reynal/themis/docs/images/pf.jpg

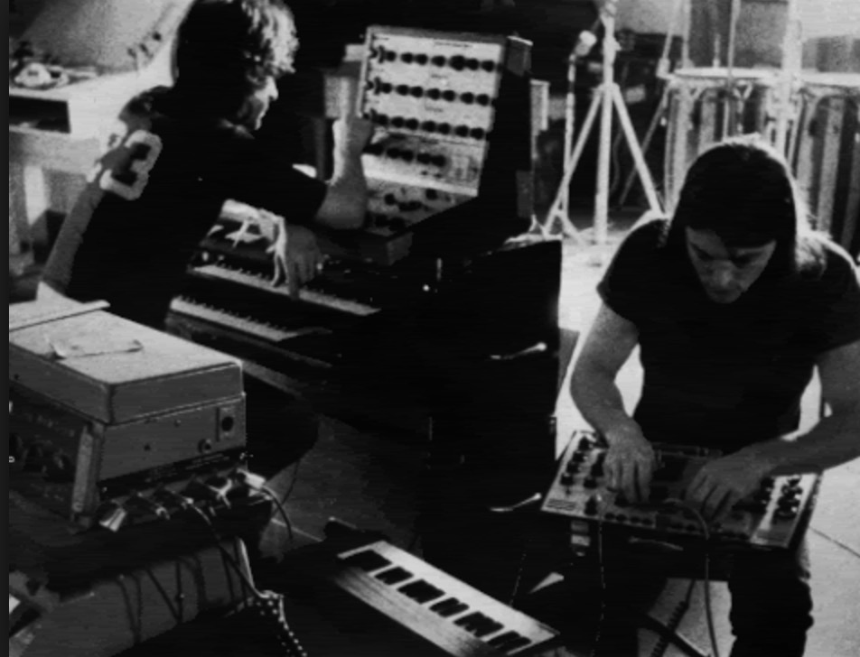
docs/images/pf.jpg
