reynal/themis/README

Themis is a hybrid analog-digital music synthetizer that leverages both analog and digital hardware to generate the richest synthetizer sound ever.
