reynal/themis/front-pane/RPi/README

This folder contains the Java code that control the frontpane interface, e.g., rotary encoders, bargraphs, etc. from a Raspberry Pi board.
