reynal/themis/docs/_posts/2018-11-13-themis.md

---
bg: "tina.jpg"
layout: post
title:  "What is Themis"
crawlertitle: "What is Themis"
summary: "What is Themis"
date:   2018-11-13 14:00:00 +0100
categories: posts
tags: ['front-end']
author: Syd
---

Analog electronics has gained renewed interest in the last decade in the stimulating field of music synthetisers due to the onset of renowned brands like Arturia or Dave Smith Instruments. The initial impetus was to enrich the sound created by the instrument and make it more "human" by inserting analog chips at specific location in the signal path. These chips are non-linear by essence, and sensitive to temperature and humidity in a way that is too complex to model in a microprocessor.

So: analog or digital? But hold on: why should we relinquish to any of them? Themis brings together the best of both realms.
The signal path is analog all the way up from the source oscillators to the voltage controlled amplifier, while control, calibration and LFO's are digitally controlled by an STM32F7 microcontroller. Add a Raspberry Pi based human-interface written in JavaFX --- one of the most versatile and powerful toolkits to date --- and you have one of the most promising synthetizer project.

Themis is fully open source. Eagle schematics and board routing, java code, C code for STM32: everything is open.
