reynal/themis/resources/eagle/Boitiers CI ensea.odt

Boitiers OK : lead pitch > 0.5mm !

Nom | | Espacement entre pins / lead pitch | Adaptateur vers DIP
SOIC | Small Outline IC | 1.27mm | SOIC-8 vers DIP-8 (http://fr.farnell.com/aries/lcqt-soic8-8/adaptateur-ci-8-soic-dip-2-54mm/dp/2476033) SOIC-16 vers DIP-16 (http://fr.farnell.com/aries/lcqt-soic16/adaptateur-ci-16-soic-dip-2-54mm/dp/2476039) SOIC-14 vers DIP-14 (http://fr.farnell.com/aries/lcqt-soic14/adaptateur-ci-14-soic-dip-2-54mm/dp/2476036) SOIC-28 vers DIP-28 (http://fr.farnell.com/aries/lcqt-soic28/adaptateur-ci-28-soic-dip-2-54mm/dp/2476045)
WSOIC | Wide SOIC | 1.27mm | WSOIC-16 vers DIP-16 (http://fr.farnell.com/aries/lcqt-soic16w/adaptateur-ci-16-soic-dip-2-54mm/dp/2476040)
(T)SSOP | Thin-SSOP | 0.65mm | TSSOP-14 vers DIP-14 (http://fr.farnell.com/aries/lcqt-tssop14/adaptateur-ci-14-tssop-dip-2-54mm/dp/2476035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) TSSOP-16 vers DIP-16 (http://fr.farnell.com/aries/lcqt-tssop16/adaptateur-ci-16-tssop-dip-2-54mm/dp/2476038) TSSOP-28 vers DIP-28 (http://fr.farnell.com/aries/lcqt-tssop28/adaptateur-ci-28-tssop-dip-2-54mm/dp/2476044)
DIP | dual in line package
PLCC | plastic leaded chip carrier (carré) | 1.27mm
(L)QFP | lead low profile quad flag package (carré) | cas par cas ! 0.5mm ok (limite !) 0.3 mm non | QFP-32 0.5mm vers 2.54mm carré (http://fr.farnell.com/roth-elektronik/re935-02e/adaptateur-ci-fibre-verre-qfn/dp/2474705) idem mais vers format DIP (http://fr.farnell.com/roth-elektronik/re935-02r/adaptateur-ci-fibre-verre-qfn/dp/2474706)

Farnell : rubrique adaptateurs (http://fr.farnell.com/c/outils-fournitures-de-production/produit-de-prototypage-pcb/adaptateurs-ci)

Boitiers pas OK du tout :

Matrices de billes :

- BGA/DSBGA/NFBGA : Ball Grid Array (matrice de bille) -> non soudable (colle uniquement)

- LCSP / LFCSP / WCSP / WLCSP : billes aussi, donc non soudable (colle uniquement)

Boitiers carrés plats sans pins :

- QFN/TQFN/VQFN : quad flat no-leads package () -> non soudable (doivent être collés !)
