reynal/themis/resources/raspberry pi/aide RPi3.odt

- Aide Rapsberry Pi 3
- login : pi / raspberry
- pour passer en root : "sudo su"
- L'outil de configuration matérielle s'appelle raspi-config.
- L'option 5 de raspi-config permet d'activer les périphériques I2C, SPI, etc
- elle permet aussi de désactiver l'utilisation par défaut du port série comme terminal linux distant, cf. https://fr.wikipedia.org/wiki/Getty_(Unix)
- il y a aussi bcp de périphériques paramétrables dans le fichier /boot/config.txt ; souvent, commenter ou décommenter une ligne dans ce fichier permet d'activer ou de désactiver un périphérique (et de résoudre pas mal de pbs d'un coup en cas de conflit), comme l'écran HDMI, le son, etc ; en effet, les pins de la carte sont à usage multiple, par exemple la pin 12 sert soit de GPIO, soit de sortie PWM, soit pour la sortie audio... Si on désactive le son, on résoud pas mal de pb pour utiliser la sortie PWM du coup !
- pour mettre le noyau et les paquets à jour depuis les repositories officielles : sudo apt-get update / sudo apt-get upgrade
- pour installer des sources depuis github : "git clone git://github.com/nom-du-projet"

Régler le proxy à l'ENSEA (obsolète)

(update janvier 2018 : il n'y a plus de proxy à l'ensea désormais)

- ouvrir un terminal
- editer le fichier .bashrc en tapant "nano .bashrc"
- ajouter à la fin du fichier les deux lignes suivantes :
  - export http_proxy="http://www-cache.ensea.fr:3128"
  - export https_proxy="https://www-cache.ensea.fr:3128"
- fermer le terminal
- relancer un terminal (pour que les exports soient pris en compte)
- ouvrir chrome via le terminal avec "chromium_browser" et ça devrait marche.
- On cherche une solution plus simple... pour que le proxy soit réglé au niveau système et non plus depuis le .bashrc

Bibliothèques C dispo pour piloter les ports GPIO, les bus SPI et I2C etc

Il y a actuellement trois bibliothèques C disponibles pour la RPi3, avec des philosophies un peu différentes (il y a également Pi4J en Java, cf plus bas) :

- WiringPi : http://wiringpi.com/ (la plus simple, dans l'esprit Arduino, mais la moins complète)
- pigpio : http://abyz.me.uk/rpi/pigpio/ (offre également la possibilité de faire tourner un serveur sur la RPi3, auquel un client distant --- sous mac, windows, linux etc --- peut se connecter via le réseau et piloter les ports GPIO à distance)
- bcm2835 : http://www.airspayce.com/mikem/bcm2835/

Janvier 2018 : Mounir a assez facilement hacké la bibliothèque "pigpio" (dont les sources sont disponibles) pour l'adapter aux besoins de son projet.

Tester les GPIO de la carte avec la bibliothèque wiringPi

Tout d'abord, pour tester les ports GPIO en ligne de commande :

gpio readall

puis

gpio write 21 1

pour écrire un 1 logique sur la pin 21 (GPIO.21 sans la nomenclature wPi, mais "5" dans la nomenclature BCM... ATTENTION DONC ELLES SONT DIFFERENTES)

Normalement la lib "wiringpi" est installée par défaut sur la RPi3. Elle permet de piloter les 40 et quelques ports d'entrée sortie (dits "GPIO"). A titre de test, compiler le programme suivant :

#include <wiringPi.h>

int main (void)

{

wiringPiSetup () ; // initialisation de la carte

pinMode (0, OUTPUT) ; // met la pin "GPIO.0" (ou "wPi 0") en mode OUTPUT

// (attention elle n'est pas en position 0 sur la carte

// mais en position 11, cf la sortie de la commande

// "gpio readall")

for (;;)

{

digitalWrite (0, HIGH) ; delay (500) ;

digitalWrite (0, LOW) ; delay (500) ;

}

return 0 ;

}

Pour compiler et exécuter :

gcc -Wall -o blink blink.c -lwiringPi

sudo ./blink

Placer un voltmètre entre la masse (pin 6) et la GPIO.0 (pin 11), et vérifier que ça passe de 0 à 3.3V and back.

Installer la bibliothèque Pi4J

Library permettant de piloter les ports GPIO, le bus SPI et I2C etc en langage java. C'est un wrapper java/C qui utilise en fait la bibliothèque wiringPi (cf plus haut) :

- ouvrir un terminal (vérifier que l'accès à internet fonctionne)
- taper la commande : "curl -s get.pi4j.com | sudo bash"
- si tout se passe bien, les fichiers *.jar and co sont installés dans /opt/pi4j
- tester en compilant les exemples situés dans /opt/pi4j/examples
- documentation : www.pi4j.com
- également (pour connaître les numéros de pins) : wiringpi.com (C library dont pi4j est en fait un "wrapper") ou bien la commande "gpio readall" depuis un terminal
- attention, il y a un bug dans la lib pi4j 1.1 (la dernière version stable, car il existe une 1.2 mais en version beta) avec les Rpi3 dû au fait que pi4j-1.1 intègre une lib C "wiringpi" obsolète. Il faut forcer java à aller chercher la derniere version de la lib wiringpi (normalement elle est installée par défaut sur le système) en ajoutant l'option
  - "-Dpi4j.linking=dynamic" à la commande "java", par exemple
  - "java -Dpi4j.linking=dynamic monProgTestGPIO"
  - aussi, il faut normalement explicitement préciser ou se trouve pi4j, java ne la trouve pas tout seul, ce qui donnne en tout :
  - "java -Dpi4j.linking=dynamic -classpath .:/opt/pi4j/lib/pi4j-core.jar monProgTestGPIO"
- utiliser le port série UART (Tx/Rx) : il faut dire au noyau de ne plus utiliser le port série uart pour la console (ttySx) :
  - raspi-config
  - 8. advance Function menu
  - A8. Serial
  - "No" to disable shell terminal on the serial port
  - puis dans /boot/config.txt, ajouter les deux lignes suivantes :
    - enable_uart=1
    - dtoverlay=pi3-disable-bt

La bibliothèque pigpio

C'est une bibliothèque très performante en C et surtout plus facile à hacker (on l'a vu avec Mounir en 2018) que wiringPi. Et l'accès au bus SPI n'est pas buggué...

- http://abyz.me.uk/rpi/pigpio/index.html
- wrappers java : https://github.com/nkolban/jpigpio

Installer JavaFX

Library java permettant de créer des interfaces graphiques plus "modernes" que Swing (notamment par la possibilité de styliser l'interface avec CSS). Pb : javafx n'est plus installé avec java sur les Raspberry. Voir le topo pour installer les fichiers nécessaires "à côté de Java standard" : https://wimdeblauwe.wordpress.com/2017/08/26/using-javafx-on-raspberry-pi-3-with-gluon/

En gros :

- downloader le fichier openjfx-8u60-sdk-overlay-linux-armv6hf.zip
- cd /usr/lib/jvm/jdk8-install-dir
- unzip openjfx-....zip

Utiliser les Timers pour déclencher des interruptions sur RPi

- https://www.engineersgarage.com/embedded/raspberry-pi/how-to-use-timer-in-raspberry-pi
- https://stackoverflow.com/questions/1784136/simple-signals-c-programming-and-alarm-function
- https://aljensencprogramming.wordpress.com/2014/05/09/introduction-to-signals-using-alarm-in-linux-c/
- La solution parfaite : Realtime Linux Kernel http://www.frank-durr.de/?p=203
- update : la bibliothèque pigpio permet de scheduler des tâches avec le timer de la carte et une très bonne précision (http://abyz.me.uk/rpi/pigpio/examples.html)

Liens utiles

- C library WiringPi : http://wiringpi.com/
- Java library Pi4J : http://pi4j.com/
- How to run JavaFX on RPi3 : http://www.raspberrypi.org/forums/viewtopic.php?t=146098
- Un site qui offre tout un tas de projets et de doc autour de la RPi (dont la doc sur la commande utilitaire "gpio") : http://projects.drogon.net/raspberry-pi/
- un excellent tuto pour programmer les bus SPI et I2C : https://learn.sparkfun.com/tutorials/raspberry-pi-spi-and-i2c-tutorial
