reynal/themis/resources/front pane.pdf

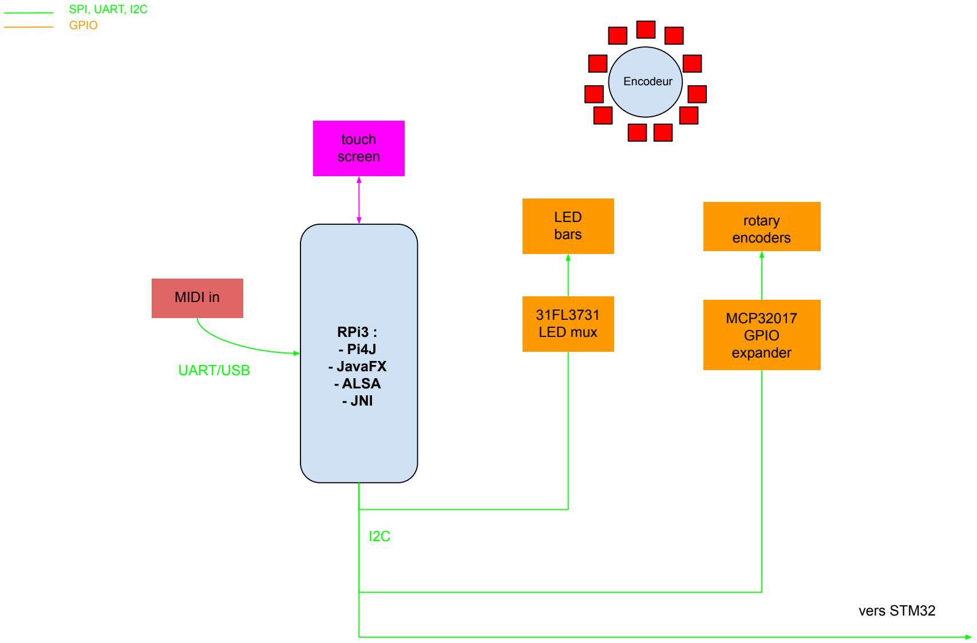
[picture p47: figure]
MIDI in; SPI, UART, I2C GPIO; RPi3 : - Pi4J - JavaFX - ALSA - JNI; rotary encoders; touch screen; LED bars; UART/USB; Encodeur; vers STM32; 31FL3731 LED mux; MCP32017 GPIO expander
