reynal/themis/resources/global structure.pdf

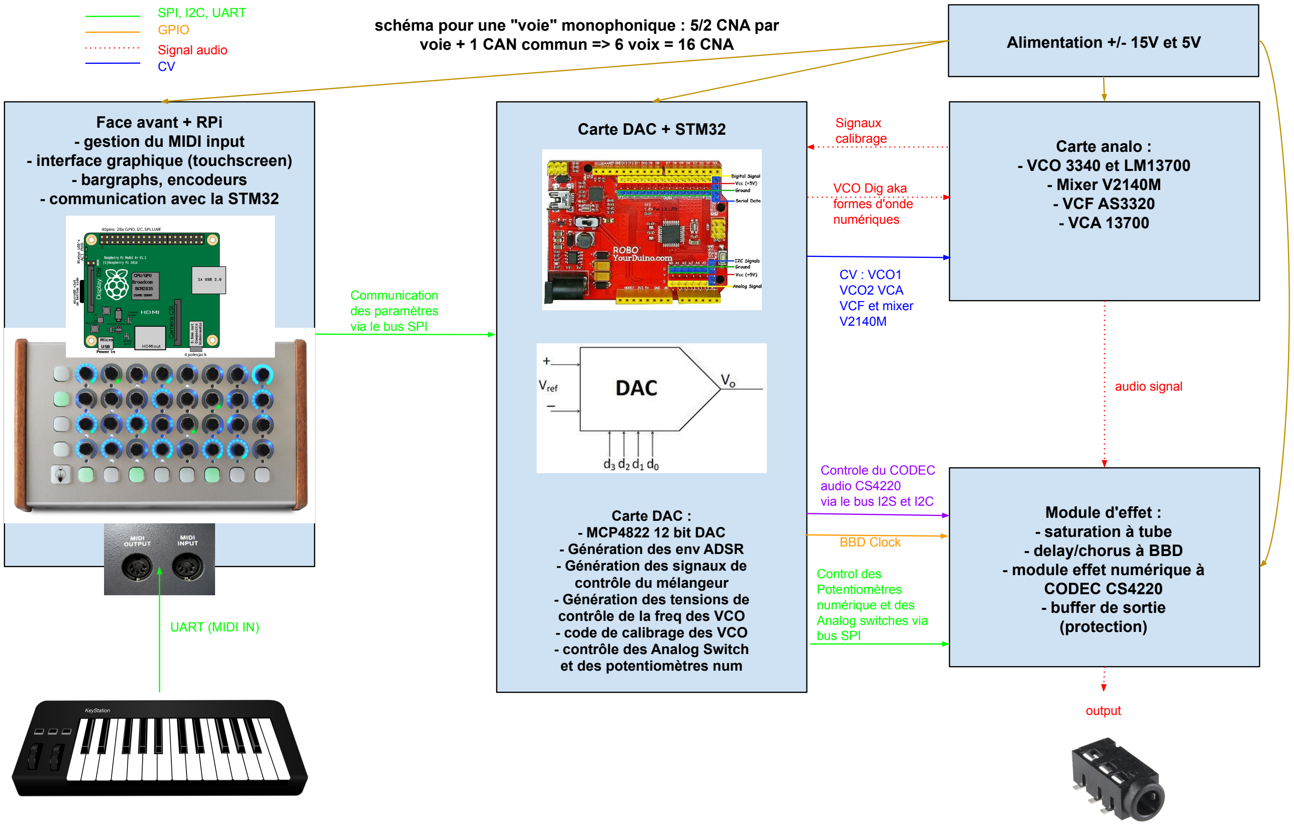
[picture p48: figure]
voie + 1 CAN commun => 6 voix = 16 CNA; SPI, I2C, UART GPIO; Signal audio CV; Carte DAC + STM32; Carte analo : - VCO 3340 et LM13700 - Mixer V2140M - VCF AS3320 - VCA 13700; Module d'effet : - saturation à tube - delay/chorus à BBD - module effet numérique à CODEC CS4220 - buffer de sortie (protection); Communication des paramètres via le bus SPI; UART (MIDI IN); CV : VCO1 VCO2 VCA VCF et mixer V2140M; VCO Dig aka formes d'onde numériques; audio signal; Controle du CODEC audio CS4220 via le bus I2S et I2C; BBD Clock; Control des Potentiomètres numérique et des Analog switches via bus SPI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

schéma pour une "voie" monophonique : 5/2 CNA par
