reynal/themis/misc/jlcpcb invoice front pane.pdf

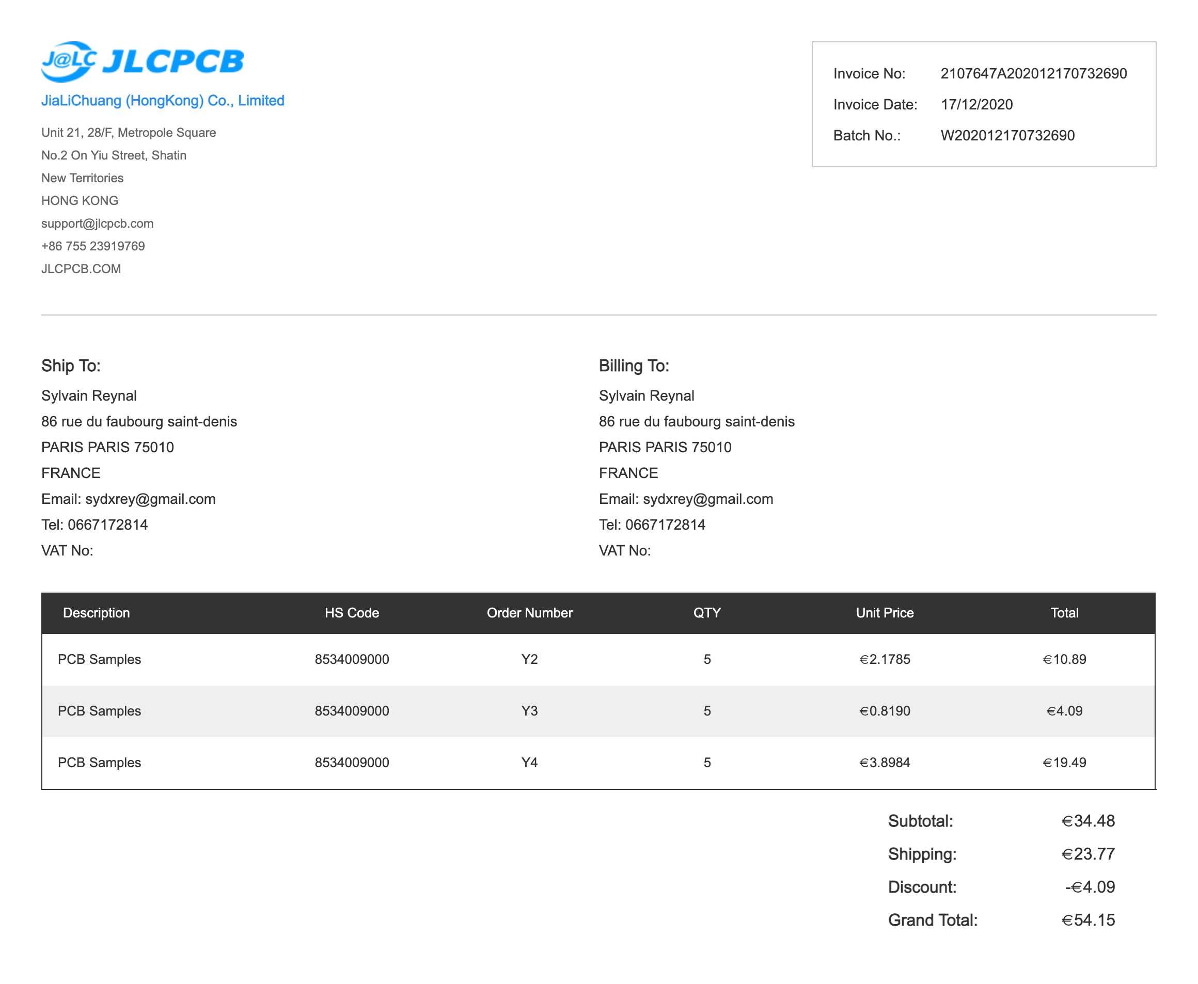
[picture p49: figure]
