reynal/themis/resources/design-guides/VCF design - H-Malvar-SVF-OTA-1980.pdf

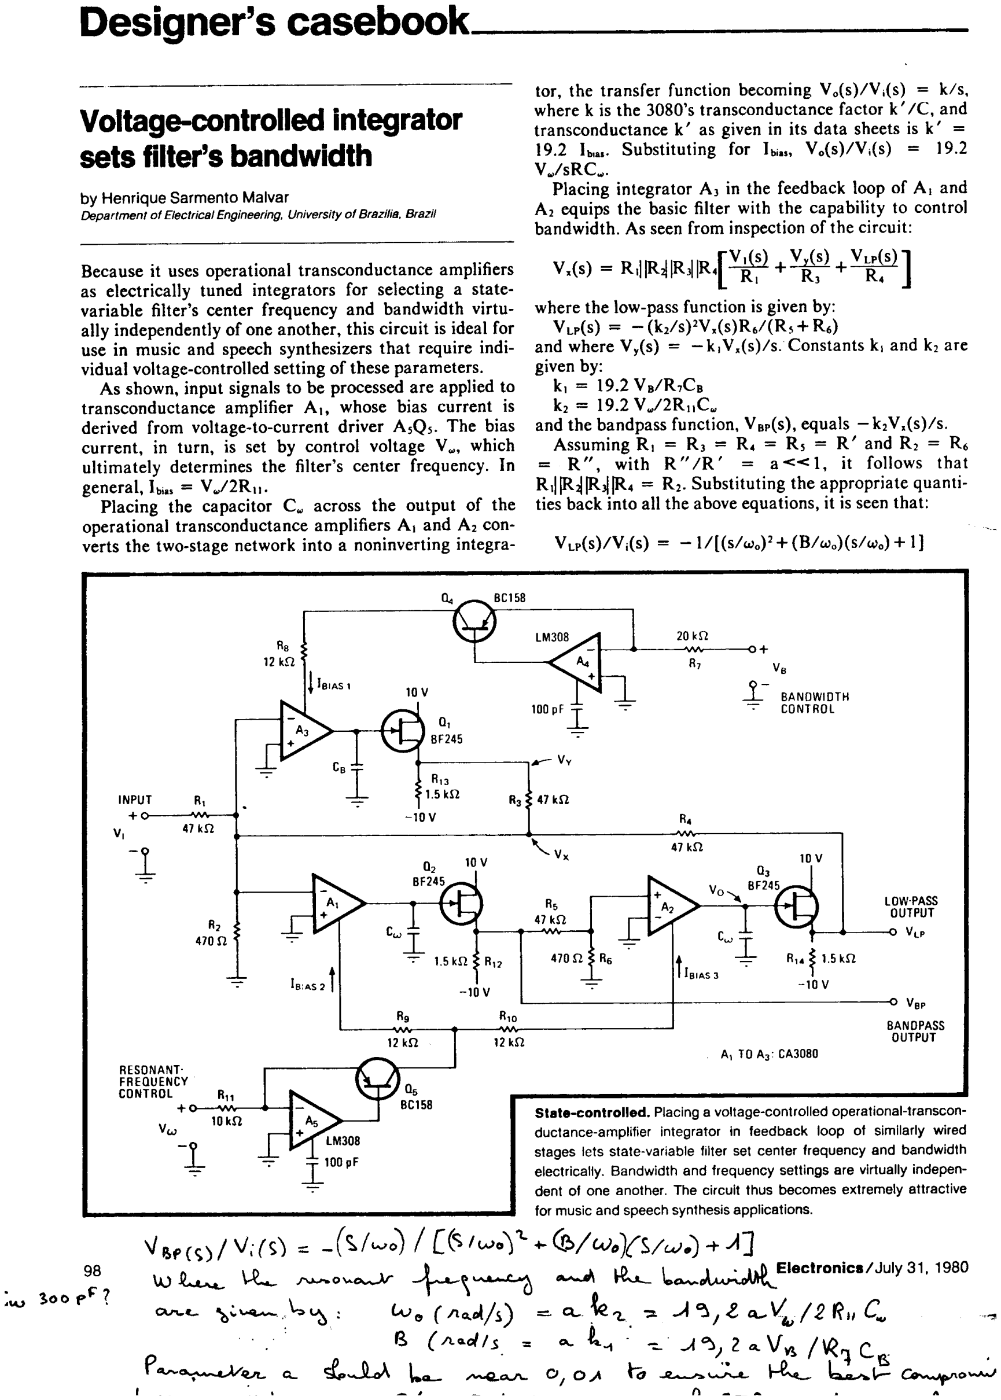
[picture p50: page 1]
