reynal/themis/resources/design-guides/VCF design - T-Orr-VCF-1976.pdf

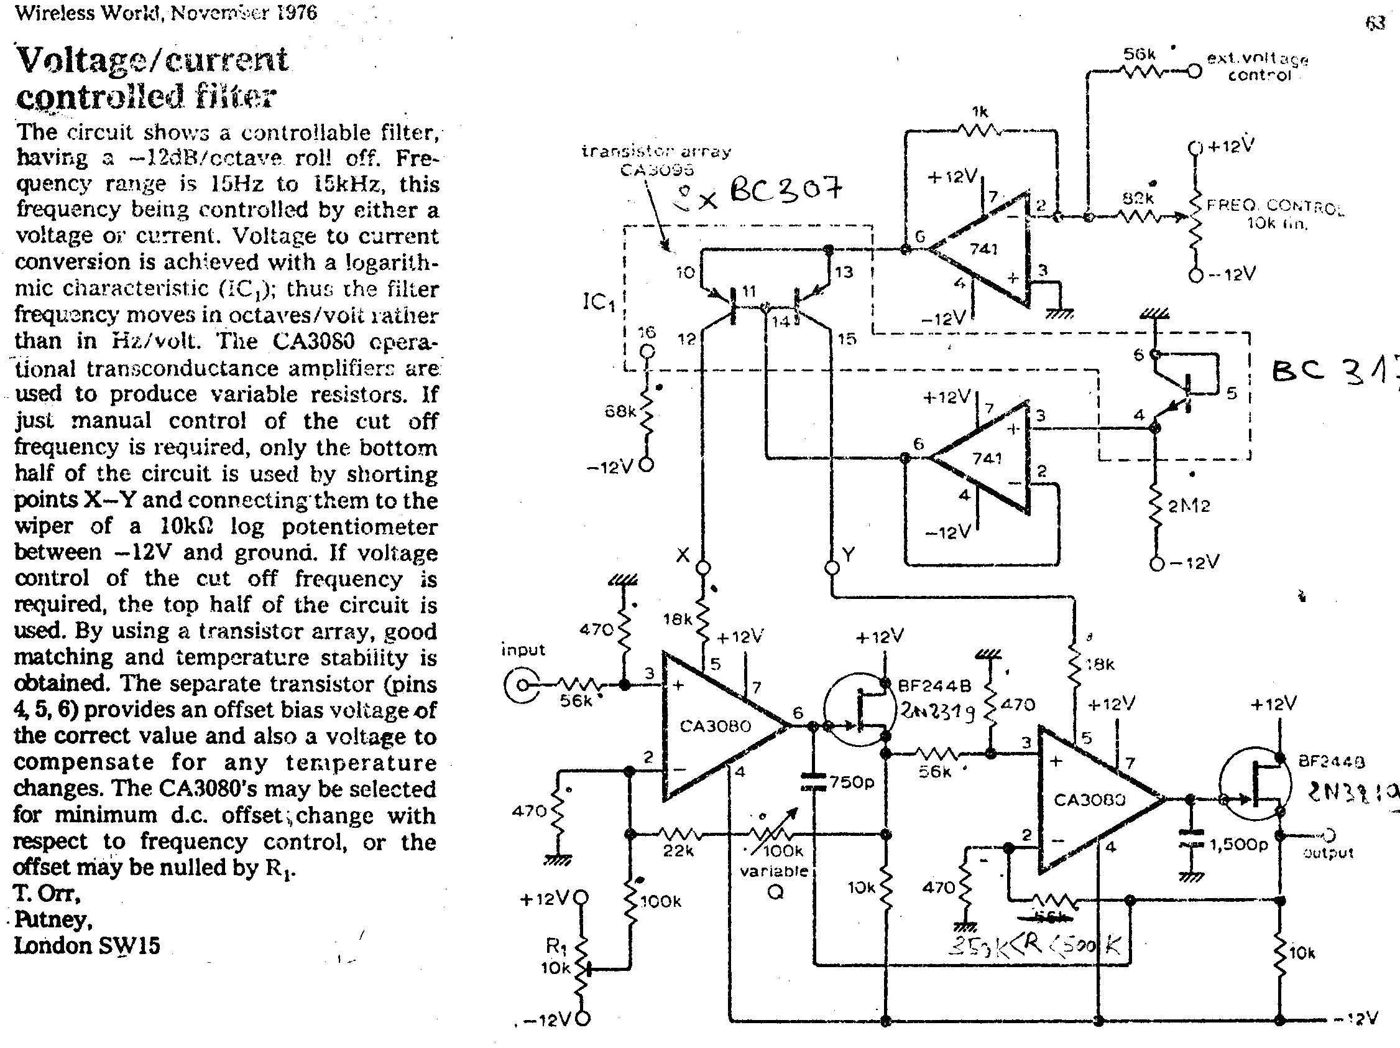
[picture p51: figure]
