reynal/themis/resources/design-guides/VCO design - H-Malvar-linVCO-1980.pdf

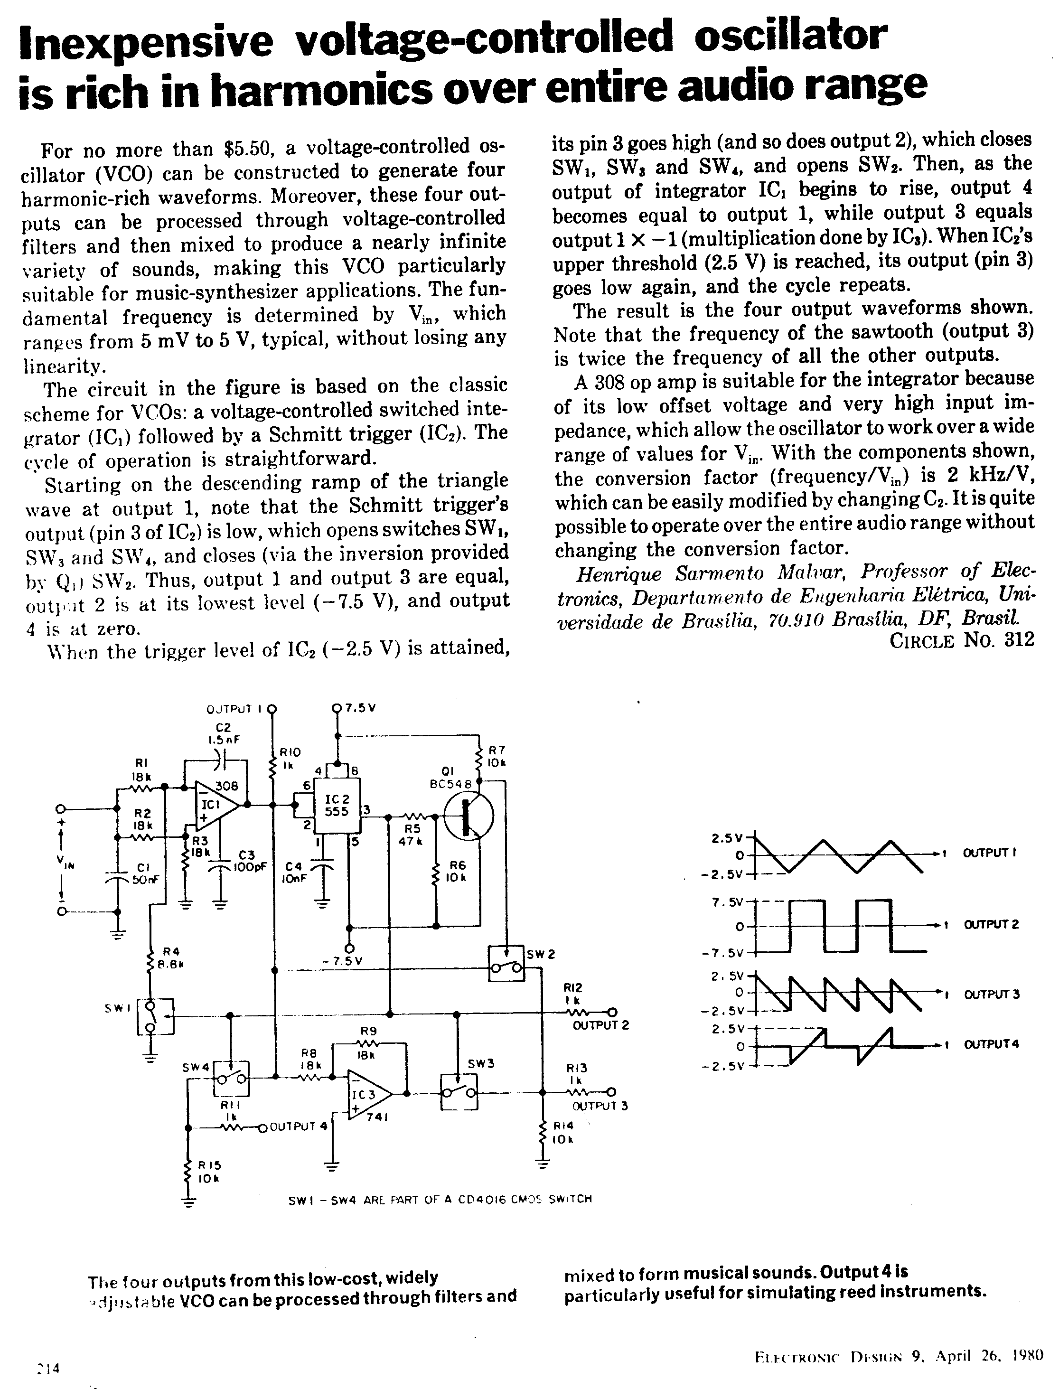
[picture p52: page 1]
