reynal/themis/analog-modules/moog-filter/ltspice-simulations/resonance sweep at 2kHz.png

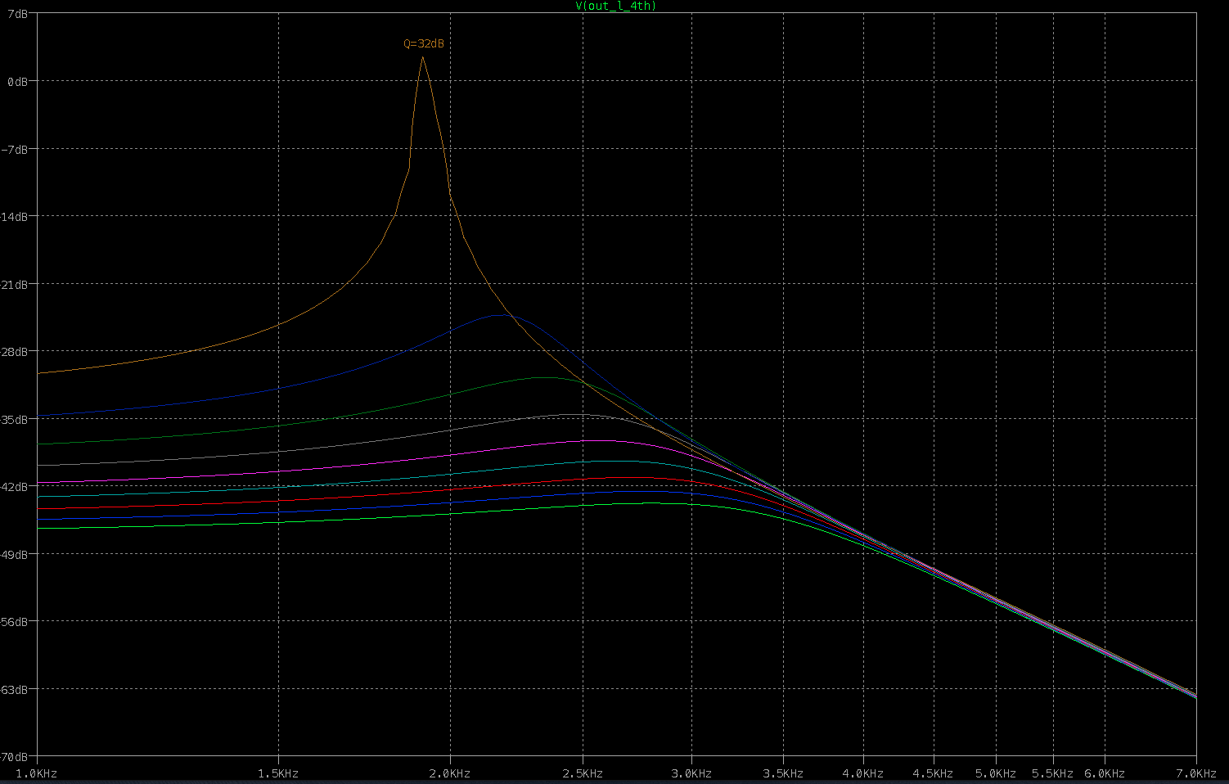
analog-modules/moog-filter/ltspice-simulations/resonance sweep at 2kHz.png
