reynal/themis/analog-modules/moog-filter/ltspice-simulations/resonance sweep at 9kHz.png

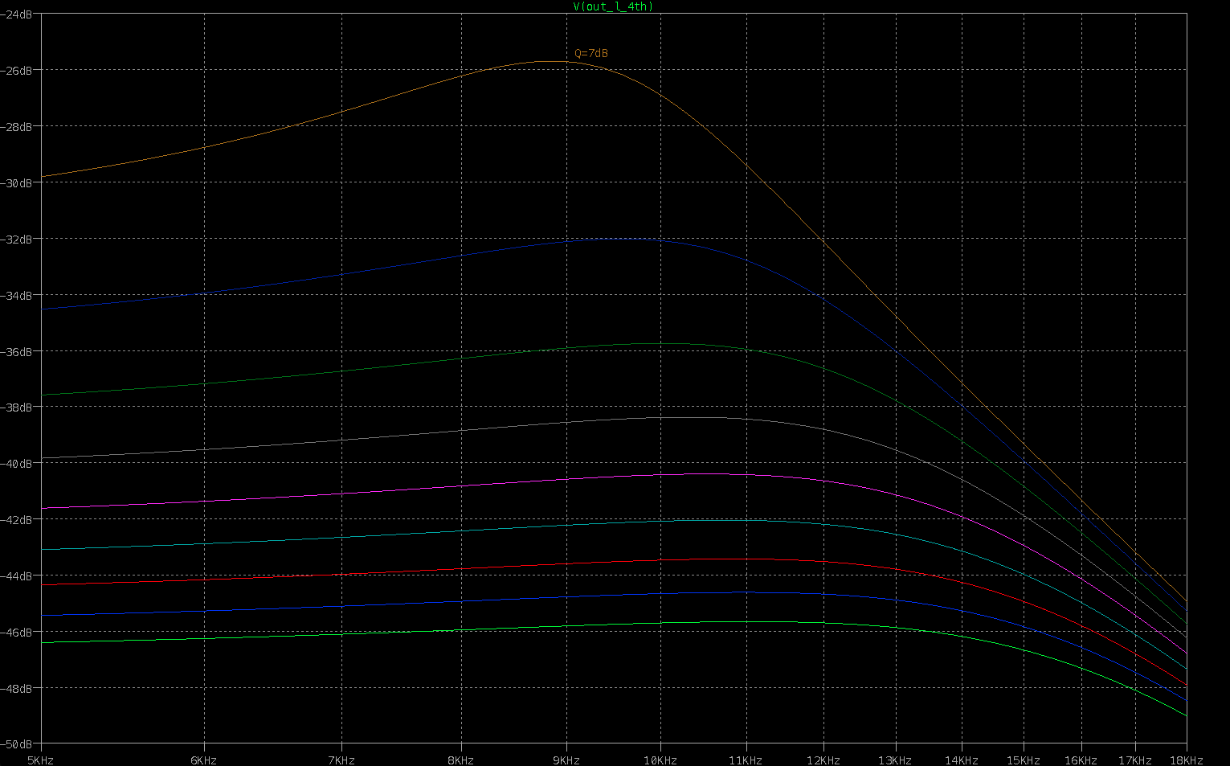
analog-modules/moog-filter/ltspice-simulations/resonance sweep at 9kHz.png
