reynal/themis/analog-modules/moog-filter/ltspice-simulations/resonance sweep at 300Hz.png

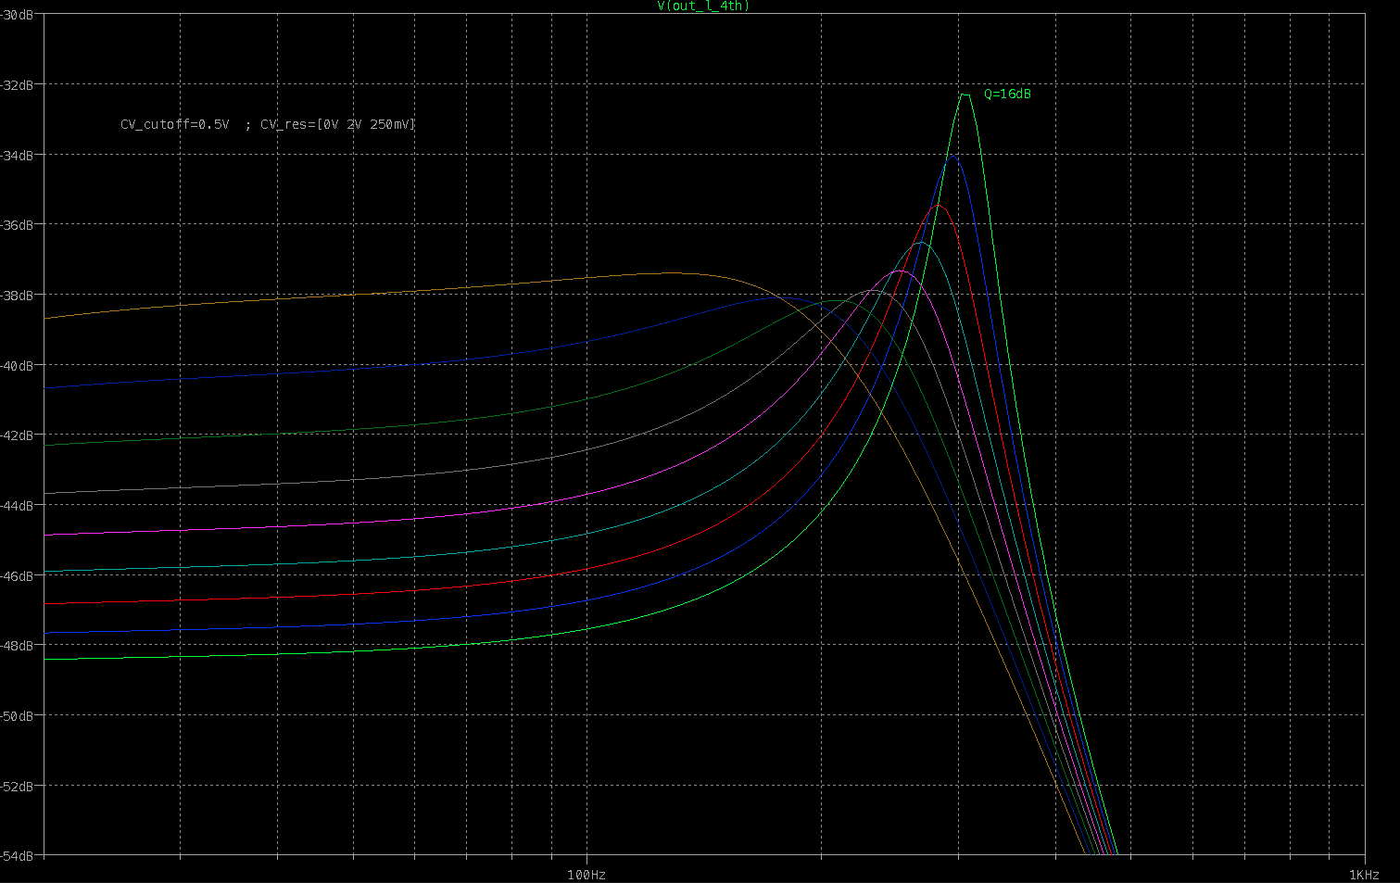
analog-modules/moog-filter/ltspice-simulations/resonance sweep at 300Hz.png
