reynal/themis/docs/assets/images/Equation 1 VCF.png

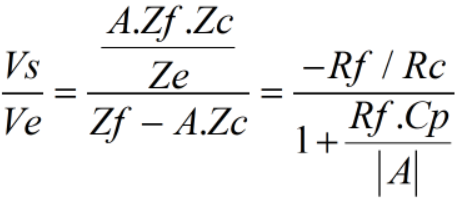
docs/assets/images/Equation 1 VCF.png
