reynal/themis/docs/assets/images/Illustration 1 VCF.png

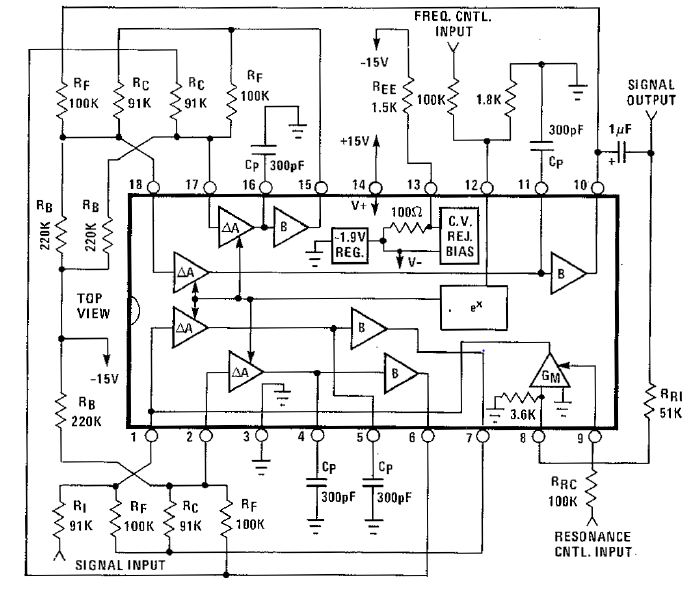
docs/assets/images/Illustration 1 VCF.png
