reynal/themis/docs/assets/images/Illustration 2 VCF.png

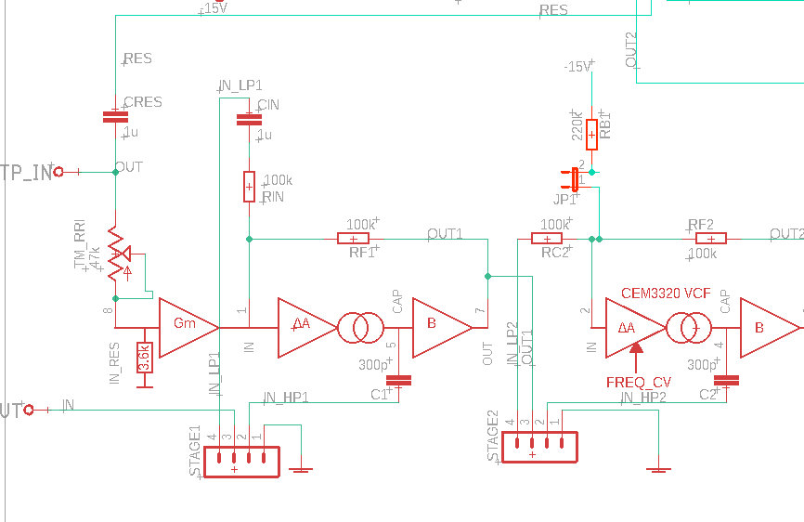
docs/assets/images/Illustration 2 VCF.png
