reynal/themis/docs/assets/images/jupiter.jpeg

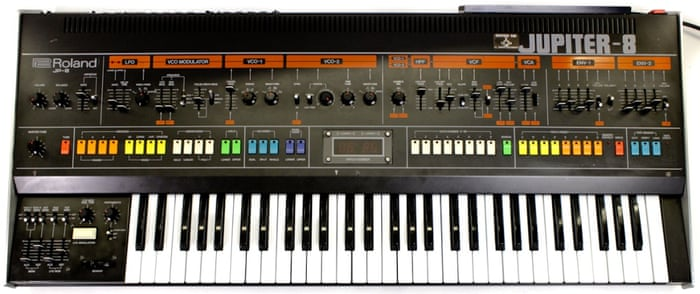
docs/assets/images/jupiter.jpeg
