reynal/themis/docs/assets/images/moogandweiss.jpg

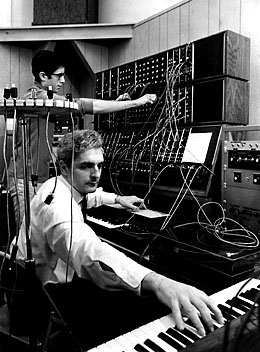
docs/assets/images/moogandweiss.jpg
