reynal/themis/docs/assets/images/owl.jpg

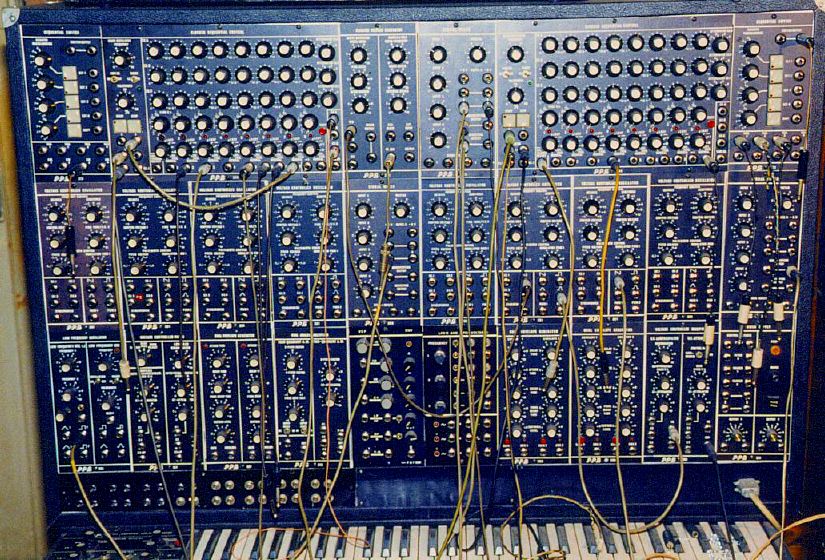
docs/assets/images/owl.jpg
