reynal/themis/docs/assets/images/pinkFloydEMS.jpg

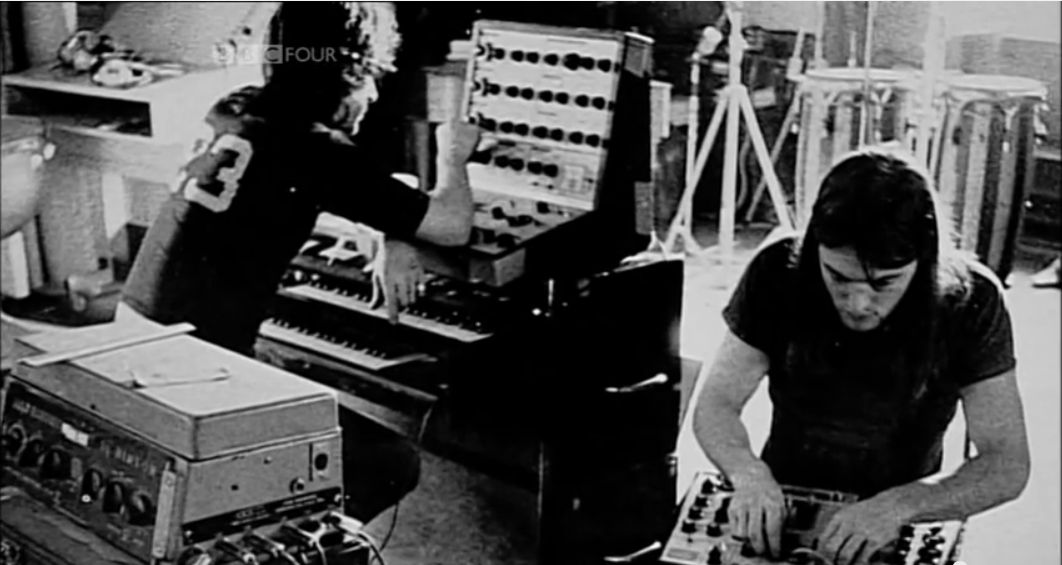
docs/assets/images/pinkFloydEMS.jpg
