reynal/themis/docs/assets/images/tina.jpg

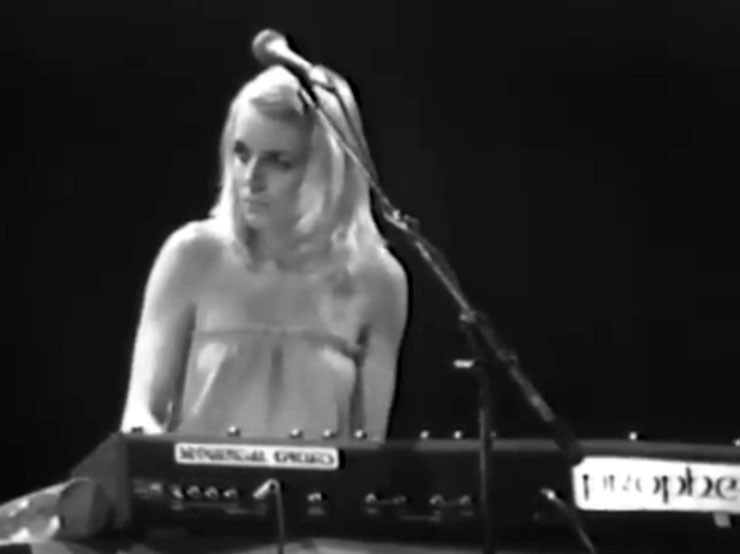
docs/assets/images/tina.jpg
