reynal/themis/front-pane/RPi/src/resources/img/3340.png

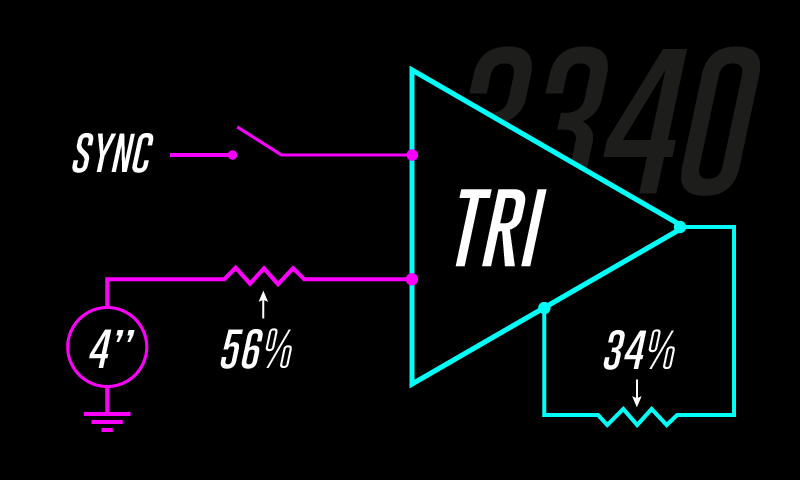
front-pane/RPi/src/resources/img/3340.png
