reynal/themis/front-pane/RPi/src/resources/img/13700.png

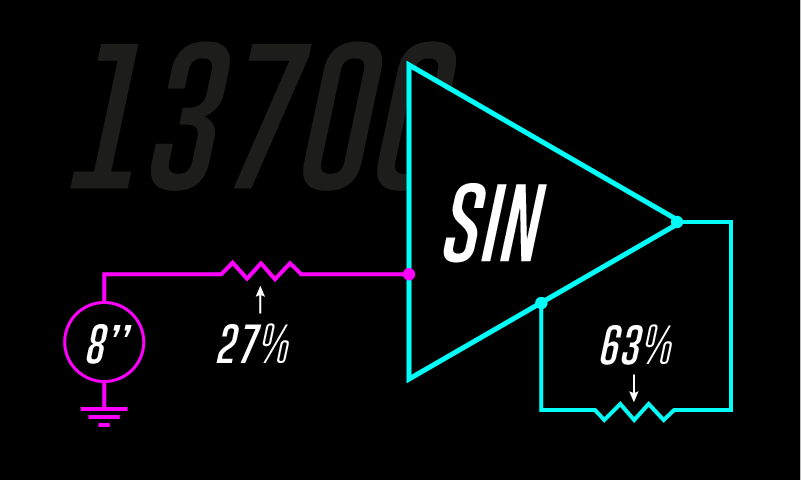
front-pane/RPi/src/resources/img/13700.png
