reynal/themis/front-pane/RPi/src/resources/img/Encodeurs 2.png

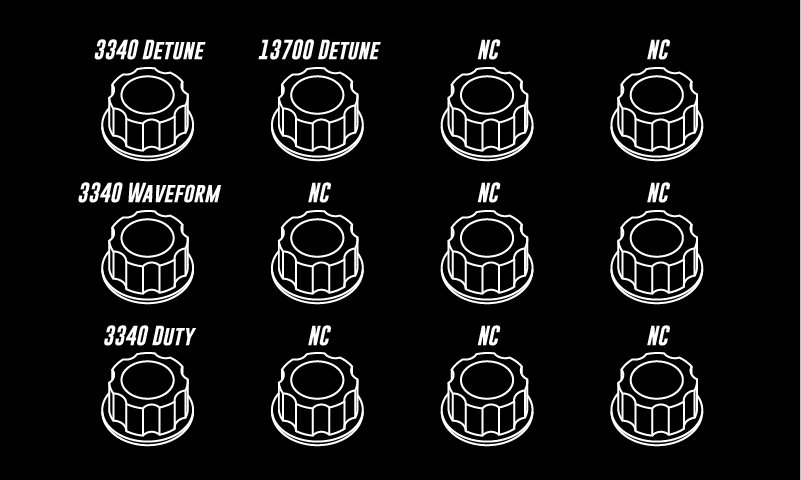
front-pane/RPi/src/resources/img/Encodeurs 2.png
