reynal/themis/front-pane/RPi/src/resources/img/Enveloppe Mode.png

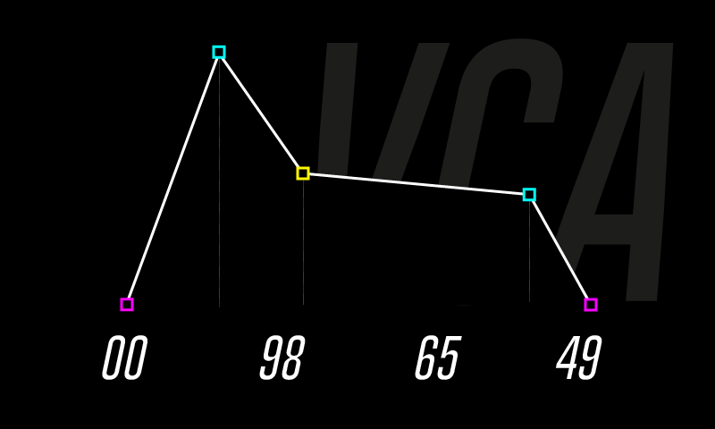
front-pane/RPi/src/resources/img/Enveloppe Mode.png
