reynal/themis/front-pane/RPi/src/resources/img/Filter Mode 1.png

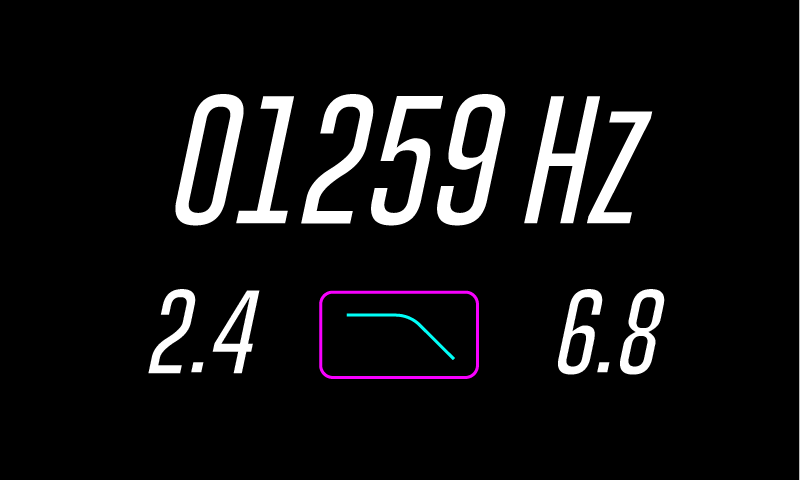
front-pane/RPi/src/resources/img/Filter Mode 1.png
