reynal/themis/front-pane/RPi/src/resources/img/Filter Mode 2.png

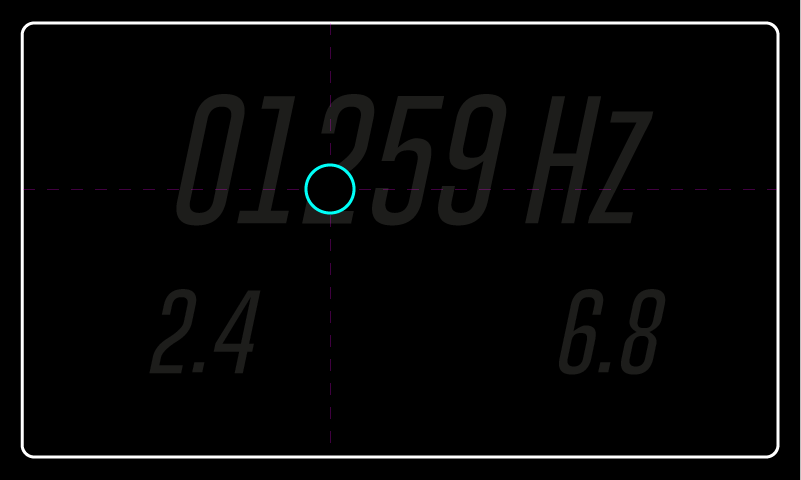
front-pane/RPi/src/resources/img/Filter Mode 2.png
