reynal/themis/front-pane/RPi/src/resources/img/Matrix Mode.png

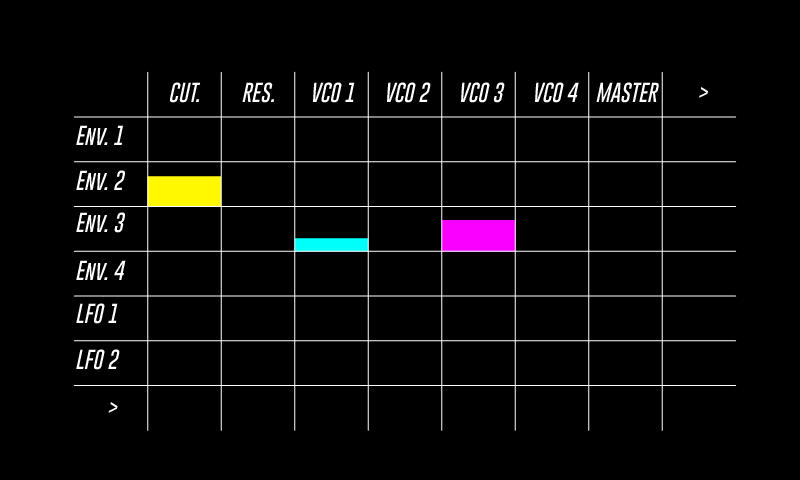
front-pane/RPi/src/resources/img/Matrix Mode.png
