reynal/themis/front-pane/RPi/src/resources/img/Mixer Mode.png

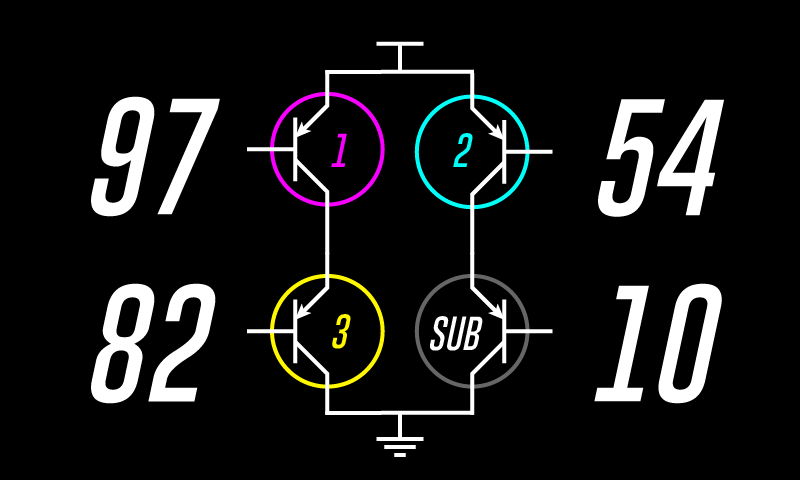
front-pane/RPi/src/resources/img/Mixer Mode.png
