reynal/themis/resources/datasheets/Nutube - 7408xgC.png

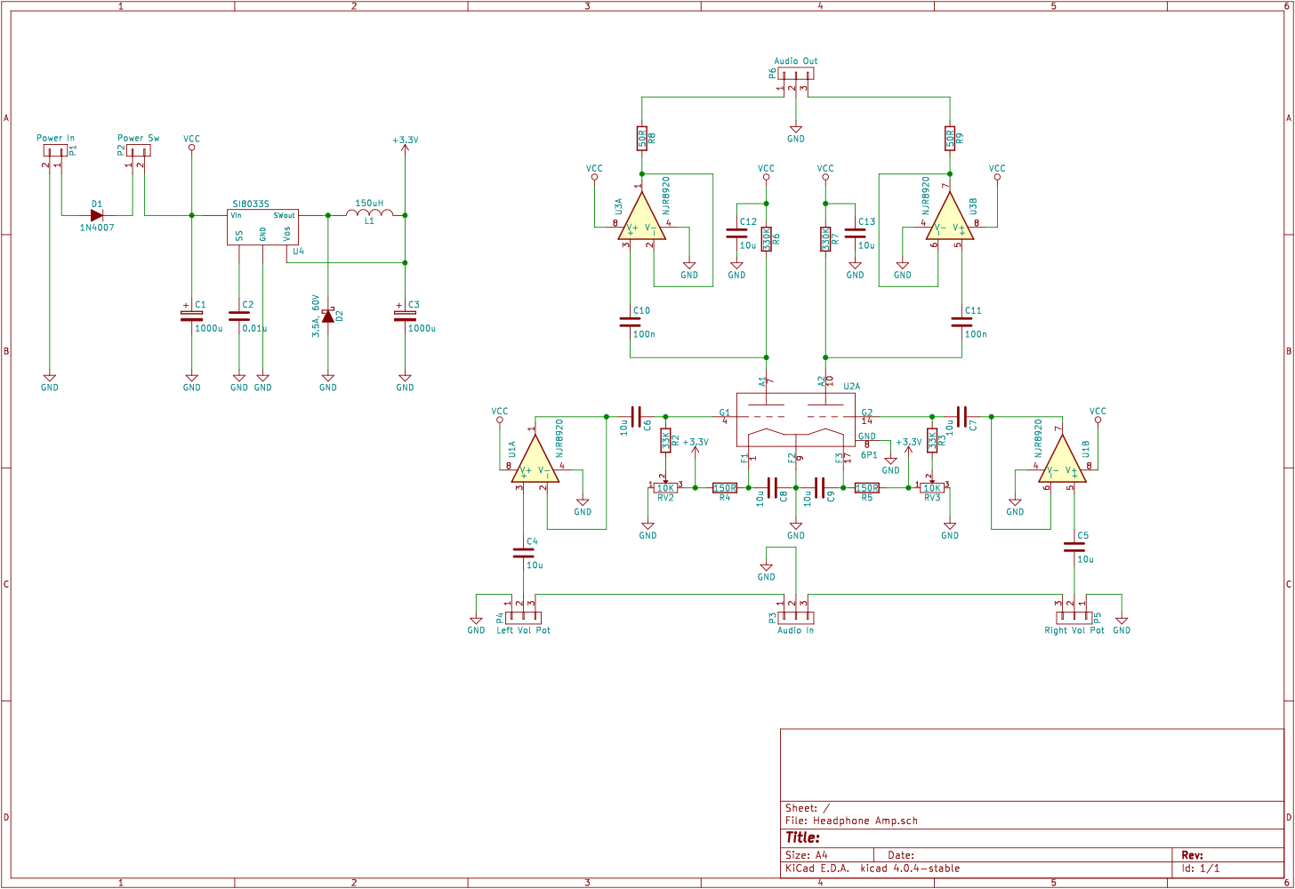
resources/datasheets/Nutube - 7408xgC.png
