reynal/themis/resources/mechanical/3D view.png

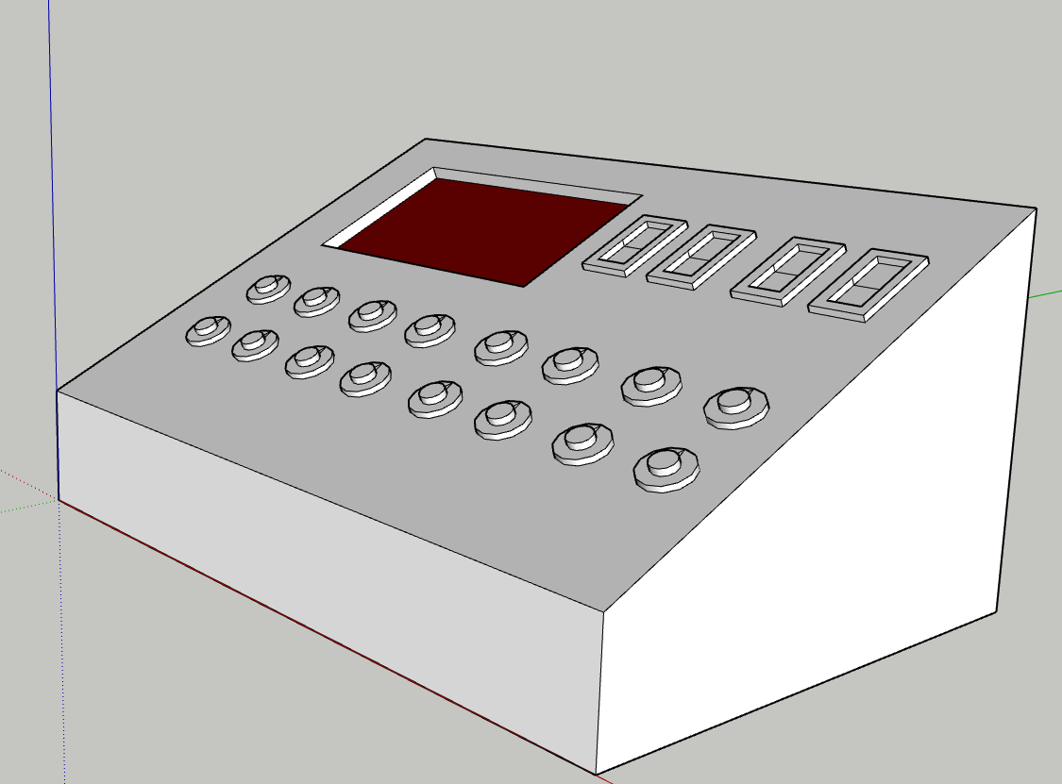
resources/mechanical/3D view.png
