reynal/themis/resources/pictures/2020-10-23 18.54.22.jpg

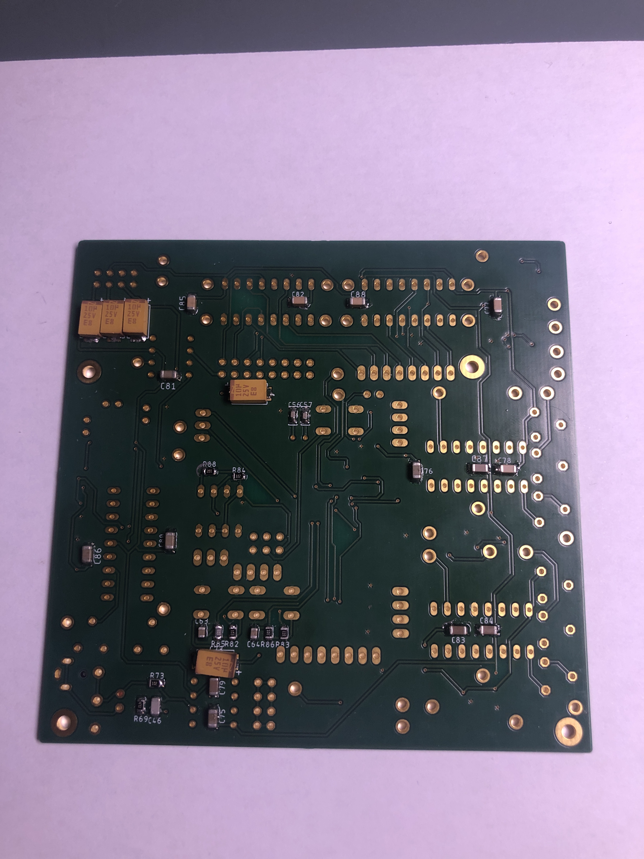
resources/pictures/2020-10-23 18.54.22.jpg
