reynal/themis/resources/pictures/2020-10-23 22.10.40.jpg

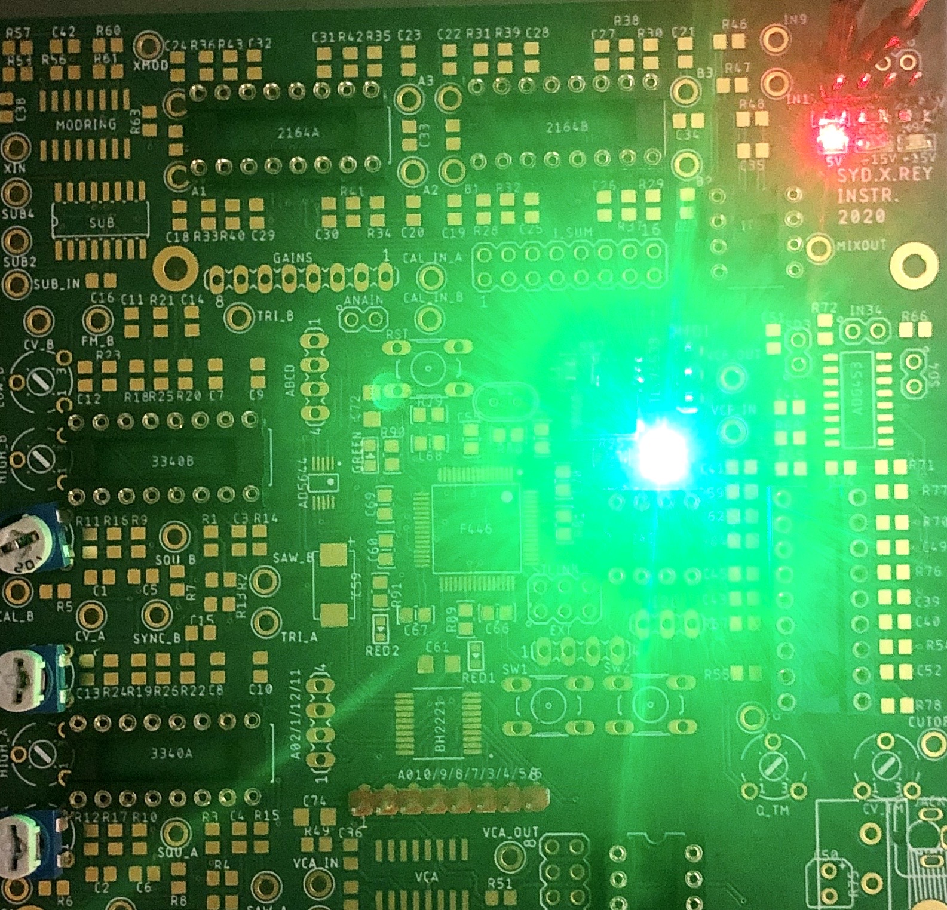
resources/pictures/2020-10-23 22.10.40.jpg
