reynal/themis/resources/pictures/2020-12-23 16.22.07.jpg

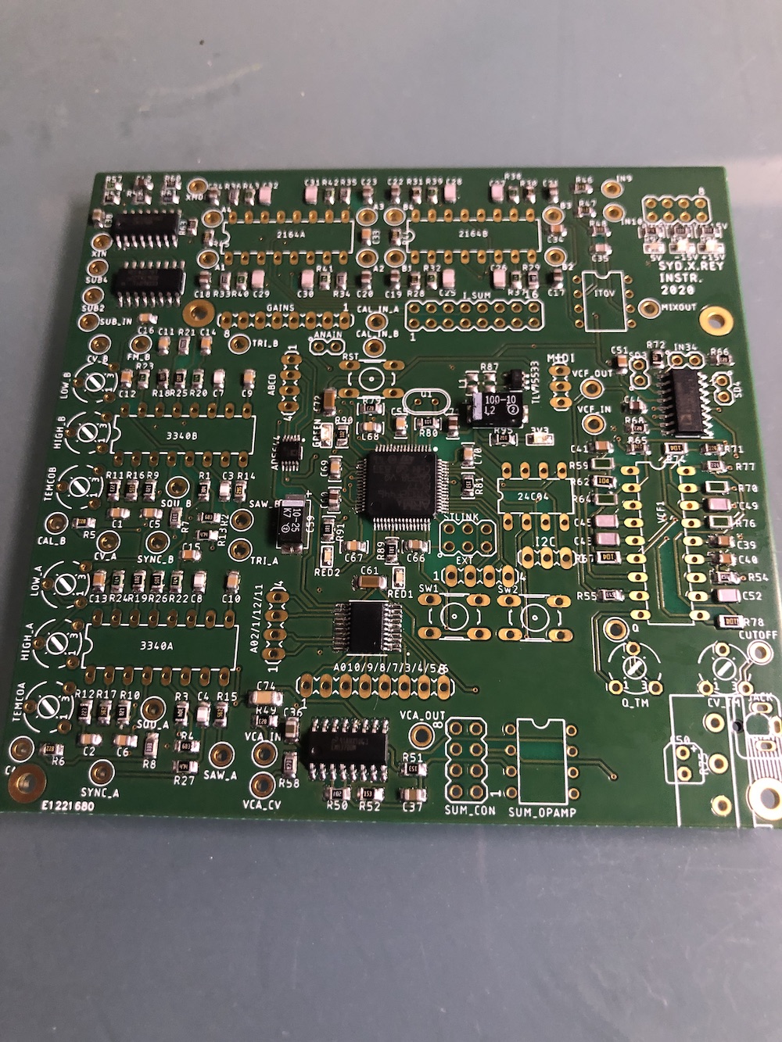
resources/pictures/2020-12-23 16.22.07.jpg
