reynal/themis/resources/pictures/2021-01-04 22.08.45.jpg

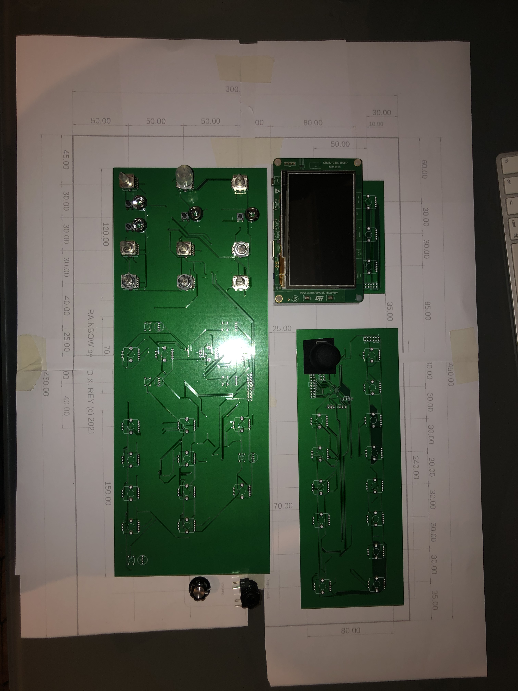
resources/pictures/2021-01-04 22.08.45.jpg
