reynal/themis/resources/pictures/2021-01-04 22.09.08.jpg

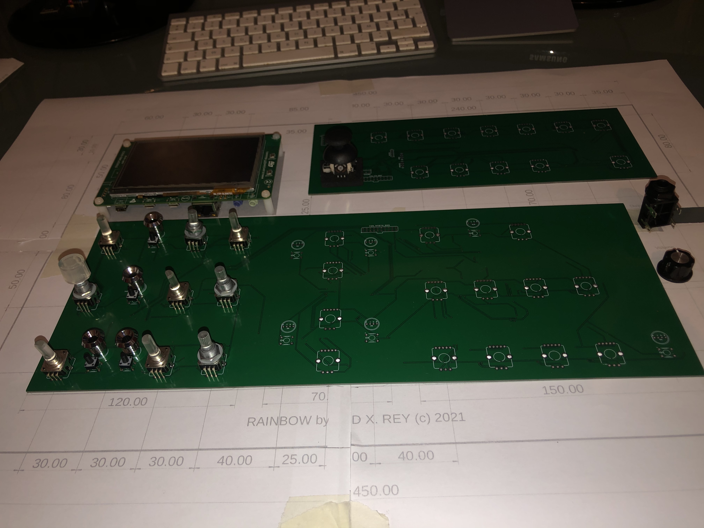
resources/pictures/2021-01-04 22.09.08.jpg
