reynal/themis/resources/pictures/2021-04-10 15.27.30.jpg

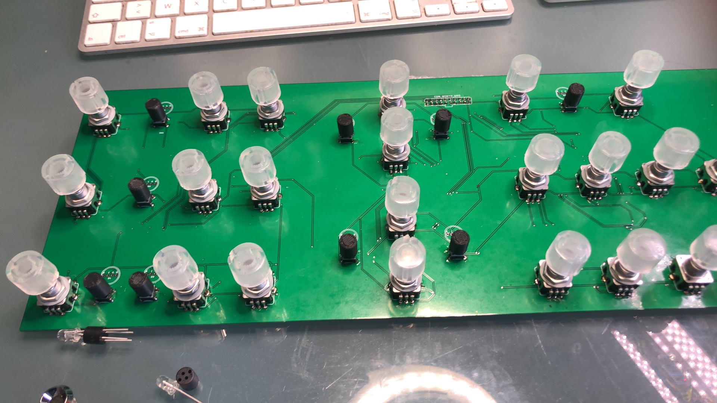
resources/pictures/2021-04-10 15.27.30.jpg
