reynal/themis/resources/pictures/2021-04-10 18.55.15.jpg

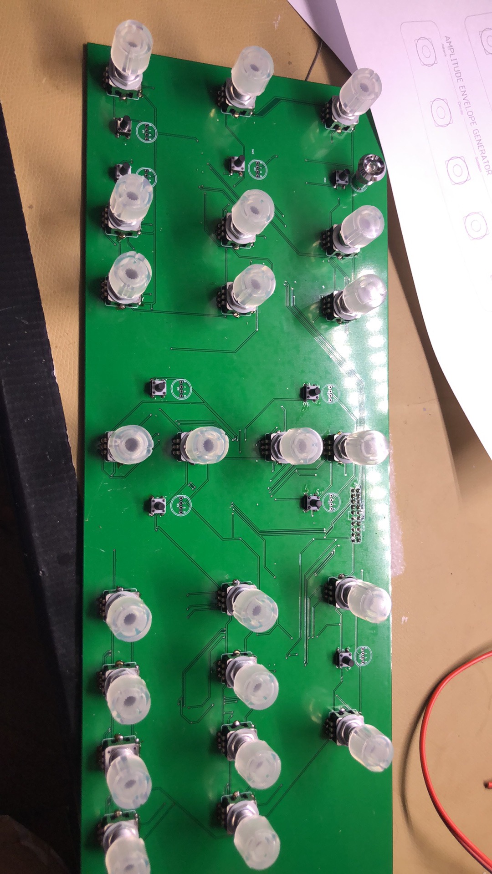
resources/pictures/2021-04-10 18.55.15.jpg
