reynal/themis/resources/pictures/2021-04-10 21.06.49.jpg

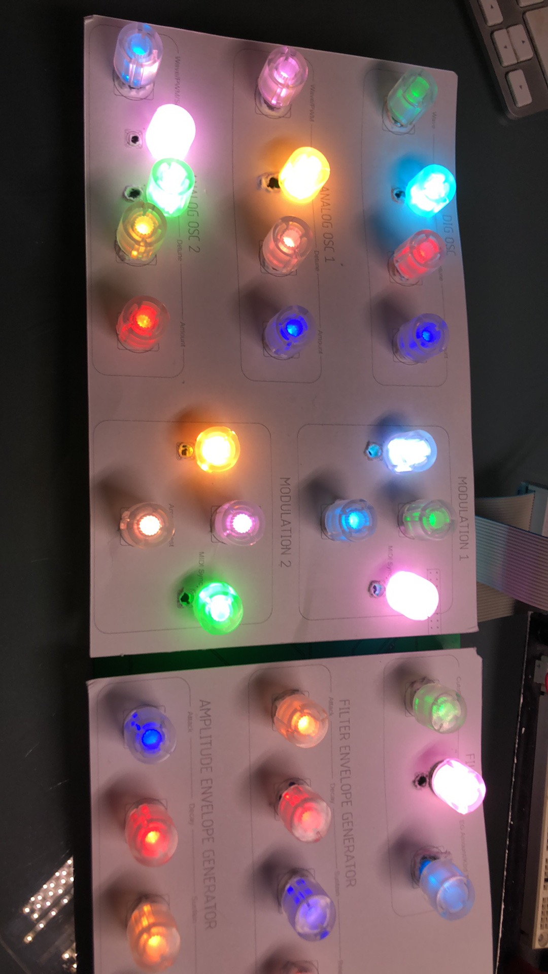
resources/pictures/2021-04-10 21.06.49.jpg
