reynal/themis/resources/pictures/IMG_4257.jpeg

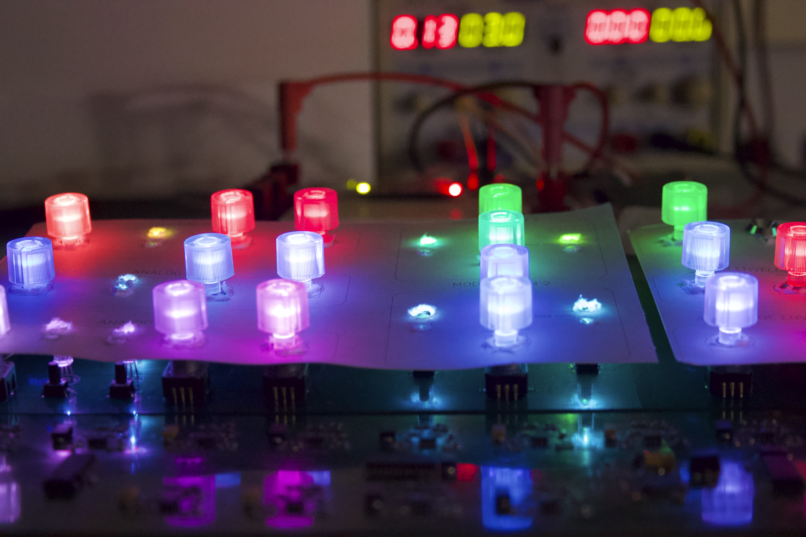
resources/pictures/IMG_4257.jpeg
