reynal/themis/resources/pictures/work in progress.jpg

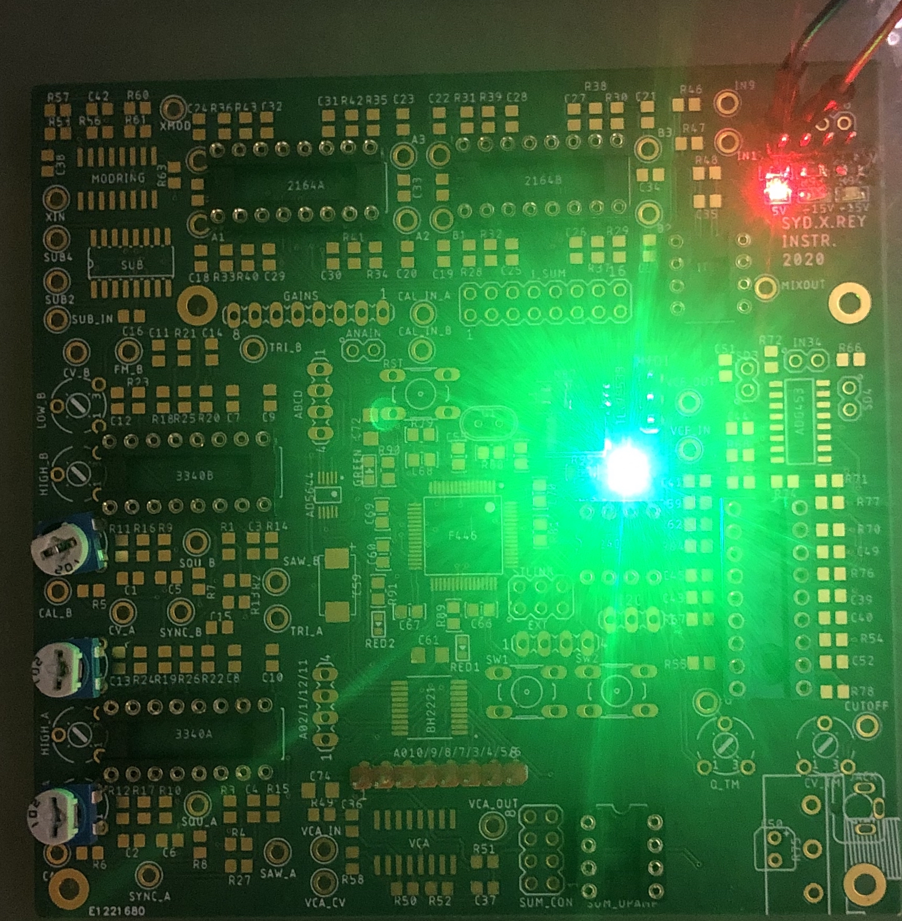
resources/pictures/work in progress.jpg
