reynal/themis/resources/JLPCB-parts.ods

 | LCSC Part | MFR.Part | First Category | Second Category | Package | Solder Joint | Manufacturer | Library Type
Composants passifs :
Résistances :
 | C25879 | 2.2KΩ (2201) ±1% | Resistors | Chip Resistor - Surface Mount | 0402 | 2 | Uniroyal Elec | base
Condensateurs:
Electrolytiques
 | C7171 | 10uF (106) ±10% 16V | Capacitors | Tantalum Capacitors | CASE-A_3216 | 2 | AVX | base
Ceramiques
 | C16772 | 220nF (224) ±10% 16V X7R | Capacitors | Multilayer Ceramic Capacitors MLCC - SMD/SMT | 0402 | 2 | Samsung Electro-Mechanics | base
 | C1525 | 100nF (104) ±10% 16V X7R | Capacitors | Multilayer Ceramic Capacitors MLCC - SMD/SMT | 0402 | 2 | Samsung Electro-Mechanics | base
C.I. :
