reynal/themis/misc/budget v3 grande serie.ods

Sheet: synthe
COUT TOTAL
 | Unit price | Qty | Total | Vendor
Graphic interface
STM32F746 disco | 56.00 € | 1 | 56,00 €
Joystick | 3.00 € | 1 | 3,00 € | https://www.sparkfun.com/products/9032
 |  | TOTAL | 59,00 €
Back connectors
MIDI DIN Connectors | 2.00 € | 3 | 6,00 €
embase jack femelle | 0.65 € | 2 | 1,30 € | https://fr.farnell.com/rean/rj3vm/trs-1-4-femelle-vertical-pcb/dp/2383459
Power switch | 1.70 € | 1 | 1,70 € | https://fr.farnell.com/c-k-components/d502j12s215pqa/commutateur-spst-10a-125v-noir/dp/2931723
USB connector | 1.00 € | 1 | 1,00 € | https://fr.farnell.com/lumberg/2411-05/usb-connector-2-0-type-b-rcpt/dp/3549615?st=usb%20connector
 |  | TOTAL | 10,00 €
Power supply
Conv USB +/-15V | 6.00 € | 1 | 6,00 €
Boitier + sérigraphie
Boitier alu | 10.00 € | 1 | 10,00 €
Photo sur plexi | 30.00 € | 1 | 30,00 €
 |  | TOTAL | 40,00 €
Synth voices | 92.84 € | 8 | 742,68 €
Frontpane | 238.05 € |  | 238,05 €
Graphic interface | 59,00 € |  | 59,00 €
Boitier + sérigraphie | 40,00 € |  | 40,00 €
Back connectors | 10,00 € |  | 10,00 €
Power supply | 6,00 € |  | 6,00 €
 |  | TOTAL SYNTH | 1 095,74 €

Sheet: main
Main analog board v7
Value | Unit price | Qty | Total | Vendor
C0805 | 0.05 € | 80 | 3.68 €
CPOL2917 | 0.36 € | 8 | 2.88 €
entretoises | 0.50 € | 4 | 2.00 € | https://fr.farnell.com/ettinger/05-13-061/entretoise-m3x-6-vzk/dp/1466745
IC 24C04AP DIL8 | 0.17 € | 1 | 0.17 € | https://fr.farnell.com/microchip/at24c04c-sshm-b/eeprom-serie-4-kbits-1mhz-soic/dp/2345580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
IC 4027D SO16 | 0.42 € | 1 | 0.42 € | https://fr.farnell.com/nexperia/hef4027bt/circuit-logique-serie-4000-locmos/dp/1085282?st=4027
IC AD5644RBRMZ-5 | 10.09 € | 1 | 10.09 € | https://www.mouser.fr/ProductDetail/Analog-Devices/AD5644RBRMZ-5/?qs=NmRFExCfTkEggoWNsH0iHw%3D%3D
IC ADG453BRZ SOIC | 5.43 € | 1 | 5.43 € | https://www.mouser.fr/ProductDetail/Analog-Devices/ADG453BRZ-REEL/?qs=BpaRKvA4VqEyL0jUfw0AJg%3D%3D
IC BH2221FV SSOP | 3.01 € | 1 | 3.01 € | https://www.mouser.fr/ProductDetail/ROHM-Semiconductor/BH2221FV-E2/?qs=4kLU8WoGk0tQTQMB6offlg%3D%3D
IC Coolaudio 3320 DIL18 | 6.80 € | 1 | 6.80 €
IC Coolaudio 3340 DIL16 | 6.80 € | 2 | 13.60 €
IC Coolaudio SSM2164 DIL16 | 4.00 € | 2 | 8.00 € | https://www.coolaudio.com/features-page.php?product=V2164D
IC LM13700M SO16 | 1.16 € | 2 | 2.32 € | https://fr.farnell.com/texas-instruments/lm13700m-nopb/ic-op-amp-dual-smd/dp/3118203?st=LM13700M/NOPB
IC NE5534AN DIL08 | 0.94 € | 2 | 1.88 € | https://www.mouser.fr/ProductDetail/Texas-Instruments/NE5534AP/?qs=pt%2FIv5r0EPfqeuBbXEfl4Q%3D%3D
IC STM32F446RCT7 | 6.13 € | 1 | 6.13 € | https://www.mouser.fr/ProductDetail/STMicroelectronics/STM32F446RCT7/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
IC TLV75533PDBVR SOT | 0.45 € | 1 | 0.45 € | https://www.mouser.fr/ProductDetail/Texas-Instruments/TLV75533PDBVR/
Inductance L0805 1uH | 0.20 € | 1 | 0.20 €
LED 0805 RED / GREEN | 0.07 € | 7 | 0.49 €
Break away header (pour MA02 etc) | 1.50 € | 2 | 3.00 €
Connecteur IDC (autosécable) | 1.12 € | 2 | 2.24 € | https://fr.farnell.com/amphenol-icc-fci/89361-710lf/fiche-femelle-idc-10voies-minitek/dp/1623797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
pot 3RP/1610N | 0.66 € | 1 | 0.66 € | https://fr.farnell.com/tt-electronics-bi-technologies/p160knp-0qc20b500k/potentiometre-pour-panneau-500k/dp/1760797
Q-HC-46X 16MHz | 0.33 € | 1 | 0.33 € | https://www.mouser.fr/ProductDetail/ECS/ECS-160-20-46X?qs=7Z%2FjUg96RbX1FiBmeNAKfw==
R0805 | 0.05 € | 94 | 4.70 €
SWITCH B3F-10XX omron | 0.24 € | 3 | 0.71 € | https://www.mouser.fr/ProductDetail/Omron-Electronics/B3F-1000/?qs=lK7M36XCk6JQHckSc1xIsg%3D%3D
trimmer | 1.08 € | 8 | 8.64 € | https://fr.farnell.com/nidec-copal-electronics/ct-6er103/potentiometre-cermet-10k-1-tour/dp/2859740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
PCB (JLCPCB) | 5.00 € | 1 | 5.00 €
 |  | TOTAL | 92.84 €

Sheet: Front
Front pane v2.2
Value | Unit price | Qty | Total | Vendor
1uH |  | 1 | 0.00 €
B3F-1000 |  | 10 | 0.00 €
C0805 | 0.05 € | 178 | 8.19 €
C1206 | 0.05 € | 14 | 0.64 €
CPOL2917 | 0.30 € | 46 | 13.80 €
ENCODER_LED_3 | 4.00 € | 39 | 156.00 €
LED 0805 RED / GREEN | 0.17 € | 3 | 0.51 €
LED CZXR-80RGB03-A | 0.44 € | 10 | 4.40 € | https://www.mouser.fr/ProductDetail/645-5218559F
MCP23017 | 1.10 € | 8 | 8.80 € | https://fr.farnell.com/microchip/mcp23017-e-ss/ic-io-expander-16bit-smd/dp/1467674?CMP=GRHB-OCTOPART
NEOPIXEL-TLC59731DR | 0.50 € | 49 | 24.50 € | https://www.mouser.fr/ProductDetail/Texas-Instruments/TLC59731DR/?qs=s44pgLhgXQgiW%2FpyLmUsDA%3D%3D
Break away header (pour MA02 etc) | 1.50 € | 2 | 3.00 €
R0805 | 0.00 € | 22 | 0.07 €
R1206 | 0.00 € | 312 | 0.94 €
SKRKAEE020 | 0.63 € | 1 | 0.63 € | https://www.mouser.fr/ProductDetail/Alps-Alpine/SKRKAEE020/
IC STM32F446RCT7 | 6.13 € | 1 | 6.13 €
IC TLV75533PDBVR SOT | 0.45 € | 1 | 0.45 €
PCB (JLCPCB) | 10.00 € | 1 | 10.00 €
 |  | TOTAL | 238.05 €
