reynal/themis/resources/bug-fix-for-LEDs-soldered-wrong-direction-on-frontpane.ods

Normal | Cathode | Anode | Avec inversion des diodes
C1-1 | 2 | 1 | C2-1 | “to switch led C2-1 on, we must actually switch led C1-1” (and vice versa, see below)
C1-2 | 3 | 1 | C3-1
C1-3 | 4 | 1 | C4-1
C1-4 | 5 | 1 | C5-1
C1-5 | 6 | 1 | C6-1
C1-6 | 7 | 1 | C7-1
C1-7 | 8 | 1 | C8-1
C1-8 | 9 | 1 | C9-1
C2-1 | 1 | 2 | C1-1 | “to switch led C1-1, we must actually switch led C2-1” (and vice versa, see below)
C2-2 | 3 | 2 | C3-2
C2-3 | 4 | 2 | C4-2
C2-4 | 5 | 2 | C5-2
C2-5 | 6 | 2 | C6-2
C2-6 | 7 | 2 | C7-2
C2-7 | 8 | 2 | C8-2
C2-8 | 9 | 2 | C9-2
C3-1 | 1 | 3 | C1-2
C3-2 | 2 | 3 | C2-2
C3-3 | 4 | 3 | C4-3
C3-4 | 5 | 3 | C5-3
C3-5 | 6 | 3 | C6-3
C3-6 | 7 | 3 | C7-3
C3-7 | 8 | 3 | C8-3
C3-8 | 9 | 3 | C9-3
C4-1 | 1 | 4 | C1-3
C4-2 | 2 | 4 | C2-3
C4-3 | 3 | 4 | C3-3
C4-4 | 5 | 4 | C5-4
C4-5 | 6 | 4 | C6-4
C4-6 | 7 | 4 | C7-4
C4-7 | 8 | 4 | C8-4
C4-8 | 9 | 4 | C9-4
C5-1 | 1 | 5 | C1-4
C5-2 | 2 | 5 | C2-4
C5-3 | 3 | 5 | C3-4
C5-4 | 4 | 5 | C4-4
C5-5 | 6 | 5 | C6-5
C5-6 | 7 | 5 | C7-5
C5-7 | 8 | 5 | C8-5
C5-8 | 9 | 5 | C9-5
C6-1 | 1 | 6 | C1-5
C6-2 | 2 | 6 | C2-5
C6-3 | 3 | 6 | C3-5
C6-4 | 4 | 6 | C4-5
C6-5 | 5 | 6 | C5-5
C6-6 | 7 | 6 | C7-6
C6-7 | 8 | 6 | C8-6
C6-8 | 9 | 6 | C9-6
C7-1 | 1 | 7 | C1-6
C7-2 | 2 | 7 | C2-6
C7-3 | 3 | 7 | C3-6
C7-4 | 4 | 7 | C4-6
C7-5 | 5 | 7 | C5-6
C7-6 | 6 | 7 | C6-6
C7-7 | 8 | 7 | C8-7
C7-8 | 9 | 7 | C9-7
C8-1 | 1 | 8 | C1-7
C8-2 | 2 | 8 | C2-7
C8-3 | 3 | 8 | C3-7
C8-4 | 4 | 8 | C4-7
C8-5 | 5 | 8 | C5-7
C8-6 | 6 | 8 | C6-7
C8-7 | 7 | 8 | C7-7
C8-8 | 9 | 8 | C9-8
C9-1 | 1 | 9 | C1-8
C9-2 | 2 | 9 | C2-8
C9-3 | 3 | 9 | C3-8
C9-4 | 4 | 9 | C4-8
C9-5 | 5 | 9 | C5-8
C9-6 | 6 | 9 | C6-8
C9-7 | 7 | 9 | C7-8
C9-8 | 8 | 9 | C8-8
