reynal/themis/front-pane/eagle-schematics/v3/mechanical/laser-cutting-v2.dxf

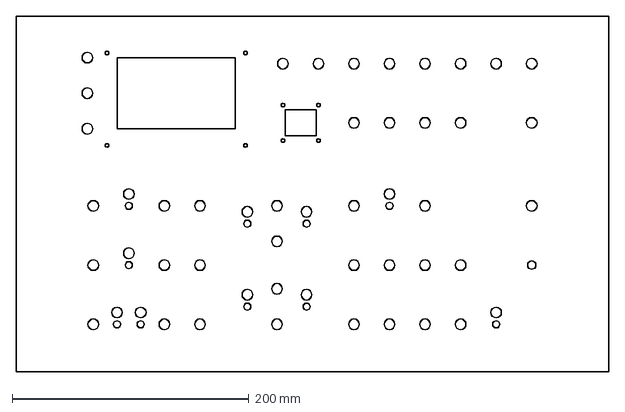
[picture p84: CAD file, 2022-09-02]
front-pane/eagle-schematics/v3/mechanical/laser-cutting-v2.dxf
500.0 x 300.0 mm
