reynal/themis/(list of files, cad)

Other CAD files:
front-pane/eagle-schematics/v3/mechanical/drills-and-engrave.dwg
front-pane/eagle-schematics/v3/mechanical/laser-engraving.dxf
front-pane/eagle-schematics/v3/mechanical/laser-cutting-v2.dwg
front-pane/eagle-schematics/v3/mechanical/laser-engraving.dwg
