reynal/themis/front-pane/RPi/RPi3 pin usage.odt

Affectation des broches des RPi3

| 3.3V | 5V
MCP23017 (expander GPIO) | I2C1 SDA | 5V
MCP23017 (expander GPIO) | I2C1 SCL | GND
| GPIO4 | UART TX
| GND | UART RX
| GPIO 17 | GPIO 18 | MIDI IN (sortie optocoupleur)
| GPIO 27 | GND
| GPIO 22 | GPIO 23 | MCP23017 (expander GPIO) : INT A
| 3.3V | GPIO 24 | MCP23017 (expander GPIO) : INT B
MOSI Rpi/STM | SPI0 MOSI | GND
| SPI0 MISO | GPIO 25
CLock RPi/STM | SPI0 CLK | SPI0 CS0 | Chip Select 0 Rpi/STM
| GND | SPI0 SP1
| Res | Res
| GPIO 5 | GND
| GPIO 6 | GPIO 12
| GPIO 13 | GND
| GPIO 19 | GPIO 16
| GPIO 26 | GPIO 20
| GND | GPIO 21

Remarques :

- pour interfacer les CNA MCP 4822 il faut un chip-select CS par circuit intégré et un signal LDAC commun => si on a 8 circuits (soit 16 sorties analo), il faut un décodeur 3 vers 8 (74HC238) => au total on aura besoin de 3+1+1=5 GPIO (en effet il faut aussi le signal enable du décodeur) => il en reste 11
- il y a 16 GPIO disponibles une fois qu'on a enlevé le bus SPI et l'UART
- il y a un second bus SPI, qui peut être activé si besoin via /boot/config.txt, et correspond à GPIO 16, 19, 20 et 21.
- encodeurs à quadrature : il faut deux entrées par bouton => utiliser un expander de bus GPIO "MCP23017" compatible I2C, chaque expander offre 16 GPIO supplémentaires (et de plus le circuit offre un mécanisme d'interruption via les sorties INT A et INT B)
- sur le même bus I2C on peut connecter un driver de matrice de LED pour les bargraphs
