reynal/themis/resources/design-guides/OTA tuto.pdf

BTS Electronique | 2000-2001

Io

C

E

B V⁺

V-

IABC

D:\pm6\2001-2002\TS_ELEC\cours\OP_AMP\OTA Version du 3 MAI 2002

# Table des matières

BTS Electronique Lycée P.E.MARTIN BOURGES | Daniel BERQUET | 2001-2002

I ABC

# AMPLIFICATEURS à TRANSCONDUCTANCE

## (Operational Transconductance Amplifiers: OTA)

I PRINCIPE
1.1) principe
Un OTA (amplificateur à transconductance) fournit un courant de sortie I o proportionnel à la tension différentielle

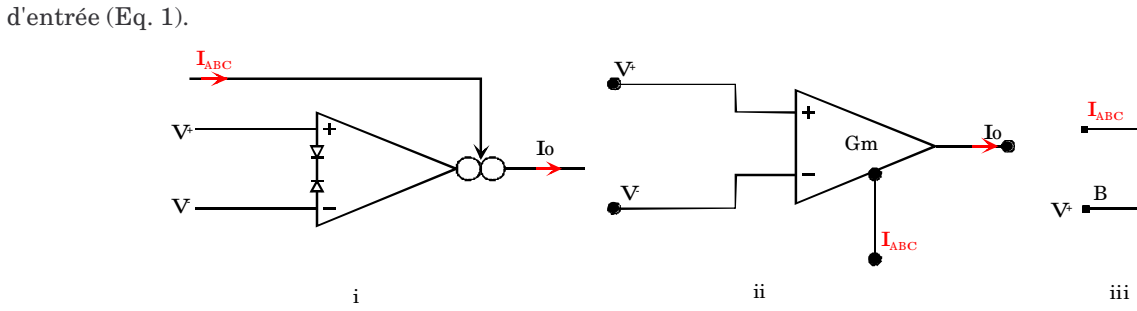
[picture p119: figure]
d'entrée (Eq. 1).; IABC; iii

Io gm.() V V | () Eq. 1 ⁺ | − = | −

La (trans)conductance gm s'exprime en mA/V (ou en mSiemens) .Gm est proportionnelle au courant de polarisation de l'amplificateur IABC qui doit être fourni à l'amplificateur suivant la formule:
( | ) Eq. 2 2. T
ABC m | V
I g = | voir Eq. 24

IABC: Amplifier Bias Current.
On est donc également en présence d'un amplificateur de courant. (d'où le symbole n°iii ressemblant à un transistor bipolaire)
La présence dans l'équation 1 de deux grandeurs d'entrée, V⁺-V⁻
et IABC dans l'expression du courant de sortie laisse d'emblée envisager la possibilité de réaliser une multiplication à l'aide d'un OTA.
Un OTA est essentiellement constitué d'une paire différentielle et de miroirs de courant.
L'impédance d'entrée Z i est très grande (comme celle d'un AOP).
La valeur de IABC peut être très faible <1µA et le courant total ICC absorbé par un tel composant est d'environ 3.IABC. , ce qui permet de réaliser des applications embarquées consommant très peu d'énergie.

2 différences distinguent l'OTA de l'AOP:

1 Puisque l'OTA est une source de courant, son impédance de sortie est élevée (contrairement à celle d'un AOP où Rs=qqs centaines d'Ω). On cherche souvent en effet pour les amplificateurs à obtenir une résistance de sortie faible, aussi les OTA modernes incorporent-ils un buffer de courant (connectable ou pas).
2 Il est possible de concevoir des circuits sans contre-réaction . En d'autres termes, au lieu d'utiliser la CR, dont on sait qu'elle réduit la sensibilité de montages aux paramètres (de l'AOP), avec un OTA il faut simplement considérer la conductance gm comme un élément de réglage de performances comme le font des composants tels des résistances ou des condensateurs.
1.2 Comportement en fréquence
La plupart des relations entre boucle ouverte , boucle fermée et la réponse en fréquence d'un OTA sont semblables à celles d'un AOP. Pour un circuit employant une contre-réaction et pour lequel la charge est capacitive, une relation importante donne la bande passante BWCL du montage en fonction de l'amplification en boucle fermée Acl et le courant de polarisation

IABC .
( ) | ( | ) Eq. 3 2. . . 2 . | CL

T

ABC

cl
C A

V

I
BW π =

Figure 1.1: Symboles et modèle électrique équivalent d'un OTA

V⁺

V-

Gm.Vdiff

Io

Io

C

E
V-

Cette relation intéressante montre que certains réseaux actifs comme les filtres actifs peuvent avoir leurs fréquences critiques réglées par le courant externe IABC qui peut varier facilement suivant une tension. On peut par exemple créer un filtre passe-bande dont la fréquence centrale est réglable par IABC

II Montages de base: Amplificateurs de tension à OTA.
2.1 Amplificateur à un OTA

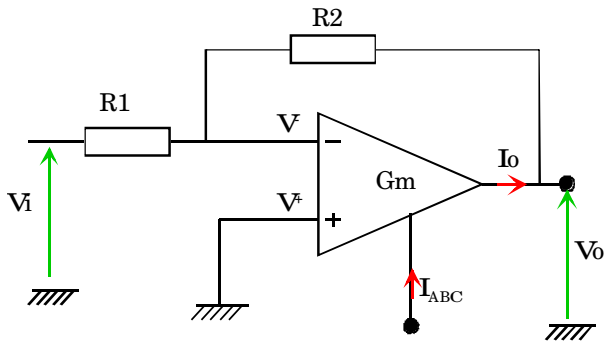
[picture p120: figure]
IABC

Fig. 2.1 Amplificateur de tension inverseur

Le montage représenté Fig. 2.1 réalise une amplification de tension donnée par:
() Eq. 4 1 | .
1 | .

1

2
g R

g R
Vi

Vo m m
+

− =

et l'impédance de sortie par: | () Eq. 5 1 g .R o R R
m | 1
1 | 2
+

+ Z =

exercice: Etablir l'équation 4 (solution voir annexe C)
Les équations 4 et 5 se simplifient si gm.R1>>1 , ce qui donne:
( | )
( | ) Eq. 7 .

Eq. 6 R

-R

1

1 2

1

2

g R

R R Z

V

V

m o

i

o
+ ≅

≅

Ce résultat, celui d'un système à réaction négative, qui n'est pas pour surprendre, montre que l'amplification n'est dépendante que des éléments du réseau de contre-réaction.
2.2 Amplificateur à deux OTA.
Ce deuxième exemple illustre bien ce que l'on peut attendre d'un OTA.

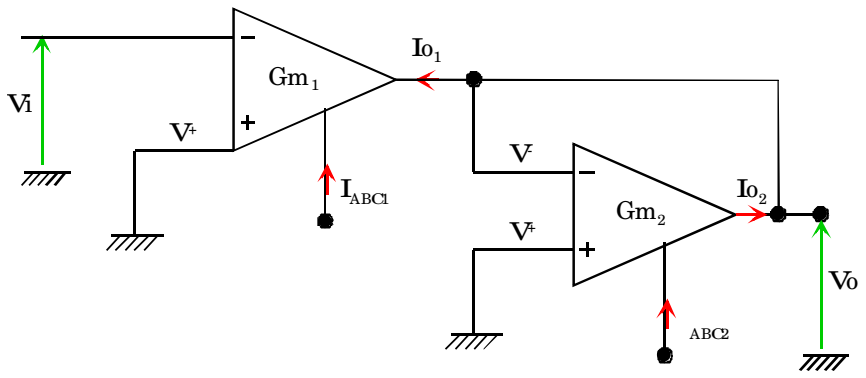
[picture p121: figure]
ABC2; IABC1

Fig. 2.2 Amplificateur de tension inverseur à 2 OTAs

L'amplification en tension et l'impédance de sortie sont données par les équations 8 et 9: () Eq. 8
g

g
- m2

m1 =

i

o
V

V

( ) Eq. 9
g

1

m2

Zo= | voir annexe D

L'amplification et l'impédance de sortie sont complètement réglables par les courants IABC1 et IABC2 sans autres composants passifs externes que ceux requis pour faire varier ces courants.
Remarque : gm1 pouvant être plus petite que gm2 (ou plus grande) l'amplification peut varier continûment de 0<Amin<1<Amax.
2.3 Résistance variable en fonction d'une tension ou d'un courant (VCR , ICR).

Gm2

fig. 2.3 Résistance variable en fonction d'une tension ou d'un courant (VCR ou ICR)

IABC

Vo

Vc

R

IO

V⁺

V⁻

c

T o c ABC

ABC

T

T

ABC o

o m

o o

o | m | m o

o

V

V R Z R

V I

I

V

V

I Z

V g

I Z

I g V g V

V V

2. .

2.

2.

1

(Eq.10) 1 d'où

≈ ⇒ ≅

= | = = =
= | =

=

| −

−

La résistance de sortie d'un OTA évolue comme une fonction en 1/x. 2.4 Filtre actif du 1er ordre passe bas à 1 OTA

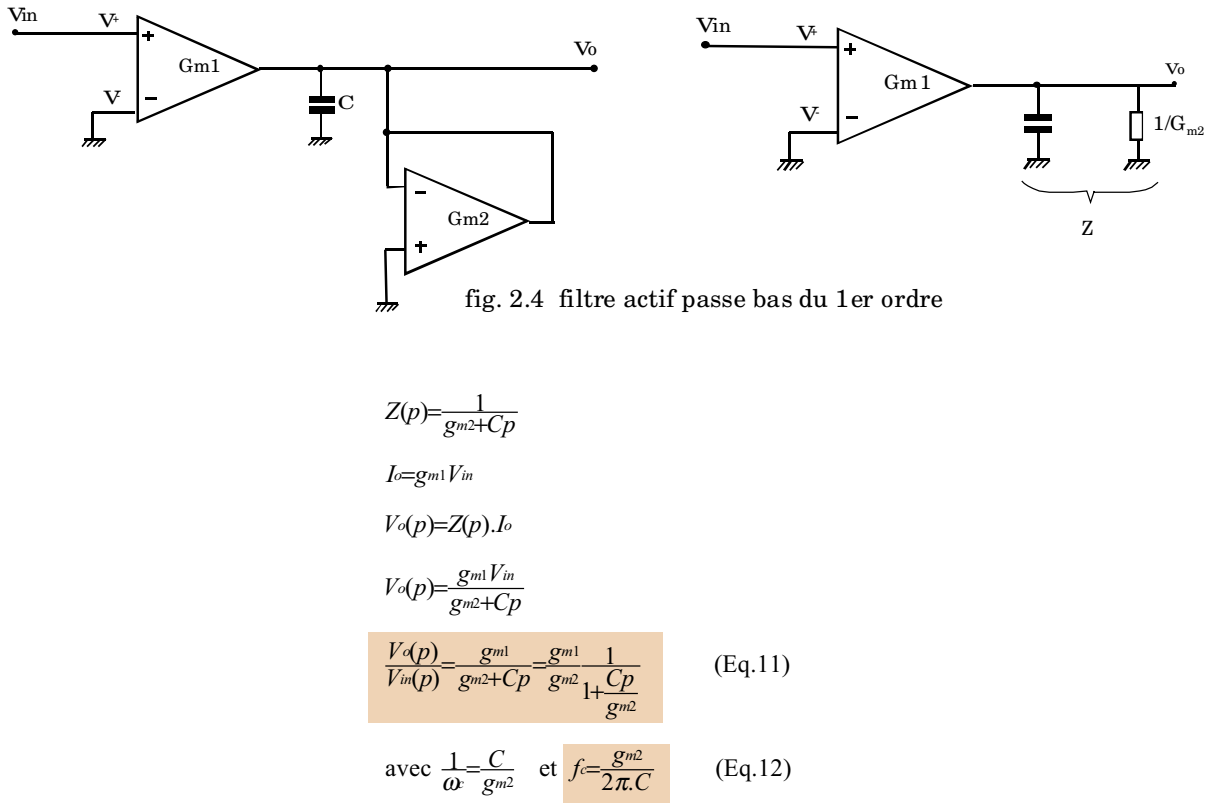
[picture p122: figure]
Vin; (Eq.12) 2 . et 1 avec

fig. 2.4 filtre actif passe bas du 1er ordre

La fréquence de coupure à 3dB fc

est donc ajustable par gm2 et ce, sans modifier les autres paramètres du filtre. 2.5 Filtre actif universel du second ordre (passe-bas , coupe bande , passe-haut, passe bande).

La figure 2.5 montre un tel filtre réalisé à l'aide de 2 OTA et configuré par 3 tensions VA, VB et VC. Ces filtres sont appelés "filtres à fréquence ajustable à Q constant" ; en effet, il préserve la valeur du coefficient de qualité Q sur toute la plage de variation de la fréquence critique fo

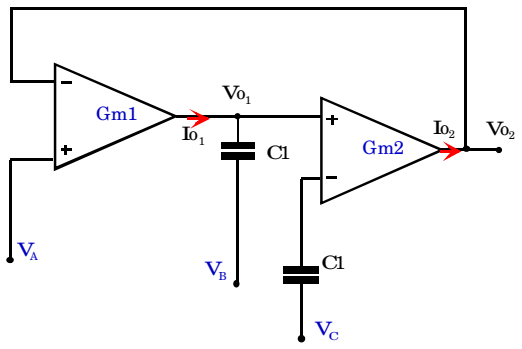
[picture p123: figure]

fig. 2.5 Filtre actif du second ordre

( | )
( | )
( | )

(Eq. 13)

1 | 2 | 1 | 2 | 1 | 2
1 | 2 | 1 | 2 | 1 | 2
1

et en regroupantles termesen 1

1
2

2

1 | 2
1 | 2 | 1
1
en remplaçant | 1 et | 2 par leur valeur on obtient:

2

2 1

1
1
1 2 2 | 2 2 | 2

1

1 1 | 1. | 1 | 2
1 | 1 1 | 1 1

2

2

2

m | m | m
m | m | A | m | B | C
O
| | | O
B | O | C
m | m | A | O | m O
o | o

C o O

B | O o o | m | m
B o C | o | C | B
o | m | m | A | O

### pC C pC g g g

### g g V pC g V pC C V V

V

### V V V C p

g

### C C p

### g g V V V

I I

### V C p

I V

### V V C p

### I I g V V g

### V C p

### I V I X V V

### I g V V g V V

+ | +
+ | +

−

+ + =

- −

=

+ − + − =

= +

= | = | + −
= | = = +
= | = | −
+ | −
+ | −

Dans les expressions précédentes p est la pulsation complexe ,p=jω et Io1, Io2 les courants de sortie des deux OTA. Ob obtient un filtre particulier en fixant:
Vin=VA; VB et VC sont reliés à la masse.
Gm1=Gm2=Gm
et en divisant l'expression de Vo1, au numérateur et au dénominateur par C1C2 pour obtenir une forme quadratique standard:

(Eq.14)

1 2

2
2

2

2

1 | 1 2

C C

g
C

pg p

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
Cette expression est de la forme standard:

(Eq. 15) 2 2

2

( )

1( )

o o

o

A p

O p
Q p p

V

V
ω ω

ω
+
- +

=

On obtient alors l'expression d'une fonction de transfert de filtre passe-bas dont la fréquence de coupure est donnée par:

(Eq.16 et 17) 1

2 et un coefficient de qualitéQ constant:
2 . 1 2 | C Q | C
C C
gm fo= | = π

pour obtenir d'autres filtres il convient d'adopter les réglages suivants:
√ | Vin=VB; VA et VC mis à la masse -->filtre passe-bande.
√ | Vin=VC; VA et VB mis à la masse -->filtre passe-haut.
√ | Vin=VA=VC; VB mis à la masse -->filtre coupe-bande.

III STRUCTURE INTERNE SIMPLIFIEE

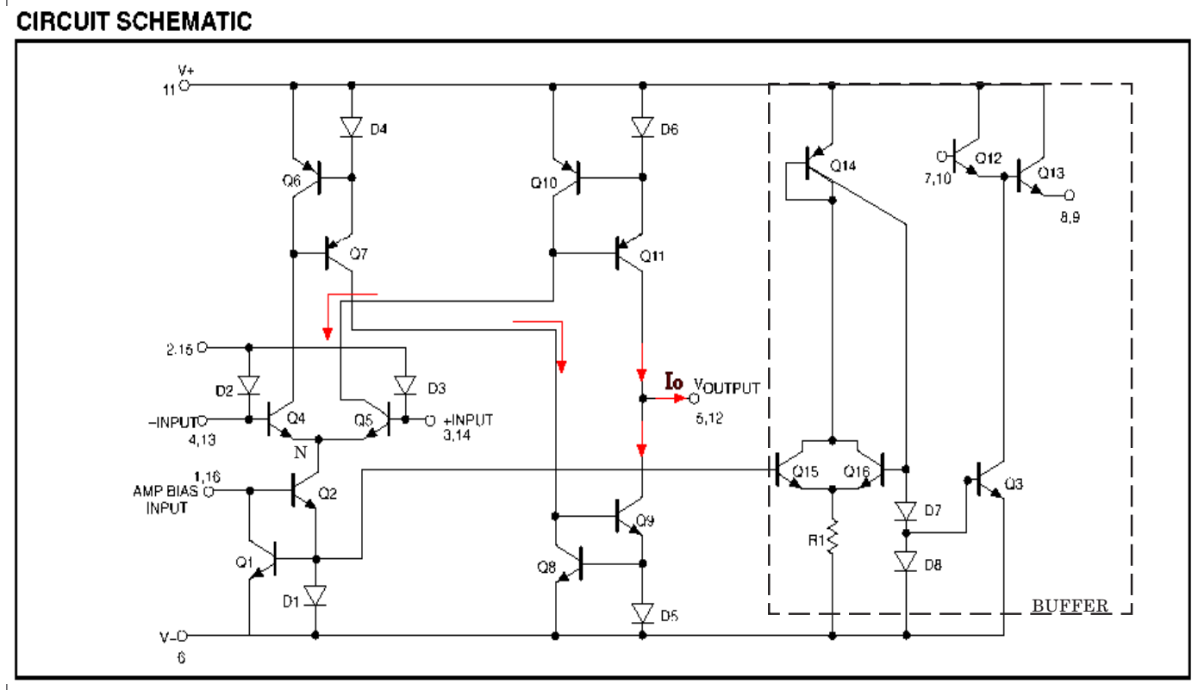
[picture p124: figure]
NE5517 philips figure 8page 10; BUFFER

L'amplificateur de transconductance est réalisé par une paire différentielle Q4,Q5 alimentée par le miroir de courant construit autour de Q1,Q2 et D1 . La somme des courants d'émetteurs de Q4 et Q5 est égale à IABC.
IABC =IEQ 4+IEQ 5 | ( | ) Eq. 18

La charge de collecteur de Q4 est constituée par un miroir de courant (Q6,Q7,D4); de même le collecteur de Q5 est chargé par un autre miroir (Q10,Q11,D6).on a alors:
ICQ 7=ICQ 4 | et ICQ 10= ICQ 5 | ( | ) Eq. 19

La charge de collecteur de Q7 est encore un miroir de courant (Q8,Q9,D5) dont le courant de sortie (Q9) "pompe" une partie

du courant de l'autre miroir de sortie (Q11), ce qui donne:
( | )
soit | ( | ) Eq. 21

## et enfin

et | Eq. 20
5 | 4
11 | 8
9 | 8 | 4 | 11 | 10 | 5
CQ | CQ
CQ | CQ
CQ | CQ | CQ | CQ | CQ | CQ
Io I | I
Io I | I
I | I | I | I | I | I

−

−
=

=

= = | = | =

L'équation 21 montre que le courant de sortie ( broche 5) est proportionnel à la différence des courants de collecteur de la paire différentielle d'entrée. L'ensemble est alimenté entre deux "rails" d'alimentation V⁺ ( broche 11) et V⁻ ( broche 6). Les entrées + et - de la paire différentielle sont connectées sur les bases de Q4 et Q5. Ces bases sont également reliées à deux diodes de linéarisation (voir annexe B), dont le point commun des anodes est relié à la broche externe 2.

La seconde partie du circuit (Q15,Q16,Q14,D7,D8,Q3, et Q12,Q13) constituent le buffer de courant et n'est pas étudié ici. On sait que la tension différentielle Vin =V+-V- de Q4,Q5 est proportionnelle au logarithme du
rapport des courants de collecteurs (voir annexe A) et est donné par:

ln | ( | ) Eq. 22 4
5
I

I
q

Vin KT

Q

Q

- =

où V 26mV à température ambiante(300K) q

KT= T≈

Si la tension Vin reste faible ( <<3.VT ) La fonction ln peut être approximée (voir annexe C) et donne:

ln | ( | ) Eq. 23

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
KT Vin | − =
- =

ce qui donne si les courants IQ4 et IQ5 ont des valeurs proches et que l'on peut écrire:

2 ⁵ | 4 | ABC Q | Q | I I ≈I =
( | ) Eq. 24 2. .
. 5 | 4 | Vin | Io K T
I | q I | I | ABC
Q − Q = | =
où | K T
I | q g
ABC m
2 . .
. = | est la transconductance de l'OTA.

IV CARACTERISTIQUES PRINCIPALES DES OTAs
Les caractéristiques d'un OTA sont assez semblables à celles d'un OpAmp. On trouve:
1°) Transconductance___ gm ___ Forward transconductance. | ordre de grandeur1mA /V ≤gm≤500 mA /V

définition:
in
o m | V
I g | ∆

∆ =

2°) Tension de décalage ___ Vos | ___ Input Offset Voltage | 100 µV ≤Vos≤30 mV
3°) Courant de décalage des entrées ___ Ios __ Input offset current | 1nA≤IOS≤100nA
4°) Courant de polarisation de l'amplificateur __ IABC __Input Amplifier Bias Current | 100nA≤IABC ≤500µA
5°) Courant de sortie maximum __ IOMAX _ Peak Output Current | IOS≤400mA
6°) Vitesse de montée de la sortie _ SR __ Slew Rate | 20V /µs≤SR≤8000 V /µs
7°) Impédance d'entrée __ Zin ( Rin, Cin) __ Input Impedance | Rin≥qqs M Ω, Cin≤5pF
8°) Impédance de sortie __ Zo (Ro, Co) __ Output impedance | Ro≥10kΩ (sans buffer), Co≤10pF

9°) Rapport de réjection du mode commun __ CMRR __ Common Mode rejection Ratio 70 dB≤CMRR ≤120 dB

10°) Produit gain bande passante __ BW __ | BW ≥qqs MHz

V EXEMPLES DE QUELQUES OTAS COMMERCIALISES
_ LM 13600 National Semiconductor
_ NE5517 | Philips
_ OPA660 | Burr-Brown.

VI APPLICATIONS
6.1 Amplificateur non inverseur

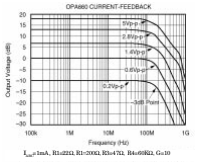
[picture p125: figure]
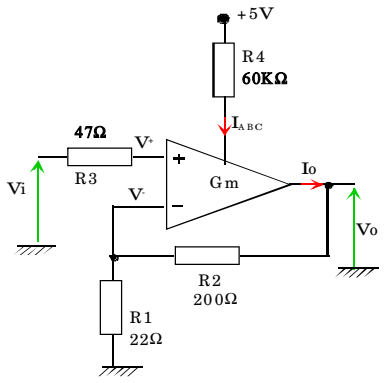
[picture p126: figure]

IABC=1mA, R1=22Ω, R1=200Ω, R3=47Ω, R4=60KΩ, G=10

( | )
( | ) | ( | )( | )
( | )( | )
( | ) ( | )
( | )
( | )
et si | 1 alors | 1

1 d' où

1

or | et
. | d' où

1

2 1

1

1 | 2
1 | 1 | 2
1 | 2 | 1
1 | 2
1 1 | 2
1 | 2

1

1 | 2 | 1 | 2

R

R
V

V R g

R g

g | R | R
V

V

V | R g | g V | R | R
V | V | R | R | V R g
g R | R
V R V | R | R | V
R | R
V R V | V | V
V | R | R | I | V | R | R | V | V | g
I | V | V | g

in

o m

m

m

in

o

o | m | m | in
o | in | o | m
m o o | in

o in

o | o | o | m
o | m
>> | = +

+

+ =

+ | = | +
= | + | −
+ = | + | −
+ = | =
= | + | = | + | −
= | −

+ | −
+ | −
+ | −

La figure précédente montre l'excellent comportement d'un OTA en fréquence (bien meilleur qu'un OpAmp à prix égal). La bande passante avoisine les 200MHz, ce qui en fait de bons candidats pour l'amplification des signaux vidéos.
6.2 Résistance variable en fonction d'une tension (VCR).

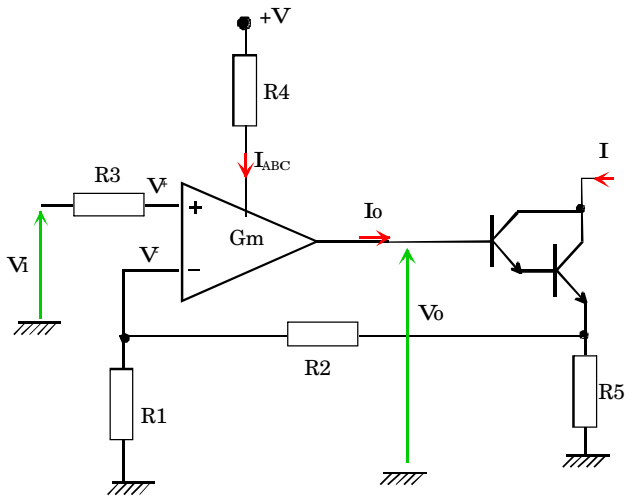
[picture p127: figure]
IABC

fig 6.2 Résistance variable en fonction d'une tension ou d'un courant VCR ou IC

Exercice : montrer que Zo est de la forme |

≈ | − | 2
1
Z o | 3 1 | R
R g r R | m be
avec Rbe=résistanced'entréedu darlington

6.3 Modulateur d'amplitude

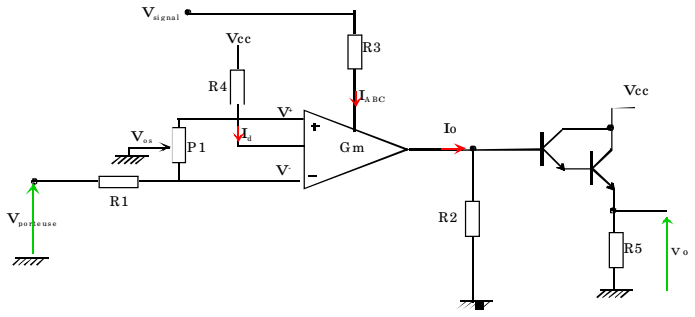
[picture p128: figure]
Vpo rteus e; Vcc; Vsi g na l

Fig 6.3 M odu late ur d'amplitude

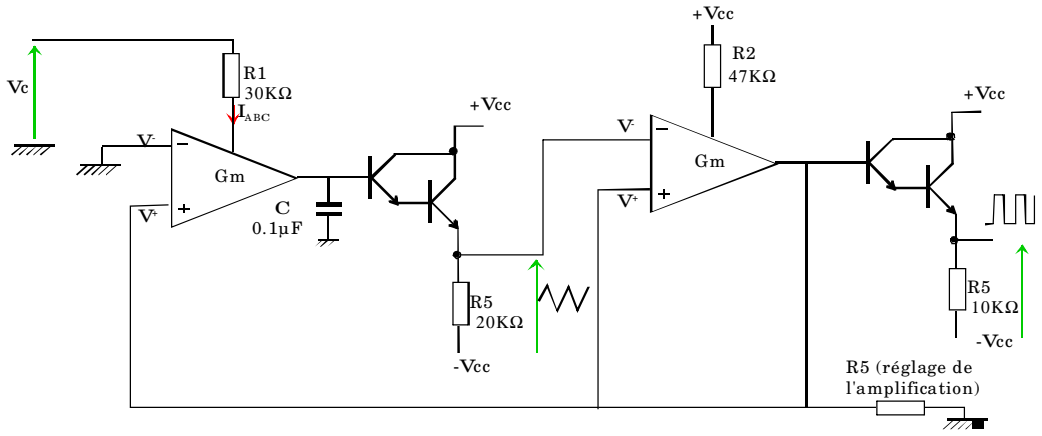
[picture p129: figure]
+Vcc; -Vcc; R5 (réglage de l'amplification)

Fig 6.4 Gén érateur de signaux tri angulaires (VCO)

exercice: Montrer que la fréquence des signaux produits est une fonction linéaire de Vc et montrer l'influence de R5 sur le montage.
6.5 Générateur de signaux en dents de scie (Sawtooth pulse VCO)

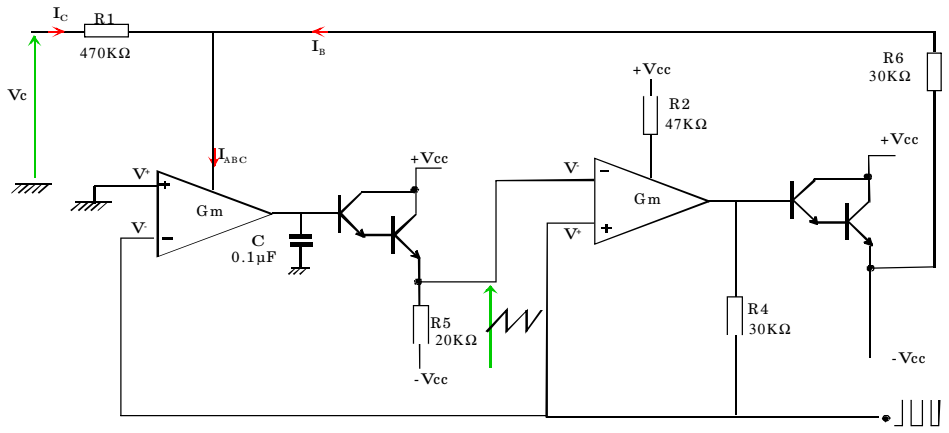
[picture p130: figure]
IABC; -Vcc

F ig 6.5 Gén éra teu r de den ts de sci e (VC O)

6.6 Pilote de courant haute vitesse (mise en parallèle de 2 OTA)

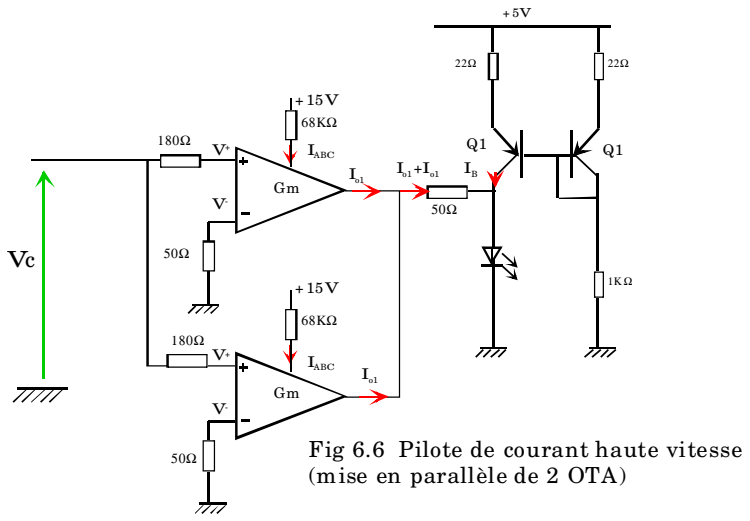
[picture p131: figure]
Fig 6.6 Pilote de courant haute vitesse (m ise en parallèle de 2 OTA); IABC

6.7 Driver de courant pour charge inductive (2 OTA en pont)

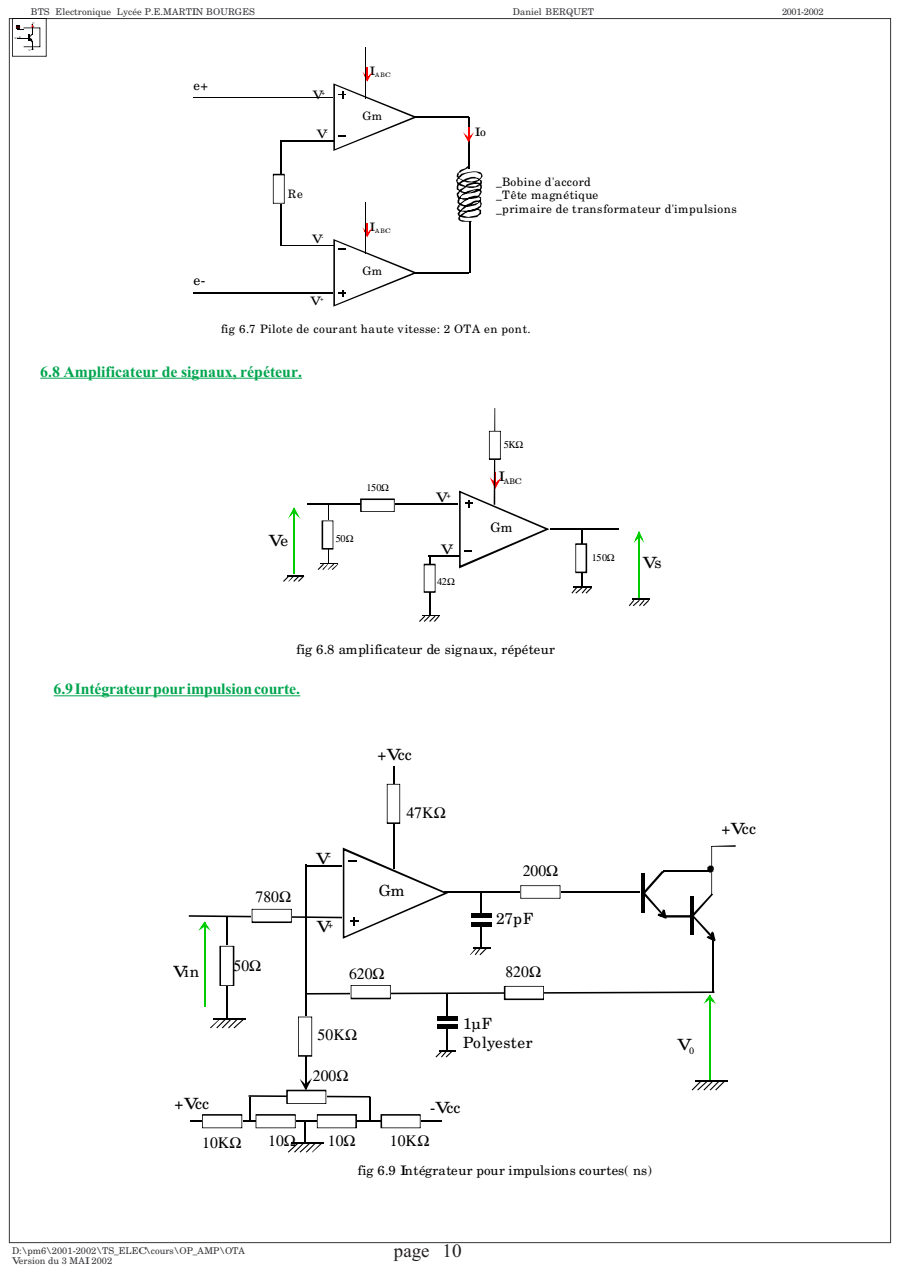
[picture p132: page 10]
IABC; +Vcc; 1µF Polyester; -Vcc; Vin

_Bobine d'accord
_Tête magnétique
_primaire de transformateur d'impulsions

fig 6.7 Pilote de courant haute vitesse: 2 OTA en pont.

6.8 Amplificateur de signaux, répéteur.

fig 6.8 amplificateur de signaux, répéteur

6.9 Intégrateur pour impulsion courte.

fig 6.9 Intégrateur pour impulsions courtes( ns)

VIII TRAVAUX PRATIQUES
On souhaite dans ce TP évaluer les performances d'un OTA simple (le NE5517 sans buffer) dans lequel les transistors PNP et NPN sont rigoureusement identiques. Les simulations se feront à 27°C
A) SIMULATION:En boucle ouverte, à l'aide de la figure 8.1 et 8.2, avec SPICE:
1) Vérifier le fonctionnement global de votre ampli à 1KHz sinus, Vin = 2mV.
2) Relever l'ordre de grandeur des courants, tension et puissance moyennes dissipées par les composants.
3) La valeur moyenne de la tension de sortie Vo n'est pas égale à 0. Alors que, tous les transistors (PNP et NPN) ayant des caractéristiques identiques, on pouvait s'attendre ,le montage étant "parfaitement" équilibré, à ce que la tension d'offset soit nulle ,il n'en est rien! Expliquer d'où vient le déséquilibre. Compléter le schéma pour résoudre ce problème.
4) Pour R1=68KΩ, déterminer la valeur du courant IABC et relever la valeur de gm.
5) Toujours à 1 KHz, déterminer expérimentalement les limites du courant IABC et tracer l'évolution correspondante de gm.
6) La tension d'offset évolue en fonction de la valeur de IABC . Proposer un réglage de cette tension d'offset pour pouvoir la réduire.
7) Pour R1=68KΩ, tracer la courbe de réponse en fréquence de cet amplificateur. On surveillera en permanence l'évolution du taux de distorsion du signal de sortie.
8) Quelle est la valeur maximale admissible pour Vin?
B) SIMULATION:Amplificateur de tension .En boucle fermée, selon le schéma de la figure 8.3:
1) Relever l'amplification Ao de votre montage à 1KHz; on considérera que cette valeur correspond à l'amplification en basse fréquence.
2) Tracer l'évolution de l'erreur de gain entre la valeur réelle du gain mesurée et la valeur approximée (voir eq xxxx p.8), en fonction du rapport R2/R3.
3) Tracer la courbe de réponse en fréquence en amplitude et en phase de l'amplificateur figure 8.3. Relever toutes les caractéristiques de ce filtre.
4) Comment évolue cette courbe de réponse en fréquence en fonction de IABC. L'amplificateur est-il toujours stable?
C) SIMULATION:Remplacer tous les transistors PNP par des Q2N2907:
1) Reprendre l'ensemble des mesures en indiquant les divergences ou les convergences de fonctionnement.

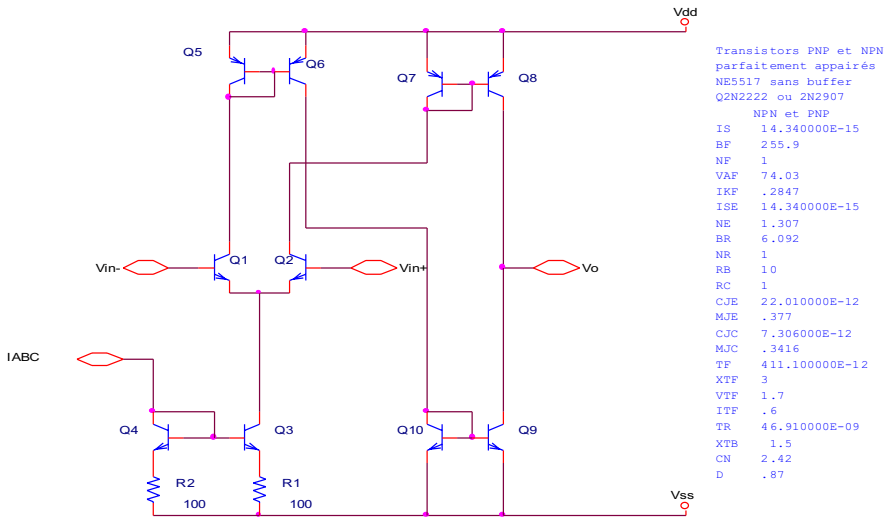
[picture p133: figure]
Vin-; Transistors PNP et NPN; parfaitement appairés; NE5517 sans buffer; NPN et PNP; VAF; IKF; ISE; CJE; MJE; CJC; MJC; XTF; VTF; ITF; XTB; IABC; Vdd; Vss; Vin+

figure 8.1

0

V2
15Vdc

Vss

V3

FREQ = 1K

VAMPL = 2m

VOF F = 0

V1
15Vdc

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
N E5517

Vin+

Vin-

IABC

Vo

V

R1

68k

figure 8.2

V

0

V2
15Vdc

R2

4k

V1
15Vdc

V3

FREQ = 1KH z

VAMPL = 100mV

VOFF = 0

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
NE5517

Vin+

Vin-

IABC

Vo

V

Vdd

fig 8.3

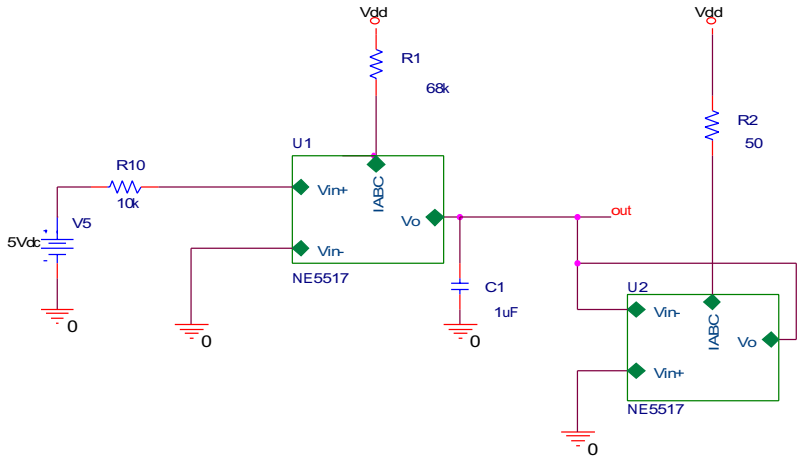
[picture p134: figure]
out; Vdd; Vin+; Vin-; IABC; 5Vdc

fig 8.4
D) MANIPULATION: Câbler un OTA NE 5517 en amplificateur tel celui de lafigure 8.2). (Utiliser la maquette fournie). Vous remarquerez le soin avec lequel les alimentations de l'OTA ont été découpléees au plus près des broches du circuit et les plans de masse réalisant des blindages pour les pistes "sensibles" (lire "longues et de hautes impédan ces").
1) Relever les caractéristiques de votre OTA pour pouvoir les comparer à la simulation se votre structure.
E) MANIPULATION : Câbler un OTA NE 5517 en amplificateur de tension non inverseur (tel celui de la figure 8.3)
1) Relever les caractéristiques du montage et comparer.
F) MANIPULATION: Réaliser le filtre passe-bas du 1er ordre avec la maquette tel celui de la figure 8.4
1) Relever les caractéristiques du montage et comparer.
G) MANIPULATION: Réaliser un filtre réjecteur de 50Hz à l'aide de la maquette.
1) Vérifier ses performances. Q, fréquence propre, bande passante etc...
H) MANIPULATION: on souhaite réaliser un analyseur de spectre basse fréquence pour surveiller les harmoniques du secteur jusqu'à 10.fo;
1) Proposer une solution.
2) La mettre en oeuvre

IX ANNEXES
ANNEXE A

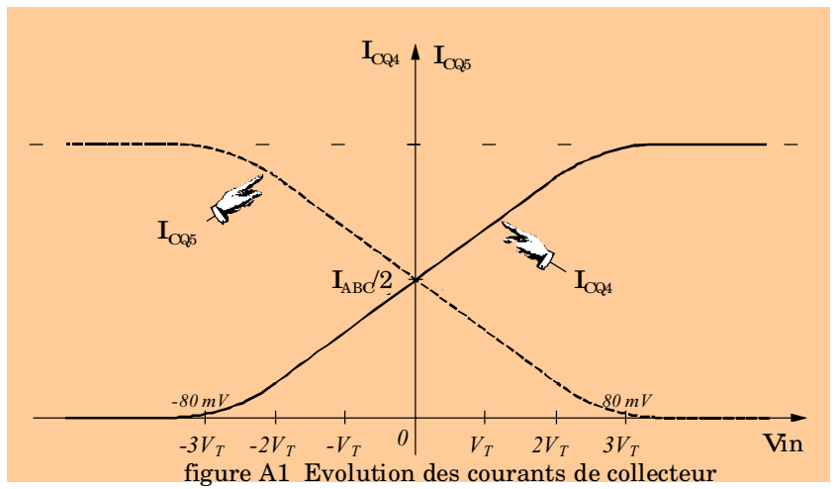
[picture p135: figure]
ICQ4; ICQ5; IABC/2; Vin

figure A1 Evolution des courants de collecteur

On sait que le courant de collecteur d'un transistor bipolaire est donné par: ( | ) T

BEQ

T

BEQ

T

BEQ

V

V
CQ S

V

V
V | S

V
CQ | S
I | I e
I | I e | I e 5
4 | 4

1 .

5

4
=

= − ≈

L'évolution de ces courants de collecteurs est montré ci-dessus figure A1 on obtient en faisant le rapport des courants:

e | V | e
V | V V V
e I
I | T in

T

BEQ | BEQ | V

V
T
N | N
V

V V

CQ

CQ | −

−

− | = − − + +
≈ | = ⁴ | 5

5

4

et en prenant le logarithme des deux membres
- = 4
5 ln

CQ

CQ

T

in
I

I
V
V | d'où l'expression 14

ANNEXE B
Comme le montre la figure A1 de l'annexe A pour des tension plus grande que quelques dizaines de mV (environ Vin ≥3.VT ), l'évolution des courants de collecteurs n'est plus linéaire, l'équation 16 n'est plus valable et la

transconductance gm évolue de façon non linéaire. La figure A2b modélise le comportement des diodes de linéarisation dont le rôle est d'étendre la dynamique de la tension d'entrée Vin de l'OTA (notamment lorsqu'il n'y a pas le contre-réaction).

Id

IcQ4 | IcQ5

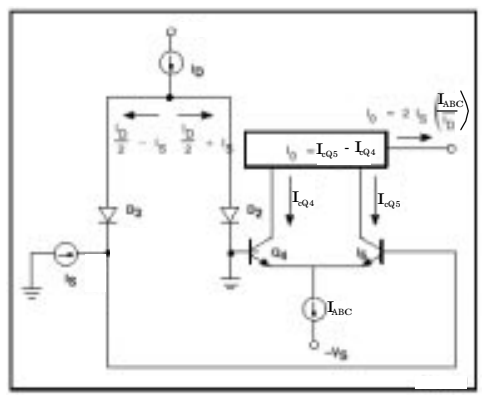
[picture p136: figure]
IABC; I cQ5 IcQ4; IcQ5 - IcQ4
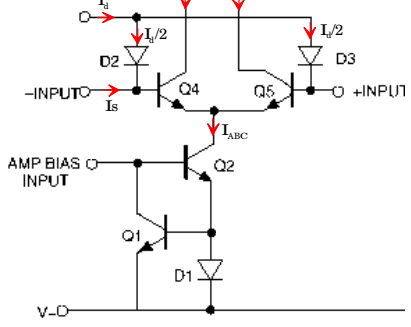
[picture p137: figure]
IABC

fig A 2a: schéma structurel partiel des entrées | fig A2b: modélisation d es entrées

Puisque

IABC =IEQ4+IEQ5 et que Io =I CQ 5− I CQ 4 on obtient facilement:

ICQ4=IABC −I0 et

ICQ5=IABC+I0

Pour des diodes et des transistors d'entrées de même géométrie et soumis à la même température (donc β identiques entre autres) la relation suivante est vraie:
( | )
( | ) 2
1

2

1
ln
2
2 ln |
−

+ =

−
+ = | I | Io
| I | Io
q

KT
Is I

Is I

q

KT Vin | ABC

ABC

d

d
ce qui donne
( | )
( | )
( | )( | ) ( | )( | )

soit:

4 | 2
2 | 2 | 2 | 2
2 | 2 | 2 | 2
2 | 2

2

1

2

1

2

2

IsI | I Io
I I | IsI | I I | IsI | IsIo I Io IsIo I Io
I I | IsI | IsIo I Io I I | IsI | IsIo I Io
I | Is I | Io I | Is I | Io
I | Io
I | Io
Is I

Is I

ABC | d
d ABC | ABC | d ABC | ABC | d | d
d ABC | ABC | d | d ABC | ABC | d
d | ABC | d | ABC
| ABC

ABC

d

d

=

+ | − | + | =− | + | + | +
+ | − | − = | − | − | +
+ | − = − | +
| −

+ = −

+

2 si 2 | d s

d

ABC s | I I I
I Io=I | <

la seule limitation est que le courant du signal d'entrée n'excède pas le courant Id

ANNEXE C:

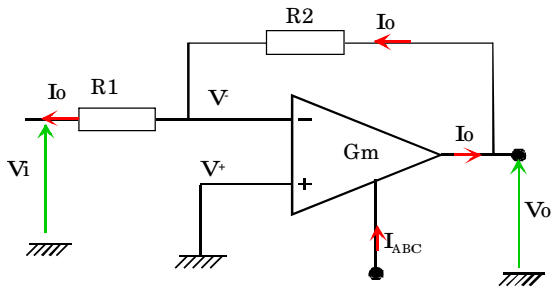
[picture p138: figure]
IABC

il est facile d'exprimer le comportement du montage en écrivant les 2 mailles :
( )
( | ) | 1 m
| 1 m

1 m

1 | m
1 | g
1 | g

g

1 | or | 0 et | g

R

V V V | R | V

### V R V V

V R I V V | V | I | V V

in in

in

in | o | o

+ = ⇒ − + − =

− | −= −
− −+ = + | + −− + = | =

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
