reynal/themis/front-pane/eagle-schematics/v3/print.png

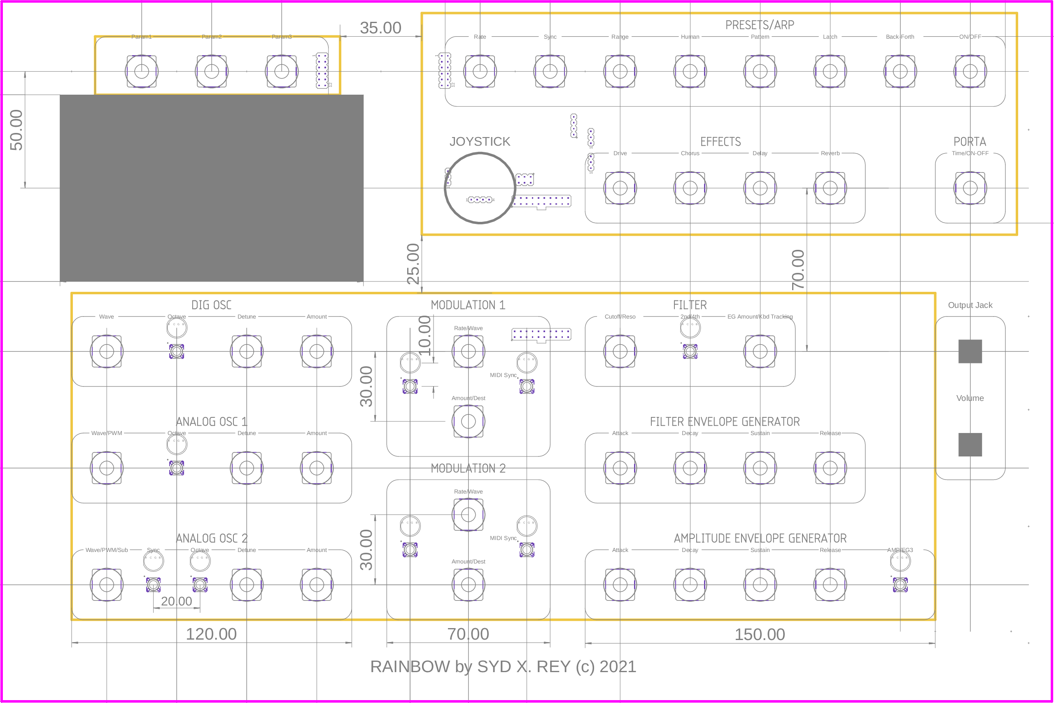
front-pane/eagle-schematics/v3/print.png
