reynal/themis/resources/design-guides/Triangle to saw converter.jpg

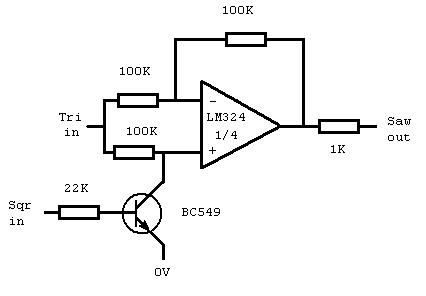
resources/design-guides/Triangle to saw converter.jpg
