reynal/themis/front-pane/eagle-schematics/v3/debug-labels.docx

Attention : ceci est le RECTO ! (i.e. vu depuis la face BOTTOM du PCB)

Bas de la carte NORTH :

I2C2 SCL | INT A31 | INT B32 | INT B2 | I2C3 SCL | INT B12 | INT A11 | SPI1 MOSI | 3V3 | 3V3
SPI3 MOSI | INT B31 | INT A32 | INT A2 | I2C3 SDA | INT A12 | INT B11 | I2C2 SDA | RST | GND

PETITE CARTE NORTH WEST :

2B | 3A | 3B | 1SW | 2SW | 3SW
2A | PXIN | GND | 1B | 1A | 3V3

Haut de la carte SOUTH : (doit correspondre aux labels du bas de la carte NORTH)

I2C2 SCL | EXTI 14 | EXTI 6 | EXTI 8 | I2C3 SCL | EXTI 10 | EXTI 12 | SPI1 MOSI | 3V3 | 3V3
SPI3 MOSI | EXTI 1 | EXTI 15 | EXTI 7 | I2C3 SDA | EXTI 9 | EXTI 11 | I2C2 SDA | RST | GND
