reynal/themis/analog-modules/VCF AS3320/VCF-LP-BP-HP_v4 - TOP.pdf

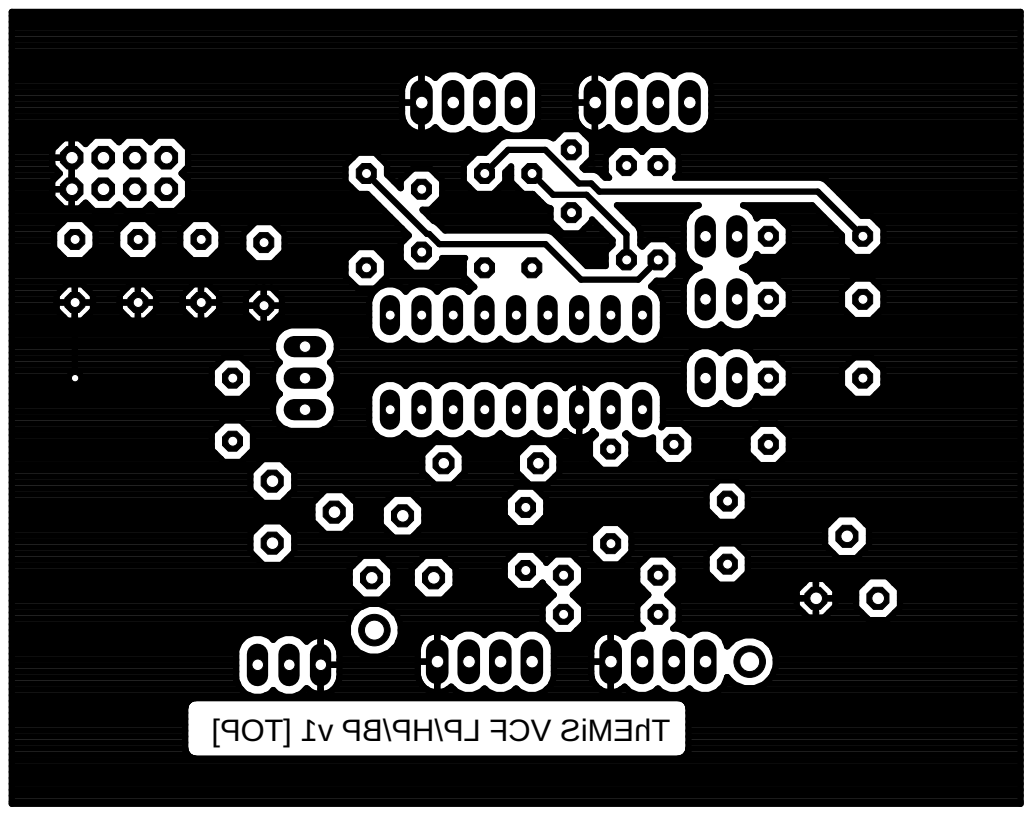
[picture p141: page 1]

] POT[ 1v PB/ PH/ PL FCV Si MEhT
