reynal/themis/analog-modules/Output stage/output stage and VCA v2 - BOTTOM.pdf

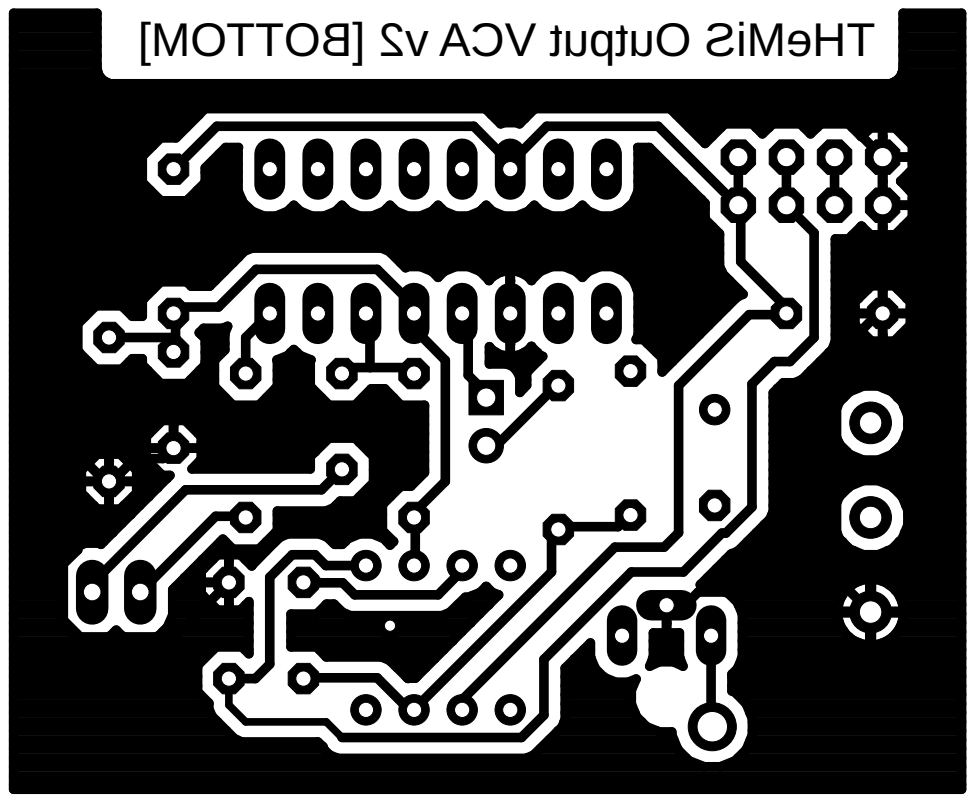
[picture p142: page 1]

] MOTT OB[ 2v ACVt upt u O Si Me HT
