reynal/themis/analog-modules/Output stage/output stage and VCA v2 - TOP.pdf

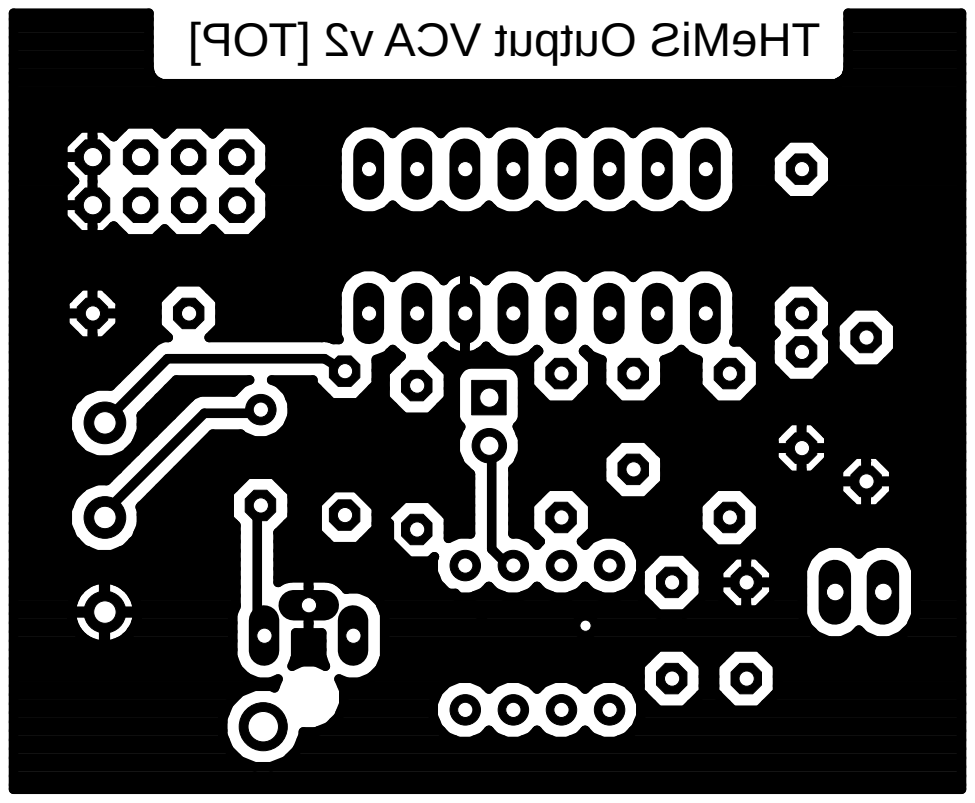
[picture p143: page 1]

] POT[ 2v ACVt upt u O Si Me HT
