reynal/themis/front-pane/raspberry-shield/Xbee-pcb-bottom.pdf

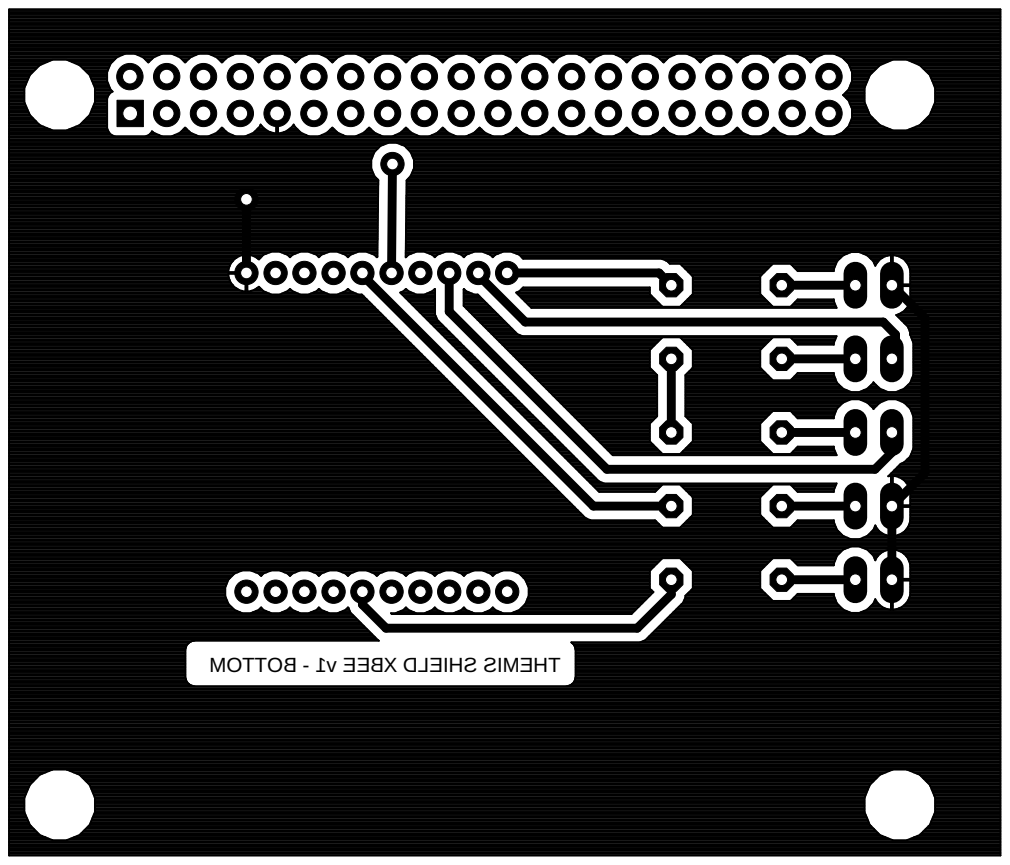
[picture p144: page 1]

MOTT OB- 1v EEBX DLEI HS SI MEHT
