reynal/themis/front-pane/raspberry-shield/Xbee-pcb-TOP.pdf

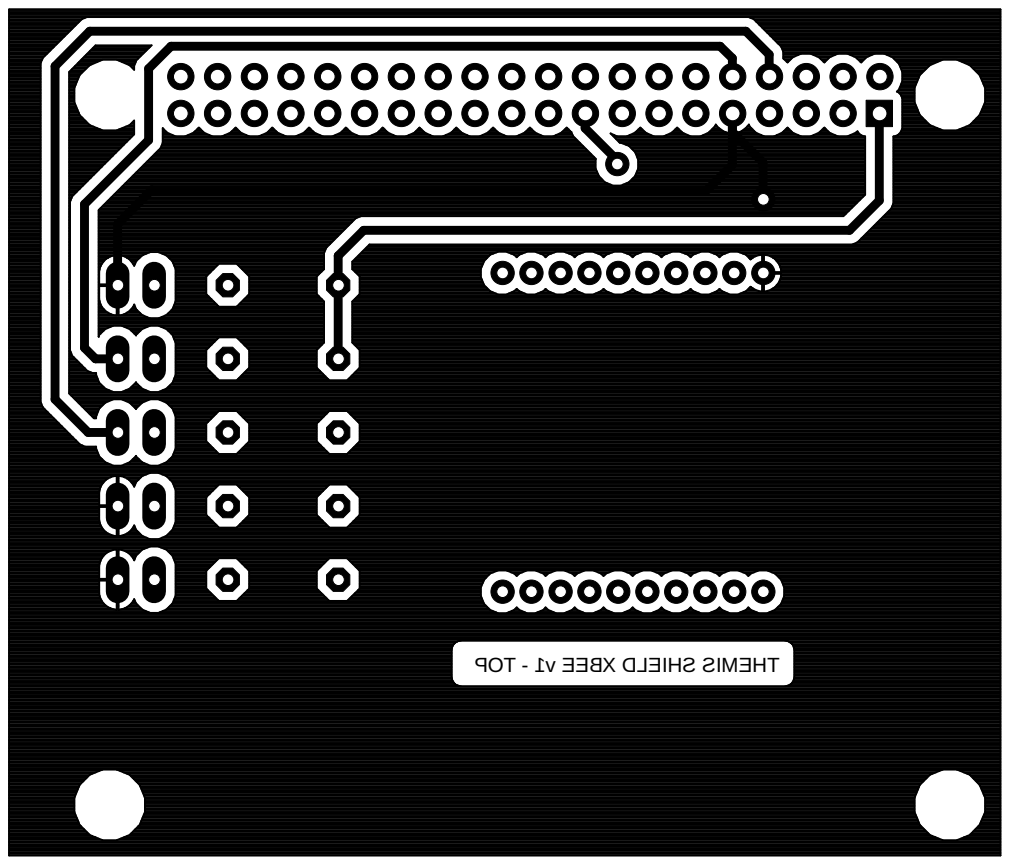
[picture p145: page 1]

POT- 1v EEBX DLEI HS SI MEHT
