reynal/themis/analog-modules/VCO AS3340/VCO3340 v2.pdf

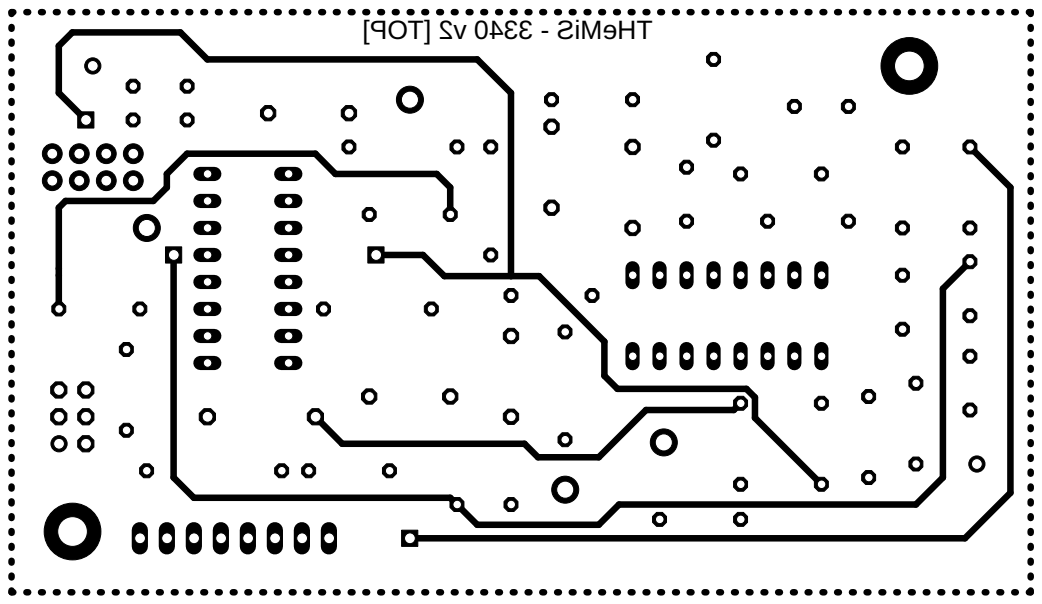
[picture p146: page 1]

] POT[ 2v 0433- Si Me HT
