reynal/themis/analog-modules/Mixer 2164D/V2164MIXER v2 TOP.pdf

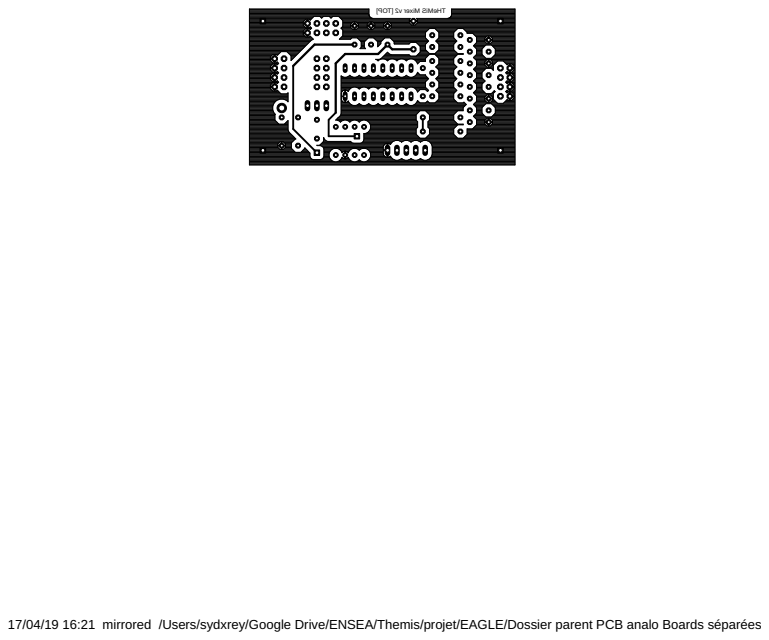
[picture p148: page 1]

17/04/19 16:21 mirrored /Users/sydxrey/Google Drive/ENSEA/Themis/projet/EAGLE/Dossier parent PCB analo Boards séparées/pcb V2164D - Thomas/V2164MIXER v2.brd
