reynal/themis/analog-modules/Output stage/output stage v1 BOTTOM.pdf

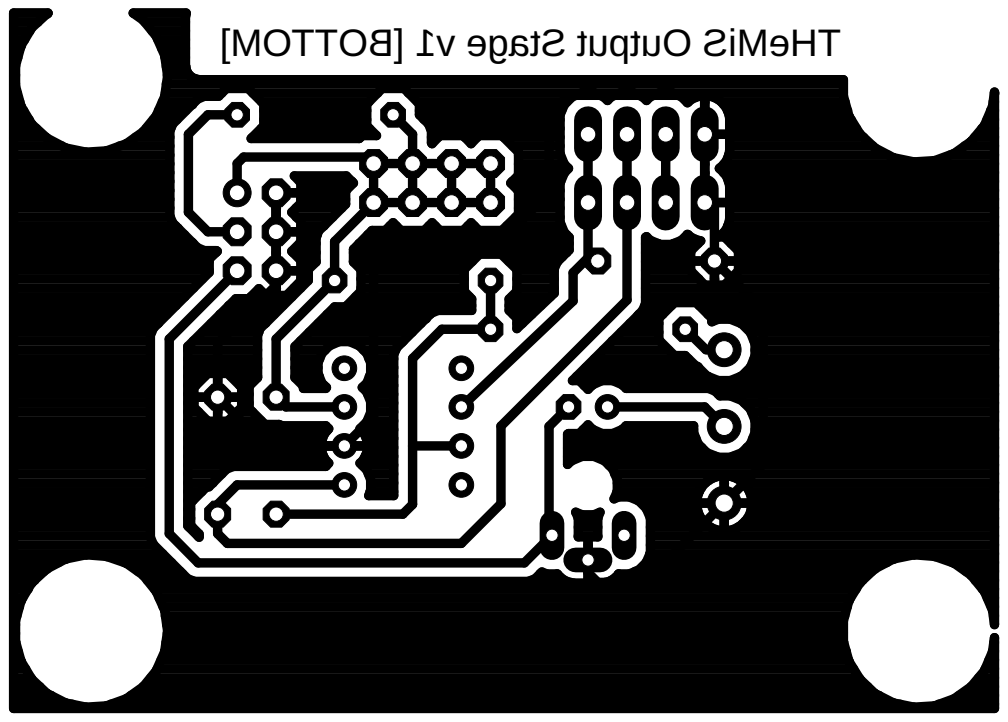
[picture p149: page 1]

] MOTT OB[ 1v egat St upt u O Si Me HT
