reynal/themis/analog-modules/Output stage/output stage v1 TOP.pdf

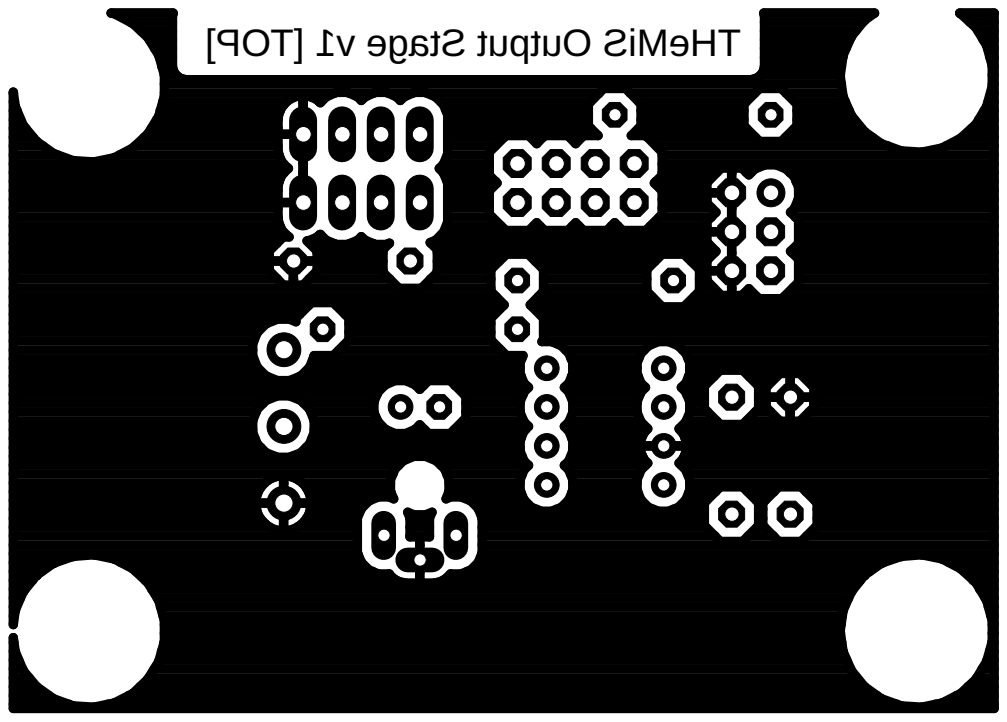
[picture p150: page 1]

] POT[ 1v egat St upt u O Si Me HT
