reynal/themis/analog-modules/Ring Modulator/ring modulator BOTTOM.pdf

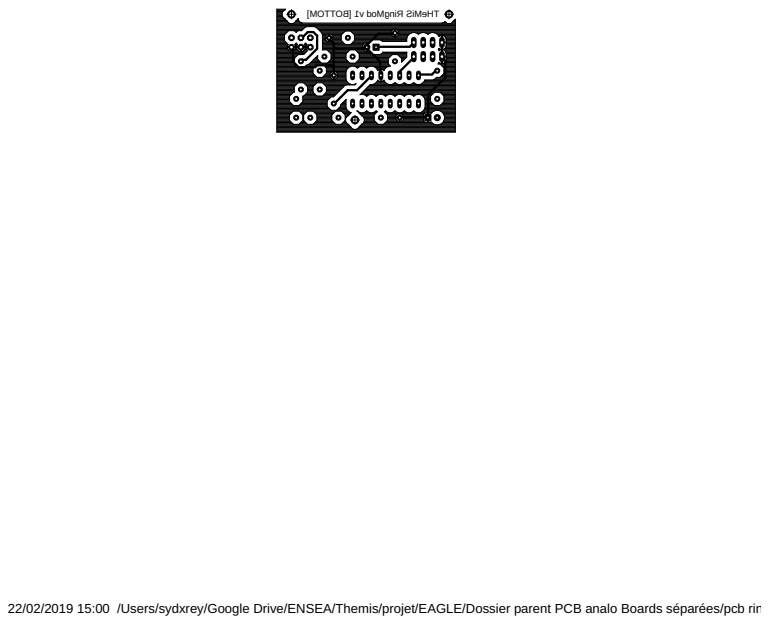
[picture p151: page 1]

22/02/2019 15:00 /Users/sydxrey/Google Drive/ENSEA/Themis/projet/EAGLE/Dossier parent PCB analo Boards séparées/pcb ringmodulator - Mathieu/ring modulator.brd
