reynal/themis/analog-modules/VCF AS3320/vcf-v1-BOTTOM.pdf

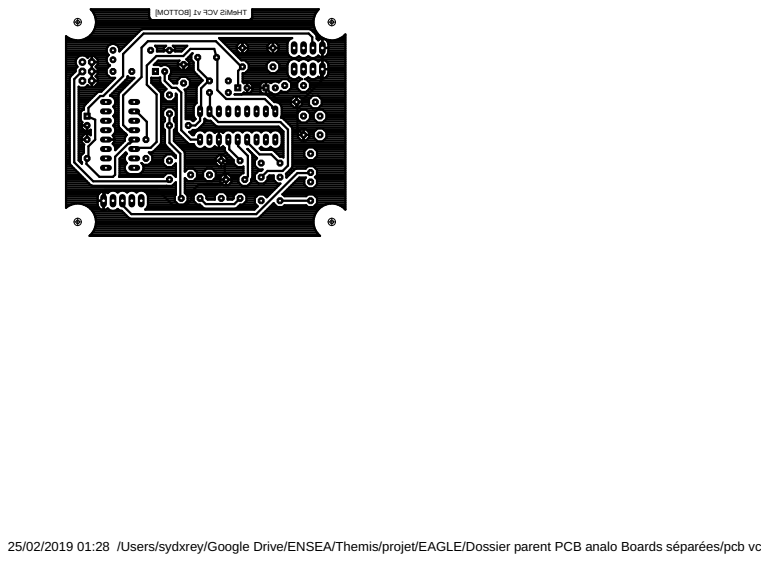
[picture p152: page 1]

25/02/2019 01:28 /Users/sydxrey/Google Drive/ENSEA/Themis/projet/EAGLE/Dossier parent PCB analo Boards séparées/pcb vcf et etage sortie/pcb - vcf et etage sortie.brd
