reynal/themis/analog-modules/VCO AS3340/VCO3340 v2 BOTTOM.pdf

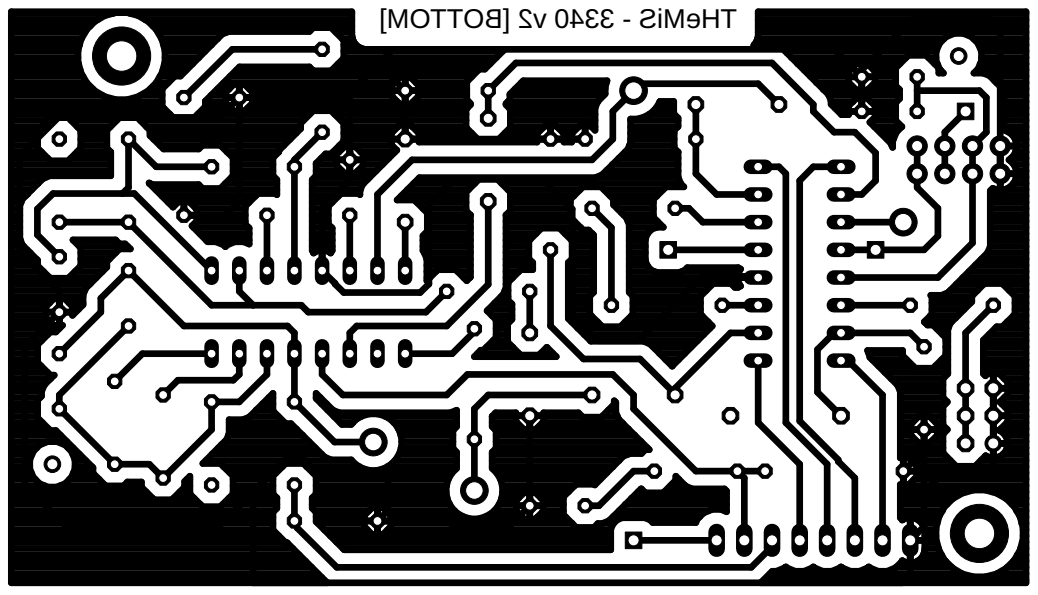
[picture p153: page 1]

] MOTT OB[ 2v 0433- Si Me HT
