reynal/themis/analog-modules/VCO AS3340/VCO3340 v2 TOP.pdf

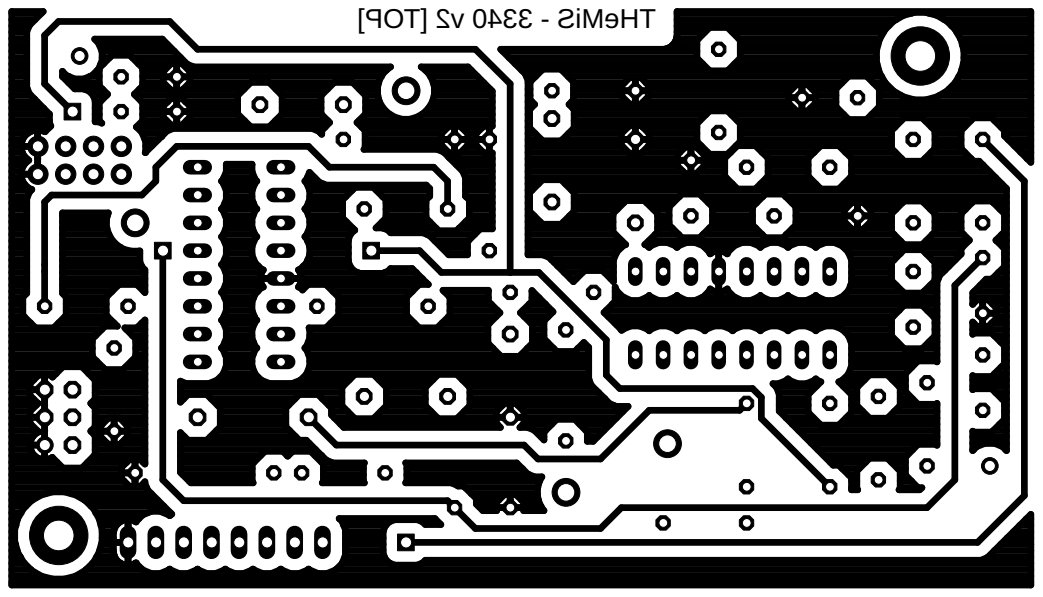
[picture p154: page 1]

] POT[ 2v 0433- Si Me HT
