reynal/themis/analog-modules/VCO LM13700/LM13700_v1 - BOTTOM.pdf

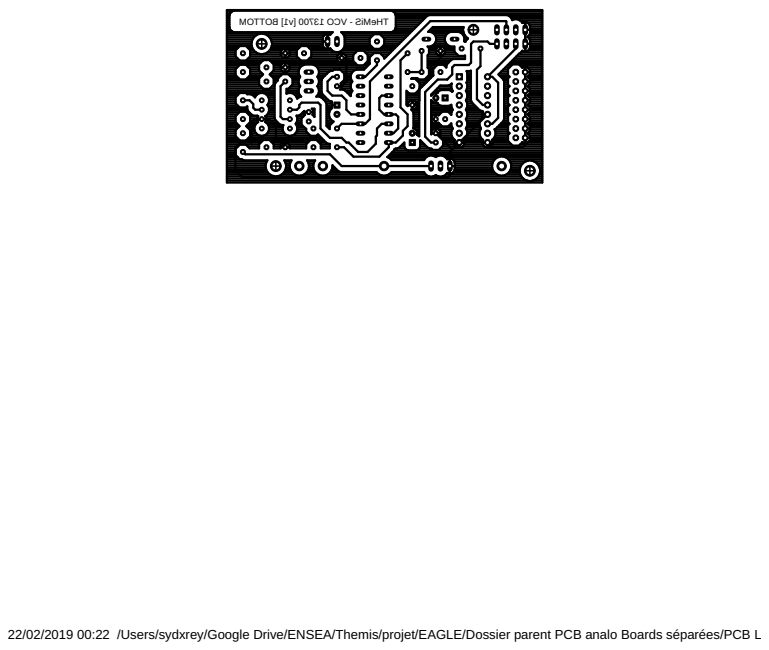
[picture p155: page 1]

22/02/2019 00:22 /Users/sydxrey/Google Drive/ENSEA/Themis/projet/EAGLE/Dossier parent PCB analo Boards séparées/PCB LM13700 - Nathan /PCB_LM13700.brd
