reynal/themis/analog-modules/VCO LM13700/LM13700_v2 BOTTOM.pdf

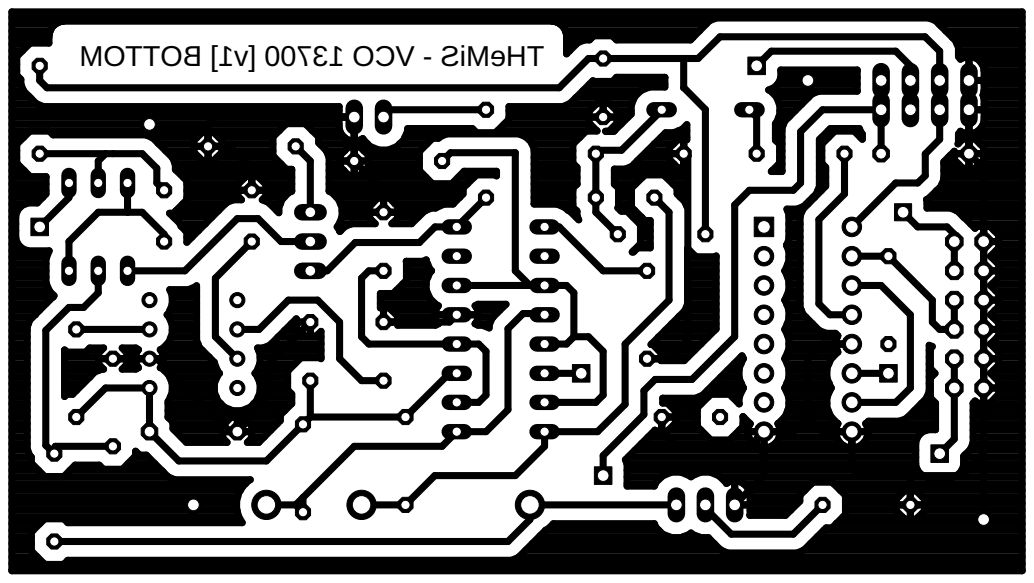
[picture p156: page 1]

MOTT OB] 1v[ 00731 OCV- Si Me HT
