reynal/themis/analog-modules/VCO LM13700/LM13700_v2 TOP.pdf

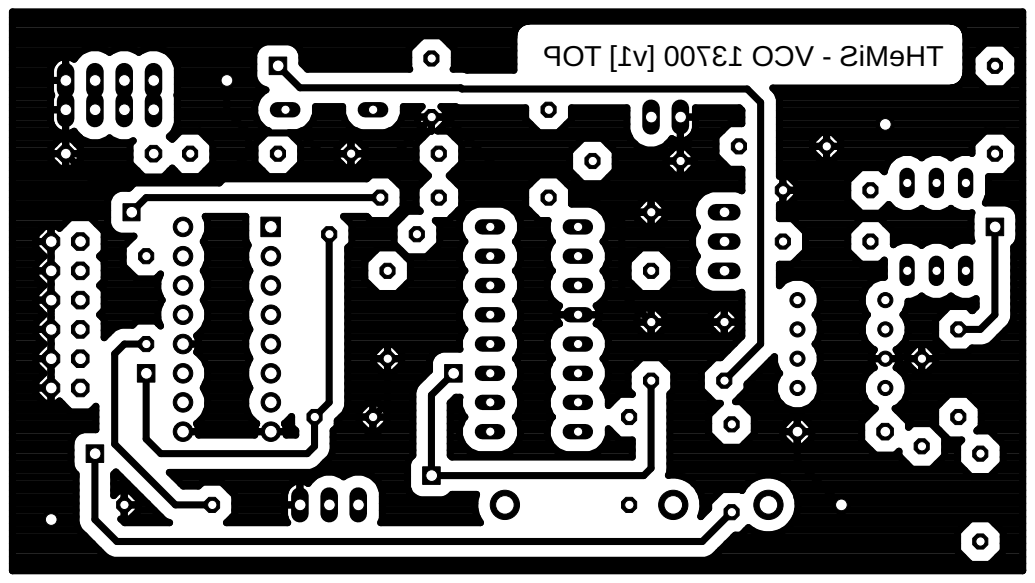
[picture p157: page 1]

POT] 1v[ 00731 OCV- Si Me HT
