reynal/themis/resources/mechanical/front pane.pdf

# PADS

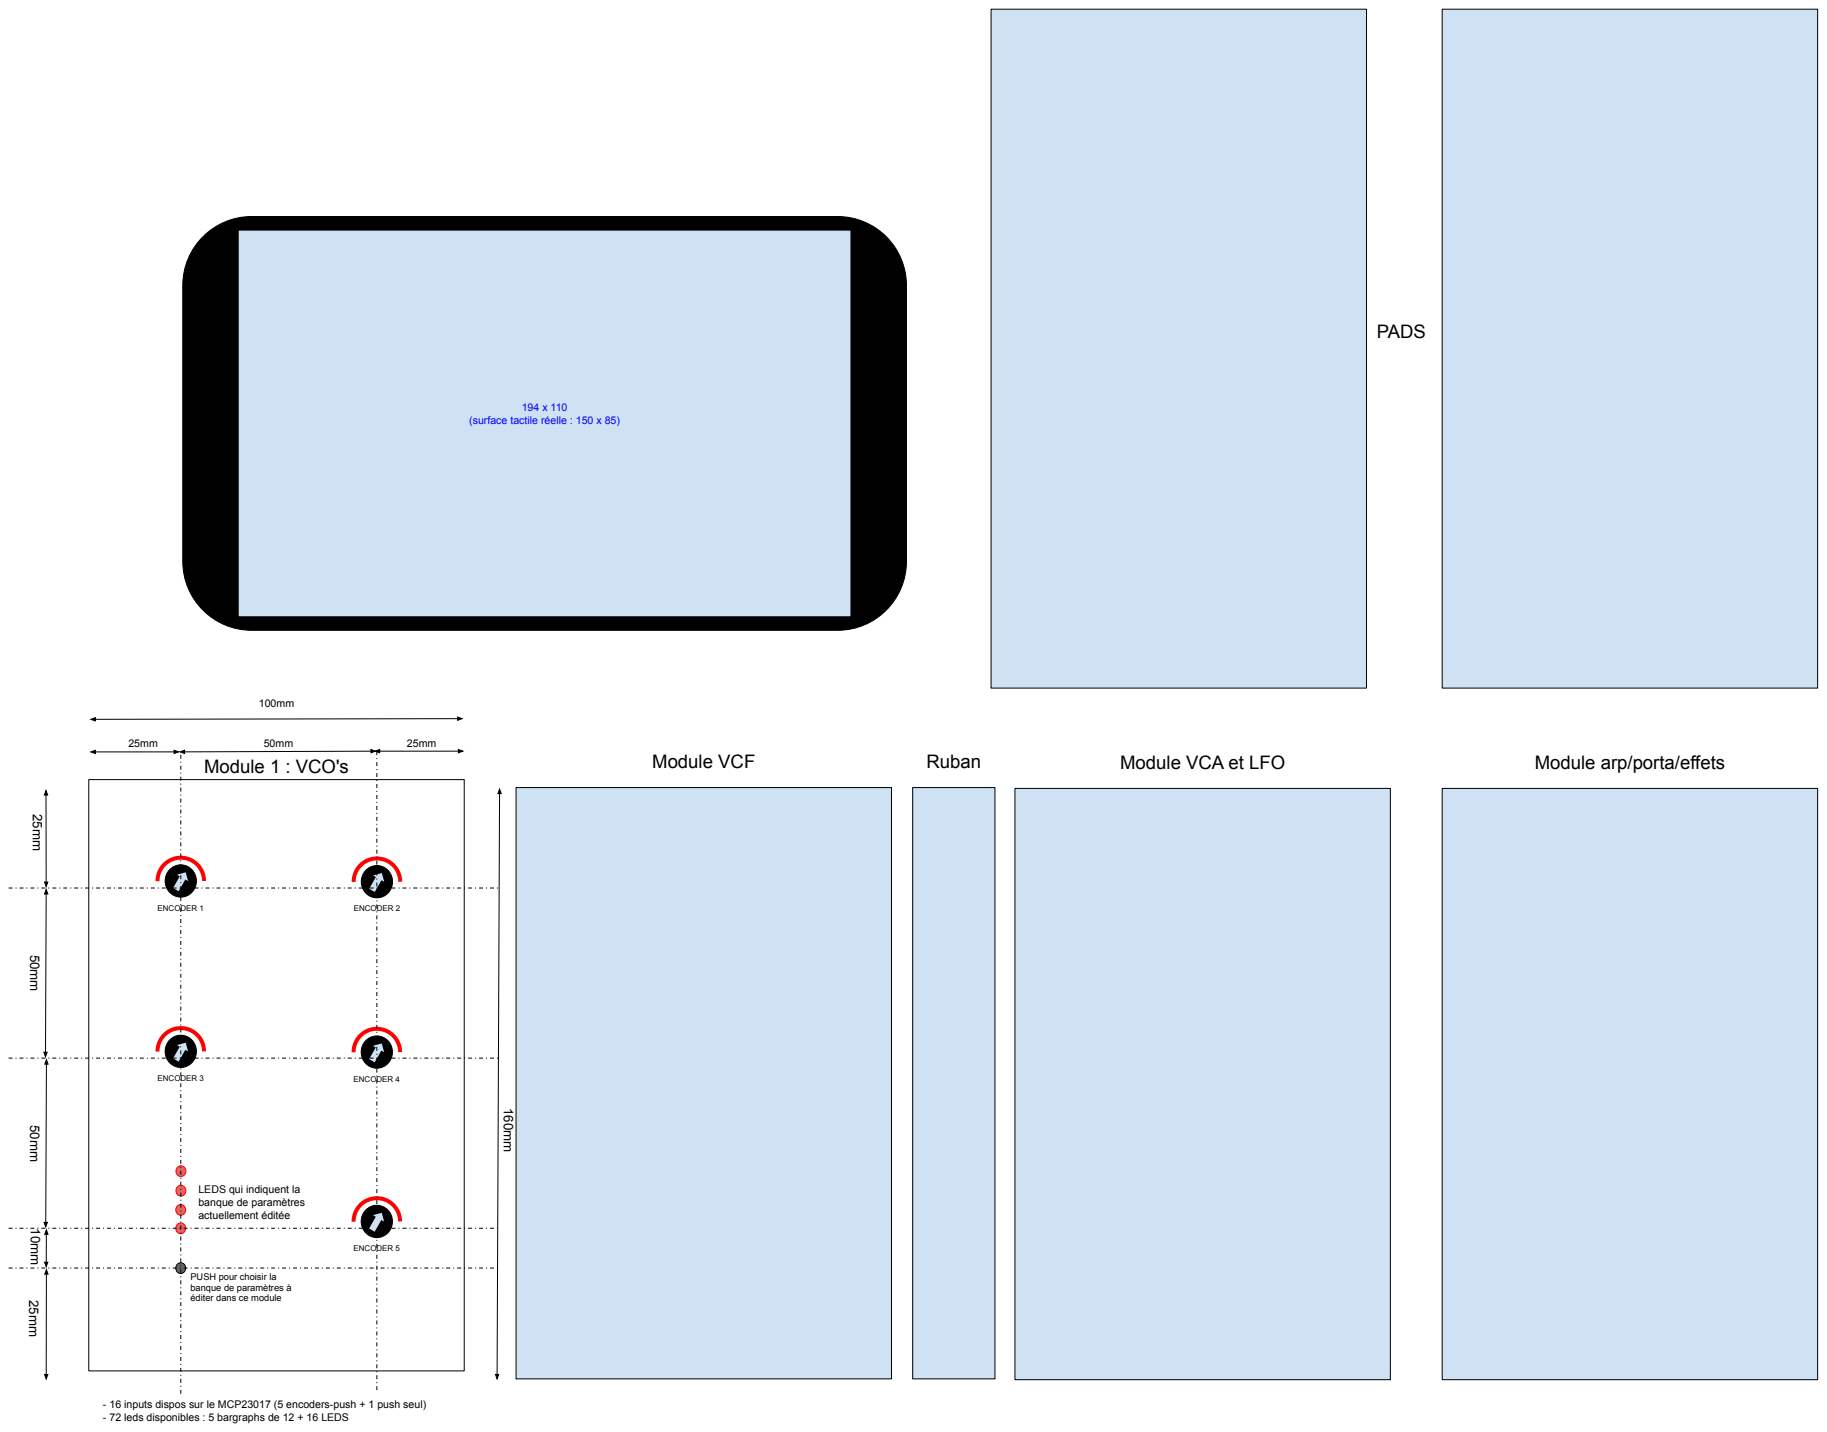
[picture p158: page 1]
Module 1 : VCO's; Module VCF; Module VCA et LFO; Module arp/porta/effets; ENCODER 1; ENCODER 2; ENCODER 3; ENCODER 4; ENCODER 5; Ruban

(surface tactile réelle : 150 x 85)

LEDS qui indiquent la
banque de paramètres
actuellement éditée

PUSH pour choisir la
banque de paramètres à
éditer dans ce module

- 16 inputs dispos sur le MCP23017 (5 encoders-push + 1 push seul)
- 72 leds disponibles : 5 bargraphs de 12 + 16 LEDS
