reynal/themis/resources/plan-front-pane.pdf

# Touchscreen

43 cm

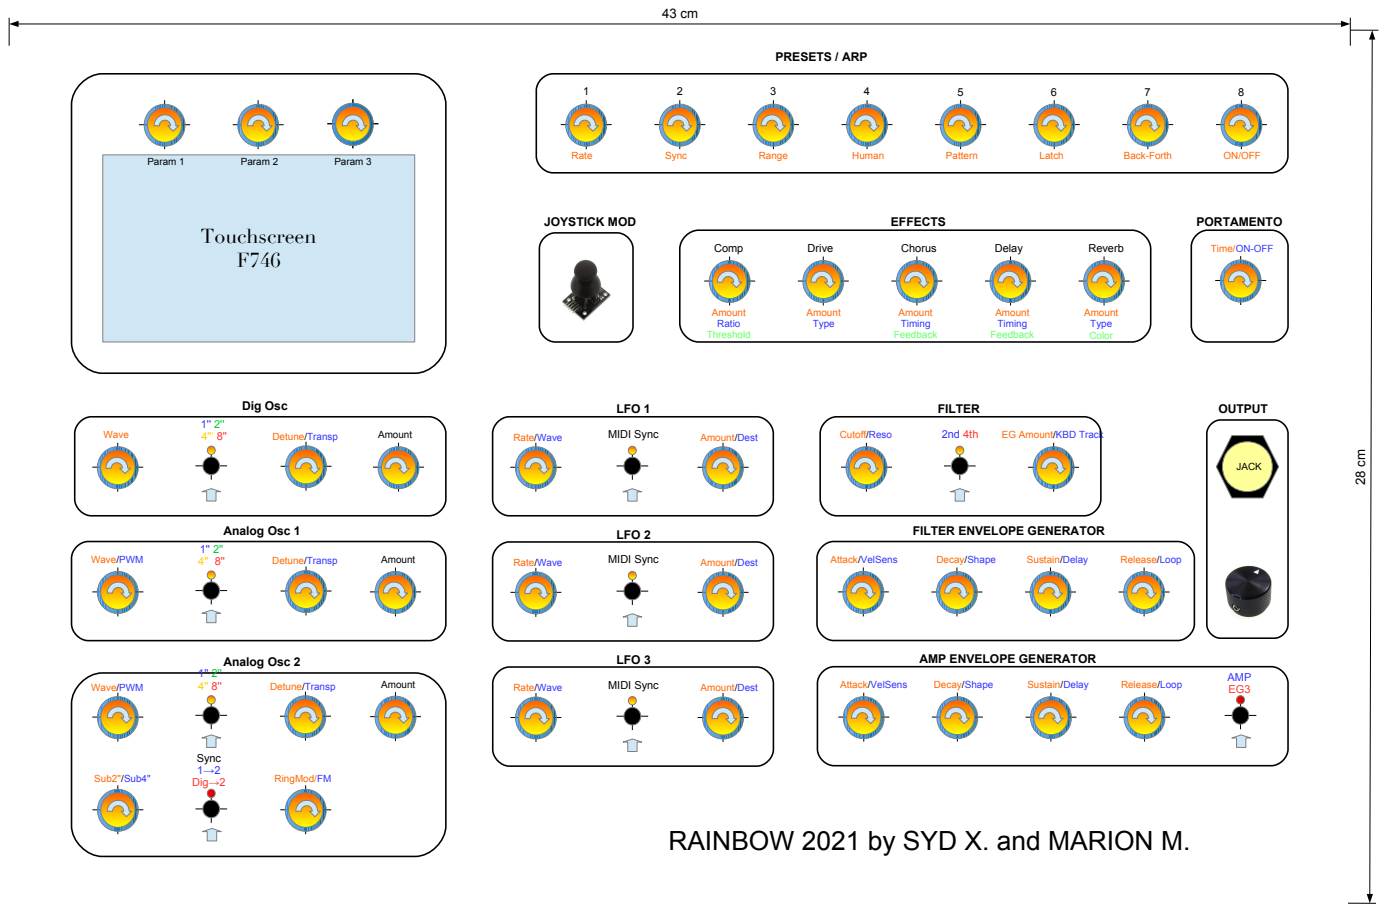
[picture p159: page 1]
Wave; Detune/Transp; Dig Osc; Wave/PWM; Analog Osc 1; Analog Osc 2; Sub2''/Sub4''; Sync 1→2; Dig→2; RingMod/FM; Amount; FILTER; Cutoff/Reso; EG Amount/KBD Track; Attack/VelSens; Decay/Shape; Sustain/Delay; Release/Loop; JACK; PRESETS / ARP; Rate; Sync; Range; Human; Pattern; Latch; PORTAMENTO; Back-Forth; Param 1; Param 2; Param 3; ON/OFF; Rate/Wave; MIDI Sync; LFO 1; AMP EG3; Amount/Dest; LFO 2; LFO 3; Comp; Drive; Chorus; Delay; Reverb; EFFECTS; Amount Ratio Threshold; Amount Type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

Time/ON-OFF

FILTER ENVELOPE GENERATOR

AMP ENVELOPE GENERATOR

RAINBOW 2021 by SYD X. and MARION M.
