reynal/themis/front-pane/eagle-schematics/v3/print.pdf

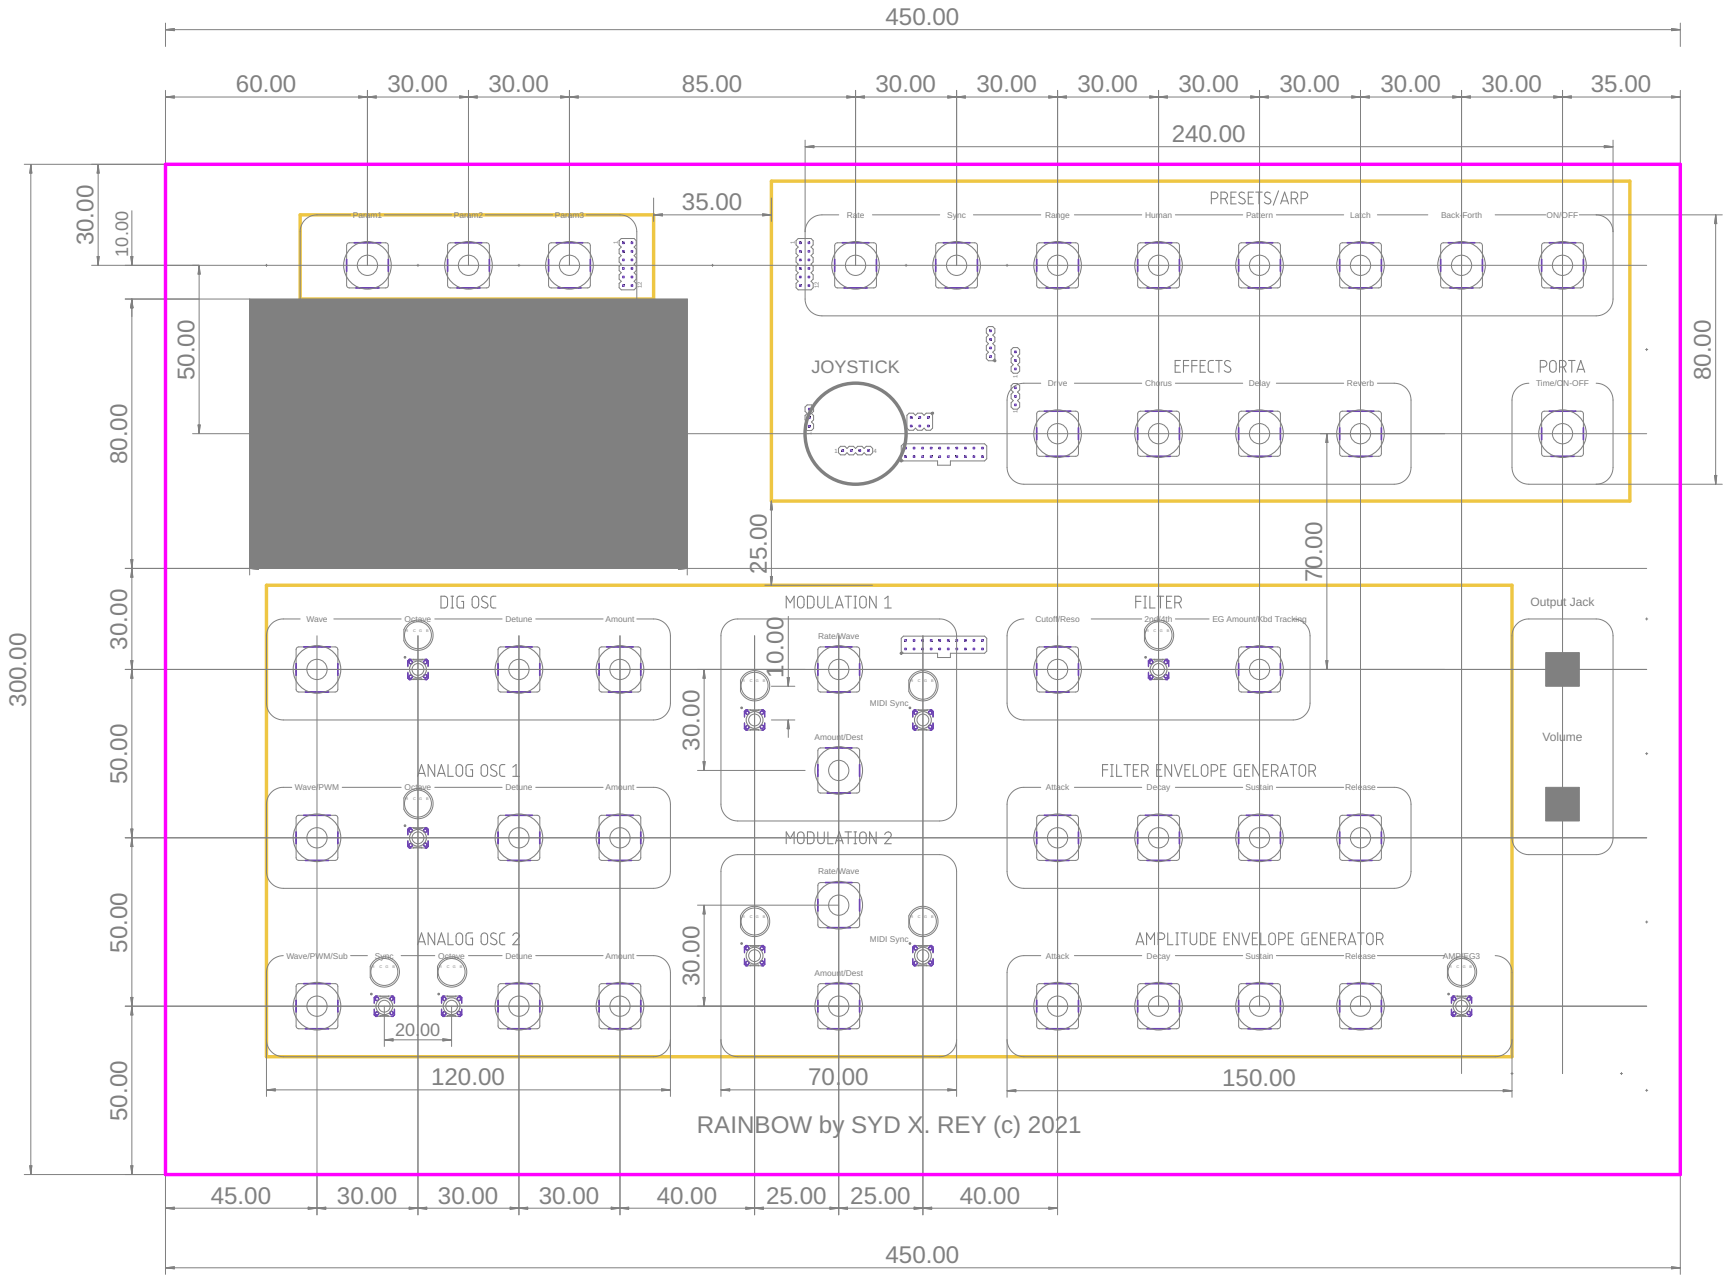
[picture p161: page 1]

RAINBOW by SYD X. REY (c) 2021
