reynal/themis/front-pane/eagle-schematics/v3/STM32F446 front pane - south - v3 - drill.pdf

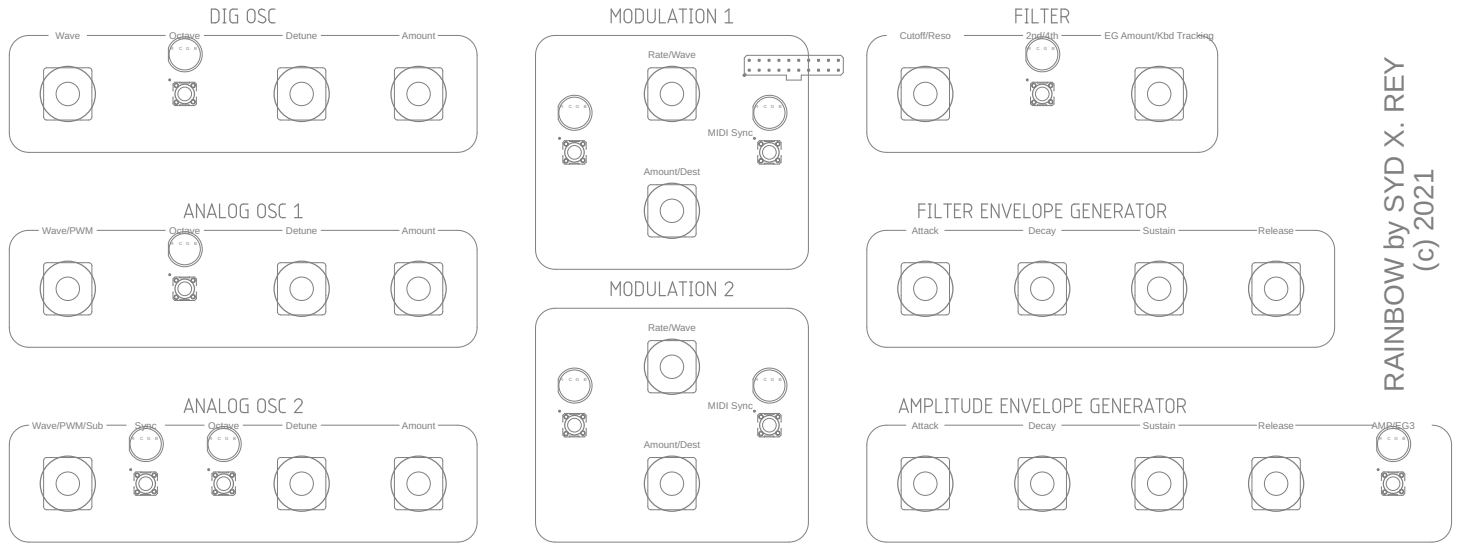
[picture p162: page 1]
