reynal/themis/analog-modules/moog-filter/eagle-schematics/MoogFilter DIL - BOTTOM.pdf

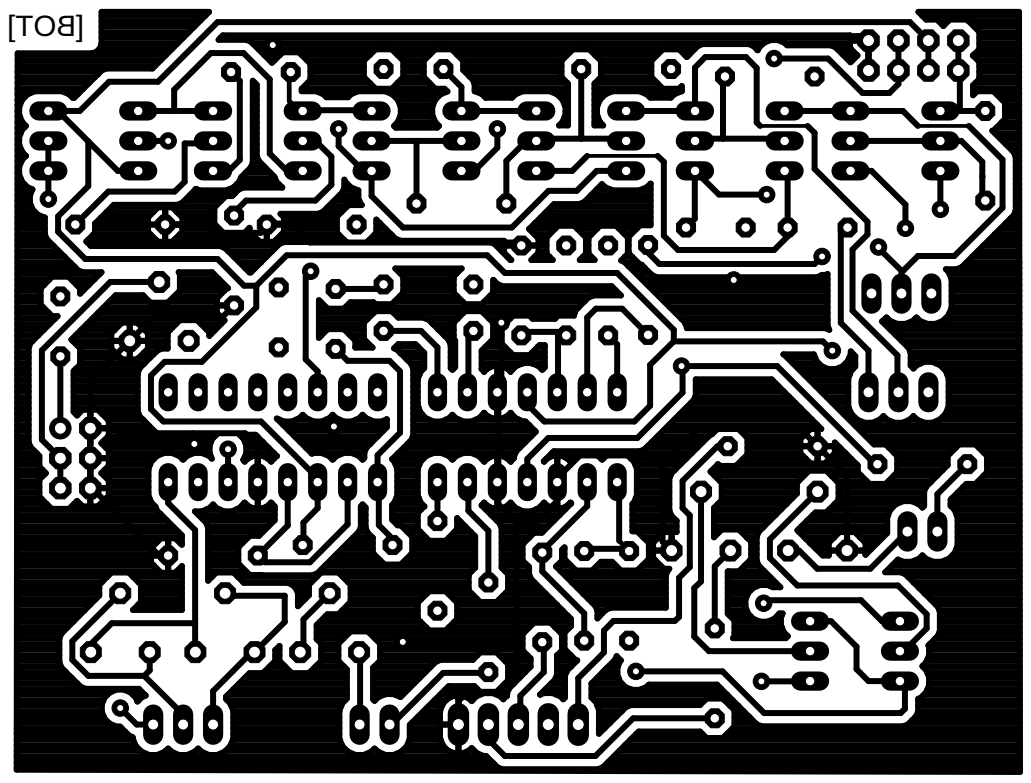
[picture p163: page 1]
