reynal/themis/analog-modules/moog-filter/eagle-schematics/MoogFilter DIL - TOP.pdf

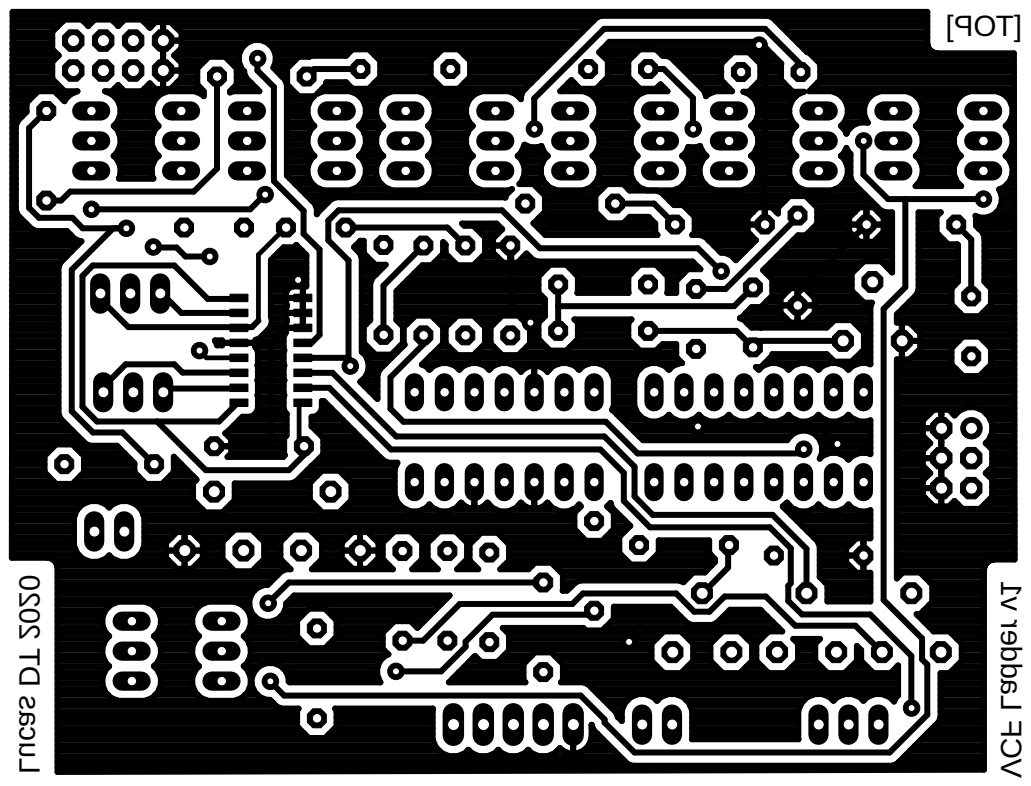
[picture p164: page 1]

Lucas DT 2020 ] POT[ VCF Ladder v1
