reynal/themis/front-pane/eagle-schematics/v3/mechanical/laser-cutting.pdf

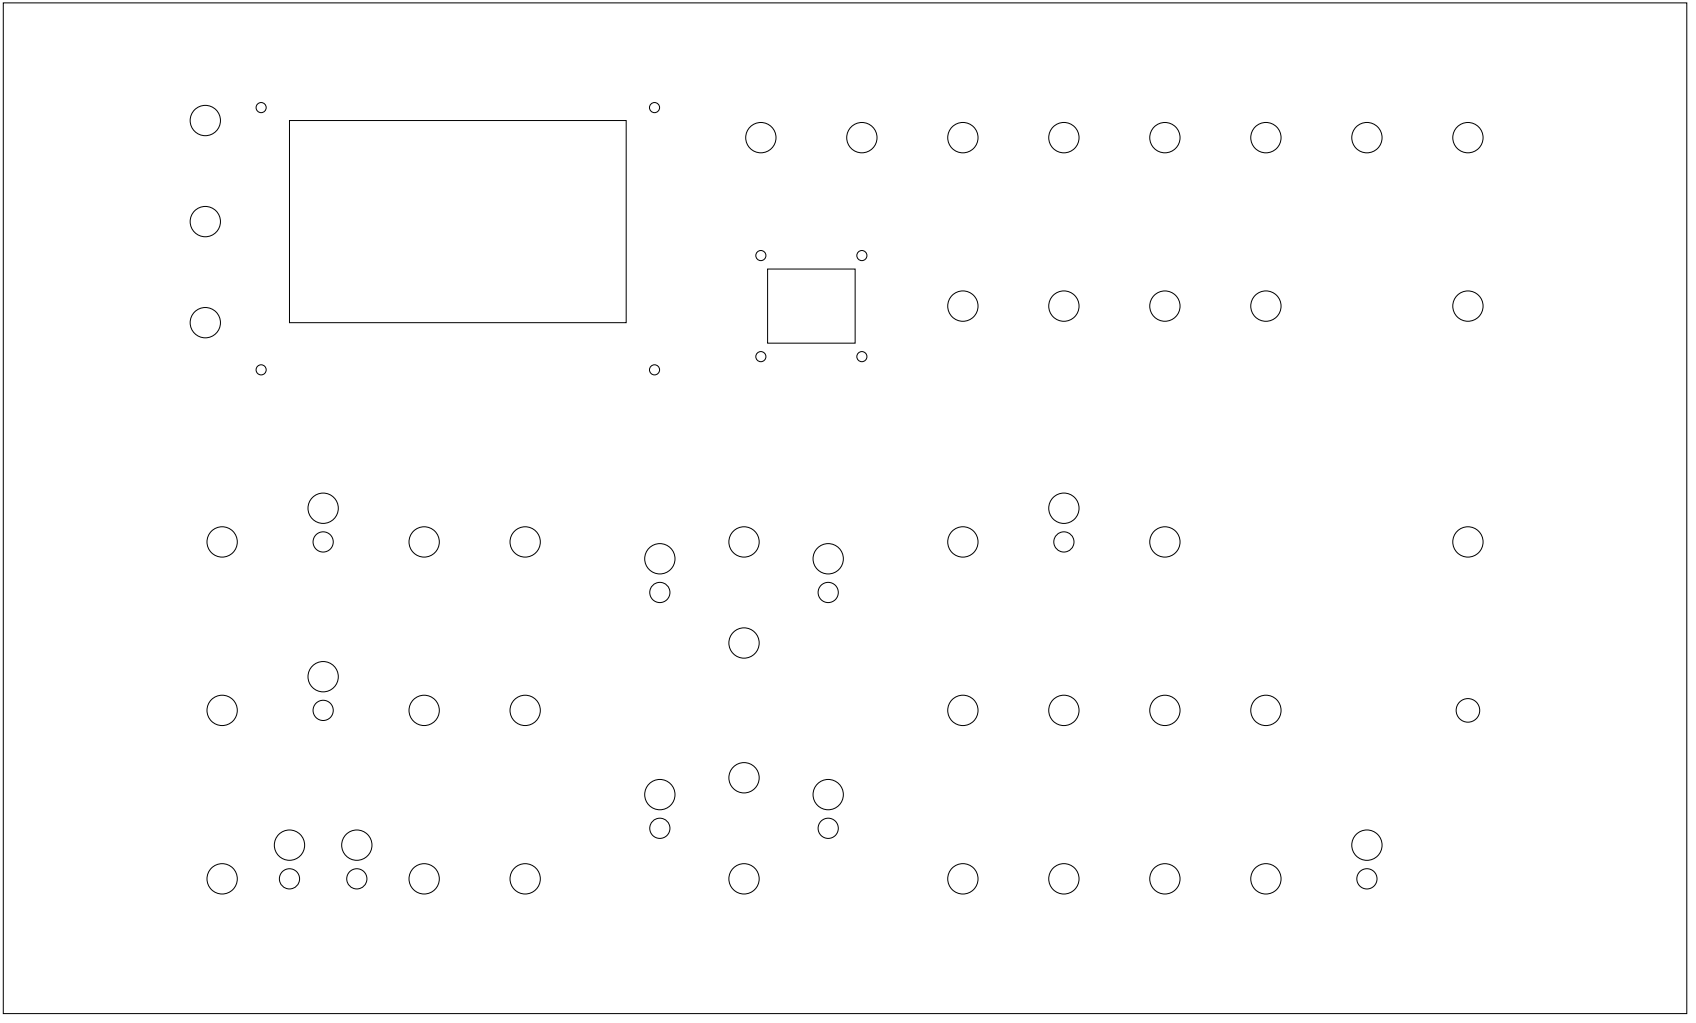
[picture p165: page 1]
