reynal/themis/analog-modules/VCF AS3320/VCF-LP-BP-HP_v4 - BOTTOM.pdf

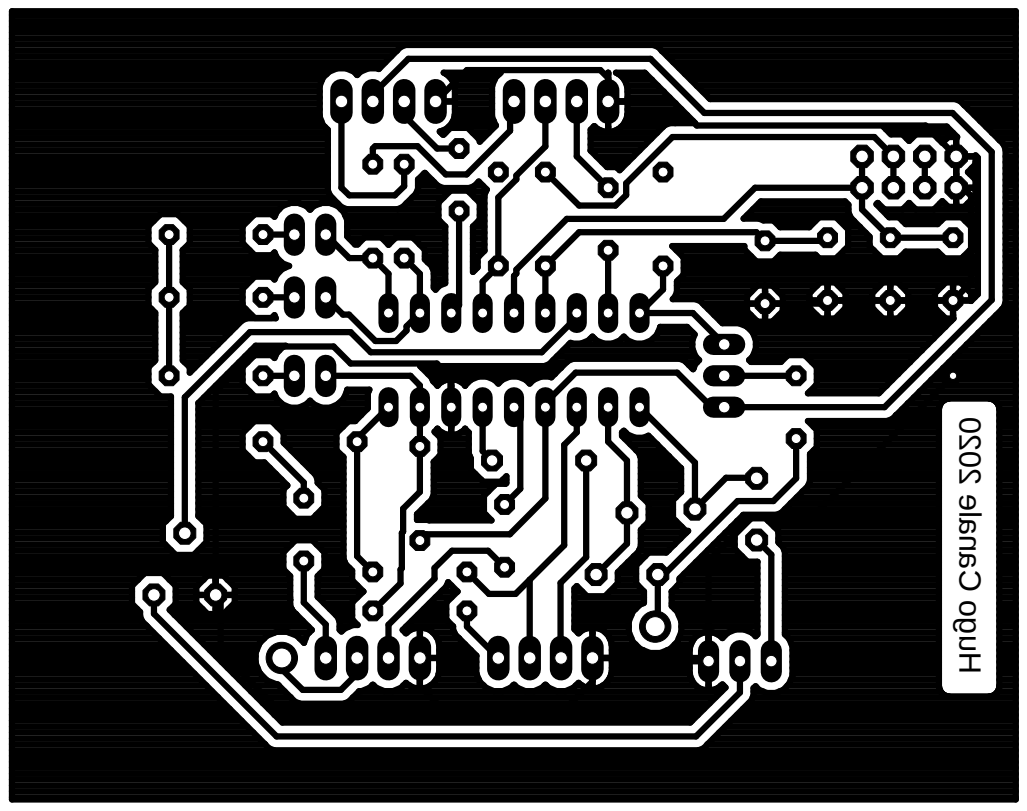
[picture p166: page 1]
