reynal/themis/main-board/v1.1/eagle-schematics/DAC STM32 Board v4 - AD5391 - BOTTOM.pdf

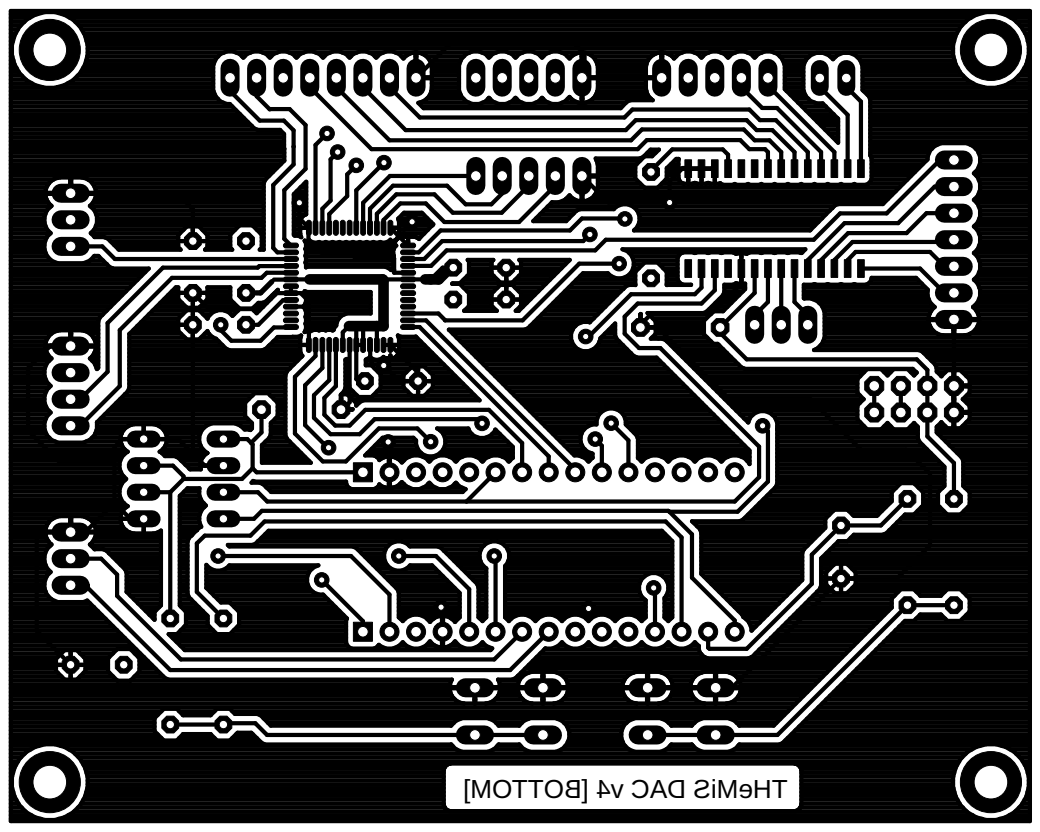
[picture p167: page 1]

] MOTT OB[ 4v CAD Si Me HT
