reynal/themis/main-board/v1.1/eagle-schematics/DAC STM32 Board v4 - AD5391 - TOP.pdf

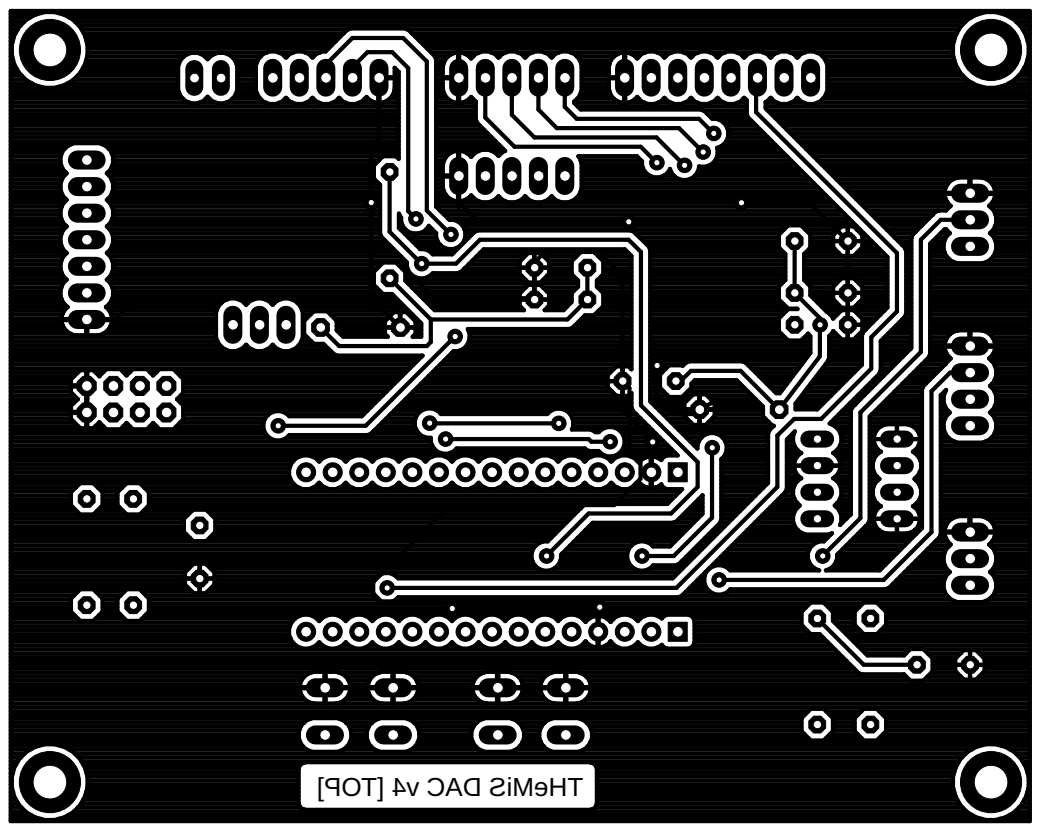
[picture p168: page 1]

] POT[ 4v CAD Si Me HT
