reynal/themis/front-pane/eagle-schematics/v2/gabarit-meca.pdf

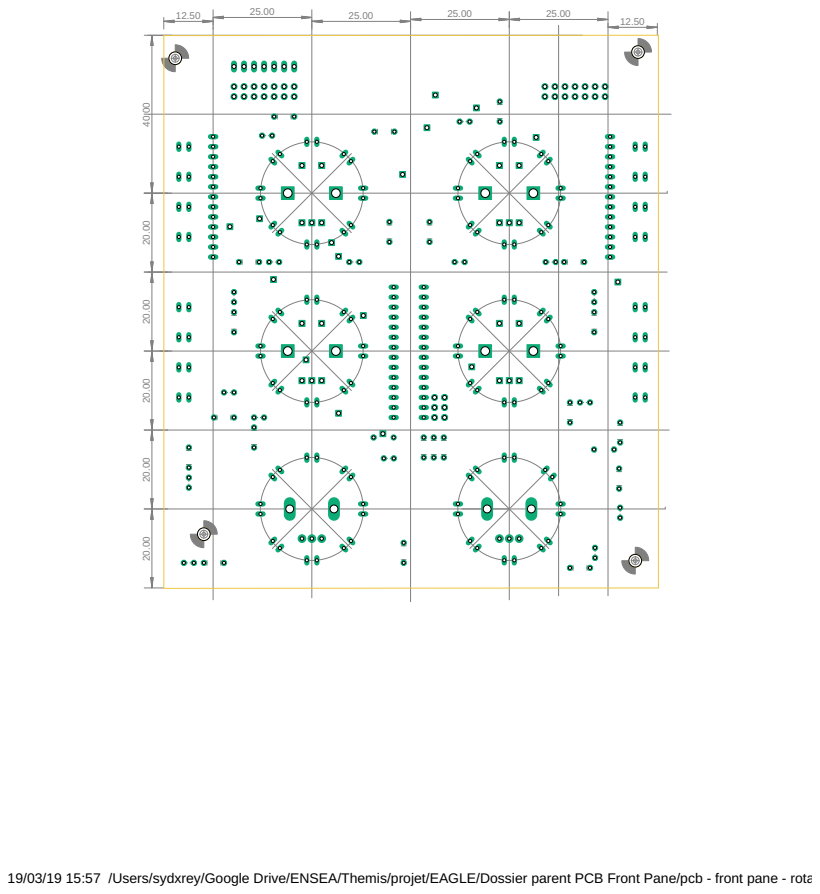
[picture p169: page 1]

19/03/19 15:57 /Users/sydxrey/Google Drive/ENSEA/Themis/projet/EAGLE/Dossier parent PCB Front Pane/pcb - front pane - rotary encoder - v2 Traversant/pcb - front pane - rotary encoder - v2 fini avec ground plane.brd
