reynal/themis/main-board/v1/eagle-schematics/DAC STM32 Board v3 BOTTOM.pdf

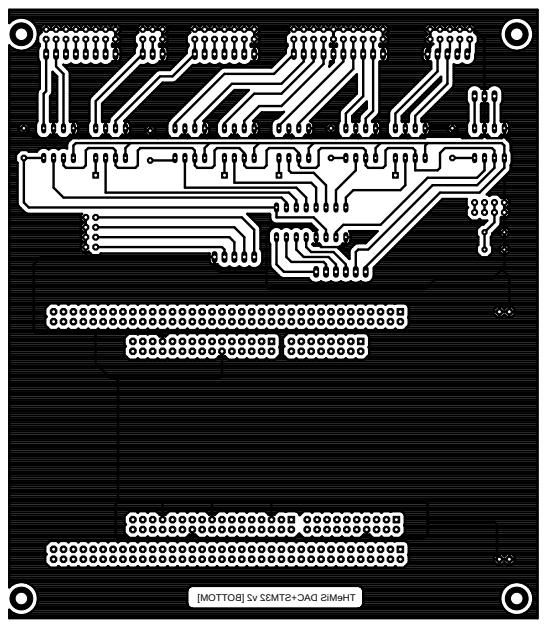
[picture p170: page 1]

] MOTT OB[ 2v 23 MTS+CAD Si Me HT
