reynal/themis/main-board/v1/eagle-schematics/DAC STM32 Board v3 TOP.pdf

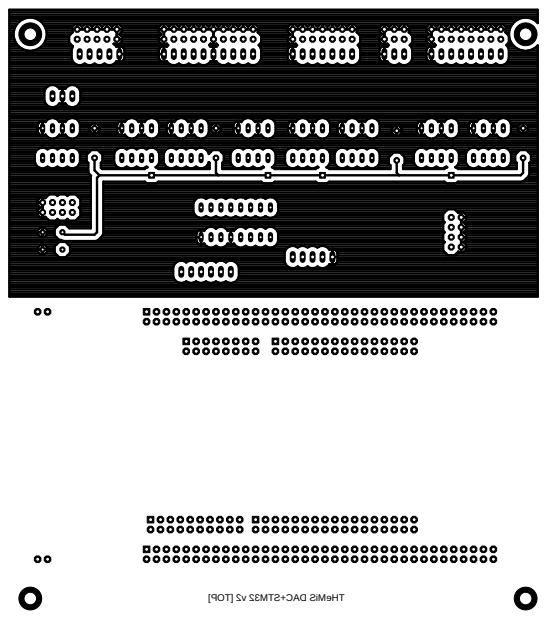
[picture p171: page 1]

] POT[ 2v 23 MTS+CAD Si Me HT
