reynal/themis/main-board/v2.0/eagle-schematics/STM32F446 Full Board SMD v7 top.pdf

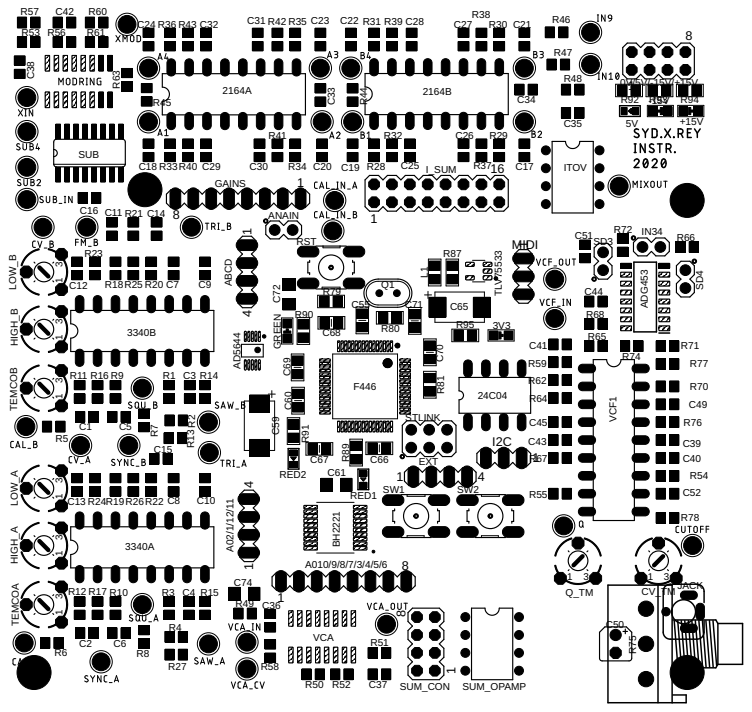
[picture p172: page 1]
