reynal/themis/main-board/v2.0/eagle-schematics/STM32F446 Full Board SMD v7 bottom.pdf

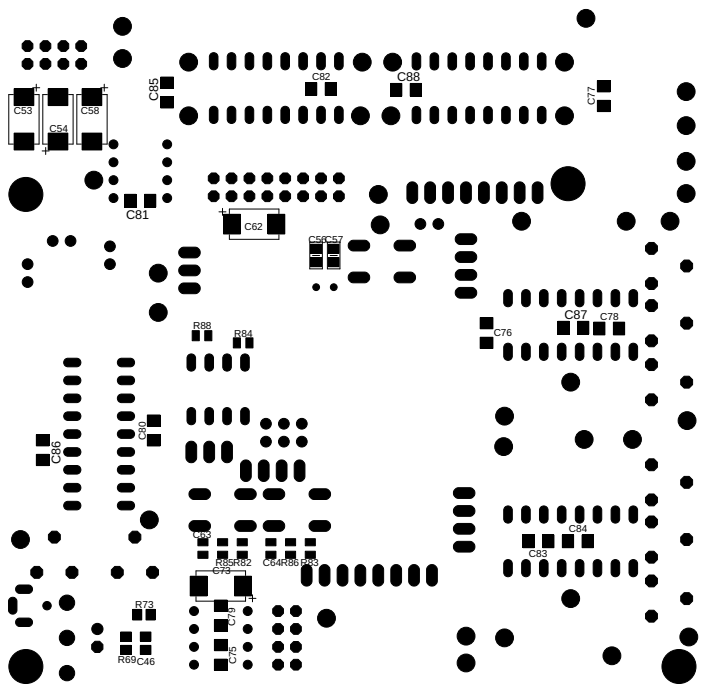
[picture p173: page 1]
