reynal/themis/analog-modules/moog-filter/ltspice-simulations/Moog-ladder-VCF-v2.asc

C_FB: cap; 10µ
CF1: cap; {CF12}
CF2: cap; {CF12}
CF3: cap; {CF34}
CF4: cap; {CF34}
CIN: cap; 10µ
Q1: npn
Q2: npn
Q3: npn
Q4: npn
Q5: npn
Q6: npn
Q7: npn
Q8: npn
Q9: npn
Q11: npn
Qexp1: pnp
Qexp2: pnp
Qmirror1: npn
Qmirror2: npn
R1LM137: res; 10k
R2LM137: res; 1k
R_CV1: res; 2.7k
R_CV2: res; 22k
R_CV3: res; 220k
R_CV4: res; 1.5k
R_CVRES1: res; 10k
R_CVRES2: res; 56k
R_DIFF1: res; 10k
R_DIFF2: res; 10k
R_DIFF3: res; 10k
R_DIFF4: res; 10k
R_IN_BIAS1: res; 1k
R_IN_BIAS2: res; 1k
R_RES: res; 4k
Rbias4: res; 150k
Rcom1: res; 220
RPOL1: res; 1k
RPOL2: res; 1k
RPOL3: res; 1k
RPOL4: res; 1k
RPOL5: res; 1k
U1: LT1358
U2: LM13700
U3: LT1358
U4: LT1358
V_cutoff_bias: voltage; 15
V_cutoff_cv: voltage; 0.8
V_res: voltage; {CV}
Vin: voltage; SINE(0 1 100); AC 1
Vvcc: voltage; 5
Vvss: voltage; -5
Named nets: 0, VCC, VSS, VPOL1, VPOL2, VPOL3, VPOL4, VFB, q1b, aopm, pairecommun, BUF, Vabc, OTA_IN, OUT_R_4, OUT_L_4, OUT_R_2, OUT_L_2
.op
.tran 20u 50m
*.AC  DEC  100 20 20k
*.IC V(OUT)=2.5

*.step temp 20 45 5
*.step param rm list 1k 10k 100k
*.step param CV -60m 60m 30m
.step param CV 0 2 0.2
*.step param CF34 list 1p 470n
*.step param RES 22k 23k 200
* step colors : GREEN BLUE RED CYAN PINK GRAY DARKGREEN DARKBLUE MAROON DARKPINK DARKRED DARKYELLOW (cycle of 12 colours)
* step param syntax : replace the numerical value by "{CV}" in the parameter of interest (e.g., V_cutoff_cv)
.param CF12=470n
.param CF34=470n
* set CF34 to 1p to simulate a 2nd order filter

.lib lm13700.sub
Variable closed loop gain amplifier
This is the exponential converter 
from CV  (aka V_cutoff_cv)
to the mirror current at Qmirror2
The point is that the cutoff 
frequency depends exponentially 
on CV as is expected in any
music instrument.
Input CV typically ranges 
from -60mV to 60mV.
Resonance Control Voltage ranges from 0 to 2V at DAC output
hence we need an OpAmp to convert to the [-11V ; 0V] range.
Maximum resonance is obtained for 2V, minimum for 0V.
Adjust R_RES for optimum max resonance.
Optimal value :
4th order : 15k
2nd order : 4k
