reynal/themis/analog-modules/moog-filter/ltspice-simulations/moog-filter-v1.asc

C1: cap; 100n
C2: cap; 100n
Ibias: current; 100µA
Q1: npn
Q2: npn
Q3: npn
Q4: npn
Q5: npn
Q6: npn
Q7: npn
Q8: npn
R1: res; 10k
R2: res; 10k
R3: res; 10k
R4: res; 10k
Valim: voltage; 15
Vin: voltage; 0; AC 1
Named nets: VCC, 0, VoutP, Voutm
.op
.ac dec 1k 10 20k
.step Ibias list 2u 4u 8u 16u 32u
