reynal/themis/resources/ltspice-simulations/SSM2164.asc

CF: cap; 100p
Cin: cap; 1µ
Cstab: cap; 680p
RF: res; 33k
Rgain: res; 33k
Rstab: res; 470
U1: LT1012
Vdd: voltage; 15
Vin: voltage; SINE(0 1 100); AC 1
Vss: voltage; 15
Named nets: 0, OUT, VDD, VSS
.op
*.tran 20u 50m
.AC  DEC  100 20 20k
*.IC V(OUT)=2.5

*.step temp 20 45 5
*.step param rm list 1k 10k 100k
*.step param CF34 list 1p 470n
* step colors : GREEN BLUE RED CYAN PINK GRAY DARKGREEN DARKBLUE MAROON DARKPINK DARKRED DARKYELLOW (cycle of 12 colours)
* step param syntax : replace the numerical value by "{CV}" in the parameter of interest (e.g., V_cutoff_cv)
*.param CF12=470n

*.lib lm13700.sub
