reynal/themis/resources/ltspice-simulations/ring-mod.asc

Cin1: cap; 5µ
Cin: cap; 5µ
Cmod: cap; 1µ
Rb1: res; 10k
Rb2: res; 10k
Rbias1: res; 22k
Rbias: res; 47k
Rbuf: res; 10k
Rdiff: res; 1k
Rin: res; 100k
Rmod: res; 5K
U1: LM13700
Vin: voltage; SINE(0 1V 500); AC 1
Vmod: voltage; SINE(0 1 80)
Vvcc: voltage; 15
Vvss: voltage; -15
Named nets: 0, VCC, VSS, IN, Vabc, BIAS, OTA, BUFOUT
.lib lm13700.sub
.tran 200u 100m
*.ac dec 1000 10 50k
