reynal/themis/resources/ltspice-simulations/vco-13700-exp-converter.asc

Cosc: cap; 150n
Cstab: cap; 1n
Q4: pnp
Q6: pnp
R1: res; 100
R2: res; 3.3k
R3: res; 8.2k
R4: res; 100
Rabc1: res; 47k
Rbias: res; 47k
Rbuf1: res; 10k
Rbuf: res; 10k
Rcom: res; 220
Rosc: res; 4.7k
U1: LM13700
U2: LM13700
U9: LT1358
Vbias: voltage; 5
Vcvfreq: voltage; PULSE(0 5 300m 1m 1m 400m 1)
Vvcc: voltage; 15
Vvss: voltage; -15
Named nets: 0, VCC, VSS, OUT, BUF, Vabc, q1b, aopm
.lib lm13700.sub
.op
.tran 200u 310m
*.AC  DEC  20 20 20k
.IC V(OUT)=2.5
*.step temp 20 25 5
VCO : fOSC = Iabc / (4 Rosc Cosc Iabc1) = Iabc * Rbias1 / (4 Rosc Cosc)  
Tosc = 4 Rosc Cosc Iabc/Iabc1
A courant égaux, Tosc = 2ms
