reynal/themis/resources/ltspice-simulations/vcf.asc

Cout: cap; 1µ
Rabc: res; 30k
Rbuf: res; 10k
U1: LM13700
Vin2: voltage; -2
Vin: voltage; SINE(0 10m 10k); AC 1
Vvcc: voltage; 6
Vvss: voltage; -6
Named nets: 0, VCC, VSS, IN, OUT, BUF, Vabc, Vcontrol
.lib lm13700.sub
*.tran 20u 200m
.AC  DEC  20 20 20k
