reynal/themis/resources/ltspice-simulations/current_mirror.asc

Q1: npn
Q2: npn
Q3: npn
R1: res; 1k
Vcc: voltage; 10
Named nets: BASE, VCC
.OP
