reynal/themis/resources/ltspice-simulations/exp-converter-vco-pnp.asc

Q1: pnp; 2N2907
Q2: pnp; 2N2907
R1: res; 6.8k
R2: res; 100
R3: res; 18k
R4: res; 100
Rcom: res; 110
Rpol: res; 47k
U1: LT1056
Vdd: voltage; 15
Ve1: voltage; 5
Ve: voltage; 0
Vss: voltage; -15
Named nets: 0, Vdd, Vss, Vm, Vs, Vcom
*.tran 20u 200m
.op
.dc Ve 0V 4V 10mV
*.step temp 20 25 5
Vers Iabc (LM13700)
