reynal/themis/resources/ltspice-simulations/flipflop.asc

C1: cap; 50n
C2: cap; 50n
C3: cap; 50n
Q1: npn; 2N2222
Q2: npn; 2N2222
Q3: npn; 2N2222
R1: res; 500
R2: res; 500
R3: res; 22k
R4: res; 22k
R5: res; 100
R6: res; 100
R7: res; 1k
V1: voltage; PULSE(0 10 1m .1m .1m 1m 2m)
Vvcc: voltage; 15
Named nets: 0, VCC, VB2, VB1, VC1, VC2, Vcom, input
.tran .1m 20m
*.AC  DEC  20 20 20k
.IC V(VB1)=0.9
*.op
.model MYSW SW(Ron=1 Roff=1Meg Vt=.5 Vh=-.4)
*.lib lm13700.sub
