reynal/themis/resources/ltspice-simulations/kick-drum.asc

C1: cap; 15n
C2: cap; 15n
R1: res; 560k
R2: res; 12k
U1: LT1056
Vdd: voltage; 15
Ve: voltage; PULSE(3 0 0 .1m .1m 500m 2 10); AC 1
Vss: voltage; -15
Named nets: 0, Vdd, Vss, Vm, Vs
.tran 100u 60m
.op
*.dc Ve -30mV 30mV 0.1mV
*.step temp 20 25 5
