reynal/themis/resources/ltspice-simulations/ring_mod.asc

C1: cap; 100n
C2: cap; 1µ
Rbuf: res; 10k
Rout1: res; 10k
Rout2: res; 2.2k
Rout3: res; 1k
Rout4: res; 100k
Rout: res; 1k
U1: LM13700
Vin2: voltage; SINE(0 3 56); AC 1
Vin: voltage; SINE(0 3 100); AC 1
Vvcc: voltage; 15
Vvss: voltage; -15
Named nets: 0, VCC, VSS, OUT, BUF, Vabc
.lib lm13700.sub
.tran 20u 200m
