reynal/themis/resources/ltspice-simulations/vca.asc

Rbuf: res; 200k
Rout1: res; 30k
Rout2: res; 1k
Rout: res; 1k
U1: LM13700
Vin2: voltage; SINE(0 8 20); AC 1
Vin: voltage; SINE(0 100m 500); AC 1
Vvcc: voltage; 10
Vvss: voltage; -10
Named nets: 0, VCC, VSS, IN, OUT, BUF, Vabc
.lib lm13700.sub
.tran 20u 200m
