reynal/themis/resources/ltspice-simulations/vco.asc

Cout: cap; 100n
RA: res; 5.1k
Rabc1: res; 51k
Rabc: res; 24k
Rbuf1: res; 10k
Rbuf: res; 10k
U1: LM13700
U2: LM13700
Vbias: voltage; -5
Vvcc: voltage; 15
Vvss: voltage; -15
Named nets: 0, VCC, VSS, OUT, BUF, Vabc, Vcontrol
.lib lm13700.sub
.tran 20u 20m
*.AC  DEC  20 20 20k
.IC V(OUT)=2.5
VCO : fOSC = Iabc1 / (4 R C Iabc)
Tosc = 4 R C Iabc/Iabc1
A courant égaux, Tosc = 2ms
