reynal/themis/main-board/v3.0/eagle-schematics/STM32_DAC.brd

## EAGLE design main-board/v3.0/eagle-schematics/STM32_DAC.brd (2022-09-02)

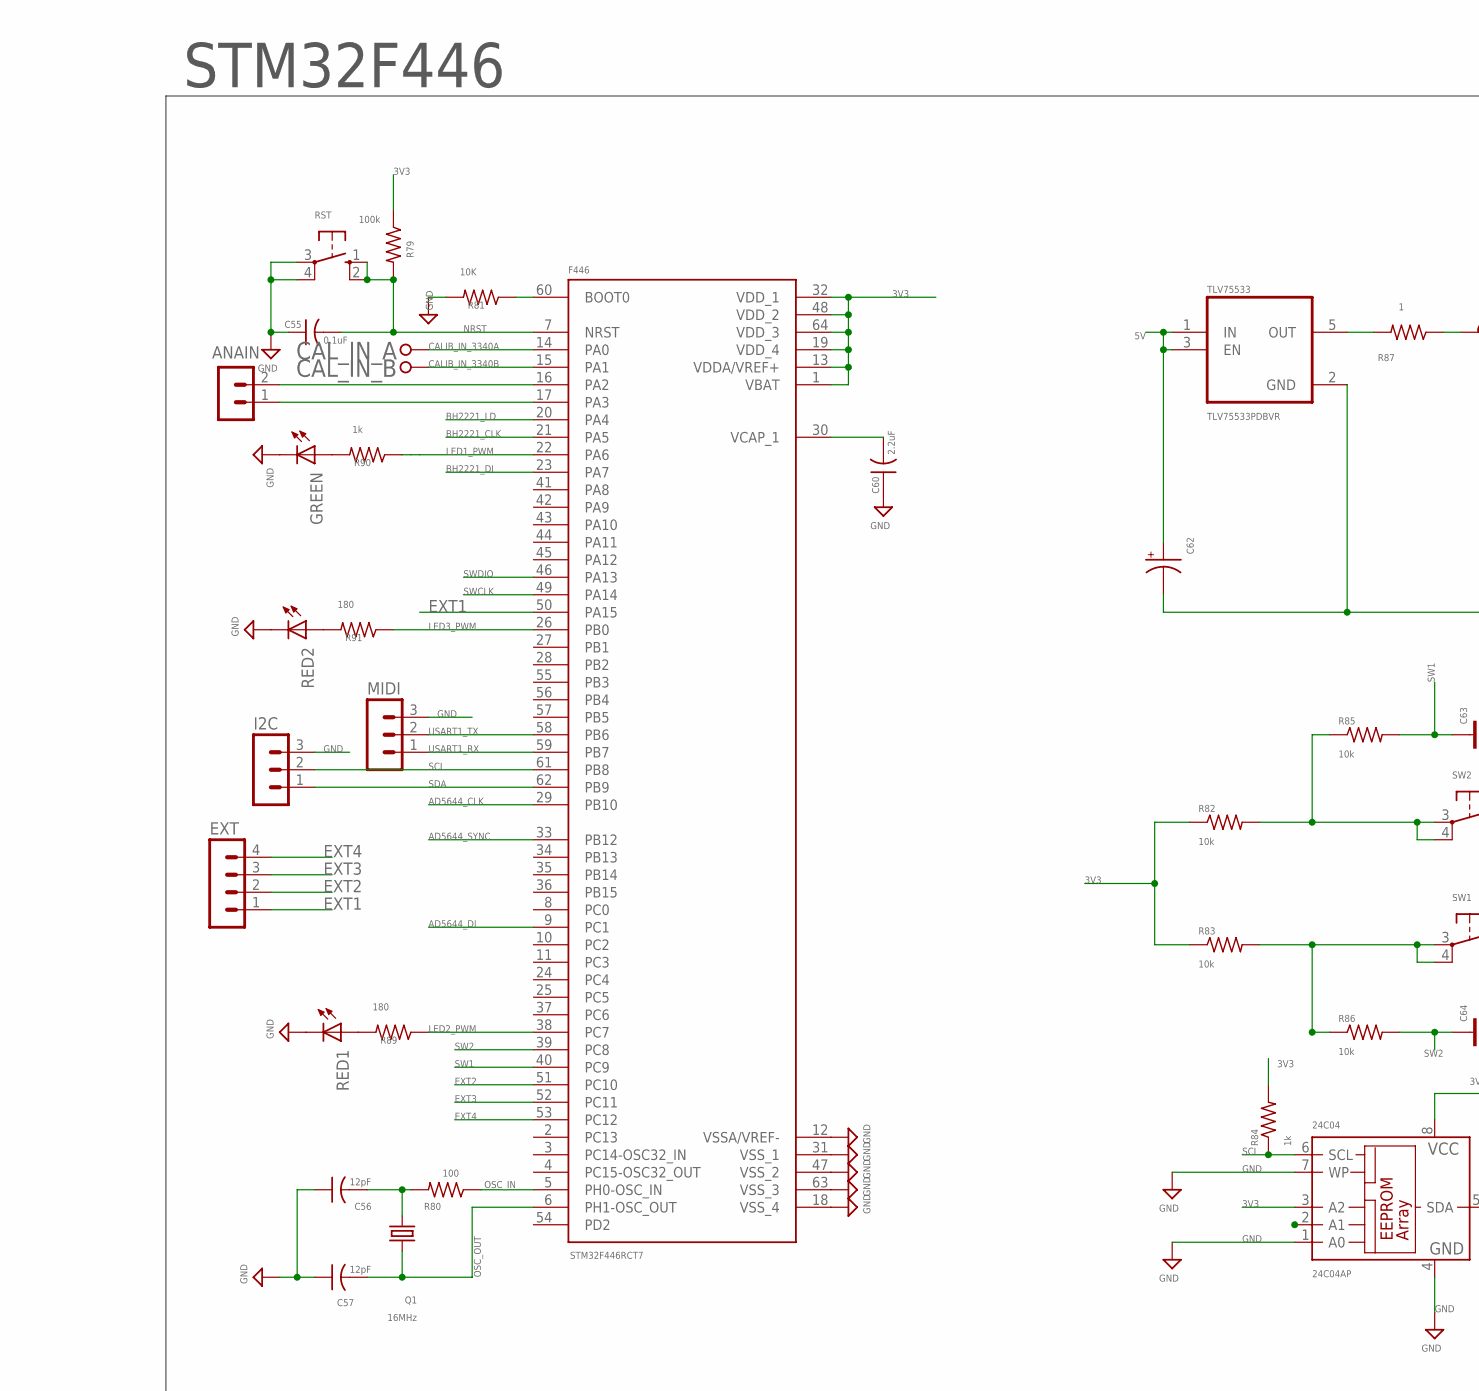
[picture p174: schematic STM32_DAC.sch, sheet 1, part in row 1, column 1]

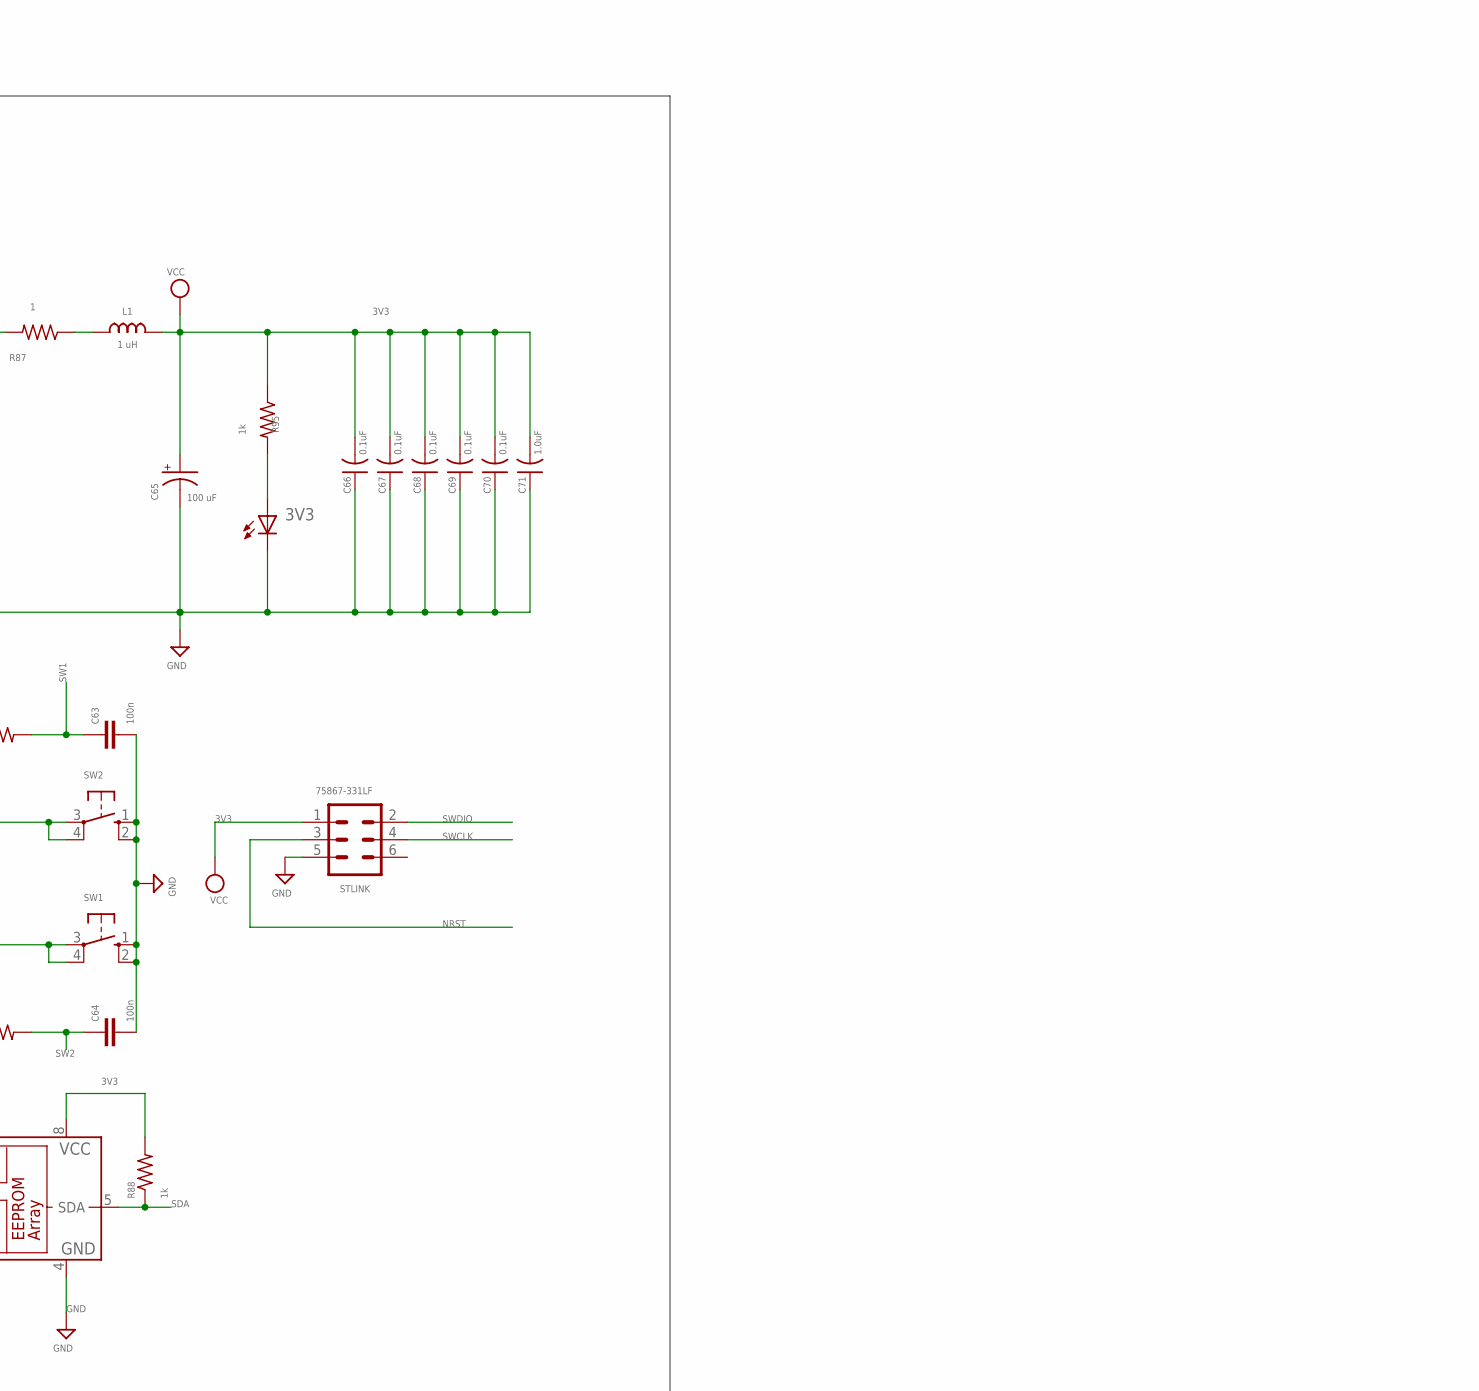
[picture p175: schematic STM32_DAC.sch, sheet 1, part in row 1, column 2]

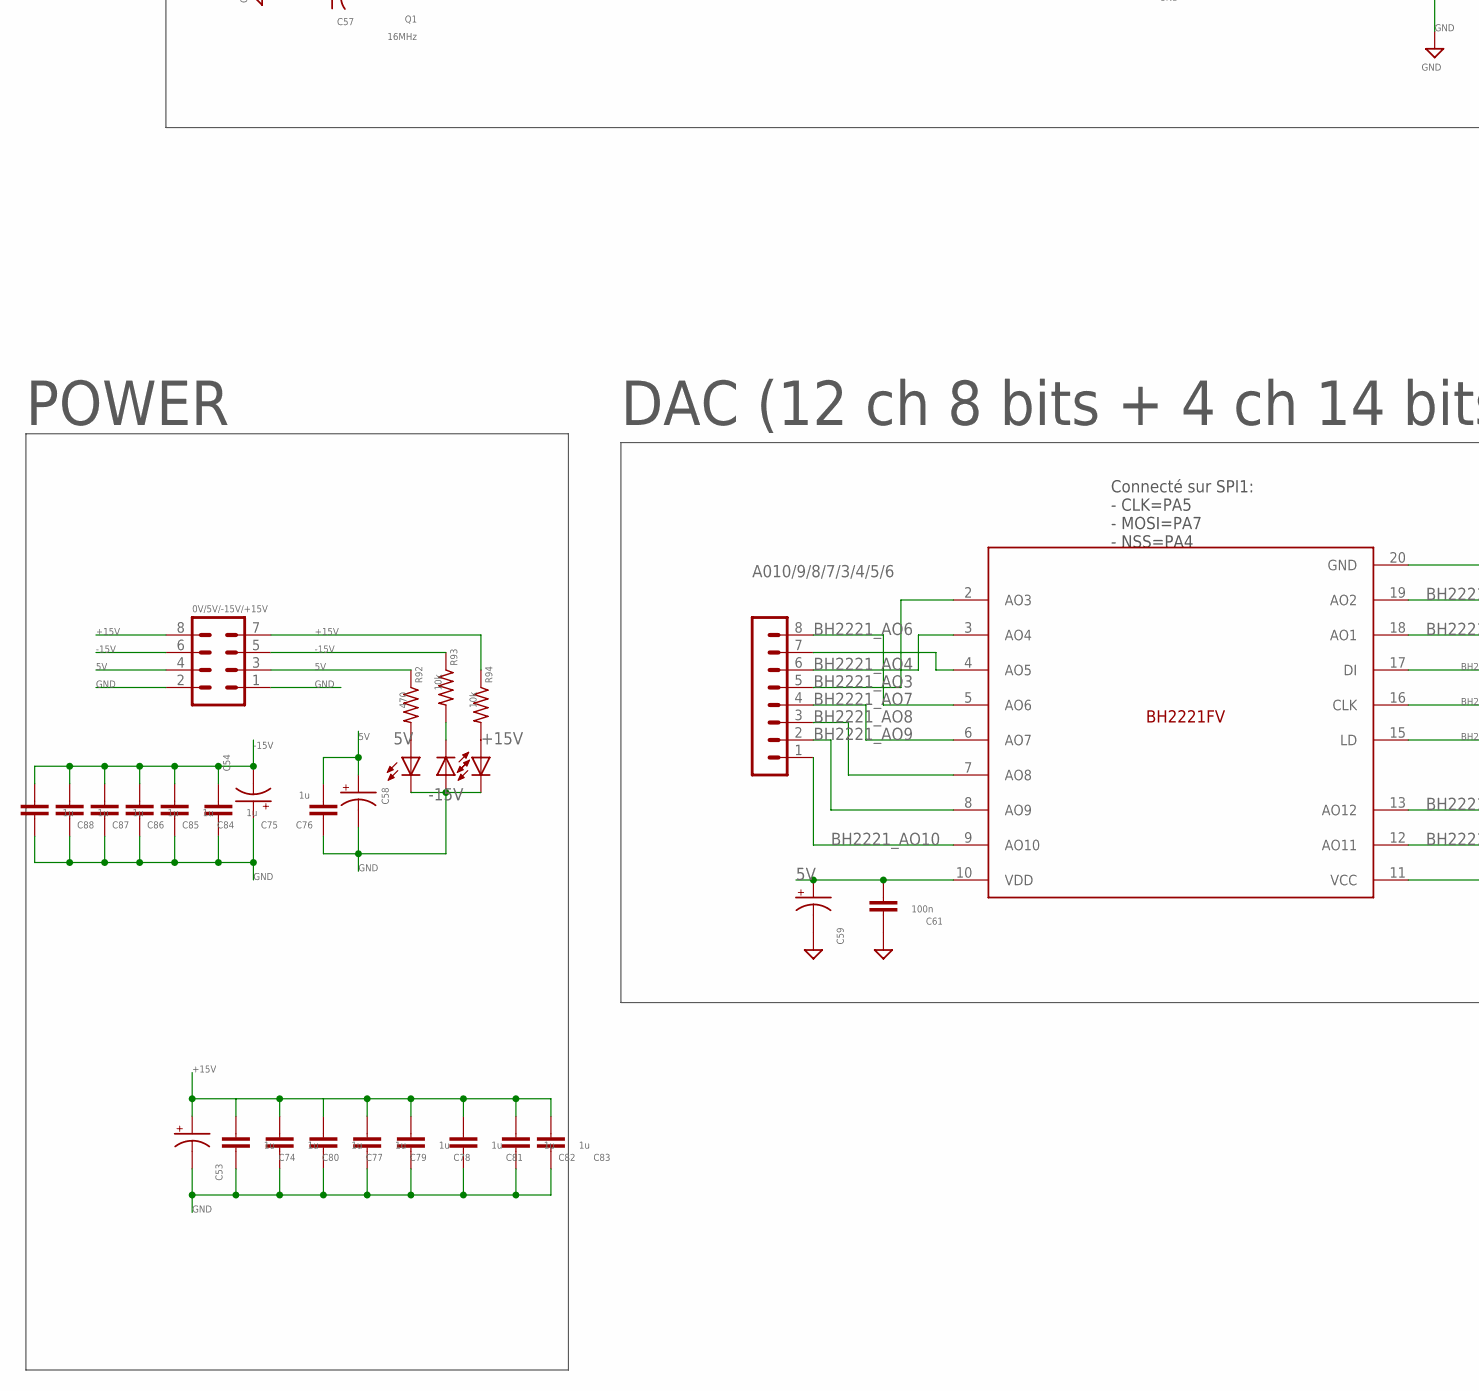
[picture p176: schematic STM32_DAC.sch, sheet 1, part in row 2, column 1]

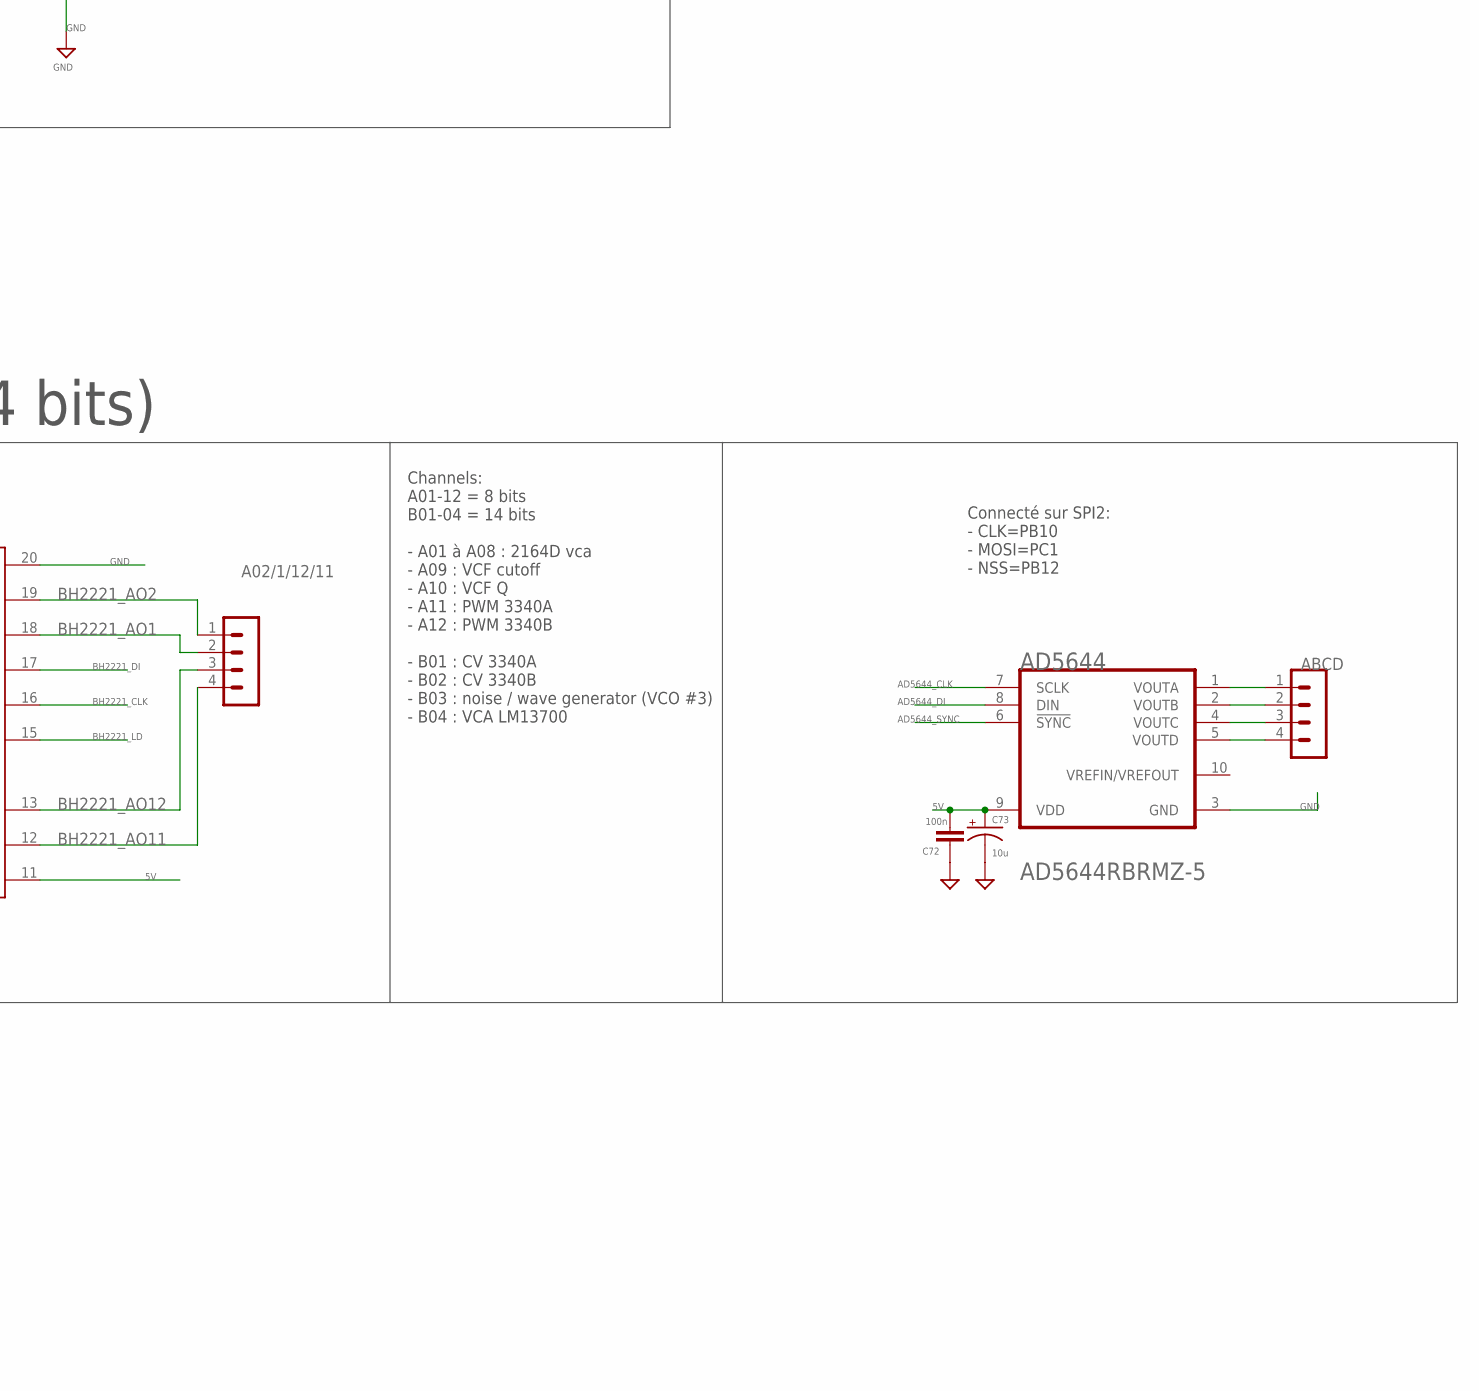
[picture p177: schematic STM32_DAC.sch, sheet 1, part in row 2, column 2]

Parts:
0V/5V/-15V/+15V: MA04-2
3V3: LED-0805; 0805-LED
5V: LED-0603; 0603-LED
24C04: 24C04AP; DIL8
+15V: LED-0805; 0805-LED
-15V: LED-0805; 0805-LED
A02/1/12/11: MA04-1
A010/9/8/7/3/4/5/6: MA08-1
ABCD: MA04-1
AD5644: ANALOG_DEVICES_AD5644RBRMZ-5ANALOG_DEVICES_AD5644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; ANALOG_DEVICES_AD5644RBRMZ-5_0
ANAIN: MA02-1
BH2221: BH2221FV; SOP65P780X200-20N
C53, C54, C58, C59, C62, C73: 10u; CPOL2917
C55, C66, C67, C68, C69, C70: 0.1uF; C0805
C56, C57: 12pF; C0805
C60: 2.2uF; C0805
C61, C72: 100n; C1206
C63, C64: 100n; C0805
C65: 100 uF; CPOL2917
C71: 1.0uF; C0805
C74, C75, C76, C77, C78, C79, C80, C81, C82, C83, C84, C85, C86, C87, C88: 1u; C1206
CAL_IN_A: TESTPOINT; TESTPOINT_63
CAL_IN_B: TESTPOINT; TESTPOINT_63
EXT: MA04-1
F446: STM32F446RCT7; QFP50P1200X1200X160-64N
GREEN: LED-0805; 0805-LED
I2C: MA03-1
L1: 1 uH; L0805
MIDI: MA03-1
Q1: 16MHz; Q-HC-46X
R79: 100k; R0805
R80: 100; R0805
R81: 10K; R0805
R82, R83, R85, R86, R93, R94: 10k; R0805
R84, R88, R90, R95: 1k; R0805
R87: 1; R0805
R89, R91: 180; R0805
R92: 470; R0805
RED1, RED2: LED-0603; 0603-LED
RST: 10-XX; B3F-10XX
STLINK: 75867-331LF; MA03-2
SW1, SW2: 10-XX; B3F-10XX
TLV75533: TLV75533PDBVR; SOT95P280X145-5N

Connections:
3V3: 24C04.2 (A1), 24C04.3 (A2), 24C04.8 (VCC), C65.+, C66.2, C67.2, C68.2, C69.2, C70.2, C71.2, F446.1 (VBAT), F446.13 (VDDA/VREF+), F446.19 (VDD_4), F446.32 (VDD_1), F446.48 (VDD_2), F446.64 (VDD_3), L1.2, R79.1, R82.1, R83.1, R84.2, R88.2, R95.1, STLINK.1
5V: 0V/5V/-15V/+15V.3, 0V/5V/-15V/+15V.4, AD5644.9 (VDD), BH2221.10 (VDD), BH2221.11 (VCC), C58.+, C59.+, C61.2, C62.+, C72.2, C73.+, C76.2, R92.1, TLV75533.1 (IN), TLV75533.3 (EN)
+15V: 0V/5V/-15V/+15V.7, 0V/5V/-15V/+15V.8, C53.+, C74.2, C77.2, C78.2, C79.2, C80.2, C81.2, C82.2, C83.2, R94.1
-15V: 0V/5V/-15V/+15V.5, 0V/5V/-15V/+15V.6, C54.-, C75.2, C84.2, C85.2, C86.2, C87.2, C88.2, R93.1
AD5644_CLK: AD5644.7 (SCLK), F446.29 (PB10)
AD5644_DI: AD5644.8 (DIN), F446.9 (PC1)
AD5644_SYNC: AD5644.6 (!SYNC!), F446.33 (PB12)
BH2221_AO1: A02/1/12/11.2, BH2221.18 (AO1)
BH2221_AO2: A02/1/12/11.1, BH2221.19 (AO2)
BH2221_AO3: A010/9/8/7/3/4/5/6.5, BH2221.2 (AO3)
BH2221_AO4: A010/9/8/7/3/4/5/6.6, BH2221.3 (AO4)
BH2221_AO6: A010/9/8/7/3/4/5/6.8, BH2221.5 (AO6)
BH2221_AO7: A010/9/8/7/3/4/5/6.4, BH2221.6 (AO7)
BH2221_AO8: A010/9/8/7/3/4/5/6.3, BH2221.7 (AO8)
BH2221_AO9: A010/9/8/7/3/4/5/6.2, BH2221.8 (AO9)
BH2221_AO10: A010/9/8/7/3/4/5/6.1, BH2221.9 (AO10)
BH2221_AO11: A02/1/12/11.4, BH2221.12 (AO11)
BH2221_AO12: A02/1/12/11.3, BH2221.13 (AO12)
BH2221_CLK: BH2221.16 (CLK), F446.21 (PA5)
BH2221_DI: BH2221.17 (DI), F446.23 (PA7)
BH2221_LD: BH2221.15 (LD), F446.20 (PA4)
BOOT1: F446.60 (BOOT0), R81.1
CALIB_IN_3340A: CAL_IN_A.P$1, F446.14 (PA0)
CALIB_IN_3340B: CAL_IN_B.P$1, F446.15 (PA1)
EXT1: EXT.1, F446.50 (PA15)
EXT2: EXT.2, F446.51 (PC10)
EXT3: EXT.3, F446.52 (PC11)
EXT4: EXT.4, F446.53 (PC12)
GND: 0V/5V/-15V/+15V.1, 0V/5V/-15V/+15V.2, 3V3.C, 5V.C, 24C04.1 (A0), 24C04.4 (GND), 24C04.7 (WP), +15V.C, -15V.A, AD5644.3 (GND), BH2221.20 (GND), C53.-, C54.+, C55.1, C56.1, C57.1, C58.-, C59.-, C60.1, C61.1, C62.-, C63.2, C64.2, C65.-, C66.1, C67.1, C68.1, C69.1, C70.1, C71.1, C72.1, C73.-, C74.1, C75.1, C76.1, C77.1, C78.1, C79.1, C80.1, C81.1, C82.1, C83.1, C84.1, C85.1, C86.1, C87.1, C88.1, F446.12 (VSSA/VREF-), F446.18 (VSS_4), F446.31 (VSS_1), F446.47 (VSS_2), F446.63 (VSS_3), GREEN.C, I2C.3, MIDI.3, R81.2, RED1.C, RED2.C, RST.3, RST.4 (P1), STLINK.5, SW1.1 (S), SW1.2 (S1), SW2.1 (S), SW2.2 (S1), TLV75533.2 (GND)
LED1_PWM: F446.22 (PA6), R90.1
LED2_PWM: F446.38 (PC7), R89.1
LED3_PWM: F446.26 (PB0), R91.1
unnamed: R82.2, R85.1, SW2.3, SW2.4 (P1)
unnamed: R83.2, R86.1, SW1.3, SW1.4 (P1)
unnamed: A010/9/8/7/3/4/5/6.7, BH2221.4 (AO5)
unnamed: ABCD.1, AD5644.1 (VOUTA)
unnamed: ABCD.2, AD5644.2 (VOUTB)
unnamed: ABCD.3, AD5644.4 (VOUTC)
unnamed: ABCD.4, AD5644.5 (VOUTD)
unnamed: R89.2, RED1.A
unnamed: R91.2, RED2.A
unnamed: 5V.A, R92.2
unnamed: -15V.C, R93.2
unnamed: +15V.A, R94.2
unnamed: GREEN.A, R90.2
unnamed: 3V3.A, R95.2
unnamed: ANAIN.2, F446.16 (PA2)
unnamed: ANAIN.1, F446.17 (PA3)
unnamed: C56.2, Q1.1, R80.2
unnamed: R87.2, TLV75533.5 (OUT)
unnamed: L1.1, R87.1
NRST: C55.2, F446.7 (NRST), R79.2, RST.1 (S), RST.2 (S1), STLINK.3
OSC_IN: F446.5 (PH0-OSC_IN), R80.1
OSC_OUT: C57.2, F446.6 (PH1-OSC_OUT), Q1.2
SCL: 24C04.6 (SCL), F446.61 (PB8), I2C.2, R84.1
SDA: 24C04.5 (SDA), F446.62 (PB9), I2C.1, R88.1
SW1: C63.1, F446.40 (PC9), R85.2
SW2: C64.1, F446.39 (PC8), R86.2
SWCLK: F446.49 (PA14), STLINK.4
SWDIO: F446.46 (PA13), STLINK.2
USART1_RX: F446.59 (PB7), MIDI.1
USART1_TX: F446.58 (PB6), MIDI.2
VCAP1: C60.2, F446.30 (VCAP_1)

Notes on the sheet:
STM32F446
POWER
DAC (12 ch 8 bits + 4 ch 14 bits)
Connecté sur SPI1: - CLK=PA5 - MOSI=PA7 - NSS=PA4
Connecté sur SPI2: - CLK=PB10 - MOSI=PC1 - NSS=PB12
Channels: A01-12 = 8 bits B01-04 = 14 bits - A01 à A08 : 2164D vca - A09 : VCF cutoff - A10 : VCF Q - A11 : PWM 3340A - A12 : PWM 3340B - B01 : CV 3340A - B02 : CV 3340B - B03 : noise / wave generator (VCO #3) - B04 : VCA LM13700

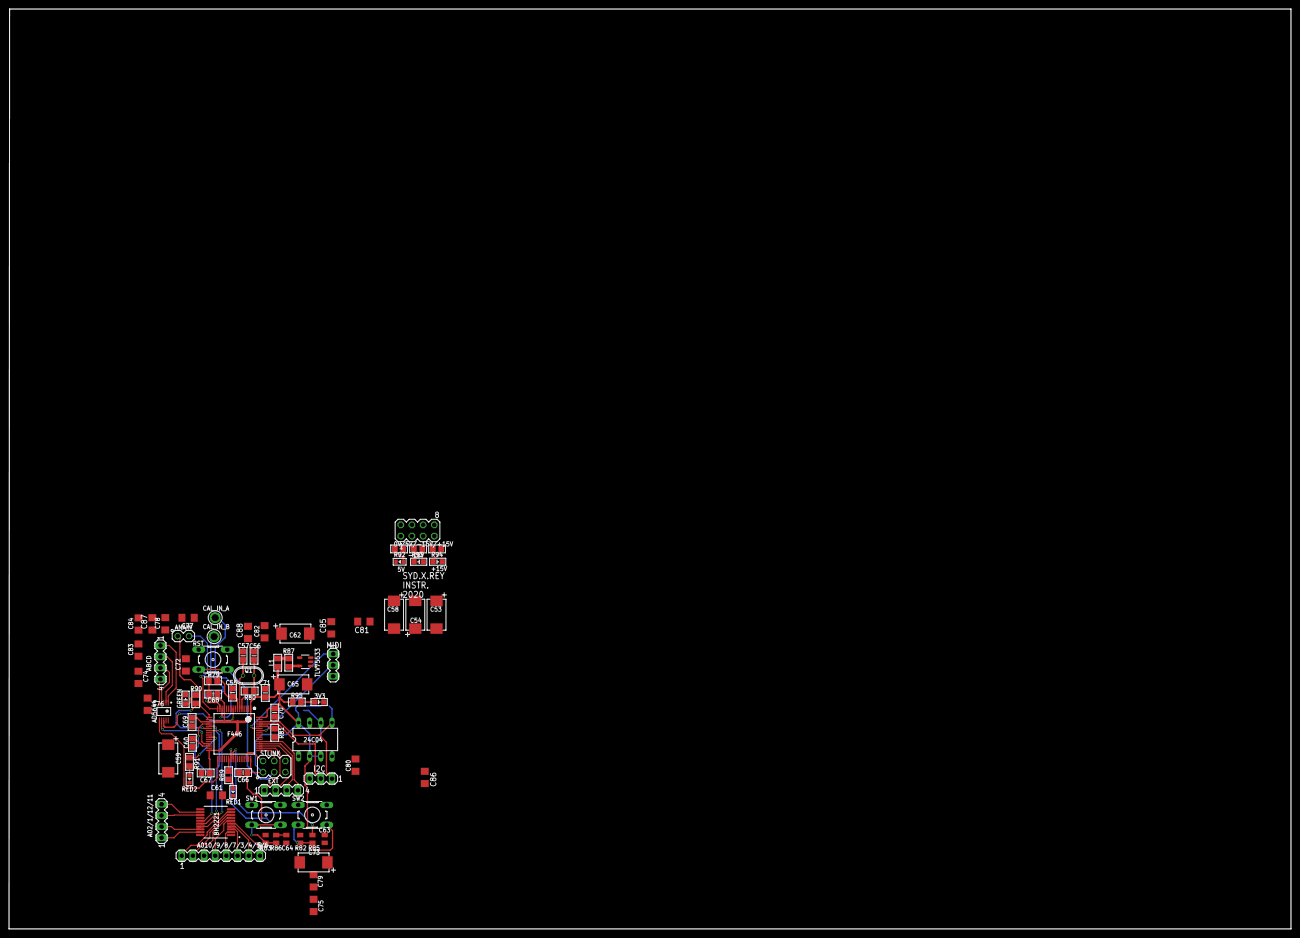
[picture p178: board STM32_DAC.brd from above]

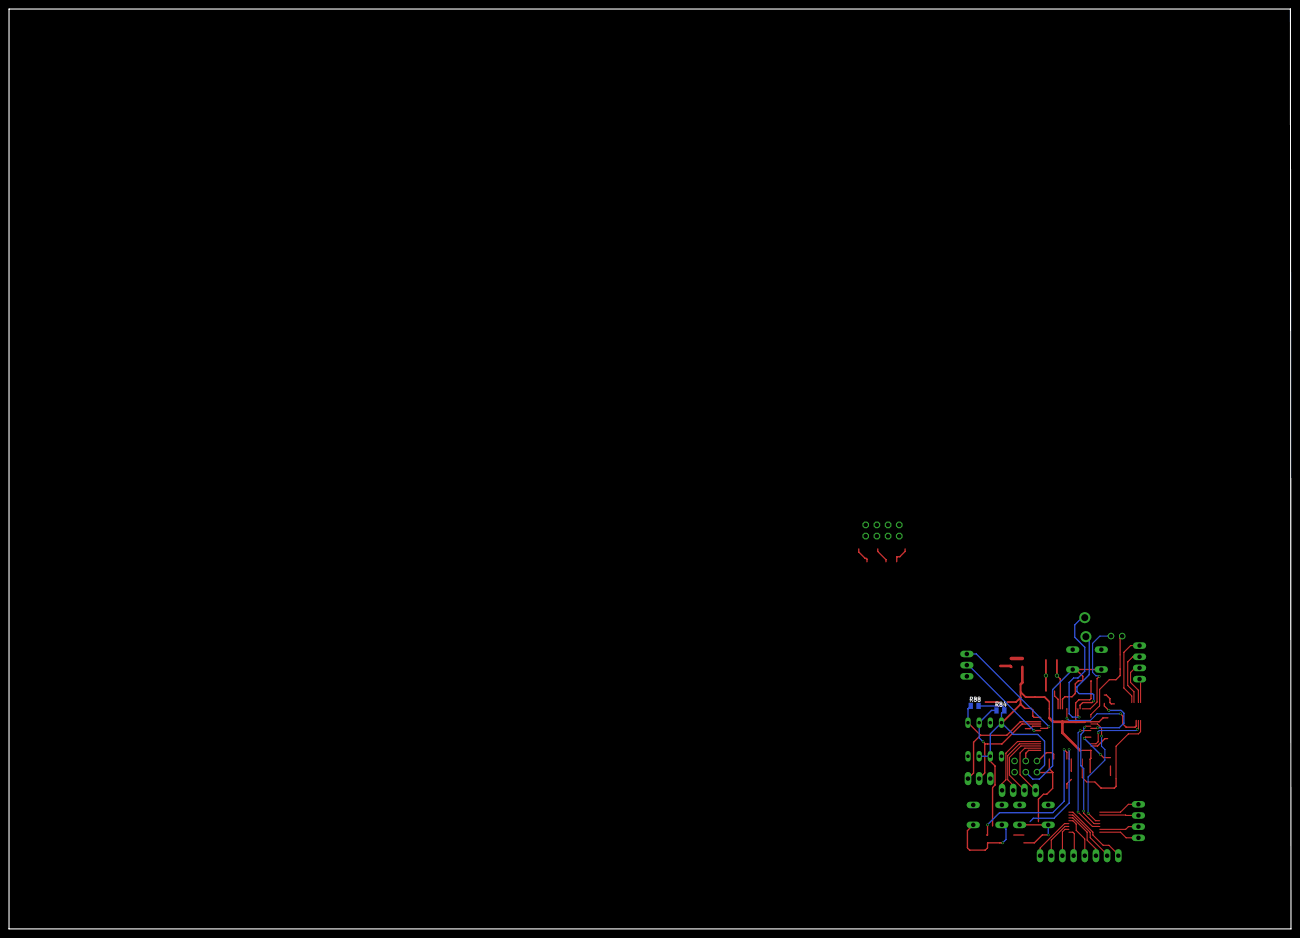
[picture p179: board STM32_DAC.brd from below]

Board: 2 copper layers, 291.3 x 209.1 mm, 81 parts (2 on the bottom side), 63 nets.
