reynal/themis/main-board/v3.0/eagle-schematics/STM32F446 Polyphonic Board SMD v1.0.brd

## EAGLE design main-board/v3.0/eagle-schematics/STM32F446 Polyphonic Board SMD v1.0.brd (2022-09-02)

Schematic: STM32F446 Polyphonic Board SMD v1.0.sch, sheet 1

Parts:
0V/5V/-15V/+15V: MA04-2
3V3: LED-0805; 0805-LED
5V: LED-0603; 0603-LED
24C04: 24C04AP; DIL8
2164A, 2164B: SSM2164; DIL16
3340A, 3340B: CEM3340; DIL16
+15V: LED-0805; 0805-LED
-15V: LED-0805; 0805-LED
A1, A2, A3, A4: T; TESTPOINT_63
A02/1/12/11: MA04-1
A010/9/8/7/3/4/5/6: MA08-1
ABCD: MA04-1
AD5644: ANALOG_DEVICES_AD5644RBRMZ-5ANALOG_DEVICES_AD5644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; ANALOG_DEVICES_AD5644RBRMZ-5_0
ADG453: ADG453BRZ; SOIC127P600X175-16N
ANAIN: MA02-1
B1, B2, B3, B4: T; TESTPOINT_63
BH2221: BH2221FV; SOP65P780X200-20N
C1, C2, C5, C6, C9, C10, C11, C16, C33, C34, C39, C40, C51, C63, C64: 100n; C0805
C3, C4, C7, C8: 1n; C0805
C12, C13, C14, C15: 10n; C0805
C17, C18, C19, C20, C21, C22, C23, C24, C41: 470n; C0805
C25, C26, C27, C28, C29, C30, C31, C32: 560p; C0805
C35, C46: 100p; C0805
C36, C37, C38: 4.7u; C0805
C42, C44: 1u; C0805
C43, C45, C49, C52: 300p; C0805
C50: 22u; B45181A
C53, C54, C58, C59, C62, C73: 10u; CPOL2917
C55, C66, C67, C68, C69, C70: 0.1uF; C0805
C56, C57: 12pF; C0805
C60: 2.2uF; C0805
C61, C72: 100n; C1206
C65: 100 uF; CPOL2917
C71: 1.0uF; C0805
C74, C75, C76, C77, C78, C79, C80, C81, C82, C83, C84, C85, C86, C87, C88: 1u; C1206
CAL_A: SYNC_IN; TESTPOINT_63
CAL_B: CALIB B; TESTPOINT_63
CAL_IN_A: TESTPOINT; TESTPOINT_63
CAL_IN_B: TESTPOINT; TESTPOINT_63
CUTOFF: TESTPOINT; TESTPOINT_63
CV_A: CV; TESTPOINT_63
CV_B: CV; TESTPOINT_63
CV_TM: 100k; 6MM
EXT: MA04-1
F446: STM32F446RCT7; QFP50P1200X1200X160-64N
FM_B: FMLIN; TESTPOINT_63
GAINS: GAIN_CTRL; MA08-1
GREEN: LED-0805; 0805-LED
HIGH_A: 100k; 6MM
HIGH_B: 100k; 6MM
HOLE1, HOLE2, HOLE3, HOLE4: HOLES_MOUNT-PAD-ROUND-0.096-NS; HOLES_096-PAD-NS
I2C: MA03-1
IN9, IN10: TESTPOINT; TESTPOINT_63
IN34: IN34; MA02-1
ITOV: NE5534AN; DIL08
I_SUM: ITOV; MA08-2
JACK: 1502_01
L1: 1 uH; L0805
LOW_A: 100k; 6MM
LOW_B: 100k; 6MM
MIDI: MA03-1
MIXOUT: TESTPOINT; TESTPOINT_63
MODRING: LM13700M; SO16
Q: TESTPOINT; TESTPOINT_63
Q1: 16MHz; Q-HC-46X
Q_TM: 100k; 6MM
R1, R3: 330k; R0805
R2, R4: 68k; R0805
R5, R6, R51, R52, R63, R82, R83, R85, R86, R93, R94: 10k; R0805
R7, R8: 33k; R0805
R9, R10: 820; R0805
R11, R12: 24k; R0805
R13, R27: 470k; R0805
R14, R15, R16, R17: 5.6k; R0805
R18, R19: 1.8k; R0805
R20, R22, R23, R24, R32, R37, R38, R39, R40, R41, R42, R43, R73, R92: 470; R0805
R21: 1M; R0805
R25, R26: 1.5M; R0805
R28, R29, R30, R31, R33, R34, R35, R36, R46, R47, R58: 27k; R0805
R44, R45: 8.2k; R0805
R48: 33K; R0805
R49, R53, R62, R66, R67, R68, R72, R74, R78, R79: 100k; R0805
R50, R56, R84, R88, R90, R95: 1k; R0805
R54: 1.5k; R0805
R55: 51k; R0805
R57: 4.7k; R0805
R59, R64, R70, R76: 91k; R0805
R60, R69: 47k; R0805
R61: 22k; R0805
R65, R71, R77: 220k; R0805
R75: 100kB; 3RP/1610N
R80: 100; R0805
R81: 10K; R0805
R87: 1; R0805
R89, R91: 180; R0805
RED1, RED2: LED-0603; 0603-LED
RST: 10-XX; B3F-10XX
SAW_A: S; TESTPOINT_63
SAW_B: S; TESTPOINT_63
SD3: SD3; MA02-1
SD4: SD4; MA02-1
SQU_A: P; TESTPOINT_63
SQU_B: P; TESTPOINT_63
STLINK: 75867-331LF; MA03-2
SUB: 4027D; SO16
SUB2, SUB4: T; TESTPOINT_63
SUB_IN: T; TESTPOINT_63
SUM_CON: MA04-2
SUM_OPAMP: NE5534AN; DIL08
SW1, SW2: 10-XX; B3F-10XX
SYNC_A: SYNC_IN; TESTPOINT_63
SYNC_B: SYNC_IN; TESTPOINT_63
TEMCOA: 10k; 6MM
TEMCOB: 10k; 6MM
TLV75533: TLV75533PDBVR; SOT95P280X145-5N
TRI_A: T; TESTPOINT_63
TRI_B: T; TESTPOINT_63
VCA: LM13700M; SO16
VCA_CV: TESTPOINT; TESTPOINT_63
VCA_IN: TESTPOINT; TESTPOINT_63
VCA_OUT: TESTPOINT; TESTPOINT_63
VCF1: AS3320; DIL18
VCF_IN: TESTPOINT; TESTPOINT_63
VCF_OUT: TESTPOINT; TESTPOINT_63
XIN: TESTPOINT; TESTPOINT_63
XMOD: TESTPOINT; TESTPOINT_63

Connections:
3V3: 24C04.2 (A1), 24C04.3 (A2), 24C04.8 (VCC), C65.+, C66.2, C67.2, C68.2, C69.2, C70.2, C71.2, F446.1 (VBAT), F446.13 (VDDA/VREF+), F446.19 (VDD_4), F446.32 (VDD_1), F446.48 (VDD_2), F446.64 (VDD_3), L1.2, R79.1, R82.1, R83.1, R84.2, R88.2, R95.1, STLINK.1
5V: 0V/5V/-15V/+15V.3, 0V/5V/-15V/+15V.4, AD5644.9 (VDD), ADG453.12 (VL), BH2221.10 (VDD), BH2221.11 (VCC), C16.1, C51.1, C58.+, C59.+, C61.2, C62.+, C72.2, C73.+, C76.2, R92.1, SUB.5 (K), SUB.11 (K), SUB.16 (VDD), TLV75533.1 (IN), TLV75533.3 (EN)
2164_IN1_MIXA: 2164A.2 (I_IN1), R33.1, R40.1
2164_IN2_MIXA: 2164A.7 (I_IN2), R34.1, R41.1
2164_IN2_MIXB: 2164B.7 (I_IN2), R29.1, R37.1
2164_IN3_MIXA: 2164A.10 (I_IN3), R35.1, R42.1
2164_IN3_MIXB: 2164B.10 (I_IN3), R30.1, R38.1
2164_IN4_MIXA: 2164A.15 (I_IN4), R36.1, R43.1
2164_IN4_MIXB: 2164B.15 (I_IN4), R31.1, R39.1
2164_IN4_MIXB1: 2164B.2 (I_IN1), R28.1, R32.1
2164_MODE_MIXB: 2164B.1 (MODE), R44.2
2164_OUT2_MIXA: 2164A.5 (I_OUT2), I_SUM.4
2164_OUT2_MIXB: 2164B.5 (I_OUT2), I_SUM.14
2164_OUT3_MIXA: 2164A.12 (I_OUT3), I_SUM.8
2164_OUT3_MIXB: 2164B.12 (I_OUT3), I_SUM.16
2164_OUT4_MIXA: 2164A.13 (I_OUT4), I_SUM.6
2164_OUT4_MIXB: 2164B.13 (I_OUT4), I_SUM.12
+15V: 0V/5V/-15V/+15V.7, 0V/5V/-15V/+15V.8, 2164A.16 (V+), 2164B.16 (V+), 3340A.16 (VCC), 3340B.16 (VCC), ADG453.13 (VDD), C5.2, C6.2, C33.2, C39.2, C53.+, C74.2, C77.2, C78.2, C79.2, C80.2, C81.2, C82.2, C83.2, ITOV.7 (V+), LOW_A.E, LOW_B.E, MODRING.11 (V+), R1.2, R3.2, R25.2, R26.2, R44.1, R45.1, R51.1, R60.2, R94.1, SUM_OPAMP.7 (V+), VCA.11 (V+), VCF1.14 (V+)
-15V: 0V/5V/-15V/+15V.5, 0V/5V/-15V/+15V.6, 2164A.9 (V-), 2164B.9 (V-), ADG453.4 (VSS), C34.1, C54.-, C75.2, C84.2, C85.2, C86.2, C87.2, C88.2, ITOV.4 (V-), MODRING.6 (V-), R9.1, R10.1, R54.1, R63.1, R65.1, R71.1, R77.1, R93.1, SUM_OPAMP.4 (V-)
AD5644_CLK: AD5644.7 (SCLK), F446.29 (PB10)
AD5644_DI: AD5644.8 (DIN), F446.9 (PC1)
AD5644_SYNC: AD5644.6 (!SYNC!), F446.33 (PB12)
BH2221_AO1: A02/1/12/11.2, BH2221.18 (AO1)
BH2221_AO2: A02/1/12/11.1, BH2221.19 (AO2)
BH2221_AO3: A010/9/8/7/3/4/5/6.5, BH2221.2 (AO3)
BH2221_AO4: A010/9/8/7/3/4/5/6.6, BH2221.3 (AO4)
BH2221_AO6: A010/9/8/7/3/4/5/6.8, BH2221.5 (AO6)
BH2221_AO7: A010/9/8/7/3/4/5/6.4, BH2221.6 (AO7)
BH2221_AO8: A010/9/8/7/3/4/5/6.3, BH2221.7 (AO8)
BH2221_AO9: A010/9/8/7/3/4/5/6.2, BH2221.8 (AO9)
BH2221_AO10: A010/9/8/7/3/4/5/6.1, BH2221.9 (AO10)
BH2221_AO11: A02/1/12/11.4, BH2221.12 (AO11)
BH2221_AO12: A02/1/12/11.3, BH2221.13 (AO12)
BH2221_CLK: BH2221.16 (CLK), F446.21 (PA5)
BH2221_DI: BH2221.17 (DI), F446.23 (PA7)
BH2221_LD: BH2221.15 (LD), F446.20 (PA4)
BIAS_VCA: C37.1, R50.2, R51.2, R52.1, SUM_OPAMP.3 (+IN), VCA.4 (IN_N)
BOOT1: F446.60 (BOOT0), R81.1
CALIB_3340A: CAL_A.P$1, R6.1, R8.1
CALIB_3340B: CAL_B.P$1, R5.1, R7.1
CALIB_IN_3340A: CAL_IN_A.P$1, F446.14 (PA0)
CALIB_IN_3340B: CAL_IN_B.P$1, F446.15 (PA1)
CAP1_VCF: C43.2, VCF1.5 (CAP)
CAP2_VCF: C45.2, VCF1.4 (CAP)
CAP3_VCF: C49.2, VCF1.16 (CAP)
CAP4_VCF: C52.2, VCF1.11 (CAP)
CV_CUTOFF: CUTOFF.P$1, CV_TM.E
CV_FREQ_3340A: CV_A.P$1, HIGH_A.E
CV_FREQ_3340B: CV_B.P$1, HIGH_B.E
CV_PWM_3340A: 3340A.5 (PWM_CTRL), R3.1, R4.1
CV_PWM_3340B: 3340B.5 (PWM_CTRL), R1.1, R2.1
CV_RES: Q.P$1, Q_TM.E, Q_TM.S
CV_VCA: R58.1, VCA_CV.P$1
EXT1: EXT.1, F446.50 (PA15)
EXT2: EXT.2, F446.51 (PC10)
EXT3: EXT.3, F446.52 (PC11)
EXT4: EXT.4, F446.53 (PC12)
FEEDBACK_VCF: ADG453.2 (D1), ADG453.15 (D2), C44.1
FMLIN_3340B: C11.2, FM_B.P$1
FREQ_CTRL_3340A: 3340A.15 (FREQ_CTRL), HIGH_A.A, HIGH_A.S, LOW_A.A, LOW_A.S, R24.1
FREQ_CTRL_3340B: 3340B.15 (FREQ_CTRL), HIGH_B.A, HIGH_B.S, LOW_B.A, LOW_B.S, R23.1
FREQ_CV_VCF: CV_TM.S, VCF1.12 (FREQ_CV)
GAIN1_A: 2164A.3 (GAIN_VCA1), GAINS.8
GAIN1_B: 2164B.3 (GAIN_VCA1), GAINS.4
GAIN2_A: 2164A.6 (GAIN_VCA2), GAINS.5
GAIN2_B: 2164B.6 (GAIN_VCA2), GAINS.1
GAIN3_A: 2164A.11 (GAIN_VCA3), GAINS.6
GAIN3_B: 2164B.11 (GAIN_VCA3), GAINS.2
GAIN4_A: 2164A.14 (GAIN_VCA4), GAINS.7
GAIN4_B: 2164B.14 (GAIN_VCA4), GAINS.3
GND: 0V/5V/-15V/+15V.1, 0V/5V/-15V/+15V.2, 3V3.C, 5V.C, 24C04.1 (A0), 24C04.4 (GND), 24C04.7 (WP), 2164A.8 (GND), 2164B.8 (GND), 3340A.12 (GND), 3340B.12 (GND), +15V.C, -15V.A, AD5644.3 (GND), ADG453.5 (GND), BH2221.20 (GND), C1.1, C2.1, C5.1, C6.1, C7.1, C8.1, C9.1, C10.1, C12.1, C13.1, C14.2, C15.2, C16.2, C25.1, C26.1, C27.1, C28.1, C29.1, C30.1, C31.1, C32.1, C33.1, C34.2, C37.2, C39.1, C40.2, C43.1, C45.1, C49.1, C51.2, C52.1, C53.-, C54.+, C55.1, C56.1, C57.1, C58.-, C59.-, C60.1, C61.1, C62.-, C63.2, C64.2, C65.-, C66.1, C67.1, C68.1, C69.1, C70.1, C71.1, C72.1, C73.-, C74.1, C75.1, C76.1, C77.1, C78.1, C79.1, C80.1, C81.1, C82.1, C83.1, C84.1, C85.1, C86.1, C87.1, C88.1, CV_TM.A, F446.12 (VSSA/VREF-), F446.18 (VSS_4), F446.31 (VSS_1), F446.47 (VSS_2), F446.63 (VSS_3), GREEN.C, I2C.3, ITOV.3 (+IN), JACK.1, MIDI.3, MODRING.13 (IN_N), R2.2, R4.2, R5.2, R6.2, R13.1, R18.2, R19.2, R27.1, R52.2, R56.2, R61.1, R66.1, R68.1, R72.2, R75.1 (A), R81.2, RED1.C, RED2.C, RST.3, RST.4 (P1), STLINK.5, SUB.4 (R), SUB.7 (S), SUB.8 (VSS), SUB.9 (S), SUB.12 (R), SW1.1 (S), SW1.2 (S1), SW2.1 (S), SW2.2 (S1), TLV75533.2 (GND), VCA.6 (V-), VCF1.3 (GND)
HEADIN_OPAMP_OUT: C46.2, R69.2, SUM_CON.1, SUM_CON.2, SUM_CON.3, SUM_CON.4, SUM_CON.5, SUM_CON.6, SUM_CON.7, SUM_CON.8, SUM_OPAMP.2 (-IN)
IN1_MIXERA: A1.P$1, C18.1
IN1_VCF: R59.2, R62.2, VCF1.1 (IN)
IN2_MIXERA: A2.P$1, C20.1
IN2_MIXERB: B2.P$1, C17.1
IN2_VCF: R64.1, R65.2, R67.1, VCF1.2 (IN)
IN3_MIXERA: A3.P$1, C23.1
IN3_MIXERB: B3.P$1, C21.1
IN3_VCF: R70.1, R71.2, R74.1, VCF1.17 (IN)
IN4_MIXERB: B4.P$1, C22.1
IN4_MIXERB1: B1.P$1, C19.1
IN4_VCF: R76.1, R77.2, R78.1, VCF1.18 (IN)
IN_VCF: C41.2, VCF_IN.P$1
IN_VCFORDER: ADG453.1 (IN1), ADG453.16 (IN2), R68.2
IOUT_VCA: VCA.5 (OUT), VCA_OUT.P$1
ITOV_IN: C35.1, ITOV.2 (-IN), I_SUM.1, I_SUM.3, I_SUM.5, I_SUM.7, I_SUM.9, I_SUM.11, I_SUM.13, I_SUM.15, R46.1, R47.1, R48.1
LED1_PWM: F446.22 (PA6), R90.1
LED2_PWM: F446.38 (PC7), R89.1
LED3_PWM: F446.26 (PB0), R91.1
LINEAR_CTRL_3340A: 3340A.13 (LINEAR_CTRL), R22.1, R26.1
LINEAR_CTRL_3340B: 3340B.13 (LINEAR_CTRL), R20.1, R21.1, R25.1
unnamed: 2164B.4 (I_OUT1), I_SUM.10
unnamed: 3340B.6 (HARD_SYNC), C3.2
unnamed: SUB.10 (J), SUB.14 (!Q)
unnamed: 2164A.4 (I_OUT1), I_SUM.2
unnamed: R82.2, R85.1, SW2.3, SW2.4 (P1)
unnamed: A4.P$1, C24.1
unnamed: R83.2, R86.1, SW1.3, SW1.4 (P1)
unnamed: C3.1, R13.2, SYNC_B.P$1
unnamed: ADG453.6 (S4), SD4.2
unnamed: C25.2, R32.2
unnamed: C19.2, R28.2
unnamed: MODRING.14 (IN_P), R53.2, R56.1
unnamed: C36.2, R49.2
unnamed: IN9.P$1, R46.2
unnamed: IN10.P$1, R47.2
unnamed: ADG453.7 (D4), SD4.1
unnamed: R58.2, VCA.1 (I_BIAS)
unnamed: ADG453.11 (S3), SD3.1
unnamed: C26.2, R37.2
unnamed: C27.2, R38.2
unnamed: A010/9/8/7/3/4/5/6.7, BH2221.4 (AO5)
unnamed: C28.2, R39.2
unnamed: ABCD.1, AD5644.1 (VOUTA)
unnamed: ABCD.2, AD5644.2 (VOUTB)
unnamed: ADG453.10 (D3), SD3.2
unnamed: ADG453.9 (IN3), IN34.1, R72.1
unnamed: 2164A.1 (MODE), R45.2
unnamed: ABCD.3, AD5644.4 (VOUTC)
unnamed: ABCD.4, AD5644.5 (VOUTD)
unnamed: SUB.2 (!Q), SUB.6 (J)
unnamed: C38.1, R53.1
unnamed: MODRING.9 (E), R63.2
unnamed: C42.1, MODRING.16 (I_BIAS), R60.1
unnamed: C42.2, R57.1
unnamed: C36.1, R50.1, VCA.3 (IN_P)
unnamed: R89.2, RED1.A
unnamed: R57.2, XMOD.P$1
unnamed: C38.2, XIN.P$1
unnamed: MODRING.10 (B), MODRING.12 (OUT), R61.2
unnamed: R91.2, RED2.A
unnamed: 5V.A, R92.2
unnamed: -15V.C, R93.2
unnamed: +15V.A, R94.2
unnamed: GREEN.A, R90.2
unnamed: 3V3.A, R95.2
unnamed: ANAIN.2, F446.16 (PA2)
unnamed: ANAIN.1, F446.17 (PA3)
unnamed: C21.2, R30.2
unnamed: C17.2, R29.2
unnamed: C22.2, R31.2
unnamed: C30.2, R41.2
unnamed: C29.2, R40.2
unnamed: C31.2, R42.2
unnamed: C32.2, R43.2
unnamed: C18.2, R33.2
unnamed: C23.2, R35.2
unnamed: C20.2, R34.2
unnamed: C24.2, R36.2
unnamed: C56.2, Q1.1, R80.2
unnamed: R87.2, TLV75533.5 (OUT)
unnamed: L1.1, R87.1
unnamed: C41.1, R59.1
unnamed: C12.2, R23.2
unnamed: C14.1, R20.2
unnamed: 3340B.1 (MUL_GAIN1), TEMCOB.A
unnamed: R11.1, TEMCOB.E, TEMCOB.S
unnamed: C11.1, R21.2
unnamed: 3340B.8 (SAW_OUT), R14.2
unnamed: C13.2, R24.2
unnamed: C15.1, R22.2
unnamed: 3340A.1 (MUL_GAIN1), TEMCOA.A
unnamed: R12.1, TEMCOA.E, TEMCOA.S
unnamed: 3340A.8 (SAW_OUT), R15.2
unnamed: 3340A.6 (HARD_SYNC), C4.2
NRST: C55.2, F446.7 (NRST), R79.2, RST.1 (S), RST.2 (S1), STLINK.3
OSC_IN: F446.5 (PH0-OSC_IN), R80.1
OSC_OUT: C57.2, F446.6 (PH1-OSC_OUT), Q1.2
OUT1_VCF: R62.1, R64.2, VCF1.7 (OUT)
OUT2_VCF: ADG453.3 (S1), R67.2, R70.2, VCF1.6 (OUT)
OUT3_VCF: R74.2, R76.2, VCF1.15 (OUT)
OUT4_VCF: ADG453.14 (S2), R78.2, VCF1.10 (OUT)
OUT_JACK: C50.-, JACK.2 (3), JACK.3 (2)
OUT_MIXER: C35.2, ITOV.6 (OUT), MIXOUT.P$1, R48.2
OUT_OPAMP: C46.1, R69.1, R73.2, SUM_OPAMP.6 (OUT)
OUT_POT: C50.+, R73.1, R75.2 (S), R75.3 (E)
OUT_VCF: C44.2, R55.2, VCF_OUT.P$1
PULSE_3340A: 3340A.4 (PULSE_OUT), R8.2, SQU_A.P$1
PULSE_3340B: 3340B.4 (PULSE_OUT), R7.2, SQU_B.P$1
RES_CUR_IN_VCF: R55.1, VCF1.8 (IN_RES)
RES_CUR_VCF: Q_TM.A, VCF1.9 (RES_CUR)
SAW_3340A: R15.1, SAW_A.P$1
SAW_3340B: R14.1, SAW_B.P$1
SCALE_3340A: 3340A.14 (SCALE), R19.1
SCALE_3340B: 3340B.14 (SCALE), R18.1
SCL: 24C04.6 (SCL), F446.61 (PB8), I2C.2, R84.1
SDA: 24C04.5 (SDA), F446.62 (PB9), I2C.1, R88.1
SOFT_SYNC_3340A: 3340A.9 (SOFT_SYNC), C10.2
SOFT_SYNC_3340B: 3340B.9 (SOFT_SYNC), C9.2
SUB_IN: SUB.3 (CLK), SUB_IN.P$1
SUB_OUT2: SUB.1 (Q), SUB.13 (CLK), SUB2.P$1
SUB_OUT4: SUB.15 (Q), SUB4.P$1
SW1: C63.1, F446.40 (PC9), R85.2
SW2: C64.1, F446.39 (PC8), R86.2
SWCLK: F446.49 (PA14), STLINK.4
SWDIO: F446.46 (PA13), STLINK.2
SYNC_3340A: C4.1, R27.2, SYNC_A.P$1
TEMPCO2_VCOA: 3340A.2 (MUL_GAIN2), R17.1
TEMPCO2_VCOB: 3340B.2 (MUL_GAIN2), R16.1
TIMING_CAP_3340A: 3340A.11 (TIMING_CAP), C8.2
TIMING_CAP_3340B: 3340B.11 (TIMING_CAP), C7.2
TRI_3340A: 3340A.10 (TRI_OUT), TRI_A.P$1
TRI_3340B: 3340B.10 (TRI_OUT), TRI_B.P$1
USART1_RX: F446.59 (PB7), MIDI.1
USART1_TX: F446.58 (PB6), MIDI.2
VCAP1: C60.2, F446.30 (VCAP_1)
VCA_IN: R49.1, VCA_IN.P$1
VCF_ANASW_IN4: ADG453.8 (IN4), IN34.2, R66.2
VEE_VCF: C40.1, R54.2, VCF1.13 (V-)
VEE_VCOA: 3340A.3 (VEE), C2.2, R10.2, R12.2, R17.2
VEE_VCOB: 3340B.3 (VEE), C1.2, R9.2, R11.2, R16.2

Notes on the sheet:
Mixers A and B, 4 channels each (w/o VCA channel)
current -> voltage converter
According to the AS3320 datasheet, control voltage at pin 12 ranges from 0 to 200mV.
AS3320 VCF
Low Pass 2nd Order
Low Pass 4th Order
VCA
Connect 2 and 3 to bypass VCF. Otherwise connect 1 with 2, and 3 with 4.
STM32F446
Note: for a polyphonic synth, voice summing is performed here on the inverting input of the op amp.
Output summing stage
Protection againt short circuits
POWER
DAC (12 ch 8 bits + 4 ch 14 bits)
Connecté sur SPI1: - CLK=PA5 - MOSI=PA7 - NSS=PA4
Connecté sur SPI2: - CLK=PB10 - MOSI=PC1 - NSS=PB12
Channels: A01-12 = 8 bits B01-04 = 14 bits - A01 à A08 : 2164D vca - A09 : VCF cutoff - A10 : VCF Q - A11 : PWM 3340A - A12 : PWM 3340B - B01 : CV 3340A - B02 : CV 3340B - B03 : noise / wave generator (VCO #3) - B04 : VCA LM13700
VCO3340B
VCO3340A
MOD RING
!!!! Erreurs de routage de la v7 corrigée sur la 7.1 !!!! Au moment de l'équipement de la carte il fallait : - inverser le condo polarisé C54 (+ côté 0V et non côté -15V) - inverser la LED "-15V" (pour la même raison)
Ajouter une capa de liaison !
ERREUR corrigée sur la v7.1 (oubli de connection au 5V et du GND)
