reynal/themis/main-board/v3.0/eagle-schematics/STM32F446 Polyphonic Board SMD v1.0.brd

## EAGLE design main-board/v3.0/eagle-schematics/STM32F446 Polyphonic Board SMD v1.0.brd (continued)

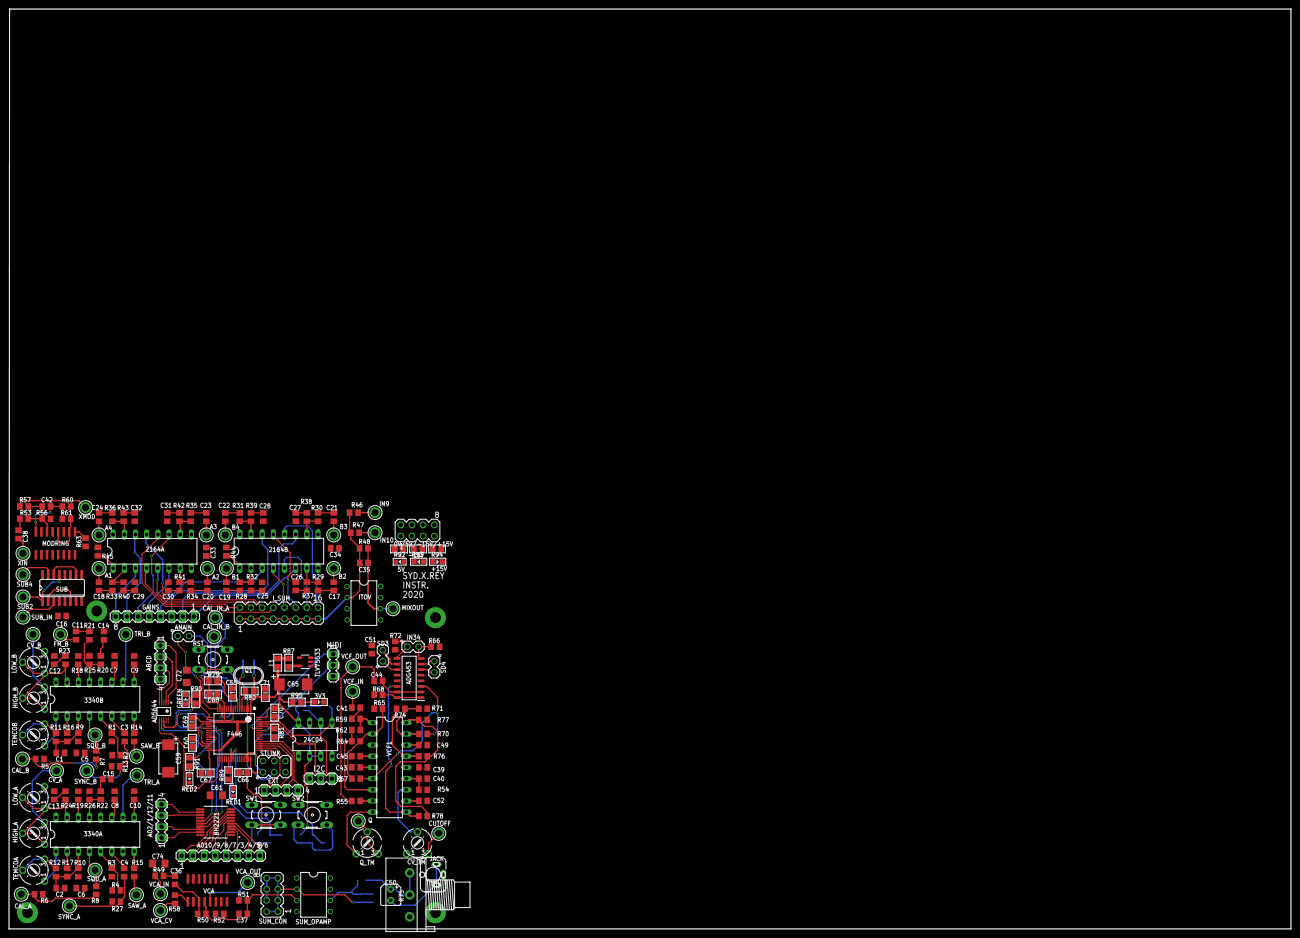
[picture p180: board STM32F446 Polyphonic Board SMD v1.0.brd from above]

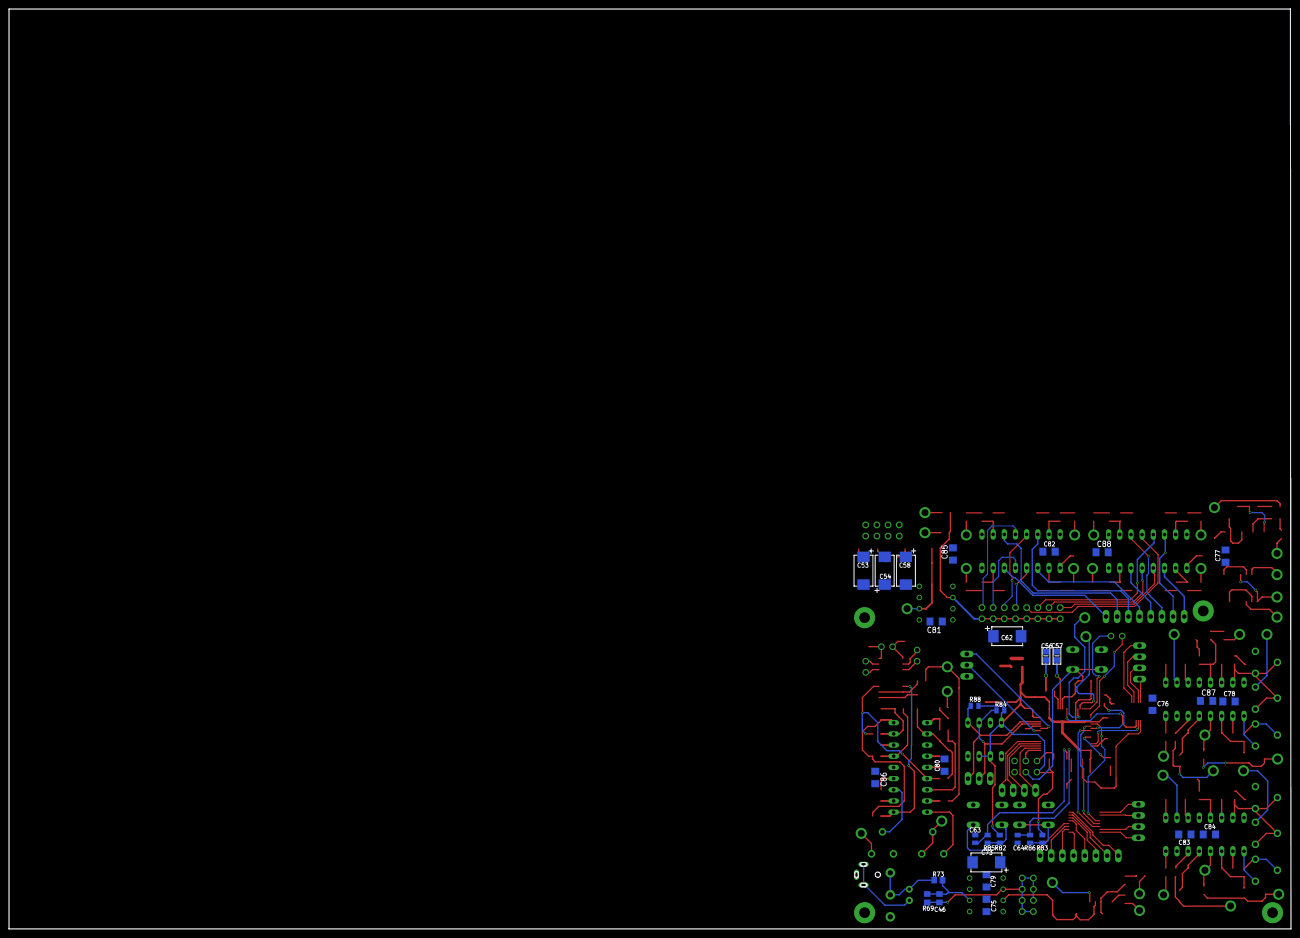
[picture p181: board STM32F446 Polyphonic Board SMD v1.0.brd from below]

Board: 2 copper layers, 291.3 x 209.1 mm, 275 parts (32 on the bottom side), 212 nets.
