reynal/themis/front-pane/eagle-schematics/v3/STM32F446 front pane - v3.1.brd

## EAGLE design front-pane/eagle-schematics/v3/STM32F446 front pane - v3.1.brd (2022-05-10)

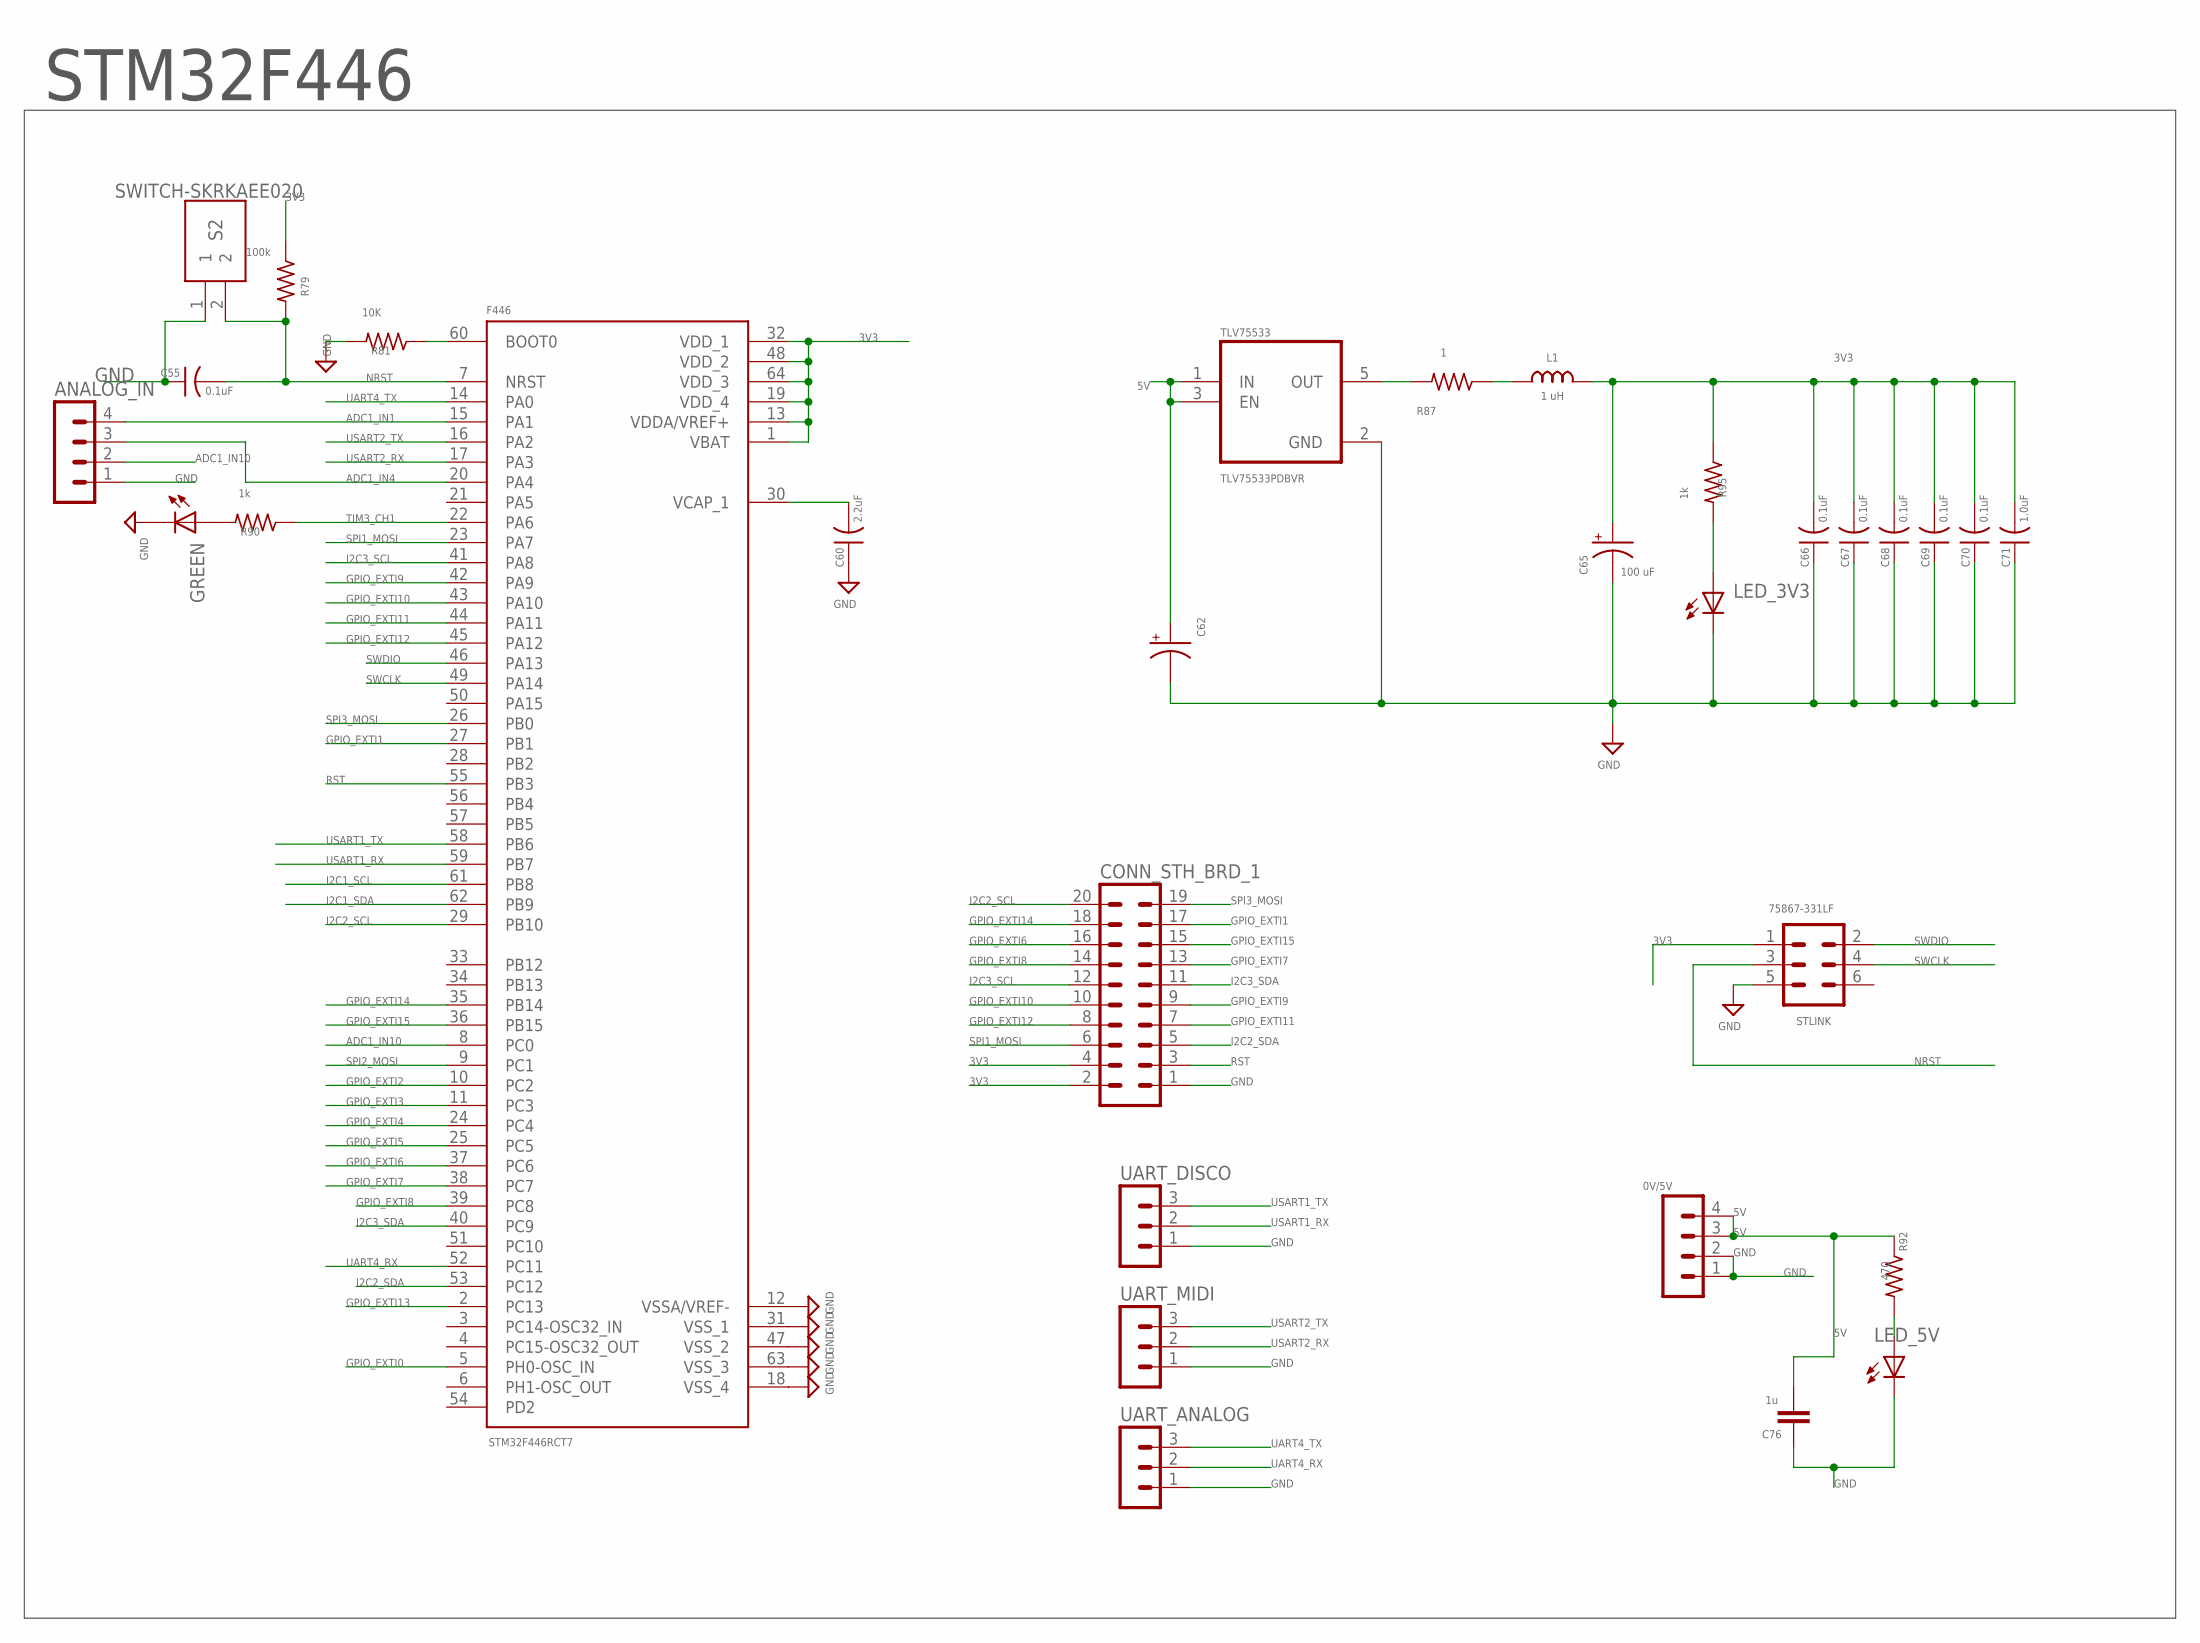
[picture p182: schematic STM32F446 front pane - v3.1.sch, sheet 1]

Parts:
0V/5V: PINHEADER-M04PL; MA04-1
ANALOG_IN: MA04-1
C55, C66, C67, C68, C69, C70: 0.1uF; C0805
C60: 2.2uF; C0805
C62: 10u; CPOL2917
C65: 100 uF; CPOL2917
C71: 1.0uF; C0805
C76: 1u; C1206
CONN_STH_BRD_1: MA10-2
F446: STM32F446RCT7; QFP50P1200X1200X160-64N
GREEN: LED-0805; 0805-LED
L1: 1 uH; L0805
LED_3V3: LED-0805; 0805-LED
LED_5V: LED-0603; 0603-LED
R79: 100k; R0805
R81: 10K; R0805
R87: 1; R0805
R90, R95: 1k; R0805
R92: 470; R0805
S2: SWITCH-SKRKAEE020; SKRKAEE020
STLINK: 75867-331LF; MA03-2
TLV75533: TLV75533PDBVR; SOT95P280X145-5N
UART_ANALOG: MA03-1
UART_DISCO: MA03-1
UART_MIDI: MA03-1

Connections:
3V3: C65.+, C66.2, C67.2, C68.2, C69.2, C70.2, C71.2, CONN_STH_BRD_1.2, CONN_STH_BRD_1.4, F446.1 (VBAT), F446.13 (VDDA/VREF+), F446.19 (VDD_4), F446.32 (VDD_1), F446.48 (VDD_2), F446.64 (VDD_3), L1.2, R79.1, R95.1, STLINK.1; also elsewhere on the board
5V: 0V/5V.3, 0V/5V.4, C62.+, C76.2, R92.1, TLV75533.1 (IN), TLV75533.3 (EN)
ADC1_IN1: ANALOG_IN.4, F446.15 (PA1)
ADC1_IN4: ANALOG_IN.3, F446.20 (PA4)
ADC1_IN10: ANALOG_IN.2, F446.8 (PC0)
BOOT1: F446.60 (BOOT0), R81.1
GND: 0V/5V.1, 0V/5V.2, ANALOG_IN.1, C55.1, C60.1, C62.-, C65.-, C66.1, C67.1, C68.1, C69.1, C70.1, C71.1, C76.1, CONN_STH_BRD_1.1, F446.12 (VSSA/VREF-), F446.18 (VSS_4), F446.31 (VSS_1), F446.47 (VSS_2), F446.63 (VSS_3), GREEN.C, LED_3V3.C, LED_5V.C, R81.2, S2.1, STLINK.5, TLV75533.2 (GND), UART_ANALOG.1, UART_DISCO.1, UART_MIDI.1; also elsewhere on the board
GPIO_EXTI0: F446.5 (PH0-OSC_IN); also elsewhere on the board
GPIO_EXTI1: CONN_STH_BRD_1.17, F446.27 (PB1)
GPIO_EXTI2: F446.10 (PC2); also elsewhere on the board
GPIO_EXTI3: F446.11 (PC3); also elsewhere on the board
GPIO_EXTI4: F446.24 (PC4); also elsewhere on the board
GPIO_EXTI5: F446.25 (PC5); also elsewhere on the board
GPIO_EXTI6: CONN_STH_BRD_1.16, F446.37 (PC6)
GPIO_EXTI7: CONN_STH_BRD_1.13, F446.38 (PC7)
GPIO_EXTI8: CONN_STH_BRD_1.14, F446.39 (PC8)
GPIO_EXTI9: CONN_STH_BRD_1.9, F446.42 (PA9)
GPIO_EXTI10: CONN_STH_BRD_1.10, F446.43 (PA10)
GPIO_EXTI11: CONN_STH_BRD_1.7, F446.44 (PA11)
GPIO_EXTI12: CONN_STH_BRD_1.8, F446.45 (PA12)
GPIO_EXTI13: F446.2 (PC13); also elsewhere on the board
GPIO_EXTI14: CONN_STH_BRD_1.18, F446.35 (PB14)
GPIO_EXTI15: CONN_STH_BRD_1.15, F446.36 (PB15)
I2C1_SCL: F446.61 (PB8); also elsewhere on the board
I2C1_SDA: F446.62 (PB9); also elsewhere on the board
I2C2_SCL: CONN_STH_BRD_1.20, F446.29 (PB10); also elsewhere on the board
I2C2_SDA: CONN_STH_BRD_1.5, F446.53 (PC12); also elsewhere on the board
I2C3_SCL: CONN_STH_BRD_1.12, F446.41 (PA8); also elsewhere on the board
I2C3_SDA: CONN_STH_BRD_1.11, F446.40 (PC9); also elsewhere on the board
unnamed: LED_5V.A, R92.2
unnamed: GREEN.A, R90.2
unnamed: LED_3V3.A, R95.2
unnamed: R87.2, TLV75533.5 (OUT)
unnamed: L1.1, R87.1
NRST: C55.2, F446.7 (NRST), R79.2, S2.2, STLINK.3
RST: CONN_STH_BRD_1.3, F446.55 (PB3); also elsewhere on the board
SPI1_MOSI: CONN_STH_BRD_1.6, F446.23 (PA7); also elsewhere on the board
SPI2_MOSI: F446.9 (PC1); also elsewhere on the board
SPI3_MOSI: CONN_STH_BRD_1.19, F446.26 (PB0); also elsewhere on the board
SWCLK: F446.49 (PA14), STLINK.4
SWDIO: F446.46 (PA13), STLINK.2
TIM3_CH1: F446.22 (PA6), R90.1
UART4_RX: F446.52 (PC11), UART_ANALOG.2
UART4_TX: F446.14 (PA0), UART_ANALOG.3
USART1_RX: F446.59 (PB7), UART_DISCO.2
USART1_TX: F446.58 (PB6), UART_DISCO.3
USART2_RX: F446.17 (PA3), UART_MIDI.2
USART2_TX: F446.16 (PA2), UART_MIDI.3
VCAP1: C60.2, F446.30 (VCAP_1)

Notes on the sheet:
STM32F446

Schematic: STM32F446 front pane - v3.1.sch, sheet 2

Parts:
C4, C5, C6, C7, C8, C9, C10, C11, C12, C16, C17, C18, C22, C23, C24, C28, C29, C30, C34, C35, C36, C40, C41, C42, C46, C47, C48: 10n; 0805-CAP
CB1, CB2, CB4, CB6: 10n; 0805-CAP
CDEC_1, CDEC_2, CDEC_3, CDEC_4, CDEC_5, CDEC_6, CDEC_7, CDEC_8, CDEC_9, CDEC_10, CDEC_11, CDEC_12, CDEC_13: 100n; 1206
CDEC_11A, CDEC_12A: 10u; CPOL2917
CDEC_11B, CDEC_12B: 100n; 0805-CAP
CONN_STH_BRD_2: MA10-2
ENC_11, ENC_13, ENC_14, ENC_21, ENC_23: ENCODER-RGB-SWITCH-NO_NUT; ENCODER_LED_3
LED1, LED2, LED6, LED22: CZXR-80RGB03-A; LED4-2.0-D8.0MM
MCP_000, MCP_001: MCP23017; SOIC-28
PIXEL_11, PIXEL_12, PIXEL_13, PIXEL_14, PIXEL_21, PIXEL_22, PIXEL_23, PIXEL_24, PIXEL_31, PIXEL_32, PIXEL_33, PIXEL_34, PIXEL_35: NEOPIXEL-TLC59731DR; SOIC127P600X175-8N
R3, R6, R7, R8, R9, R10, R11, R12, R17, R18, R19, R24, R25, R26, R31, R35, R36, R37, R38, R39, R40, R48, R49, R50, R52, R53, R54, R66, R67, R68, R82, R84, R85, R102, R103, R104, R116, R117, R118: 100; 1206
R4, R5, R186, R187: 1k; R0805
R13, R20, R27, R41, R55, R69, R88, R105, R119: 10k; 1206
R14, R15, R16, R21, R22, R23, R28, R29, R30, R42, R43, R44, R56, R57, R58, R70, R71, R72, R89, R91, R93, R106, R107, R108, R120, R121, R122: 470; 1206
RB1, RB2, RB4, RB6: 470; 1206
S24, S31, S34, S35: ENCODER-RGB-SWITCH-NO_NUT; ENCODER_LED_3
S32, S33: B3F-1000
S_12, S_22: B3F-1000

Connections:
3V3: CDEC_1.1, CDEC_2.1, CDEC_3.1, CDEC_4.1, CDEC_5.1, CDEC_6.1, CDEC_7.1, CDEC_8.1, CDEC_9.1, CDEC_10.1, CDEC_11.1, CDEC_11A.+, CDEC_11B.1, CDEC_12.1, CDEC_12A.+, CDEC_12B.1, CDEC_13.1, CONN_STH_BRD_2.2, CONN_STH_BRD_2.4, ENC_11.5 (+), ENC_13.5 (+), ENC_14.5 (+), ENC_21.5 (+), ENC_23.5 (+), LED1.2 (+), LED2.2 (+), LED6.2 (+), LED22.2 (+), MCP_000.9 (VDD), MCP_001.9 (VDD), MCP_001.15 (A0), PIXEL_11.8 (VCC), PIXEL_12.8 (VCC), PIXEL_13.8 (VCC), PIXEL_14.8 (VCC), PIXEL_21.8 (VCC), PIXEL_22.8 (VCC), PIXEL_23.8 (VCC), PIXEL_24.8 (VCC), PIXEL_31.8 (VCC), PIXEL_32.8 (VCC), PIXEL_33.8 (VCC), PIXEL_34.8 (VCC), PIXEL_35.8 (VCC), R4.2, R5.2, R186.2, R187.2, S24.5 (+), S31.5 (+), S34.5 (+), S35.5 (+); also elsewhere on the board
DATA_PIXEL11: PIXEL_11.5 (SDO), PIXEL_21.6 (SDI)
DATA_PIXEL12: PIXEL_11.6 (SDI), PIXEL_12.5 (SDO)
DATA_PIXEL13: PIXEL_12.6 (SDI), PIXEL_13.5 (SDO)
DATA_PIXEL14: PIXEL_13.6 (SDI), PIXEL_14.5 (SDO)
DATA_PIXEL21: PIXEL_21.5 (SDO), PIXEL_22.6 (SDI)
DATA_PIXEL22: PIXEL_22.5 (SDO), PIXEL_23.6 (SDI)
DATA_PIXEL23: PIXEL_23.5 (SDO), PIXEL_24.6 (SDI)
DATA_PIXEL24: PIXEL_24.5 (SDO), PIXEL_35.6 (SDI)
DATA_PIXEL32: PIXEL_31.6 (SDI), PIXEL_32.5 (SDO)
DATA_PIXEL33: PIXEL_32.6 (SDI), PIXEL_33.5 (SDO)
DATA_PIXEL34: PIXEL_33.6 (SDI), PIXEL_34.5 (SDO)
DATA_PIXEL35: PIXEL_34.6 (SDI), PIXEL_35.5 (SDO)
GND: C4.1, C5.1, C6.2, C7.1, C8.1, C9.2, C10.1, C11.1, C12.2, C16.1, C17.1, C18.2, C22.1, C23.1, C24.2, C28.1, C29.1, C30.2, C34.1, C35.1, C36.2, C40.1, C41.1, C42.2, C46.1, C47.1, C48.2, CB1.1, CB2.1, CB4.1, CB6.1, CDEC_1.2, CDEC_2.2, CDEC_3.2, CDEC_4.2, CDEC_5.2, CDEC_6.2, CDEC_7.2, CDEC_8.2, CDEC_9.2, CDEC_10.2, CDEC_11.2, CDEC_11A.-, CDEC_11B.2, CDEC_12.2, CDEC_12A.-, CDEC_12B.2, CDEC_13.2, CONN_STH_BRD_2.1, ENC_11.C, ENC_13.C, ENC_14.C, ENC_21.C, ENC_23.C, MCP_000.10 (VSS), MCP_000.15 (A0), MCP_000.16 (A1), MCP_000.17 (A2), MCP_001.10 (VSS), MCP_001.16 (A1), MCP_001.17 (A2), PIXEL_11.4 (GND), PIXEL_12.4 (GND), PIXEL_13.4 (GND), PIXEL_14.4 (GND), PIXEL_21.4 (GND), PIXEL_22.4 (GND), PIXEL_23.4 (GND), PIXEL_24.4 (GND), PIXEL_31.4 (GND), PIXEL_32.4 (GND), PIXEL_33.4 (GND), PIXEL_34.4 (GND), PIXEL_35.4 (GND), R13.2, R20.2, R27.2, R41.2, R55.2, R69.2, R88.2, R105.2, R119.2, S24.C, S31.C, S32.1, S32.2, S33.1, S33.2, S34.C, S35.C, S_12.1, S_12.2, S_22.1, S_22.2; also elsewhere on the board
GPA0_11: MCP_000.21 (GPA0), R71.1, S24.B
GPA0_12: MCP_001.21 (GPA0), R121.1, S35.B
GPA1_11: MCP_000.22 (GPA1), R70.1, S24.A
GPA1_12: MCP_001.22 (GPA1), R119.1, R122.1, S35.3 (SW)
GPA2_11: MCP_000.23 (GPA2), R69.1, R72.1, S24.3 (SW)
GPA2_12: MCP_001.23 (GPA2), R120.1, S35.A
GPA3_11: ENC_23.A, MCP_000.24 (GPA3), R56.1
GPA3_12: MCP_001.24 (GPA3), R107.1, S34.B
GPA4_11: ENC_23.B, MCP_000.25 (GPA4), R57.1
GPA4_12: MCP_001.25 (GPA4), R106.1, S34.A
GPA5_11: ENC_23.3 (SW), MCP_000.26 (GPA5), R55.1, R58.1
GPA5_12: MCP_001.26 (GPA5), R105.1, R108.1, S34.3 (SW)
GPA6_11: ENC_11.3 (SW), MCP_000.27 (GPA6), R13.1, R16.1
GPA6_12: MCP_001.27 (GPA6), RB6.1, S33.3, S33.4
GPA7_11: MCP_000.28 (GPA7), RB2.1, S_12.3, S_12.4
GPA7_12: MCP_001.28 (GPA7), RB1.1, S32.3, S32.4
GPB0_11: ENC_11.A, MCP_000.1 (GPB0), R14.1
GPB1_11: ENC_11.B, MCP_000.2 (GPB1), R15.1
GPB1_12: MCP_001.2 (GPB1), R91.1, S31.B
GPB2_11: ENC_13.A, MCP_000.3 (GPB2), R21.1
GPB2_12: MCP_001.3 (GPB2), R88.1, R93.1, S31.3 (SW)
GPB3_11: ENC_13.B, MCP_000.4 (GPB3), R22.1
GPB3_12: MCP_001.4 (GPB3), R89.1, S31.A
GPB4_11: ENC_13.3 (SW), MCP_000.5 (GPB4), R20.1, R23.1
GPB4_12: ENC_21.3 (SW), MCP_001.5 (GPB4), R41.1, R44.1
GPB5_11: ENC_14.3 (SW), MCP_000.6 (GPB5), R27.1, R30.1
GPB5_12: ENC_21.A, MCP_001.6 (GPB5), R42.1
GPB6_11: ENC_14.A, MCP_000.7 (GPB6), R28.1
GPB6_12: ENC_21.B, MCP_001.7 (GPB6), R43.1
GPB7_11: ENC_14.B, MCP_000.8 (GPB7), R29.1
GPB7_12: MCP_001.8 (GPB7), RB4.1, S_22.3, S_22.4
I2C2_SCL: CONN_STH_BRD_2.20; also elsewhere on the board
I2C2_SDA: CONN_STH_BRD_2.5; also elsewhere on the board
I2C3_SCL: CONN_STH_BRD_2.12, MCP_000.12 (SCL), MCP_001.12 (SCL), R4.1, R186.1; also elsewhere on the board
I2C3_SDA: CONN_STH_BRD_2.11, MCP_000.13 (SDA), MCP_001.13 (SDA), R5.1, R187.1; also elsewhere on the board
INTA_2: CONN_STH_BRD_2.13; also elsewhere on the board
INTA_11: CONN_STH_BRD_2.8, MCP_000.20 (INTA)
INTA_12: CONN_STH_BRD_2.9, MCP_001.20 (INTA)
INTA_31: CONN_STH_BRD_2.18; also elsewhere on the board
INTA_32: CONN_STH_BRD_2.15; also elsewhere on the board
INTB_2: CONN_STH_BRD_2.14; also elsewhere on the board
INTB_11: CONN_STH_BRD_2.7, MCP_000.19 (INTB)
INTB_12: CONN_STH_BRD_2.10, MCP_001.19 (INTB)
INTB_31: CONN_STH_BRD_2.17; also elsewhere on the board
INTB_32: CONN_STH_BRD_2.16; also elsewhere on the board
unnamed: PIXEL_32.1 (OUT0), R3.1
unnamed: PIXEL_32.2 (OUT1), R6.1
unnamed: ENC_11.1 (-R), R10.2
unnamed: ENC_11.2 (-G), R11.2
unnamed: ENC_11.4 (-B), R12.2
unnamed: PIXEL_11.1 (OUT0), R10.1
unnamed: PIXEL_11.2 (OUT1), R11.1
unnamed: PIXEL_11.3 (OUT2), R12.1
unnamed: C4.2, R14.2
unnamed: C5.2, R15.2
unnamed: C6.1, R16.2
unnamed: ENC_13.1 (-R), R17.2
unnamed: ENC_13.2 (-G), R18.2
unnamed: ENC_13.4 (-B), R19.2
unnamed: PIXEL_13.1 (OUT0), R17.1
unnamed: PIXEL_13.2 (OUT1), R18.1
unnamed: PIXEL_13.3 (OUT2), R19.1
unnamed: C7.2, R21.2
unnamed: C8.2, R22.2
unnamed: C9.1, R23.2
unnamed: ENC_14.1 (-R), R24.2
unnamed: ENC_14.2 (-G), R25.2
unnamed: ENC_14.4 (-B), R26.2
unnamed: PIXEL_14.1 (OUT0), R24.1
unnamed: PIXEL_14.2 (OUT1), R25.1
unnamed: PIXEL_14.3 (OUT2), R26.1
unnamed: C10.2, R28.2
unnamed: C11.2, R29.2
unnamed: C12.1, R30.2
unnamed: PIXEL_32.3 (OUT2), R7.1
unnamed: CB1.2, RB1.2
unnamed: LED1.1 (R), R7.2
unnamed: LED1.4 (B), R6.2
unnamed: LED1.3 (G), R3.2
unnamed: PIXEL_12.1 (OUT0), R8.1
unnamed: PIXEL_12.2 (OUT1), R9.1
unnamed: PIXEL_12.3 (OUT2), R31.1
unnamed: CB2.2, RB2.2
unnamed: ENC_21.1 (-R), R38.2
unnamed: ENC_21.2 (-G), R39.2
unnamed: ENC_21.4 (-B), R40.2
unnamed: PIXEL_21.1 (OUT0), R38.1
unnamed: PIXEL_21.2 (OUT1), R39.1
unnamed: PIXEL_21.3 (OUT2), R40.1
unnamed: C16.2, R42.2
unnamed: C17.2, R43.2
unnamed: C18.1, R44.2
unnamed: LED2.1 (R), R31.2
unnamed: LED2.4 (B), R9.2
unnamed: LED2.3 (G), R8.2
unnamed: ENC_23.1 (-R), R52.2
unnamed: ENC_23.2 (-G), R53.2
unnamed: ENC_23.4 (-B), R54.2
unnamed: PIXEL_23.1 (OUT0), R52.1
unnamed: PIXEL_23.2 (OUT1), R53.1
unnamed: PIXEL_23.3 (OUT2), R54.1
unnamed: C22.2, R56.2
unnamed: C23.2, R57.2
unnamed: C24.1, R58.2
unnamed: PIXEL_22.1 (OUT0), R35.1
unnamed: PIXEL_22.2 (OUT1), R36.1
unnamed: PIXEL_22.3 (OUT2), R37.1
unnamed: CB4.2, RB4.2
unnamed: LED22.1 (R), R37.2
unnamed: LED22.4 (B), R36.2
unnamed: LED22.3 (G), R35.2
unnamed: R66.2, S24.1 (-R)
unnamed: R67.2, S24.2 (-G)
unnamed: R68.2, S24.4 (-B)
unnamed: PIXEL_24.1 (OUT0), R66.1
unnamed: PIXEL_24.2 (OUT1), R67.1
unnamed: PIXEL_24.3 (OUT2), R68.1
unnamed: C28.2, R70.2
unnamed: C29.2, R71.2
unnamed: C30.1, R72.2
unnamed: R82.2, S31.1 (-R)
unnamed: R84.2, S31.2 (-G)
unnamed: R85.2, S31.4 (-B)
unnamed: PIXEL_31.1 (OUT0), R82.1
unnamed: PIXEL_31.2 (OUT1), R84.1
unnamed: PIXEL_31.3 (OUT2), R85.1
unnamed: C34.2, R89.2
unnamed: C35.2, R91.2
unnamed: C36.1, R93.2
unnamed: PIXEL_33.1 (OUT0), R48.1
unnamed: PIXEL_33.2 (OUT1), R49.1
unnamed: PIXEL_33.3 (OUT2), R50.1
unnamed: CB6.2, RB6.2
unnamed: LED6.1 (R), R50.2
unnamed: LED6.4 (B), R49.2
unnamed: LED6.3 (G), R48.2
unnamed: R102.2, S34.1 (-R)
unnamed: R103.2, S34.2 (-G)
unnamed: R104.2, S34.4 (-B)
unnamed: PIXEL_34.1 (OUT0), R102.1
unnamed: PIXEL_34.2 (OUT1), R103.1
unnamed: PIXEL_34.3 (OUT2), R104.1
unnamed: C40.2, R106.2
unnamed: C41.2, R107.2
unnamed: C42.1, R108.2
unnamed: R116.2, S35.1 (-R)
unnamed: R117.2, S35.2 (-G)
unnamed: R118.2, S35.4 (-B)
unnamed: PIXEL_35.1 (OUT0), R116.1
unnamed: PIXEL_35.2 (OUT1), R117.1
unnamed: PIXEL_35.3 (OUT2), R118.1
unnamed: C46.2, R120.2
unnamed: C47.2, R121.2
unnamed: C48.1, R122.2
PIXEL42: PIXEL_14.6 (SDI); also elsewhere on the board
RST: CONN_STH_BRD_2.3, MCP_000.18 (!RESET), MCP_001.18 (!RESET); also elsewhere on the board
SPI1_MOSI: CONN_STH_BRD_2.6; also elsewhere on the board
SPI3_MOSI: CONN_STH_BRD_2.19; also elsewhere on the board

Notes on the sheet:
RGB ENCODER 11
RGB ENCODER 13
RGB ENCODER 14
RGB ENCODER 21
RGB ENCODER 23
RGB ENCODER 24
RGB ENCODER 31
RGB ENCODER 34
RGB ENCODER 35
OSCILLATORS
SWITCH RGB 12
SWITCH RGB 22
SWITCH RGB 33
SWITCH RGB 32
MCP 11 & 12
