reynal/themis/front-pane/eagle-schematics/v3/STM32F446 front pane - v3.1.brd

## EAGLE design front-pane/eagle-schematics/v3/STM32F446 front pane - v3.1.brd (continued)

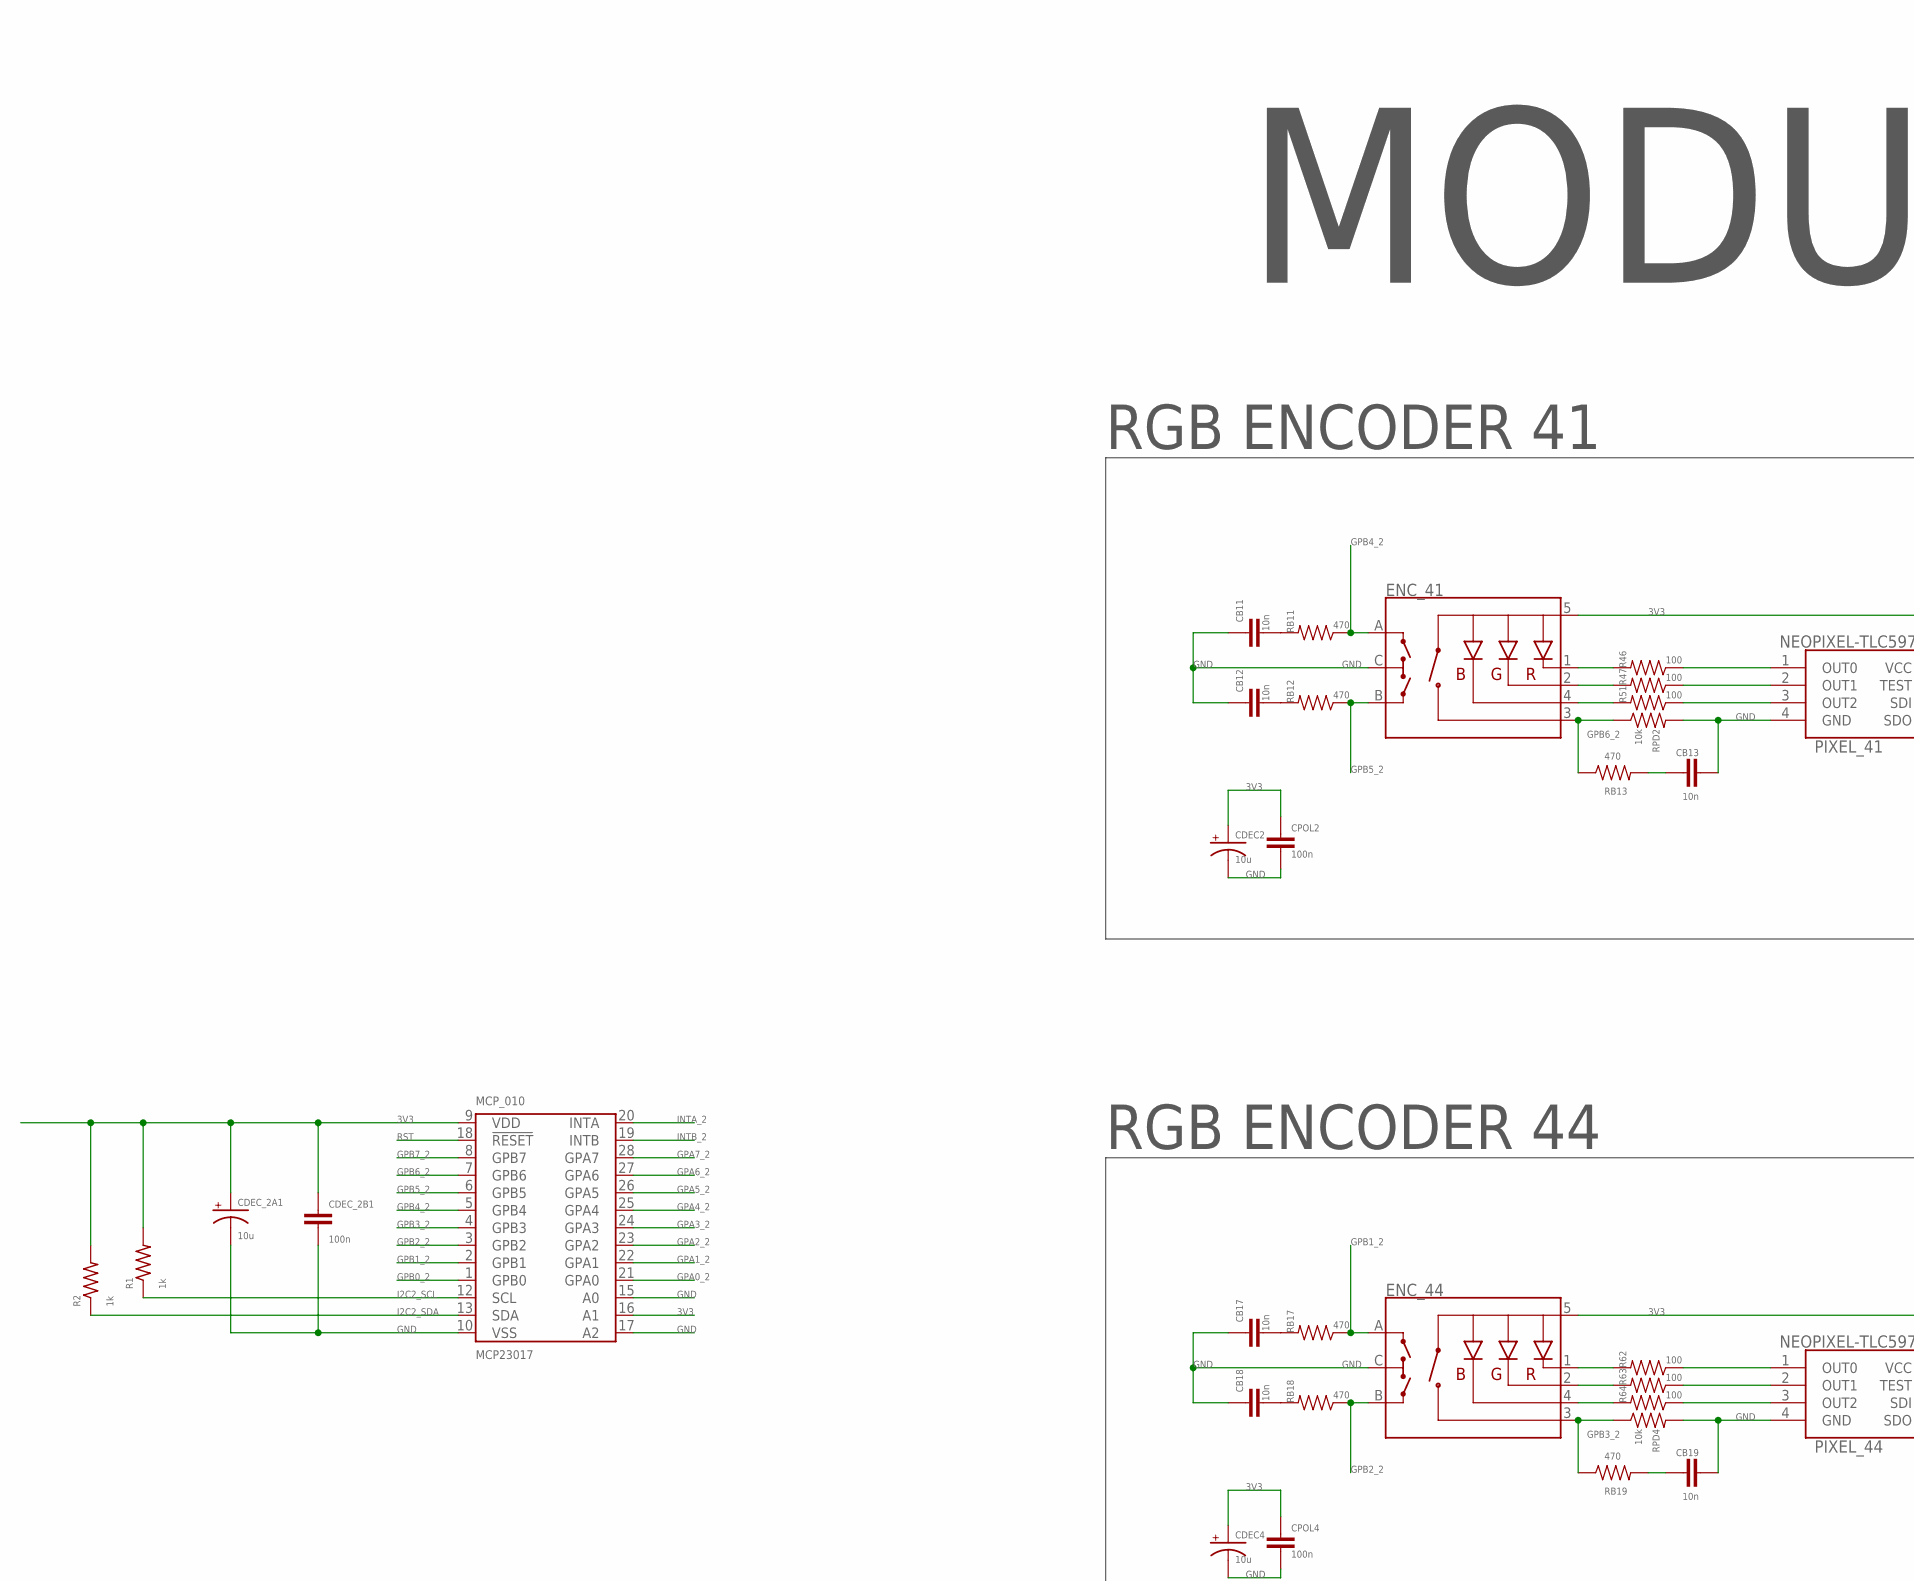
[picture p183: schematic STM32F446 front pane - v3.1.sch, sheet 3, part in row 1, column 1]

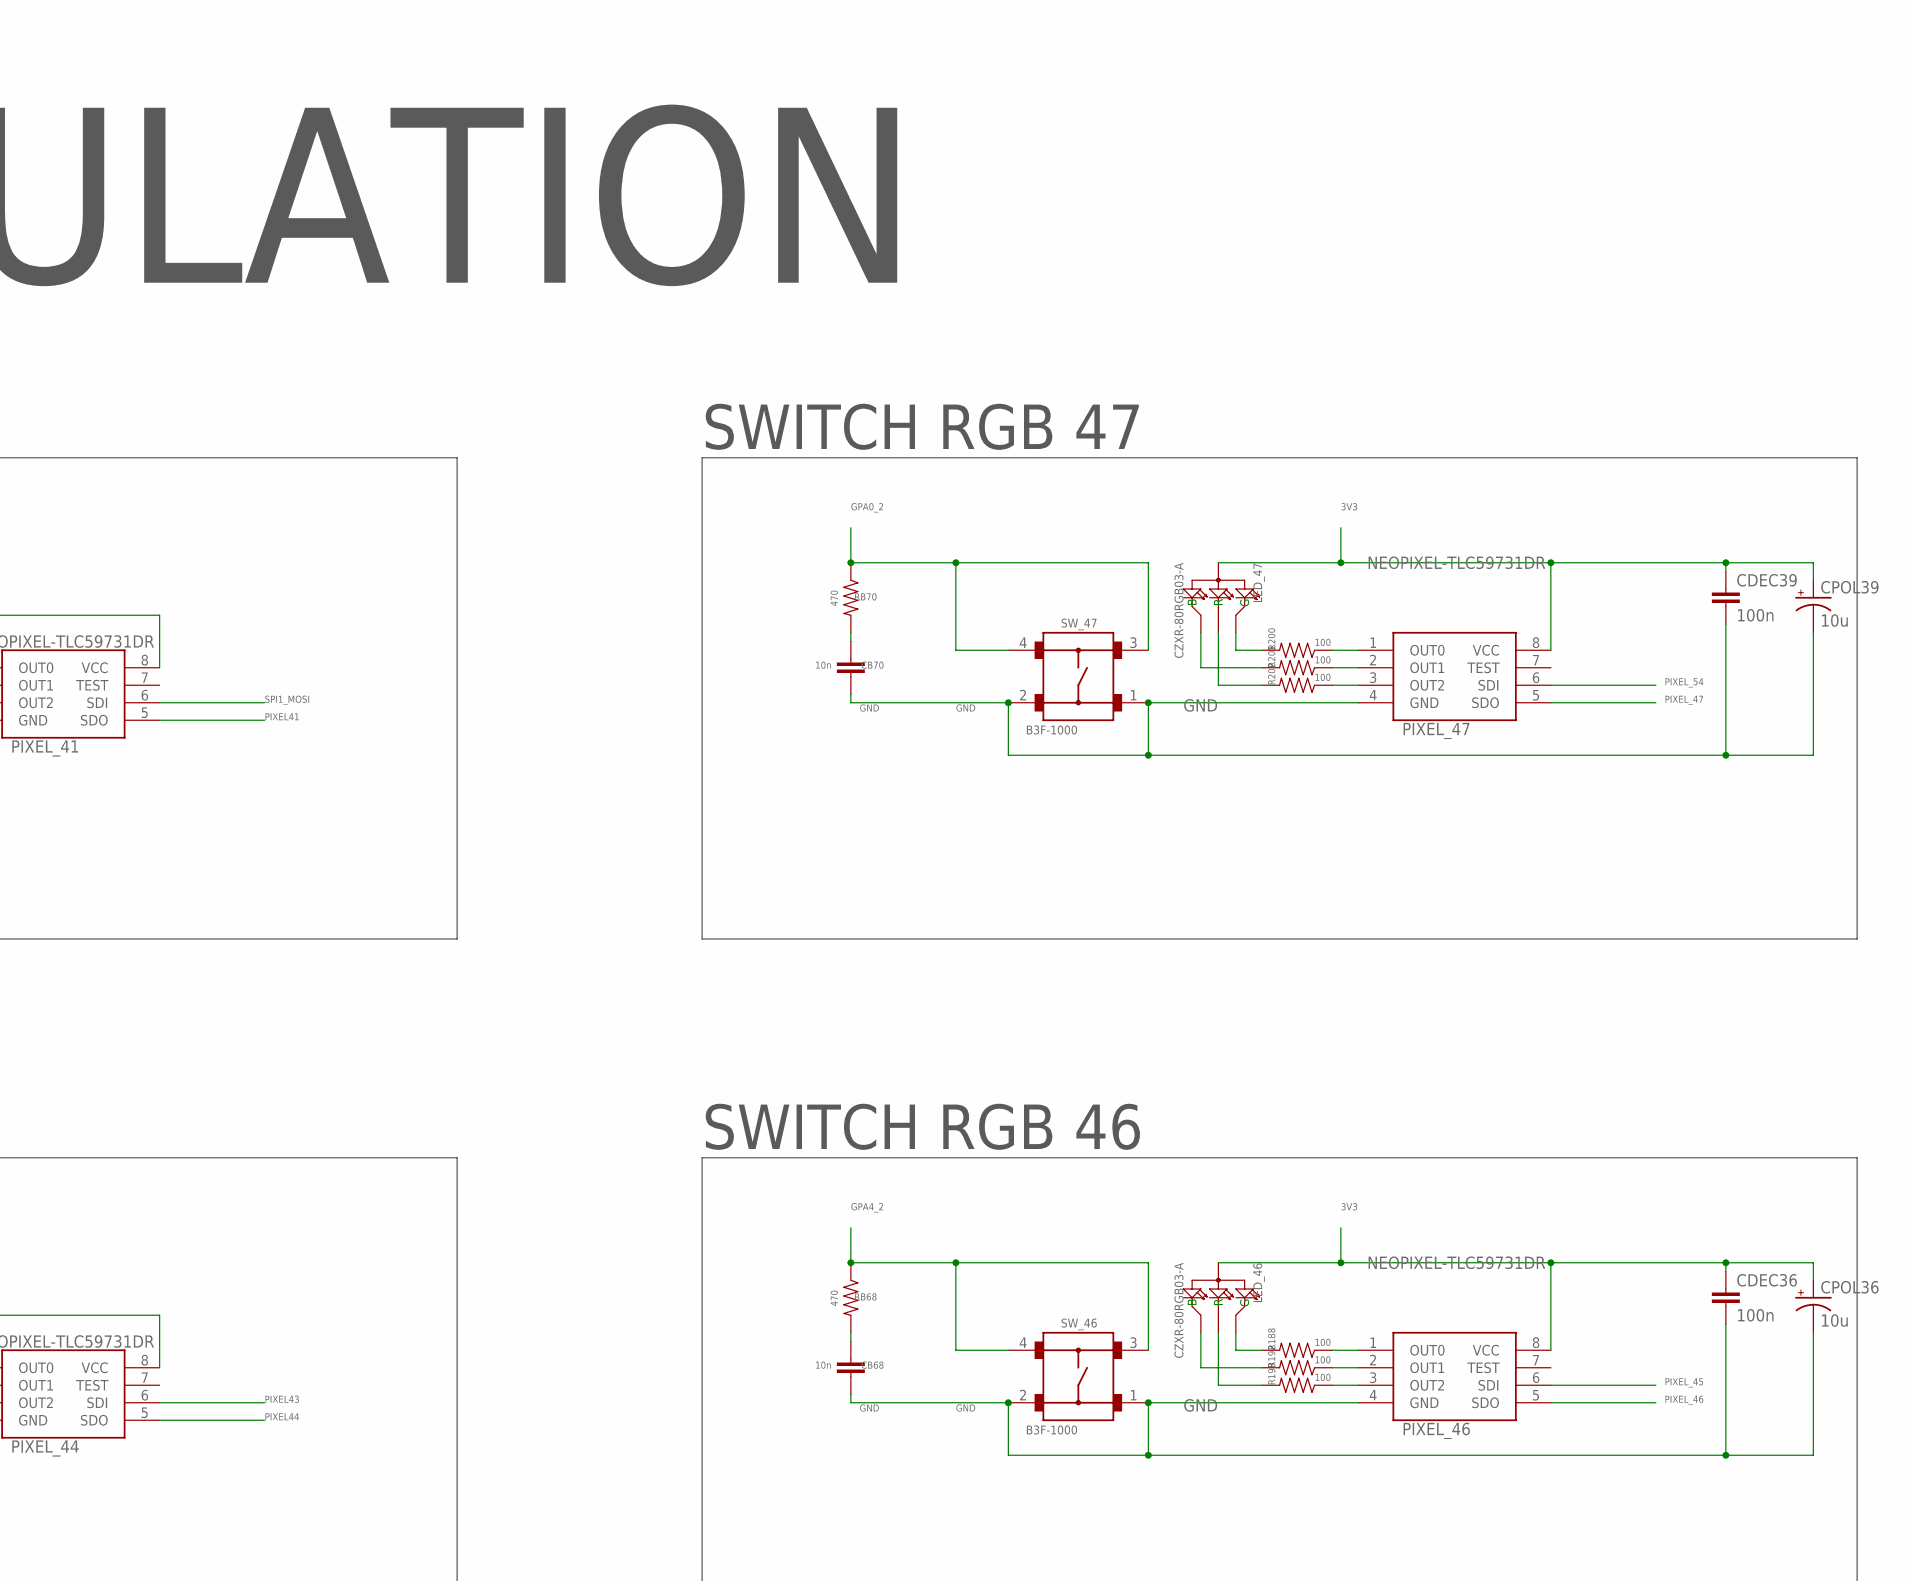
[picture p184: schematic STM32F446 front pane - v3.1.sch, sheet 3, part in row 1, column 2]

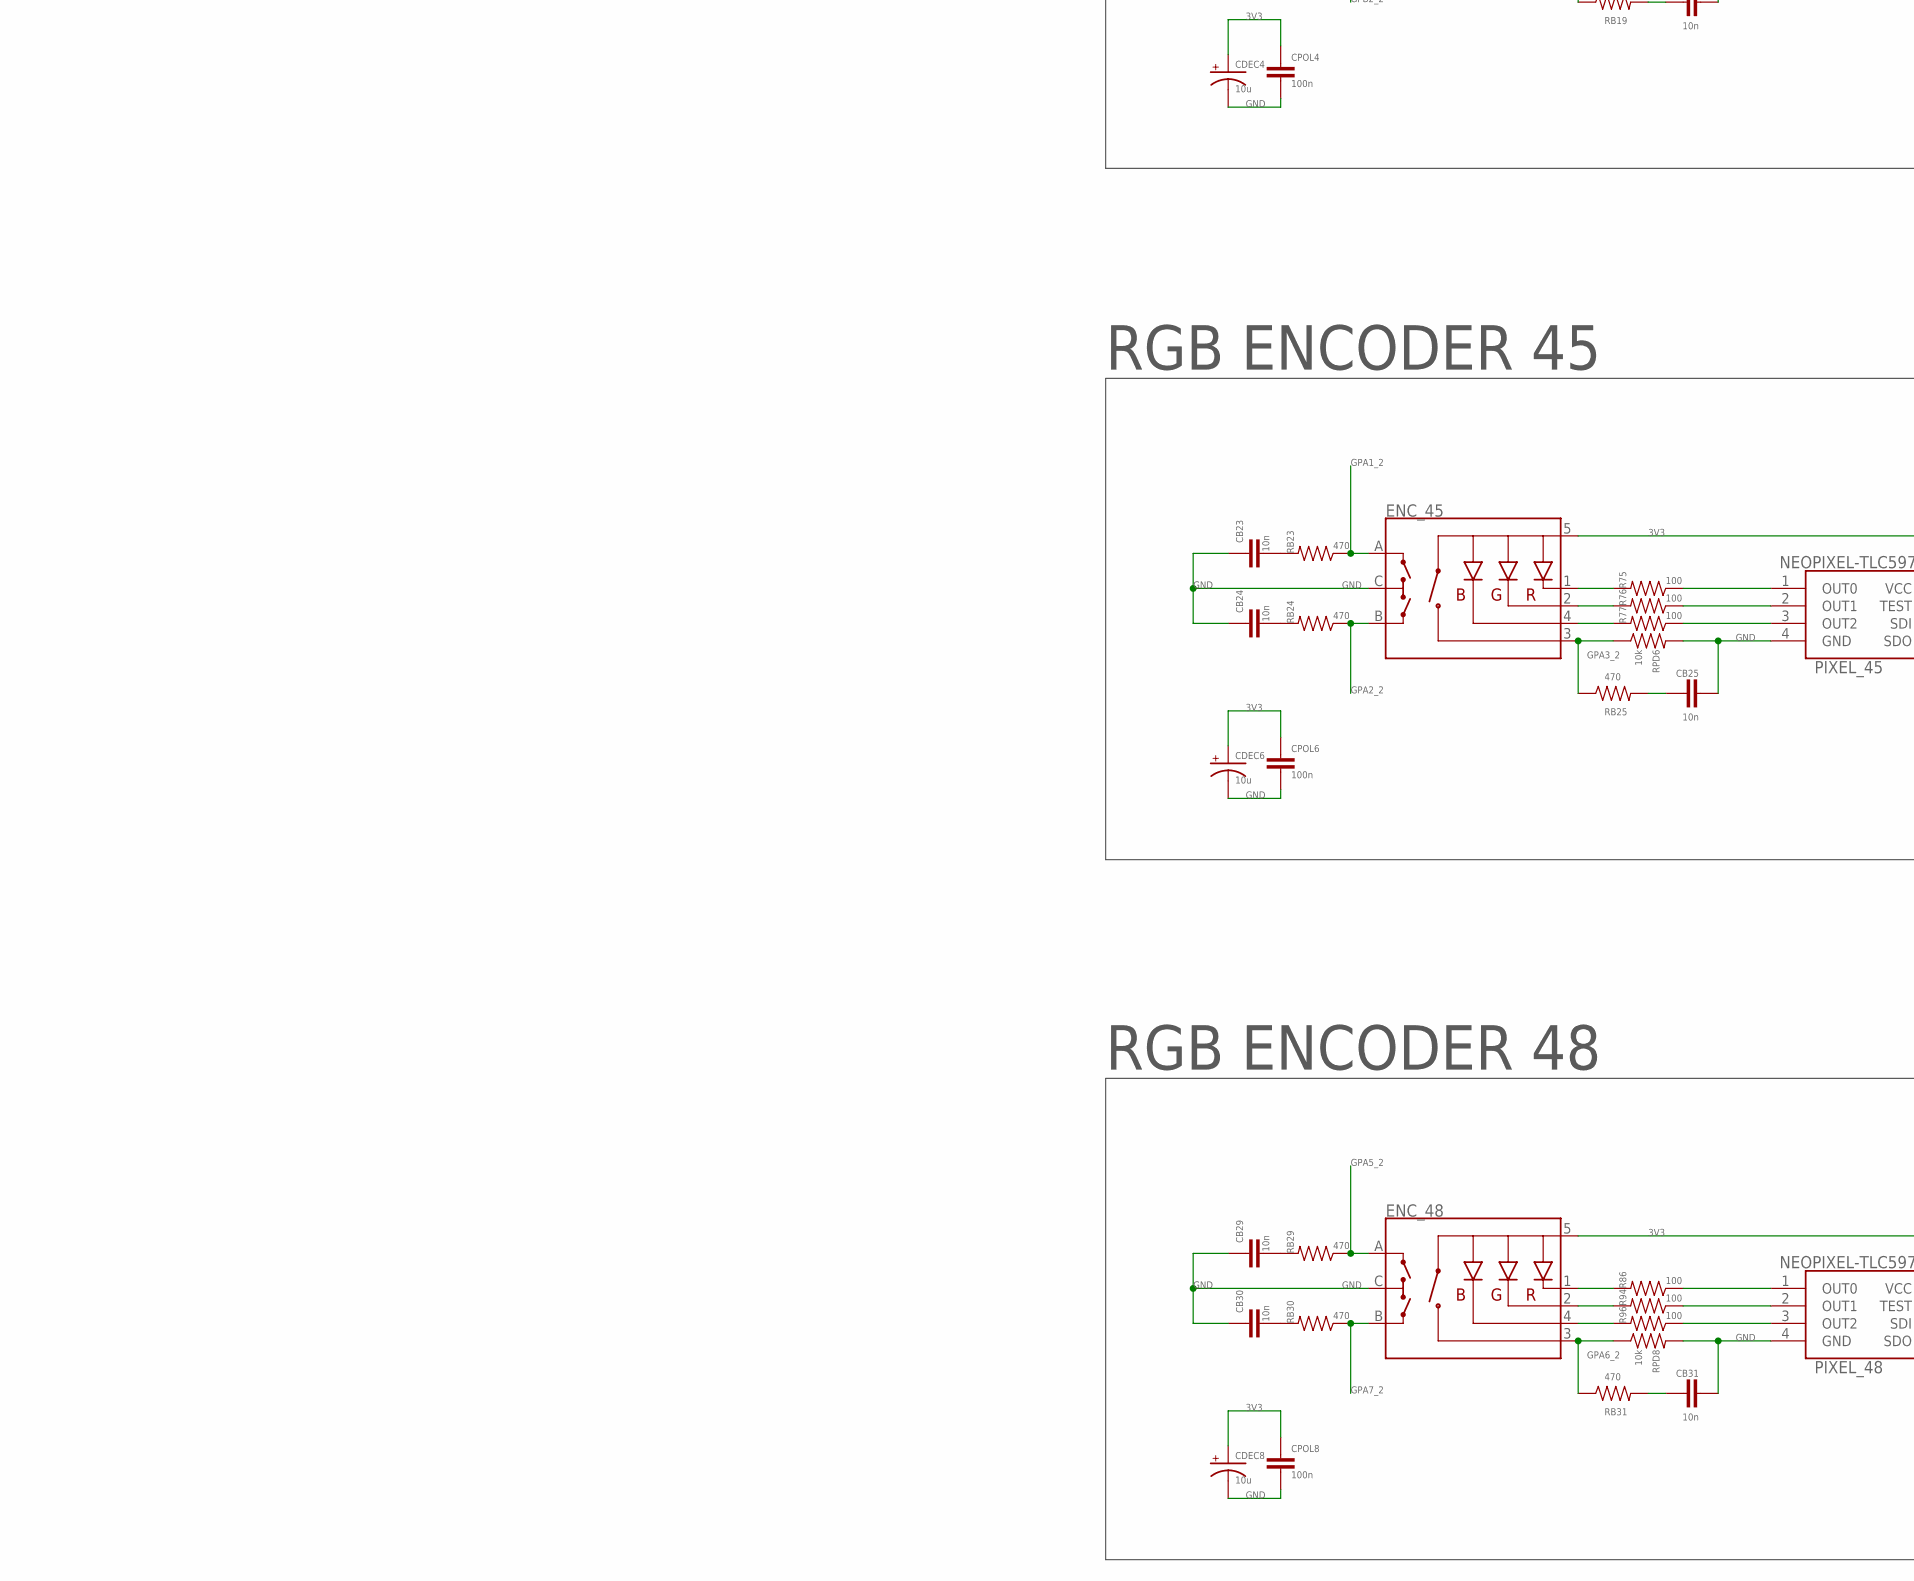
[picture p185: schematic STM32F446 front pane - v3.1.sch, sheet 3, part in row 2, column 1]

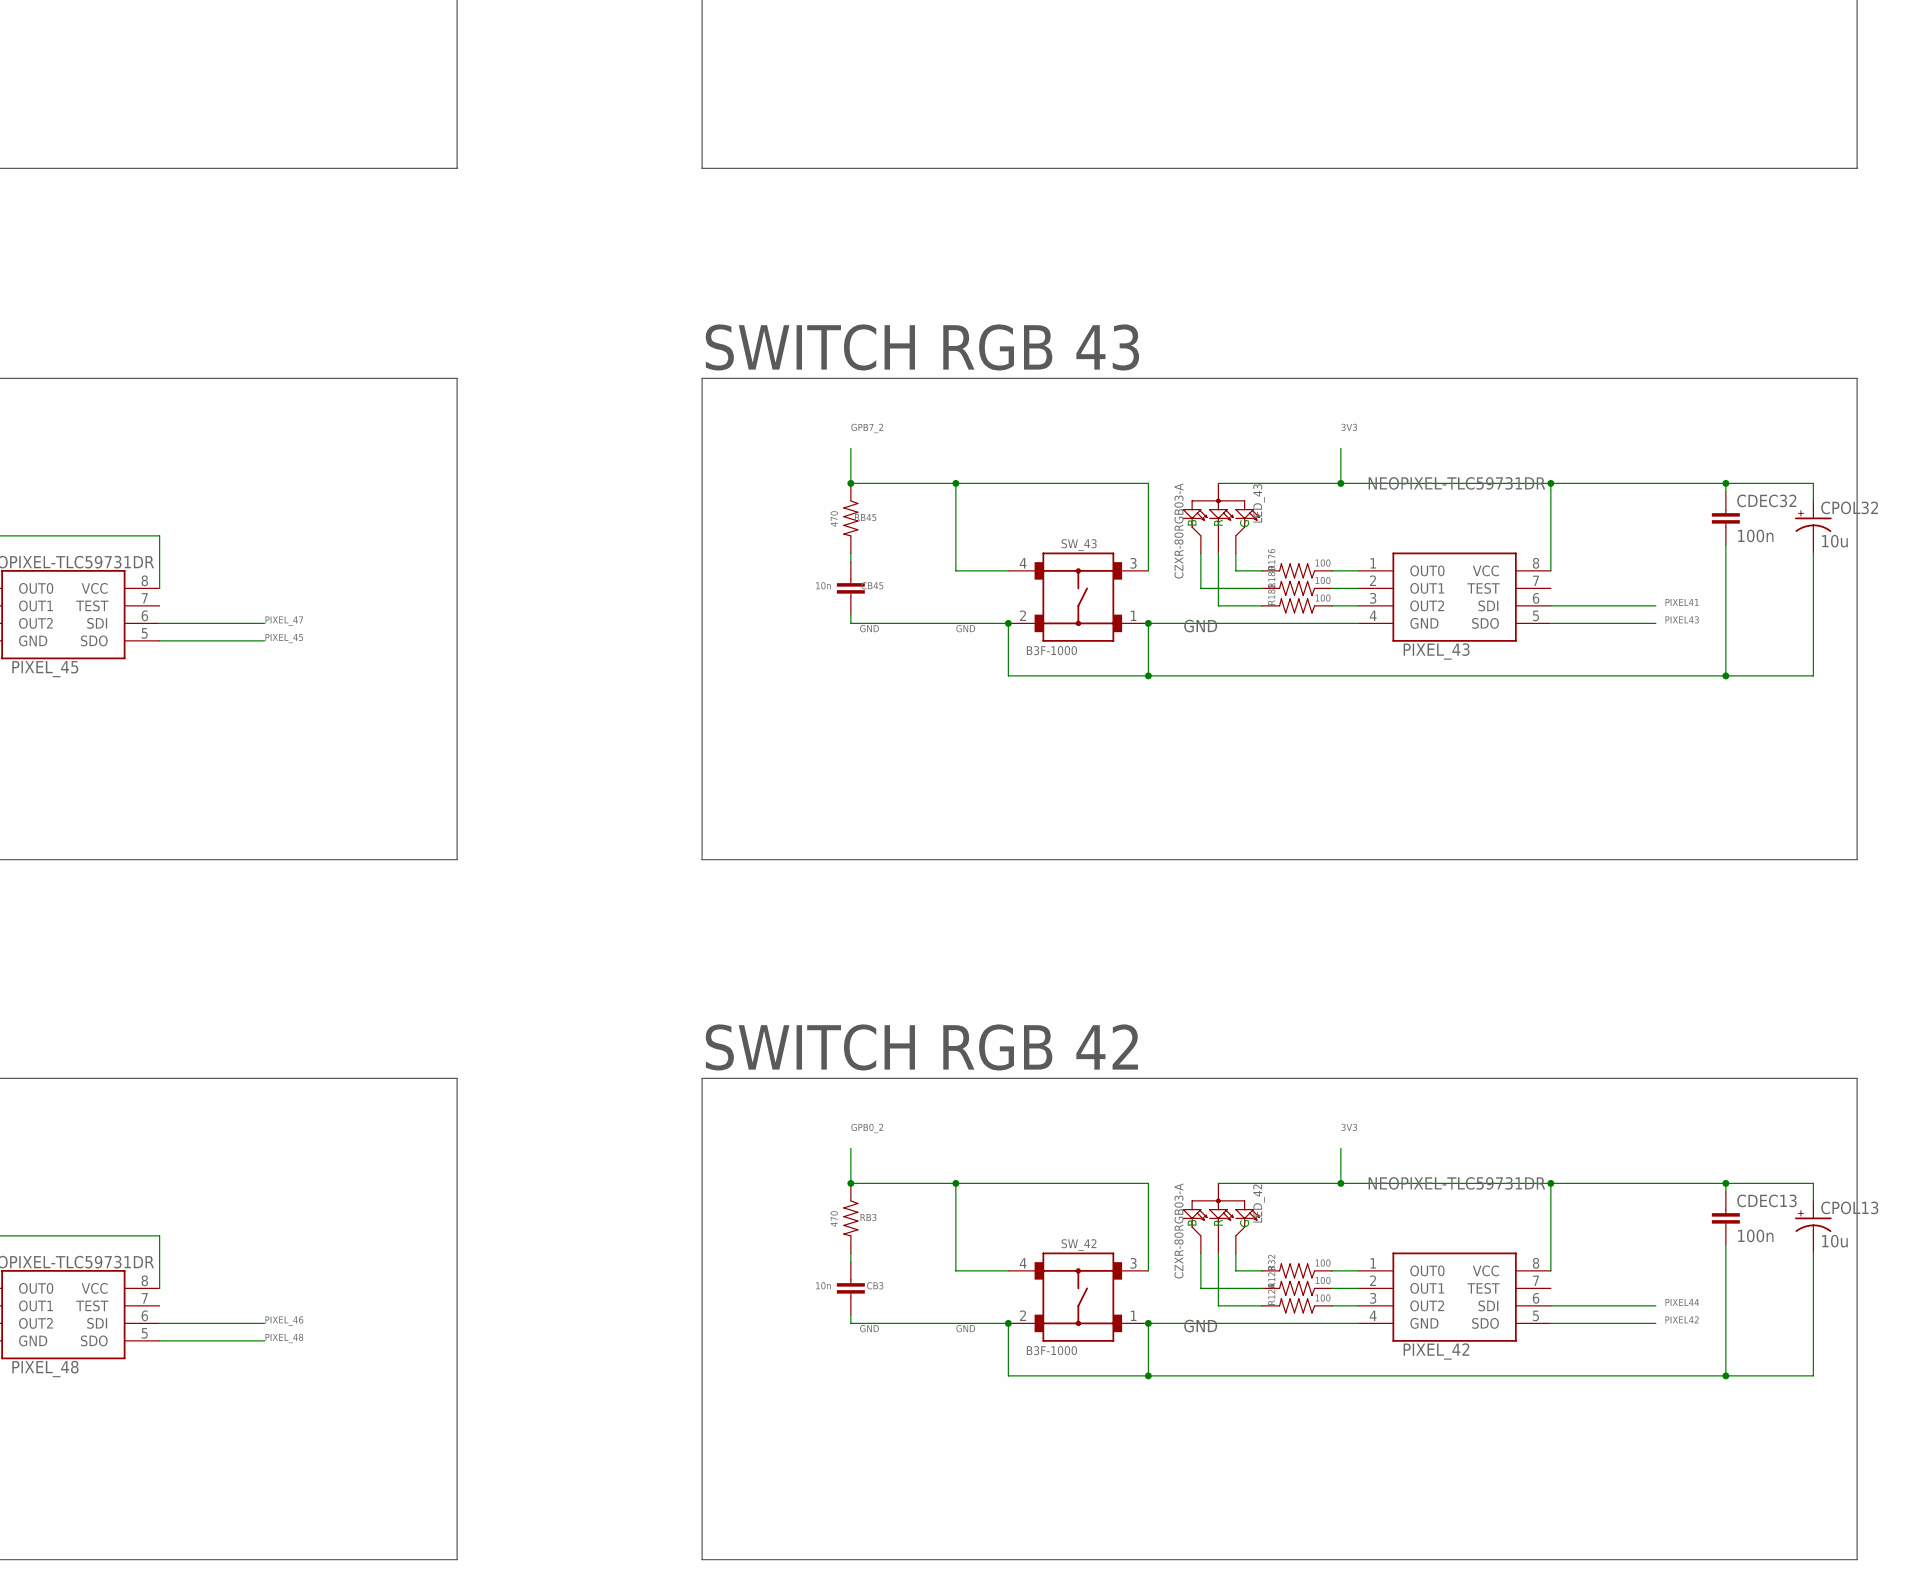
[picture p186: schematic STM32F446 front pane - v3.1.sch, sheet 3, part in row 2, column 2]

Parts:
CB3, CB11, CB12, CB13, CB17, CB18, CB19, CB23, CB24, CB25, CB29, CB30, CB31, CB45, CB68, CB70: 10n; 0805-CAP
CDEC2, CDEC4, CDEC6, CDEC8: 10u; CPOL2917
CDEC13, CDEC32, CDEC36, CDEC39: 100n; 0805-CAP
CDEC_2A1: 10u; CPOL2917
CDEC_2B1: 100n; 0805-CAP
CPOL2, CPOL4, CPOL6, CPOL8: 100n; 0805-CAP
CPOL13, CPOL32, CPOL36, CPOL39: 10u; CPOL2917
ENC_41, ENC_44, ENC_45, ENC_48: ENCODER-RGB-SWITCH-NO_NUT; ENCODER_LED_3
LED_42, LED_43, LED_46, LED_47: CZXR-80RGB03-A; LED4-2.0-D8.0MM
MCP_010: MCP23017; SOIC-28
PIXEL_41, PIXEL_42, PIXEL_43, PIXEL_44, PIXEL_45, PIXEL_46, PIXEL_47, PIXEL_48: NEOPIXEL-TLC59731DR; SOIC127P600X175-8N
R1, R2: 1k; R0805
R32, R46, R47, R51, R62, R63, R64, R75, R76, R77, R86, R94, R96, R123, R124, R176, R180, R181, R188, R192, R193, R200, R201, R202: 100; 1206
RB3, RB11, RB12, RB13, RB17, RB18, RB19, RB23, RB24, RB25, RB29, RB30, RB31, RB45, RB68, RB70: 470; 1206
RPD2, RPD4, RPD6, RPD8: 10k; 1206
SW_42, SW_43, SW_46, SW_47: B3F-1000

Connections:
3V3: CDEC2.+, CDEC4.+, CDEC6.+, CDEC8.+, CDEC13.1, CDEC32.1, CDEC36.1, CDEC39.1, CDEC_2A1.+, CDEC_2B1.1, CPOL2.1, CPOL4.1, CPOL6.1, CPOL8.1, CPOL13.+, CPOL32.+, CPOL36.+, CPOL39.+, ENC_41.5 (+), ENC_44.5 (+), ENC_45.5 (+), ENC_48.5 (+), LED_42.2 (+), LED_43.2 (+), LED_46.2 (+), LED_47.2 (+), MCP_010.9 (VDD), MCP_010.16 (A1), PIXEL_41.8 (VCC), PIXEL_42.8 (VCC), PIXEL_43.8 (VCC), PIXEL_44.8 (VCC), PIXEL_45.8 (VCC), PIXEL_46.8 (VCC), PIXEL_47.8 (VCC), PIXEL_48.8 (VCC), R1.2, R2.2; also elsewhere on the board
GND: CB3.1, CB11.1, CB12.1, CB13.2, CB17.1, CB18.1, CB19.2, CB23.1, CB24.1, CB25.2, CB29.1, CB30.1, CB31.2, CB45.1, CB68.1, CB70.1, CDEC2.-, CDEC4.-, CDEC6.-, CDEC8.-, CDEC13.2, CDEC32.2, CDEC36.2, CDEC39.2, CDEC_2A1.-, CDEC_2B1.2, CPOL2.2, CPOL4.2, CPOL6.2, CPOL8.2, CPOL13.-, CPOL32.-, CPOL36.-, CPOL39.-, ENC_41.C, ENC_44.C, ENC_45.C, ENC_48.C, MCP_010.10 (VSS), MCP_010.15 (A0), MCP_010.17 (A2), PIXEL_41.4 (GND), PIXEL_42.4 (GND), PIXEL_43.4 (GND), PIXEL_44.4 (GND), PIXEL_45.4 (GND), PIXEL_46.4 (GND), PIXEL_47.4 (GND), PIXEL_48.4 (GND), RPD2.2, RPD4.2, RPD6.2, RPD8.2, SW_42.1, SW_42.2, SW_43.1, SW_43.2, SW_46.1, SW_46.2, SW_47.1, SW_47.2; also elsewhere on the board
GPA0_2: MCP_010.21 (GPA0), RB70.1, SW_47.3, SW_47.4
GPA1_2: ENC_45.A, MCP_010.22 (GPA1), RB23.1
GPA2_2: ENC_45.B, MCP_010.23 (GPA2), RB24.1
GPA3_2: ENC_45.3 (SW), MCP_010.24 (GPA3), RB25.1, RPD6.1
GPA4_2: MCP_010.25 (GPA4), RB68.1, SW_46.3, SW_46.4
GPA5_2: ENC_48.A, MCP_010.26 (GPA5), RB29.1
GPA6_2: ENC_48.3 (SW), MCP_010.27 (GPA6), RB31.1, RPD8.1
GPA7_2: ENC_48.B, MCP_010.28 (GPA7), RB30.1
GPB0_2: MCP_010.1 (GPB0), RB3.1, SW_42.3, SW_42.4
GPB1_2: ENC_44.A, MCP_010.2 (GPB1), RB17.1
GPB2_2: ENC_44.B, MCP_010.3 (GPB2), RB18.1
GPB3_2: ENC_44.3 (SW), MCP_010.4 (GPB3), RB19.1, RPD4.1
GPB4_2: ENC_41.A, MCP_010.5 (GPB4), RB11.1
GPB5_2: ENC_41.B, MCP_010.6 (GPB5), RB12.1
GPB6_2: ENC_41.3 (SW), MCP_010.7 (GPB6), RB13.1, RPD2.1
GPB7_2: MCP_010.8 (GPB7), RB45.1, SW_43.3, SW_43.4
I2C2_SCL: MCP_010.12 (SCL), R1.1; also elsewhere on the board
I2C2_SDA: MCP_010.13 (SDA), R2.1; also elsewhere on the board
INTA_2: MCP_010.20 (INTA); also elsewhere on the board
INTB_2: MCP_010.19 (INTB); also elsewhere on the board
unnamed: PIXEL_42.1 (OUT0), R32.1
unnamed: PIXEL_42.2 (OUT1), R123.1
unnamed: ENC_41.1 (-R), R46.2
unnamed: ENC_41.2 (-G), R47.2
unnamed: ENC_41.4 (-B), R51.2
unnamed: PIXEL_41.1 (OUT0), R46.1
unnamed: PIXEL_41.2 (OUT1), R47.1
unnamed: PIXEL_41.3 (OUT2), R51.1
unnamed: CB11.2, RB11.2
unnamed: CB12.2, RB12.2
unnamed: CB13.1, RB13.2
unnamed: ENC_44.1 (-R), R62.2
unnamed: ENC_44.2 (-G), R63.2
unnamed: ENC_44.4 (-B), R64.2
unnamed: PIXEL_44.1 (OUT0), R62.1
unnamed: PIXEL_44.2 (OUT1), R63.1
unnamed: PIXEL_44.3 (OUT2), R64.1
unnamed: CB17.2, RB17.2
unnamed: CB18.2, RB18.2
unnamed: CB19.1, RB19.2
unnamed: ENC_45.1 (-R), R75.2
unnamed: ENC_45.2 (-G), R76.2
unnamed: ENC_45.4 (-B), R77.2
unnamed: PIXEL_45.1 (OUT0), R75.1
unnamed: PIXEL_45.2 (OUT1), R76.1
unnamed: PIXEL_45.3 (OUT2), R77.1
unnamed: CB23.2, RB23.2
unnamed: CB24.2, RB24.2
unnamed: CB25.1, RB25.2
unnamed: ENC_48.1 (-R), R86.2
unnamed: ENC_48.2 (-G), R94.2
unnamed: ENC_48.4 (-B), R96.2
unnamed: PIXEL_48.1 (OUT0), R86.1
unnamed: PIXEL_48.2 (OUT1), R94.1
unnamed: PIXEL_48.3 (OUT2), R96.1
unnamed: CB29.2, RB29.2
unnamed: CB30.2, RB30.2
unnamed: CB31.1, RB31.2
unnamed: PIXEL_42.3 (OUT2), R124.1
unnamed: CB3.2, RB3.2
unnamed: LED_42.1 (R), R124.2
unnamed: LED_42.4 (B), R123.2
unnamed: LED_42.3 (G), R32.2
unnamed: PIXEL_43.1 (OUT0), R176.1
unnamed: PIXEL_43.2 (OUT1), R180.1
unnamed: PIXEL_43.3 (OUT2), R181.1
unnamed: CB45.2, RB45.2
unnamed: LED_43.1 (R), R181.2
unnamed: LED_43.4 (B), R180.2
unnamed: LED_43.3 (G), R176.2
unnamed: PIXEL_46.1 (OUT0), R188.1
unnamed: PIXEL_46.2 (OUT1), R192.1
unnamed: PIXEL_46.3 (OUT2), R193.1
unnamed: CB68.2, RB68.2
unnamed: LED_46.1 (R), R193.2
unnamed: LED_46.4 (B), R192.2
unnamed: LED_46.3 (G), R188.2
unnamed: PIXEL_47.1 (OUT0), R200.1
unnamed: PIXEL_47.2 (OUT1), R201.1
unnamed: PIXEL_47.3 (OUT2), R202.1
unnamed: CB70.2, RB70.2
unnamed: LED_47.1 (R), R202.2
unnamed: LED_47.4 (B), R201.2
unnamed: LED_47.3 (G), R200.2
PIXEL41: PIXEL_41.5 (SDO), PIXEL_43.6 (SDI)
PIXEL42: PIXEL_42.5 (SDO); also elsewhere on the board
PIXEL43: PIXEL_43.5 (SDO), PIXEL_44.6 (SDI)
PIXEL44: PIXEL_42.6 (SDI), PIXEL_44.5 (SDO)
PIXEL_45: PIXEL_45.5 (SDO), PIXEL_46.6 (SDI)
PIXEL_46: PIXEL_46.5 (SDO), PIXEL_48.6 (SDI)
PIXEL_47: PIXEL_45.6 (SDI), PIXEL_47.5 (SDO)
PIXEL_48: PIXEL_48.5 (SDO); also elsewhere on the board
PIXEL_54: PIXEL_47.6 (SDI); also elsewhere on the board
RST: MCP_010.18 (!RESET); also elsewhere on the board
SPI1_MOSI: PIXEL_41.6 (SDI); also elsewhere on the board

Notes on the sheet:
MODULATION
RGB ENCODER 41
RGB ENCODER 44
RGB ENCODER 45
RGB ENCODER 48
SWITCH RGB 42
SWITCH RGB 43
SWITCH RGB 46
SWITCH RGB 47
