reynal/themis/front-pane/eagle-schematics/v3/STM32F446 front pane - v3.1.brd

## EAGLE design front-pane/eagle-schematics/v3/STM32F446 front pane - v3.1.brd (continued)

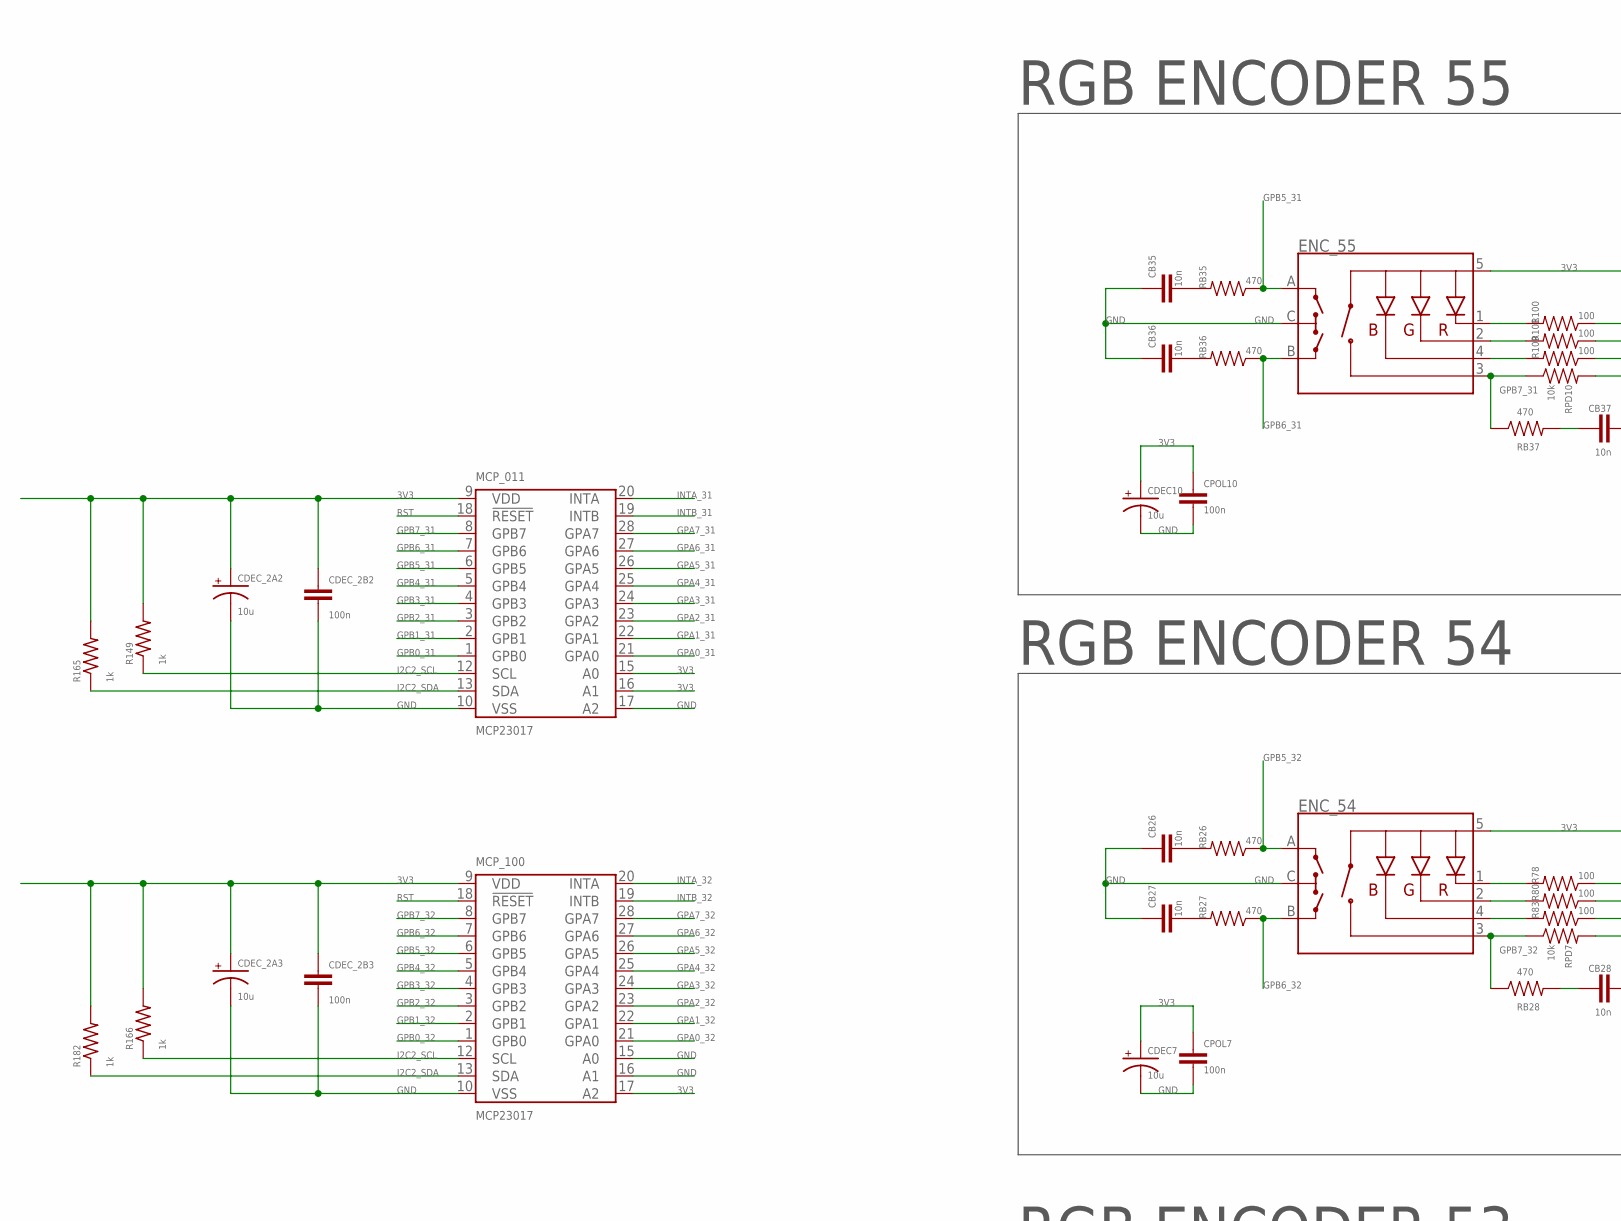
[picture p187: schematic STM32F446 front pane - v3.1.sch, sheet 4, part in row 1, column 1]

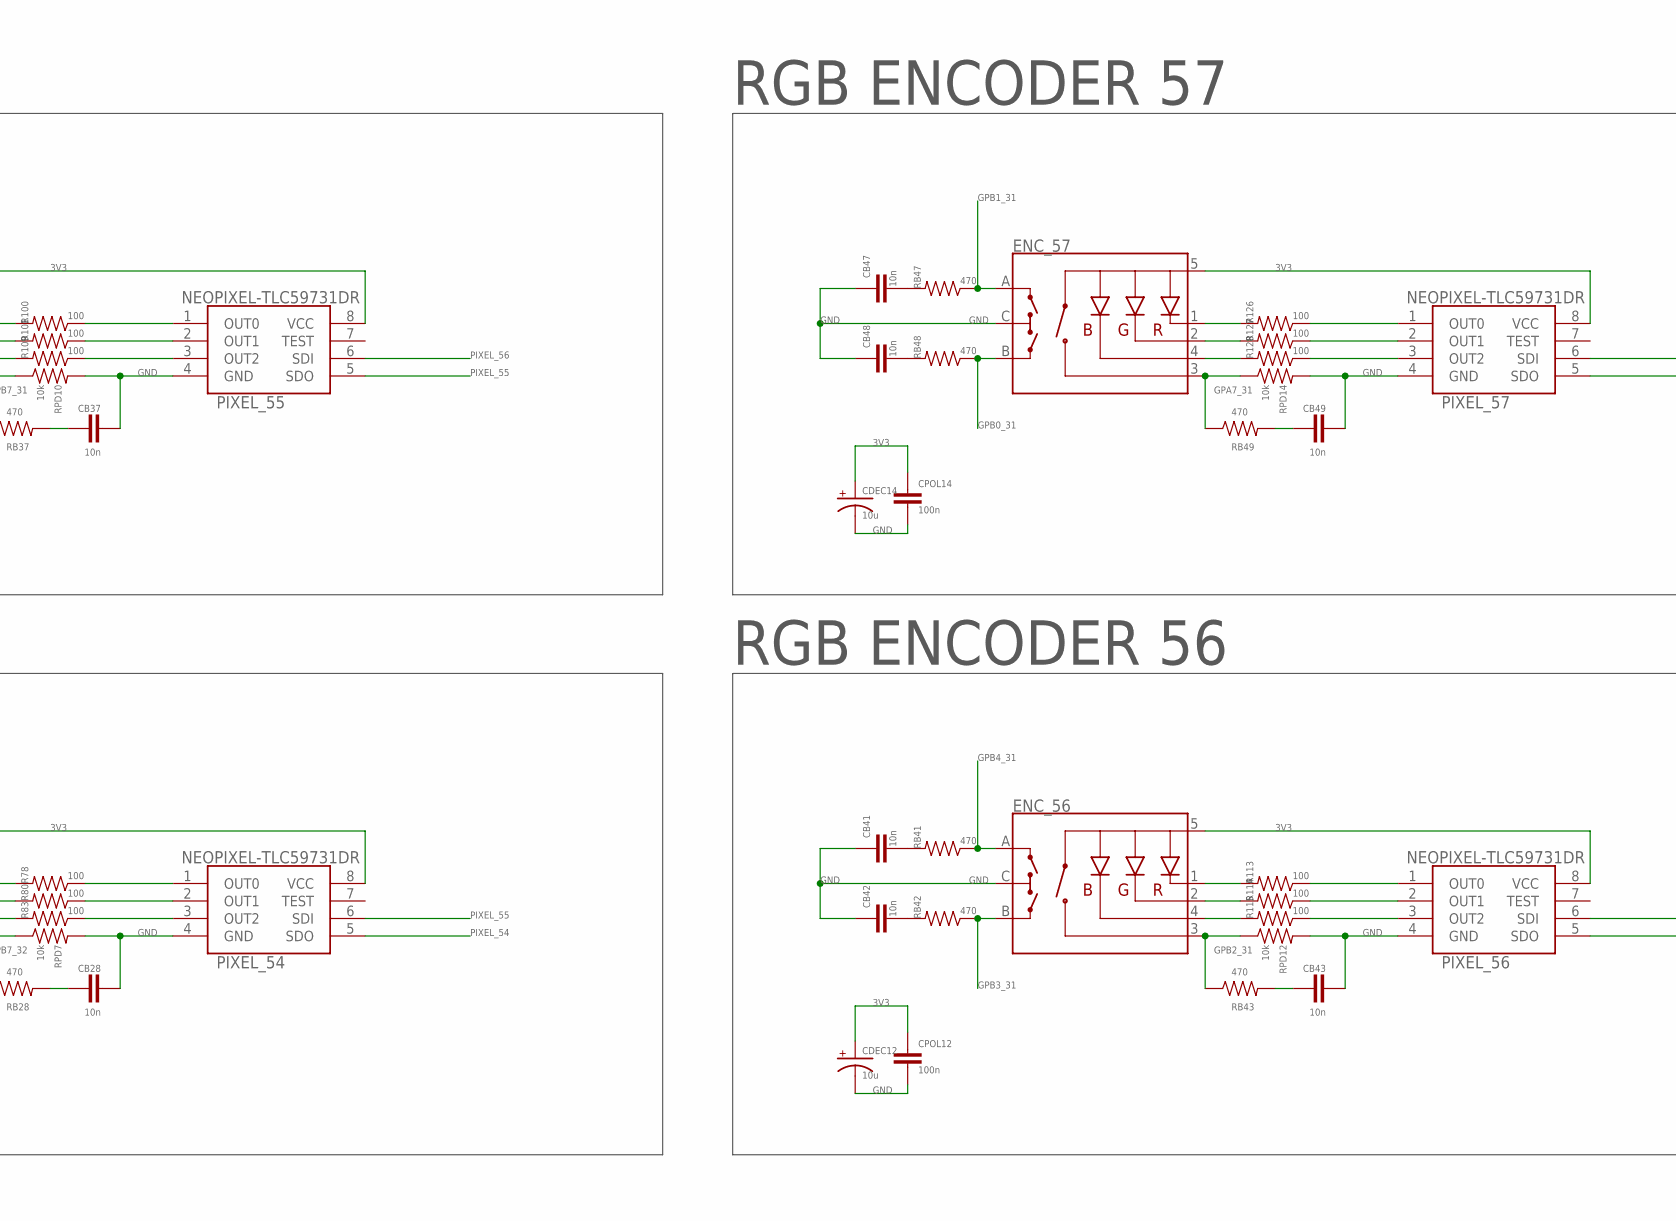
[picture p188: schematic STM32F446 front pane - v3.1.sch, sheet 4, part in row 1, column 2]

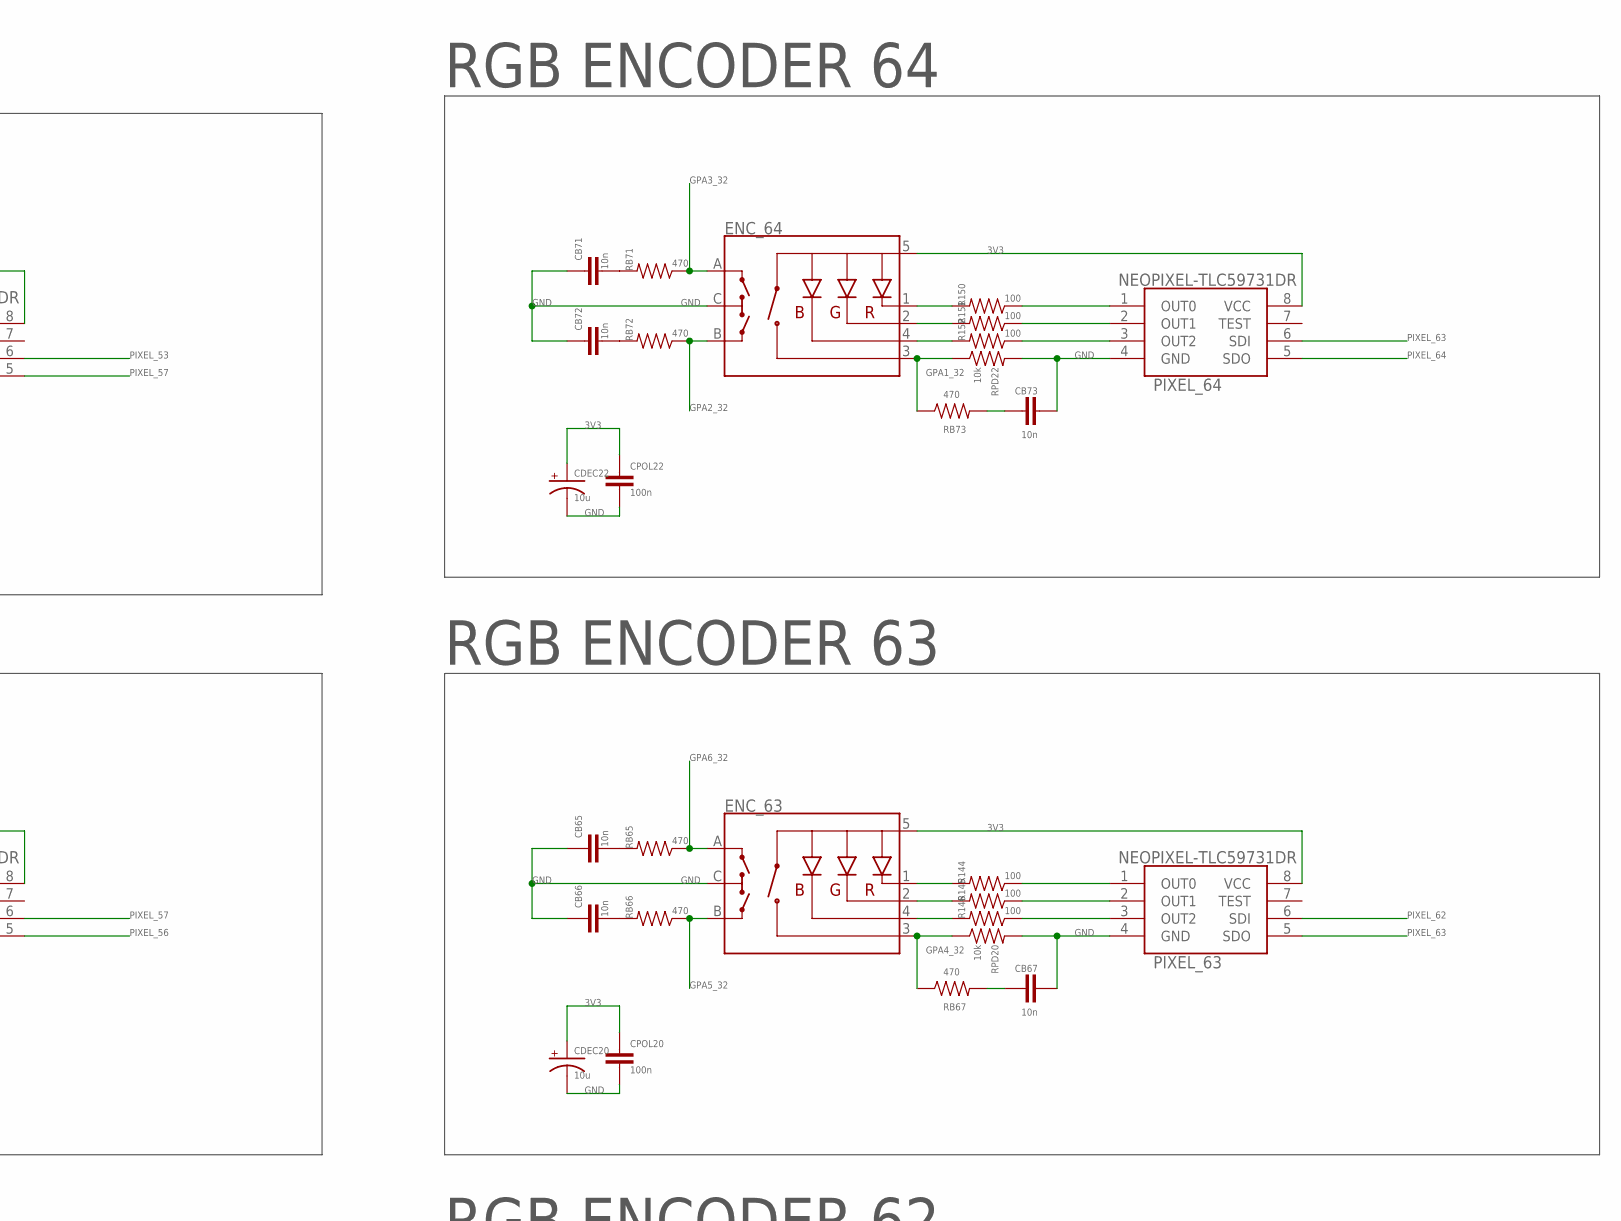
[picture p189: schematic STM32F446 front pane - v3.1.sch, sheet 4, part in row 1, column 3]

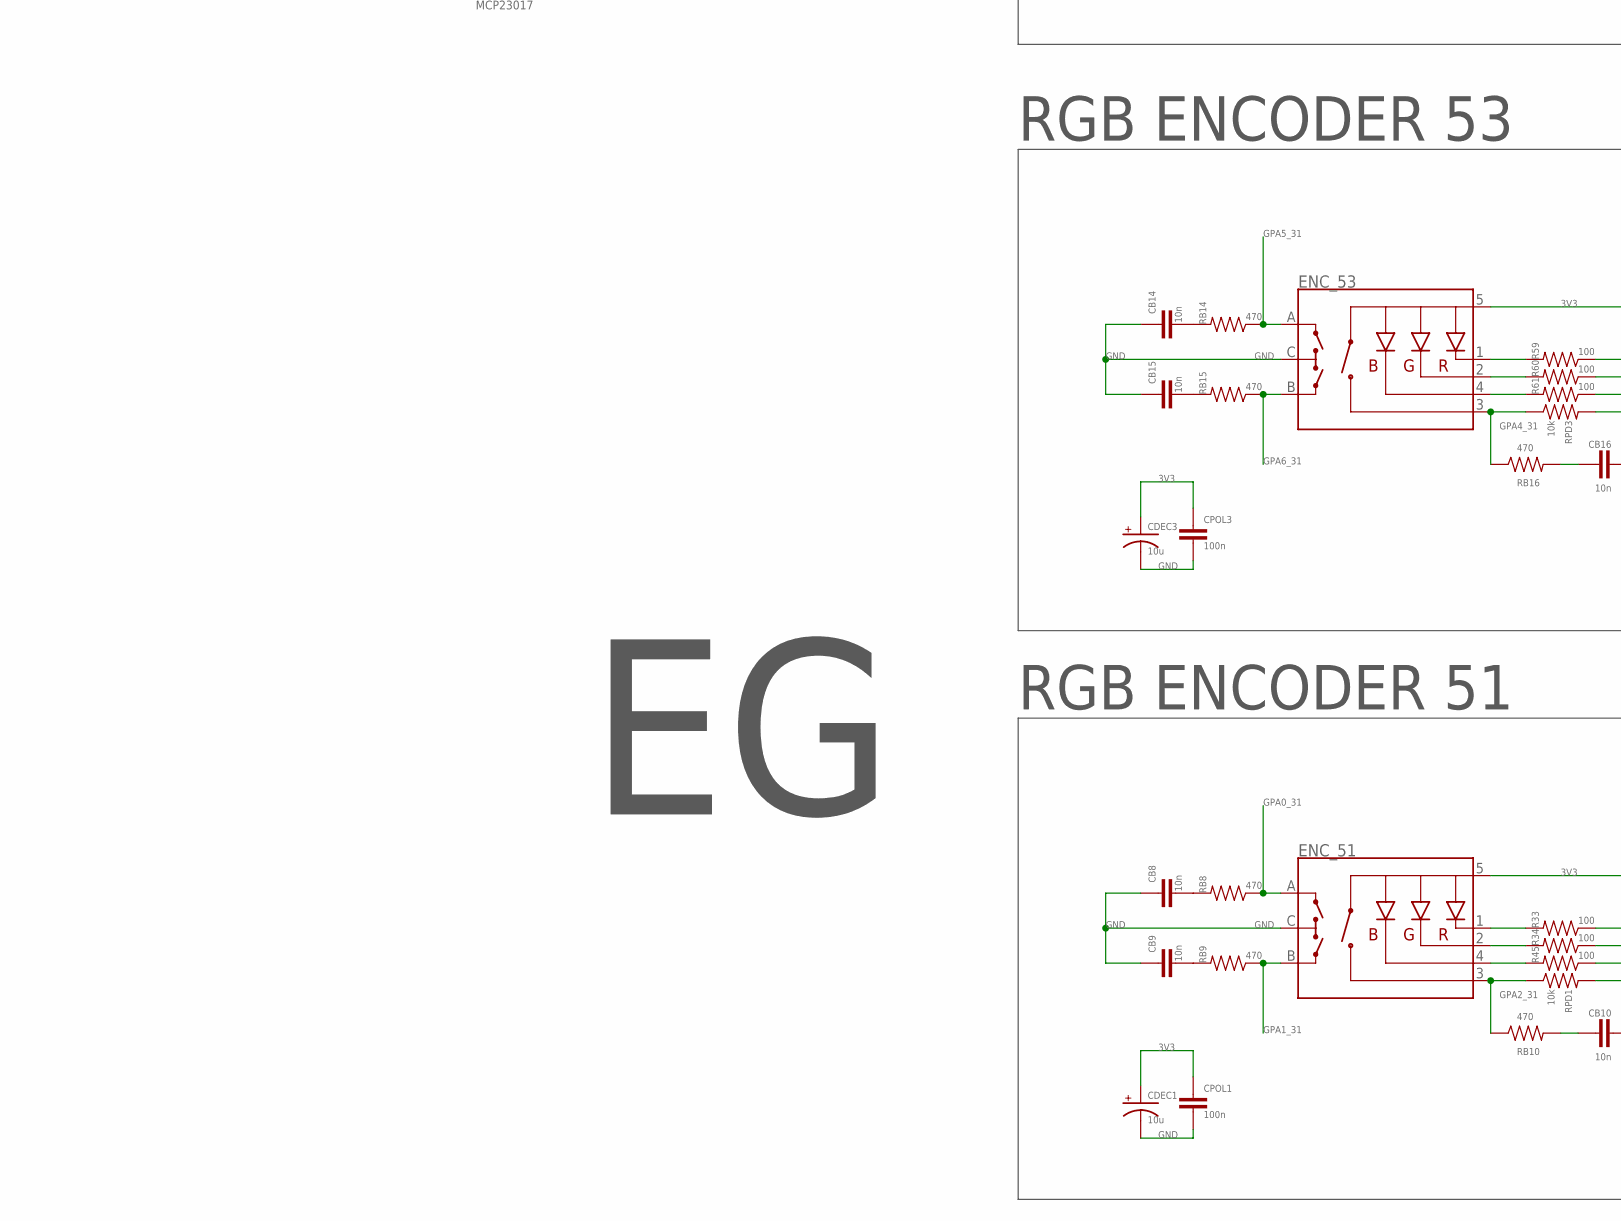
[picture p190: schematic STM32F446 front pane - v3.1.sch, sheet 4, part in row 2, column 1]

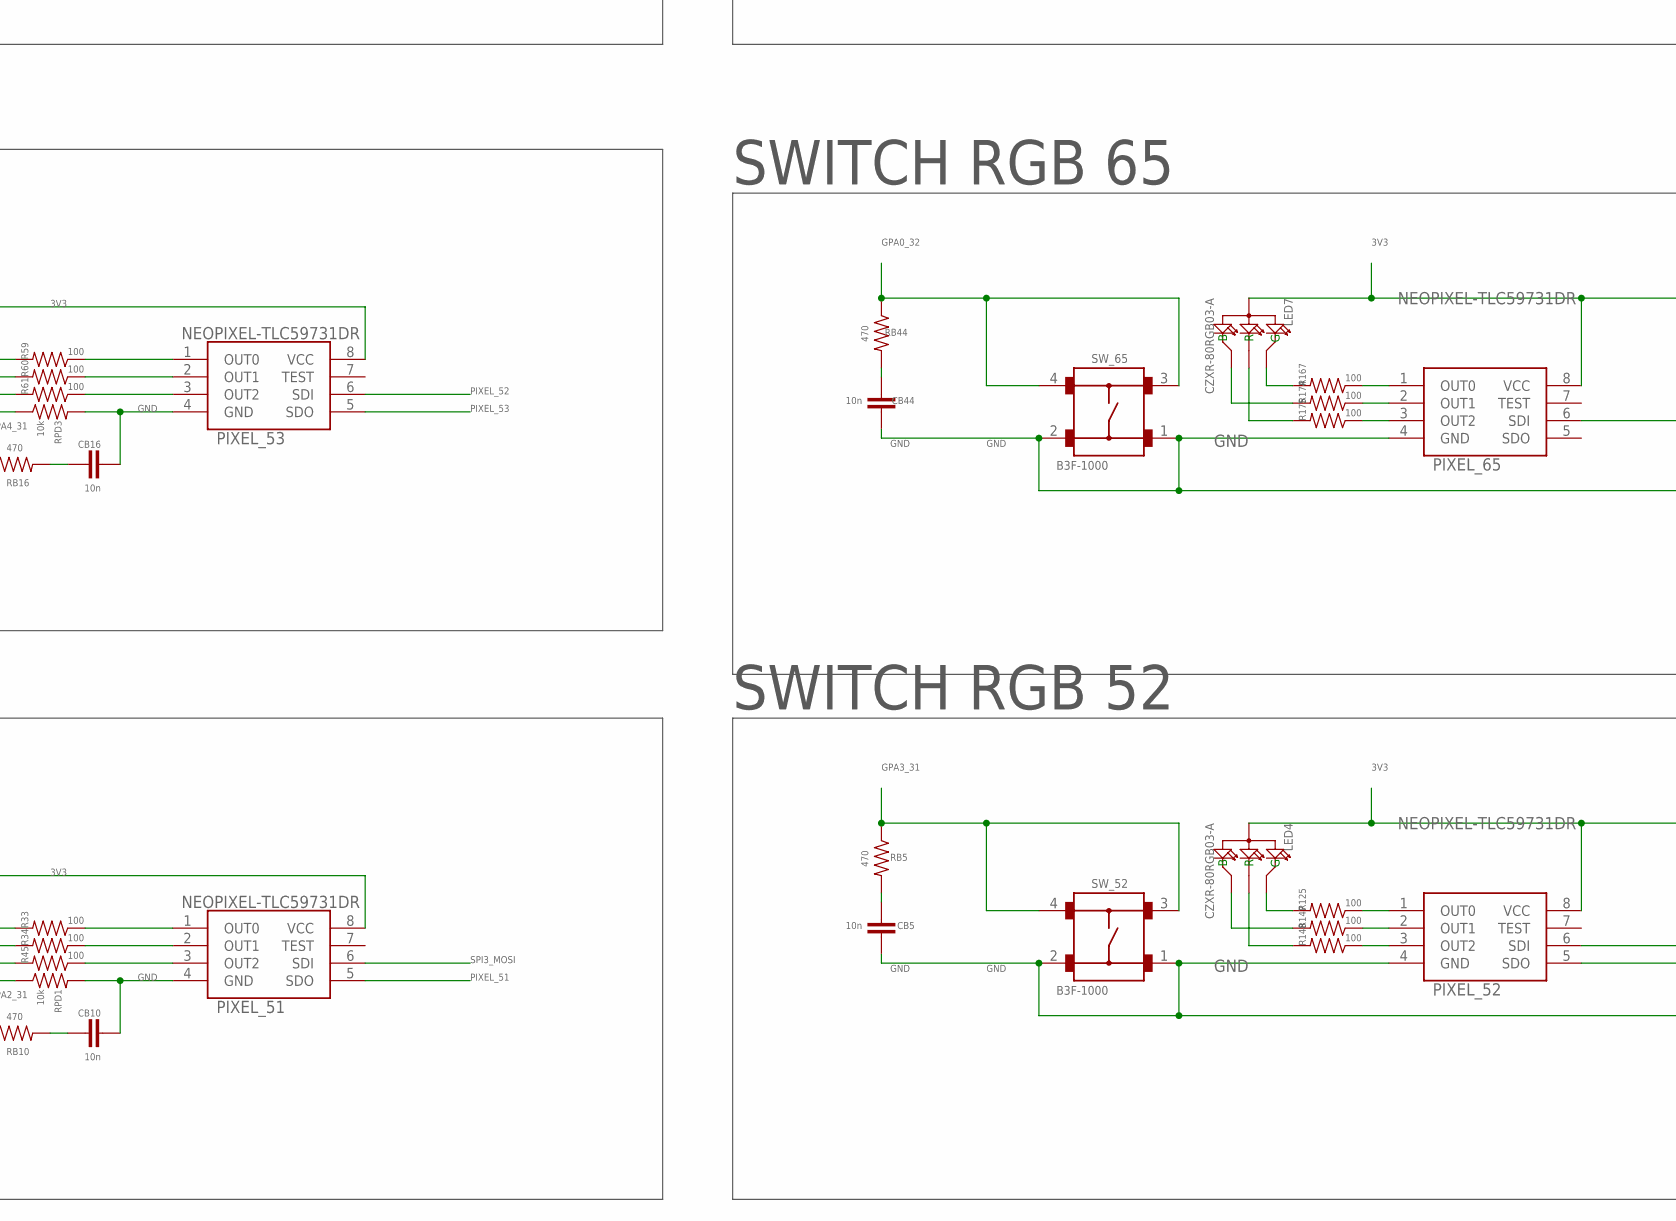
[picture p191: schematic STM32F446 front pane - v3.1.sch, sheet 4, part in row 2, column 2]

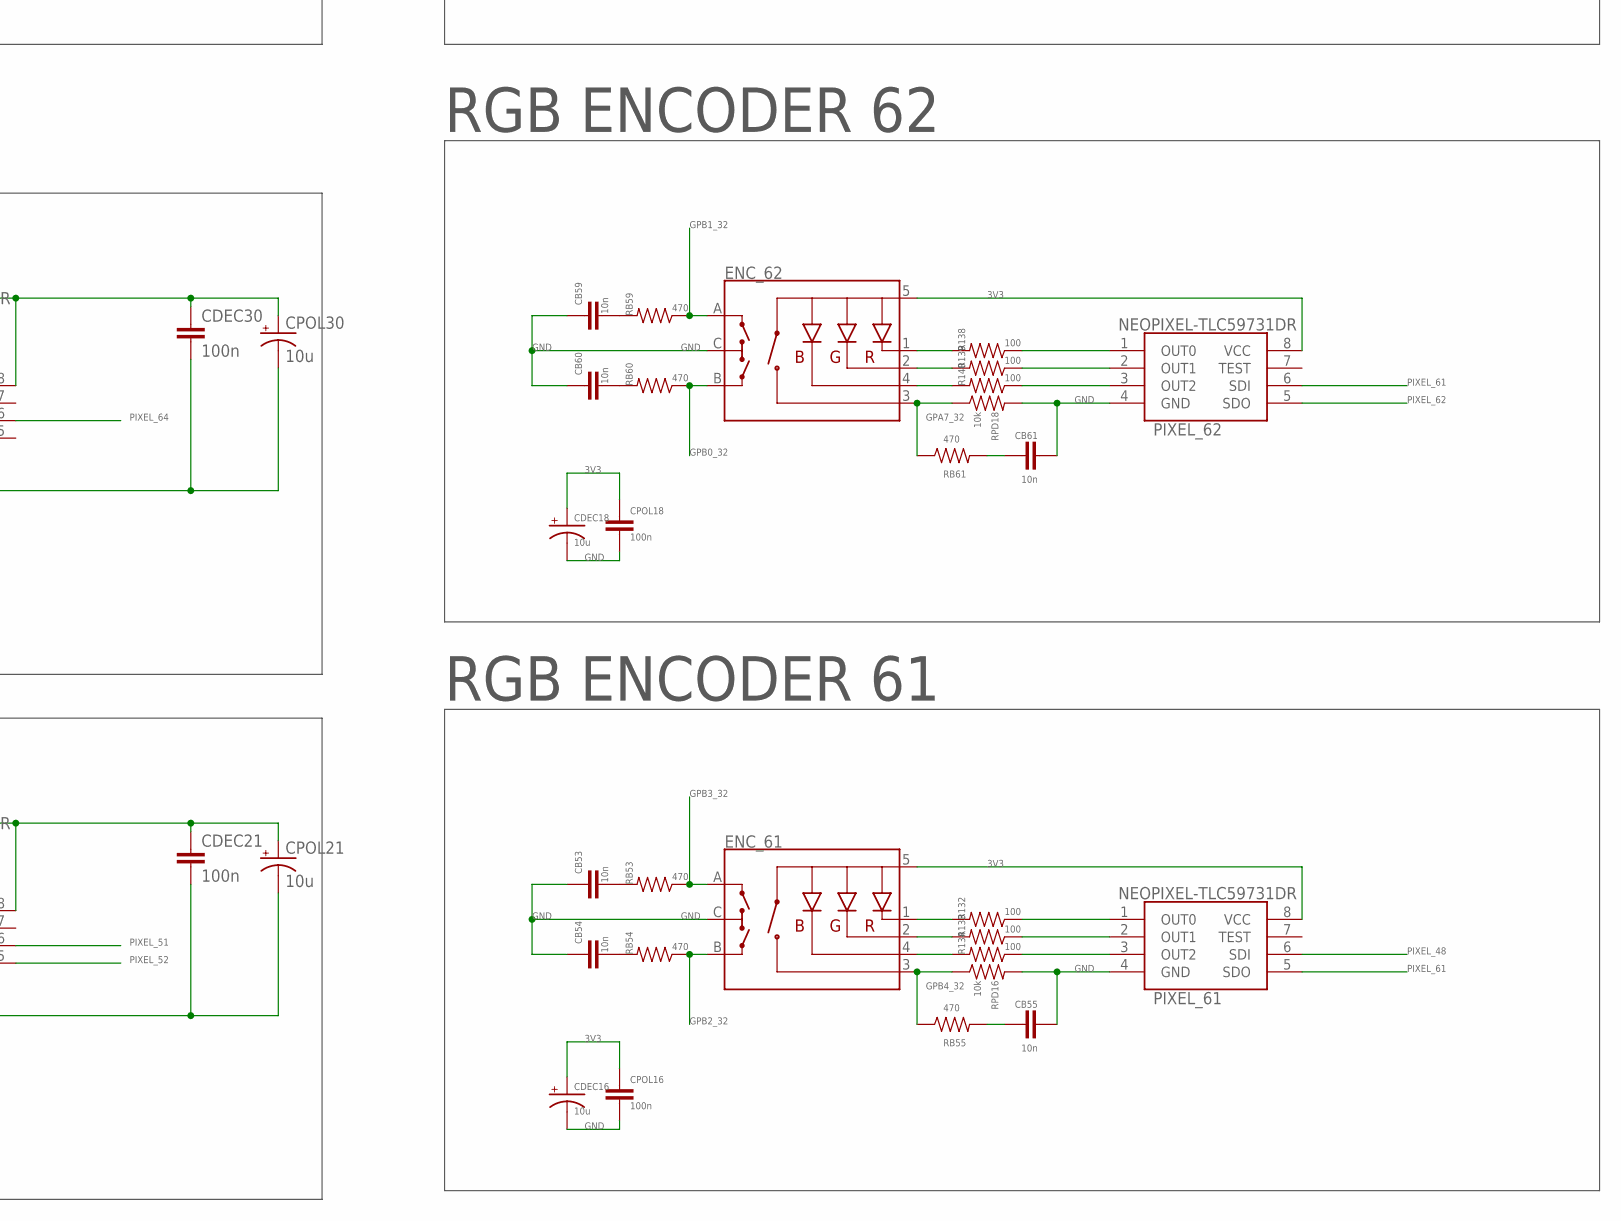
[picture p192: schematic STM32F446 front pane - v3.1.sch, sheet 4, part in row 2, column 3]

Parts:
CB5, CB8, CB9, CB10, CB14, CB15, CB16, CB26, CB27, CB28, CB35, CB36, CB37, CB41, CB42, CB43, CB44, CB47, CB48, CB49, CB53, CB54, CB55, CB59, CB60, CB61, CB65, CB66, CB67, CB71, CB72, CB73: 10n; 0805-CAP
CDEC1, CDEC3, CDEC7, CDEC10, CDEC12, CDEC14, CDEC16, CDEC18, CDEC20, CDEC22: 10u; CPOL2917
CDEC21, CDEC30: 100n; 0805-CAP
CDEC_2A2, CDEC_2A3: 10u; CPOL2917
CDEC_2B2, CDEC_2B3: 100n; 0805-CAP
CPOL1, CPOL3, CPOL7, CPOL10, CPOL12, CPOL14, CPOL16, CPOL18, CPOL20, CPOL22: 100n; 0805-CAP
CPOL21, CPOL30: 10u; CPOL2917
ENC_51, ENC_53, ENC_54, ENC_55, ENC_56, ENC_57, ENC_61, ENC_62, ENC_63, ENC_64: ENCODER-RGB-SWITCH-NO_NUT; ENCODER_LED_3
LED4, LED7: CZXR-80RGB03-A; LED4-2.0-D8.0MM
MCP_011, MCP_100: MCP23017; SOIC-28
PIXEL_51, PIXEL_52, PIXEL_53, PIXEL_54, PIXEL_55, PIXEL_56, PIXEL_57, PIXEL_61, PIXEL_62, PIXEL_63, PIXEL_64, PIXEL_65: NEOPIXEL-TLC59731DR; SOIC127P600X175-8N
R33, R34, R45, R59, R60, R61, R78, R80, R83, R100, R101, R109, R113, R114, R115, R125, R126, R127, R128, R132, R133, R134, R138, R139, R140, R144, R145, R146, R147, R148, R150, R151, R152, R167, R174, R175: 100; 1206
R149, R165, R166, R182: 1k; R0805
RB5, RB8, RB9, RB10, RB14, RB15, RB16, RB26, RB27, RB28, RB35, RB36, RB37, RB41, RB42, RB43, RB44, RB47, RB48, RB49, RB53, RB54, RB55, RB59, RB60, RB61, RB65, RB66, RB67, RB71, RB72, RB73: 470; 1206
RPD1, RPD3, RPD7, RPD10, RPD12, RPD14, RPD16, RPD18, RPD20, RPD22: 10k; 1206
SW_52, SW_65: B3F-1000

Connections:
3V3: CDEC1.+, CDEC3.+, CDEC7.+, CDEC10.+, CDEC12.+, CDEC14.+, CDEC16.+, CDEC18.+, CDEC20.+, CDEC21.1, CDEC22.+, CDEC30.1, CDEC_2A2.+, CDEC_2A3.+, CDEC_2B2.1, CDEC_2B3.1, CPOL1.1, CPOL3.1, CPOL7.1, CPOL10.1, CPOL12.1, CPOL14.1, CPOL16.1, CPOL18.1, CPOL20.1, CPOL21.+, CPOL22.1, CPOL30.+, ENC_51.5 (+), ENC_53.5 (+), ENC_54.5 (+), ENC_55.5 (+), ENC_56.5 (+), ENC_57.5 (+), ENC_61.5 (+), ENC_62.5 (+), ENC_63.5 (+), ENC_64.5 (+), LED4.2 (+), LED7.2 (+), MCP_011.9 (VDD), MCP_011.15 (A0), MCP_011.16 (A1), MCP_100.9 (VDD), MCP_100.17 (A2), PIXEL_51.8 (VCC), PIXEL_52.8 (VCC), PIXEL_53.8 (VCC), PIXEL_54.8 (VCC), PIXEL_55.8 (VCC), PIXEL_56.8 (VCC), PIXEL_57.8 (VCC), PIXEL_61.8 (VCC), PIXEL_62.8 (VCC), PIXEL_63.8 (VCC), PIXEL_64.8 (VCC), PIXEL_65.8 (VCC), R149.2, R165.2, R166.2, R182.2; also elsewhere on the board
GND: CB5.1, CB8.1, CB9.1, CB10.2, CB14.1, CB15.1, CB16.2, CB26.1, CB27.1, CB28.2, CB35.1, CB36.1, CB37.2, CB41.1, CB42.1, CB43.2, CB44.1, CB47.1, CB48.1, CB49.2, CB53.1, CB54.1, CB55.2, CB59.1, CB60.1, CB61.2, CB65.1, CB66.1, CB67.2, CB71.1, CB72.1, CB73.2, CDEC1.-, CDEC3.-, CDEC7.-, CDEC10.-, CDEC12.-, CDEC14.-, CDEC16.-, CDEC18.-, CDEC20.-, CDEC21.2, CDEC22.-, CDEC30.2, CDEC_2A2.-, CDEC_2A3.-, CDEC_2B2.2, CDEC_2B3.2, CPOL1.2, CPOL3.2, CPOL7.2, CPOL10.2, CPOL12.2, CPOL14.2, CPOL16.2, CPOL18.2, CPOL20.2, CPOL21.-, CPOL22.2, CPOL30.-, ENC_51.C, ENC_53.C, ENC_54.C, ENC_55.C, ENC_56.C, ENC_57.C, ENC_61.C, ENC_62.C, ENC_63.C, ENC_64.C, MCP_011.10 (VSS), MCP_011.17 (A2), MCP_100.10 (VSS), MCP_100.15 (A0), MCP_100.16 (A1), PIXEL_51.4 (GND), PIXEL_52.4 (GND), PIXEL_53.4 (GND), PIXEL_54.4 (GND), PIXEL_55.4 (GND), PIXEL_56.4 (GND), PIXEL_57.4 (GND), PIXEL_61.4 (GND), PIXEL_62.4 (GND), PIXEL_63.4 (GND), PIXEL_64.4 (GND), PIXEL_65.4 (GND), RPD1.2, RPD3.2, RPD7.2, RPD10.2, RPD12.2, RPD14.2, RPD16.2, RPD18.2, RPD20.2, RPD22.2, SW_52.1, SW_52.2, SW_65.1, SW_65.2; also elsewhere on the board
GPA0_31: ENC_51.A, MCP_011.21 (GPA0), RB8.1
GPA0_32: MCP_100.21 (GPA0), RB44.1, SW_65.3, SW_65.4
GPA1_31: ENC_51.B, MCP_011.22 (GPA1), RB9.1
GPA1_32: ENC_64.3 (SW), MCP_100.22 (GPA1), RB73.1, RPD22.1
GPA2_31: ENC_51.3 (SW), MCP_011.23 (GPA2), RB10.1, RPD1.1
GPA2_32: ENC_64.B, MCP_100.23 (GPA2), RB72.1
GPA3_31: MCP_011.24 (GPA3), RB5.1, SW_52.3, SW_52.4
GPA3_32: ENC_64.A, MCP_100.24 (GPA3), RB71.1
GPA4_31: ENC_53.3 (SW), MCP_011.25 (GPA4), RB16.1, RPD3.1
GPA4_32: ENC_63.3 (SW), MCP_100.25 (GPA4), RB67.1, RPD20.1
GPA5_31: ENC_53.A, MCP_011.26 (GPA5), RB14.1
GPA5_32: ENC_63.B, MCP_100.26 (GPA5), RB66.1
GPA6_31: ENC_53.B, MCP_011.27 (GPA6), RB15.1
GPA6_32: ENC_63.A, MCP_100.27 (GPA6), RB65.1
GPA7_31: ENC_57.3 (SW), MCP_011.28 (GPA7), RB49.1, RPD14.1
GPA7_32: ENC_62.3 (SW), MCP_100.28 (GPA7), RB61.1, RPD18.1
GPB0_31: ENC_57.B, MCP_011.1 (GPB0), RB48.1
GPB0_32: ENC_62.B, MCP_100.1 (GPB0), RB60.1
GPB1_31: ENC_57.A, MCP_011.2 (GPB1), RB47.1
GPB1_32: ENC_62.A, MCP_100.2 (GPB1), RB59.1
GPB2_31: ENC_56.3 (SW), MCP_011.3 (GPB2), RB43.1, RPD12.1
GPB2_32: ENC_61.B, MCP_100.3 (GPB2), RB54.1
GPB3_31: ENC_56.B, MCP_011.4 (GPB3), RB42.1
GPB3_32: ENC_61.A, MCP_100.4 (GPB3), RB53.1
GPB4_31: ENC_56.A, MCP_011.5 (GPB4), RB41.1
GPB4_32: ENC_61.3 (SW), MCP_100.5 (GPB4), RB55.1, RPD16.1
GPB5_31: ENC_55.A, MCP_011.6 (GPB5), RB35.1
GPB5_32: ENC_54.A, MCP_100.6 (GPB5), RB26.1
GPB6_31: ENC_55.B, MCP_011.7 (GPB6), RB36.1
GPB6_32: ENC_54.B, MCP_100.7 (GPB6), RB27.1
GPB7_31: ENC_55.3 (SW), MCP_011.8 (GPB7), RB37.1, RPD10.1
GPB7_32: ENC_54.3 (SW), MCP_100.8 (GPB7), RB28.1, RPD7.1
I2C2_SCL: MCP_011.12 (SCL), MCP_100.12 (SCL), R149.1, R166.1; also elsewhere on the board
I2C2_SDA: MCP_011.13 (SDA), MCP_100.13 (SDA), R165.1, R182.1; also elsewhere on the board
INTA_31: MCP_011.20 (INTA); also elsewhere on the board
INTA_32: MCP_100.20 (INTA); also elsewhere on the board
INTB_31: MCP_011.19 (INTB); also elsewhere on the board
INTB_32: MCP_100.19 (INTB); also elsewhere on the board
unnamed: ENC_51.1 (-R), R33.2
unnamed: ENC_51.2 (-G), R34.2
unnamed: ENC_51.4 (-B), R45.2
unnamed: PIXEL_51.1 (OUT0), R33.1
unnamed: PIXEL_51.2 (OUT1), R34.1
unnamed: PIXEL_51.3 (OUT2), R45.1
unnamed: CB8.2, RB8.2
unnamed: CB9.2, RB9.2
unnamed: CB10.1, RB10.2
unnamed: ENC_53.1 (-R), R59.2
unnamed: ENC_53.2 (-G), R60.2
unnamed: ENC_53.4 (-B), R61.2
unnamed: PIXEL_53.1 (OUT0), R59.1
unnamed: PIXEL_53.2 (OUT1), R60.1
unnamed: PIXEL_53.3 (OUT2), R61.1
unnamed: CB14.2, RB14.2
unnamed: CB15.2, RB15.2
unnamed: CB16.1, RB16.2
unnamed: ENC_54.1 (-R), R78.2
unnamed: ENC_54.2 (-G), R80.2
unnamed: ENC_54.4 (-B), R83.2
unnamed: PIXEL_54.1 (OUT0), R78.1
unnamed: PIXEL_54.2 (OUT1), R80.1
unnamed: PIXEL_54.3 (OUT2), R83.1
unnamed: CB26.2, RB26.2
unnamed: CB27.2, RB27.2
unnamed: CB28.1, RB28.2
unnamed: ENC_55.1 (-R), R100.2
unnamed: ENC_55.2 (-G), R101.2
unnamed: ENC_55.4 (-B), R109.2
unnamed: PIXEL_55.1 (OUT0), R100.1
unnamed: PIXEL_55.2 (OUT1), R101.1
unnamed: PIXEL_55.3 (OUT2), R109.1
unnamed: CB35.2, RB35.2
unnamed: CB36.2, RB36.2
unnamed: CB37.1, RB37.2
unnamed: ENC_56.1 (-R), R113.2
unnamed: ENC_56.2 (-G), R114.2
unnamed: ENC_56.4 (-B), R115.2
unnamed: PIXEL_56.1 (OUT0), R113.1
unnamed: PIXEL_56.2 (OUT1), R114.1
unnamed: PIXEL_56.3 (OUT2), R115.1
unnamed: CB41.2, RB41.2
unnamed: CB42.2, RB42.2
unnamed: CB43.1, RB43.2
unnamed: PIXEL_52.1 (OUT0), R125.1
unnamed: PIXEL_52.2 (OUT1), R147.1
unnamed: PIXEL_52.3 (OUT2), R148.1
unnamed: CB5.2, RB5.2
unnamed: ENC_57.1 (-R), R126.2
unnamed: ENC_57.2 (-G), R127.2
unnamed: ENC_57.4 (-B), R128.2
unnamed: PIXEL_57.1 (OUT0), R126.1
unnamed: PIXEL_57.2 (OUT1), R127.1
unnamed: PIXEL_57.3 (OUT2), R128.1
unnamed: CB47.2, RB47.2
unnamed: CB48.2, RB48.2
unnamed: CB49.1, RB49.2
unnamed: ENC_61.1 (-R), R132.2
unnamed: ENC_61.2 (-G), R133.2
unnamed: ENC_61.4 (-B), R134.2
unnamed: PIXEL_61.1 (OUT0), R132.1
unnamed: PIXEL_61.2 (OUT1), R133.1
unnamed: PIXEL_61.3 (OUT2), R134.1
unnamed: CB53.2, RB53.2
unnamed: CB54.2, RB54.2
unnamed: CB55.1, RB55.2
unnamed: ENC_62.1 (-R), R138.2
unnamed: ENC_62.2 (-G), R139.2
unnamed: ENC_62.4 (-B), R140.2
unnamed: PIXEL_62.1 (OUT0), R138.1
unnamed: PIXEL_62.2 (OUT1), R139.1
unnamed: PIXEL_62.3 (OUT2), R140.1
unnamed: CB59.2, RB59.2
unnamed: CB60.2, RB60.2
unnamed: CB61.1, RB61.2
unnamed: ENC_63.1 (-R), R144.2
unnamed: ENC_63.2 (-G), R145.2
unnamed: ENC_63.4 (-B), R146.2
unnamed: PIXEL_63.1 (OUT0), R144.1
unnamed: PIXEL_63.2 (OUT1), R145.1
unnamed: PIXEL_63.3 (OUT2), R146.1
unnamed: CB65.2, RB65.2
unnamed: CB66.2, RB66.2
unnamed: CB67.1, RB67.2
unnamed: LED4.1 (R), R148.2
unnamed: LED4.4 (B), R147.2
unnamed: LED4.3 (G), R125.2
unnamed: ENC_64.1 (-R), R150.2
unnamed: ENC_64.2 (-G), R151.2
unnamed: ENC_64.4 (-B), R152.2
unnamed: PIXEL_64.1 (OUT0), R150.1
unnamed: PIXEL_64.2 (OUT1), R151.1
unnamed: PIXEL_64.3 (OUT2), R152.1
unnamed: CB71.2, RB71.2
unnamed: CB72.2, RB72.2
unnamed: CB73.1, RB73.2
unnamed: PIXEL_65.1 (OUT0), R167.1
unnamed: PIXEL_65.2 (OUT1), R174.1
unnamed: PIXEL_65.3 (OUT2), R175.1
unnamed: CB44.2, RB44.2
unnamed: LED7.1 (R), R175.2
unnamed: LED7.4 (B), R174.2
unnamed: LED7.3 (G), R167.2
PIXEL_48: PIXEL_61.6 (SDI); also elsewhere on the board
PIXEL_51: PIXEL_51.5 (SDO), PIXEL_52.6 (SDI)
PIXEL_52: PIXEL_52.5 (SDO), PIXEL_53.6 (SDI)
PIXEL_53: PIXEL_53.5 (SDO), PIXEL_57.6 (SDI)
PIXEL_54: PIXEL_54.5 (SDO); also elsewhere on the board
PIXEL_55: PIXEL_54.6 (SDI), PIXEL_55.5 (SDO)
PIXEL_56: PIXEL_55.6 (SDI), PIXEL_56.5 (SDO)
PIXEL_57: PIXEL_56.6 (SDI), PIXEL_57.5 (SDO)
PIXEL_61: PIXEL_61.5 (SDO), PIXEL_62.6 (SDI)
PIXEL_62: PIXEL_62.5 (SDO), PIXEL_63.6 (SDI)
PIXEL_63: PIXEL_63.5 (SDO), PIXEL_64.6 (SDI)
PIXEL_64: PIXEL_64.5 (SDO), PIXEL_65.6 (SDI)
RST: MCP_011.18 (!RESET), MCP_100.18 (!RESET); also elsewhere on the board
SPI3_MOSI: PIXEL_51.6 (SDI); also elsewhere on the board

Notes on the sheet:
RGB ENCODER 51
RGB ENCODER 53
RGB ENCODER 54
RGB ENCODER 55
RGB ENCODER 56
RGB ENCODER 57
RGB ENCODER 61
RGB ENCODER 62
RGB ENCODER 63
RGB ENCODER 64
SWITCH RGB 52
SWITCH RGB 65
