reynal/themis/front-pane/eagle-schematics/v3/STM32F446 front pane - v3.1.brd

## EAGLE design front-pane/eagle-schematics/v3/STM32F446 front pane - v3.1.brd (continued)

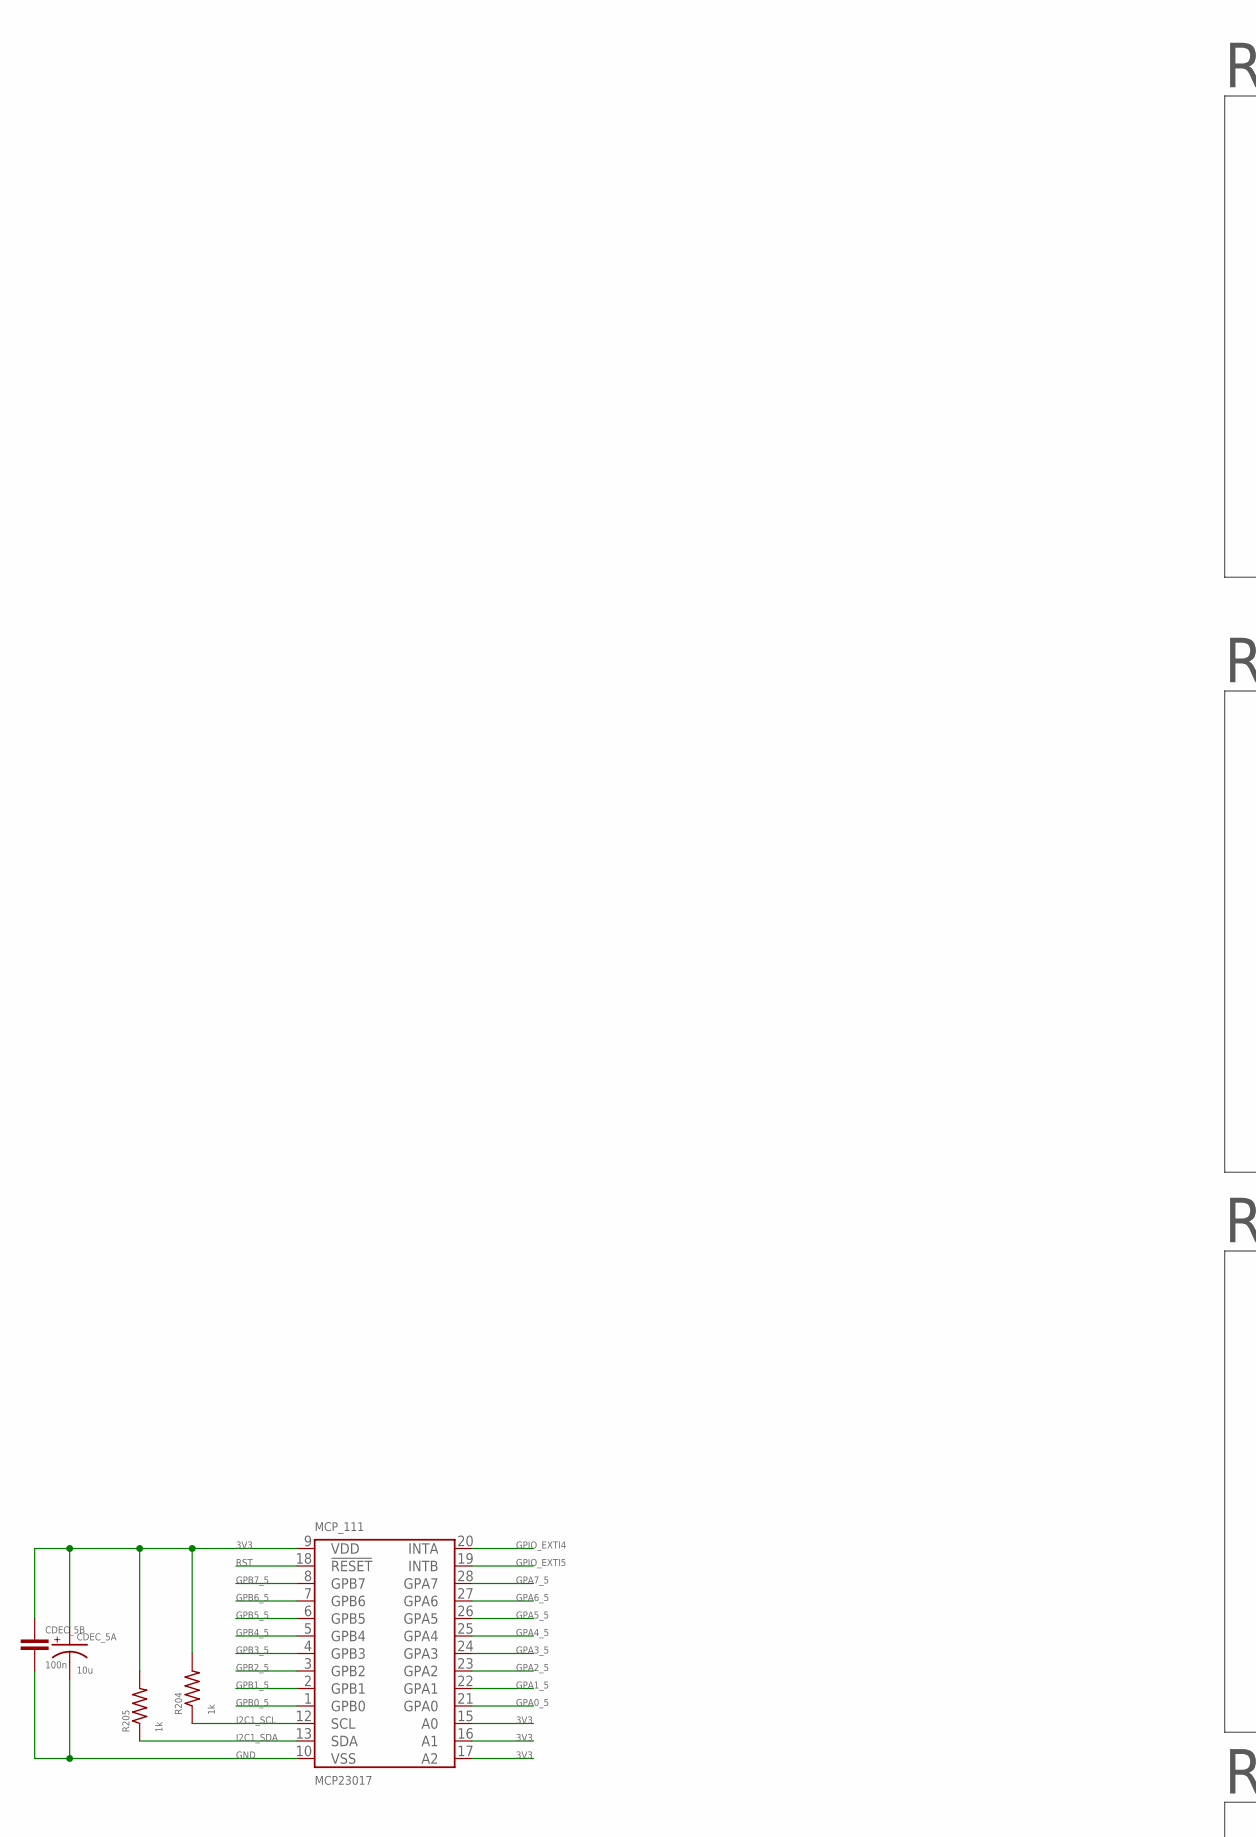
[picture p193: schematic STM32F446 front pane - v3.1.sch, sheet 5, part in row 1, column 1]

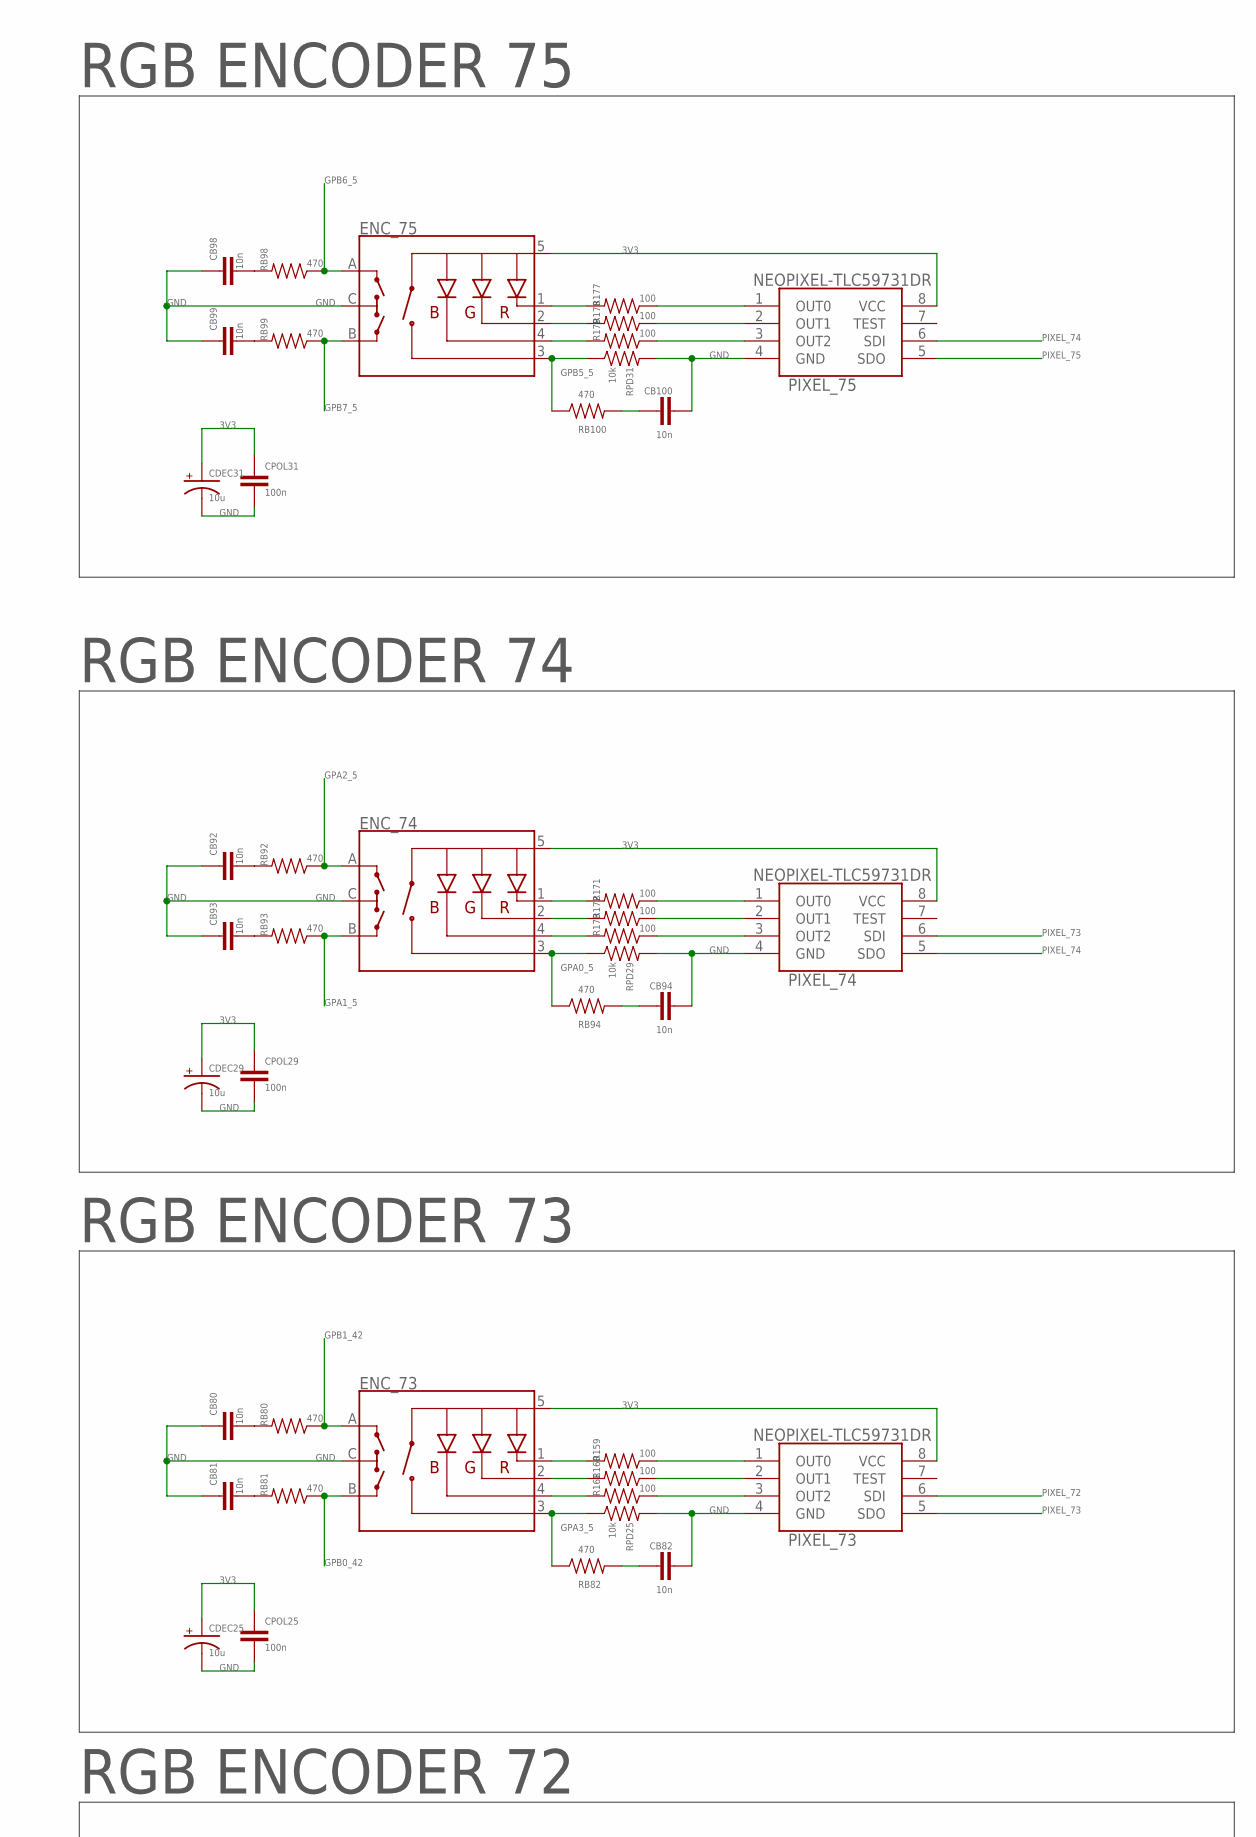
[picture p194: schematic STM32F446 front pane - v3.1.sch, sheet 5, part in row 1, column 2]

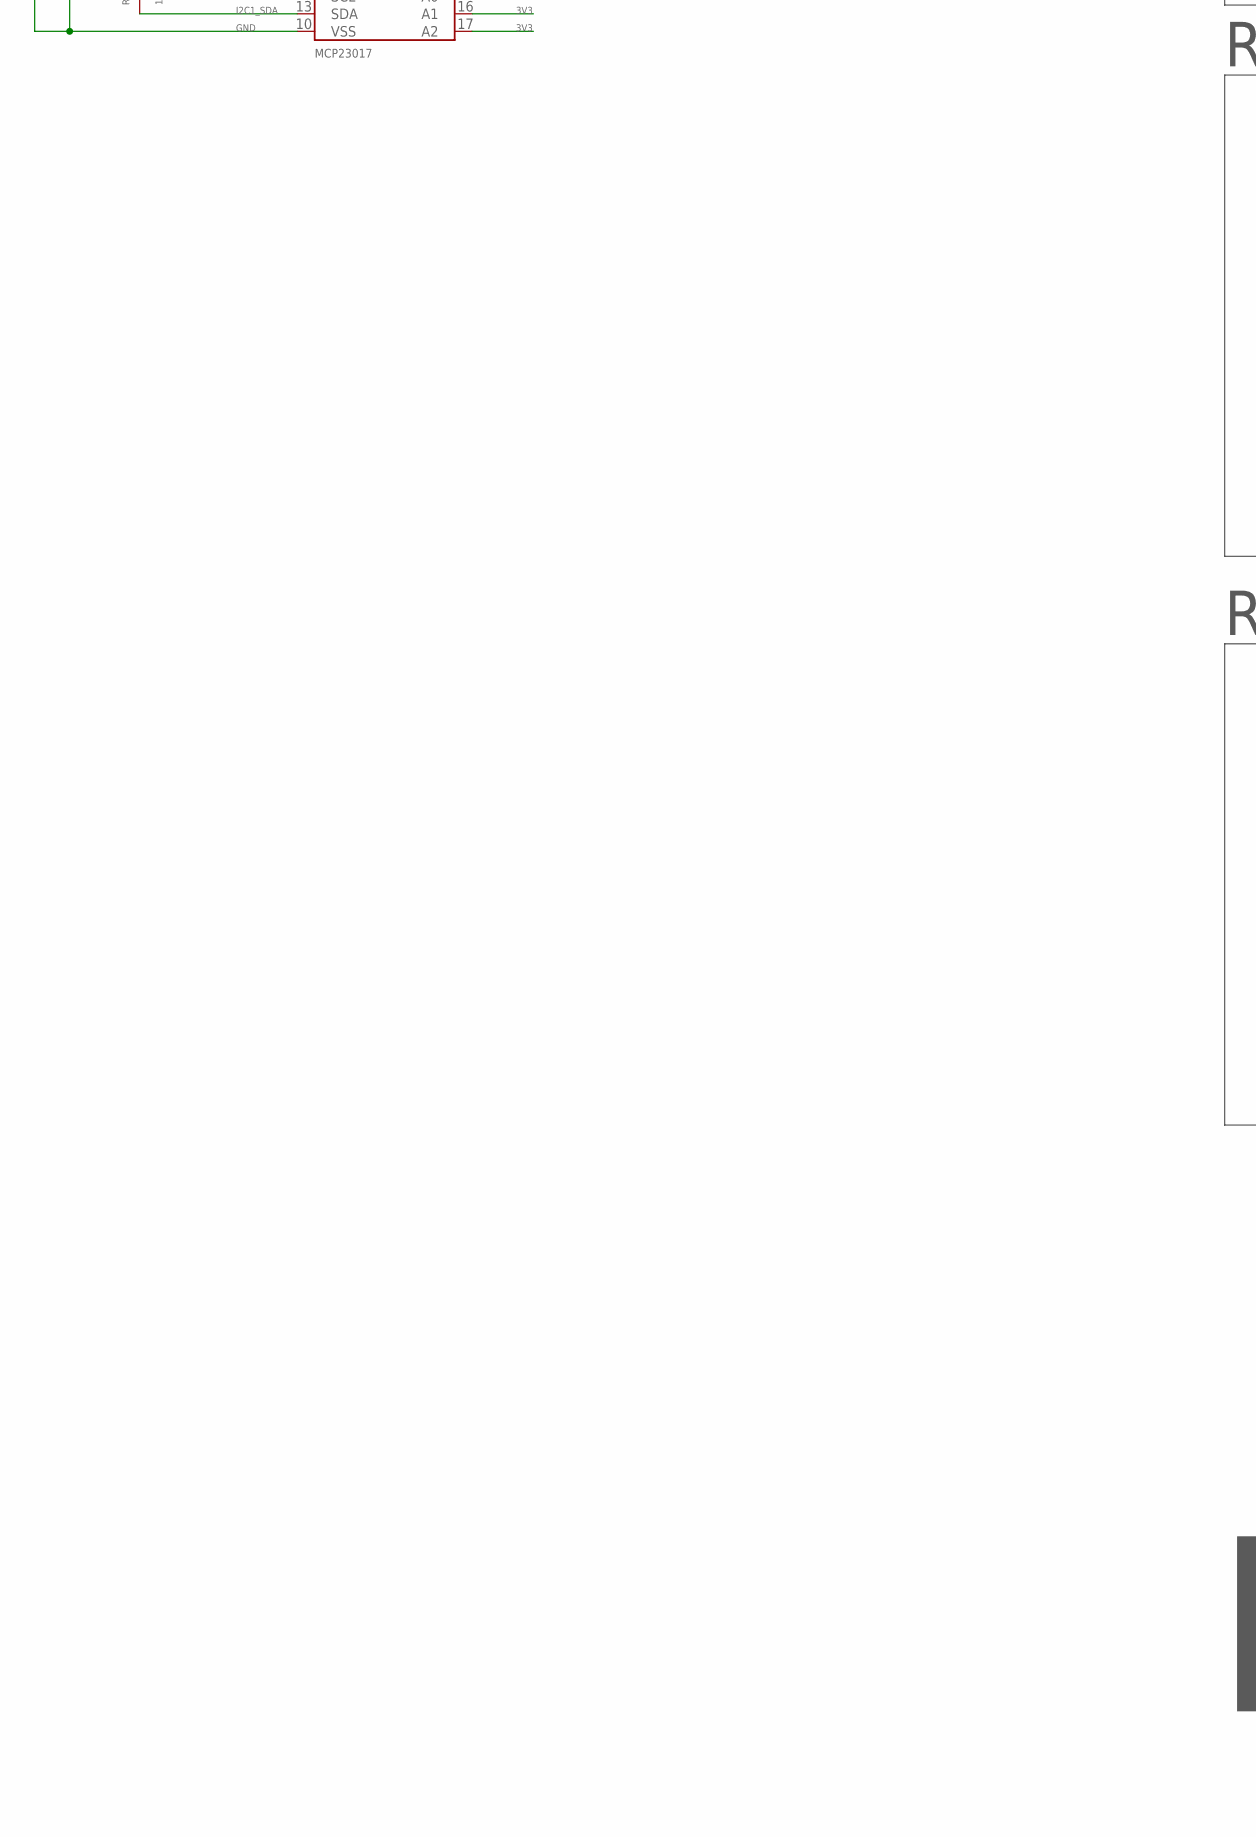
[picture p195: schematic STM32F446 front pane - v3.1.sch, sheet 5, part in row 2, column 1]

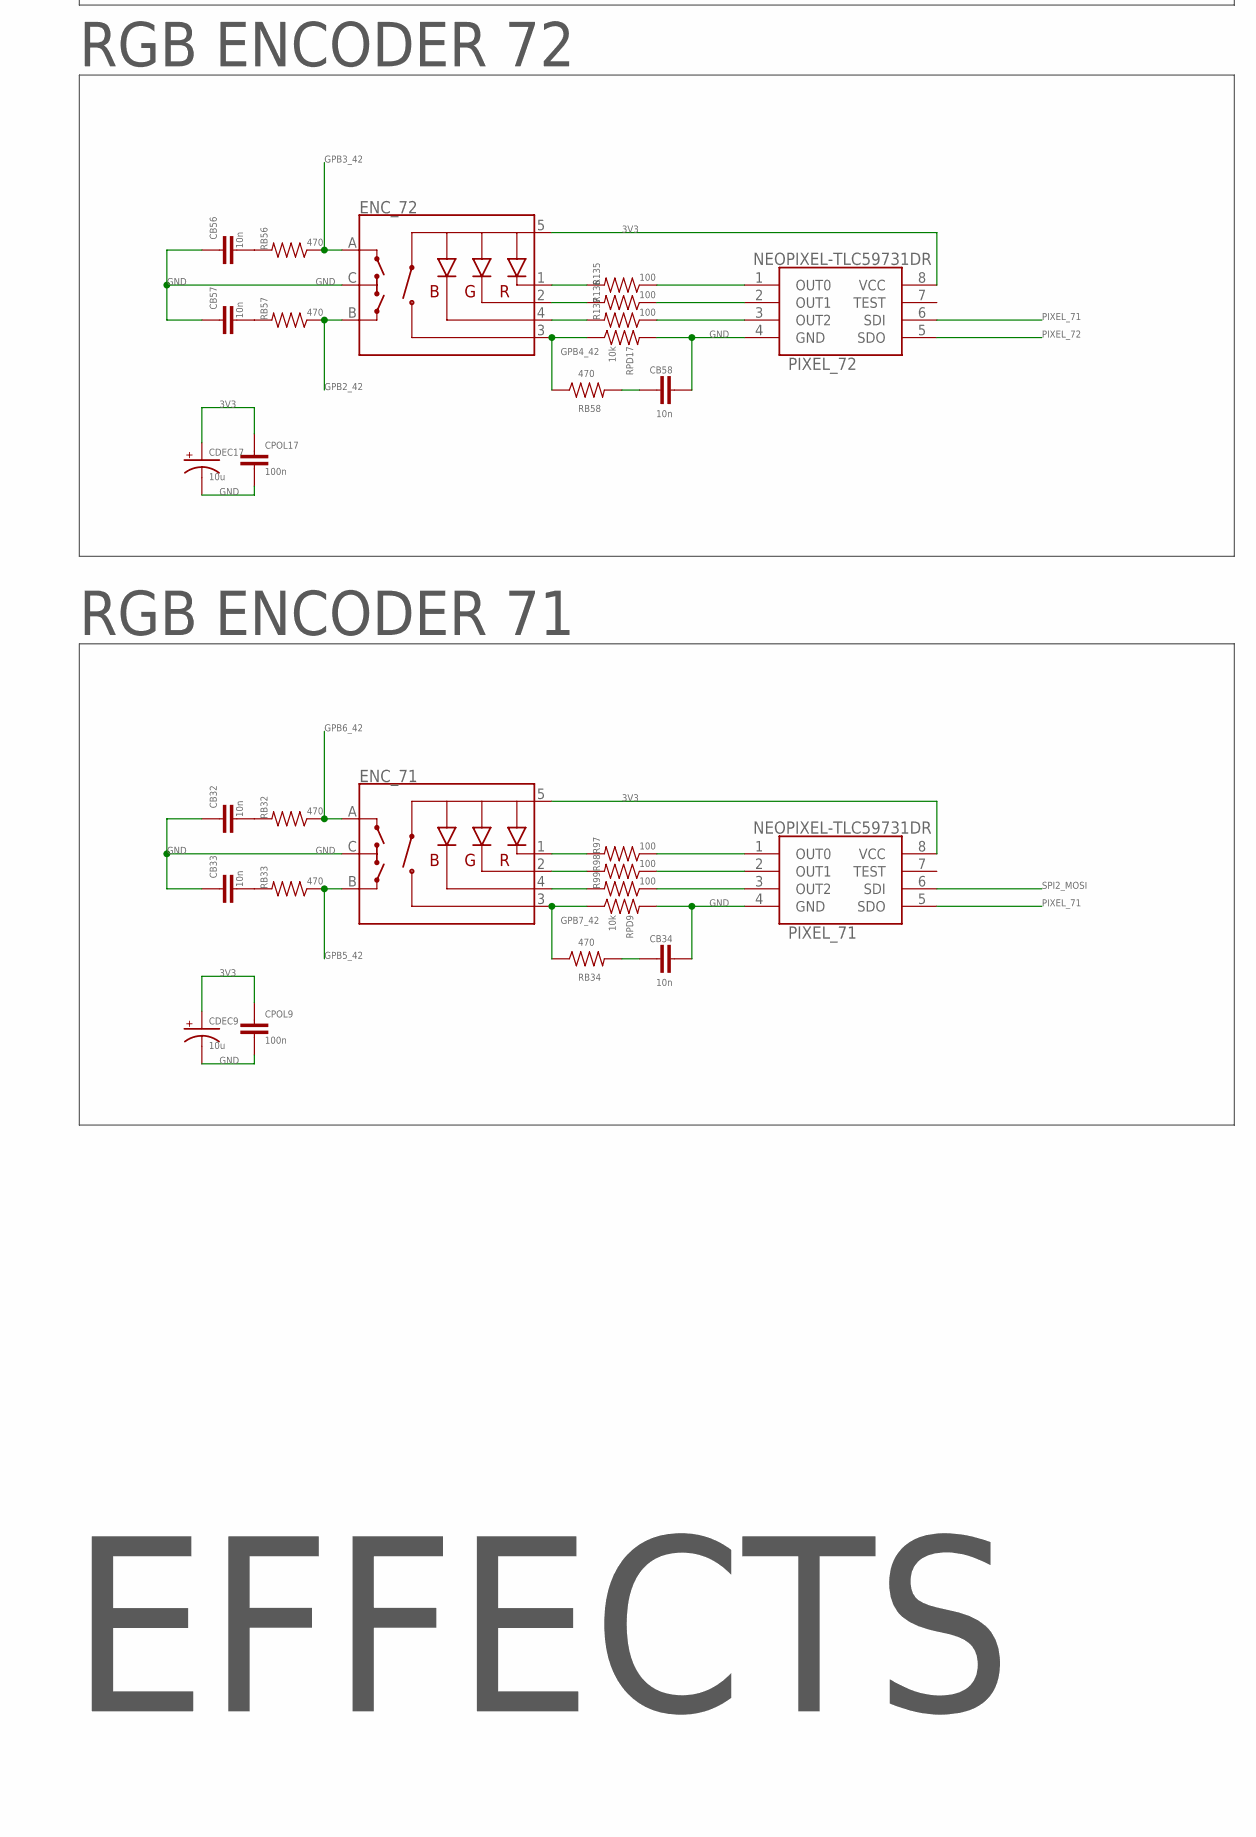
[picture p196: schematic STM32F446 front pane - v3.1.sch, sheet 5, part in row 2, column 2]

Parts:
CB32, CB33, CB34, CB56, CB57, CB58, CB80, CB81, CB82, CB92, CB93, CB94, CB98, CB99, CB100: 10n; 0805-CAP
CDEC9, CDEC17, CDEC25, CDEC29, CDEC31: 10u; CPOL2917
CDEC_5A: 10u; CPOL2917
CDEC_5B: 100n; 0805-CAP
CPOL9, CPOL17, CPOL25, CPOL29, CPOL31: 100n; 0805-CAP
ENC_71, ENC_72, ENC_73, ENC_74, ENC_75: ENCODER-RGB-SWITCH-NO_NUT; ENCODER_LED_3
MCP_111: MCP23017; SOIC-28
PIXEL_71, PIXEL_72, PIXEL_73, PIXEL_74, PIXEL_75: NEOPIXEL-TLC59731DR; SOIC127P600X175-8N
R97, R98, R99, R135, R136, R137, R159, R160, R161, R171, R172, R173, R177, R178, R179: 100; 1206
R204, R205: 1k; R0805
RB32, RB33, RB34, RB56, RB57, RB58, RB80, RB81, RB82, RB92, RB93, RB94, RB98, RB99, RB100: 470; 1206
RPD9, RPD17, RPD25, RPD29, RPD31: 10k; 1206

Connections:
3V3: CDEC9.+, CDEC17.+, CDEC25.+, CDEC29.+, CDEC31.+, CDEC_5A.+, CDEC_5B.1, CPOL9.1, CPOL17.1, CPOL25.1, CPOL29.1, CPOL31.1, ENC_71.5 (+), ENC_72.5 (+), ENC_73.5 (+), ENC_74.5 (+), ENC_75.5 (+), MCP_111.9 (VDD), MCP_111.15 (A0), MCP_111.16 (A1), MCP_111.17 (A2), PIXEL_71.8 (VCC), PIXEL_72.8 (VCC), PIXEL_73.8 (VCC), PIXEL_74.8 (VCC), PIXEL_75.8 (VCC), R204.2, R205.2; also elsewhere on the board
GND: CB32.1, CB33.1, CB34.2, CB56.1, CB57.1, CB58.2, CB80.1, CB81.1, CB82.2, CB92.1, CB93.1, CB94.2, CB98.1, CB99.1, CB100.2, CDEC9.-, CDEC17.-, CDEC25.-, CDEC29.-, CDEC31.-, CDEC_5A.-, CDEC_5B.2, CPOL9.2, CPOL17.2, CPOL25.2, CPOL29.2, CPOL31.2, ENC_71.C, ENC_72.C, ENC_73.C, ENC_74.C, ENC_75.C, MCP_111.10 (VSS), PIXEL_71.4 (GND), PIXEL_72.4 (GND), PIXEL_73.4 (GND), PIXEL_74.4 (GND), PIXEL_75.4 (GND), RPD9.2, RPD17.2, RPD25.2, RPD29.2, RPD31.2; also elsewhere on the board
GPA0_5: ENC_74.3 (SW), MCP_111.21 (GPA0), RB94.1, RPD29.1
GPA1_5: ENC_74.B, MCP_111.22 (GPA1), RB93.1
GPA2_5: ENC_74.A, MCP_111.23 (GPA2), RB92.1
GPA3_5: ENC_73.3 (SW), MCP_111.24 (GPA3), RB82.1, RPD25.1
GPA4_5: MCP_111.25 (GPA4); also elsewhere on the board
GPA5_5: MCP_111.26 (GPA5); also elsewhere on the board
GPA6_5: MCP_111.27 (GPA6); also elsewhere on the board
GPA7_5: MCP_111.28 (GPA7); also elsewhere on the board
GPB0_5: MCP_111.1 (GPB0); also elsewhere on the board
GPB0_42: ENC_73.B, RB81.1; also elsewhere on the board
GPB1_5: MCP_111.2 (GPB1); also elsewhere on the board
GPB1_42: ENC_73.A, RB80.1; also elsewhere on the board
GPB2_5: MCP_111.3 (GPB2); also elsewhere on the board
GPB2_42: ENC_72.B, RB57.1; also elsewhere on the board
GPB3_5: MCP_111.4 (GPB3); also elsewhere on the board
GPB3_42: ENC_72.A, RB56.1; also elsewhere on the board
GPB4_5: MCP_111.5 (GPB4); also elsewhere on the board
GPB4_42: ENC_72.3 (SW), RB58.1, RPD17.1; also elsewhere on the board
GPB5_5: ENC_75.3 (SW), MCP_111.6 (GPB5), RB100.1, RPD31.1
GPB5_42: ENC_71.B, RB33.1; also elsewhere on the board
GPB6_5: ENC_75.A, MCP_111.7 (GPB6), RB98.1
GPB6_42: ENC_71.A, RB32.1; also elsewhere on the board
GPB7_5: ENC_75.B, MCP_111.8 (GPB7), RB99.1
GPB7_42: ENC_71.3 (SW), RB34.1, RPD9.1; also elsewhere on the board
GPIO_EXTI4: MCP_111.20 (INTA); also elsewhere on the board
GPIO_EXTI5: MCP_111.19 (INTB); also elsewhere on the board
I2C1_SCL: MCP_111.12 (SCL), R204.1; also elsewhere on the board
I2C1_SDA: MCP_111.13 (SDA), R205.1; also elsewhere on the board
unnamed: ENC_71.1 (-R), R97.2
unnamed: ENC_71.2 (-G), R98.2
unnamed: ENC_71.4 (-B), R99.2
unnamed: PIXEL_71.1 (OUT0), R97.1
unnamed: PIXEL_71.2 (OUT1), R98.1
unnamed: PIXEL_71.3 (OUT2), R99.1
unnamed: CB32.2, RB32.2
unnamed: CB33.2, RB33.2
unnamed: CB34.1, RB34.2
unnamed: ENC_72.1 (-R), R135.2
unnamed: ENC_72.2 (-G), R136.2
unnamed: ENC_72.4 (-B), R137.2
unnamed: PIXEL_72.1 (OUT0), R135.1
unnamed: PIXEL_72.2 (OUT1), R136.1
unnamed: PIXEL_72.3 (OUT2), R137.1
unnamed: CB56.2, RB56.2
unnamed: CB57.2, RB57.2
unnamed: CB58.1, RB58.2
unnamed: ENC_73.1 (-R), R159.2
unnamed: ENC_73.2 (-G), R160.2
unnamed: ENC_73.4 (-B), R161.2
unnamed: PIXEL_73.1 (OUT0), R159.1
unnamed: PIXEL_73.2 (OUT1), R160.1
unnamed: PIXEL_73.3 (OUT2), R161.1
unnamed: CB80.2, RB80.2
unnamed: CB81.2, RB81.2
unnamed: CB82.1, RB82.2
unnamed: ENC_74.1 (-R), R171.2
unnamed: ENC_74.2 (-G), R172.2
unnamed: ENC_74.4 (-B), R173.2
unnamed: PIXEL_74.1 (OUT0), R171.1
unnamed: PIXEL_74.2 (OUT1), R172.1
unnamed: PIXEL_74.3 (OUT2), R173.1
unnamed: CB92.2, RB92.2
unnamed: CB93.2, RB93.2
unnamed: CB94.1, RB94.2
unnamed: ENC_75.1 (-R), R177.2
unnamed: ENC_75.2 (-G), R178.2
unnamed: ENC_75.4 (-B), R179.2
unnamed: PIXEL_75.1 (OUT0), R177.1
unnamed: PIXEL_75.2 (OUT1), R178.1
unnamed: PIXEL_75.3 (OUT2), R179.1
unnamed: CB98.2, RB98.2
unnamed: CB99.2, RB99.2
unnamed: CB100.1, RB100.2
PIXEL_71: PIXEL_71.5 (SDO), PIXEL_72.6 (SDI)
PIXEL_72: PIXEL_72.5 (SDO), PIXEL_73.6 (SDI)
PIXEL_73: PIXEL_73.5 (SDO), PIXEL_74.6 (SDI)
PIXEL_74: PIXEL_74.5 (SDO), PIXEL_75.6 (SDI)
PIXEL_75: PIXEL_75.5 (SDO); also elsewhere on the board
RST: MCP_111.18 (!RESET); also elsewhere on the board
SPI2_MOSI: PIXEL_71.6 (SDI); also elsewhere on the board

Notes on the sheet:
EFFECTS
RGB ENCODER 71
RGB ENCODER 72
RGB ENCODER 73
RGB ENCODER 74
RGB ENCODER 75
