reynal/themis/front-pane/eagle-schematics/v3/STM32F446 front pane - v3.1.brd

## EAGLE design front-pane/eagle-schematics/v3/STM32F446 front pane - v3.1.brd (continued)

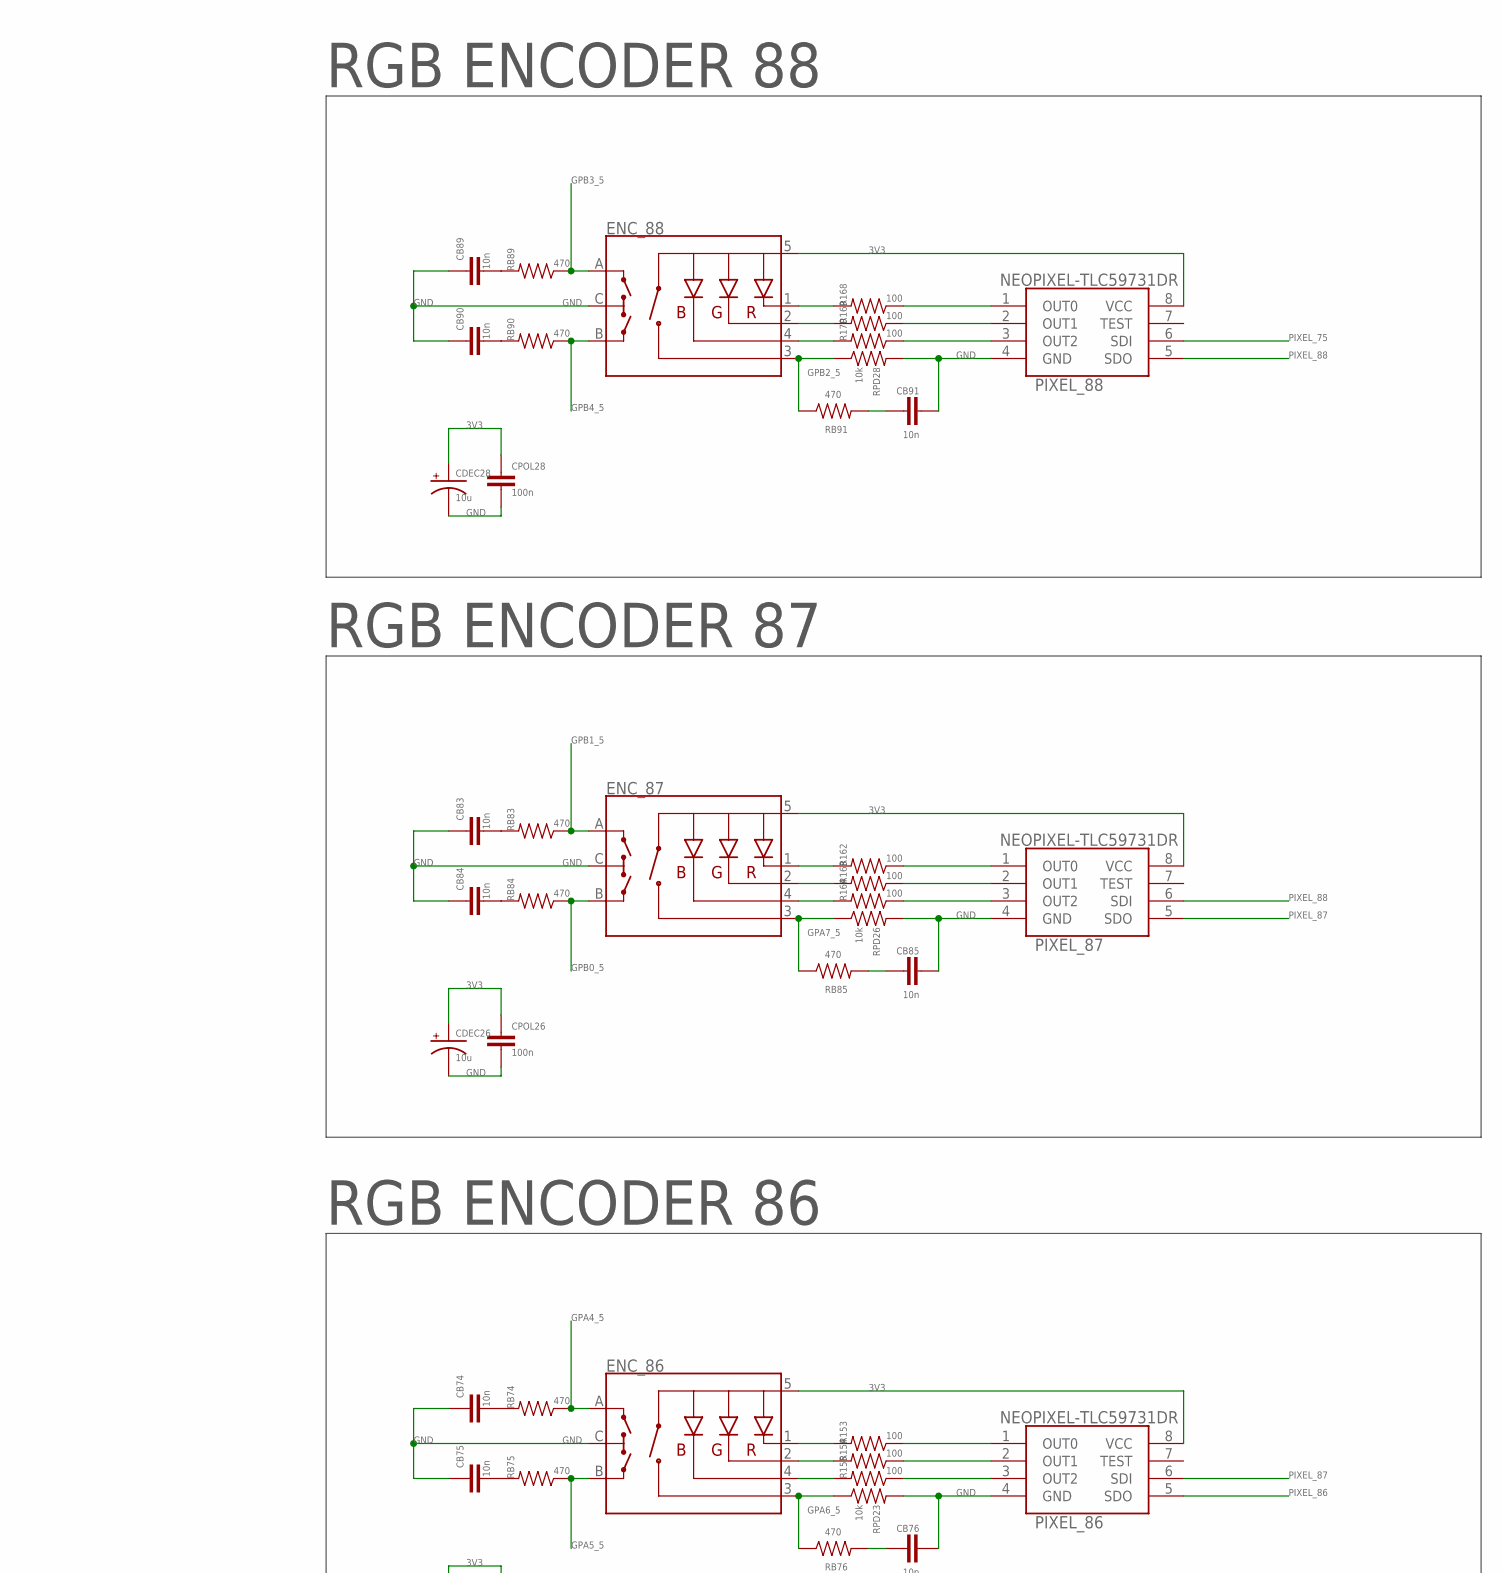
[picture p197: schematic STM32F446 front pane - v3.1.sch, sheet 6, part in row 1, column 2]

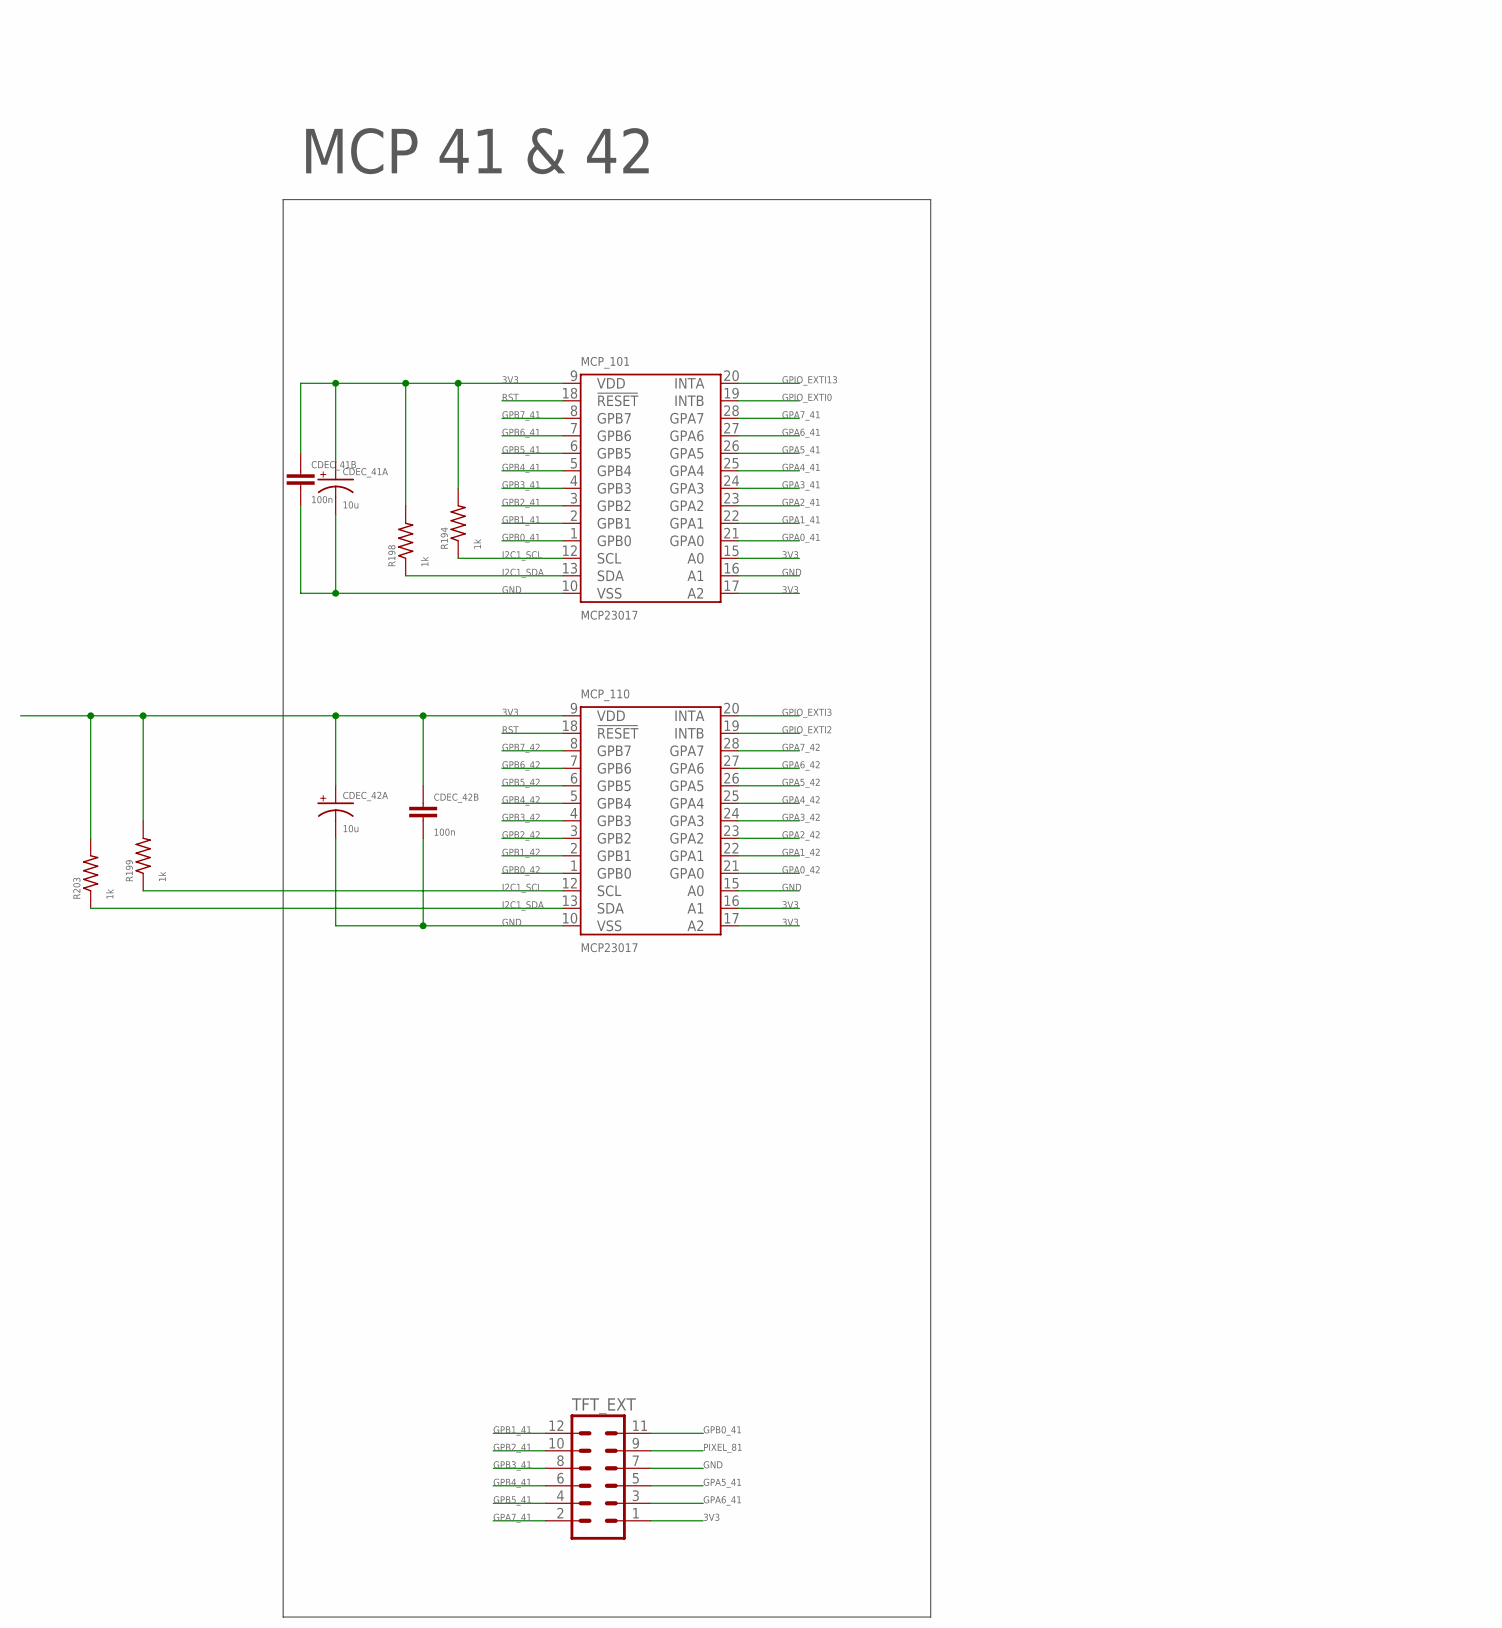
[picture p198: schematic STM32F446 front pane - v3.1.sch, sheet 6, part in row 2, column 1]

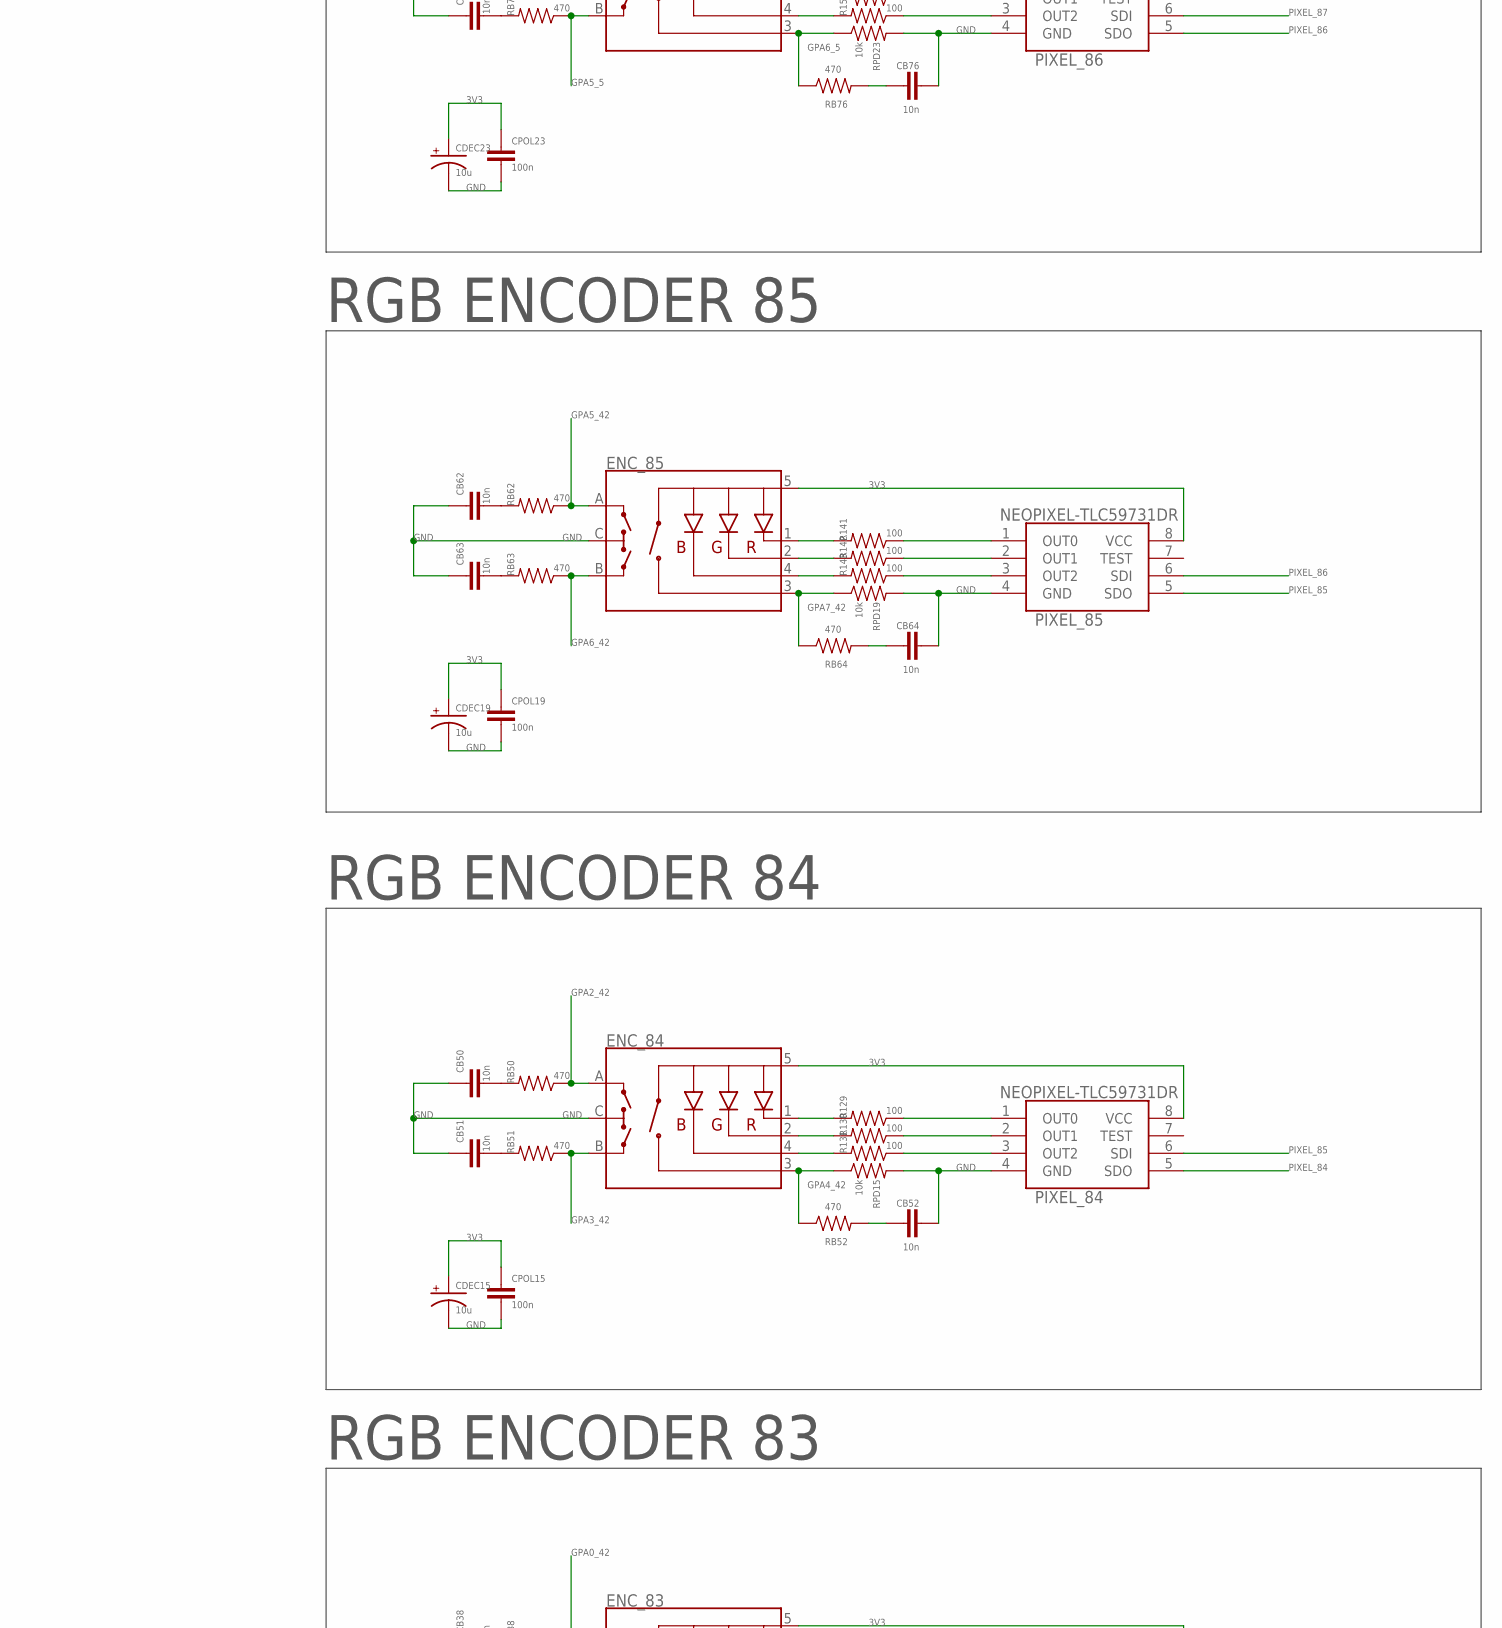
[picture p199: schematic STM32F446 front pane - v3.1.sch, sheet 6, part in row 2, column 2]

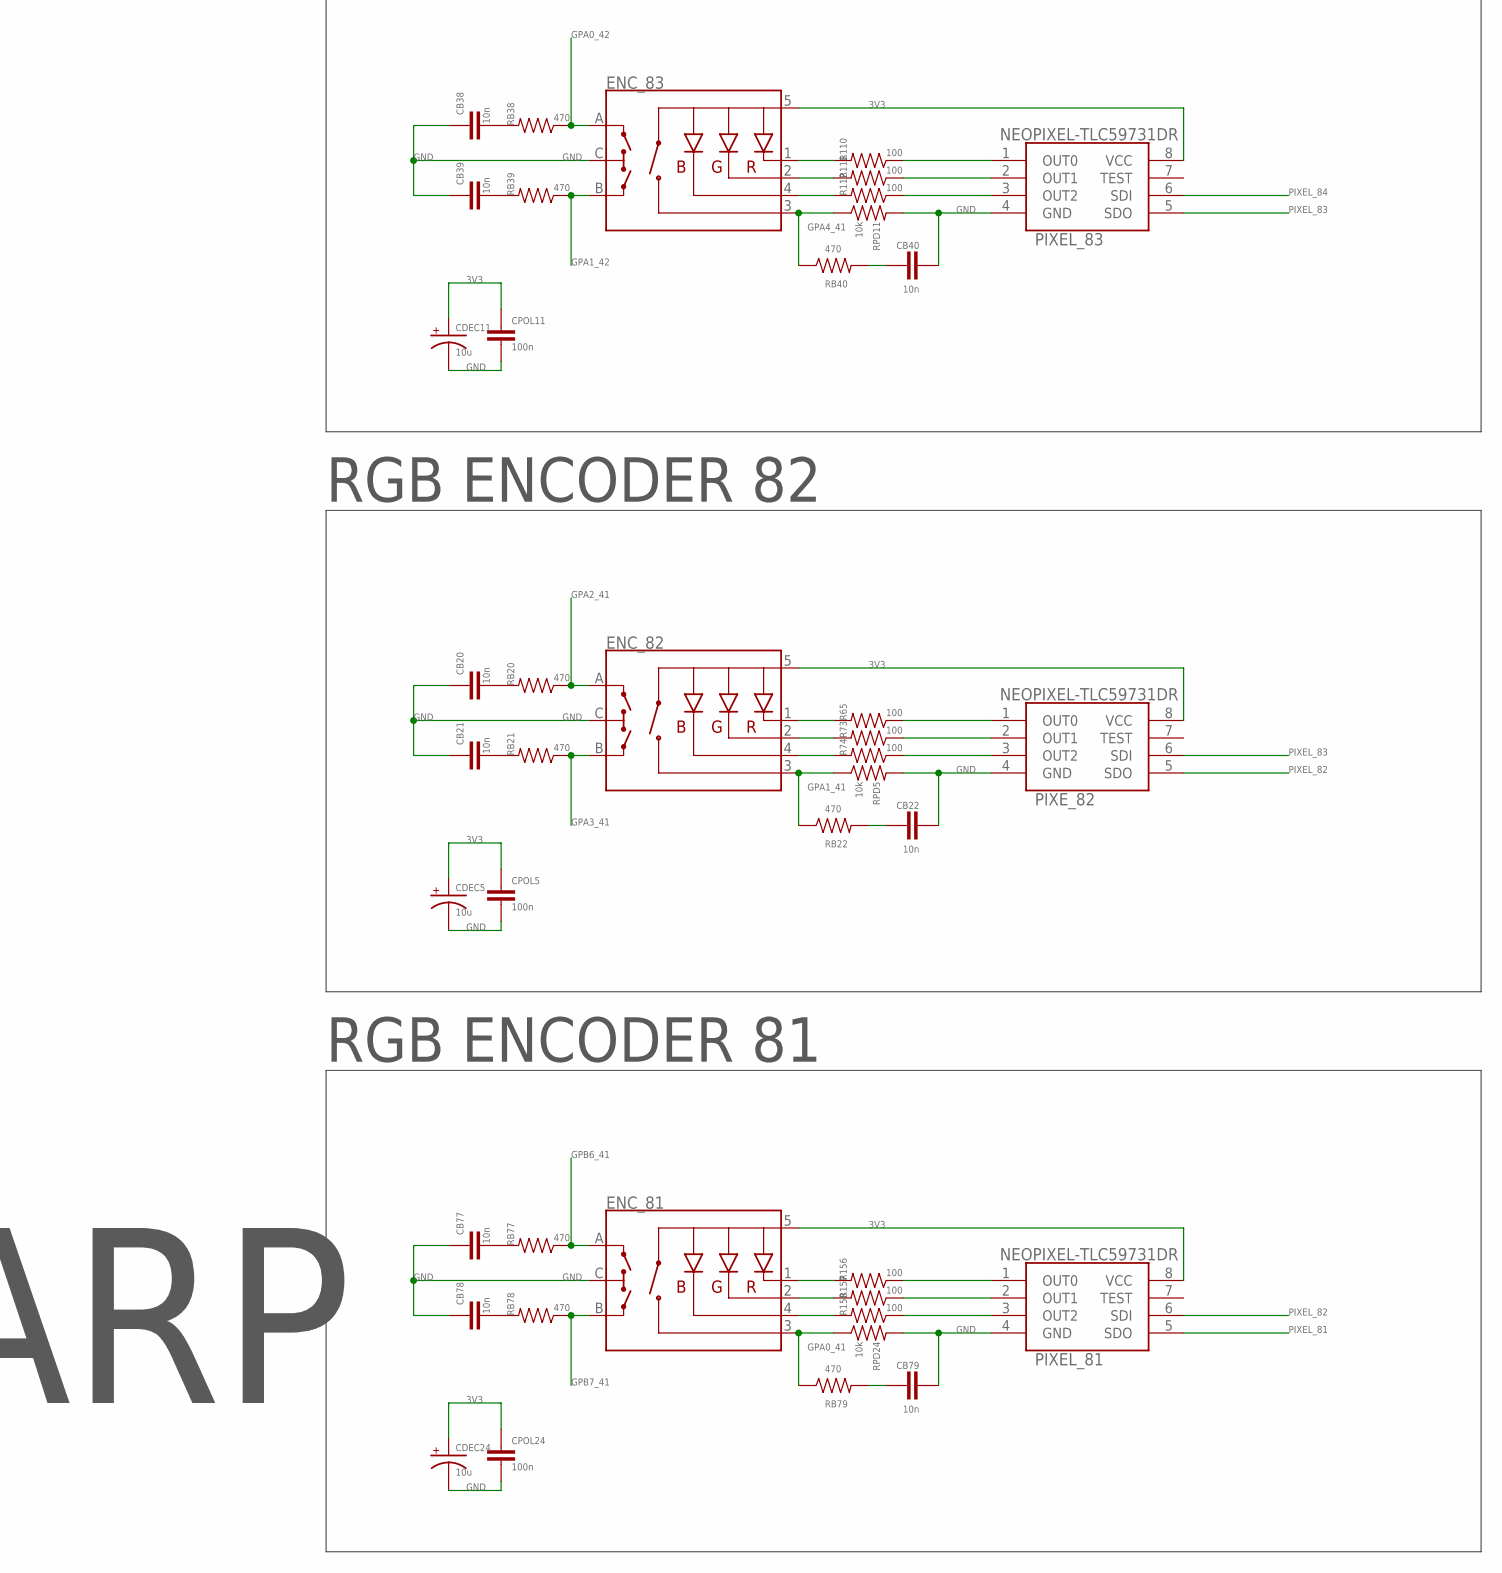
[picture p200: schematic STM32F446 front pane - v3.1.sch, sheet 6, part in row 3, column 2]

Parts:
CB20, CB21, CB22, CB38, CB39, CB40, CB50, CB51, CB52, CB62, CB63, CB64, CB74, CB75, CB76, CB77, CB78, CB79, CB83, CB84, CB85, CB89, CB90, CB91: 10n; 0805-CAP
CDEC5, CDEC11, CDEC15, CDEC19, CDEC23, CDEC24, CDEC26, CDEC28: 10u; CPOL2917
CDEC_41A, CDEC_42A: 10u; CPOL2917
CDEC_41B, CDEC_42B: 100n; 0805-CAP
CPOL5, CPOL11, CPOL15, CPOL19, CPOL23, CPOL24, CPOL26, CPOL28: 100n; 0805-CAP
ENC_81, ENC_82, ENC_83, ENC_84, ENC_85, ENC_86, ENC_87, ENC_88: ENCODER-RGB-SWITCH-NO_NUT; ENCODER_LED_3
MCP_101, MCP_110: MCP23017; SOIC-28
PIXEL_81, PIXEL_83, PIXEL_84, PIXEL_85, PIXEL_86, PIXEL_87, PIXEL_88: NEOPIXEL-TLC59731DR; SOIC127P600X175-8N
PIXE_82: NEOPIXEL-TLC59731DR; SOIC127P600X175-8N
R65, R73, R74, R110, R111, R112, R129, R130, R131, R141, R142, R143, R153, R154, R155, R156, R157, R158, R162, R163, R164, R168, R169, R170: 100; 1206
R194, R198, R199, R203: 1k; R0805
RB20, RB21, RB22, RB38, RB39, RB40, RB50, RB51, RB52, RB62, RB63, RB64, RB74, RB75, RB76, RB77, RB78, RB79, RB83, RB84, RB85, RB89, RB90, RB91: 470; 1206
RPD5, RPD11, RPD15, RPD19, RPD23, RPD24, RPD26, RPD28: 10k; 1206
TFT_EXT: MA06-2

Connections:
3V3: CDEC5.+, CDEC11.+, CDEC15.+, CDEC19.+, CDEC23.+, CDEC24.+, CDEC26.+, CDEC28.+, CDEC_41A.+, CDEC_41B.1, CDEC_42A.+, CDEC_42B.1, CPOL5.1, CPOL11.1, CPOL15.1, CPOL19.1, CPOL23.1, CPOL24.1, CPOL26.1, CPOL28.1, ENC_81.5 (+), ENC_82.5 (+), ENC_83.5 (+), ENC_84.5 (+), ENC_85.5 (+), ENC_86.5 (+), ENC_87.5 (+), ENC_88.5 (+), MCP_101.9 (VDD), MCP_101.15 (A0), MCP_101.17 (A2), MCP_110.9 (VDD), MCP_110.16 (A1), MCP_110.17 (A2), PIXEL_81.8 (VCC), PIXEL_83.8 (VCC), PIXEL_84.8 (VCC), PIXEL_85.8 (VCC), PIXEL_86.8 (VCC), PIXEL_87.8 (VCC), PIXEL_88.8 (VCC), PIXE_82.8 (VCC), R194.2, R198.2, R199.2, R203.2, TFT_EXT.1; also elsewhere on the board
GND: CB20.1, CB21.1, CB22.2, CB38.1, CB39.1, CB40.2, CB50.1, CB51.1, CB52.2, CB62.1, CB63.1, CB64.2, CB74.1, CB75.1, CB76.2, CB77.1, CB78.1, CB79.2, CB83.1, CB84.1, CB85.2, CB89.1, CB90.1, CB91.2, CDEC5.-, CDEC11.-, CDEC15.-, CDEC19.-, CDEC23.-, CDEC24.-, CDEC26.-, CDEC28.-, CDEC_41A.-, CDEC_41B.2, CDEC_42A.-, CDEC_42B.2, CPOL5.2, CPOL11.2, CPOL15.2, CPOL19.2, CPOL23.2, CPOL24.2, CPOL26.2, CPOL28.2, ENC_81.C, ENC_82.C, ENC_83.C, ENC_84.C, ENC_85.C, ENC_86.C, ENC_87.C, ENC_88.C, MCP_101.10 (VSS), MCP_101.16 (A1), MCP_110.10 (VSS), MCP_110.15 (A0), PIXEL_81.4 (GND), PIXEL_83.4 (GND), PIXEL_84.4 (GND), PIXEL_85.4 (GND), PIXEL_86.4 (GND), PIXEL_87.4 (GND), PIXEL_88.4 (GND), PIXE_82.4 (GND), RPD5.2, RPD11.2, RPD15.2, RPD19.2, RPD23.2, RPD24.2, RPD26.2, RPD28.2, TFT_EXT.7; also elsewhere on the board
GPA0_41: ENC_81.3 (SW), MCP_101.21 (GPA0), RB79.1, RPD24.1
GPA0_42: ENC_83.A, MCP_110.21 (GPA0), RB38.1
GPA1_41: ENC_82.3 (SW), MCP_101.22 (GPA1), RB22.1, RPD5.1
GPA1_42: ENC_83.B, MCP_110.22 (GPA1), RB39.1
GPA2_41: ENC_82.A, MCP_101.23 (GPA2), RB20.1
GPA2_42: ENC_84.A, MCP_110.23 (GPA2), RB50.1
GPA3_41: ENC_82.B, MCP_101.24 (GPA3), RB21.1
GPA3_42: ENC_84.B, MCP_110.24 (GPA3), RB51.1
GPA4_5: ENC_86.A, RB74.1; also elsewhere on the board
GPA4_41: ENC_83.3 (SW), MCP_101.25 (GPA4), RB40.1, RPD11.1
GPA4_42: ENC_84.3 (SW), MCP_110.25 (GPA4), RB52.1, RPD15.1
GPA5_5: ENC_86.B, RB75.1; also elsewhere on the board
GPA5_41: MCP_101.26 (GPA5), TFT_EXT.5
GPA5_42: ENC_85.A, MCP_110.26 (GPA5), RB62.1
GPA6_5: ENC_86.3 (SW), RB76.1, RPD23.1; also elsewhere on the board
GPA6_41: MCP_101.27 (GPA6), TFT_EXT.3
GPA6_42: ENC_85.B, MCP_110.27 (GPA6), RB63.1
GPA7_5: ENC_87.3 (SW), RB85.1, RPD26.1; also elsewhere on the board
GPA7_41: MCP_101.28 (GPA7), TFT_EXT.2
GPA7_42: ENC_85.3 (SW), MCP_110.28 (GPA7), RB64.1, RPD19.1
GPB0_5: ENC_87.B, RB84.1; also elsewhere on the board
GPB0_41: MCP_101.1 (GPB0), TFT_EXT.11
GPB0_42: MCP_110.1 (GPB0); also elsewhere on the board
GPB1_5: ENC_87.A, RB83.1; also elsewhere on the board
GPB1_41: MCP_101.2 (GPB1), TFT_EXT.12
GPB1_42: MCP_110.2 (GPB1); also elsewhere on the board
GPB2_5: ENC_88.3 (SW), RB91.1, RPD28.1; also elsewhere on the board
GPB2_41: MCP_101.3 (GPB2), TFT_EXT.10
GPB2_42: MCP_110.3 (GPB2); also elsewhere on the board
GPB3_5: ENC_88.A, RB89.1; also elsewhere on the board
GPB3_41: MCP_101.4 (GPB3), TFT_EXT.8
GPB3_42: MCP_110.4 (GPB3); also elsewhere on the board
GPB4_5: ENC_88.B, RB90.1; also elsewhere on the board
GPB4_41: MCP_101.5 (GPB4), TFT_EXT.6
GPB4_42: MCP_110.5 (GPB4); also elsewhere on the board
GPB5_41: MCP_101.6 (GPB5), TFT_EXT.4
GPB5_42: MCP_110.6 (GPB5); also elsewhere on the board
GPB6_41: ENC_81.A, MCP_101.7 (GPB6), RB77.1
GPB6_42: MCP_110.7 (GPB6); also elsewhere on the board
GPB7_41: ENC_81.B, MCP_101.8 (GPB7), RB78.1
GPB7_42: MCP_110.8 (GPB7); also elsewhere on the board
GPIO_EXTI0: MCP_101.19 (INTB); also elsewhere on the board
GPIO_EXTI2: MCP_110.19 (INTB); also elsewhere on the board
GPIO_EXTI3: MCP_110.20 (INTA); also elsewhere on the board
GPIO_EXTI13: MCP_101.20 (INTA); also elsewhere on the board
I2C1_SCL: MCP_101.12 (SCL), MCP_110.12 (SCL), R194.1, R199.1; also elsewhere on the board
I2C1_SDA: MCP_101.13 (SDA), MCP_110.13 (SDA), R198.1, R203.1; also elsewhere on the board
unnamed: ENC_82.1 (-R), R65.2
unnamed: ENC_82.2 (-G), R73.2
unnamed: ENC_82.4 (-B), R74.2
unnamed: PIXE_82.1 (OUT0), R65.1
unnamed: PIXE_82.2 (OUT1), R73.1
unnamed: PIXE_82.3 (OUT2), R74.1
unnamed: CB20.2, RB20.2
unnamed: CB21.2, RB21.2
unnamed: CB22.1, RB22.2
unnamed: ENC_83.1 (-R), R110.2
unnamed: ENC_83.2 (-G), R111.2
unnamed: ENC_83.4 (-B), R112.2
unnamed: PIXEL_83.1 (OUT0), R110.1
unnamed: PIXEL_83.2 (OUT1), R111.1
unnamed: PIXEL_83.3 (OUT2), R112.1
unnamed: CB38.2, RB38.2
unnamed: CB39.2, RB39.2
unnamed: CB40.1, RB40.2
unnamed: ENC_84.1 (-R), R129.2
unnamed: ENC_84.2 (-G), R130.2
unnamed: ENC_84.4 (-B), R131.2
unnamed: PIXEL_84.1 (OUT0), R129.1
unnamed: PIXEL_84.2 (OUT1), R130.1
unnamed: PIXEL_84.3 (OUT2), R131.1
unnamed: CB50.2, RB50.2
unnamed: CB51.2, RB51.2
unnamed: CB52.1, RB52.2
unnamed: ENC_85.1 (-R), R141.2
unnamed: ENC_85.2 (-G), R142.2
unnamed: ENC_85.4 (-B), R143.2
unnamed: PIXEL_85.1 (OUT0), R141.1
unnamed: PIXEL_85.2 (OUT1), R142.1
unnamed: PIXEL_85.3 (OUT2), R143.1
unnamed: CB62.2, RB62.2
unnamed: CB63.2, RB63.2
unnamed: CB64.1, RB64.2
unnamed: ENC_86.1 (-R), R153.2
unnamed: ENC_86.2 (-G), R154.2
unnamed: ENC_86.4 (-B), R155.2
unnamed: PIXEL_86.1 (OUT0), R153.1
unnamed: PIXEL_86.2 (OUT1), R154.1
unnamed: PIXEL_86.3 (OUT2), R155.1
unnamed: CB74.2, RB74.2
unnamed: CB75.2, RB75.2
unnamed: CB76.1, RB76.2
unnamed: ENC_81.1 (-R), R156.2
unnamed: ENC_81.2 (-G), R157.2
unnamed: ENC_81.4 (-B), R158.2
unnamed: PIXEL_81.1 (OUT0), R156.1
unnamed: PIXEL_81.2 (OUT1), R157.1
unnamed: PIXEL_81.3 (OUT2), R158.1
unnamed: CB77.2, RB77.2
unnamed: CB78.2, RB78.2
unnamed: CB79.1, RB79.2
unnamed: ENC_87.1 (-R), R162.2
unnamed: ENC_87.2 (-G), R163.2
unnamed: ENC_87.4 (-B), R164.2
unnamed: PIXEL_87.1 (OUT0), R162.1
unnamed: PIXEL_87.2 (OUT1), R163.1
unnamed: PIXEL_87.3 (OUT2), R164.1
unnamed: CB83.2, RB83.2
unnamed: CB84.2, RB84.2
unnamed: CB85.1, RB85.2
unnamed: ENC_88.1 (-R), R168.2
unnamed: ENC_88.2 (-G), R169.2
unnamed: ENC_88.4 (-B), R170.2
unnamed: PIXEL_88.1 (OUT0), R168.1
unnamed: PIXEL_88.2 (OUT1), R169.1
unnamed: PIXEL_88.3 (OUT2), R170.1
unnamed: CB89.2, RB89.2
unnamed: CB90.2, RB90.2
unnamed: CB91.1, RB91.2
PIXEL_75: PIXEL_88.6 (SDI); also elsewhere on the board
PIXEL_81: PIXEL_81.5 (SDO), TFT_EXT.9
PIXEL_82: PIXEL_81.6 (SDI), PIXE_82.5 (SDO)
PIXEL_83: PIXEL_83.5 (SDO), PIXE_82.6 (SDI)
PIXEL_84: PIXEL_83.6 (SDI), PIXEL_84.5 (SDO)
PIXEL_85: PIXEL_84.6 (SDI), PIXEL_85.5 (SDO)
PIXEL_86: PIXEL_85.6 (SDI), PIXEL_86.5 (SDO)
PIXEL_87: PIXEL_86.6 (SDI), PIXEL_87.5 (SDO)
PIXEL_88: PIXEL_87.6 (SDI), PIXEL_88.5 (SDO)
RST: MCP_101.18 (!RESET), MCP_110.18 (!RESET); also elsewhere on the board

Notes on the sheet:
ARP
RGB ENCODER 81
RGB ENCODER 82
RGB ENCODER 83
RGB ENCODER 84
RGB ENCODER 85
RGB ENCODER 86
RGB ENCODER 87
RGB ENCODER 88
MCP 41 & 42

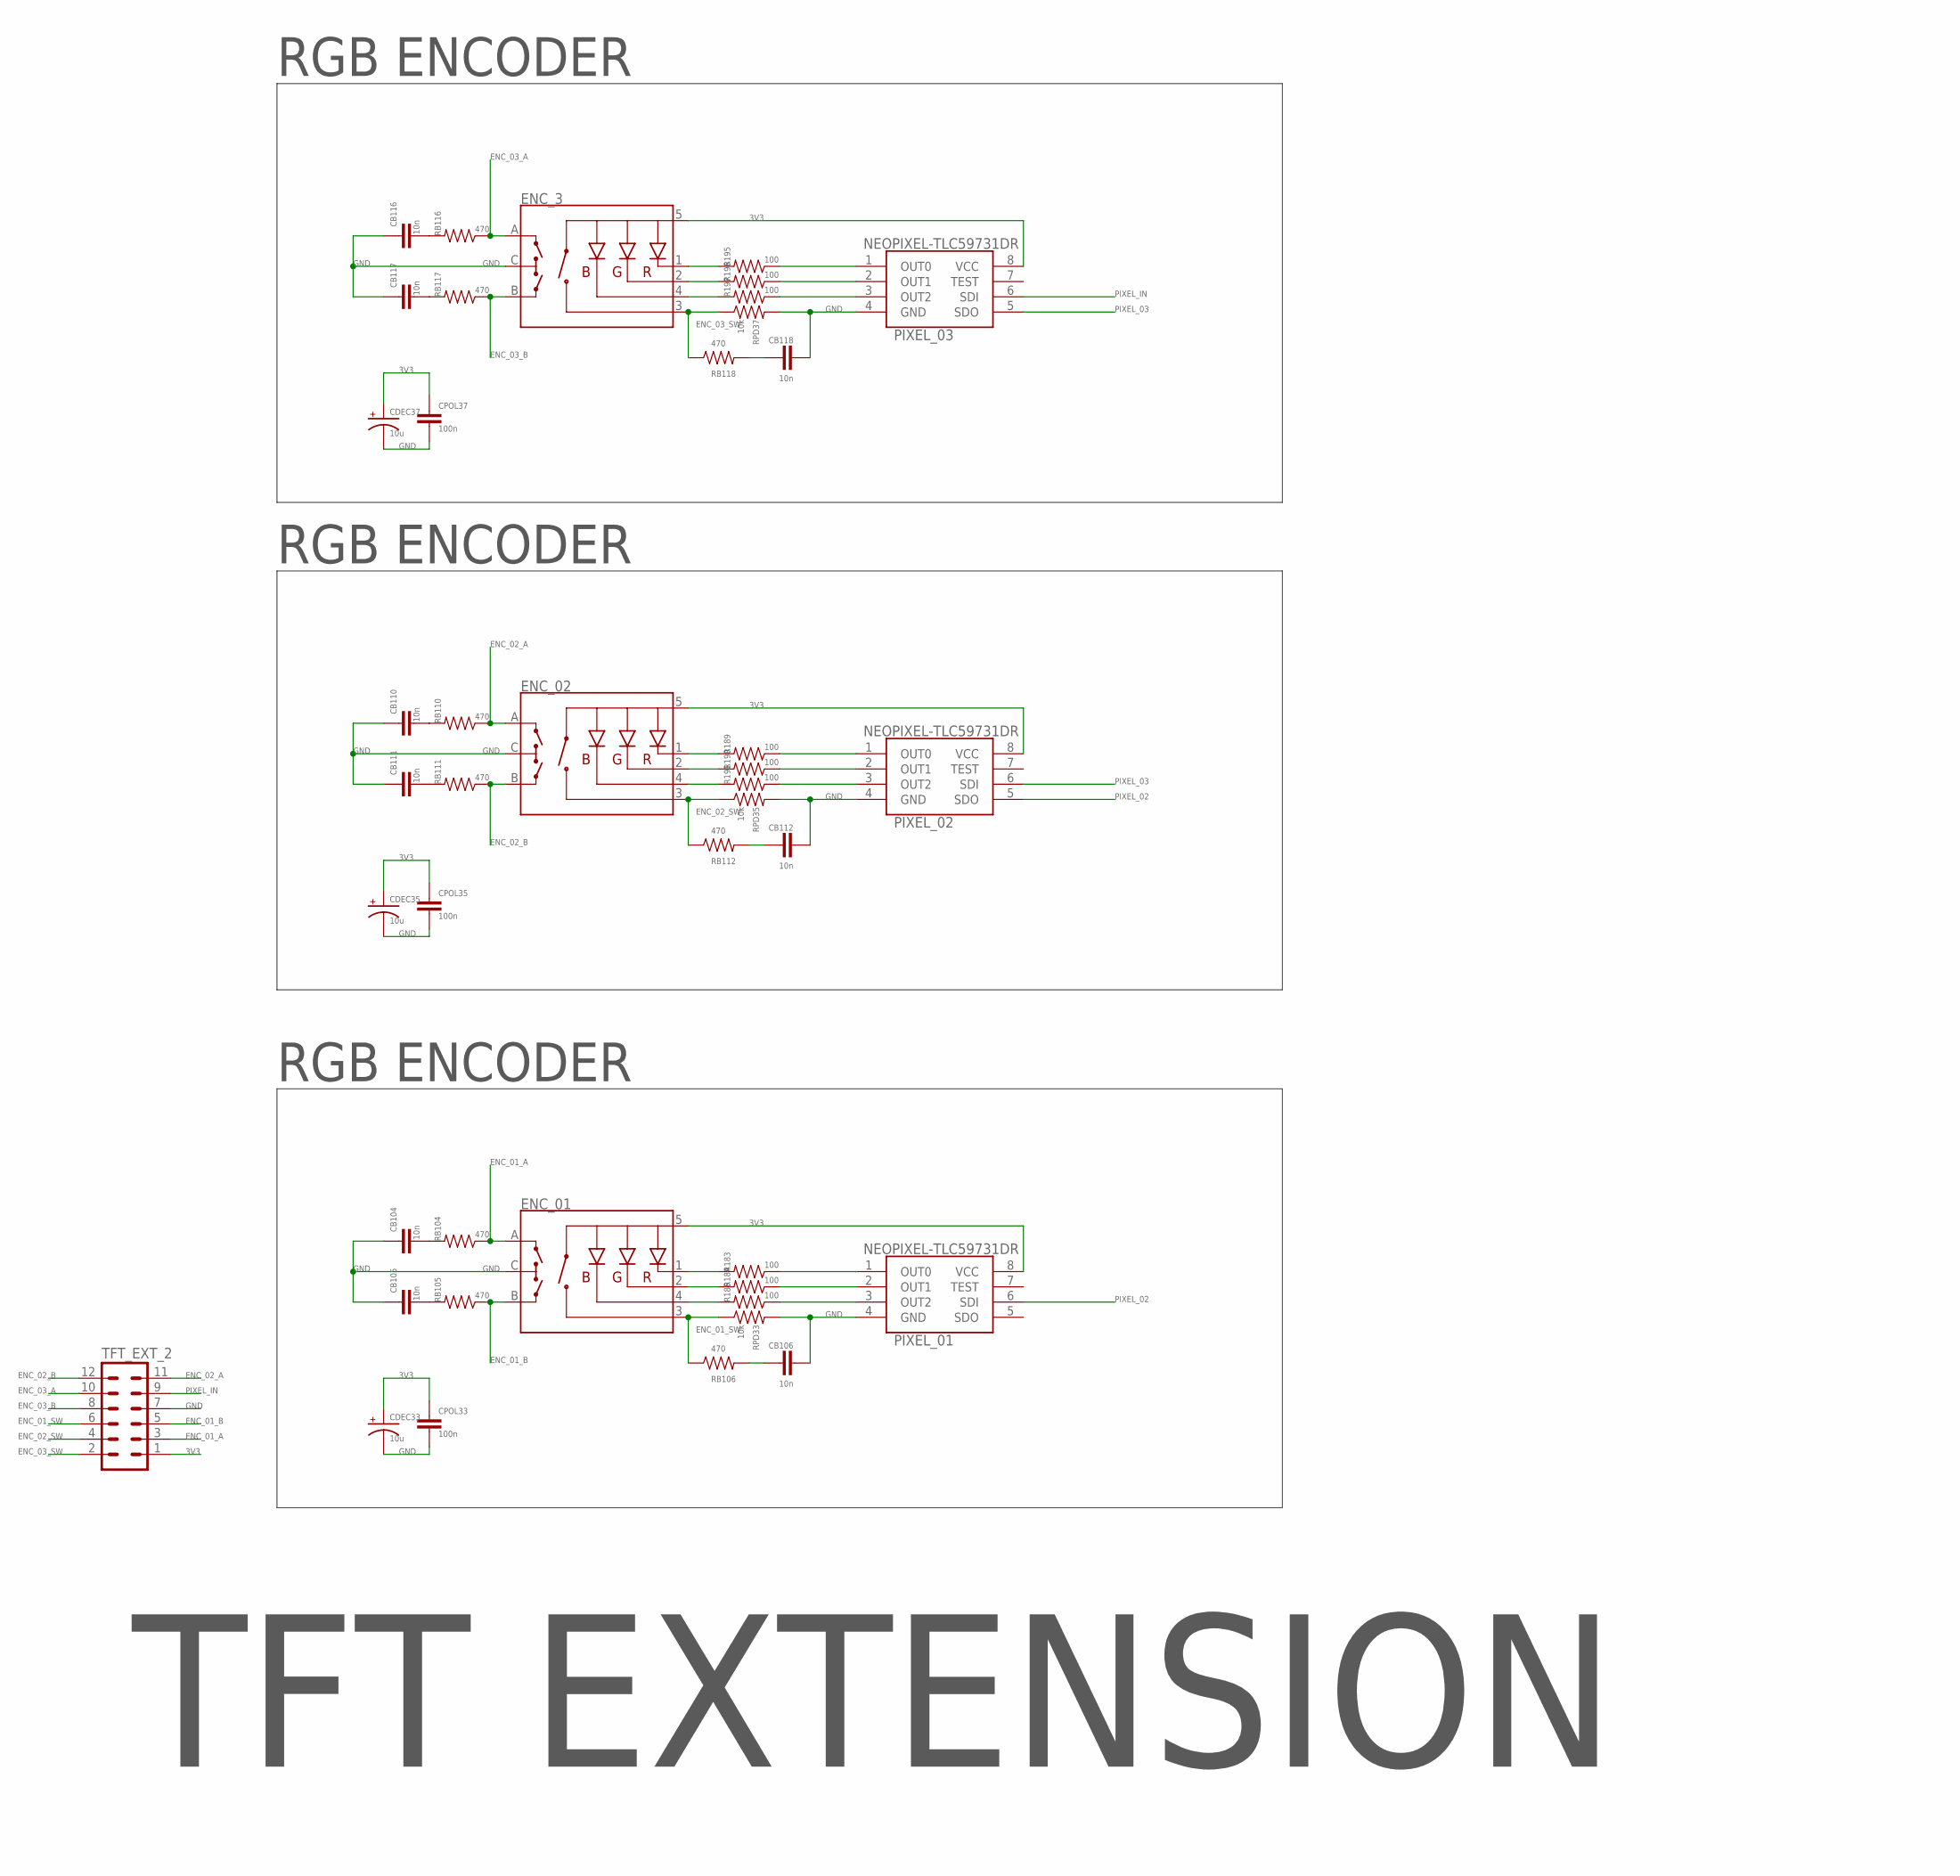
[picture p201: schematic STM32F446 front pane - v3.1.sch, sheet 7]

Parts:
CB104, CB105, CB106, CB110, CB111, CB112, CB116, CB117, CB118: 10n; 0805-CAP
CDEC33, CDEC35, CDEC37: 10u; CPOL2917
CPOL33, CPOL35, CPOL37: 100n; 0805-CAP
ENC_01, ENC_02, ENC_3: ENCODER-RGB-SWITCH-NO_NUT; ENCODER_LED_3
PIXEL_01, PIXEL_02, PIXEL_03: NEOPIXEL-TLC59731DR; SOIC127P600X175-8N
R183, R184, R185, R189, R190, R191, R195, R196, R197: 100; 1206
RB104, RB105, RB106, RB110, RB111, RB112, RB116, RB117, RB118: 470; 1206
RPD33, RPD35, RPD37: 10k; 1206
TFT_EXT_2: MA06-2

Connections:
3V3: CDEC33.+, CDEC35.+, CDEC37.+, CPOL33.1, CPOL35.1, CPOL37.1, ENC_01.5 (+), ENC_02.5 (+), ENC_3.5 (+), PIXEL_01.8 (VCC), PIXEL_02.8 (VCC), PIXEL_03.8 (VCC), TFT_EXT_2.1; also elsewhere on the board
ENC_01_A: ENC_01.A, RB104.1, TFT_EXT_2.3
ENC_01_B: ENC_01.B, RB105.1, TFT_EXT_2.5
ENC_01_SW: ENC_01.3 (SW), RB106.1, RPD33.1, TFT_EXT_2.6
ENC_02_A: ENC_02.A, RB110.1, TFT_EXT_2.11
ENC_02_B: ENC_02.B, RB111.1, TFT_EXT_2.12
ENC_02_SW: ENC_02.3 (SW), RB112.1, RPD35.1, TFT_EXT_2.4
ENC_03_A: ENC_3.A, RB116.1, TFT_EXT_2.10
ENC_03_B: ENC_3.B, RB117.1, TFT_EXT_2.8
ENC_03_SW: ENC_3.3 (SW), RB118.1, RPD37.1, TFT_EXT_2.2
GND: CB104.1, CB105.1, CB106.2, CB110.1, CB111.1, CB112.2, CB116.1, CB117.1, CB118.2, CDEC33.-, CDEC35.-, CDEC37.-, CPOL33.2, CPOL35.2, CPOL37.2, ENC_01.C, ENC_02.C, ENC_3.C, PIXEL_01.4 (GND), PIXEL_02.4 (GND), PIXEL_03.4 (GND), RPD33.2, RPD35.2, RPD37.2, TFT_EXT_2.7; also elsewhere on the board
unnamed: ENC_01.1 (-R), R183.2
unnamed: ENC_01.2 (-G), R184.2
unnamed: ENC_01.4 (-B), R185.2
unnamed: PIXEL_01.1 (OUT0), R183.1
unnamed: PIXEL_01.2 (OUT1), R184.1
unnamed: PIXEL_01.3 (OUT2), R185.1
unnamed: CB104.2, RB104.2
unnamed: CB105.2, RB105.2
unnamed: CB106.1, RB106.2
unnamed: ENC_02.1 (-R), R189.2
unnamed: ENC_02.2 (-G), R190.2
unnamed: ENC_02.4 (-B), R191.2
unnamed: PIXEL_02.1 (OUT0), R189.1
unnamed: PIXEL_02.2 (OUT1), R190.1
unnamed: PIXEL_02.3 (OUT2), R191.1
unnamed: CB110.2, RB110.2
unnamed: CB111.2, RB111.2
unnamed: CB112.1, RB112.2
unnamed: ENC_3.1 (-R), R195.2
unnamed: ENC_3.2 (-G), R196.2
unnamed: ENC_3.4 (-B), R197.2
unnamed: PIXEL_03.1 (OUT0), R195.1
unnamed: PIXEL_03.2 (OUT1), R196.1
unnamed: PIXEL_03.3 (OUT2), R197.1
unnamed: CB116.2, RB116.2
unnamed: CB117.2, RB117.2
unnamed: CB118.1, RB118.2
PIXEL_02: PIXEL_01.6 (SDI), PIXEL_02.5 (SDO)
PIXEL_03: PIXEL_02.6 (SDI), PIXEL_03.5 (SDO)
PIXEL_IN: PIXEL_03.6 (SDI), TFT_EXT_2.9

Notes on the sheet:
TFT EXTENSION
RGB ENCODER

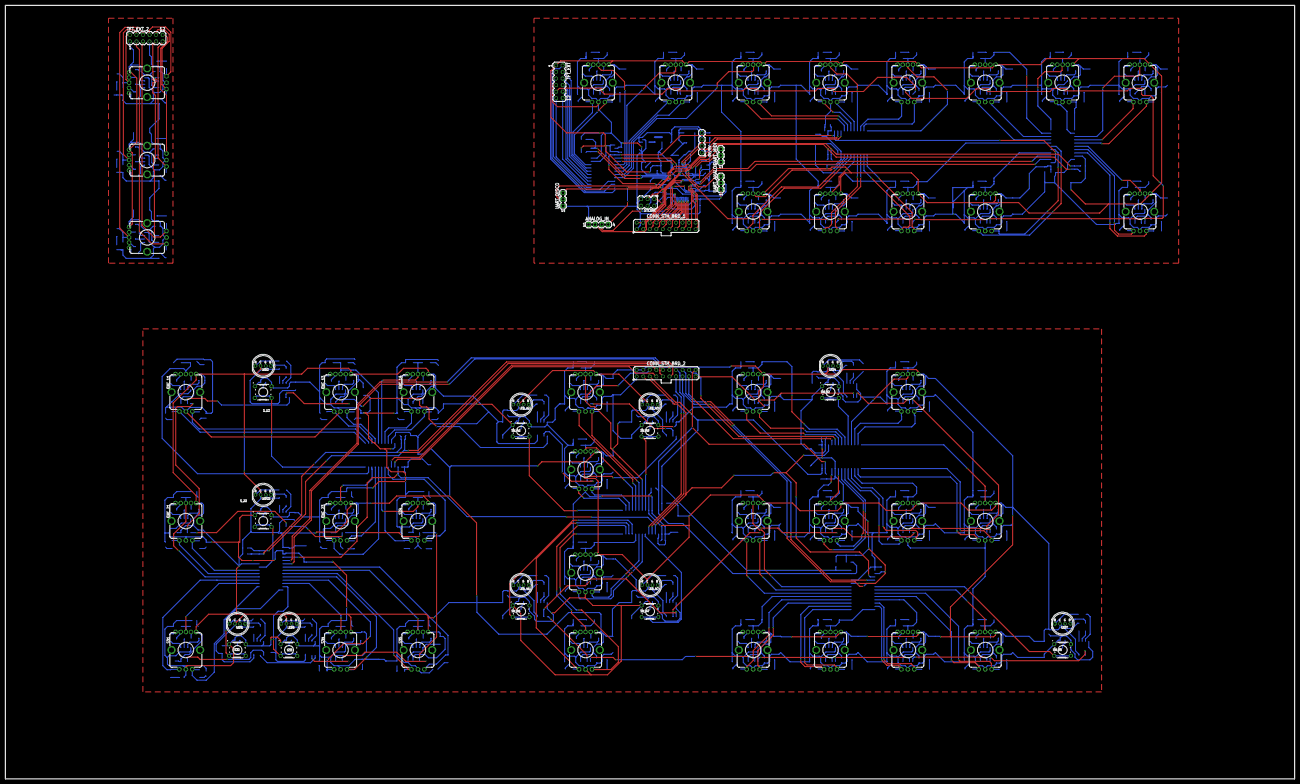
[picture p202: board STM32F446 front pane - v3.1.brd from above]

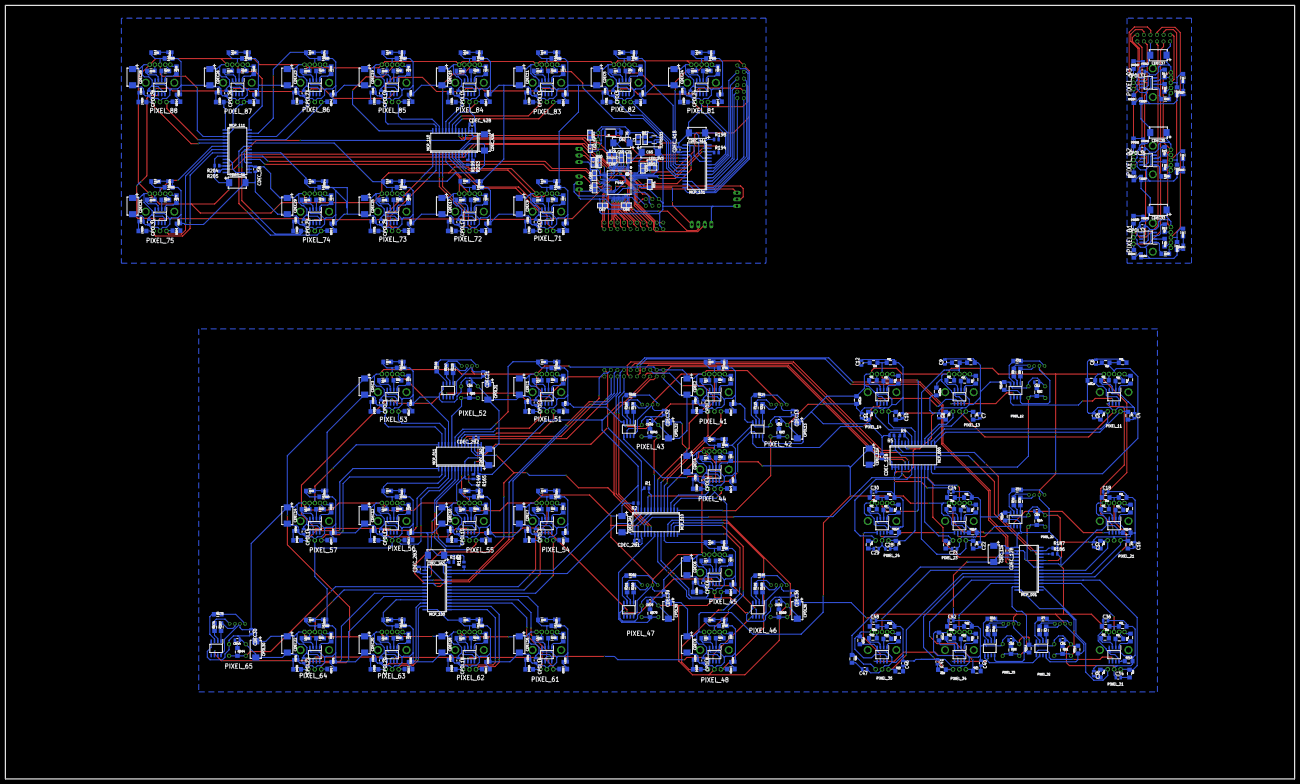
[picture p203: board STM32F446 front pane - v3.1.brd from below]

Board: 2 copper layers, 500.0 x 300.0 mm, 707 parts (638 on the bottom side), 663 nets.
