reynal/themis/front-pane/eagle-schematics/v3/STM32F446 front pane - south - v3.brd

## EAGLE design front-pane/eagle-schematics/v3/STM32F446 front pane - south - v3.brd (2022-02-19)

Schematic: STM32F446 front pane - south - v3.sch, sheet 1

Parts:
C1, C4: 100n; 0805-CAP
C2, C3: 10u; CPOL2917
C5, C6, C7, C8, C9, C10, C11, C12, C13, C14, C20, C21, C22, C23, C24, C25, C26, C27, C28, C29, C34, C35, C36, C37, C38, C39, C40, C41, C42, C43, C44: 10n; 0805-CAP
C15, C16, C17, C18, C19, C30, C31, C32, C33, C45, C46, C47, C48: 100n; 1206
CON_NORTH_BRD: MA10-2
D1, D2, D3, D4: CZXR-80RGB03-A; LED4-2.0-D8.0MM
IC1, IC2, IC3, IC4, IC5, IC6, IC7, IC8, IC9, IC10, IC11, IC12, IC13: NEOPIXEL-TLC59731DR; SOIC127P600X175-8N
MCP_000, MCP_001: MCP23017; SOIC-28
R1, R2, R3, R4: 1k; R0805
R5, R6, R7, R8, R9, R10, R11, R12, R13, R14, R30, R31, R32, R33, R34, R35, R36, R37, R38, R39, R55, R56, R57, R58, R59, R60, R61, R62, R63, R64, R65: 470; 1206
R15, R16, R17, R19, R20, R21, R23, R24, R25, R27, R28, R29, R40, R41, R42, R44, R45, R46, R48, R49, R50, R52, R53, R54, R66, R67, R68, R70, R71, R72, R74, R75, R76, R78, R79, R80, R81, R82, R83: 100; 1206
R18, R22, R26, R43, R47, R51, R69, R73, R77: 10k; 1206
S1, S2, S3, S4, S5, S6, S7, S8, S9: ENCODER-RGB-SWITCH-NO_NUT; ENCODER_LED_3
SW1, SW2, SW3, SW4: B3F-1000

Connections:
3V3: C1.1, C2.+, C3.+, C4.1, C15.1, C16.1, C17.1, C18.1, C19.1, C30.1, C31.1, C32.1, C33.1, C45.1, C46.1, C47.1, C48.1, CON_NORTH_BRD.2, CON_NORTH_BRD.4, D1.2 (+), D2.2 (+), D3.2 (+), D4.2 (+), IC1.8 (VCC), IC2.8 (VCC), IC3.8 (VCC), IC4.8 (VCC), IC5.8 (VCC), IC6.8 (VCC), IC7.8 (VCC), IC8.8 (VCC), IC9.8 (VCC), IC10.8 (VCC), IC11.8 (VCC), IC12.8 (VCC), IC13.8 (VCC), MCP_000.9 (VDD), MCP_001.9 (VDD), MCP_001.15 (A0), R1.2, R2.2, R3.2, R4.2, S1.5 (+), S2.5 (+), S3.5 (+), S4.5 (+), S5.5 (+), S6.5 (+), S7.5 (+), S8.5 (+), S9.5 (+); also elsewhere on the board
DATA_PIXEL11: IC4.5 (SDO), IC8.6 (SDI)
DATA_PIXEL12: IC1.5 (SDO), IC4.6 (SDI)
DATA_PIXEL13: IC1.6 (SDI), IC3.5 (SDO)
DATA_PIXEL14: IC2.5 (SDO), IC3.6 (SDI)
DATA_PIXEL21: IC7.6 (SDI), IC8.5 (SDO)
DATA_PIXEL22: IC6.6 (SDI), IC7.5 (SDO)
DATA_PIXEL23: IC5.6 (SDI), IC6.5 (SDO)
DATA_PIXEL24: IC5.5 (SDO), IC9.6 (SDI)
DATA_PIXEL32: IC12.5 (SDO), IC13.6 (SDI)
DATA_PIXEL33: IC11.5 (SDO), IC12.6 (SDI)
DATA_PIXEL34: IC10.5 (SDO), IC11.6 (SDI)
DATA_PIXEL35: IC9.5 (SDO), IC10.6 (SDI)
GND: C1.2, C2.-, C3.-, C4.2, C5.1, C6.1, C7.1, C8.1, C9.1, C10.1, C11.1, C12.2, C13.2, C14.2, C15.2, C16.2, C17.2, C18.2, C19.2, C20.1, C21.1, C22.1, C23.1, C24.1, C25.1, C26.1, C27.2, C28.2, C29.2, C30.2, C31.2, C32.2, C33.2, C34.1, C35.1, C36.1, C37.1, C38.1, C39.1, C40.1, C41.1, C42.2, C43.2, C44.2, C45.2, C46.2, C47.2, C48.2, CON_NORTH_BRD.1, IC1.4 (GND), IC2.4 (GND), IC3.4 (GND), IC4.4 (GND), IC5.4 (GND), IC6.4 (GND), IC7.4 (GND), IC8.4 (GND), IC9.4 (GND), IC10.4 (GND), IC11.4 (GND), IC12.4 (GND), IC13.4 (GND), MCP_000.10 (VSS), MCP_000.15 (A0), MCP_000.16 (A1), MCP_000.17 (A2), MCP_001.10 (VSS), MCP_001.16 (A1), MCP_001.17 (A2), R18.2, R22.2, R26.2, R43.2, R47.2, R51.2, R69.2, R73.2, R77.2, S1.C, S2.C, S3.C, S4.C, S5.C, S6.C, S7.C, S8.C, S9.C, SW1.1, SW1.2, SW2.1, SW2.2, SW3.1, SW3.2, SW4.1, SW4.2; also elsewhere on the board
GPA0_11: MCP_000.21 (GPA0), R32.1, S4.B
GPA0_12: MCP_001.21 (GPA0), R58.1, S7.B
GPA1_11: MCP_000.22 (GPA1), R31.1, S4.A
GPA1_12: MCP_001.22 (GPA1), R63.1, R69.1, S7.3 (SW)
GPA2_11: MCP_000.23 (GPA2), R37.1, R43.1, S4.3 (SW)
GPA2_12: MCP_001.23 (GPA2), R57.1, S7.A
GPA3_11: MCP_000.24 (GPA3), R33.1, S5.A
GPA3_12: MCP_001.24 (GPA3), R60.1, S8.B
GPA4_11: MCP_000.25 (GPA4), R34.1, S5.B
GPA4_12: MCP_001.25 (GPA4), R59.1, S8.A
GPA5_11: MCP_000.26 (GPA5), R38.1, R47.1, S5.3 (SW)
GPA5_12: MCP_001.26 (GPA5), R64.1, R73.1, S8.3 (SW)
GPA6_11: MCP_000.27 (GPA6), R14.1, R26.1, S3.3 (SW)
GPA6_12: MCP_001.27 (GPA6), R55.1, SW3.3, SW3.4
GPA7_11: MCP_000.28 (GPA7), R5.1, SW1.3, SW1.4
GPA7_12: MCP_001.28 (GPA7), R56.1, SW4.3, SW4.4
GPB0_11: MCP_000.1 (GPB0), R10.1, S3.A
GPB1_11: MCP_000.2 (GPB1), R11.1, S3.B
GPB1_12: MCP_001.2 (GPB1), R62.1, S9.B
GPB2_11: MCP_000.3 (GPB2), R8.1, S2.A
GPB2_12: MCP_001.3 (GPB2), R65.1, R77.1, S9.3 (SW)
GPB3_11: MCP_000.4 (GPB3), R9.1, S2.B
GPB3_12: MCP_001.4 (GPB3), R61.1, S9.A
GPB4_11: MCP_000.5 (GPB4), R13.1, R22.1, S2.3 (SW)
GPB4_12: MCP_001.5 (GPB4), R39.1, R51.1, S6.3 (SW)
GPB5_11: MCP_000.6 (GPB5), R12.1, R18.1, S1.3 (SW)
GPB5_12: MCP_001.6 (GPB5), R35.1, S6.A
GPB6_11: MCP_000.7 (GPB6), R6.1, S1.A
GPB6_12: MCP_001.7 (GPB6), R36.1, S6.B
GPB7_11: MCP_000.8 (GPB7), R7.1, S1.B
GPB7_12: MCP_001.8 (GPB7), R30.1, SW2.3, SW2.4
I2C2_SCL: CON_NORTH_BRD.20; also elsewhere on the board
I2C2_SDA: CON_NORTH_BRD.5; also elsewhere on the board
I2C3_SCL: CON_NORTH_BRD.12, MCP_000.12 (SCL), MCP_001.12 (SCL), R2.1, R4.1
I2C3_SDA: CON_NORTH_BRD.11, MCP_000.13 (SDA), MCP_001.13 (SDA), R1.1, R3.1
INTA_2: CON_NORTH_BRD.13; also elsewhere on the board
INTA_11: CON_NORTH_BRD.8, MCP_000.20 (INTA)
INTA_12: CON_NORTH_BRD.9, MCP_001.20 (INTA)
INTA_31: CON_NORTH_BRD.18; also elsewhere on the board
INTA_32: CON_NORTH_BRD.15; also elsewhere on the board
INTB_2: CON_NORTH_BRD.14; also elsewhere on the board
INTB_11: CON_NORTH_BRD.7, MCP_000.19 (INTB)
INTB_12: CON_NORTH_BRD.10, MCP_001.19 (INTB)
INTB_31: CON_NORTH_BRD.17; also elsewhere on the board
INTB_32: CON_NORTH_BRD.16; also elsewhere on the board
unnamed: IC12.1 (OUT0), R81.1
unnamed: IC12.2 (OUT1), R82.1
unnamed: R23.2, S3.1 (-R)
unnamed: R24.2, S3.2 (-G)
unnamed: R25.2, S3.4 (-B)
unnamed: IC4.1 (OUT0), R23.1
unnamed: IC4.2 (OUT1), R24.1
unnamed: IC4.3 (OUT2), R25.1
unnamed: C10.2, R10.2
unnamed: C11.2, R11.2
unnamed: C14.1, R14.2
unnamed: R19.2, S2.1 (-R)
unnamed: R20.2, S2.2 (-G)
unnamed: R21.2, S2.4 (-B)
unnamed: IC3.1 (OUT0), R19.1
unnamed: IC3.2 (OUT1), R20.1
unnamed: IC3.3 (OUT2), R21.1
unnamed: C8.2, R8.2
unnamed: C9.2, R9.2
unnamed: C13.1, R13.2
unnamed: R15.2, S1.1 (-R)
unnamed: R16.2, S1.2 (-G)
unnamed: R17.2, S1.4 (-B)
unnamed: IC2.1 (OUT0), R15.1
unnamed: IC2.2 (OUT1), R16.1
unnamed: IC2.3 (OUT2), R17.1
unnamed: C6.2, R6.2
unnamed: C7.2, R7.2
unnamed: C12.1, R12.2
unnamed: IC12.3 (OUT2), R83.1
unnamed: C35.2, R56.2
unnamed: D4.1 (R), R83.2
unnamed: D4.4 (B), R82.2
unnamed: D4.3 (G), R81.2
unnamed: IC1.1 (OUT0), R27.1
unnamed: IC1.2 (OUT1), R28.1
unnamed: IC1.3 (OUT2), R29.1
unnamed: C5.2, R5.2
unnamed: R48.2, S6.1 (-R)
unnamed: R49.2, S6.2 (-G)
unnamed: R50.2, S6.4 (-B)
unnamed: IC8.1 (OUT0), R48.1
unnamed: IC8.2 (OUT1), R49.1
unnamed: IC8.3 (OUT2), R50.1
unnamed: C25.2, R35.2
unnamed: C26.2, R36.2
unnamed: C29.1, R39.2
unnamed: D1.1 (R), R29.2
unnamed: D1.4 (B), R28.2
unnamed: D1.3 (G), R27.2
unnamed: R44.2, S5.1 (-R)
unnamed: R45.2, S5.2 (-G)
unnamed: R46.2, S5.4 (-B)
unnamed: IC6.1 (OUT0), R44.1
unnamed: IC6.2 (OUT1), R45.1
unnamed: IC6.3 (OUT2), R46.1
unnamed: C23.2, R33.2
unnamed: C24.2, R34.2
unnamed: C28.1, R38.2
unnamed: IC7.1 (OUT0), R52.1
unnamed: IC7.2 (OUT1), R53.1
unnamed: IC7.3 (OUT2), R54.1
unnamed: C20.2, R30.2
unnamed: D2.1 (R), R54.2
unnamed: D2.4 (B), R53.2
unnamed: D2.3 (G), R52.2
unnamed: R40.2, S4.1 (-R)
unnamed: R41.2, S4.2 (-G)
unnamed: R42.2, S4.4 (-B)
unnamed: IC5.1 (OUT0), R40.1
unnamed: IC5.2 (OUT1), R41.1
unnamed: IC5.3 (OUT2), R42.1
unnamed: C21.2, R31.2
unnamed: C22.2, R32.2
unnamed: C27.1, R37.2
unnamed: R74.2, S9.1 (-R)
unnamed: R75.2, S9.2 (-G)
unnamed: R76.2, S9.4 (-B)
unnamed: IC13.1 (OUT0), R74.1
unnamed: IC13.2 (OUT1), R75.1
unnamed: IC13.3 (OUT2), R76.1
unnamed: C40.2, R61.2
unnamed: C41.2, R62.2
unnamed: C44.1, R65.2
unnamed: IC11.1 (OUT0), R78.1
unnamed: IC11.2 (OUT1), R79.1
unnamed: IC11.3 (OUT2), R80.1
unnamed: C34.2, R55.2
unnamed: D3.1 (R), R80.2
unnamed: D3.4 (B), R79.2
unnamed: D3.3 (G), R78.2
unnamed: R70.2, S8.1 (-R)
unnamed: R71.2, S8.2 (-G)
unnamed: R72.2, S8.4 (-B)
unnamed: IC10.1 (OUT0), R70.1
unnamed: IC10.2 (OUT1), R71.1
unnamed: IC10.3 (OUT2), R72.1
unnamed: C38.2, R59.2
unnamed: C39.2, R60.2
unnamed: C43.1, R64.2
unnamed: R66.2, S7.1 (-R)
unnamed: R67.2, S7.2 (-G)
unnamed: R68.2, S7.4 (-B)
unnamed: IC9.1 (OUT0), R66.1
unnamed: IC9.2 (OUT1), R67.1
unnamed: IC9.3 (OUT2), R68.1
unnamed: C36.2, R57.2
unnamed: C37.2, R58.2
unnamed: C42.1, R63.2
PIXEL42: IC2.6 (SDI); also elsewhere on the board
RST: CON_NORTH_BRD.3, MCP_000.18 (!RESET), MCP_001.18 (!RESET); also elsewhere on the board
SPI1_MOSI: CON_NORTH_BRD.6; also elsewhere on the board
SPI3_MOSI: CON_NORTH_BRD.19; also elsewhere on the board

Notes on the sheet:
RGB ENCODER 11
RGB ENCODER 13
RGB ENCODER 14
RGB ENCODER 21
RGB ENCODER 23
RGB ENCODER 24
RGB ENCODER 31
RGB ENCODER 34
RGB ENCODER 35
OSCILLATORS
SWITCH RGB 12
SWITCH RGB 22
SWITCH RGB 33
SWITCH RGB 32
MCP 11 & 12

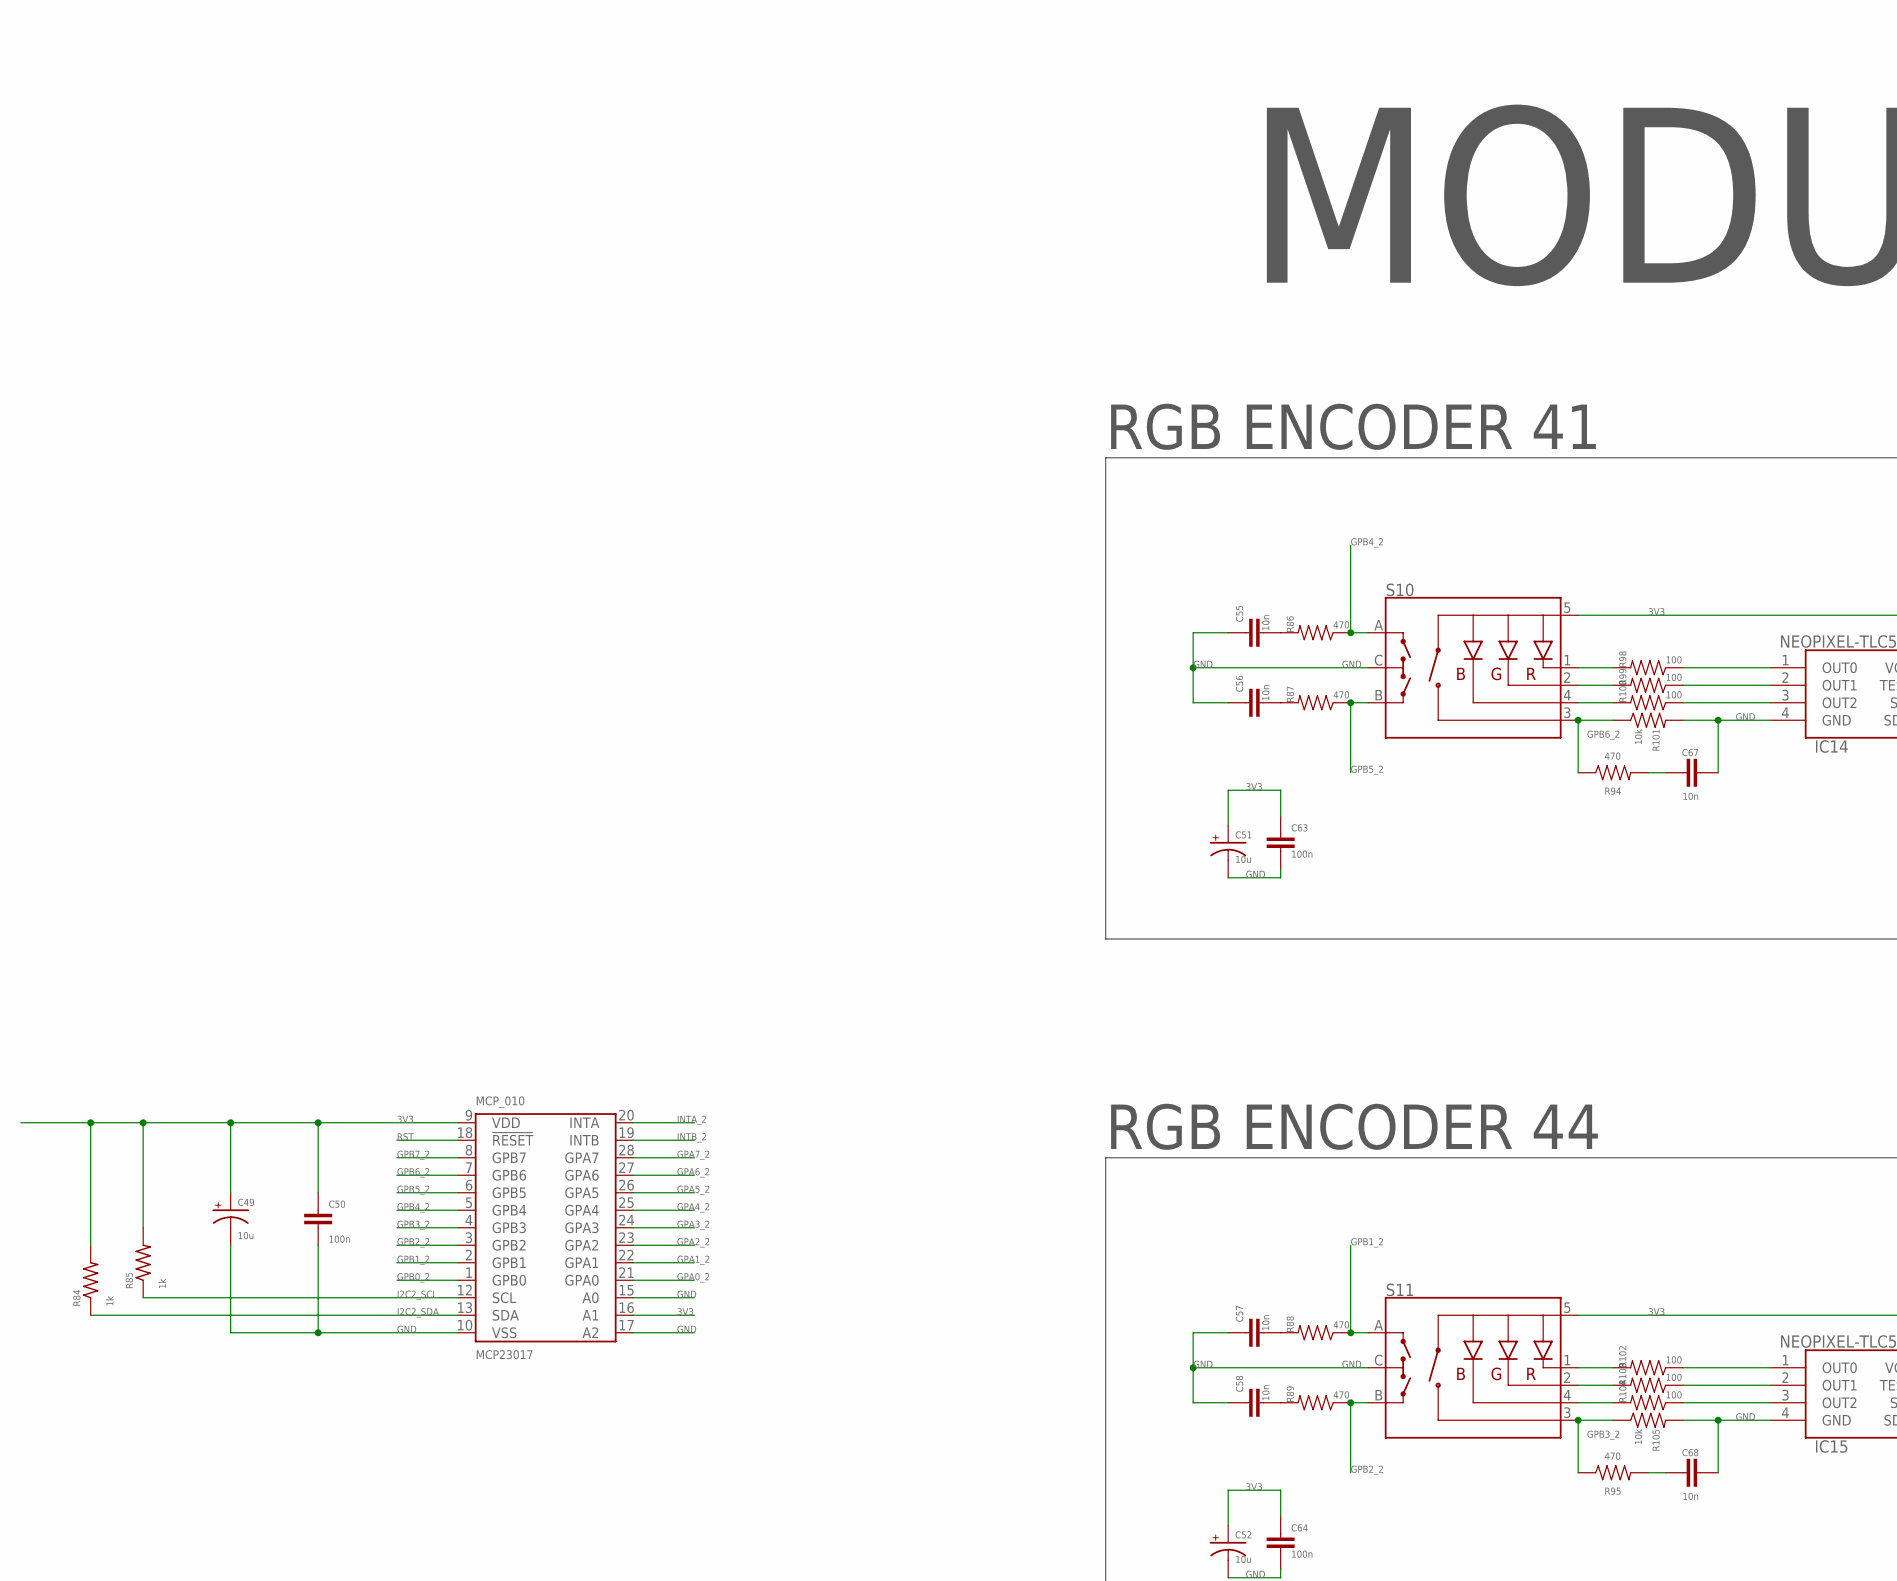
[picture p204: schematic STM32F446 front pane - south - v3.sch, sheet 2, part in row 1, column 1]

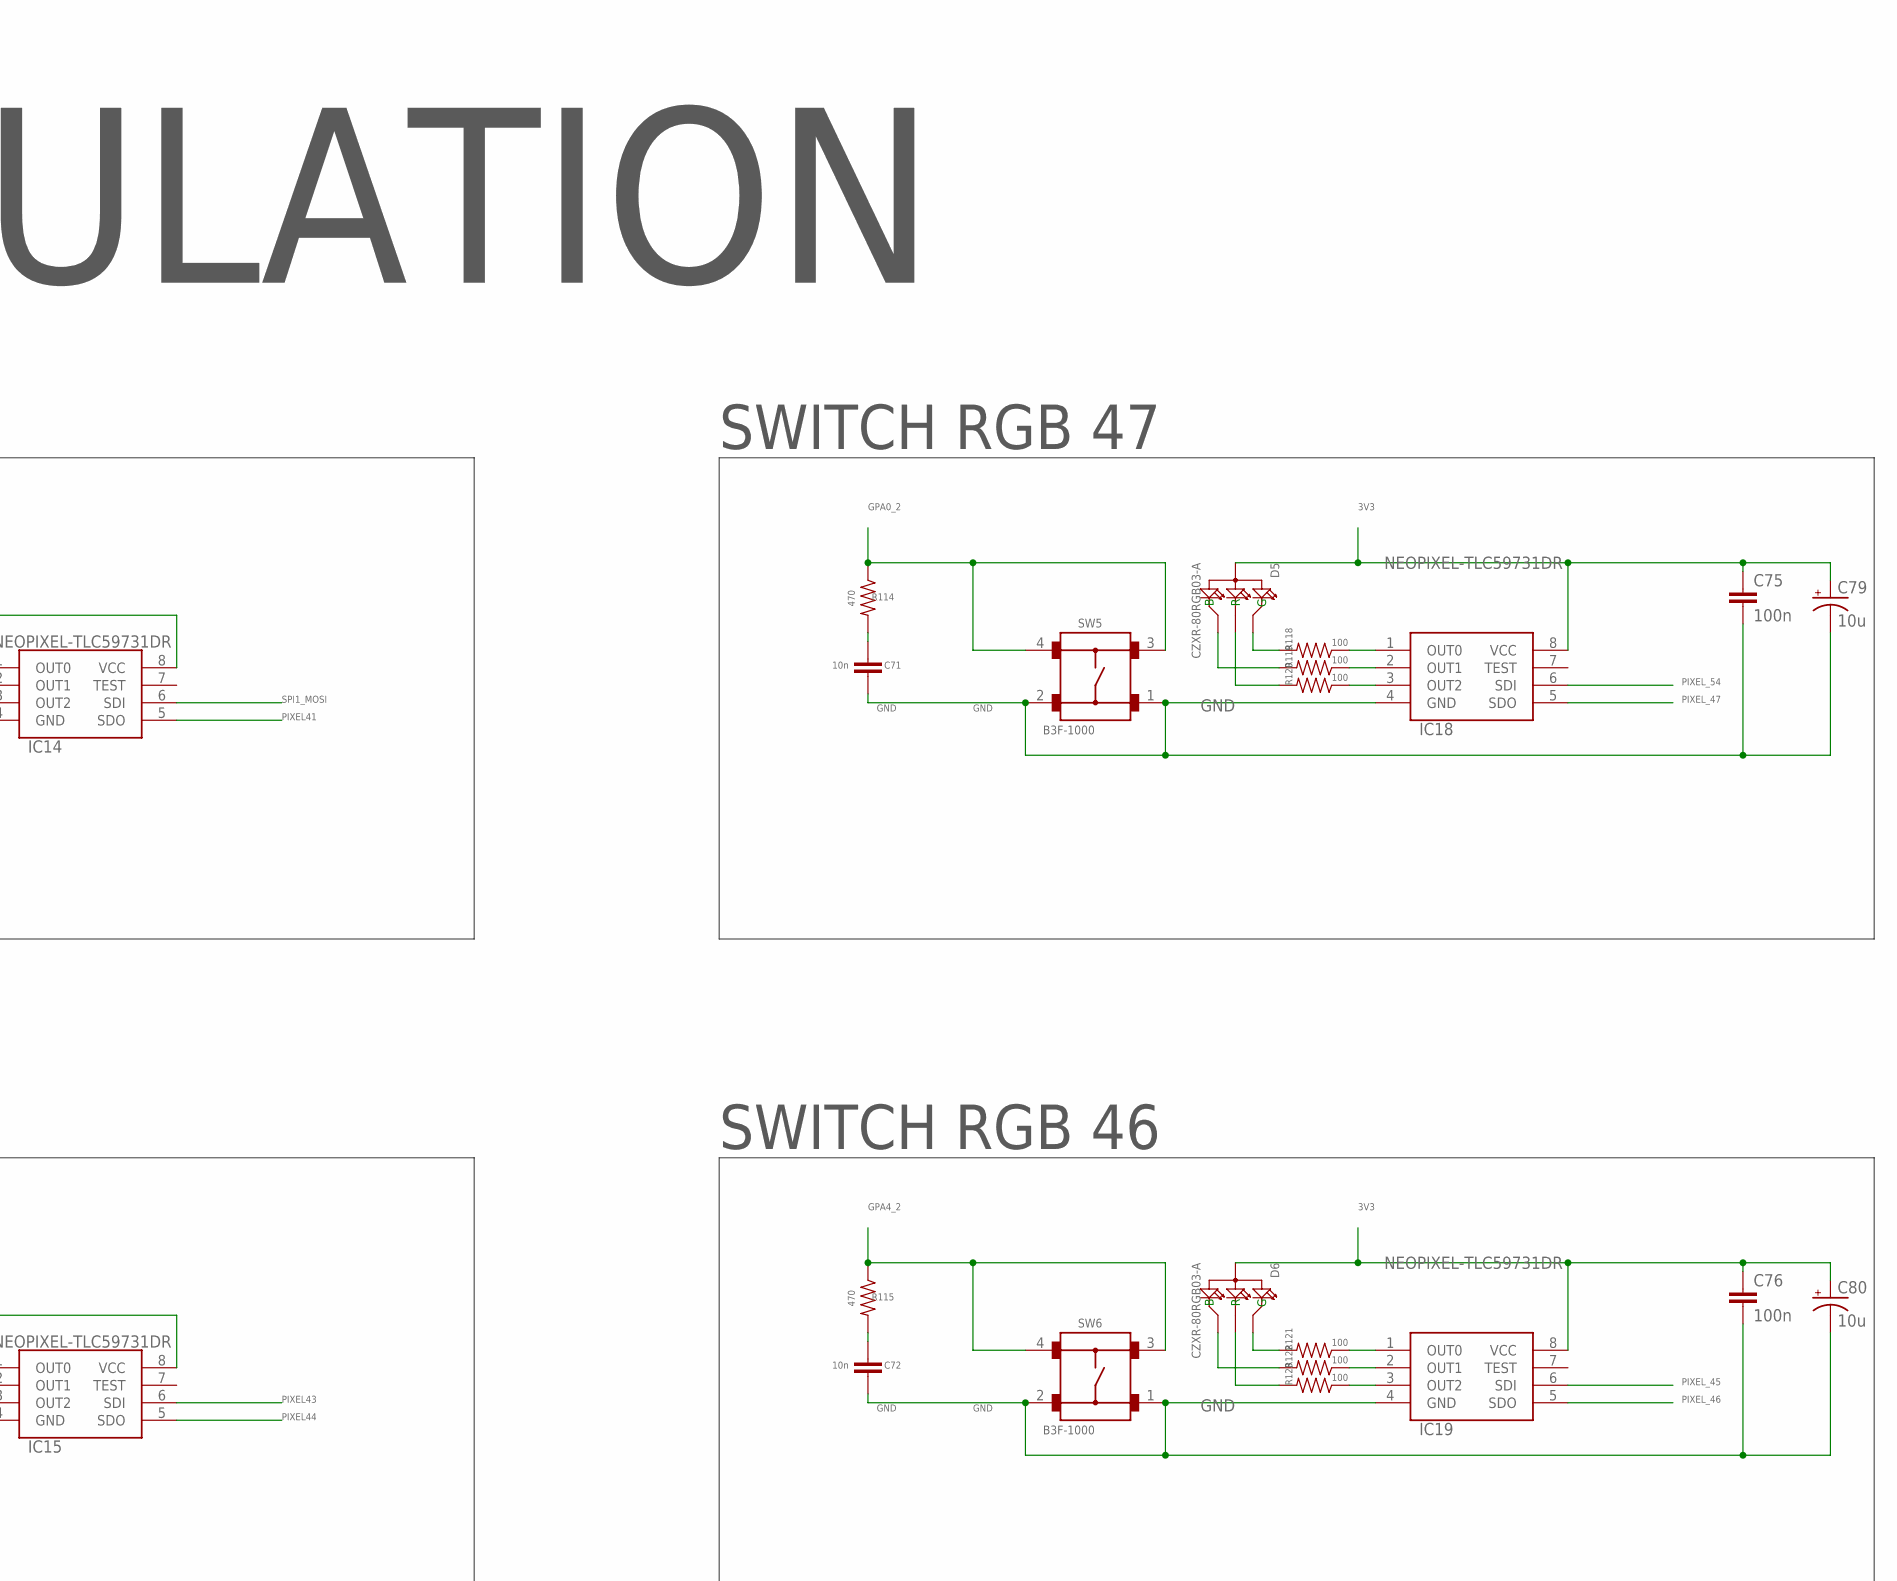
[picture p205: schematic STM32F446 front pane - south - v3.sch, sheet 2, part in row 1, column 2]

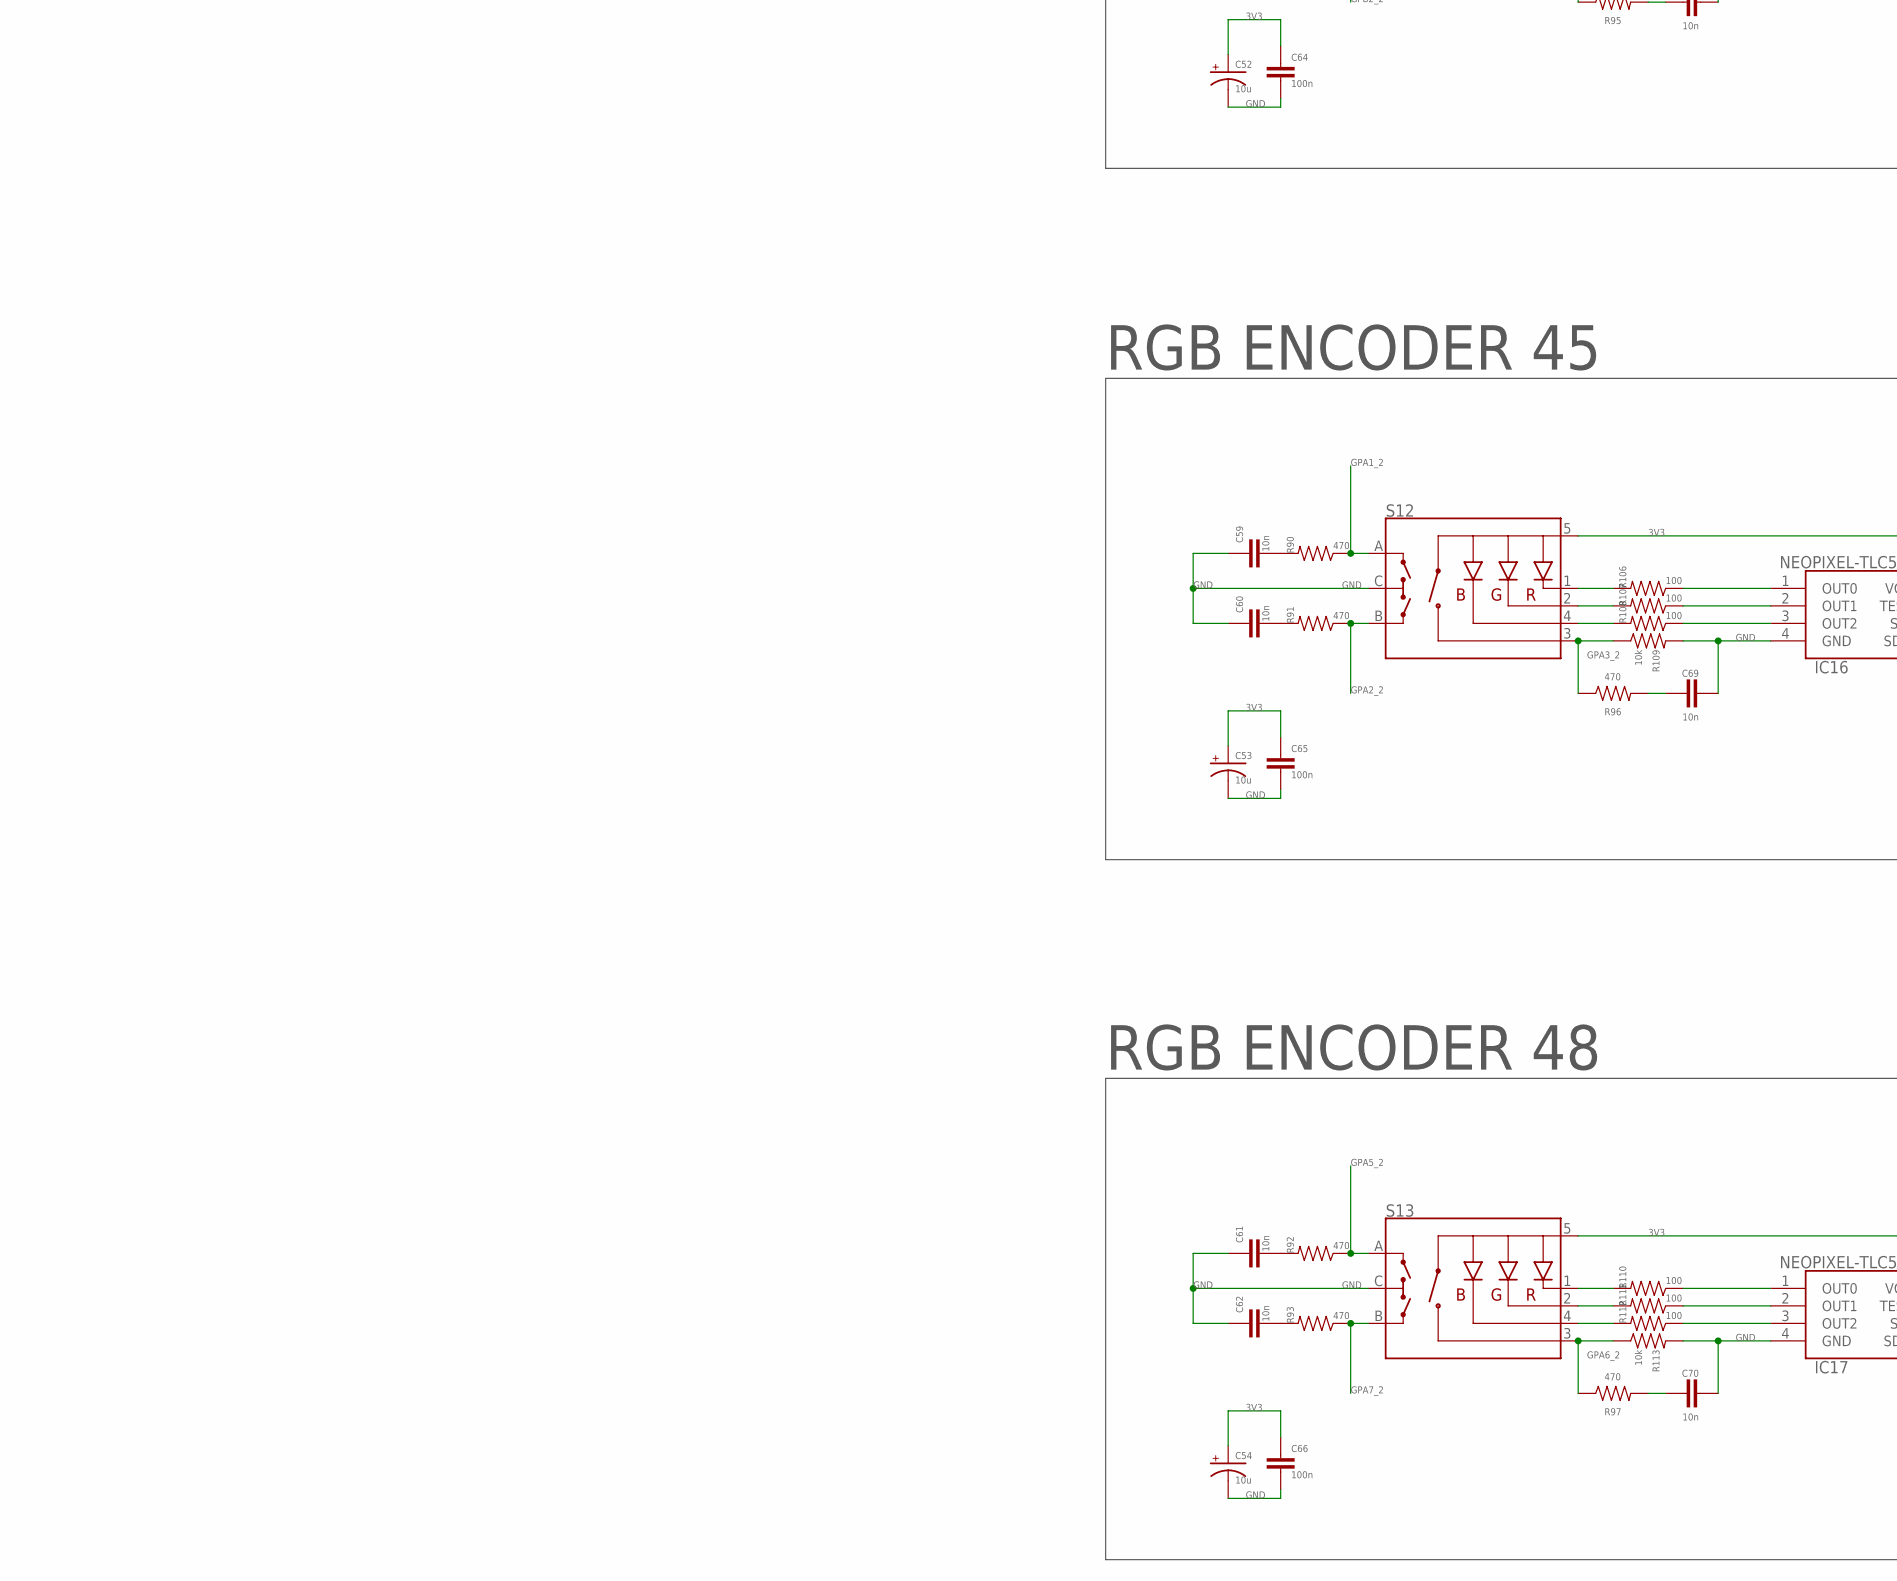
[picture p206: schematic STM32F446 front pane - south - v3.sch, sheet 2, part in row 2, column 1]

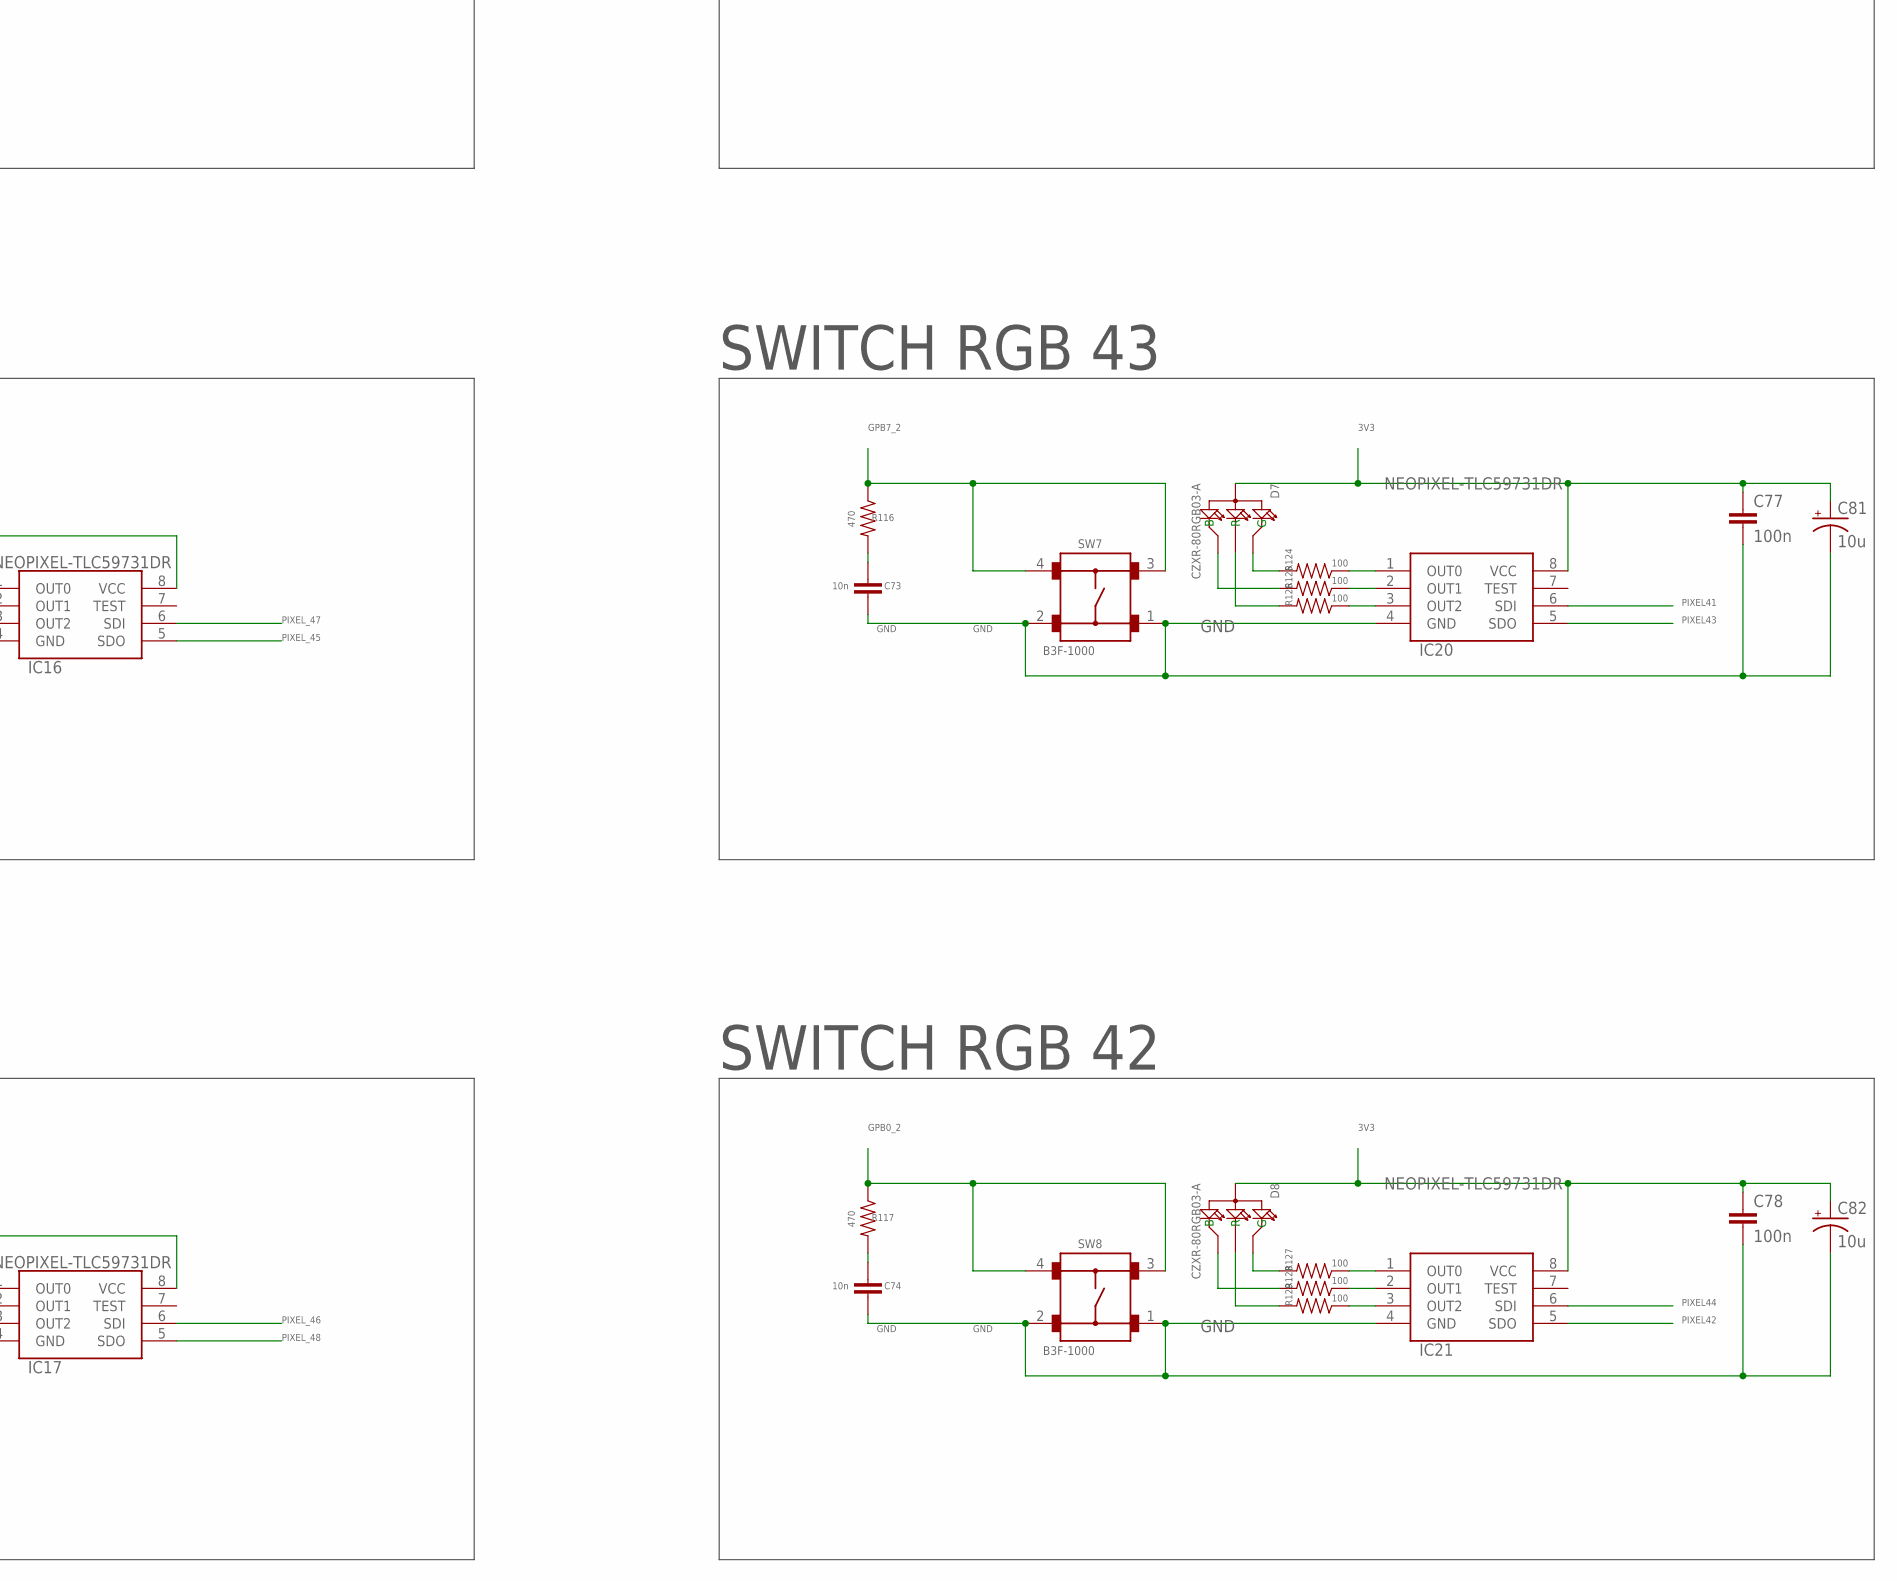
[picture p207: schematic STM32F446 front pane - south - v3.sch, sheet 2, part in row 2, column 2]

Parts:
C49, C51, C52, C53, C54, C79, C80, C81, C82: 10u; CPOL2917
C50, C63, C64, C65, C66, C75, C76, C77, C78: 100n; 0805-CAP
C55, C56, C57, C58, C59, C60, C61, C62, C67, C68, C69, C70, C71, C72, C73, C74: 10n; 0805-CAP
D5, D6, D7, D8: CZXR-80RGB03-A; LED4-2.0-D8.0MM
IC14, IC15, IC16, IC17, IC18, IC19, IC20, IC21: NEOPIXEL-TLC59731DR; SOIC127P600X175-8N
MCP_010: MCP23017; SOIC-28
R84, R85: 1k; R0805
R86, R87, R88, R89, R90, R91, R92, R93, R94, R95, R96, R97, R114, R115, R116, R117: 470; 1206
R98, R99, R100, R102, R103, R104, R106, R107, R108, R110, R111, R112, R118, R119, R120, R121, R122, R123, R124, R125, R126, R127, R128, R129: 100; 1206
R101, R105, R109, R113: 10k; 1206
S10, S11, S12, S13: ENCODER-RGB-SWITCH-NO_NUT; ENCODER_LED_3
SW5, SW6, SW7, SW8: B3F-1000

Connections:
3V3: C49.+, C50.1, C51.+, C52.+, C53.+, C54.+, C63.1, C64.1, C65.1, C66.1, C75.1, C76.1, C77.1, C78.1, C79.+, C80.+, C81.+, C82.+, D5.2 (+), D6.2 (+), D7.2 (+), D8.2 (+), IC14.8 (VCC), IC15.8 (VCC), IC16.8 (VCC), IC17.8 (VCC), IC18.8 (VCC), IC19.8 (VCC), IC20.8 (VCC), IC21.8 (VCC), MCP_010.9 (VDD), MCP_010.16 (A1), R84.2, R85.2, S10.5 (+), S11.5 (+), S12.5 (+), S13.5 (+); also elsewhere on the board
GND: C49.-, C50.2, C51.-, C52.-, C53.-, C54.-, C55.1, C56.1, C57.1, C58.1, C59.1, C60.1, C61.1, C62.1, C63.2, C64.2, C65.2, C66.2, C67.2, C68.2, C69.2, C70.2, C71.1, C72.1, C73.1, C74.1, C75.2, C76.2, C77.2, C78.2, C79.-, C80.-, C81.-, C82.-, IC14.4 (GND), IC15.4 (GND), IC16.4 (GND), IC17.4 (GND), IC18.4 (GND), IC19.4 (GND), IC20.4 (GND), IC21.4 (GND), MCP_010.10 (VSS), MCP_010.15 (A0), MCP_010.17 (A2), R101.2, R105.2, R109.2, R113.2, S10.C, S11.C, S12.C, S13.C, SW5.1, SW5.2, SW6.1, SW6.2, SW7.1, SW7.2, SW8.1, SW8.2; also elsewhere on the board
GPA0_2: MCP_010.21 (GPA0), R114.1, SW5.3, SW5.4
GPA1_2: MCP_010.22 (GPA1), R90.1, S12.A
GPA2_2: MCP_010.23 (GPA2), R91.1, S12.B
GPA3_2: MCP_010.24 (GPA3), R96.1, R109.1, S12.3 (SW)
GPA4_2: MCP_010.25 (GPA4), R115.1, SW6.3, SW6.4
GPA5_2: MCP_010.26 (GPA5), R92.1, S13.A
GPA6_2: MCP_010.27 (GPA6), R97.1, R113.1, S13.3 (SW)
GPA7_2: MCP_010.28 (GPA7), R93.1, S13.B
GPB0_2: MCP_010.1 (GPB0), R117.1, SW8.3, SW8.4
GPB1_2: MCP_010.2 (GPB1), R88.1, S11.A
GPB2_2: MCP_010.3 (GPB2), R89.1, S11.B
GPB3_2: MCP_010.4 (GPB3), R95.1, R105.1, S11.3 (SW)
GPB4_2: MCP_010.5 (GPB4), R86.1, S10.A
GPB5_2: MCP_010.6 (GPB5), R87.1, S10.B
GPB6_2: MCP_010.7 (GPB6), R94.1, R101.1, S10.3 (SW)
GPB7_2: MCP_010.8 (GPB7), R116.1, SW7.3, SW7.4
I2C2_SCL: MCP_010.12 (SCL), R85.1; also elsewhere on the board
I2C2_SDA: MCP_010.13 (SDA), R84.1; also elsewhere on the board
INTA_2: MCP_010.20 (INTA); also elsewhere on the board
INTB_2: MCP_010.19 (INTB); also elsewhere on the board
unnamed: IC21.1 (OUT0), R127.1
unnamed: IC21.2 (OUT1), R128.1
unnamed: R98.2, S10.1 (-R)
unnamed: R99.2, S10.2 (-G)
unnamed: R100.2, S10.4 (-B)
unnamed: IC14.1 (OUT0), R98.1
unnamed: IC14.2 (OUT1), R99.1
unnamed: IC14.3 (OUT2), R100.1
unnamed: C55.2, R86.2
unnamed: C56.2, R87.2
unnamed: C67.1, R94.2
unnamed: R102.2, S11.1 (-R)
unnamed: R103.2, S11.2 (-G)
unnamed: R104.2, S11.4 (-B)
unnamed: IC15.1 (OUT0), R102.1
unnamed: IC15.2 (OUT1), R103.1
unnamed: IC15.3 (OUT2), R104.1
unnamed: C57.2, R88.2
unnamed: C58.2, R89.2
unnamed: C68.1, R95.2
unnamed: R106.2, S12.1 (-R)
unnamed: R107.2, S12.2 (-G)
unnamed: R108.2, S12.4 (-B)
unnamed: IC16.1 (OUT0), R106.1
unnamed: IC16.2 (OUT1), R107.1
unnamed: IC16.3 (OUT2), R108.1
unnamed: C59.2, R90.2
unnamed: C60.2, R91.2
unnamed: C69.1, R96.2
unnamed: R110.2, S13.1 (-R)
unnamed: R111.2, S13.2 (-G)
unnamed: R112.2, S13.4 (-B)
unnamed: IC17.1 (OUT0), R110.1
unnamed: IC17.2 (OUT1), R111.1
unnamed: IC17.3 (OUT2), R112.1
unnamed: C61.2, R92.2
unnamed: C62.2, R93.2
unnamed: C70.1, R97.2
unnamed: IC21.3 (OUT2), R129.1
unnamed: C74.2, R117.2
unnamed: D8.1 (R), R129.2
unnamed: D8.4 (B), R128.2
unnamed: D8.3 (G), R127.2
unnamed: IC20.1 (OUT0), R124.1
unnamed: IC20.2 (OUT1), R125.1
unnamed: IC20.3 (OUT2), R126.1
unnamed: C73.2, R116.2
unnamed: D7.1 (R), R126.2
unnamed: D7.4 (B), R125.2
unnamed: D7.3 (G), R124.2
unnamed: IC19.1 (OUT0), R121.1
unnamed: IC19.2 (OUT1), R122.1
unnamed: IC19.3 (OUT2), R123.1
unnamed: C72.2, R115.2
unnamed: D6.1 (R), R123.2
unnamed: D6.4 (B), R122.2
unnamed: D6.3 (G), R121.2
unnamed: IC18.1 (OUT0), R118.1
unnamed: IC18.2 (OUT1), R119.1
unnamed: IC18.3 (OUT2), R120.1
unnamed: C71.2, R114.2
unnamed: D5.1 (R), R120.2
unnamed: D5.4 (B), R119.2
unnamed: D5.3 (G), R118.2
PIXEL41: IC14.5 (SDO), IC20.6 (SDI)
PIXEL42: IC21.5 (SDO); also elsewhere on the board
PIXEL43: IC15.6 (SDI), IC20.5 (SDO)
PIXEL44: IC15.5 (SDO), IC21.6 (SDI)
PIXEL_45: IC16.5 (SDO), IC19.6 (SDI)
PIXEL_46: IC17.6 (SDI), IC19.5 (SDO)
PIXEL_47: IC16.6 (SDI), IC18.5 (SDO)
PIXEL_48: IC17.5 (SDO); also elsewhere on the board
PIXEL_54: IC18.6 (SDI); also elsewhere on the board
RST: MCP_010.18 (!RESET); also elsewhere on the board
SPI1_MOSI: IC14.6 (SDI); also elsewhere on the board

Notes on the sheet:
MODULATION
RGB ENCODER 41
RGB ENCODER 44
RGB ENCODER 45
RGB ENCODER 48
SWITCH RGB 42
SWITCH RGB 43
SWITCH RGB 46
SWITCH RGB 47
