reynal/themis/front-pane/eagle-schematics/v3/STM32F446 front pane - south - v3.brd

## EAGLE design front-pane/eagle-schematics/v3/STM32F446 front pane - south - v3.brd (continued)

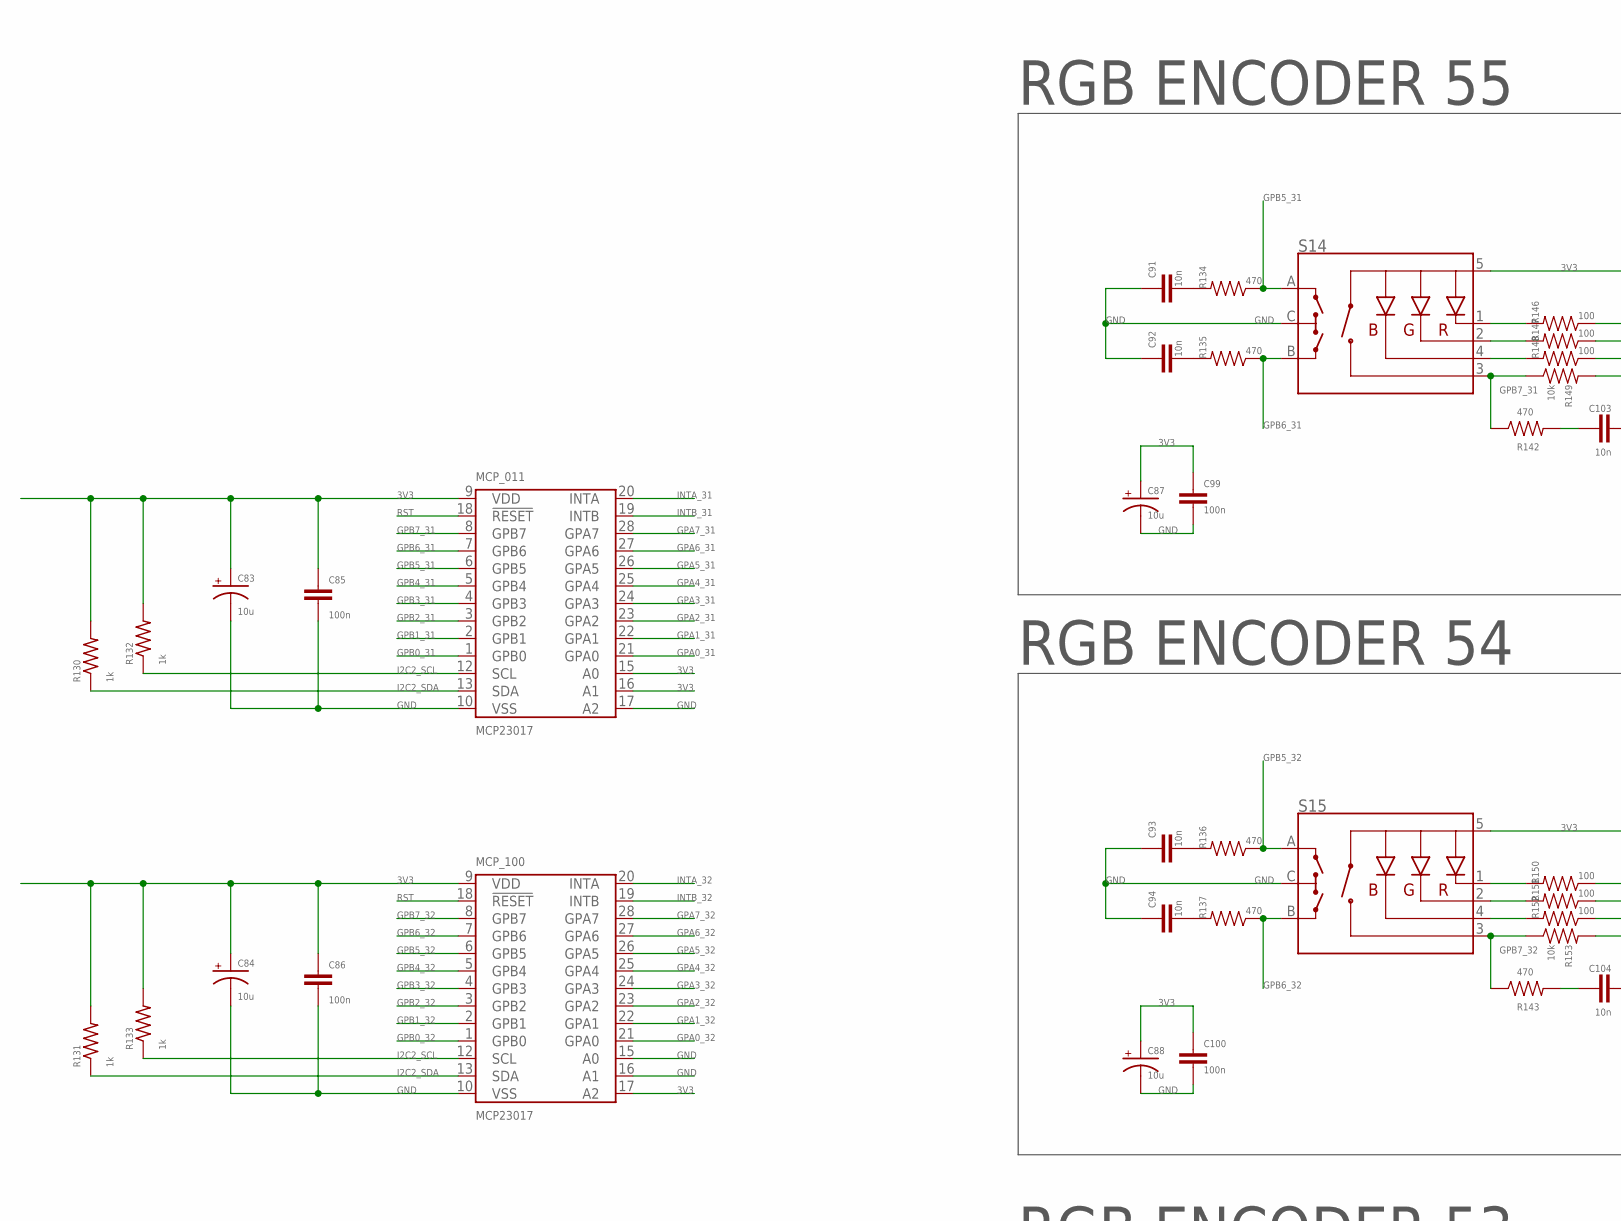
[picture p208: schematic STM32F446 front pane - south - v3.sch, sheet 3, part in row 1, column 1]

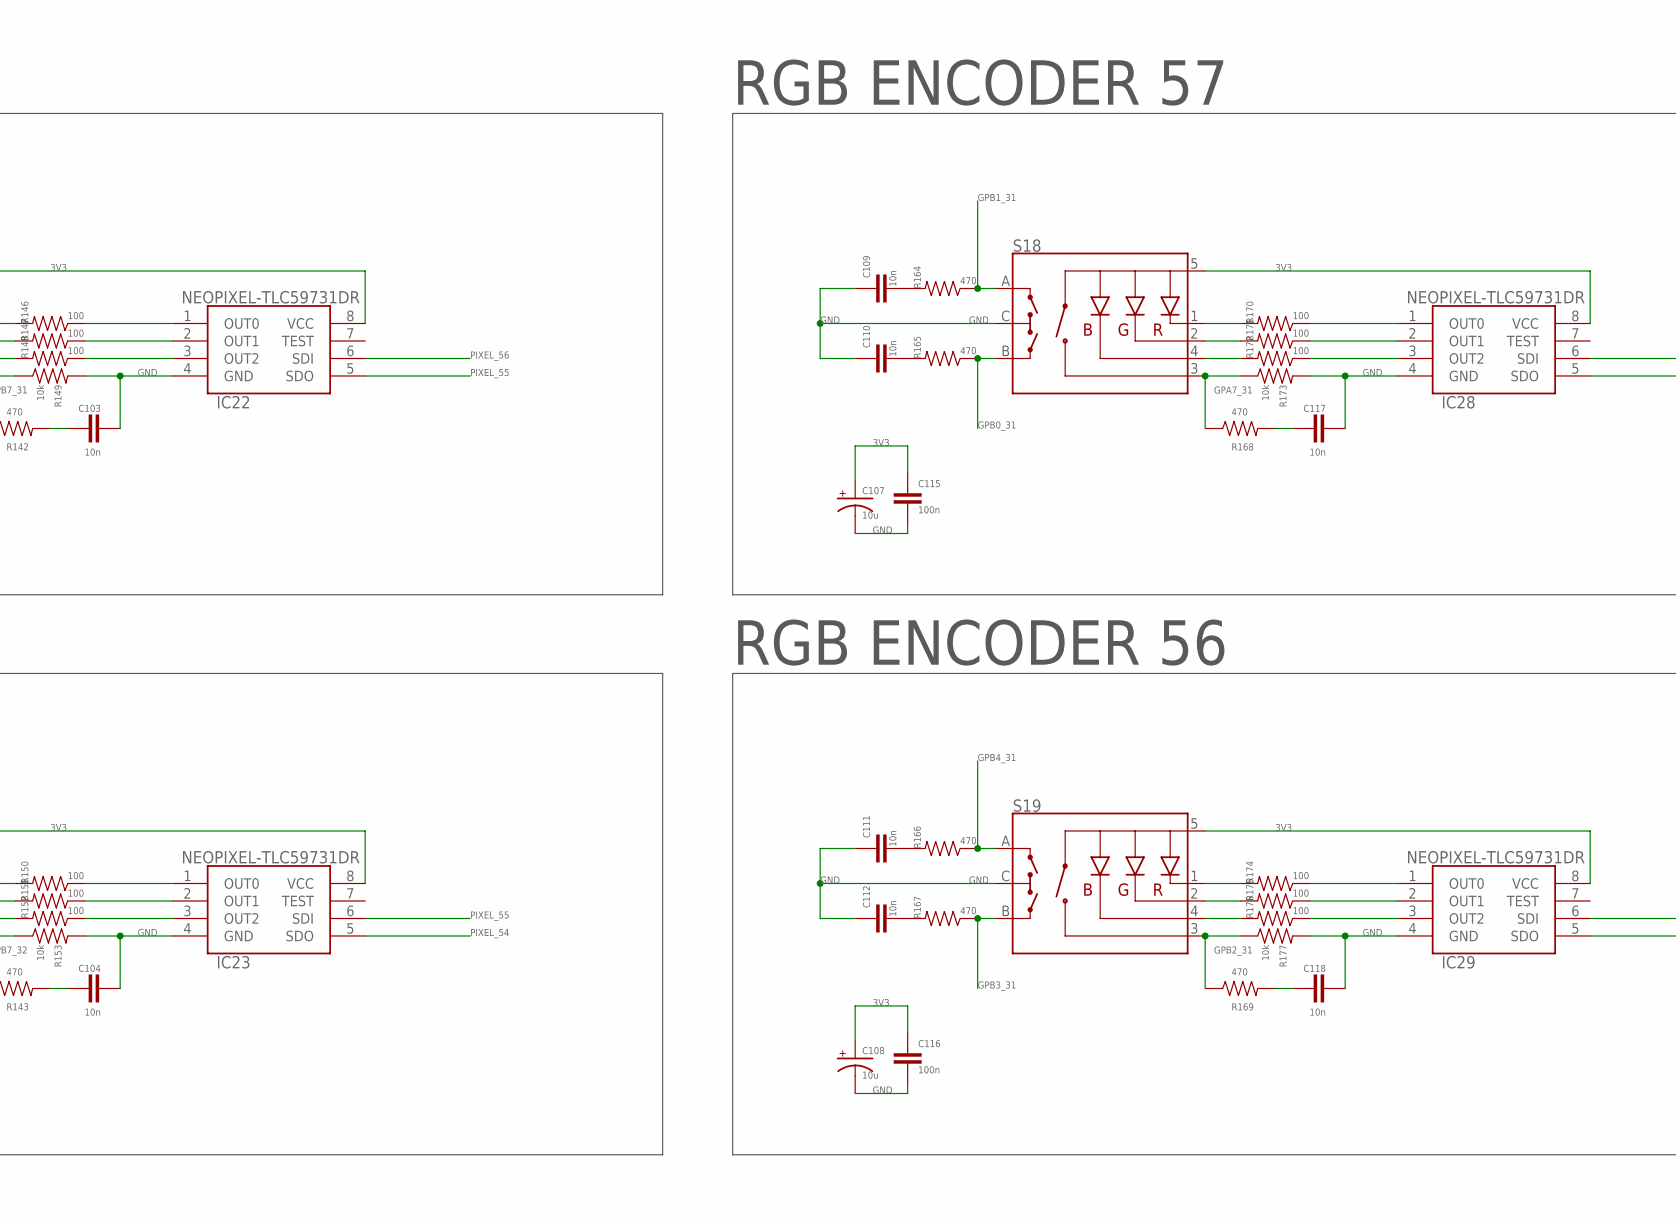
[picture p209: schematic STM32F446 front pane - south - v3.sch, sheet 3, part in row 1, column 2]

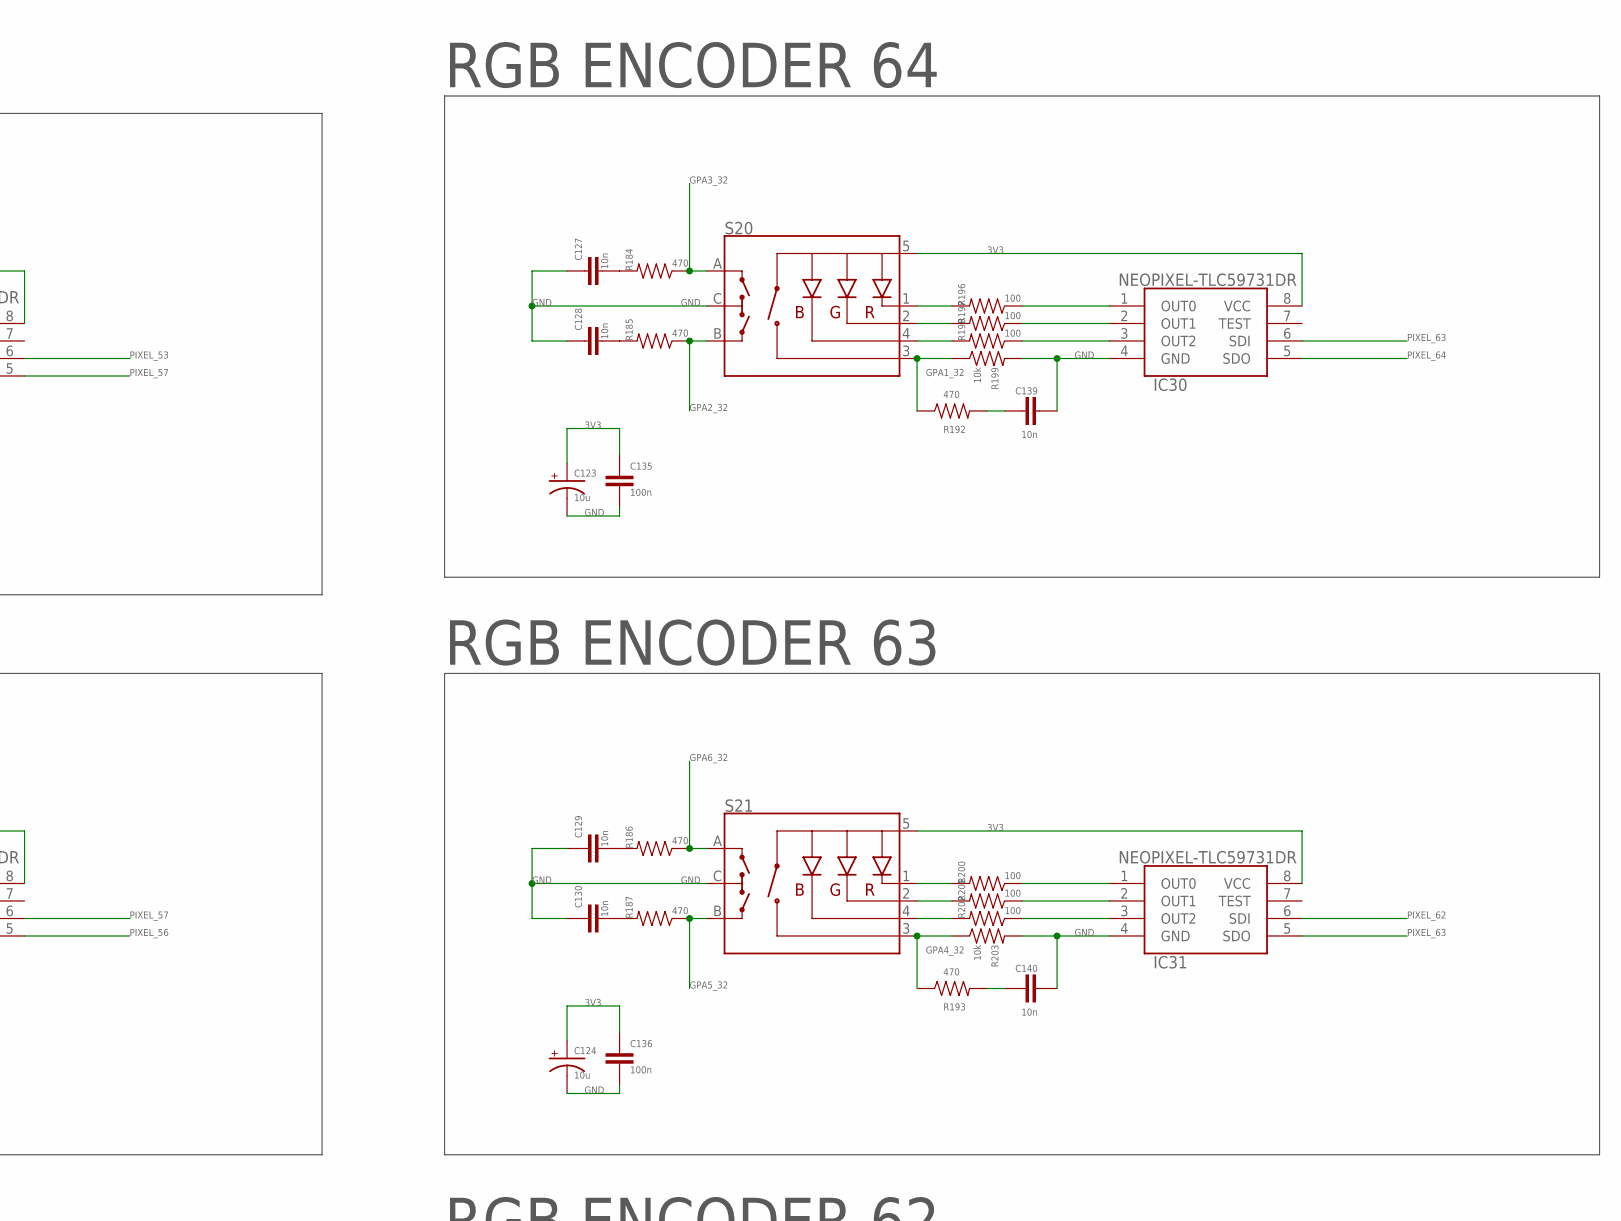
[picture p210: schematic STM32F446 front pane - south - v3.sch, sheet 3, part in row 1, column 3]

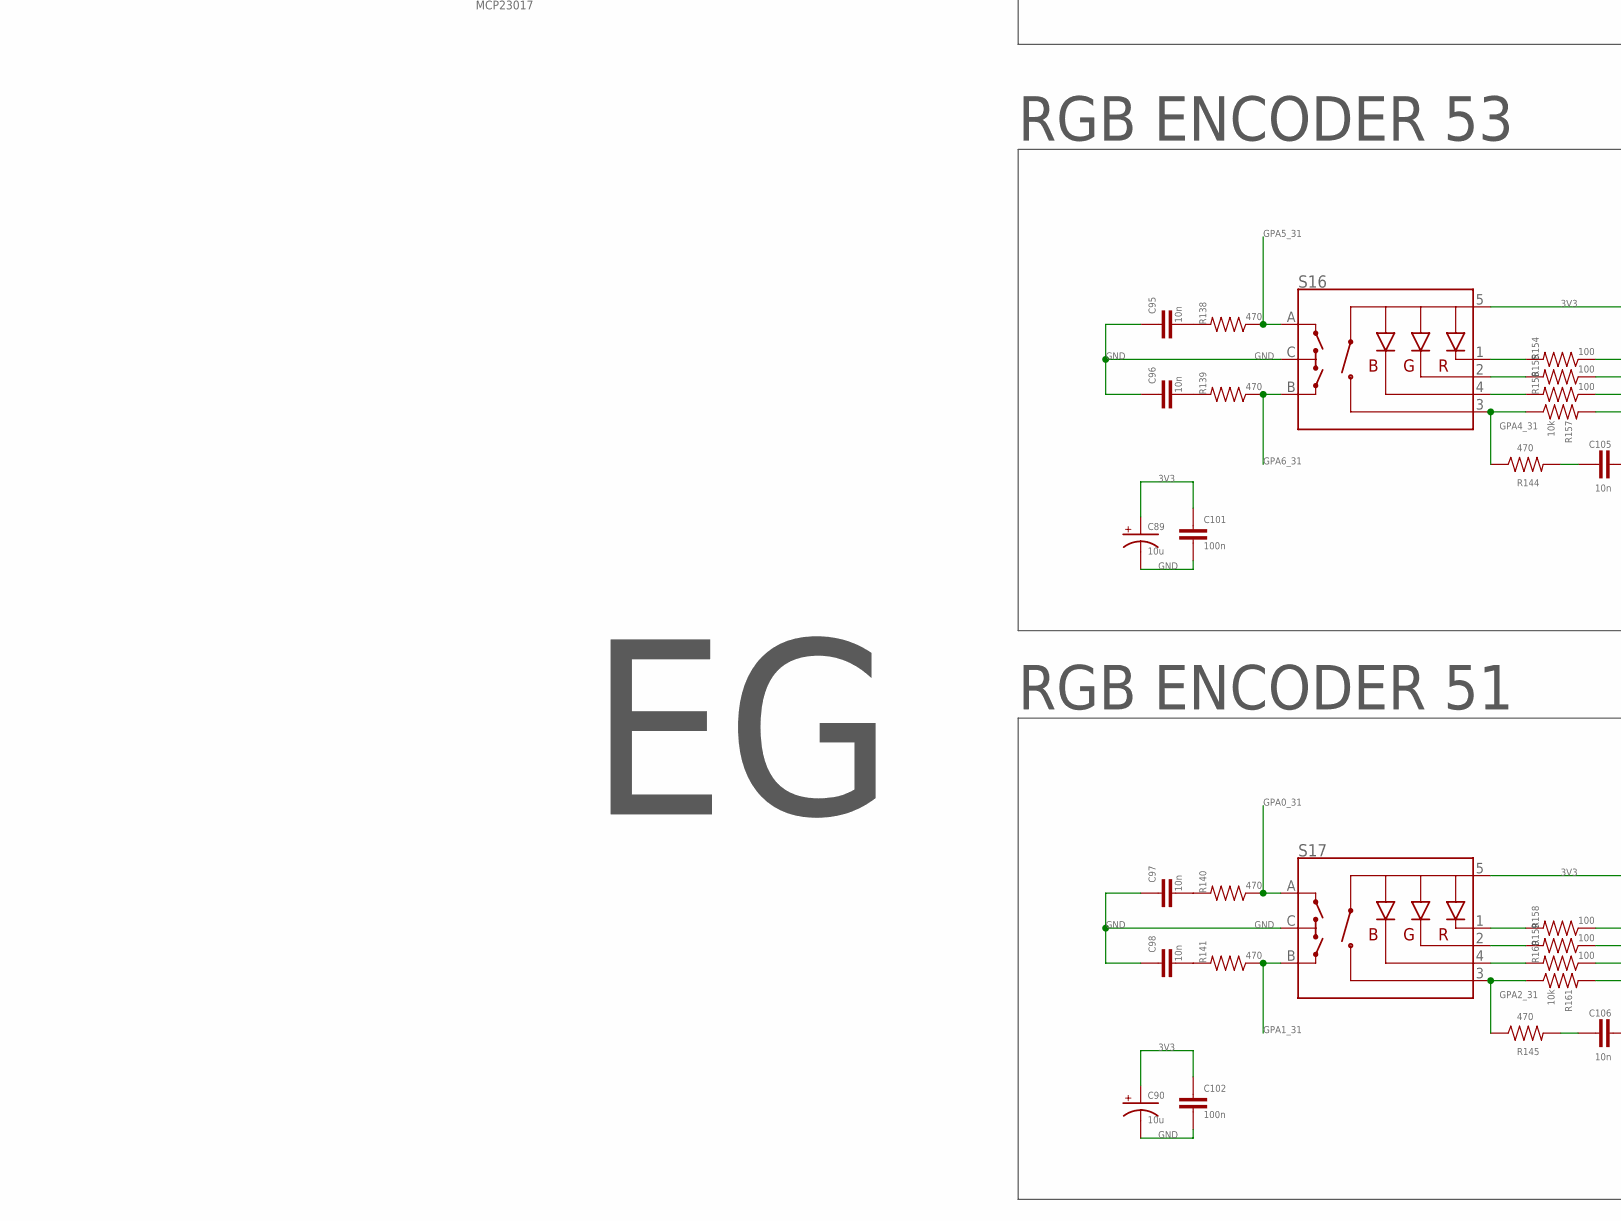
[picture p211: schematic STM32F446 front pane - south - v3.sch, sheet 3, part in row 2, column 1]

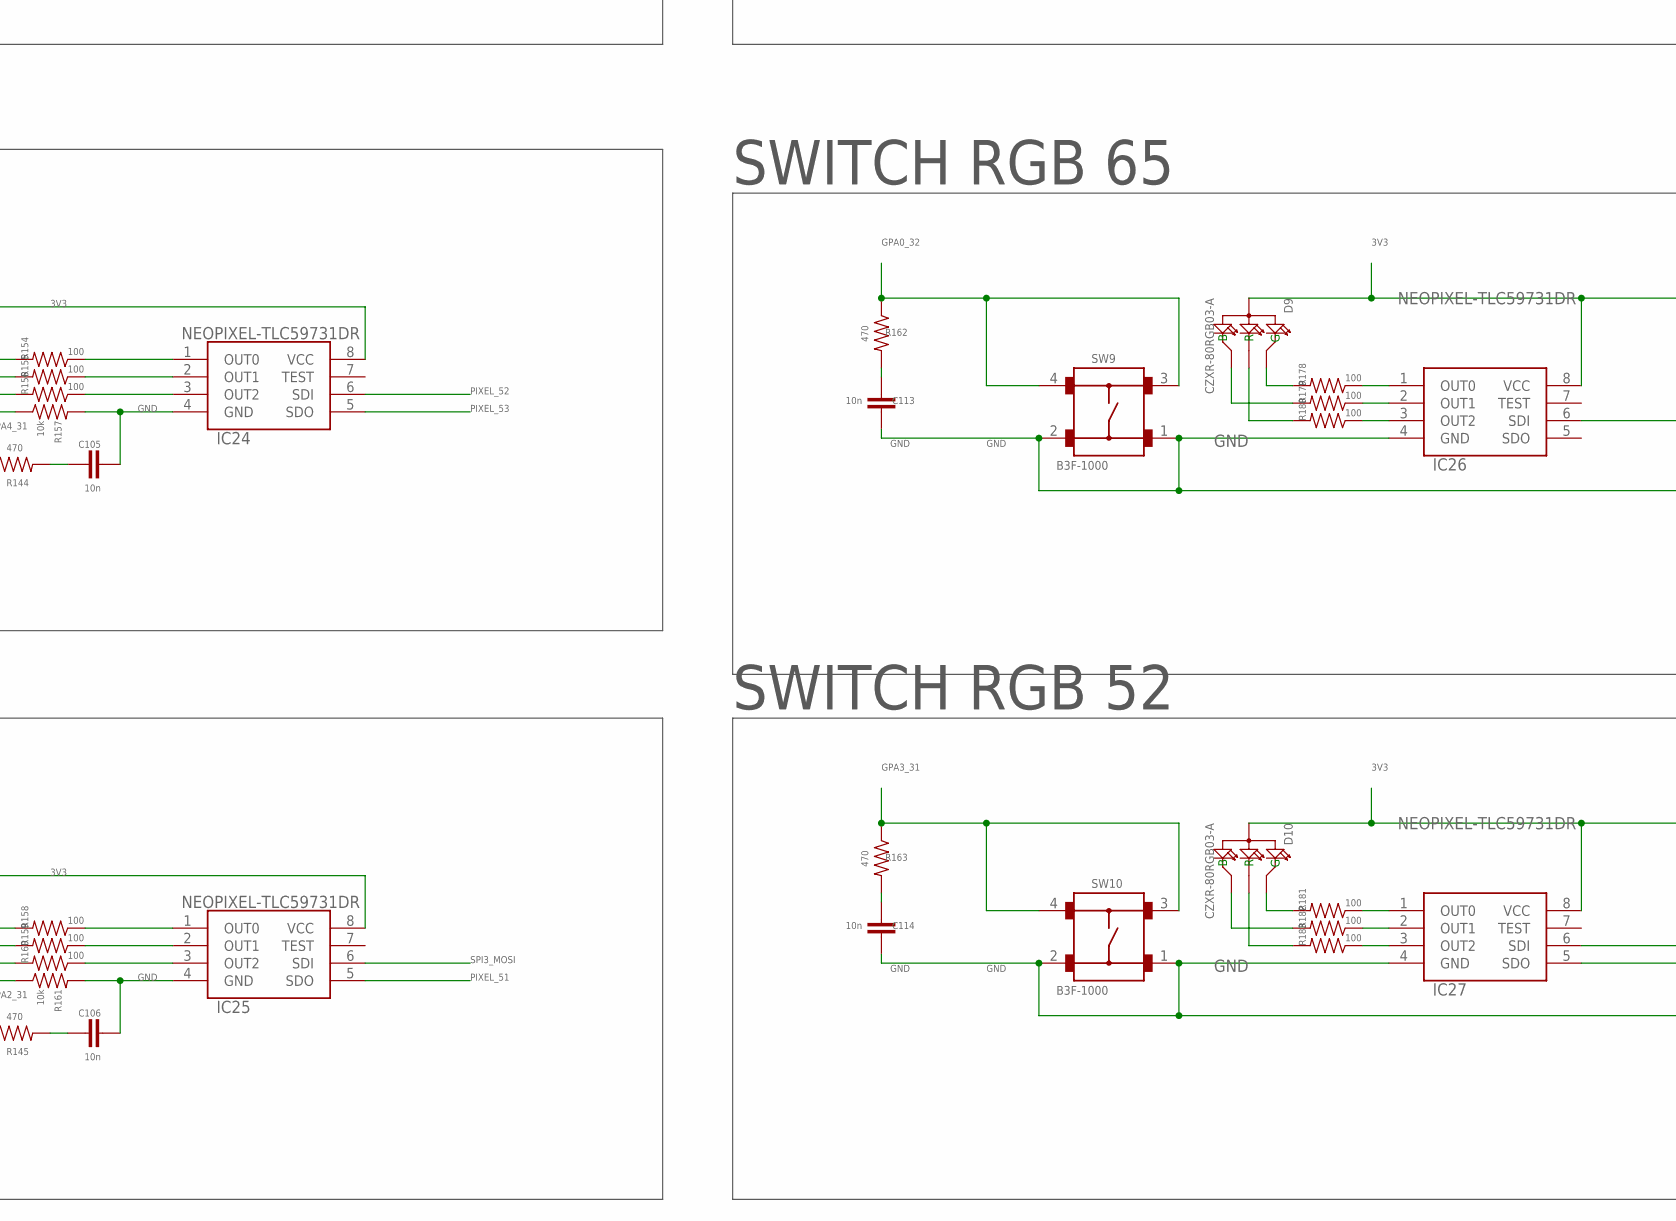
[picture p212: schematic STM32F446 front pane - south - v3.sch, sheet 3, part in row 2, column 2]

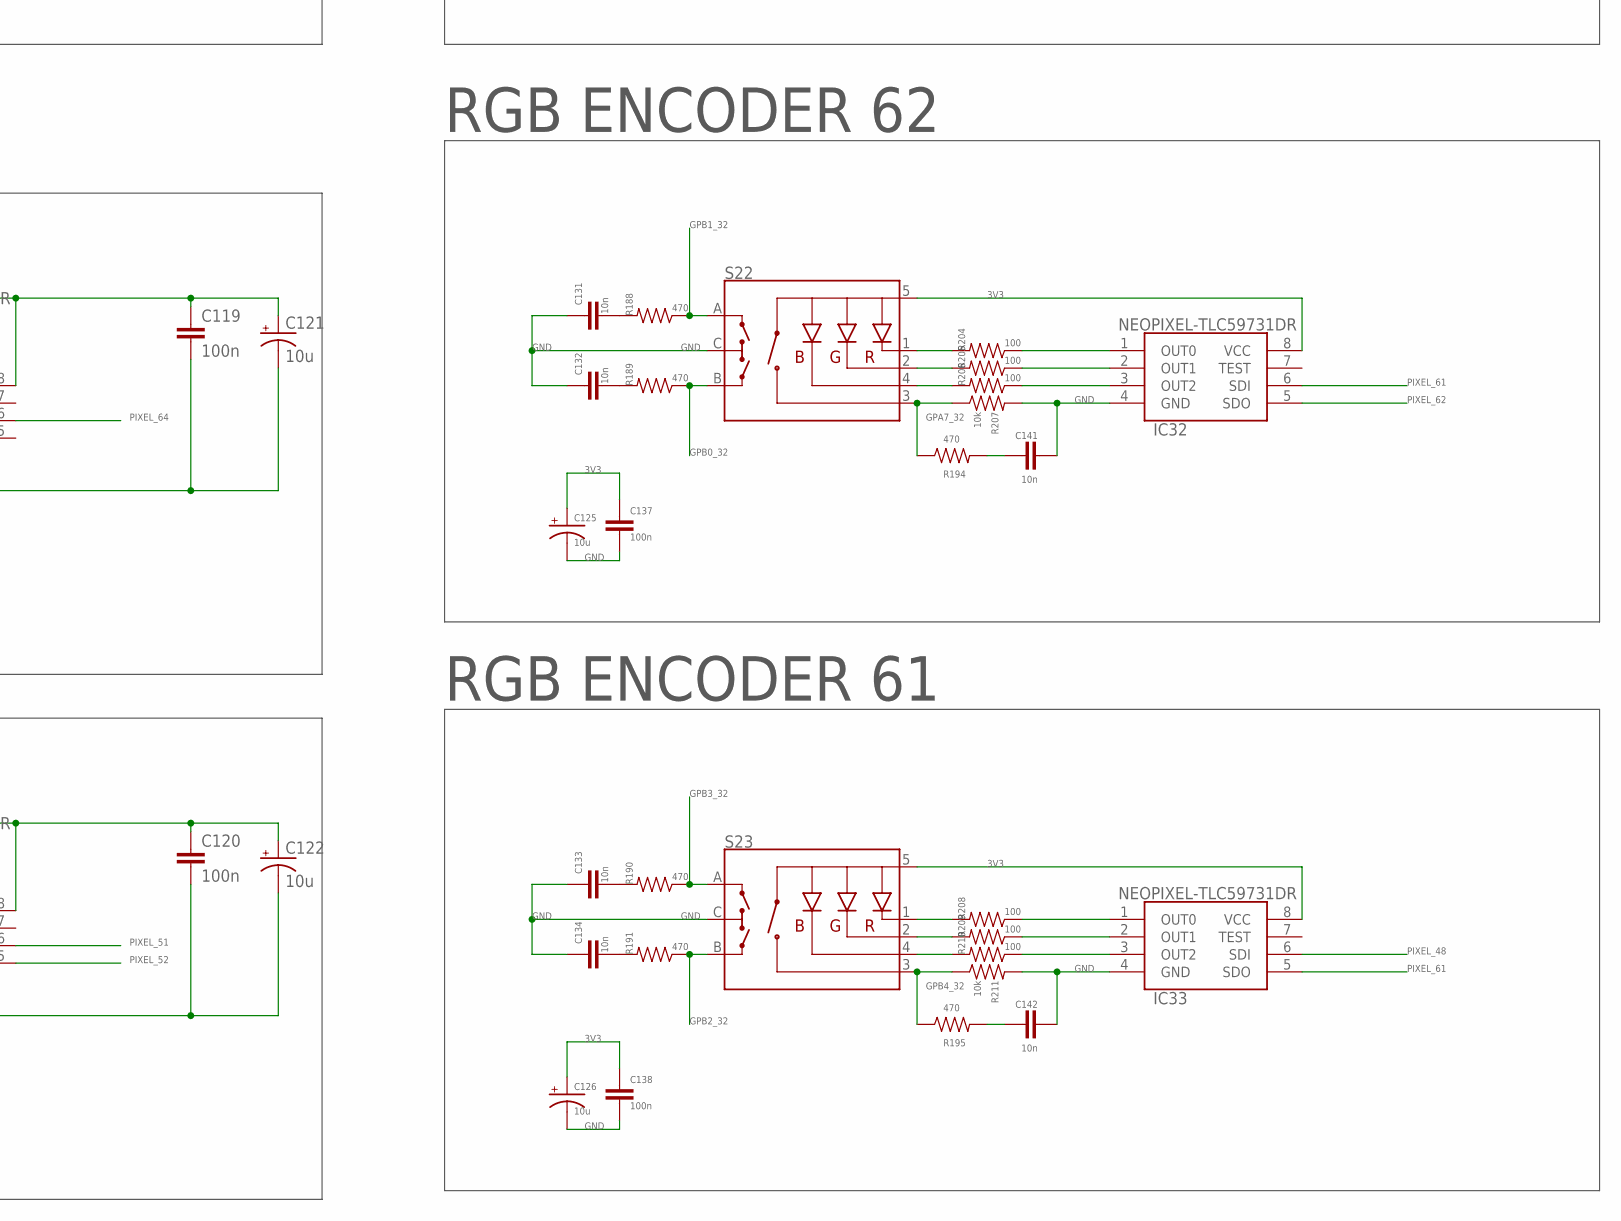
[picture p213: schematic STM32F446 front pane - south - v3.sch, sheet 3, part in row 2, column 3]

Parts:
C83, C84, C87, C88, C89, C90, C107, C108, C121, C122, C123, C124, C125, C126: 10u; CPOL2917
C85, C86, C99, C100, C101, C102, C115, C116, C119, C120, C135, C136, C137, C138: 100n; 0805-CAP
C91, C92, C93, C94, C95, C96, C97, C98, C103, C104, C105, C106, C109, C110, C111, C112, C113, C114, C117, C118, C127, C128, C129, C130, C131, C132, C133, C134, C139, C140, C141, C142: 10n; 0805-CAP
D9, D10: CZXR-80RGB03-A; LED4-2.0-D8.0MM
IC22, IC23, IC24, IC25, IC26, IC27, IC28, IC29, IC30, IC31, IC32, IC33: NEOPIXEL-TLC59731DR; SOIC127P600X175-8N
MCP_011, MCP_100: MCP23017; SOIC-28
R130, R131, R132, R133: 1k; R0805
R134, R135, R136, R137, R138, R139, R140, R141, R142, R143, R144, R145, R162, R163, R164, R165, R166, R167, R168, R169, R184, R185, R186, R187, R188, R189, R190, R191, R192, R193, R194, R195: 470; 1206
R146, R147, R148, R150, R151, R152, R154, R155, R156, R158, R159, R160, R170, R171, R172, R174, R175, R176, R178, R179, R180, R181, R182, R183, R196, R197, R198, R200, R201, R202, R204, R205, R206, R208, R209, R210: 100; 1206
R149, R153, R157, R161, R173, R177, R199, R203, R207, R211: 10k; 1206
S14, S15, S16, S17, S18, S19, S20, S21, S22, S23: ENCODER-RGB-SWITCH-NO_NUT; ENCODER_LED_3
SW9, SW10: B3F-1000

Connections:
3V3: C83.+, C84.+, C85.1, C86.1, C87.+, C88.+, C89.+, C90.+, C99.1, C100.1, C101.1, C102.1, C107.+, C108.+, C115.1, C116.1, C119.1, C120.1, C121.+, C122.+, C123.+, C124.+, C125.+, C126.+, C135.1, C136.1, C137.1, C138.1, D9.2 (+), D10.2 (+), IC22.8 (VCC), IC23.8 (VCC), IC24.8 (VCC), IC25.8 (VCC), IC26.8 (VCC), IC27.8 (VCC), IC28.8 (VCC), IC29.8 (VCC), IC30.8 (VCC), IC31.8 (VCC), IC32.8 (VCC), IC33.8 (VCC), MCP_011.9 (VDD), MCP_011.15 (A0), MCP_011.16 (A1), MCP_100.9 (VDD), MCP_100.17 (A2), R130.2, R131.2, R132.2, R133.2, S14.5 (+), S15.5 (+), S16.5 (+), S17.5 (+), S18.5 (+), S19.5 (+), S20.5 (+), S21.5 (+), S22.5 (+), S23.5 (+); also elsewhere on the board
GND: C83.-, C84.-, C85.2, C86.2, C87.-, C88.-, C89.-, C90.-, C91.1, C92.1, C93.1, C94.1, C95.1, C96.1, C97.1, C98.1, C99.2, C100.2, C101.2, C102.2, C103.2, C104.2, C105.2, C106.2, C107.-, C108.-, C109.1, C110.1, C111.1, C112.1, C113.1, C114.1, C115.2, C116.2, C117.2, C118.2, C119.2, C120.2, C121.-, C122.-, C123.-, C124.-, C125.-, C126.-, C127.1, C128.1, C129.1, C130.1, C131.1, C132.1, C133.1, C134.1, C135.2, C136.2, C137.2, C138.2, C139.2, C140.2, C141.2, C142.2, IC22.4 (GND), IC23.4 (GND), IC24.4 (GND), IC25.4 (GND), IC26.4 (GND), IC27.4 (GND), IC28.4 (GND), IC29.4 (GND), IC30.4 (GND), IC31.4 (GND), IC32.4 (GND), IC33.4 (GND), MCP_011.10 (VSS), MCP_011.17 (A2), MCP_100.10 (VSS), MCP_100.15 (A0), MCP_100.16 (A1), R149.2, R153.2, R157.2, R161.2, R173.2, R177.2, R199.2, R203.2, R207.2, R211.2, S14.C, S15.C, S16.C, S17.C, S18.C, S19.C, S20.C, S21.C, S22.C, S23.C, SW9.1, SW9.2, SW10.1, SW10.2; also elsewhere on the board
GPA0_31: MCP_011.21 (GPA0), R140.1, S17.A
GPA0_32: MCP_100.21 (GPA0), R162.1, SW9.3, SW9.4
GPA1_31: MCP_011.22 (GPA1), R141.1, S17.B
GPA1_32: MCP_100.22 (GPA1), R192.1, R199.1, S20.3 (SW)
GPA2_31: MCP_011.23 (GPA2), R145.1, R161.1, S17.3 (SW)
GPA2_32: MCP_100.23 (GPA2), R185.1, S20.B
GPA3_31: MCP_011.24 (GPA3), R163.1, SW10.3, SW10.4
GPA3_32: MCP_100.24 (GPA3), R184.1, S20.A
GPA4_31: MCP_011.25 (GPA4), R144.1, R157.1, S16.3 (SW)
GPA4_32: MCP_100.25 (GPA4), R193.1, R203.1, S21.3 (SW)
GPA5_31: MCP_011.26 (GPA5), R138.1, S16.A
GPA5_32: MCP_100.26 (GPA5), R187.1, S21.B
GPA6_31: MCP_011.27 (GPA6), R139.1, S16.B
GPA6_32: MCP_100.27 (GPA6), R186.1, S21.A
GPA7_31: MCP_011.28 (GPA7), R168.1, R173.1, S18.3 (SW)
GPA7_32: MCP_100.28 (GPA7), R194.1, R207.1, S22.3 (SW)
GPB0_31: MCP_011.1 (GPB0), R165.1, S18.B
GPB0_32: MCP_100.1 (GPB0), R189.1, S22.B
GPB1_31: MCP_011.2 (GPB1), R164.1, S18.A
GPB1_32: MCP_100.2 (GPB1), R188.1, S22.A
GPB2_31: MCP_011.3 (GPB2), R169.1, R177.1, S19.3 (SW)
GPB2_32: MCP_100.3 (GPB2), R191.1, S23.B
GPB3_31: MCP_011.4 (GPB3), R167.1, S19.B
GPB3_32: MCP_100.4 (GPB3), R190.1, S23.A
GPB4_31: MCP_011.5 (GPB4), R166.1, S19.A
GPB4_32: MCP_100.5 (GPB4), R195.1, R211.1, S23.3 (SW)
GPB5_31: MCP_011.6 (GPB5), R134.1, S14.A
GPB5_32: MCP_100.6 (GPB5), R136.1, S15.A
GPB6_31: MCP_011.7 (GPB6), R135.1, S14.B
GPB6_32: MCP_100.7 (GPB6), R137.1, S15.B
GPB7_31: MCP_011.8 (GPB7), R142.1, R149.1, S14.3 (SW)
GPB7_32: MCP_100.8 (GPB7), R143.1, R153.1, S15.3 (SW)
I2C2_SCL: MCP_011.12 (SCL), MCP_100.12 (SCL), R132.1, R133.1; also elsewhere on the board
I2C2_SDA: MCP_011.13 (SDA), MCP_100.13 (SDA), R130.1, R131.1; also elsewhere on the board
INTA_31: MCP_011.20 (INTA); also elsewhere on the board
INTA_32: MCP_100.20 (INTA); also elsewhere on the board
INTB_31: MCP_011.19 (INTB); also elsewhere on the board
INTB_32: MCP_100.19 (INTB); also elsewhere on the board
unnamed: R158.2, S17.1 (-R)
unnamed: R159.2, S17.2 (-G)
unnamed: R160.2, S17.4 (-B)
unnamed: IC25.1 (OUT0), R158.1
unnamed: IC25.2 (OUT1), R159.1
unnamed: IC25.3 (OUT2), R160.1
unnamed: C97.2, R140.2
unnamed: C98.2, R141.2
unnamed: C106.1, R145.2
unnamed: R154.2, S16.1 (-R)
unnamed: R155.2, S16.2 (-G)
unnamed: R156.2, S16.4 (-B)
unnamed: IC24.1 (OUT0), R154.1
unnamed: IC24.2 (OUT1), R155.1
unnamed: IC24.3 (OUT2), R156.1
unnamed: C95.2, R138.2
unnamed: C96.2, R139.2
unnamed: C105.1, R144.2
unnamed: R150.2, S15.1 (-R)
unnamed: R151.2, S15.2 (-G)
unnamed: R152.2, S15.4 (-B)
unnamed: IC23.1 (OUT0), R150.1
unnamed: IC23.2 (OUT1), R151.1
unnamed: IC23.3 (OUT2), R152.1
unnamed: C93.2, R136.2
unnamed: C94.2, R137.2
unnamed: C104.1, R143.2
unnamed: R146.2, S14.1 (-R)
unnamed: R147.2, S14.2 (-G)
unnamed: R148.2, S14.4 (-B)
unnamed: IC22.1 (OUT0), R146.1
unnamed: IC22.2 (OUT1), R147.1
unnamed: IC22.3 (OUT2), R148.1
unnamed: C91.2, R134.2
unnamed: C92.2, R135.2
unnamed: C103.1, R142.2
unnamed: R174.2, S19.1 (-R)
unnamed: R175.2, S19.2 (-G)
unnamed: R176.2, S19.4 (-B)
unnamed: IC29.1 (OUT0), R174.1
unnamed: IC29.2 (OUT1), R175.1
unnamed: IC29.3 (OUT2), R176.1
unnamed: C111.2, R166.2
unnamed: C112.2, R167.2
unnamed: C118.1, R169.2
unnamed: IC27.1 (OUT0), R181.1
unnamed: IC27.2 (OUT1), R182.1
unnamed: IC27.3 (OUT2), R183.1
unnamed: C114.2, R163.2
unnamed: R170.2, S18.1 (-R)
unnamed: R171.2, S18.2 (-G)
unnamed: R172.2, S18.4 (-B)
unnamed: IC28.1 (OUT0), R170.1
unnamed: IC28.2 (OUT1), R171.1
unnamed: IC28.3 (OUT2), R172.1
unnamed: C109.2, R164.2
unnamed: C110.2, R165.2
unnamed: C117.1, R168.2
unnamed: R208.2, S23.1 (-R)
unnamed: R209.2, S23.2 (-G)
unnamed: R210.2, S23.4 (-B)
unnamed: IC33.1 (OUT0), R208.1
unnamed: IC33.2 (OUT1), R209.1
unnamed: IC33.3 (OUT2), R210.1
unnamed: C133.2, R190.2
unnamed: C134.2, R191.2
unnamed: C142.1, R195.2
unnamed: R204.2, S22.1 (-R)
unnamed: R205.2, S22.2 (-G)
unnamed: R206.2, S22.4 (-B)
unnamed: IC32.1 (OUT0), R204.1
unnamed: IC32.2 (OUT1), R205.1
unnamed: IC32.3 (OUT2), R206.1
unnamed: C131.2, R188.2
unnamed: C132.2, R189.2
unnamed: C141.1, R194.2
unnamed: R200.2, S21.1 (-R)
unnamed: R201.2, S21.2 (-G)
unnamed: R202.2, S21.4 (-B)
unnamed: IC31.1 (OUT0), R200.1
unnamed: IC31.2 (OUT1), R201.1
unnamed: IC31.3 (OUT2), R202.1
unnamed: C129.2, R186.2
unnamed: C130.2, R187.2
unnamed: C140.1, R193.2
unnamed: D10.1 (R), R183.2
unnamed: D10.4 (B), R182.2
unnamed: D10.3 (G), R181.2
unnamed: R196.2, S20.1 (-R)
unnamed: R197.2, S20.2 (-G)
unnamed: R198.2, S20.4 (-B)
unnamed: IC30.1 (OUT0), R196.1
unnamed: IC30.2 (OUT1), R197.1
unnamed: IC30.3 (OUT2), R198.1
unnamed: C127.2, R184.2
unnamed: C128.2, R185.2
unnamed: C139.1, R192.2
unnamed: IC26.1 (OUT0), R178.1
unnamed: IC26.2 (OUT1), R179.1
unnamed: IC26.3 (OUT2), R180.1
unnamed: C113.2, R162.2
unnamed: D9.1 (R), R180.2
unnamed: D9.4 (B), R179.2
unnamed: D9.3 (G), R178.2
PIXEL_48: IC33.6 (SDI); also elsewhere on the board
PIXEL_51: IC25.5 (SDO), IC27.6 (SDI)
PIXEL_52: IC24.6 (SDI), IC27.5 (SDO)
PIXEL_53: IC24.5 (SDO), IC28.6 (SDI)
PIXEL_54: IC23.5 (SDO); also elsewhere on the board
PIXEL_55: IC22.5 (SDO), IC23.6 (SDI)
PIXEL_56: IC22.6 (SDI), IC29.5 (SDO)
PIXEL_57: IC28.5 (SDO), IC29.6 (SDI)
PIXEL_61: IC32.6 (SDI), IC33.5 (SDO)
PIXEL_62: IC31.6 (SDI), IC32.5 (SDO)
PIXEL_63: IC30.6 (SDI), IC31.5 (SDO)
PIXEL_64: IC26.6 (SDI), IC30.5 (SDO)
RST: MCP_011.18 (!RESET), MCP_100.18 (!RESET); also elsewhere on the board
SPI3_MOSI: IC25.6 (SDI); also elsewhere on the board

Notes on the sheet:
RGB ENCODER 51
RGB ENCODER 53
RGB ENCODER 54
RGB ENCODER 55
RGB ENCODER 56
RGB ENCODER 57
RGB ENCODER 61
RGB ENCODER 62
RGB ENCODER 63
RGB ENCODER 64
SWITCH RGB 52
SWITCH RGB 65

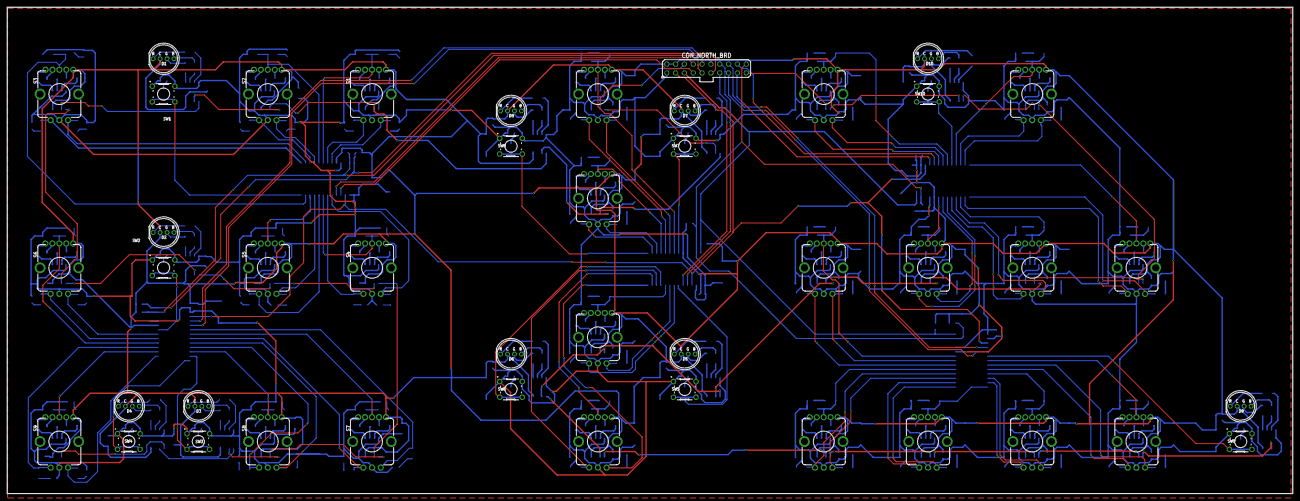
[picture p214: board STM32F446 front pane - south - v3.brd from above]

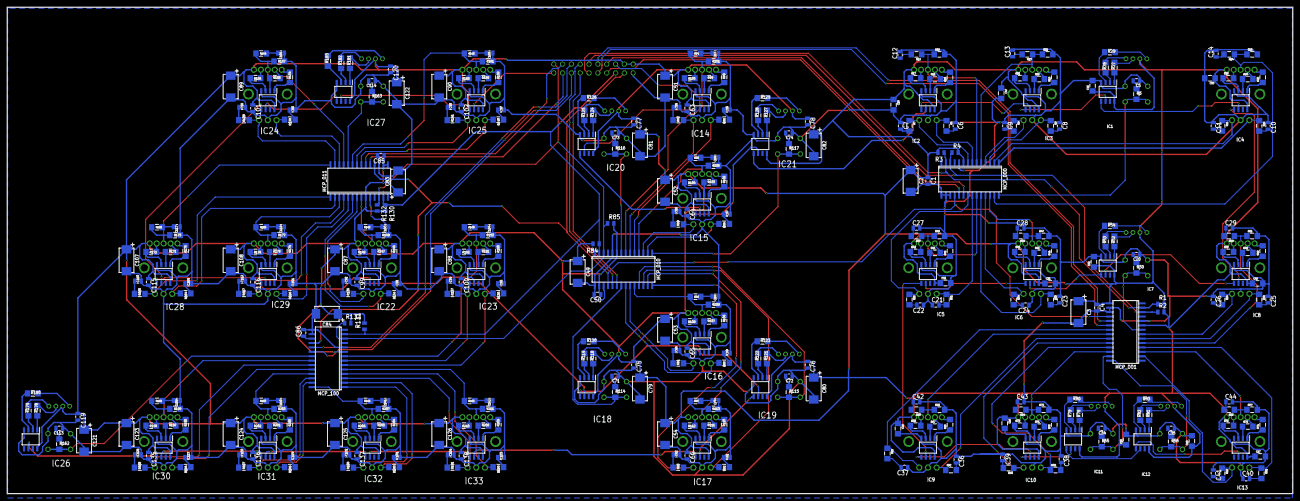
[picture p215: board STM32F446 front pane - south - v3.brd from below]

Board: 2 copper layers, 370.0 x 140.0 mm, 435 parts (391 on the bottom side), 406 nets.
