reynal/themis/front-pane/eagle-schematics/v3/STM32F446 front pane - northwest - v3.brd

## EAGLE design front-pane/eagle-schematics/v3/STM32F446 front pane - northwest - v3.brd (2020-12-17)

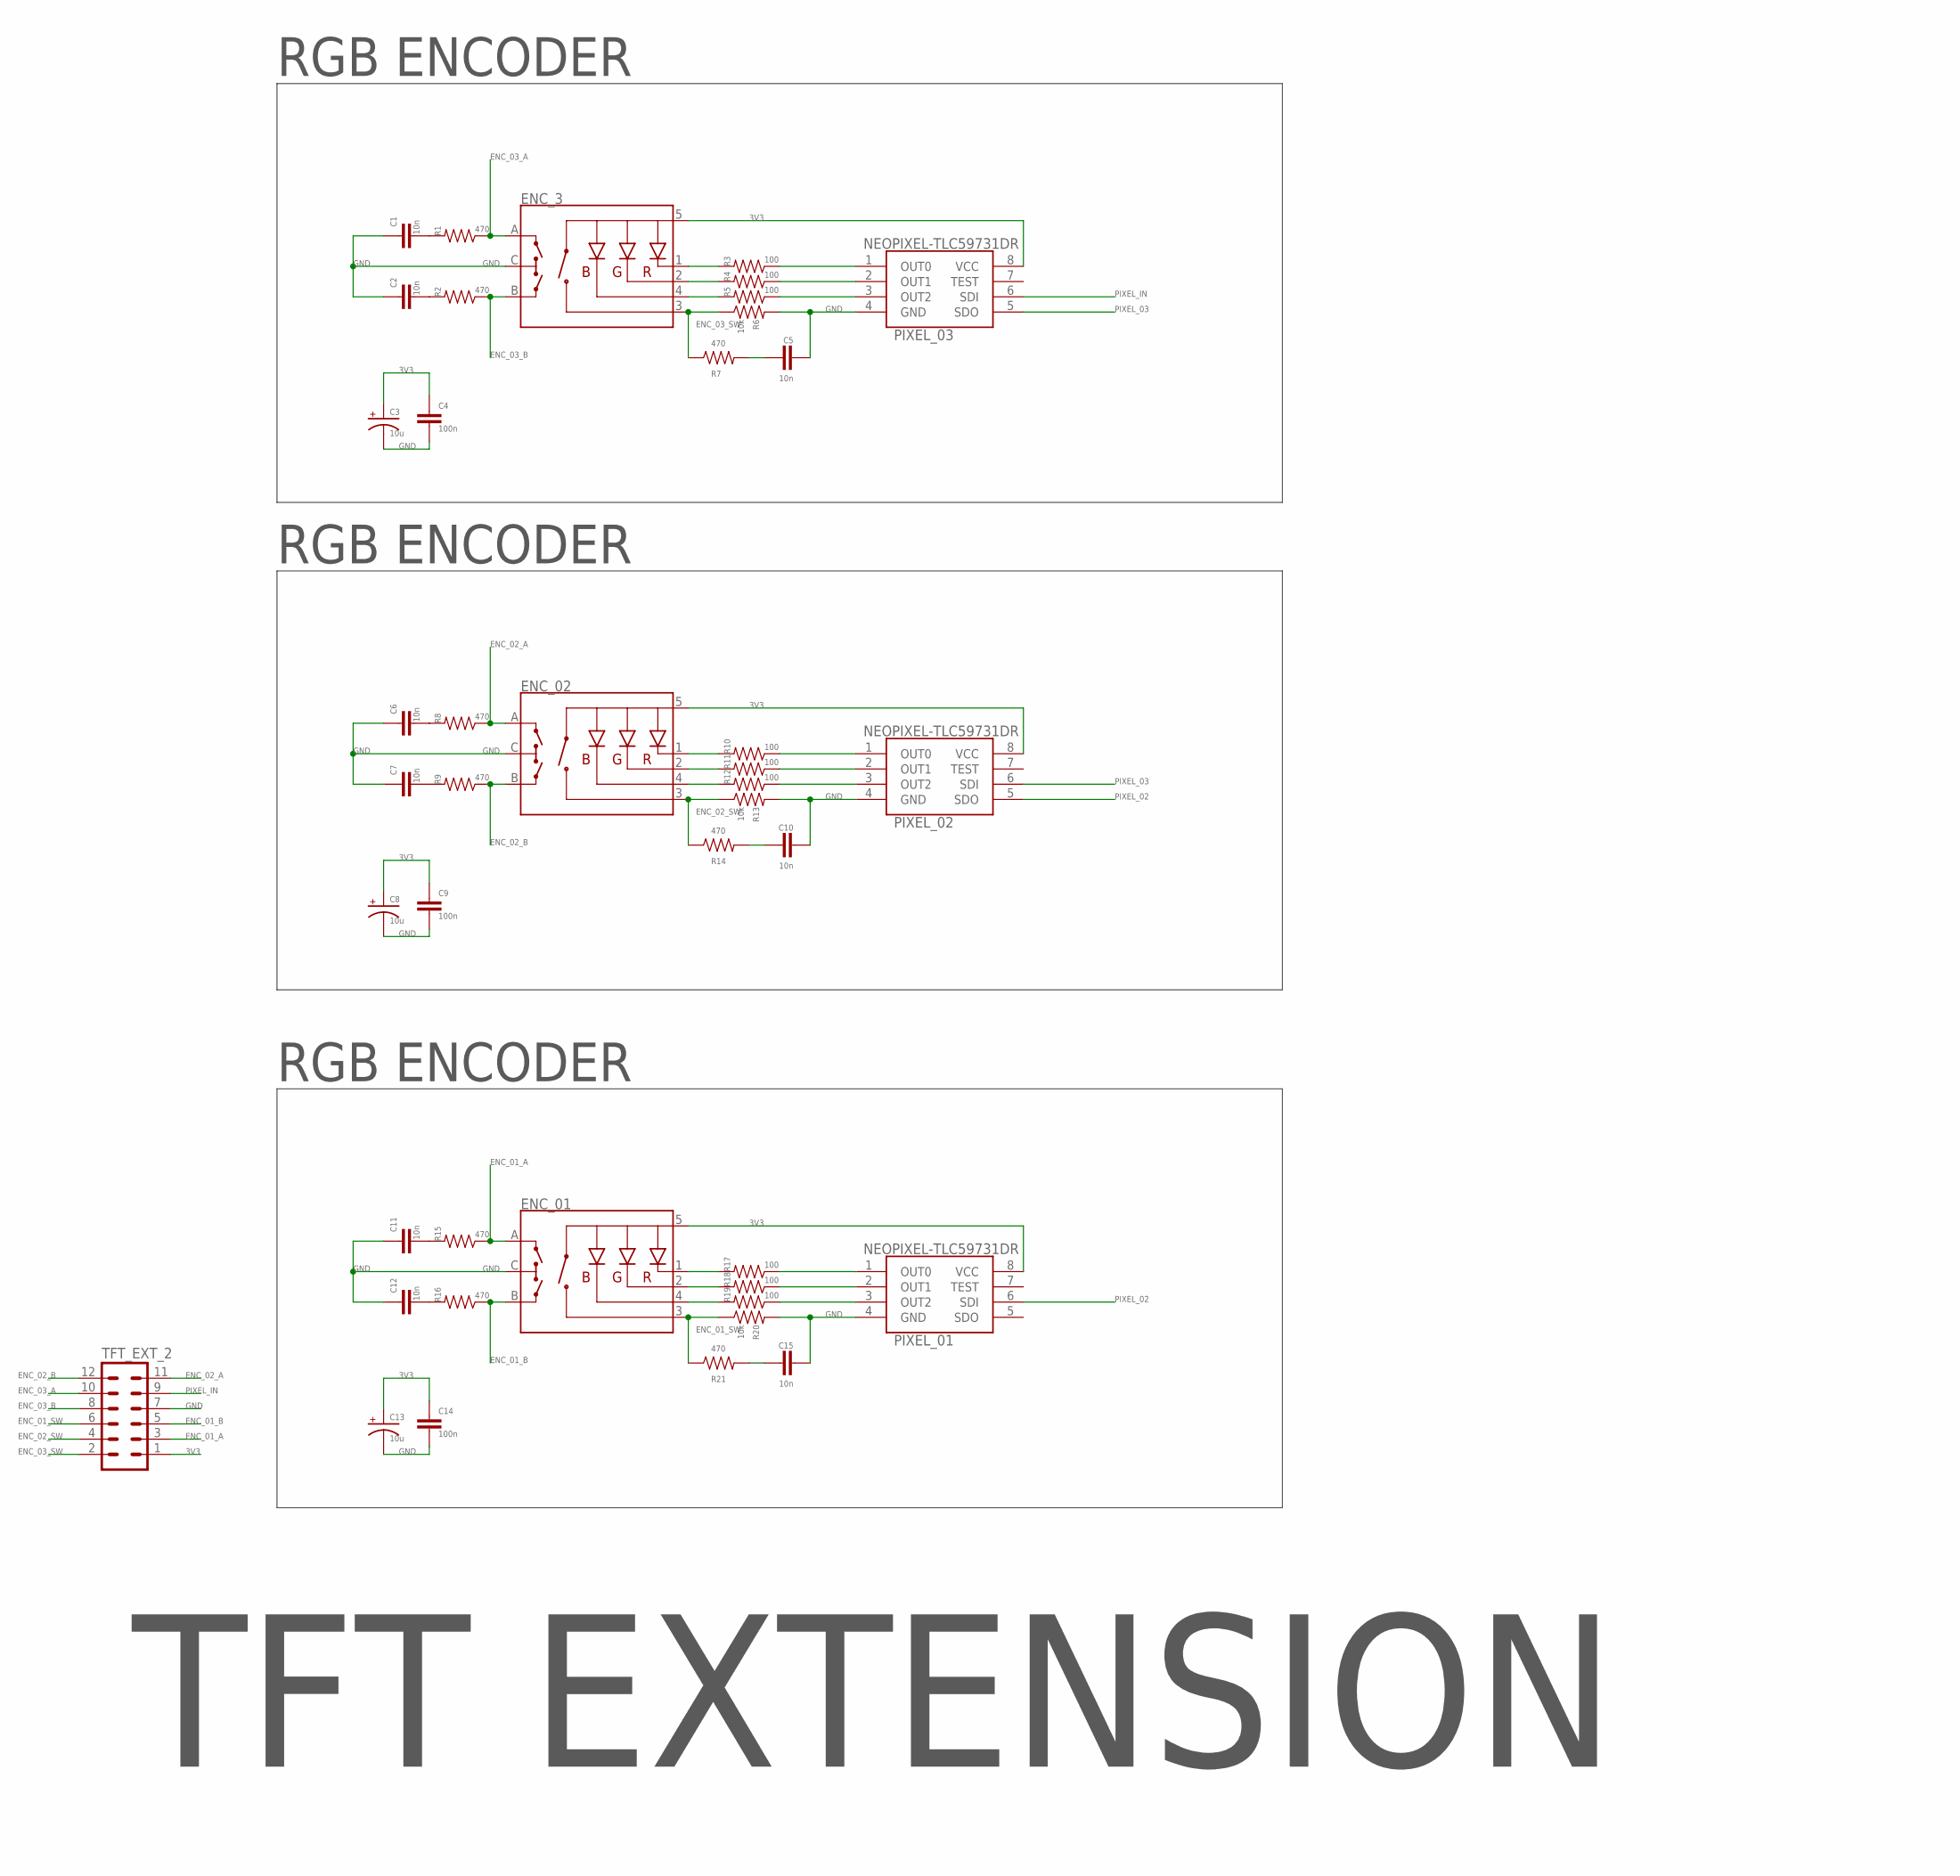
[picture p216: schematic STM32F446 front pane - northwest - v3.sch, sheet 7]

Parts:
C1, C2, C5, C6, C7, C10, C11, C12, C15: 10n; 0805-CAP
C3, C8, C13: 10u; CPOL2917
C4, C9, C14: 100n; 0805-CAP
ENC_01, ENC_02, ENC_3: ENCODER-RGB-SWITCH-NO_NUT; ENCODER_LED_3
PIXEL_01, PIXEL_02, PIXEL_03: NEOPIXEL-TLC59731DR; SOIC127P600X175-8N
R1, R2, R7, R8, R9, R14, R15, R16, R21: 470; 1206
R3, R4, R5, R10, R11, R12, R17, R18, R19: 100; 1206
R6, R13, R20: 10k; 1206
TFT_EXT_2: MA06-2

Connections:
3V3: C3.+, C4.1, C8.+, C9.1, C13.+, C14.1, ENC_01.5 (+), ENC_02.5 (+), ENC_3.5 (+), PIXEL_01.8 (VCC), PIXEL_02.8 (VCC), PIXEL_03.8 (VCC), TFT_EXT_2.1
ENC_01_A: ENC_01.A, R15.1, TFT_EXT_2.3
ENC_01_B: ENC_01.B, R16.1, TFT_EXT_2.5
ENC_01_SW: ENC_01.3 (SW), R20.1, R21.1, TFT_EXT_2.6
ENC_02_A: ENC_02.A, R8.1, TFT_EXT_2.11
ENC_02_B: ENC_02.B, R9.1, TFT_EXT_2.12
ENC_02_SW: ENC_02.3 (SW), R13.1, R14.1, TFT_EXT_2.4
ENC_03_A: ENC_3.A, R1.1, TFT_EXT_2.10
ENC_03_B: ENC_3.B, R2.1, TFT_EXT_2.8
ENC_03_SW: ENC_3.3 (SW), R6.1, R7.1, TFT_EXT_2.2
GND: C1.1, C2.1, C3.-, C4.2, C5.2, C6.1, C7.1, C8.-, C9.2, C10.2, C11.1, C12.1, C13.-, C14.2, C15.2, ENC_01.C, ENC_02.C, ENC_3.C, PIXEL_01.4 (GND), PIXEL_02.4 (GND), PIXEL_03.4 (GND), R6.2, R13.2, R20.2, TFT_EXT_2.7
unnamed: ENC_01.1 (-R), R17.2
unnamed: ENC_01.2 (-G), R18.2
unnamed: ENC_01.4 (-B), R19.2
unnamed: PIXEL_01.1 (OUT0), R17.1
unnamed: PIXEL_01.2 (OUT1), R18.1
unnamed: PIXEL_01.3 (OUT2), R19.1
unnamed: C11.2, R15.2
unnamed: C12.2, R16.2
unnamed: C15.1, R21.2
unnamed: ENC_02.1 (-R), R10.2
unnamed: ENC_02.2 (-G), R11.2
unnamed: ENC_02.4 (-B), R12.2
unnamed: PIXEL_02.1 (OUT0), R10.1
unnamed: PIXEL_02.2 (OUT1), R11.1
unnamed: PIXEL_02.3 (OUT2), R12.1
unnamed: C6.2, R8.2
unnamed: C7.2, R9.2
unnamed: C10.1, R14.2
unnamed: ENC_3.1 (-R), R3.2
unnamed: ENC_3.2 (-G), R4.2
unnamed: ENC_3.4 (-B), R5.2
unnamed: PIXEL_03.1 (OUT0), R3.1
unnamed: PIXEL_03.2 (OUT1), R4.1
unnamed: PIXEL_03.3 (OUT2), R5.1
unnamed: C1.2, R1.2
unnamed: C2.2, R2.2
unnamed: C5.1, R7.2
PIXEL_02: PIXEL_01.6 (SDI), PIXEL_02.5 (SDO)
PIXEL_03: PIXEL_02.6 (SDI), PIXEL_03.5 (SDO)
PIXEL_IN: PIXEL_03.6 (SDI), TFT_EXT_2.9

Notes on the sheet:
TFT EXTENSION
RGB ENCODER

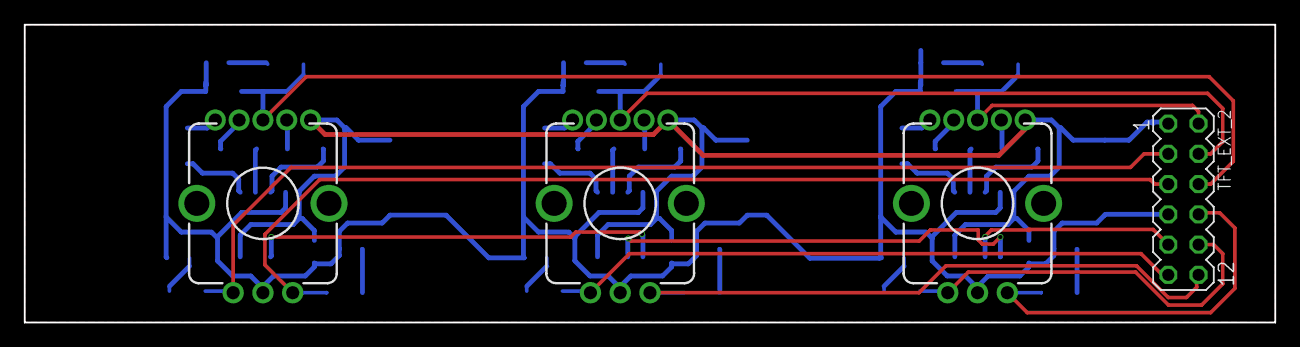
[picture p217: board STM32F446 front pane - northwest - v3.brd from above]

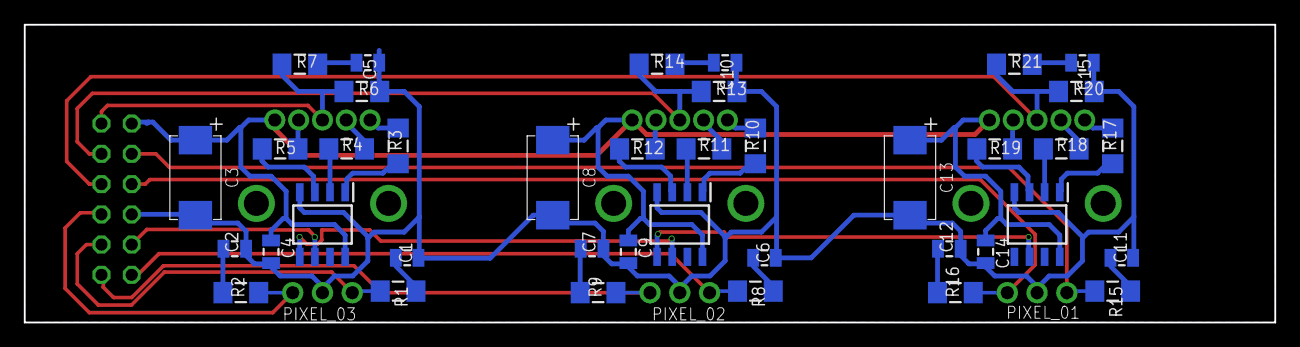
[picture p218: board STM32F446 front pane - northwest - v3.brd from below]

Board: 2 copper layers, 105.0 x 25.0 mm, 43 parts (39 on the bottom side), 41 nets.
