reynal/themis/front-pane/eagle-schematics/v3/STM32F446 front pane - northeast - v3.brd

## EAGLE design front-pane/eagle-schematics/v3/STM32F446 front pane - northeast - v3.brd (2020-12-17)

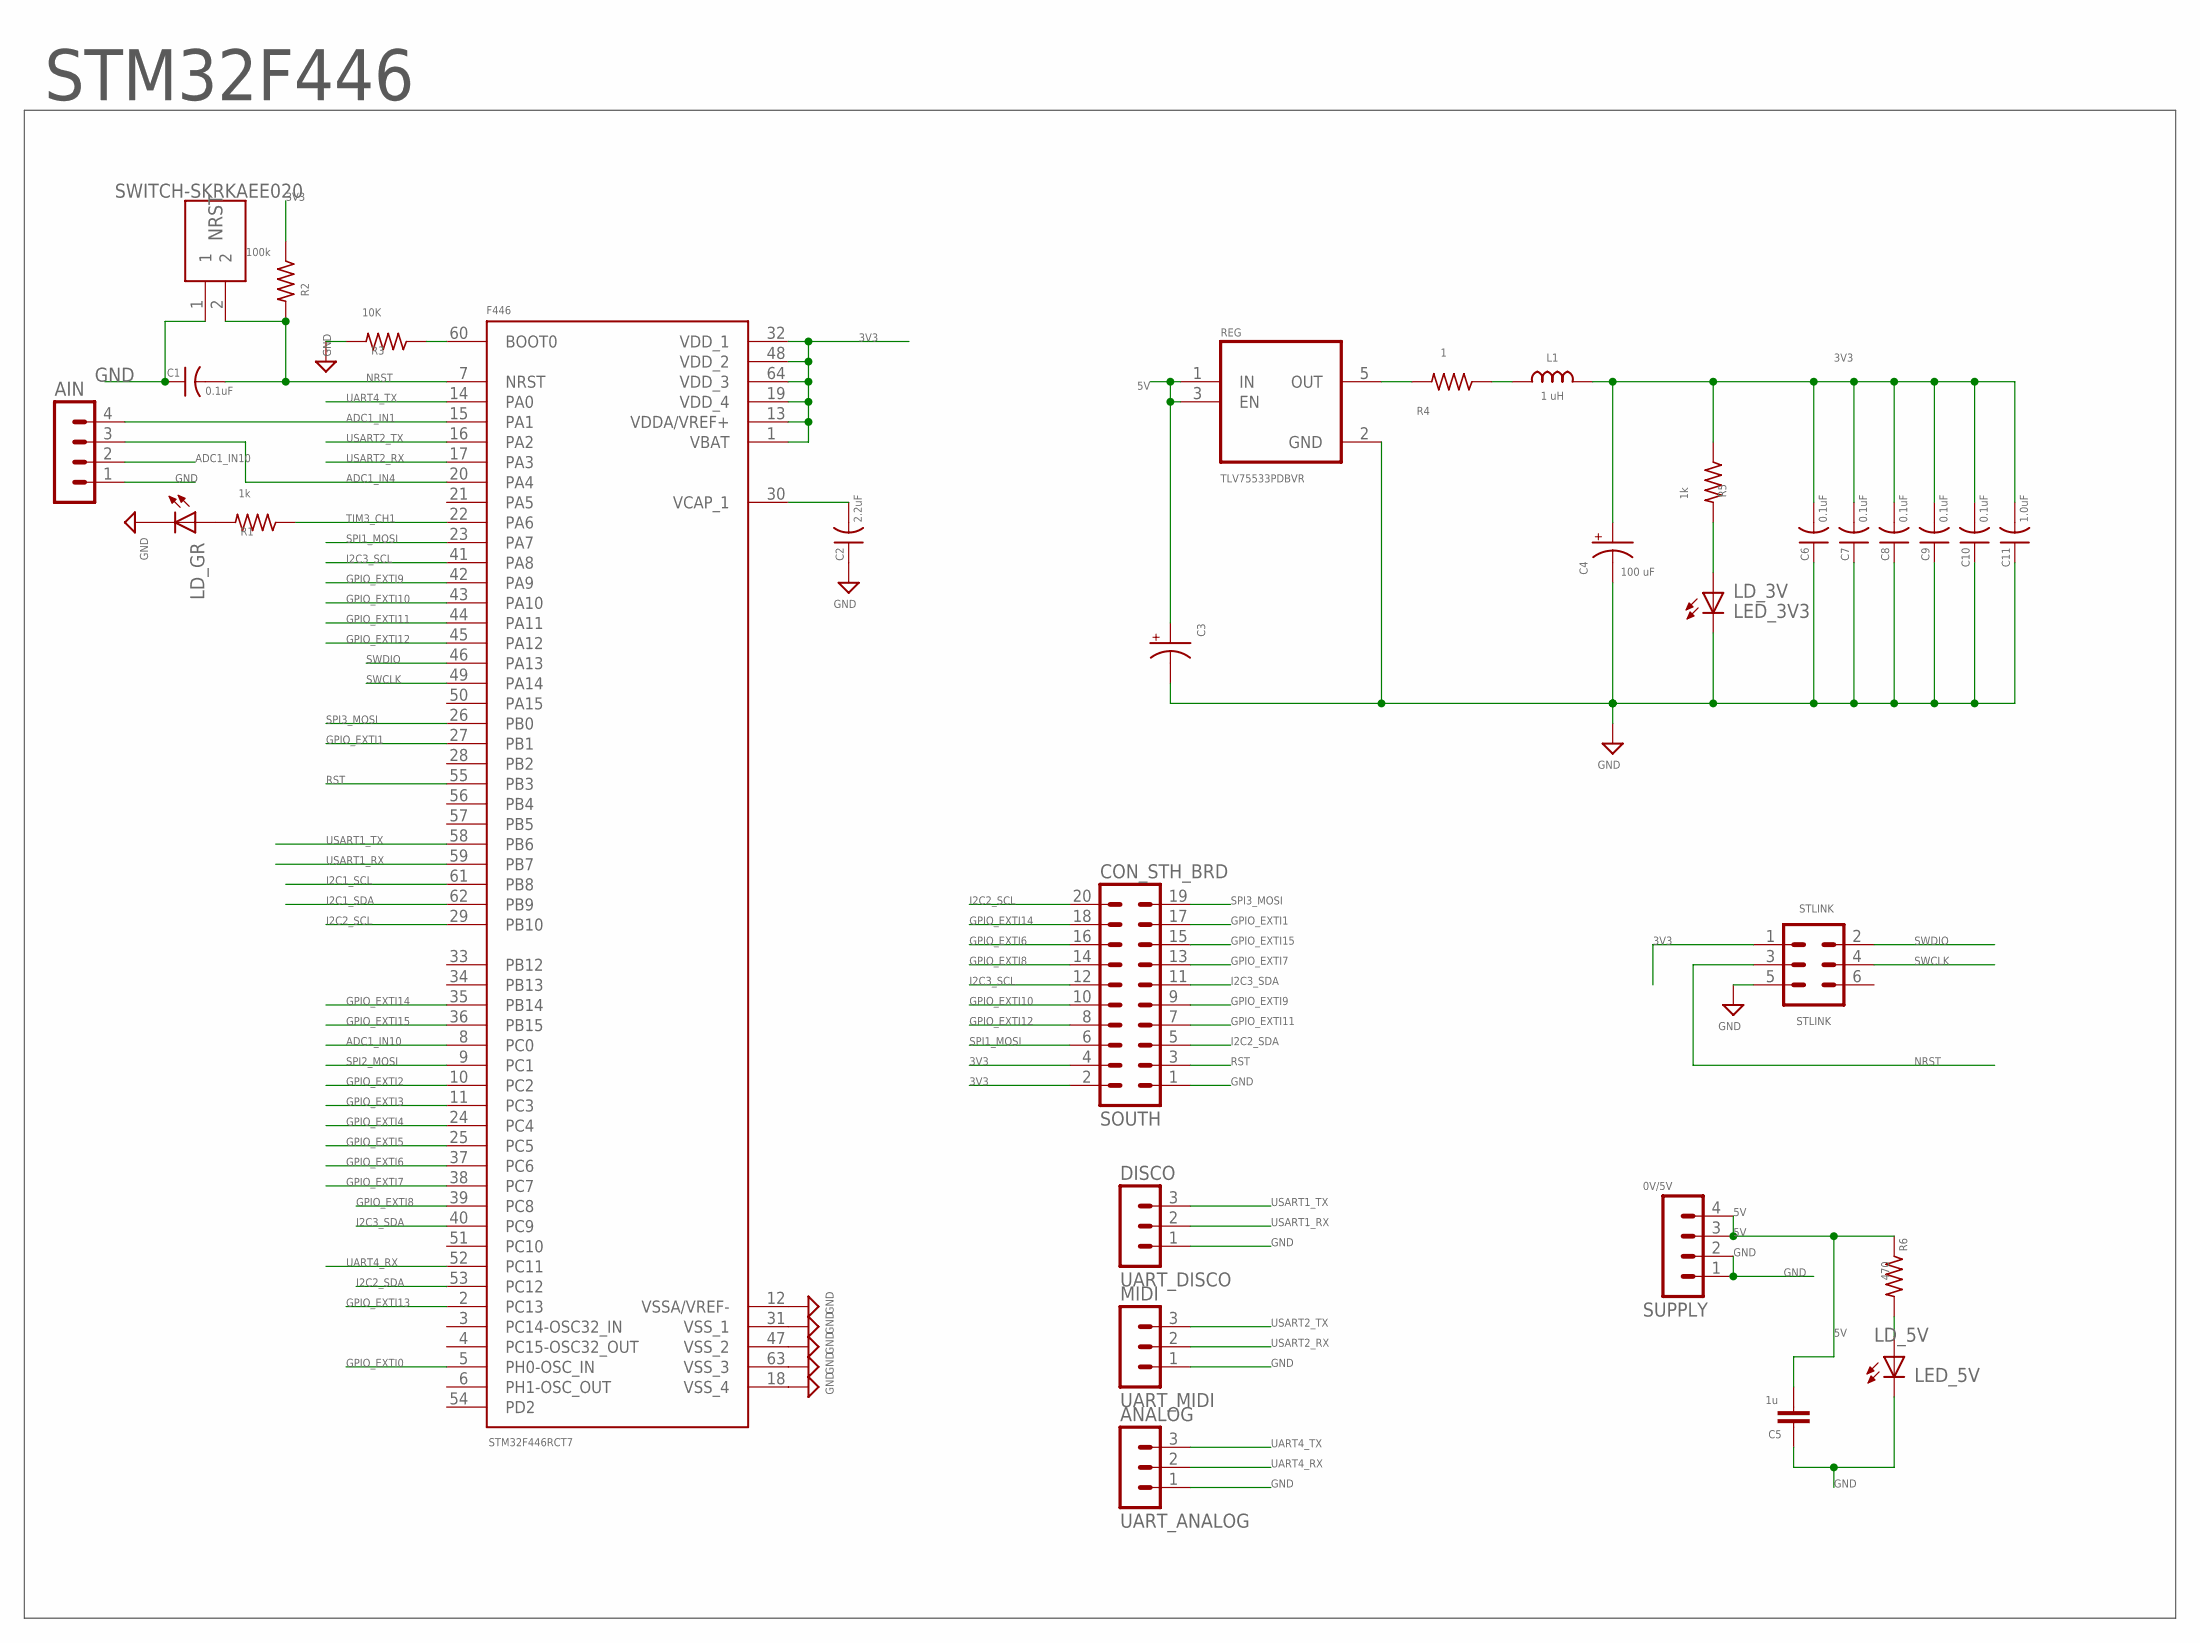
[picture p219: schematic STM32F446 front pane - northeast - v3.sch, sheet 1]

Parts:
0V/5V: SUPPLY; MA04-1
AIN: MA04-1
ANALOG: UART_ANALOG; MA03-1
C1, C6, C7, C8, C9, C10: 0.1uF; C0805
C2: 2.2uF; C0805
C3: 10u; CPOL2917
C4: 100 uF; CPOL2917
C5: 1u; C1206
C11: 1.0uF; C0805
CON_STH_BRD: SOUTH; MA10-2
DISCO: UART_DISCO; MA03-1
F446: STM32F446RCT7; QFP50P1200X1200X160-64N
L1: 1 uH; L0805
LD_3V: LED_3V3; 0805-LED
LD_5V: LED_5V; 0603-LED
LD_GR: LED-0805; 0805-LED
MIDI: UART_MIDI; MA03-1
NRST: SWITCH-SKRKAEE020; SKRKAEE020
R1, R5: 1k; R0805
R2: 100k; R0805
R3: 10K; R0805
R4: 1; R0805
R6: 470; R0805
REG: TLV75533PDBVR; SOT95P280X145-5N
STLINK: STLINK; MA03-2

Connections:
3V3: C4.+, C6.2, C7.2, C8.2, C9.2, C10.2, C11.2, CON_STH_BRD.2, CON_STH_BRD.4, F446.1 (VBAT), F446.13 (VDDA/VREF+), F446.19 (VDD_4), F446.32 (VDD_1), F446.48 (VDD_2), F446.64 (VDD_3), L1.2, R2.1, R5.1, STLINK.1; also elsewhere on the board
5V: 0V/5V.3, 0V/5V.4, C3.+, C5.2, R6.1, REG.1 (IN), REG.3 (EN)
ADC1_IN1: AIN.4, F446.15 (PA1)
ADC1_IN4: AIN.3, F446.20 (PA4)
ADC1_IN10: AIN.2, F446.8 (PC0)
BOOT1: F446.60 (BOOT0), R3.1
GND: 0V/5V.1, 0V/5V.2, AIN.1, ANALOG.1, C1.1, C2.1, C3.-, C4.-, C5.1, C6.1, C7.1, C8.1, C9.1, C10.1, C11.1, CON_STH_BRD.1, DISCO.1, F446.12 (VSSA/VREF-), F446.18 (VSS_4), F446.31 (VSS_1), F446.47 (VSS_2), F446.63 (VSS_3), LD_3V.C, LD_5V.C, LD_GR.C, MIDI.1, NRST.1, R3.2, REG.2 (GND), STLINK.5; also elsewhere on the board
GPIO_EXTI0: F446.5 (PH0-OSC_IN); also elsewhere on the board
GPIO_EXTI1: CON_STH_BRD.17, F446.27 (PB1)
GPIO_EXTI2: F446.10 (PC2); also elsewhere on the board
GPIO_EXTI3: F446.11 (PC3); also elsewhere on the board
GPIO_EXTI4: F446.24 (PC4); also elsewhere on the board
GPIO_EXTI5: F446.25 (PC5); also elsewhere on the board
GPIO_EXTI6: CON_STH_BRD.16, F446.37 (PC6)
GPIO_EXTI7: CON_STH_BRD.13, F446.38 (PC7)
GPIO_EXTI8: CON_STH_BRD.14, F446.39 (PC8)
GPIO_EXTI9: CON_STH_BRD.9, F446.42 (PA9)
GPIO_EXTI10: CON_STH_BRD.10, F446.43 (PA10)
GPIO_EXTI11: CON_STH_BRD.7, F446.44 (PA11)
GPIO_EXTI12: CON_STH_BRD.8, F446.45 (PA12)
GPIO_EXTI13: F446.2 (PC13); also elsewhere on the board
GPIO_EXTI14: CON_STH_BRD.18, F446.35 (PB14)
GPIO_EXTI15: CON_STH_BRD.15, F446.36 (PB15)
I2C1_SCL: F446.61 (PB8); also elsewhere on the board
I2C1_SDA: F446.62 (PB9); also elsewhere on the board
I2C2_SCL: CON_STH_BRD.20, F446.29 (PB10)
I2C2_SDA: CON_STH_BRD.5, F446.53 (PC12)
I2C3_SCL: CON_STH_BRD.12, F446.41 (PA8)
I2C3_SDA: CON_STH_BRD.11, F446.40 (PC9)
unnamed: LD_5V.A, R6.2
unnamed: LD_GR.A, R1.2
unnamed: LD_3V.A, R5.2
unnamed: R4.2, REG.5 (OUT)
unnamed: L1.1, R4.1
NRST: C1.2, F446.7 (NRST), NRST.2, R2.2, STLINK.3
RST: CON_STH_BRD.3, F446.55 (PB3); also elsewhere on the board
SPI1_MOSI: CON_STH_BRD.6, F446.23 (PA7)
SPI2_MOSI: F446.9 (PC1); also elsewhere on the board
SPI3_MOSI: CON_STH_BRD.19, F446.26 (PB0)
SWCLK: F446.49 (PA14), STLINK.4
SWDIO: F446.46 (PA13), STLINK.2
TIM3_CH1: F446.22 (PA6), R1.1
UART4_RX: ANALOG.2, F446.52 (PC11)
UART4_TX: ANALOG.3, F446.14 (PA0)
USART1_RX: DISCO.2, F446.59 (PB7)
USART1_TX: DISCO.3, F446.58 (PB6)
USART2_RX: F446.17 (PA3), MIDI.2
USART2_TX: F446.16 (PA2), MIDI.3
VCAP1: C2.2, F446.30 (VCAP_1)

Notes on the sheet:
STM32F446
