reynal/themis/front-pane/eagle-schematics/v3/STM32F446 front pane - northeast - v3.brd

## EAGLE design front-pane/eagle-schematics/v3/STM32F446 front pane - northeast - v3.brd (continued)

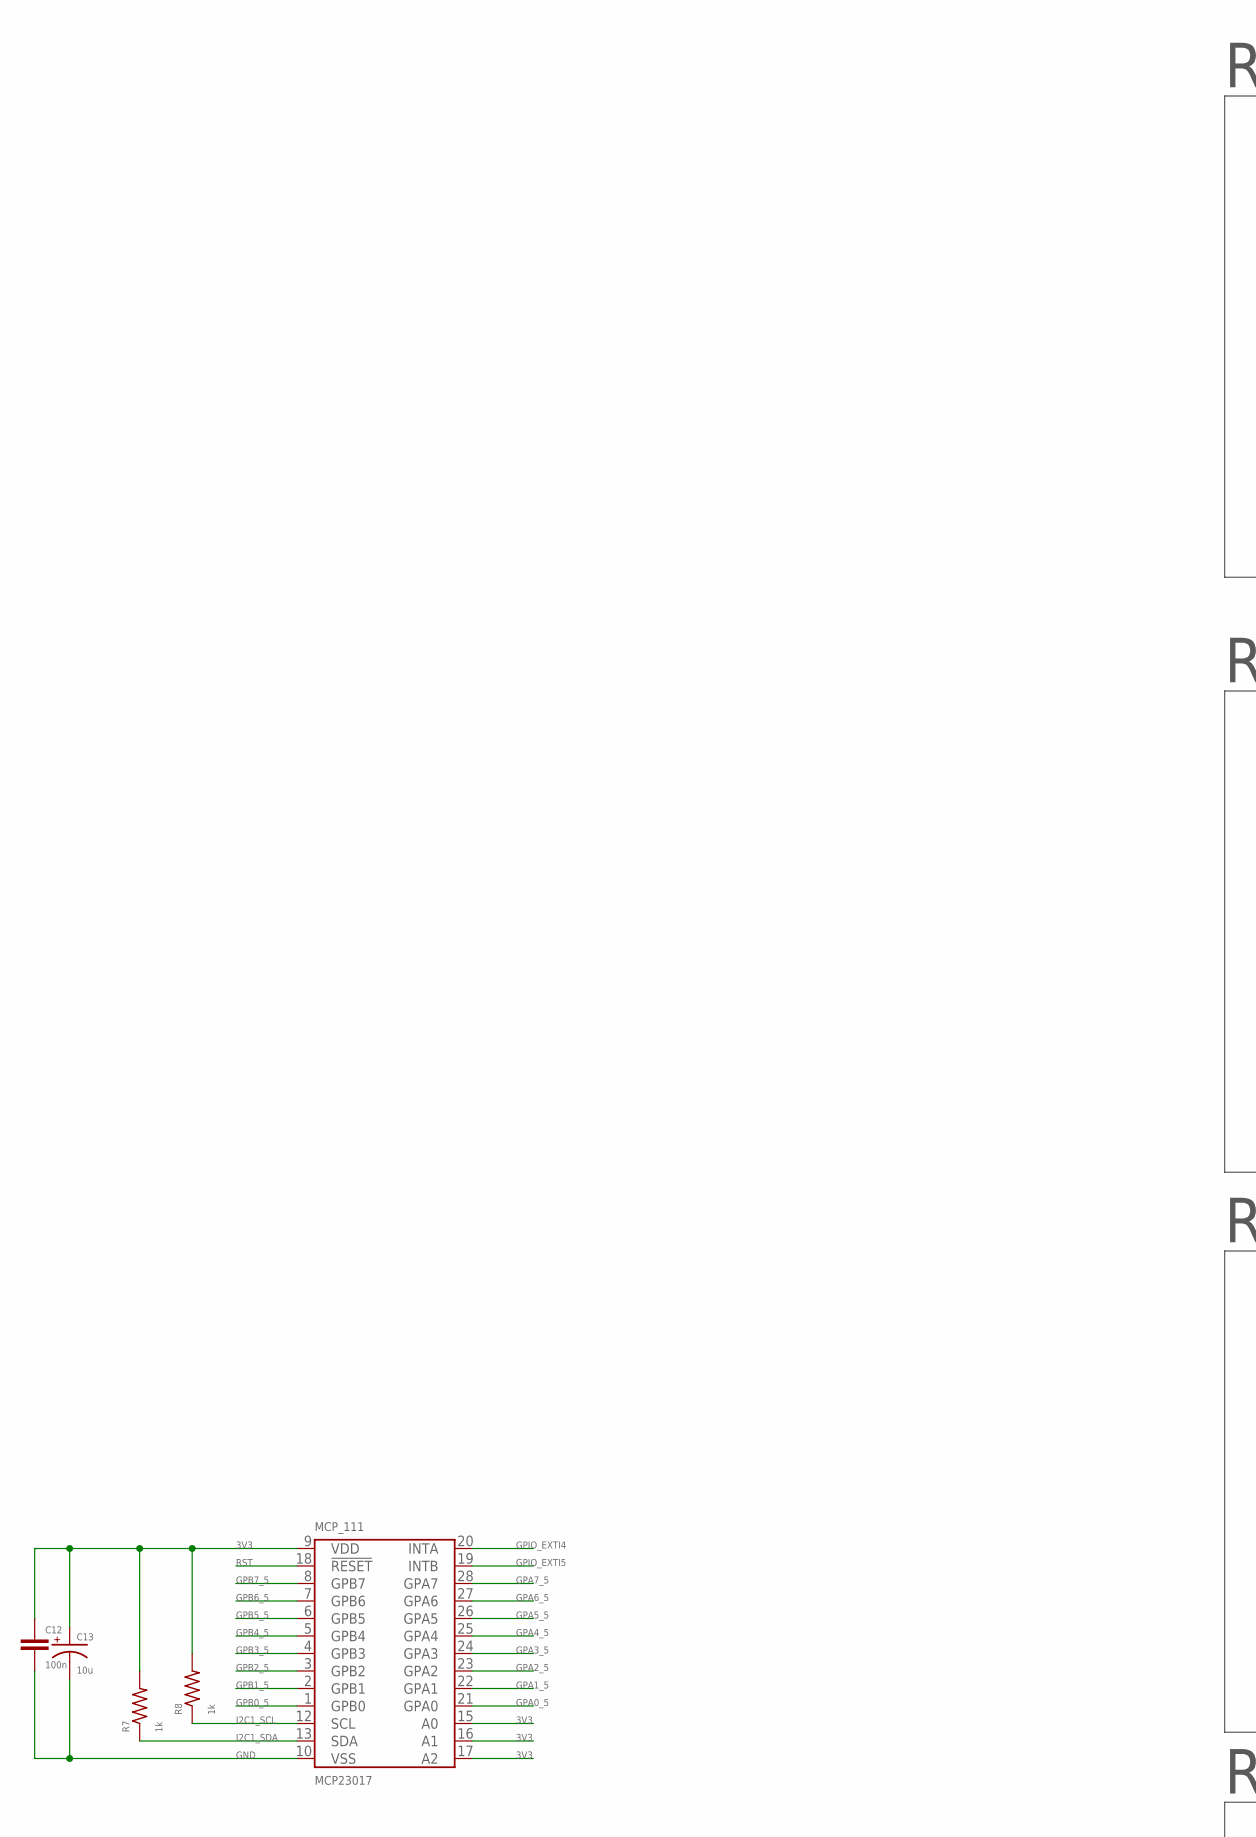
[picture p220: schematic STM32F446 front pane - northeast - v3.sch, sheet 2, part in row 1, column 1]

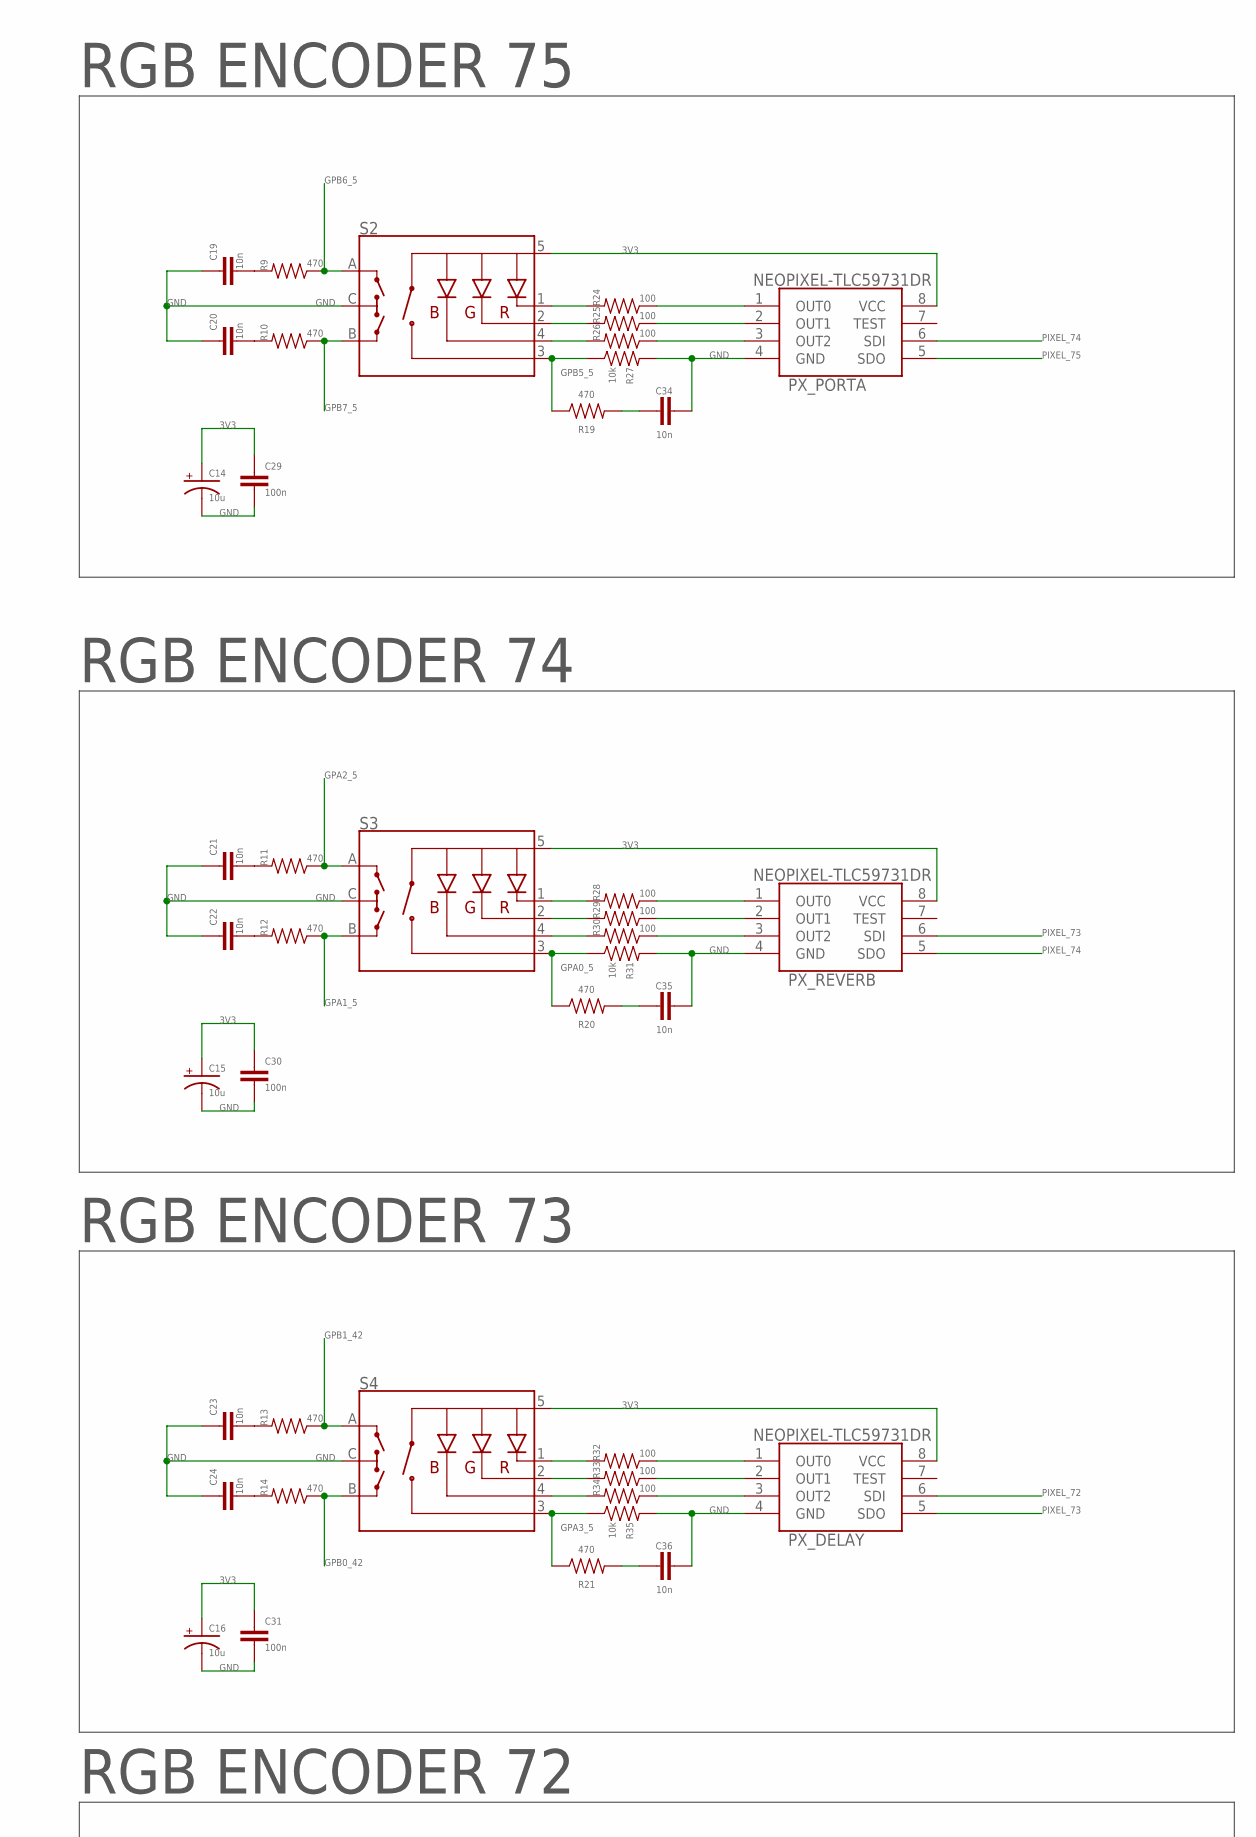
[picture p221: schematic STM32F446 front pane - northeast - v3.sch, sheet 2, part in row 1, column 2]


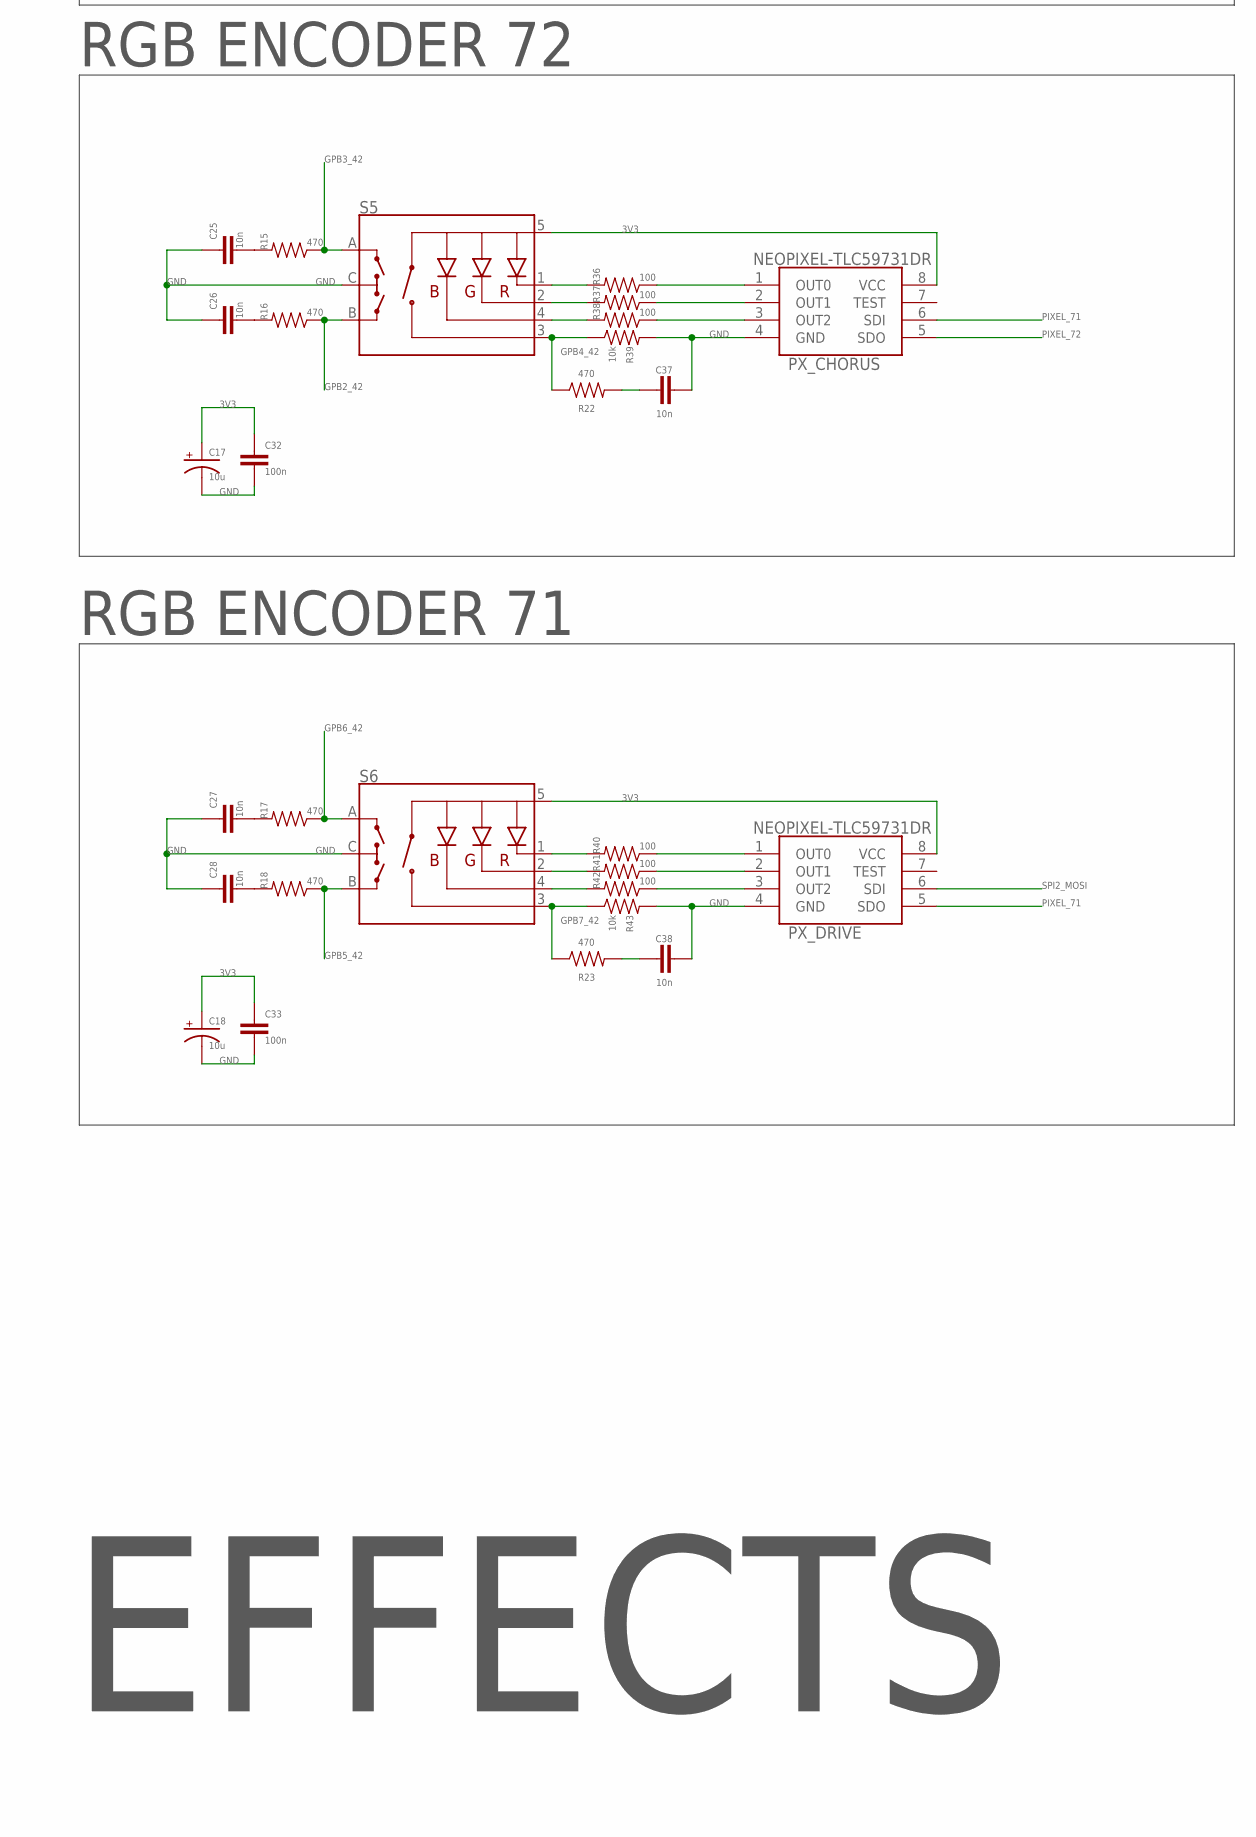
[picture p222: schematic STM32F446 front pane - northeast - v3.sch, sheet 2, part in row 2, column 2]

Parts:
C12, C29, C30, C31, C32, C33: 100n; 0805-CAP
C13, C14, C15, C16, C17, C18: 10u; CPOL2917
C19, C20, C21, C22, C23, C24, C25, C26, C27, C28, C34, C35, C36, C37, C38: 10n; 0805-CAP
MCP_111: MCP23017; SOIC-28
PX_CHORUS: NEOPIXEL-TLC59731DR; SOIC127P600X175-8N
PX_DELAY: NEOPIXEL-TLC59731DR; SOIC127P600X175-8N
PX_DRIVE: NEOPIXEL-TLC59731DR; SOIC127P600X175-8N
PX_PORTA: NEOPIXEL-TLC59731DR; SOIC127P600X175-8N
PX_REVERB: NEOPIXEL-TLC59731DR; SOIC127P600X175-8N
R7, R8: 1k; R0805
R9, R10, R11, R12, R13, R14, R15, R16, R17, R18, R19, R20, R21, R22, R23: 470; 1206
R24, R25, R26, R28, R29, R30, R32, R33, R34, R36, R37, R38, R40, R41, R42: 100; 1206
R27, R31, R35, R39, R43: 10k; 1206
S2, S3, S4, S5, S6: ENCODER-RGB-SWITCH-NO_NUT; ENCODER_LED_3

Connections:
3V3: C12.1, C13.+, C14.+, C15.+, C16.+, C17.+, C18.+, C29.1, C30.1, C31.1, C32.1, C33.1, MCP_111.9 (VDD), MCP_111.15 (A0), MCP_111.16 (A1), MCP_111.17 (A2), PX_CHORUS.8 (VCC), PX_DELAY.8 (VCC), PX_DRIVE.8 (VCC), PX_PORTA.8 (VCC), PX_REVERB.8 (VCC), R7.2, R8.2, S2.5 (+), S3.5 (+), S4.5 (+), S5.5 (+), S6.5 (+); also elsewhere on the board
GND: C12.2, C13.-, C14.-, C15.-, C16.-, C17.-, C18.-, C19.1, C20.1, C21.1, C22.1, C23.1, C24.1, C25.1, C26.1, C27.1, C28.1, C29.2, C30.2, C31.2, C32.2, C33.2, C34.2, C35.2, C36.2, C37.2, C38.2, MCP_111.10 (VSS), PX_CHORUS.4 (GND), PX_DELAY.4 (GND), PX_DRIVE.4 (GND), PX_PORTA.4 (GND), PX_REVERB.4 (GND), R27.2, R31.2, R35.2, R39.2, R43.2, S2.C, S3.C, S4.C, S5.C, S6.C; also elsewhere on the board
GPA0_5: MCP_111.21 (GPA0), R20.1, R31.1, S3.3 (SW)
GPA1_5: MCP_111.22 (GPA1), R12.1, S3.B
GPA2_5: MCP_111.23 (GPA2), R11.1, S3.A
GPA3_5: MCP_111.24 (GPA3), R21.1, R35.1, S4.3 (SW)
GPA4_5: MCP_111.25 (GPA4); also elsewhere on the board
GPA5_5: MCP_111.26 (GPA5); also elsewhere on the board
GPA6_5: MCP_111.27 (GPA6); also elsewhere on the board
GPA7_5: MCP_111.28 (GPA7); also elsewhere on the board
GPB0_5: MCP_111.1 (GPB0); also elsewhere on the board
GPB0_42: R14.1, S4.B; also elsewhere on the board
GPB1_5: MCP_111.2 (GPB1); also elsewhere on the board
GPB1_42: R13.1, S4.A; also elsewhere on the board
GPB2_5: MCP_111.3 (GPB2); also elsewhere on the board
GPB2_42: R16.1, S5.B; also elsewhere on the board
GPB3_5: MCP_111.4 (GPB3); also elsewhere on the board
GPB3_42: R15.1, S5.A; also elsewhere on the board
GPB4_5: MCP_111.5 (GPB4); also elsewhere on the board
GPB4_42: R22.1, R39.1, S5.3 (SW); also elsewhere on the board
GPB5_5: MCP_111.6 (GPB5), R19.1, R27.1, S2.3 (SW)
GPB5_42: R18.1, S6.B; also elsewhere on the board
GPB6_5: MCP_111.7 (GPB6), R9.1, S2.A
GPB6_42: R17.1, S6.A; also elsewhere on the board
GPB7_5: MCP_111.8 (GPB7), R10.1, S2.B
GPB7_42: R23.1, R43.1, S6.3 (SW); also elsewhere on the board
GPIO_EXTI4: MCP_111.20 (INTA); also elsewhere on the board
GPIO_EXTI5: MCP_111.19 (INTB); also elsewhere on the board
I2C1_SCL: MCP_111.12 (SCL), R8.1; also elsewhere on the board
I2C1_SDA: MCP_111.13 (SDA), R7.1; also elsewhere on the board
unnamed: R40.2, S6.1 (-R)
unnamed: R41.2, S6.2 (-G)
unnamed: R42.2, S6.4 (-B)
unnamed: PX_DRIVE.1 (OUT0), R40.1
unnamed: PX_DRIVE.2 (OUT1), R41.1
unnamed: PX_DRIVE.3 (OUT2), R42.1
unnamed: C27.2, R17.2
unnamed: C28.2, R18.2
unnamed: C38.1, R23.2
unnamed: R36.2, S5.1 (-R)
unnamed: R37.2, S5.2 (-G)
unnamed: R38.2, S5.4 (-B)
unnamed: PX_CHORUS.1 (OUT0), R36.1
unnamed: PX_CHORUS.2 (OUT1), R37.1
unnamed: PX_CHORUS.3 (OUT2), R38.1
unnamed: C25.2, R15.2
unnamed: C26.2, R16.2
unnamed: C37.1, R22.2
unnamed: R32.2, S4.1 (-R)
unnamed: R33.2, S4.2 (-G)
unnamed: R34.2, S4.4 (-B)
unnamed: PX_DELAY.1 (OUT0), R32.1
unnamed: PX_DELAY.2 (OUT1), R33.1
unnamed: PX_DELAY.3 (OUT2), R34.1
unnamed: C23.2, R13.2
unnamed: C24.2, R14.2
unnamed: C36.1, R21.2
unnamed: R28.2, S3.1 (-R)
unnamed: R29.2, S3.2 (-G)
unnamed: R30.2, S3.4 (-B)
unnamed: PX_REVERB.1 (OUT0), R28.1
unnamed: PX_REVERB.2 (OUT1), R29.1
unnamed: PX_REVERB.3 (OUT2), R30.1
unnamed: C21.2, R11.2
unnamed: C22.2, R12.2
unnamed: C35.1, R20.2
unnamed: R24.2, S2.1 (-R)
unnamed: R25.2, S2.2 (-G)
unnamed: R26.2, S2.4 (-B)
unnamed: PX_PORTA.1 (OUT0), R24.1
unnamed: PX_PORTA.2 (OUT1), R25.1
unnamed: PX_PORTA.3 (OUT2), R26.1
unnamed: C19.2, R9.2
unnamed: C20.2, R10.2
unnamed: C34.1, R19.2
PIXEL_71: PX_CHORUS.6 (SDI), PX_DRIVE.5 (SDO)
PIXEL_72: PX_CHORUS.5 (SDO), PX_DELAY.6 (SDI)
PIXEL_73: PX_DELAY.5 (SDO), PX_REVERB.6 (SDI)
PIXEL_74: PX_PORTA.6 (SDI), PX_REVERB.5 (SDO)
PIXEL_75: PX_PORTA.5 (SDO); also elsewhere on the board
RST: MCP_111.18 (!RESET); also elsewhere on the board
SPI2_MOSI: PX_DRIVE.6 (SDI); also elsewhere on the board

Notes on the sheet:
EFFECTS
RGB ENCODER 71
RGB ENCODER 72
RGB ENCODER 73
RGB ENCODER 74
RGB ENCODER 75
