reynal/themis/front-pane/eagle-schematics/v3/STM32F446 front pane - northeast - v3.brd

## EAGLE design front-pane/eagle-schematics/v3/STM32F446 front pane - northeast - v3.brd (continued)

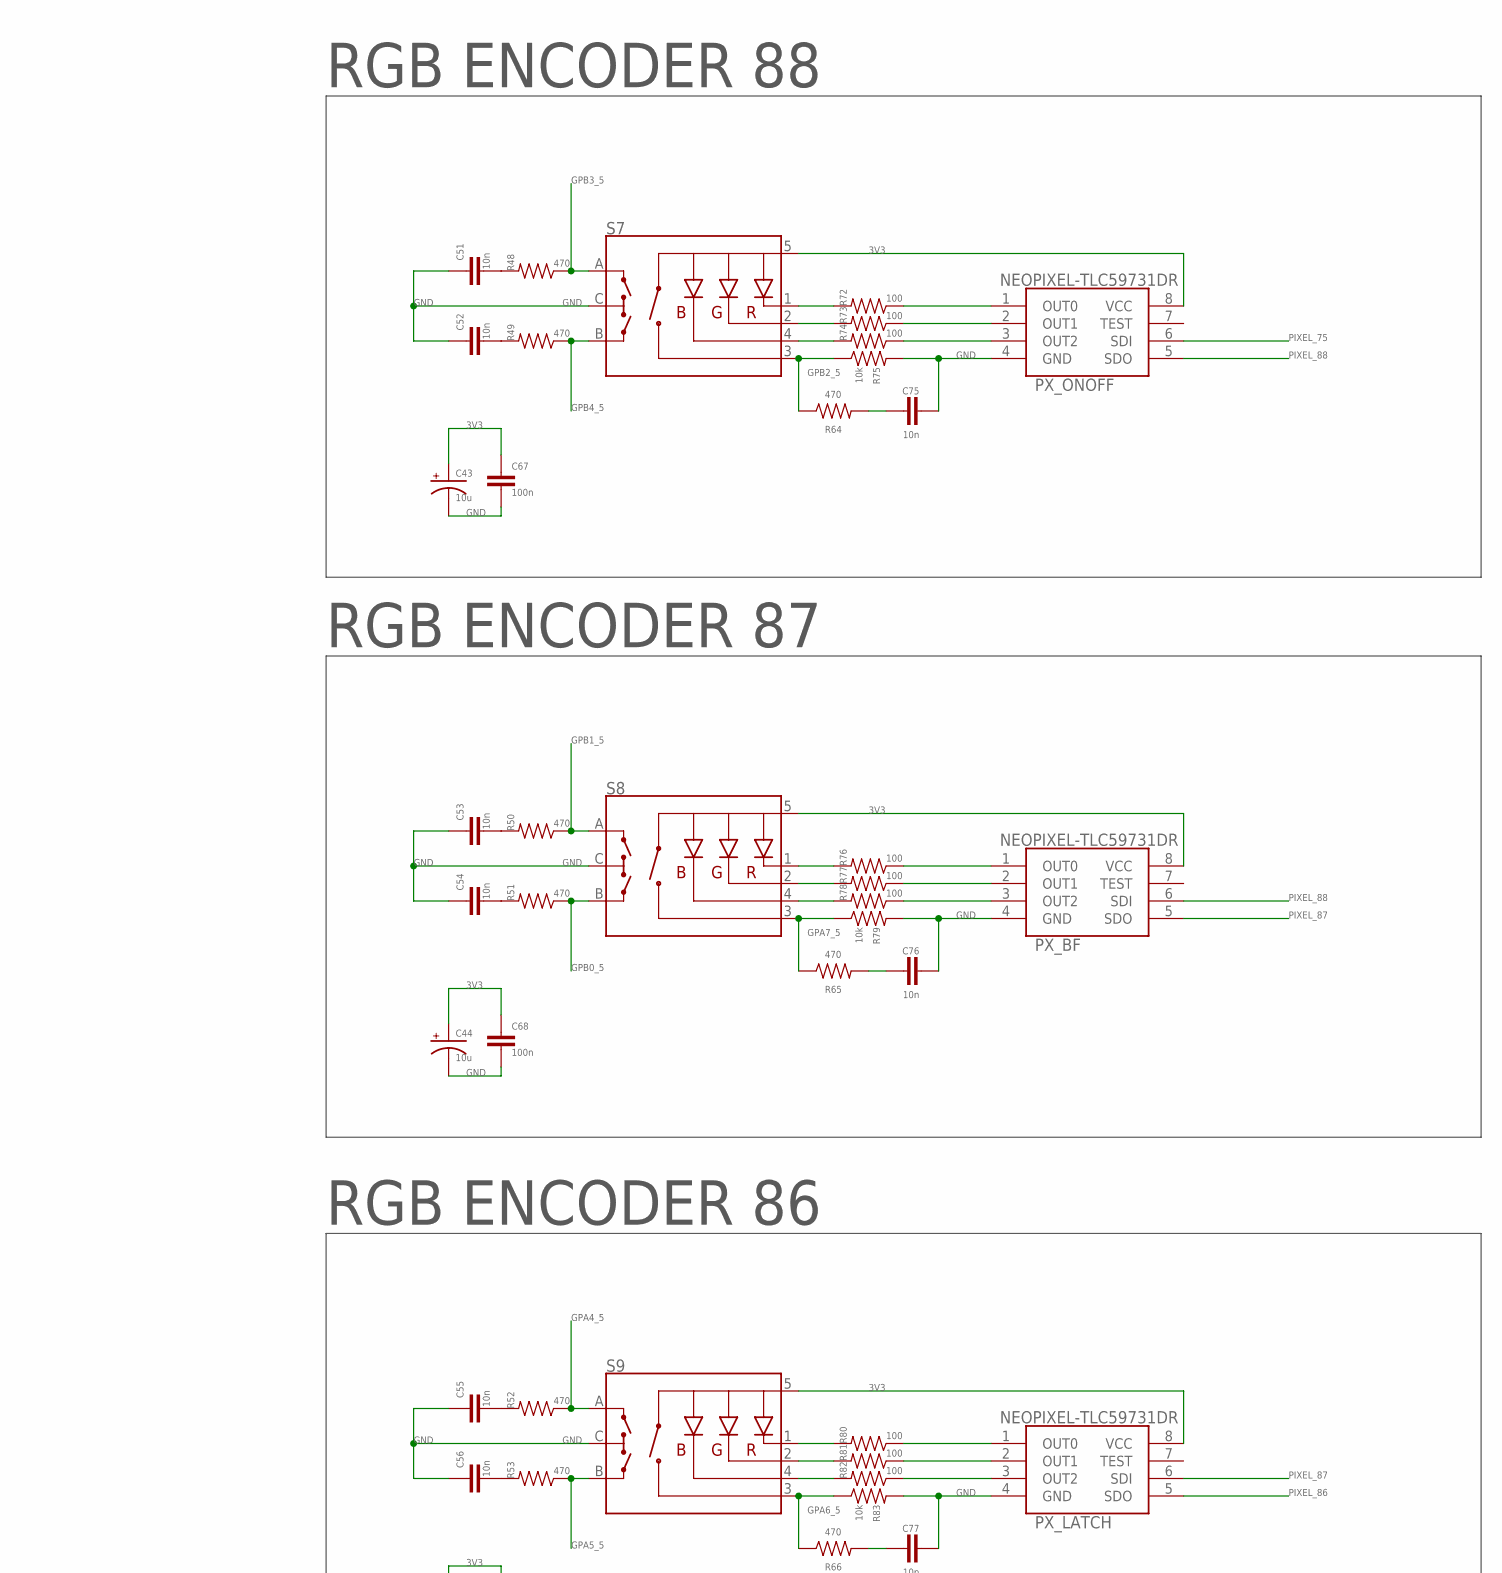
[picture p223: schematic STM32F446 front pane - northeast - v3.sch, sheet 3, part in row 1, column 2]

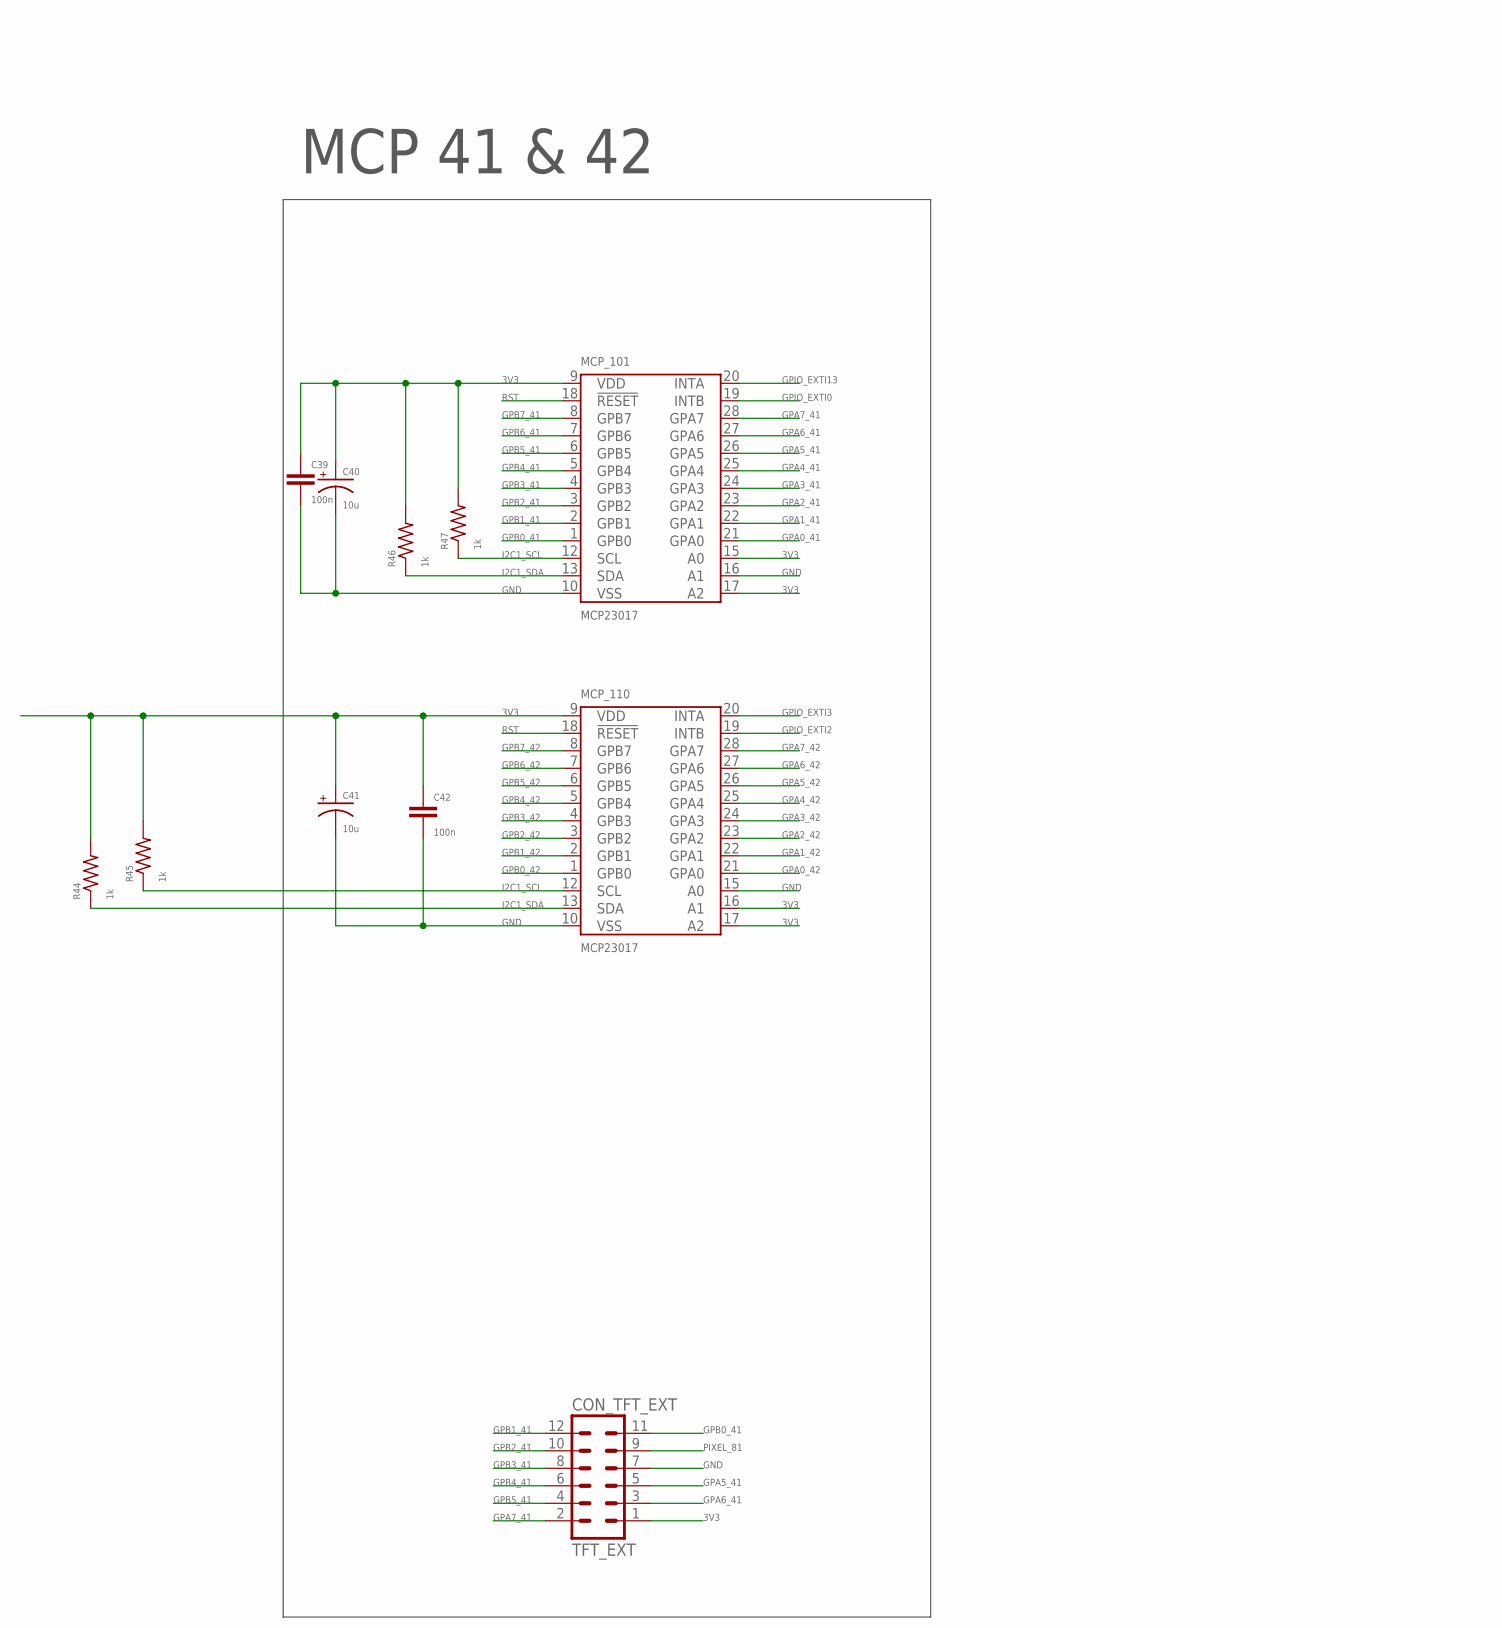
[picture p224: schematic STM32F446 front pane - northeast - v3.sch, sheet 3, part in row 2, column 1]

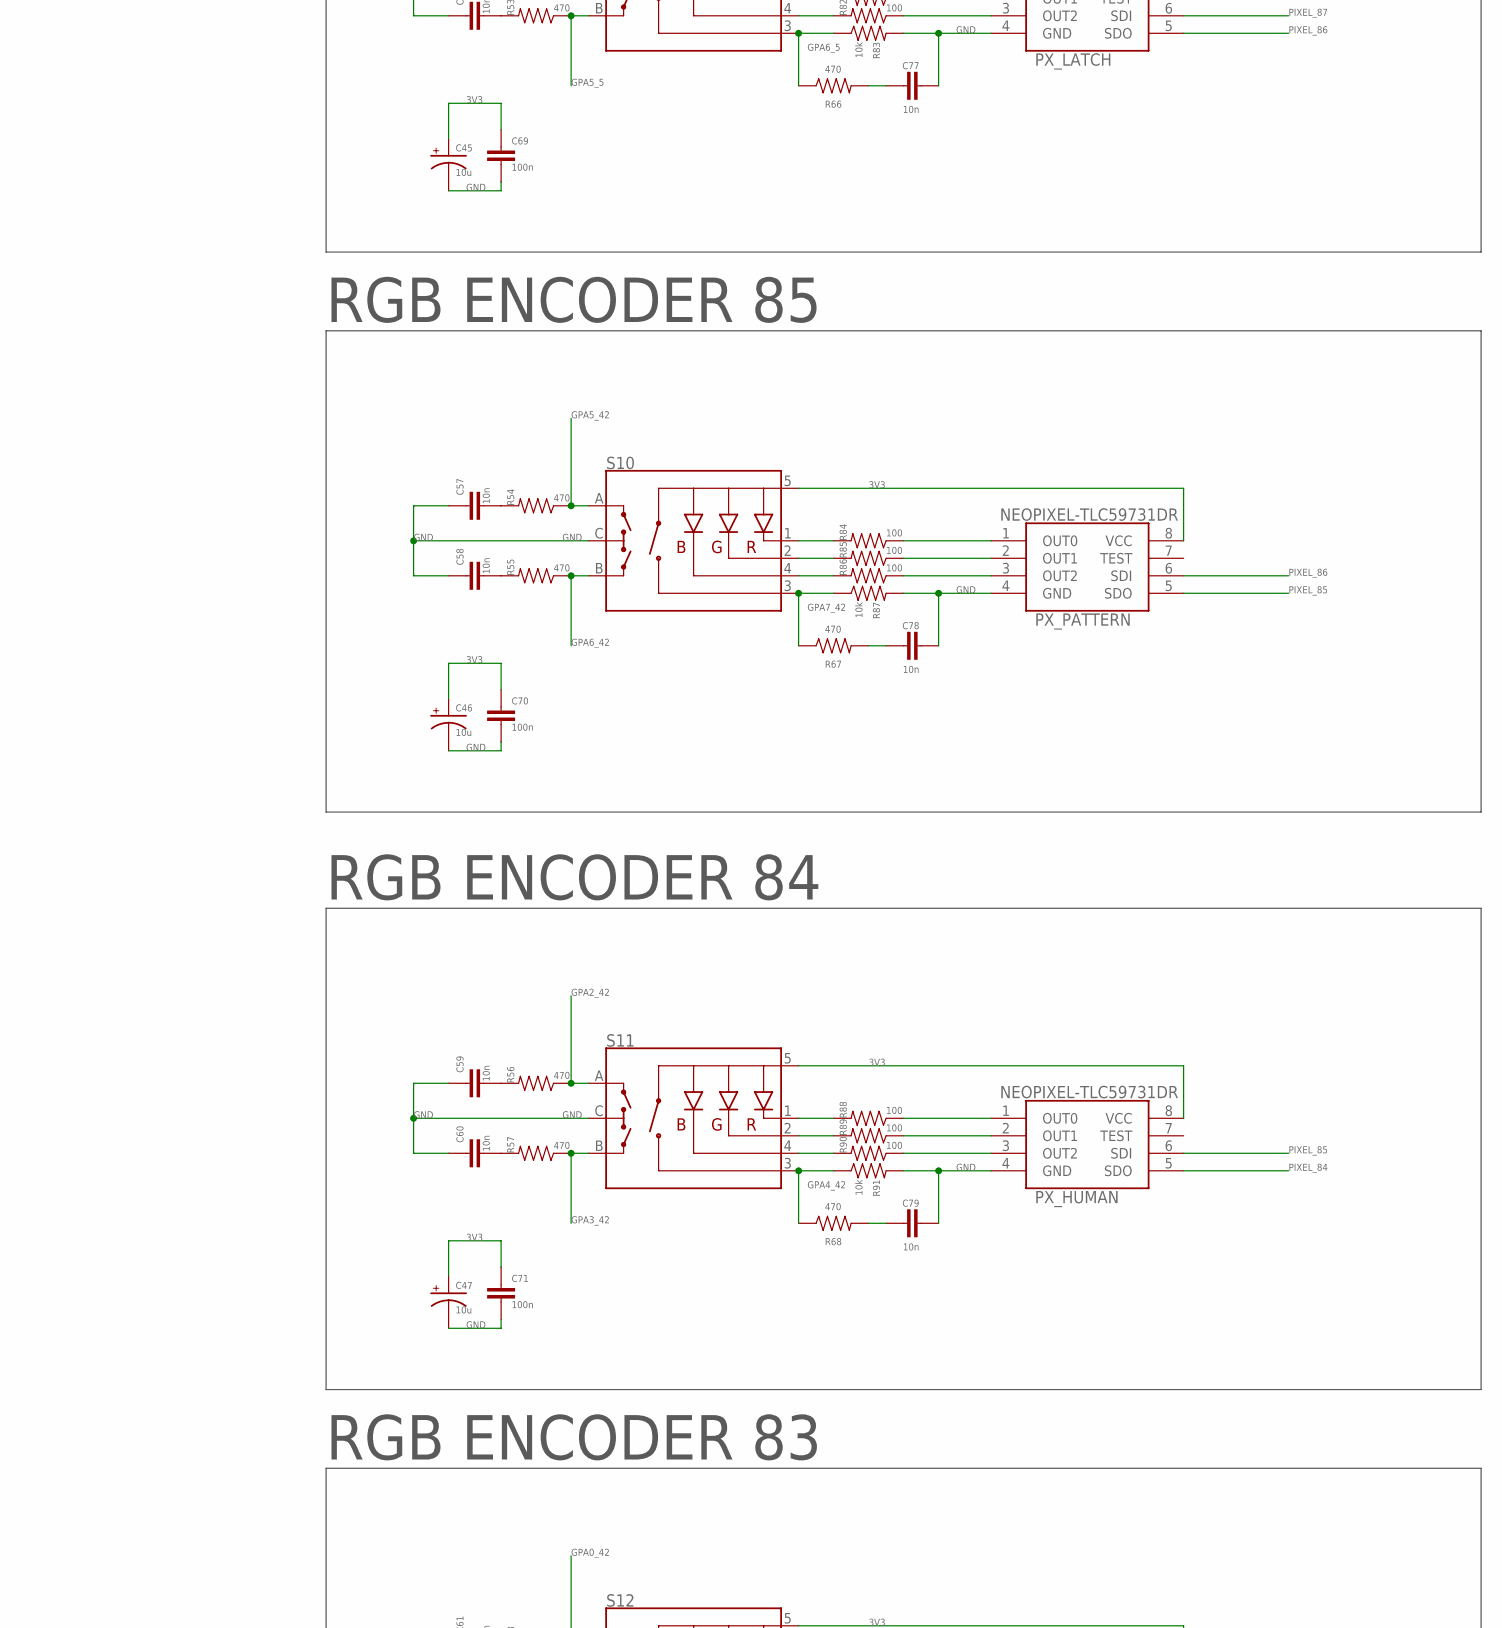
[picture p225: schematic STM32F446 front pane - northeast - v3.sch, sheet 3, part in row 2, column 2]

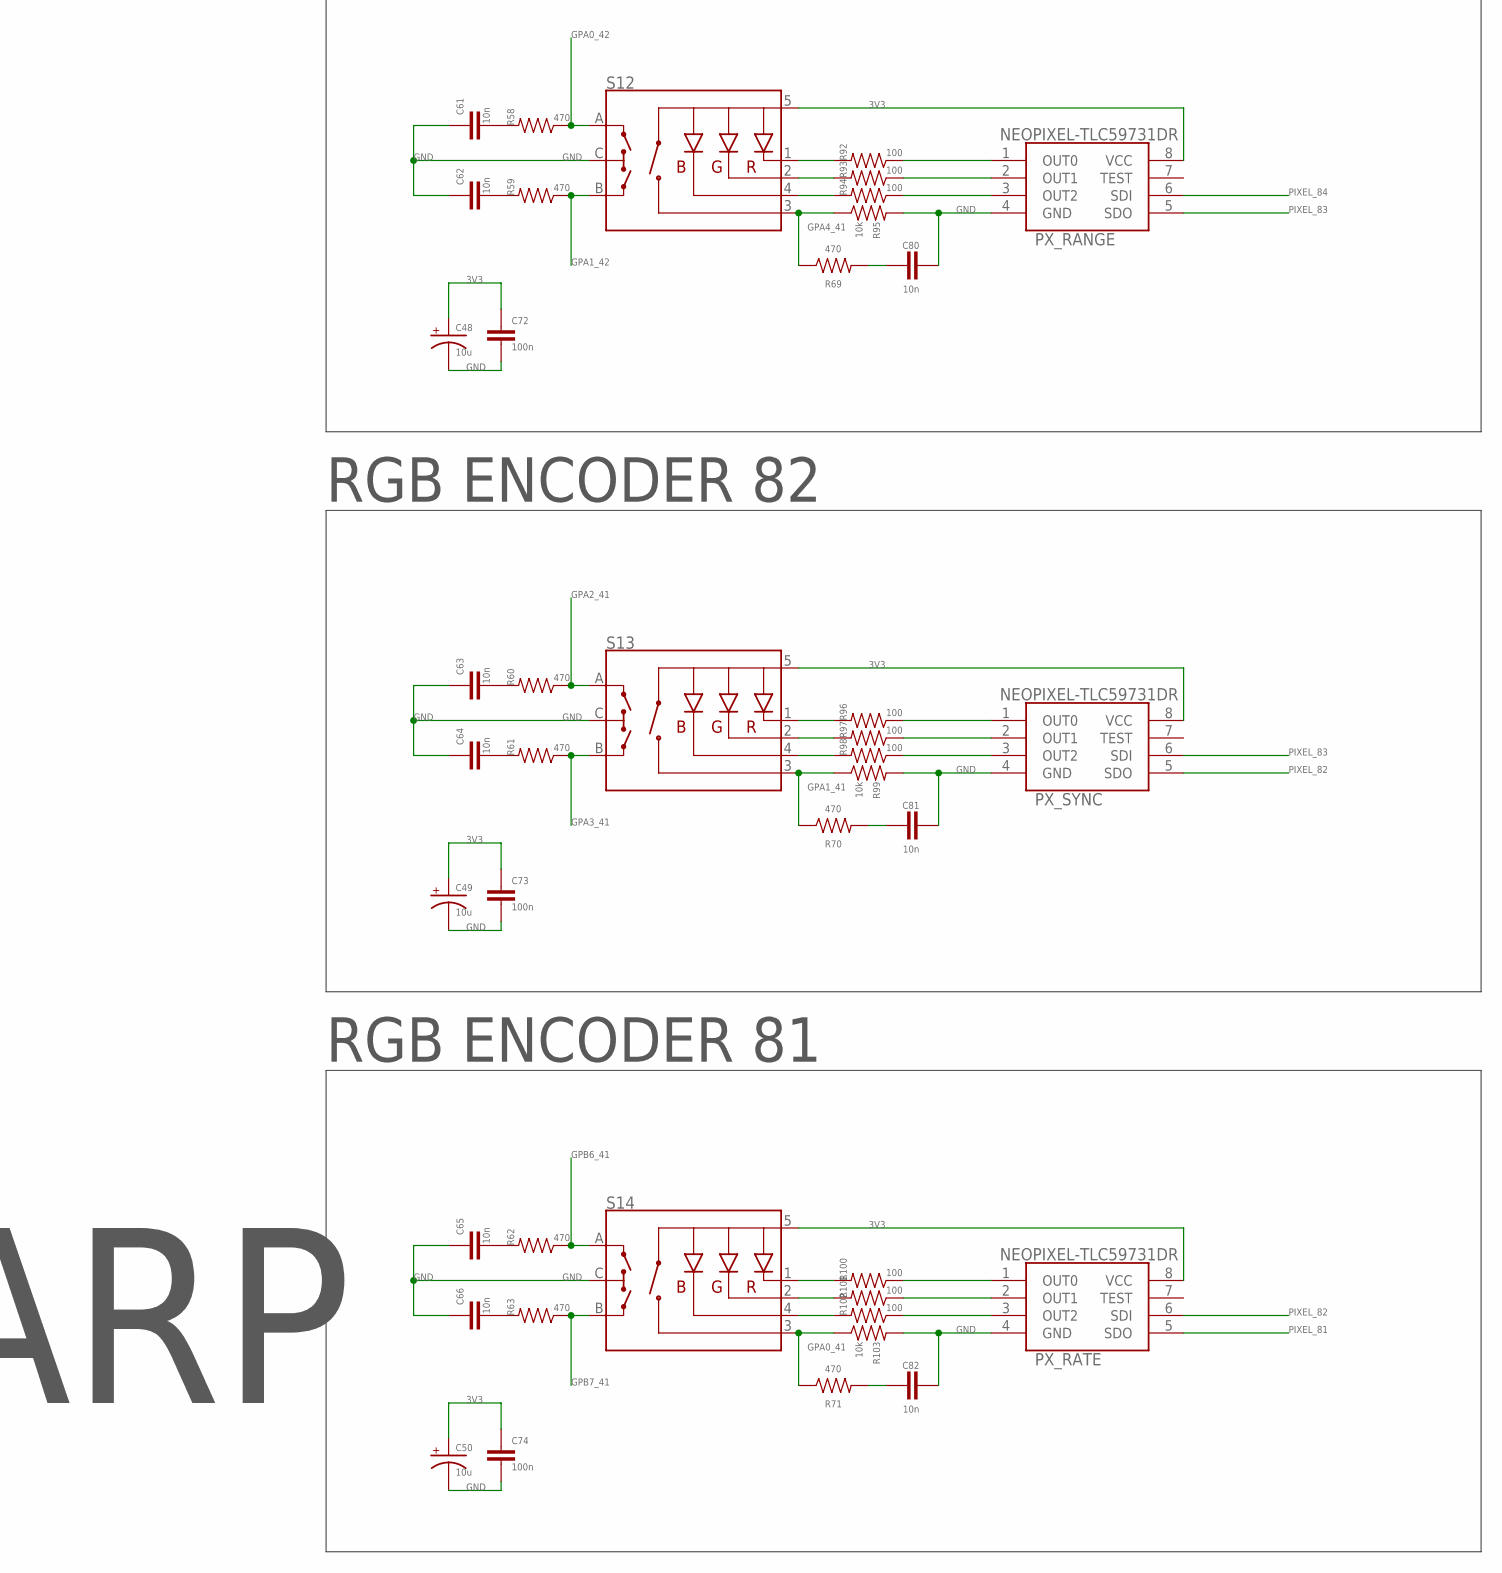
[picture p226: schematic STM32F446 front pane - northeast - v3.sch, sheet 3, part in row 3, column 2]

Parts:
C39, C42, C67, C68, C69, C70, C71, C72, C73, C74: 100n; 0805-CAP
C40, C41, C43, C44, C45, C46, C47, C48, C49, C50: 10u; CPOL2917
C51, C52, C53, C54, C55, C56, C57, C58, C59, C60, C61, C62, C63, C64, C65, C66, C75, C76, C77, C78, C79, C80, C81, C82: 10n; 0805-CAP
CON_TFT_EXT: TFT_EXT; MA06-2
MCP_101, MCP_110: MCP23017; SOIC-28
PX_BF: NEOPIXEL-TLC59731DR; SOIC127P600X175-8N
PX_HUMAN: NEOPIXEL-TLC59731DR; SOIC127P600X175-8N
PX_LATCH: NEOPIXEL-TLC59731DR; SOIC127P600X175-8N
PX_ONOFF: NEOPIXEL-TLC59731DR; SOIC127P600X175-8N
PX_PATTERN: NEOPIXEL-TLC59731DR; SOIC127P600X175-8N
PX_RANGE: NEOPIXEL-TLC59731DR; SOIC127P600X175-8N
PX_RATE: NEOPIXEL-TLC59731DR; SOIC127P600X175-8N
PX_SYNC: NEOPIXEL-TLC59731DR; SOIC127P600X175-8N
R44, R45, R46, R47: 1k; R0805
R48, R49, R50, R51, R52, R53, R54, R55, R56, R57, R58, R59, R60, R61, R62, R63, R64, R65, R66, R67, R68, R69, R70, R71: 470; 1206
R72, R73, R74, R76, R77, R78, R80, R81, R82, R84, R85, R86, R88, R89, R90, R92, R93, R94, R96, R97, R98, R100, R101, R102: 100; 1206
R75, R79, R83, R87, R91, R95, R99, R103: 10k; 1206
S7, S8, S9, S10, S11, S12, S13, S14: ENCODER-RGB-SWITCH-NO_NUT; ENCODER_LED_3

Connections:
3V3: C39.1, C40.+, C41.+, C42.1, C43.+, C44.+, C45.+, C46.+, C47.+, C48.+, C49.+, C50.+, C67.1, C68.1, C69.1, C70.1, C71.1, C72.1, C73.1, C74.1, CON_TFT_EXT.1, MCP_101.9 (VDD), MCP_101.15 (A0), MCP_101.17 (A2), MCP_110.9 (VDD), MCP_110.16 (A1), MCP_110.17 (A2), PX_BF.8 (VCC), PX_HUMAN.8 (VCC), PX_LATCH.8 (VCC), PX_ONOFF.8 (VCC), PX_PATTERN.8 (VCC), PX_RANGE.8 (VCC), PX_RATE.8 (VCC), PX_SYNC.8 (VCC), R44.2, R45.2, R46.2, R47.2, S7.5 (+), S8.5 (+), S9.5 (+), S10.5 (+), S11.5 (+), S12.5 (+), S13.5 (+), S14.5 (+); also elsewhere on the board
GND: C39.2, C40.-, C41.-, C42.2, C43.-, C44.-, C45.-, C46.-, C47.-, C48.-, C49.-, C50.-, C51.1, C52.1, C53.1, C54.1, C55.1, C56.1, C57.1, C58.1, C59.1, C60.1, C61.1, C62.1, C63.1, C64.1, C65.1, C66.1, C67.2, C68.2, C69.2, C70.2, C71.2, C72.2, C73.2, C74.2, C75.2, C76.2, C77.2, C78.2, C79.2, C80.2, C81.2, C82.2, CON_TFT_EXT.7, MCP_101.10 (VSS), MCP_101.16 (A1), MCP_110.10 (VSS), MCP_110.15 (A0), PX_BF.4 (GND), PX_HUMAN.4 (GND), PX_LATCH.4 (GND), PX_ONOFF.4 (GND), PX_PATTERN.4 (GND), PX_RANGE.4 (GND), PX_RATE.4 (GND), PX_SYNC.4 (GND), R75.2, R79.2, R83.2, R87.2, R91.2, R95.2, R99.2, R103.2, S7.C, S8.C, S9.C, S10.C, S11.C, S12.C, S13.C, S14.C; also elsewhere on the board
GPA0_41: MCP_101.21 (GPA0), R71.1, R103.1, S14.3 (SW)
GPA0_42: MCP_110.21 (GPA0), R58.1, S12.A
GPA1_41: MCP_101.22 (GPA1), R70.1, R99.1, S13.3 (SW)
GPA1_42: MCP_110.22 (GPA1), R59.1, S12.B
GPA2_41: MCP_101.23 (GPA2), R60.1, S13.A
GPA2_42: MCP_110.23 (GPA2), R56.1, S11.A
GPA3_41: MCP_101.24 (GPA3), R61.1, S13.B
GPA3_42: MCP_110.24 (GPA3), R57.1, S11.B
GPA4_5: R52.1, S9.A; also elsewhere on the board
GPA4_41: MCP_101.25 (GPA4), R69.1, R95.1, S12.3 (SW)
GPA4_42: MCP_110.25 (GPA4), R68.1, R91.1, S11.3 (SW)
GPA5_5: R53.1, S9.B; also elsewhere on the board
GPA5_41: CON_TFT_EXT.5, MCP_101.26 (GPA5)
GPA5_42: MCP_110.26 (GPA5), R54.1, S10.A
GPA6_5: R66.1, R83.1, S9.3 (SW); also elsewhere on the board
GPA6_41: CON_TFT_EXT.3, MCP_101.27 (GPA6)
GPA6_42: MCP_110.27 (GPA6), R55.1, S10.B
GPA7_5: R65.1, R79.1, S8.3 (SW); also elsewhere on the board
GPA7_41: CON_TFT_EXT.2, MCP_101.28 (GPA7)
GPA7_42: MCP_110.28 (GPA7), R67.1, R87.1, S10.3 (SW)
GPB0_5: R51.1, S8.B; also elsewhere on the board
GPB0_41: CON_TFT_EXT.11, MCP_101.1 (GPB0)
GPB0_42: MCP_110.1 (GPB0); also elsewhere on the board
GPB1_5: R50.1, S8.A; also elsewhere on the board
GPB1_41: CON_TFT_EXT.12, MCP_101.2 (GPB1)
GPB1_42: MCP_110.2 (GPB1); also elsewhere on the board
GPB2_5: R64.1, R75.1, S7.3 (SW); also elsewhere on the board
GPB2_41: CON_TFT_EXT.10, MCP_101.3 (GPB2)
GPB2_42: MCP_110.3 (GPB2); also elsewhere on the board
GPB3_5: R48.1, S7.A; also elsewhere on the board
GPB3_41: CON_TFT_EXT.8, MCP_101.4 (GPB3)
GPB3_42: MCP_110.4 (GPB3); also elsewhere on the board
GPB4_5: R49.1, S7.B; also elsewhere on the board
GPB4_41: CON_TFT_EXT.6, MCP_101.5 (GPB4)
GPB4_42: MCP_110.5 (GPB4); also elsewhere on the board
GPB5_41: CON_TFT_EXT.4, MCP_101.6 (GPB5)
GPB5_42: MCP_110.6 (GPB5); also elsewhere on the board
GPB6_41: MCP_101.7 (GPB6), R62.1, S14.A
GPB6_42: MCP_110.7 (GPB6); also elsewhere on the board
GPB7_41: MCP_101.8 (GPB7), R63.1, S14.B
GPB7_42: MCP_110.8 (GPB7); also elsewhere on the board
GPIO_EXTI0: MCP_101.19 (INTB); also elsewhere on the board
GPIO_EXTI2: MCP_110.19 (INTB); also elsewhere on the board
GPIO_EXTI3: MCP_110.20 (INTA); also elsewhere on the board
GPIO_EXTI13: MCP_101.20 (INTA); also elsewhere on the board
I2C1_SCL: MCP_101.12 (SCL), MCP_110.12 (SCL), R45.1, R47.1; also elsewhere on the board
I2C1_SDA: MCP_101.13 (SDA), MCP_110.13 (SDA), R44.1, R46.1; also elsewhere on the board
unnamed: R96.2, S13.1 (-R)
unnamed: R97.2, S13.2 (-G)
unnamed: R98.2, S13.4 (-B)
unnamed: PX_SYNC.1 (OUT0), R96.1
unnamed: PX_SYNC.2 (OUT1), R97.1
unnamed: PX_SYNC.3 (OUT2), R98.1
unnamed: C63.2, R60.2
unnamed: C64.2, R61.2
unnamed: C81.1, R70.2
unnamed: R92.2, S12.1 (-R)
unnamed: R93.2, S12.2 (-G)
unnamed: R94.2, S12.4 (-B)
unnamed: PX_RANGE.1 (OUT0), R92.1
unnamed: PX_RANGE.2 (OUT1), R93.1
unnamed: PX_RANGE.3 (OUT2), R94.1
unnamed: C61.2, R58.2
unnamed: C62.2, R59.2
unnamed: C80.1, R69.2
unnamed: R88.2, S11.1 (-R)
unnamed: R89.2, S11.2 (-G)
unnamed: R90.2, S11.4 (-B)
unnamed: PX_HUMAN.1 (OUT0), R88.1
unnamed: PX_HUMAN.2 (OUT1), R89.1
unnamed: PX_HUMAN.3 (OUT2), R90.1
unnamed: C59.2, R56.2
unnamed: C60.2, R57.2
unnamed: C79.1, R68.2
unnamed: R84.2, S10.1 (-R)
unnamed: R85.2, S10.2 (-G)
unnamed: R86.2, S10.4 (-B)
unnamed: PX_PATTERN.1 (OUT0), R84.1
unnamed: PX_PATTERN.2 (OUT1), R85.1
unnamed: PX_PATTERN.3 (OUT2), R86.1
unnamed: C57.2, R54.2
unnamed: C58.2, R55.2
unnamed: C78.1, R67.2
unnamed: R80.2, S9.1 (-R)
unnamed: R81.2, S9.2 (-G)
unnamed: R82.2, S9.4 (-B)
unnamed: PX_LATCH.1 (OUT0), R80.1
unnamed: PX_LATCH.2 (OUT1), R81.1
unnamed: PX_LATCH.3 (OUT2), R82.1
unnamed: C55.2, R52.2
unnamed: C56.2, R53.2
unnamed: C77.1, R66.2
unnamed: R100.2, S14.1 (-R)
unnamed: R101.2, S14.2 (-G)
unnamed: R102.2, S14.4 (-B)
unnamed: PX_RATE.1 (OUT0), R100.1
unnamed: PX_RATE.2 (OUT1), R101.1
unnamed: PX_RATE.3 (OUT2), R102.1
unnamed: C65.2, R62.2
unnamed: C66.2, R63.2
unnamed: C82.1, R71.2
unnamed: R76.2, S8.1 (-R)
unnamed: R77.2, S8.2 (-G)
unnamed: R78.2, S8.4 (-B)
unnamed: PX_BF.1 (OUT0), R76.1
unnamed: PX_BF.2 (OUT1), R77.1
unnamed: PX_BF.3 (OUT2), R78.1
unnamed: C53.2, R50.2
unnamed: C54.2, R51.2
unnamed: C76.1, R65.2
unnamed: R72.2, S7.1 (-R)
unnamed: R73.2, S7.2 (-G)
unnamed: R74.2, S7.4 (-B)
unnamed: PX_ONOFF.1 (OUT0), R72.1
unnamed: PX_ONOFF.2 (OUT1), R73.1
unnamed: PX_ONOFF.3 (OUT2), R74.1
unnamed: C51.2, R48.2
unnamed: C52.2, R49.2
unnamed: C75.1, R64.2
PIXEL_75: PX_ONOFF.6 (SDI); also elsewhere on the board
PIXEL_81: CON_TFT_EXT.9, PX_RATE.5 (SDO)
PIXEL_82: PX_RATE.6 (SDI), PX_SYNC.5 (SDO)
PIXEL_83: PX_RANGE.5 (SDO), PX_SYNC.6 (SDI)
PIXEL_84: PX_HUMAN.5 (SDO), PX_RANGE.6 (SDI)
PIXEL_85: PX_HUMAN.6 (SDI), PX_PATTERN.5 (SDO)
PIXEL_86: PX_LATCH.5 (SDO), PX_PATTERN.6 (SDI)
PIXEL_87: PX_BF.5 (SDO), PX_LATCH.6 (SDI)
PIXEL_88: PX_BF.6 (SDI), PX_ONOFF.5 (SDO)
RST: MCP_101.18 (!RESET), MCP_110.18 (!RESET); also elsewhere on the board

Notes on the sheet:
ARP
RGB ENCODER 81
RGB ENCODER 82
RGB ENCODER 83
RGB ENCODER 84
RGB ENCODER 85
RGB ENCODER 86
RGB ENCODER 87
RGB ENCODER 88
MCP 41 & 42

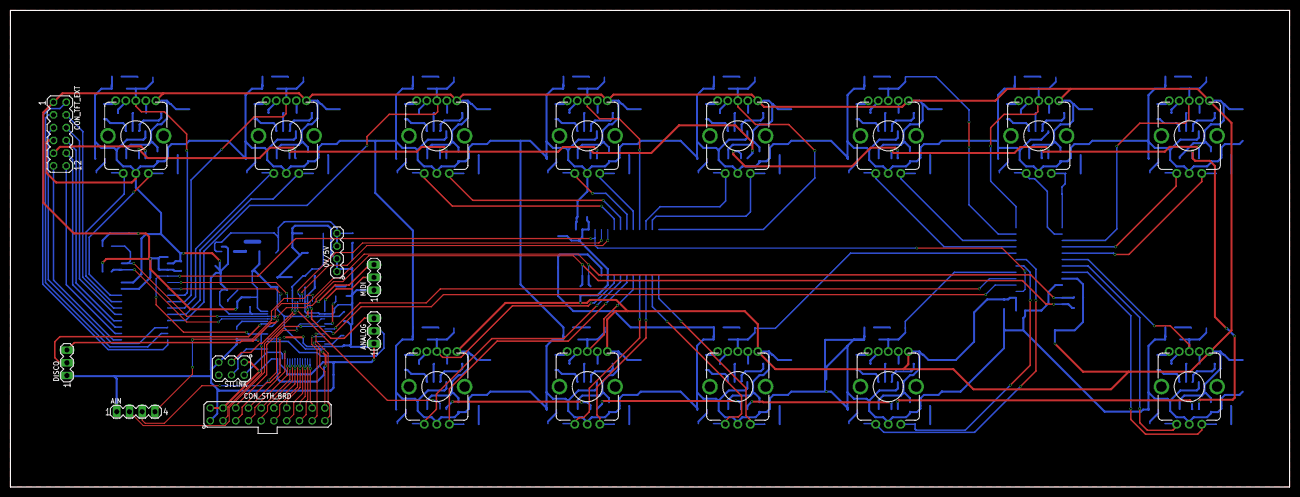
[picture p227: board STM32F446 front pane - northeast - v3.brd from above]

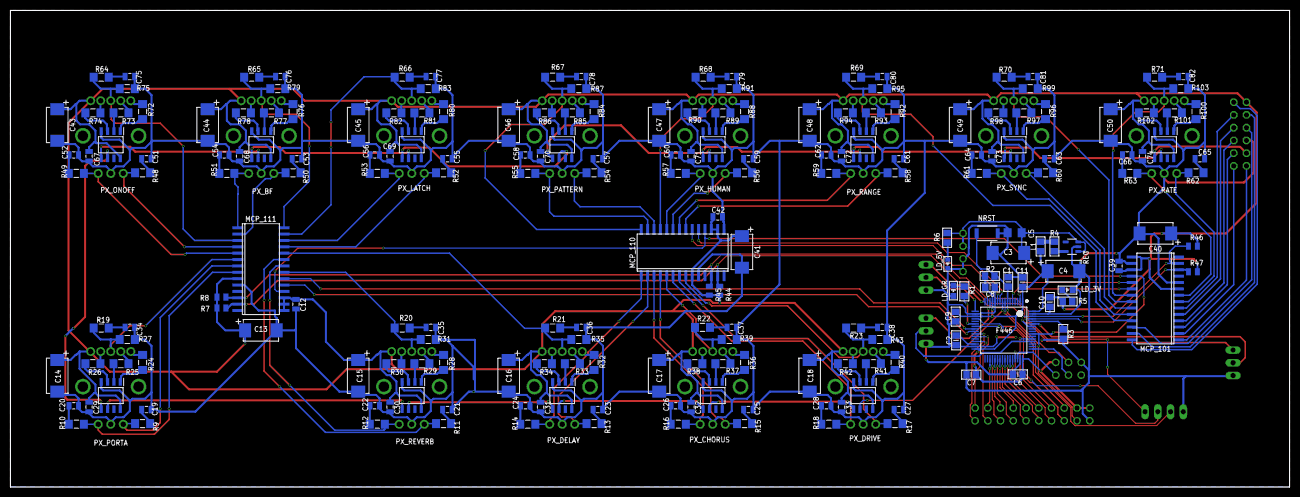
[picture p228: board STM32F446 front pane - northeast - v3.brd from below]

Board: 2 copper layers, 255.0 x 95.0 mm, 229 parts (208 on the bottom side), 227 nets.
