reynal/themis/front-pane/eagle-schematics/v2/front pane - v2.brd

## EAGLE design front-pane/eagle-schematics/v2/front pane - v2.brd (continued)

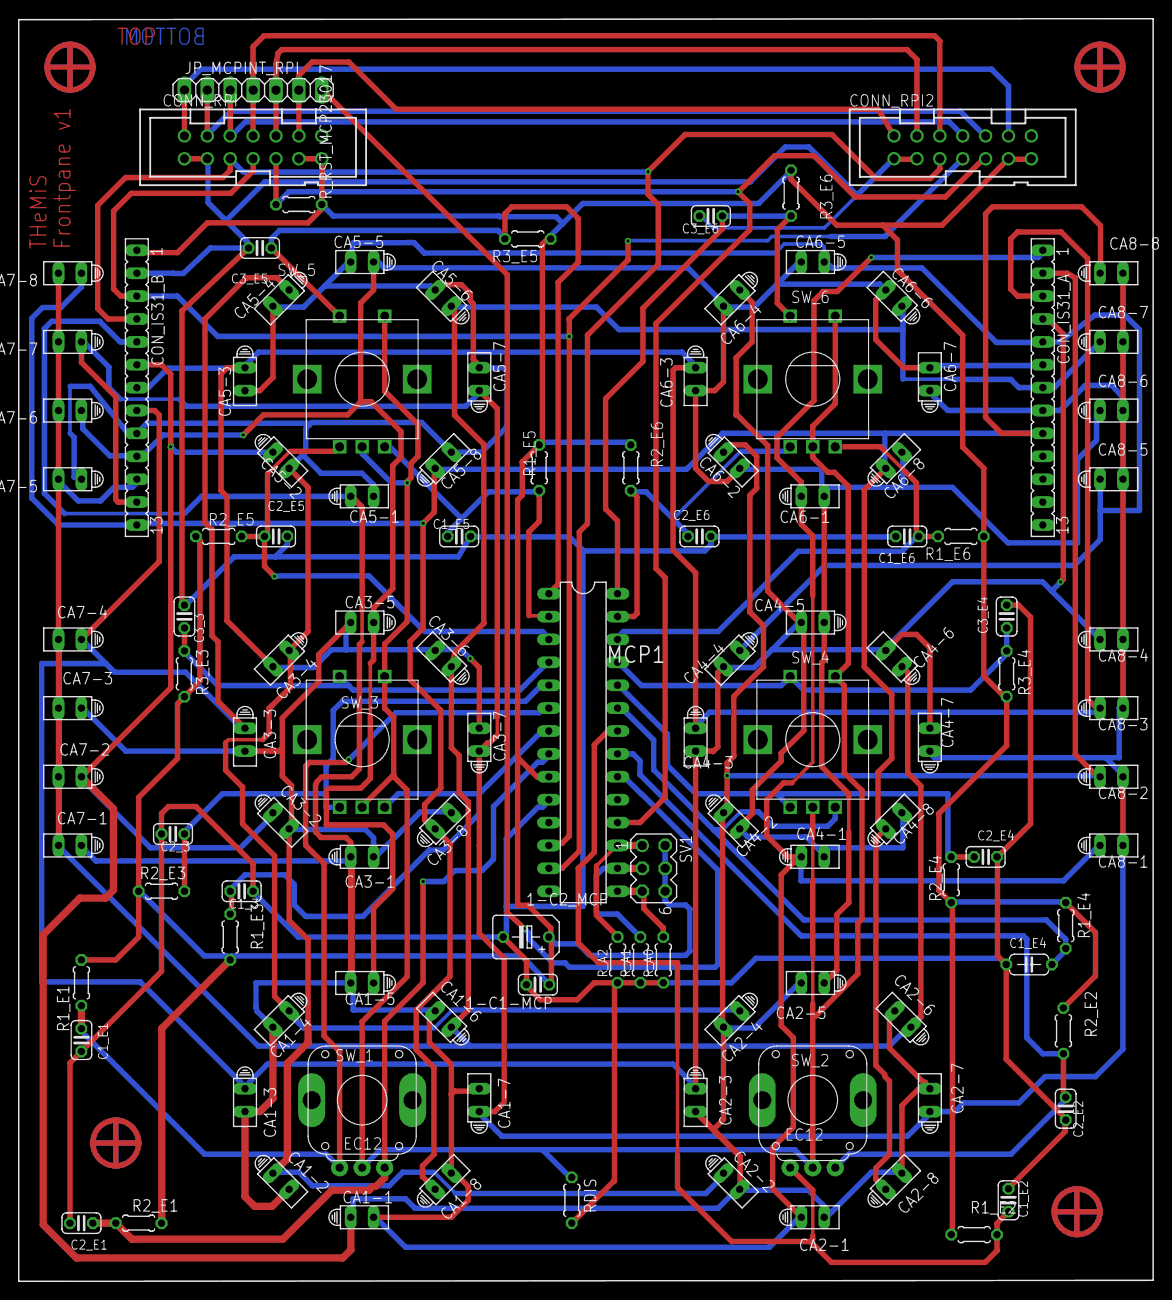
[picture p230: board front pane - v2.brd from above]

Board: 2 copper layers, 125.9 x 140.1 mm, 116 parts (0 on the bottom side), 41 nets.
