reynal/themis/analog-modules/VCF AS3320/vcf-v1.brd

## EAGLE design analog-modules/VCF AS3320/vcf-v1.brd (2020-01-12, an earlier design)

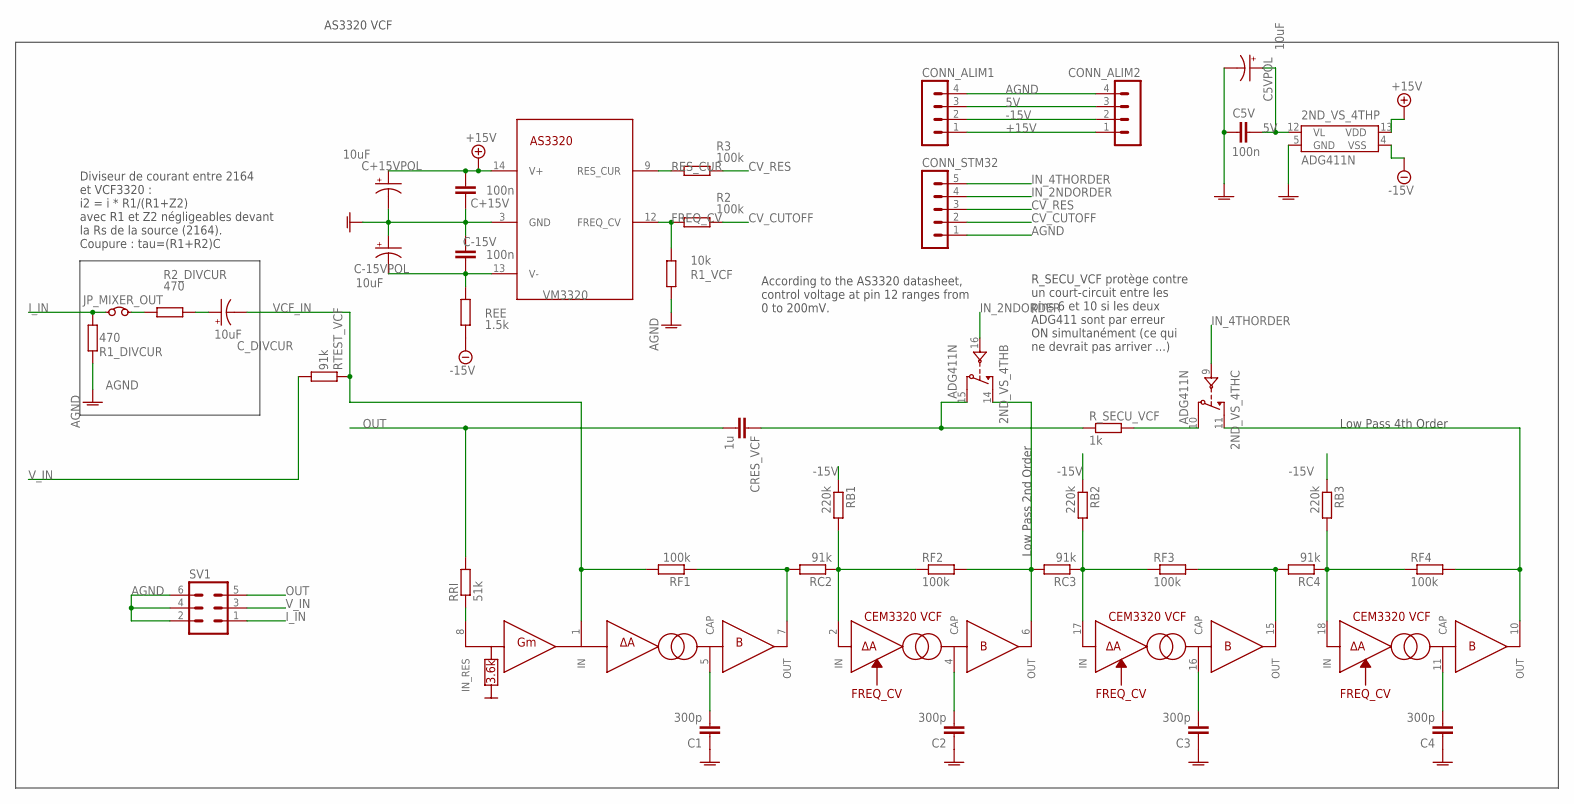
[picture p231: schematic vcf-v1.sch]

Parts:
2ND_VS_4TH: ADG411N; DIL16
C1, C2, C4: 300p; C050-024X044
C3: 300p; C075-032X103
C5V: 100n; C050-024X044
C5VPOL: 10uF; CPOL-RADIAL-2.5MM-5MM-KIT
C+15V: 100n; C050-024X044
C+15VPOL: 10uF; CPOL-RADIAL-2.5MM-5MM-KIT
C-15V: 100n; C050-024X044
C-15VPOL: 10uF; CPOL-RADIAL-2.5MM-5MM-KIT
CONN_ALIM1, CONN_ALIM2: MA04-1
CONN_STM32: MA05-1
CRES_VCF: 1u; C050-024X044
C_DIVCUR: 10uF; CPOL-RADIAL-2.5MM-5MM-KIT
JP_MIXER_OUT: JUMPER_WIRE; JUMPER
R1_DIVCUR, R2_DIVCUR: 470; 0204/5
R1_VCF: 10k; 0204/5
R2, R3: 100k; 0204/5
RB1, RB2, RB3: 220k; 0204/5
RC2, RC3, RC4: 91k; 0204/5
REE: 1.5k; 0204/5
RF1, RF2, RF3, RF4: 100k; 0204/5
RRI: 51k; 0204/5
RTEST_VCF: 91k; 0204/5
R_SECU_VCF: 1k; 0204/5
SV1: MA03-2
VCF: AS3320; DIL18

Connections:
5V: 2ND_VS_4TH.12 (VL), C5V.1, C5VPOL.1 (+), CONN_ALIM1.3, CONN_ALIM2.3
+15V: 2ND_VS_4TH.13 (VDD), C+15V.2, C+15VPOL.1 (+), CONN_ALIM1.1, CONN_ALIM2.1, VCF.14 (V+)
-15V: 2ND_VS_4TH.4 (VSS), CONN_ALIM1.2, CONN_ALIM2.2, RB1.1, RB2.1, RB3.1, REE.1
AGND: 2ND_VS_4TH.5 (GND), C1.1, C2.1, C3.1, C4.1, C5V.2, C5VPOL.2 (-), C+15V.1, C+15VPOL.2 (-), C-15V.2, C-15VPOL.1 (+), CONN_ALIM1.4, CONN_ALIM2.4, CONN_STM32.1, R1_DIVCUR.2, R1_VCF.2, SV1.2, SV1.4, SV1.6, VCF.3 (GND)
CV_CUTOFF: CONN_STM32.2, R2.2
CV_RES: CONN_STM32.3, R3.2
FREQ_CV: R1_VCF.1, R2.1, VCF.12 (FREQ_CV)
IN_2NDORDER: 2ND_VS_4TH.16 (IN), CONN_STM32.4
IN_4THORDER: 2ND_VS_4TH.9 (IN), CONN_STM32.5
I_IN: JP_MIXER_OUT.1, R1_DIVCUR.1, SV1.1
unnamed: C1.2, VCF.5 (CAP)
unnamed: C3.2, VCF.16 (CAP)
unnamed: C2.2, VCF.4 (CAP)
unnamed: C4.2, VCF.11 (CAP)
unnamed: RC2.2, RF1.1, VCF.7 (OUT)
unnamed: 2ND_VS_4TH.15 (D), CRES_VCF.1, R_SECU_VCF.1
unnamed: RB1.2, RC2.1, RF2.1, VCF.2 (IN)
unnamed: 2ND_VS_4TH.14 (S), RC3.2, RF2.2, VCF.6 (OUT)
unnamed: 2ND_VS_4TH.11 (S), RF4.2, VCF.10 (OUT)
unnamed: RB2.2, RC3.1, RF3.1, VCF.17 (IN)
unnamed: 2ND_VS_4TH.10 (D), R_SECU_VCF.2
unnamed: C_DIVCUR.1 (+), R2_DIVCUR.1
unnamed: JP_MIXER_OUT.2, R2_DIVCUR.2
unnamed: RC4.2, RF3.2, VCF.15 (OUT)
unnamed: RB3.2, RC4.1, RF4.1, VCF.18 (IN)
unnamed: RRI.1, VCF.8 (IN_RES)
OUT: CRES_VCF.2, RRI.2, SV1.5
RES_CUR: R3.1, VCF.9 (RES_CUR)
VCF_IN: C_DIVCUR.2 (-), RF1.2, RTEST_VCF.2, VCF.1 (IN)
VM3320: C-15V.1, C-15VPOL.2 (-), REE.2, VCF.13 (V-)
V_IN: RTEST_VCF.1, SV1.3

Notes on the sheet:
According to the AS3320 datasheet, control voltage at pin 12 ranges from 0 to 200mV.
Diviseur de courant entre 2164 et VCF3320 : i2 = i * R1/(R1+Z2) avec R1 et Z2 négligeables devant la Rs de la source (2164). Coupure : tau=(R1+R2)C
AS3320 VCF
R_SECU_VCF protège contre un court-circuit entre les pins 6 et 10 si les deux ADG411 sont par erreur ON simultanément (ce qui ne devrait pas arriver ...)
Low Pass 2nd Order
Low Pass 4th Order

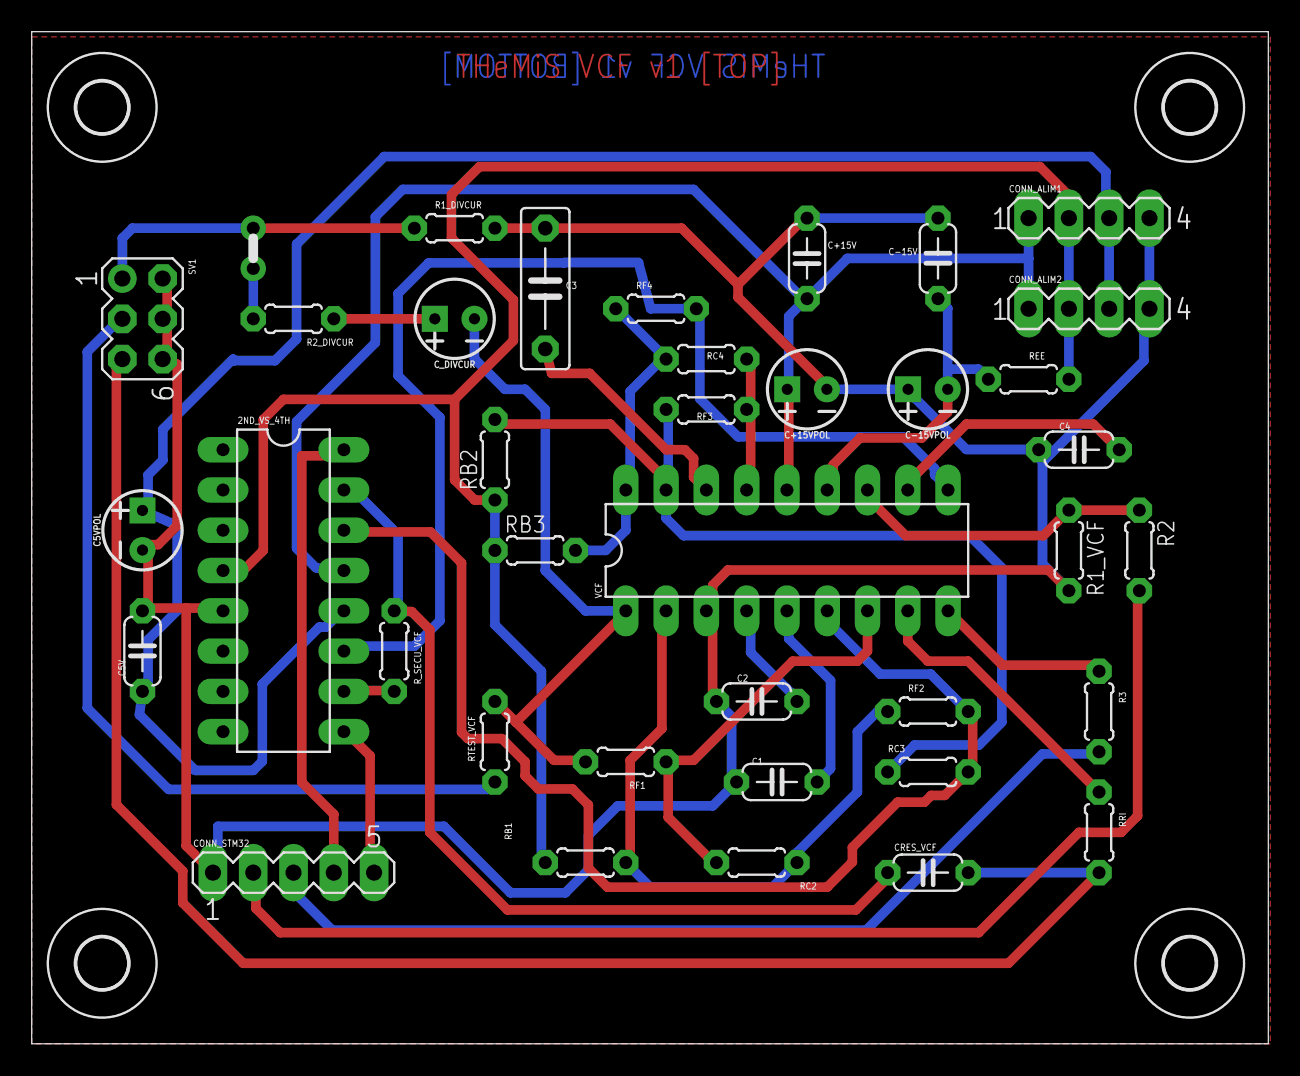
[picture p232: board vcf-v1.brd from above]

Board: 2 copper layers, 78.0 x 63.8 mm, 42 parts (0 on the bottom side), 31 nets.

Other parts of the board:
U$1, U$2, U$3, U$4: 3,2
