reynal/themis/analog-modules/moog-filter/eagle-schematics/MoogFilter DIL.brd

## EAGLE design analog-modules/moog-filter/eagle-schematics/MoogFilter DIL.brd (2020-03-03)

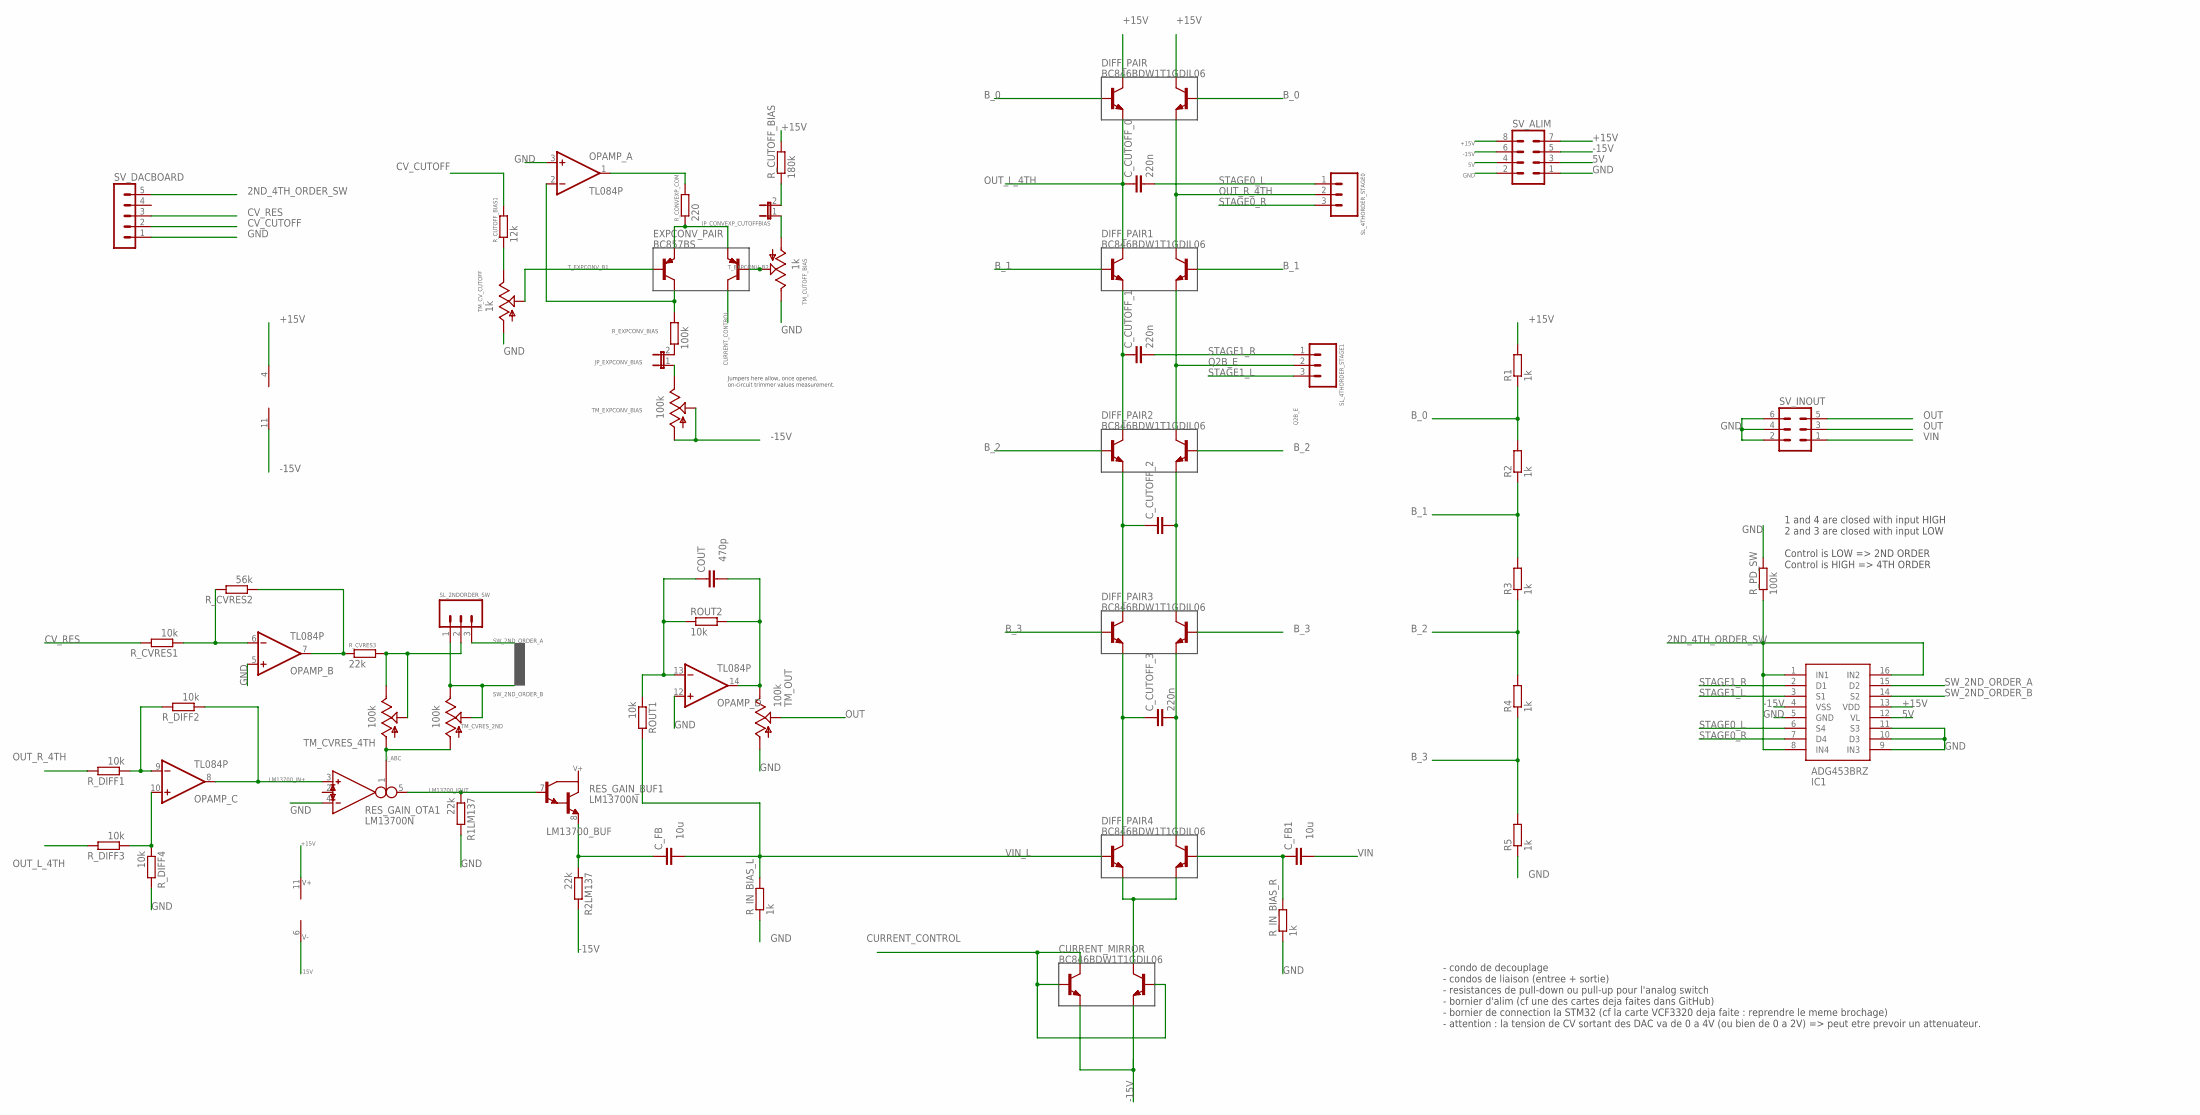
[picture p233: schematic MoogFilter DIL.sch]

Parts:
COUT: 470p; C5B2.5
CURRENT_MIRROR: BC846BDW1T1GDIL06; DIL06
C_CUTOFF_0: 220n; C5B3
C_CUTOFF_1, C_CUTOFF_2, C_CUTOFF_3: 220n; C5B2.5
C_FB, C_FB1: 10u; C5B2.5
DIFF_PAIR, DIFF_PAIR1, DIFF_PAIR2, DIFF_PAIR3, DIFF_PAIR4: BC846BDW1T1GDIL06; DIL06
EXPCONV_PAIR: BC857BS; DIL06
IC1: ADG453BRZ; SOIC127P600X175-16N
JP_CONVEXP_CUTOFFBIAS: JP1E; JP1
JP_EXPCONV_BIAS: JP1E; JP1
OPAMP_: TL084P; DIL14
R1, R2, R3, R4, R5: 1k; 0204/7
R1LM137, R2LM137: 22k; 0204/7
RES_GAIN_: LM13700N; DIL16
ROUT1, ROUT2: 10k; 0204/7
R_CONVEXP_COM: 220; 0204/7
R_CUTOFF_BIAS: 180k; 0204/7
R_CUTOFF_BIAS1: 12k; 0204/7
R_CVRES1: 10k; 0204/7
R_CVRES2: 56k; 0204/7
R_CVRES3: 22k; 0204/7
R_DIFF1, R_DIFF2, R_DIFF3, R_DIFF4: 10k; 0204/7
R_EXPCONV_BIAS: 100k; 0204/7
R_IN_BIAS_L: 1k; 0204/7
R_IN_BIAS_R: 1k; 0204/7
R_PD_SW: 100k; 0204/7
SL_2NDORDER_SW, SL_4THORDER_STAGE0, SL_4THORDER_STAGE1: MA03; 03P
SV_ALIM: MA04-2
SV_DACBOARD: MA05-1
SV_INOUT: MA03-2
TM_CUTOFF_BIAS: 1k; 6MM
TM_CVRES_2ND, TM_CVRES_4TH: 100k; 6MM
TM_CV_CUTOFF: 1k; 6MM
TM_EXPCONV_BIAS: 100k; 6MM
TM_OUT: 100k; 6MM

Connections:
2ND_4TH_ORDER_SW: IC1.1 (IN1), IC1.8 (IN4), IC1.16 (IN2), R_PD_SW.1, SV_DACBOARD.5
5V: IC1.12 (VL), SV_ALIM.3, SV_ALIM.4
+15V: DIFF_PAIR.3 (C1), DIFF_PAIR.6 (C2), IC1.13 (VDD), OPAMP_.4 (V+), R1.2, RES_GAIN_.11 (V+), R_CUTOFF_BIAS.2, SV_ALIM.7, SV_ALIM.8
-15V: CURRENT_MIRROR.1 (E2), CURRENT_MIRROR.4 (E1), IC1.4 (VSS), OPAMP_.11 (V-), R2LM137.2, RES_GAIN_.6 (V-), SV_ALIM.5, SV_ALIM.6, TM_EXPCONV_BIAS.A, TM_EXPCONV_BIAS.S
B_0: DIFF_PAIR.2 (B2), DIFF_PAIR.5 (B1), R1.1, R2.2
B_1: DIFF_PAIR1.2 (B2), DIFF_PAIR1.5 (B1), R2.1, R3.2
B_2: DIFF_PAIR2.2 (B2), DIFF_PAIR2.5 (B1), R3.1, R4.2
B_3: DIFF_PAIR3.2 (B2), DIFF_PAIR3.5 (B1), R4.1, R5.2
CURRENT_CONTROL: CURRENT_MIRROR.2 (B2), CURRENT_MIRROR.3 (C1), CURRENT_MIRROR.5 (B1), EXPCONV_PAIR.3 (C2)
CV_CUTOFF: R_CUTOFF_BIAS1.2, SV_DACBOARD.2
CV_RES: R_CVRES1.2, SV_DACBOARD.3
GND: IC1.5 (GND), IC1.9 (IN3), IC1.10 (D3), IC1.11 (S3), OPAMP_.3 (+IN), OPAMP_.5 (+IN), OPAMP_.12 (+IN), R1LM137.2, R5.1, RES_GAIN_.4 (IN_N), R_DIFF4.2, R_IN_BIAS_L.1, R_IN_BIAS_R.1, R_PD_SW.2, SV_ALIM.1, SV_ALIM.2, SV_DACBOARD.1, SV_INOUT.2, SV_INOUT.4, SV_INOUT.6, TM_CUTOFF_BIAS.E, TM_CV_CUTOFF.A, TM_OUT.A
I_ABC: RES_GAIN_.1 (I_BIAS), TM_CVRES_2ND.A, TM_CVRES_4TH.A
LM13700_BUF: C_FB.1, R2LM137.1, RES_GAIN_.8 (E)
LM13700_IN+: OPAMP_.8 (OUT), RES_GAIN_.3 (IN_P), R_DIFF2.1
LM13700_IOUT: R1LM137.1, RES_GAIN_.5 (OUT), RES_GAIN_.7 (B)
unnamed: COUT.1, OPAMP_.13 (-IN), ROUT1.1, ROUT2.1
unnamed: EXPCONV_PAIR.1 (E1), EXPCONV_PAIR.4 (E2), R_CONVEXP_COM.1
unnamed: JP_CONVEXP_CUTOFFBIAS.2, R_CUTOFF_BIAS.1
unnamed: OPAMP_.1 (OUT), R_CONVEXP_COM.2
unnamed: JP_CONVEXP_CUTOFFBIAS.1, TM_CUTOFF_BIAS.A
unnamed: CURRENT_MIRROR.6 (C2), DIFF_PAIR4.1 (E2), DIFF_PAIR4.4 (E1)
unnamed: EXPCONV_PAIR.6 (C1), OPAMP_.2 (-IN), R_EXPCONV_BIAS.2
unnamed: JP_EXPCONV_BIAS.2, R_EXPCONV_BIAS.1
unnamed: OPAMP_.6 (-IN), R_CVRES1.1, R_CVRES2.2
unnamed: OPAMP_.7 (OUT), R_CVRES2.1, R_CVRES3.1
unnamed: OPAMP_.10 (+IN), R_DIFF3.1, R_DIFF4.1
unnamed: OPAMP_.9 (-IN), R_DIFF1.1, R_DIFF2.2
unnamed: COUT.2, OPAMP_.14 (OUT), ROUT2.2, TM_OUT.E
unnamed: JP_EXPCONV_BIAS.1, TM_EXPCONV_BIAS.E
unnamed: R_CVRES3.2, SL_2NDORDER_SW.2, TM_CVRES_4TH.E, TM_CVRES_4TH.S
unnamed: R_CUTOFF_BIAS1.1, TM_CV_CUTOFF.E
OUT: SV_INOUT.3, SV_INOUT.5, TM_OUT.S
OUT_L_4TH: C_CUTOFF_0.1, DIFF_PAIR.4 (E1), DIFF_PAIR1.3 (C1), R_DIFF3.2
OUT_R_4TH: DIFF_PAIR.1 (E2), DIFF_PAIR1.6 (C2), R_DIFF1.2, SL_4THORDER_STAGE0.2
Q2A_E: C_CUTOFF_1.1, DIFF_PAIR1.4 (E1), DIFF_PAIR2.3 (C1)
Q2B_E: DIFF_PAIR1.1 (E2), DIFF_PAIR2.6 (C2), SL_4THORDER_STAGE1.2
Q3A_E: C_CUTOFF_2.1, DIFF_PAIR2.4 (E1), DIFF_PAIR3.3 (C1)
Q3B_E: C_CUTOFF_2.2, DIFF_PAIR2.1 (E2), DIFF_PAIR3.6 (C2)
Q4A_E: C_CUTOFF_3.1, DIFF_PAIR3.4 (E1), DIFF_PAIR4.3 (C1)
Q4B_E: C_CUTOFF_3.2, DIFF_PAIR3.1 (E2), DIFF_PAIR4.6 (C2)
STAGE0_L: C_CUTOFF_0.2, IC1.6 (S4), SL_4THORDER_STAGE0.1
STAGE0_R: IC1.7 (D4), SL_4THORDER_STAGE0.3
STAGE1_L: IC1.3 (S1), SL_4THORDER_STAGE1.3
STAGE1_R: C_CUTOFF_1.2, IC1.2 (D1), SL_4THORDER_STAGE1.1
SW_2ND_ORDER_A: IC1.15 (D2), SL_2NDORDER_SW.3
SW_2ND_ORDER_B: IC1.14 (S2), SL_2NDORDER_SW.1, TM_CVRES_2ND.E, TM_CVRES_2ND.S
T_EXPCONV_B1: EXPCONV_PAIR.2 (B1), TM_CV_CUTOFF.S
T_EXPCONV_B2: EXPCONV_PAIR.5 (B2), TM_CUTOFF_BIAS.S
VIN: C_FB1.2, SV_INOUT.1
VIN_L: C_FB.2, DIFF_PAIR4.5 (B1), ROUT1.2, R_IN_BIAS_L.2
VIN_R: C_FB1.1, DIFF_PAIR4.2 (B2), R_IN_BIAS_R.2

Notes on the sheet:
- condo de decouplage - condos de liaison (entree + sortie) - resistances de pull-down ou pull-up pour l'analog switch - bornier d'alim (cf une des cartes deja faites dans GitHub) - bornier de connection la STM32 (cf la carte VCF3320 deja faite : reprendre le meme brochage) - attention : la tension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
1 and 4 are closed with input HIGH 2 and 3 are closed with input LOW Control is LOW => 2ND ORDER Control is HIGH => 4TH ORDER
Jumpers here allow, once opened, on-circuit trimmer values measurement.

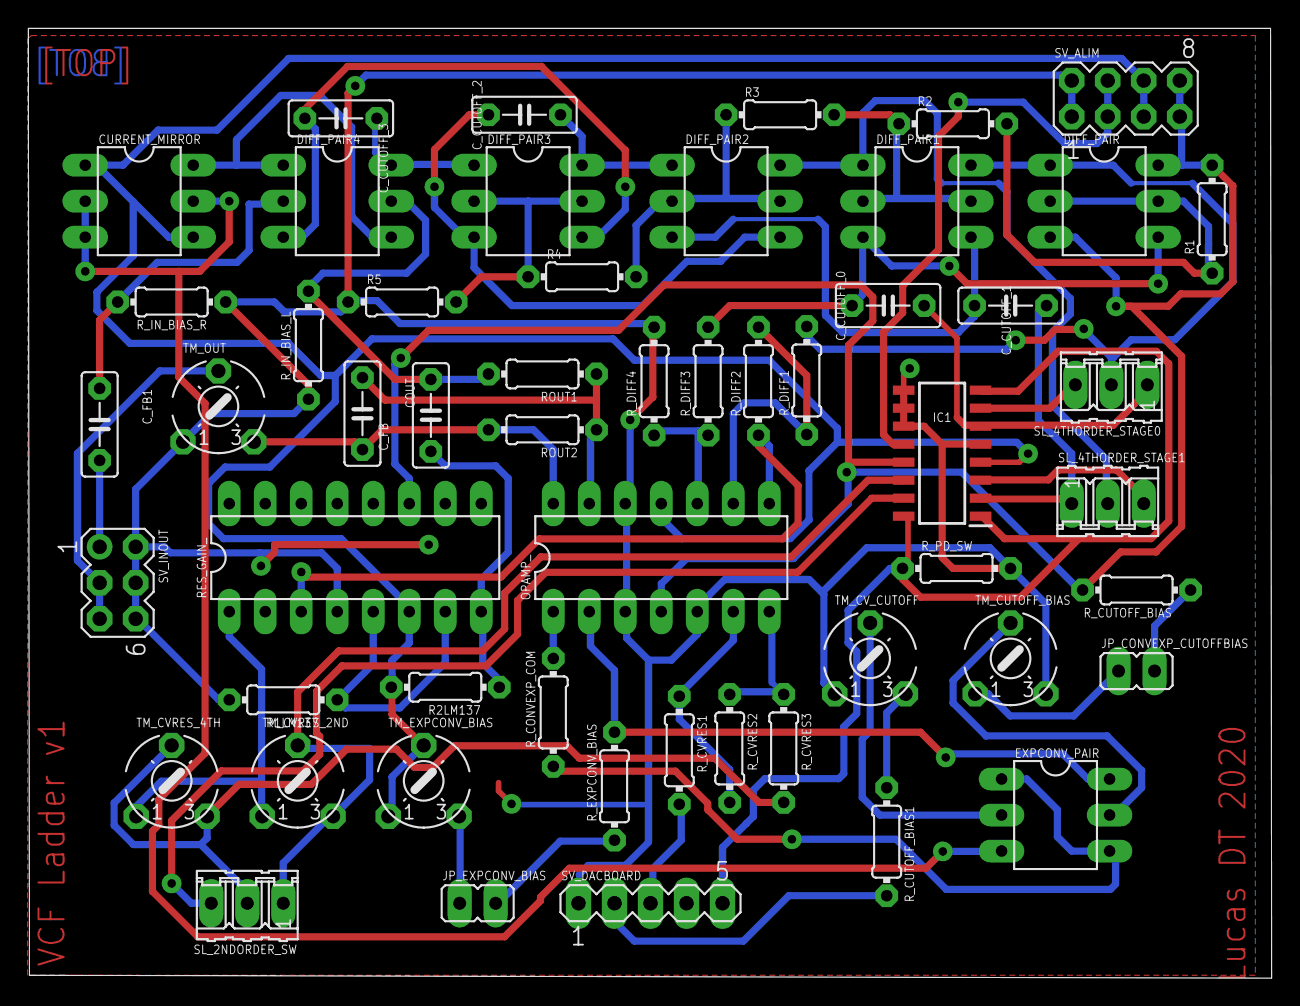
[picture p234: board MoogFilter DIL.brd from above]

Board: 2 copper layers, 87.7 x 67.0 mm, 54 parts (0 on the bottom side), 52 nets.
