reynal/themis/analog-modules/supply/part 1.brd

## EAGLE design analog-modules/supply/part 1.brd (2019-09-23)

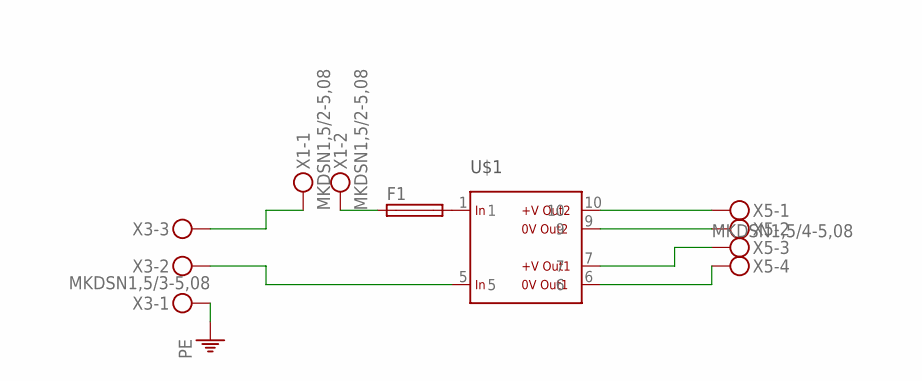
[picture p235: schematic part 1.sch]

Parts:
F1: SH22,5A
U$1: DOUBLE_ISO; 2ISO
X1: MKDSN1,5/2-5,08
X3: MKDSN1,5/3-5,08
X5: MKDSN1,5/4-5,08

Connections:
unnamed: U$1.6, X5.4
unnamed: F1.1, X1.2
unnamed: U$1.7, X5.3
unnamed: F1.2, U$1.1
unnamed: U$1.9, X5.2
unnamed: X1.1, X3.3
unnamed: U$1.10, X5.1
unnamed: U$1.5, X3.2
PE: X3.1

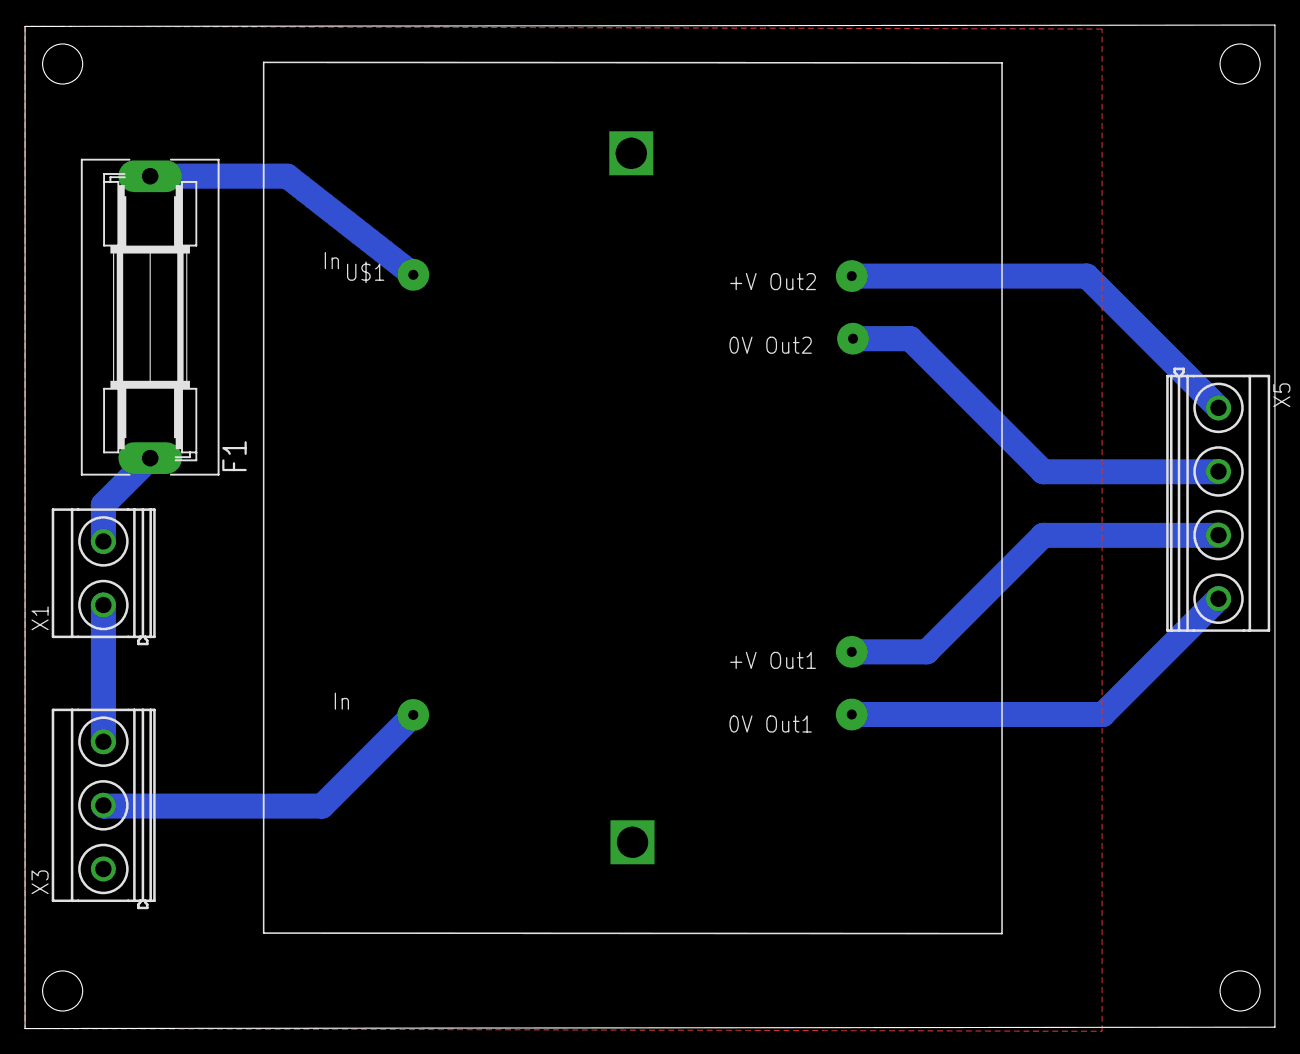
[picture p236: board part 1.brd from above]

Board: 2 copper layers, 99.8 x 80.1 mm, 5 parts (0 on the bottom side), 8 nets.
