reynal/themis/analog-modules/Mixer 2164D/V2164MIXER v2.brd

## EAGLE design analog-modules/Mixer 2164D/V2164MIXER v2.brd (2020-01-12)

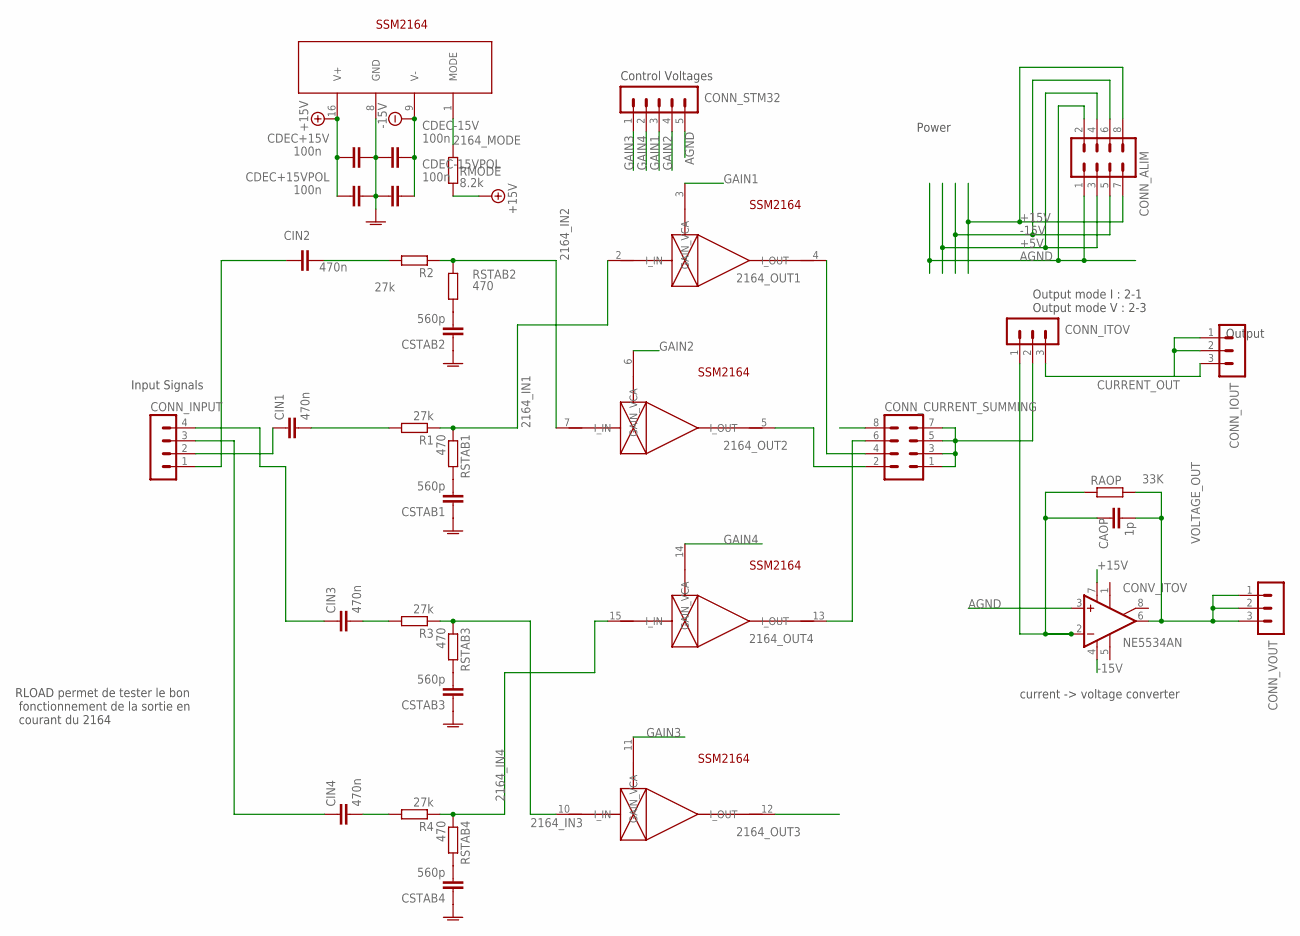
[picture p237: schematic V2164MIXER v2.sch]

Parts:
CAOP: 1p; C050-030X075
CDEC+15V: 100n; C050-030X075
CDEC+15VPOL: 100n; C075-032X103
CDEC-15V, CDEC-15VPOL: 100n; C050-030X075
CIN1, CIN2, CIN3, CIN4: 470n; C050-030X075
CONN_ALIM: MA04-2
CONN_CURRENT_SUMMING: MA04-2
CONN_INPUT: MA04-1
CONN_IOUT: MA03-1
CONN_ITOV: MA03-1
CONN_STM32: MA05-1
CONN_VOUT: MA03-1
CONV_ITOV: NE5534AN; DIL08
CSTAB1, CSTAB2, CSTAB3, CSTAB4: 560p; C050-030X075
MIXER: SSM2164_MULTI; DIL16
R1, R3, R4: 27k; 0204/7
R2: 27k; 0207/10
RAOP: 33K; 0204/7
RMODE: 8.2k; 0204/7
RSTAB1, RSTAB3, RSTAB4: 470; 0204/7
RSTAB2: 470; 0207/10

Connections:
2164_IN1: MIXER.2 (I_IN), R1.1, RSTAB1.1
2164_IN2: MIXER.7 (I_IN), R2.1, RSTAB2.1
2164_IN3: MIXER.10 (I_IN), R3.1, RSTAB3.1
2164_IN4: MIXER.15 (I_IN), R4.1, RSTAB4.1
2164_MODE: MIXER.1 (MODE), RMODE.2
2164_OUT1: CONN_CURRENT_SUMMING.4, MIXER.4 (I_OUT)
2164_OUT2: CONN_CURRENT_SUMMING.2, MIXER.5 (I_OUT)
2164_OUT3: MIXER.12 (I_OUT)
2164_OUT4: CONN_CURRENT_SUMMING.6, MIXER.13 (I_OUT)
+5V: CONN_ALIM.3, CONN_ALIM.4
+15V: CDEC+15V.2, CDEC+15VPOL.2, CONN_ALIM.7, CONN_ALIM.8, CONV_ITOV.7 (V+), MIXER.16 (V+), RMODE.1
-15V: CDEC-15V.1, CDEC-15VPOL.1, CONN_ALIM.5, CONN_ALIM.6, CONV_ITOV.4 (V-), MIXER.9 (V-)
AGND: CDEC+15V.1, CDEC+15VPOL.1, CDEC-15V.2, CDEC-15VPOL.2, CONN_ALIM.1, CONN_ALIM.2, CONN_STM32.5, CONV_ITOV.3 (+IN), CSTAB1.1, CSTAB2.1, CSTAB3.1, CSTAB4.1, MIXER.8 (GND)
CURRENT_OUT: CONN_IOUT.1, CONN_IOUT.2, CONN_IOUT.3, CONN_ITOV.3
GAIN1: CONN_STM32.3, MIXER.3 (GAIN_VCA)
GAIN2: CONN_STM32.4, MIXER.6 (GAIN_VCA)
GAIN3: CONN_STM32.1, MIXER.11 (GAIN_VCA)
GAIN4: CONN_STM32.2, MIXER.14 (GAIN_VCA)
IN1: CIN1.1, CONN_INPUT.2
IN2: CIN2.1, CONN_INPUT.1
IN3: CIN3.1, CONN_INPUT.4
IN4: CIN4.1, CONN_INPUT.3
MIXER_OUT: CONN_CURRENT_SUMMING.1, CONN_CURRENT_SUMMING.3, CONN_CURRENT_SUMMING.5, CONN_CURRENT_SUMMING.7, CONN_ITOV.2
unnamed: CIN4.2, R4.2
unnamed: CSTAB4.2, RSTAB4.2
unnamed: CIN2.2, R2.2
unnamed: CAOP.1, CONN_ITOV.1, CONV_ITOV.2 (-IN), RAOP.1
unnamed: CSTAB2.2, RSTAB2.2
unnamed: CSTAB1.2, RSTAB1.2
unnamed: CIN1.2, R1.2
unnamed: CSTAB3.2, RSTAB3.2
unnamed: CIN3.2, R3.2
VOLTAGE_OUT: CAOP.2, CONN_VOUT.1, CONN_VOUT.2, CONN_VOUT.3, CONV_ITOV.6 (OUT), RAOP.2

Notes on the sheet:
Control Voltages
Input Signals
Power
Output
Output mode I : 2-1 Output mode V : 2-3
current -> voltage converter
RLOAD permet de tester le bon fonctionnement de la sortie en courant du 2164

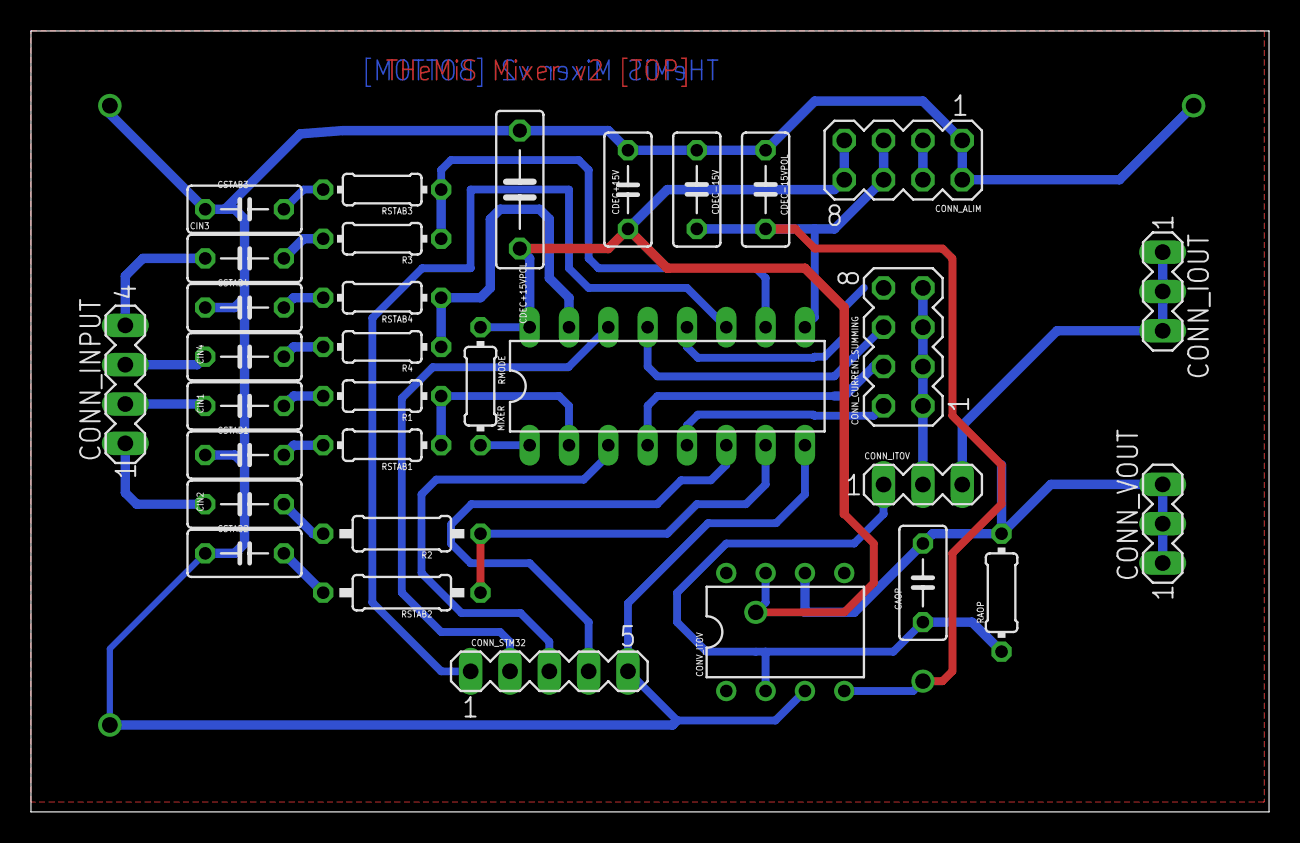
[picture p238: board V2164MIXER v2.brd from above]

Board: 2 copper layers, 80.0 x 50.4 mm, 32 parts (0 on the bottom side), 32 nets.
