reynal/themis/analog-modules/VCF AS3320/VCF-LP-BP-HP_v4.brd

## EAGLE design analog-modules/VCF AS3320/VCF-LP-BP-HP_v4.brd (2020-04-22)

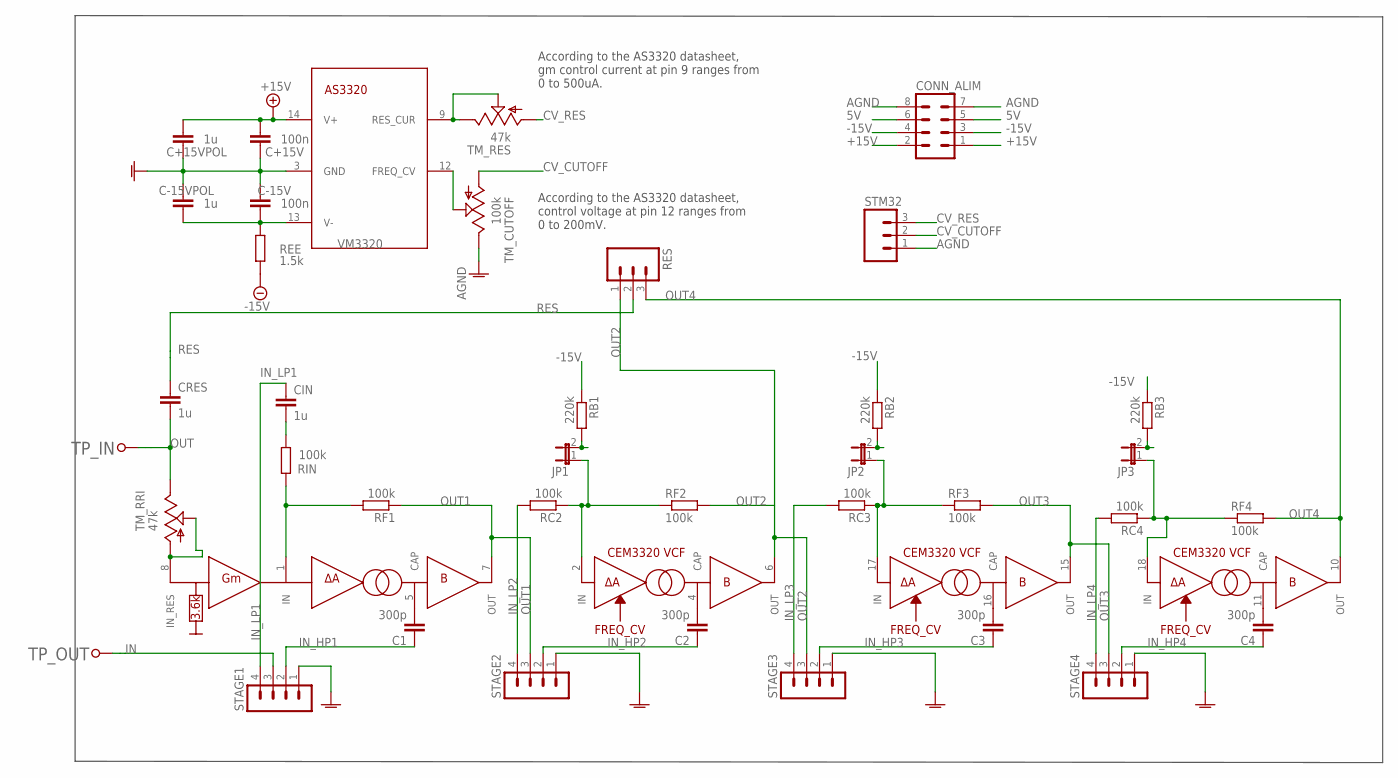
[picture p239: schematic VCF-LP-BP-HP_v4.sch]

Parts:
C1, C3, C4: 300p; C050-030X075
C2: 300p; C075-032X103
C+15V: 100n; C050-050X075
C+15VPOL: 1u; C050-050X075
C-15V: 100n; C050-050X075
C-15VPOL: 1u; C050-050X075
CIN: 1u; C050-030X075
CONN_ALIM: MA04-2
CRES: 1u; C050-030X075
JP1, JP2, JP3: JP1E; JP1
RB1, RB2, RB3: 220k; 0204/7
RC2, RC3, RC4: 100k; 0204/7
REE: 1.5k; 0207/7
RES: MA03; 03P
RF1, RF2, RF3, RF4: 100k; 0204/7
RIN: 100k; 0204/7
STAGE1, STAGE2, STAGE3, STAGE4: MA04-1
STM32: MA03; 03P
TM_CUTOFF: 100k; 6MM
TM_RES: 47k; 6MM
TM_RRI: 47k; 6MM
TP_IN: TESTPOINT; TESTPOINT_63
TP_OUT: TESTPOINT; TESTPOINT_63
VCF: AS3320; DIL18

Connections:
5V: CONN_ALIM.5, CONN_ALIM.6
+15V: C+15V.2, C+15VPOL.2, CONN_ALIM.1, CONN_ALIM.2, VCF.14 (V+)
-15V: CONN_ALIM.3, CONN_ALIM.4, RB1.1, RB2.1, RB3.1, REE.1
AGND: C+15V.1, C+15VPOL.1, C-15V.2, C-15VPOL.2, CONN_ALIM.7, CONN_ALIM.8, STAGE1.1, STAGE2.1, STAGE3.1, STAGE4.1, STM32.1, TM_CUTOFF.E, VCF.3 (GND)
CV_CUTOFF: STM32.2, TM_CUTOFF.A
CV_RES: STM32.3, TM_RES.A
IN: STAGE1.3, TP_OUT.P$1
IN_HP1: C1.1, STAGE1.2
IN_HP2: C2.1, STAGE2.2
IN_HP3: C3.1, STAGE3.2
IN_HP4: C4.1, STAGE4.2
IN_LP1: CIN.1, STAGE1.4
IN_LP2: RC2.2, STAGE2.4
IN_LP3: RC3.2, STAGE3.4
IN_LP4: RC4.2, STAGE4.4
unnamed: C3.2, VCF.16 (CAP)
unnamed: C1.2, VCF.5 (CAP)
unnamed: JP1.2, RB1.2
unnamed: JP2.2, RB2.2
unnamed: JP3.2, RB3.2
unnamed: JP3.1, RC4.1, RF4.1, VCF.18 (IN)
unnamed: CIN.2, RIN.1
unnamed: C2.2, VCF.4 (CAP)
unnamed: C4.2, VCF.11 (CAP)
unnamed: TM_CUTOFF.S, VCF.12 (FREQ_CV)
unnamed: JP1.1, RC2.1, RF2.1, VCF.2 (IN)
unnamed: JP2.1, RC3.1, RF3.1, VCF.17 (IN)
unnamed: TM_RRI.A, TM_RRI.S, VCF.8 (IN_RES)
unnamed: TM_RES.E, TM_RES.S, VCF.9 (RES_CUR)
OUT: CRES.2, TM_RRI.E, TP_IN.P$1
OUT1: RF1.1, STAGE2.3, VCF.7 (OUT)
OUT2: RES.1, RF2.2, STAGE3.3, VCF.6 (OUT)
OUT3: RF3.2, STAGE4.3, VCF.15 (OUT)
OUT4: RES.3, RF4.2, VCF.10 (OUT)
RES: CRES.1, RES.2
VCF_IN: RF1.2, RIN.2, VCF.1 (IN)
VM3320: C-15V.1, C-15VPOL.1, REE.2, VCF.13 (V-)

Notes on the sheet:
According to the AS3320 datasheet, control voltage at pin 12 ranges from 0 to 200mV.
According to the AS3320 datasheet, gm control current at pin 9 ranges from 0 to 500uA.

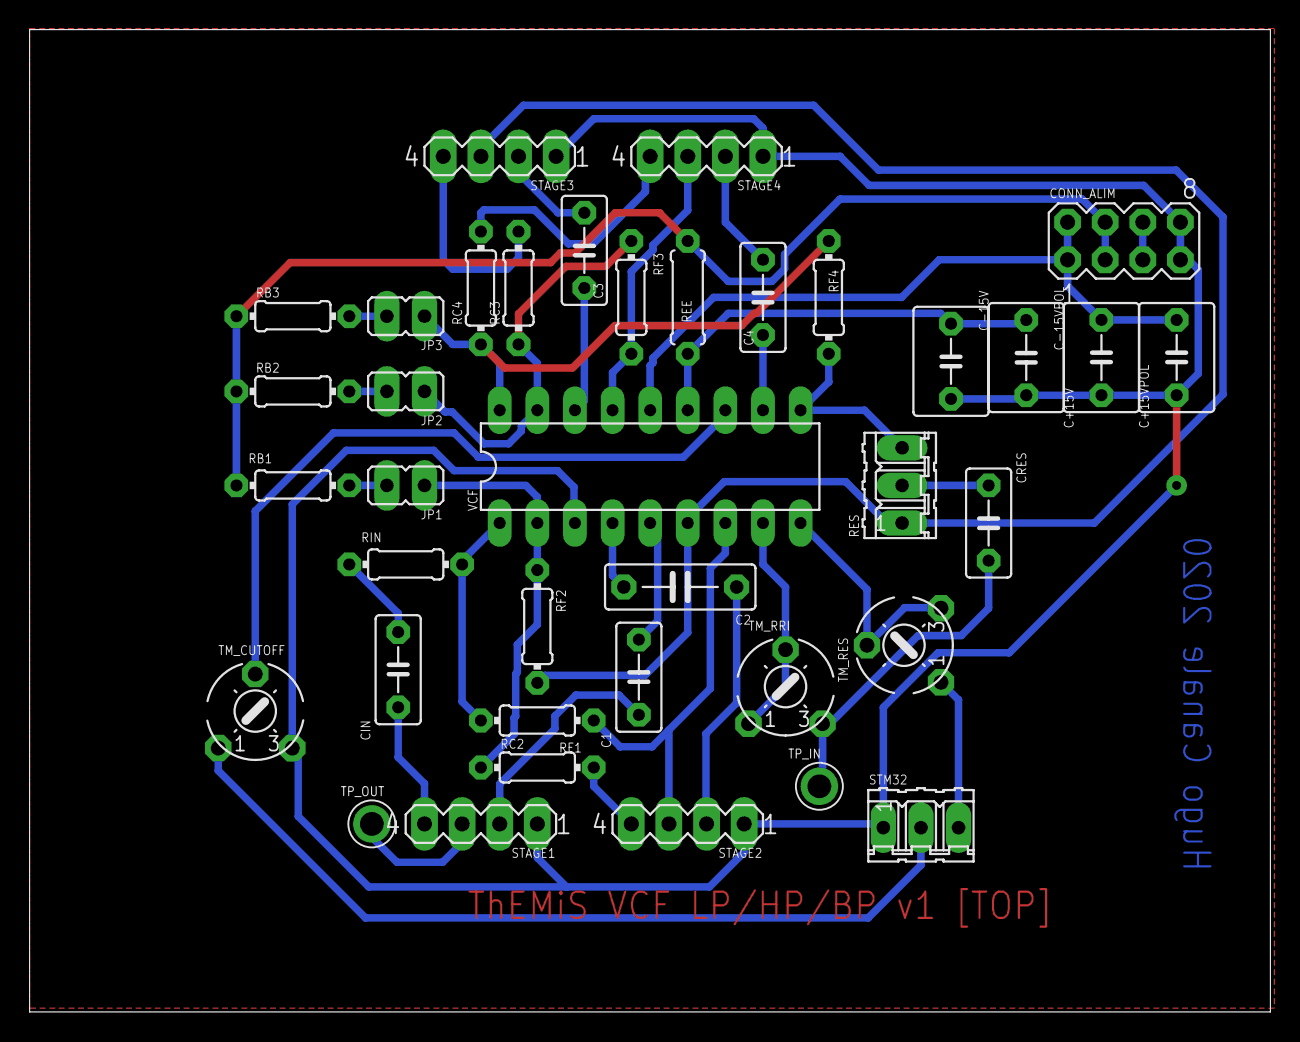
[picture p240: board VCF-LP-BP-HP_v4.brd from above]

Board: 2 copper layers, 83.8 x 66.3 mm, 38 parts (0 on the bottom side), 37 nets.
