reynal/themis/main-board/v1.1/eagle-schematics/DAC STM32 Board v4 - AD5391.brd

## EAGLE design main-board/v1.1/eagle-schematics/DAC STM32 Board v4 - AD5391.brd (2020-11-10, an earlier design)

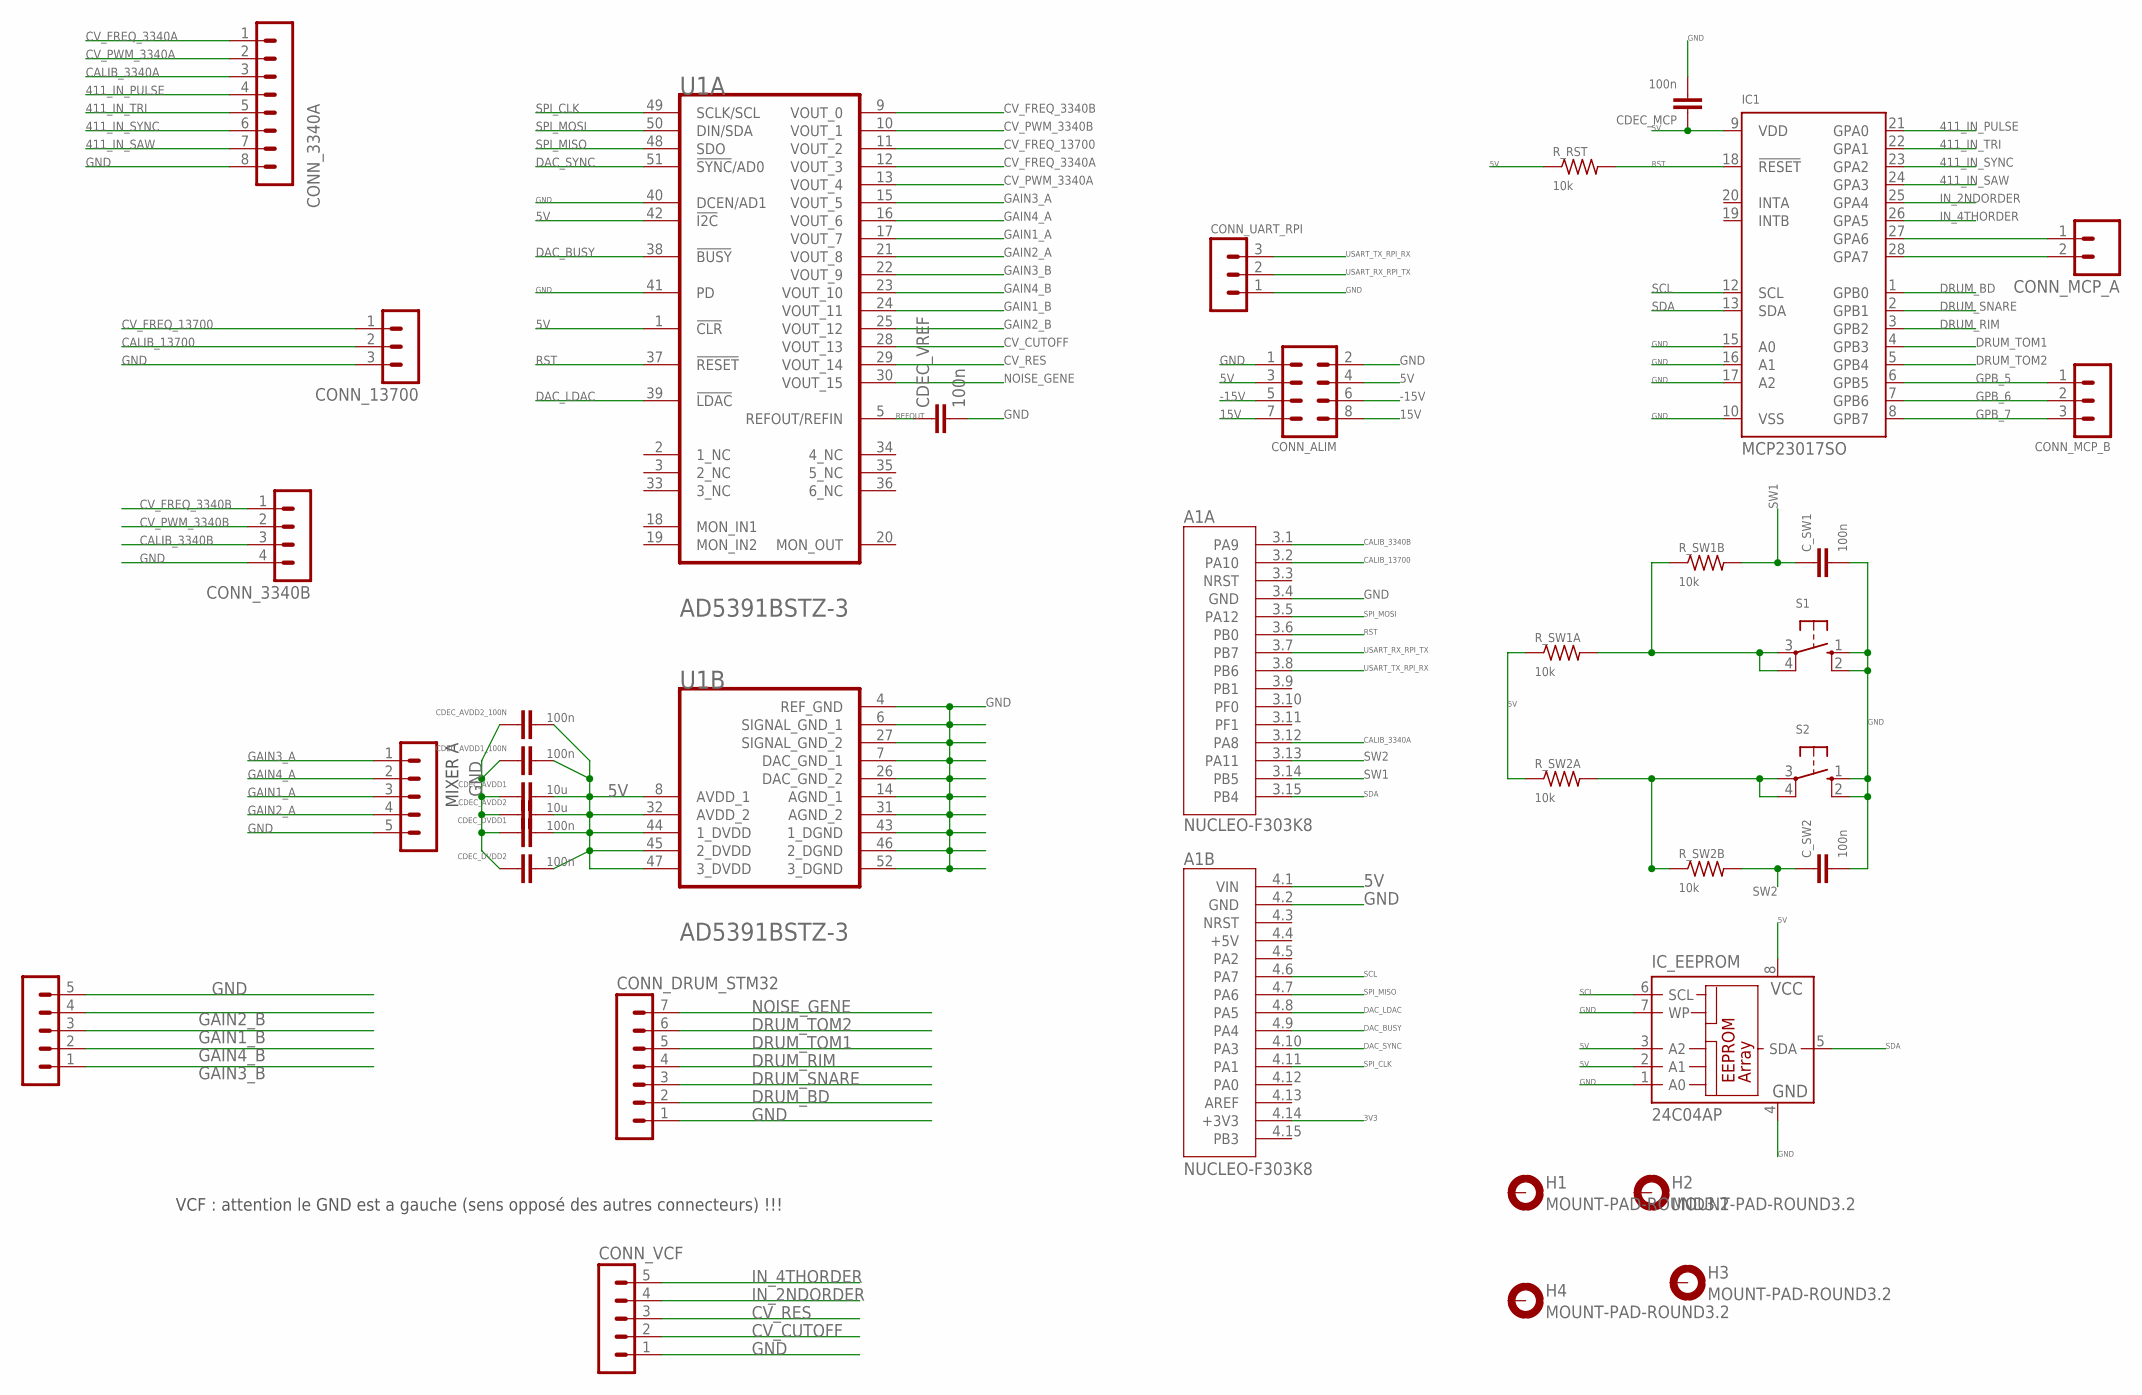
[picture p241: schematic DAC STM32 Board v4 - AD5391.sch]

Parts:
A1: NUCLEO-F303K8; MODULE_NUCLEO-F303K8
CDEC_AVDD1, CDEC_AVDD2: 10u; C050-030X075
CDEC_AVDD1_100N, CDEC_AVDD2_100N: 100n; C050-030X075
CDEC_DVDD1: 100n; C075-032X103
CDEC_DVDD2: 100n; C050-030X075
CDEC_MCP: 100n; C075-032X103
CDEC_VREF: 100n; C050-030X075
CONN_3340A: MA08-1
CONN_3340B: MA04-1
CONN_13700: MA03-1
CONN_ALIM: MA04-2
CONN_DRUM_STM32: MA07-1
CONN_MCP_A: M02; 02P
CONN_MCP_B: MA03-1
CONN_MIX_A: MA05-1
CONN_MIX_B: MA05-1
CONN_UART_RPI: MA03-1
CONN_VCF: MA05-1
C_SW1, C_SW2: 100n; C050-030X075
H1, H2, H3, H4: MOUNT-PAD-ROUND3.2; 3,2-PAD
IC1: MCP23017SO; SO28W
IC_EEPROM: 24C04AP; DIL8
R_RST: 10k; 0207/10
R_SW1A, R_SW1B, R_SW2A, R_SW2B: 10k; 0207/10
S1, S2: 10-XX; B3F-10XX
U1: ANALOG_DEVICES_AD5391BSTZ-3ANALOG_DEVICES_AD5391B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; ANALOG_DEVICES_AD5391BSTZ-3_0

Connections:
3V3: A1.4.14 (+3V3)
5V: A1.4.1 (VIN), CDEC_AVDD1.2, CDEC_AVDD1_100N.2, CDEC_AVDD2.2, CDEC_AVDD2_100N.2, CDEC_DVDD1.2, CDEC_DVDD2.2, CDEC_MCP.1, CONN_ALIM.3, CONN_ALIM.4, IC1.9 (VDD), IC_EEPROM.2 (A1), IC_EEPROM.3 (A2), IC_EEPROM.8 (VCC), R_RST.1, R_SW1A.1, R_SW2A.1, U1.1 (!CLR!), U1.8 (AVDD_1), U1.32 (AVDD_2), U1.42 (!I2C!), U1.44 (1_DVDD), U1.45 (2_DVDD), U1.47 (3_DVDD)
15V: CONN_ALIM.7, CONN_ALIM.8
411_IN_PULSE: CONN_3340A.4, IC1.21 (GPA0)
411_IN_SAW: CONN_3340A.7, IC1.24 (GPA3)
411_IN_SYNC: CONN_3340A.6, IC1.23 (GPA2)
411_IN_TRI: CONN_3340A.5, IC1.22 (GPA1)
-15V: CONN_ALIM.5, CONN_ALIM.6
CALIB_3340A: A1.3.12 (PA8), CONN_3340A.3
CALIB_3340B: A1.3.1 (PA9), CONN_3340B.3
CALIB_13700: A1.3.2 (PA10), CONN_13700.2
CV_CUTOFF: CONN_VCF.2, U1.28 (VOUT_13)
CV_FREQ_3340A: CONN_3340A.1, U1.12 (VOUT_3)
CV_FREQ_3340B: CONN_3340B.1, U1.9 (VOUT_0)
CV_FREQ_13700: CONN_13700.1, U1.11 (VOUT_2)
CV_PWM_3340A: CONN_3340A.2, U1.13 (VOUT_4)
CV_PWM_3340B: CONN_3340B.2, U1.10 (VOUT_1)
CV_RES: CONN_VCF.3, U1.29 (VOUT_14)
DAC_BUSY: A1.4.9 (PA4), U1.38 (!BUSY!)
DAC_LDAC: A1.4.8 (PA5), U1.39 (!LDAC!)
DAC_SYNC: A1.4.10 (PA3), U1.51 (!SYNC!/AD0)
DRUM_BD: CONN_DRUM_STM32.2, IC1.1 (GPB0)
DRUM_RIM: CONN_DRUM_STM32.4, IC1.3 (GPB2)
DRUM_SNARE: CONN_DRUM_STM32.3, IC1.2 (GPB1)
DRUM_TOM1: CONN_DRUM_STM32.5, IC1.4 (GPB3)
DRUM_TOM2: CONN_DRUM_STM32.6, IC1.5 (GPB4)
GAIN1_A: CONN_MIX_A.3, U1.17 (VOUT_7)
GAIN1_B: CONN_MIX_B.3, U1.24 (VOUT_11)
GAIN2_A: CONN_MIX_A.4, U1.21 (VOUT_8)
GAIN2_B: CONN_MIX_B.4, U1.25 (VOUT_12)
GAIN3_A: CONN_MIX_A.1, U1.15 (VOUT_5)
GAIN3_B: CONN_MIX_B.1, U1.22 (VOUT_9)
GAIN4_A: CONN_MIX_A.2, U1.16 (VOUT_6)
GAIN4_B: CONN_MIX_B.2, U1.23 (VOUT_10)
GND: A1.3.4 (GND), A1.4.2 (GND), CDEC_AVDD1.1, CDEC_AVDD1_100N.1, CDEC_AVDD2.1, CDEC_AVDD2_100N.1, CDEC_DVDD1.1, CDEC_DVDD2.1, CDEC_MCP.2, CDEC_VREF.2, CONN_3340A.8, CONN_3340B.4, CONN_13700.3, CONN_ALIM.1, CONN_ALIM.2, CONN_DRUM_STM32.1, CONN_MIX_A.5, CONN_MIX_B.5, CONN_UART_RPI.1, CONN_VCF.1, C_SW1.2, C_SW2.2, IC1.10 (VSS), IC1.15 (A0), IC1.16 (A1), IC1.17 (A2), IC_EEPROM.1 (A0), IC_EEPROM.4 (GND), IC_EEPROM.7 (WP), S1.1 (S), S1.2 (S1), S2.1 (S), S2.2 (S1), U1.4 (REF_GND), U1.6 (SIGNAL_GND_1), U1.7 (DAC_GND_1), U1.14 (AGND_1), U1.26 (DAC_GND_2), U1.27 (SIGNAL_GND_2), U1.31 (AGND_2), U1.40 (DCEN/AD1), U1.41 (PD), U1.43 (1_DGND), U1.46 (2_DGND), U1.52 (3_DGND)
GPB_5: CONN_MCP_B.1, IC1.6 (GPB5)
GPB_6: CONN_MCP_B.2, IC1.7 (GPB6)
GPB_7: CONN_MCP_B.3, IC1.8 (GPB7)
IN_2NDORDER: CONN_VCF.4, IC1.25 (GPA4)
IN_4THORDER: CONN_VCF.5, IC1.26 (GPA5)
unnamed: CONN_MCP_A.1, IC1.27 (GPA6)
unnamed: R_SW1A.2, R_SW1B.1, S1.3, S1.4 (P1)
unnamed: CONN_MCP_A.2, IC1.28 (GPA7)
unnamed: R_SW2A.2, R_SW2B.1, S2.3, S2.4 (P1)
NOISE_GENE: CONN_DRUM_STM32.7, U1.30 (VOUT_15)
REFOUT: CDEC_VREF.1, U1.5 (REFOUT/REFIN)
RST: A1.3.6 (PB0), IC1.18 (!RESET), R_RST.2, U1.37 (!RESET!)
SCL: A1.4.6 (PA7), IC1.12 (SCL), IC_EEPROM.6 (SCL)
SDA: A1.3.15 (PB4), IC1.13 (SDA), IC_EEPROM.5 (SDA)
SPI_CLK: A1.4.11 (PA1), U1.49 (SCLK/SCL)
SPI_MISO: A1.4.7 (PA6), U1.48 (SDO)
SPI_MOSI: A1.3.5 (PA12), U1.50 (DIN/SDA)
SW1: A1.3.14 (PB5), C_SW1.1, R_SW1B.2
SW2: A1.3.13 (PA11), C_SW2.1, R_SW2B.2
USART_RX_RPI_TX: A1.3.7 (PB7), CONN_UART_RPI.2
USART_TX_RPI_RX: A1.3.8 (PB6), CONN_UART_RPI.3

Notes on the sheet:
MIXER A
VCF : attention le GND est a gauche (sens opposé des autres connecteurs) !!!

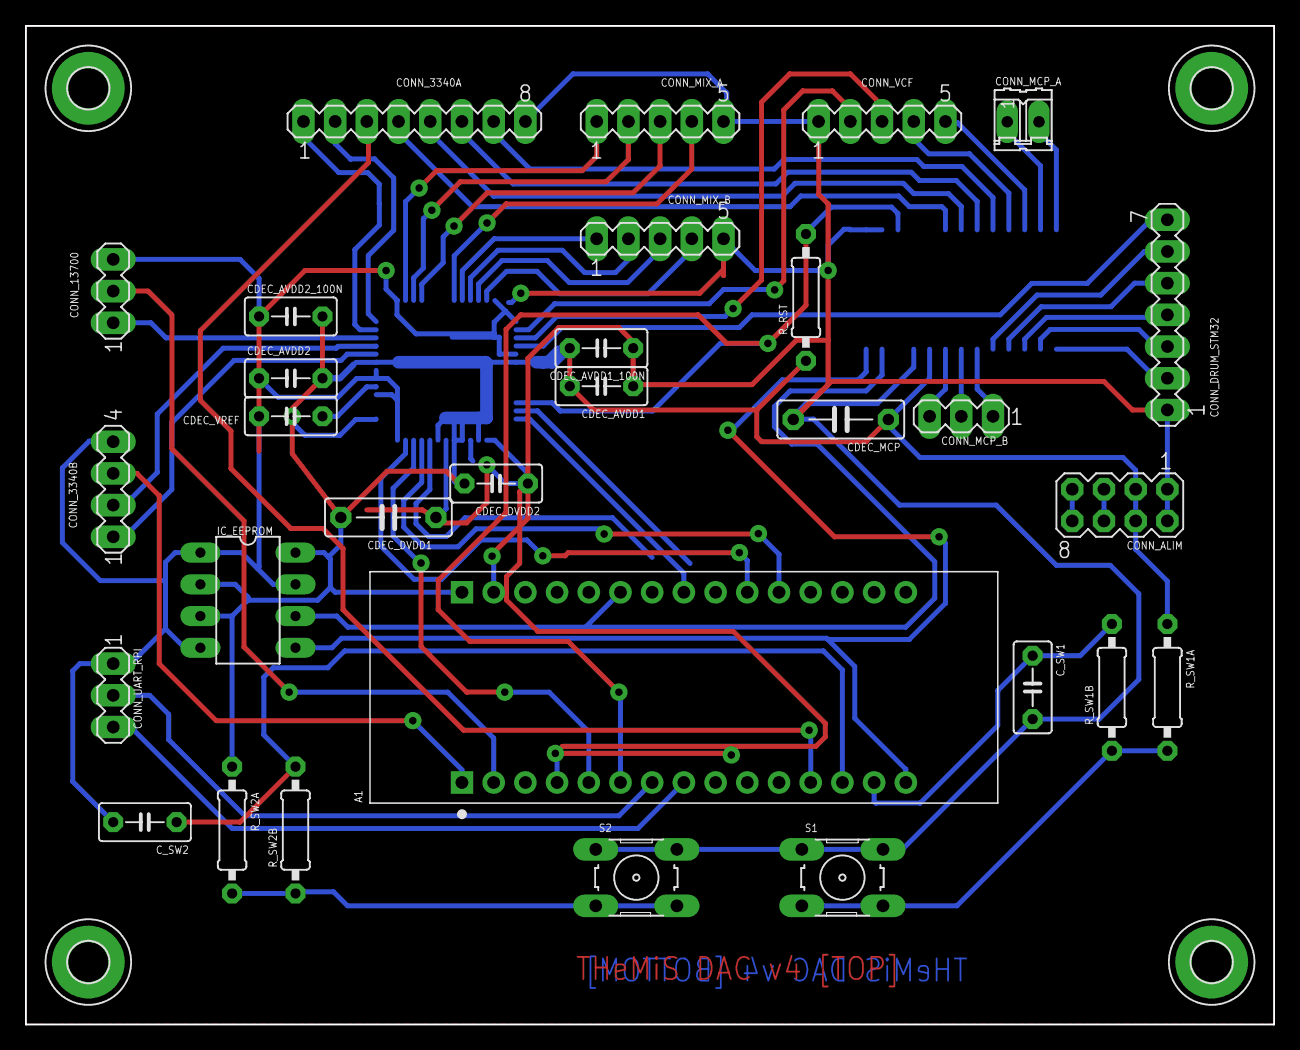
[picture p242: board DAC STM32 Board v4 - AD5391.brd from above]

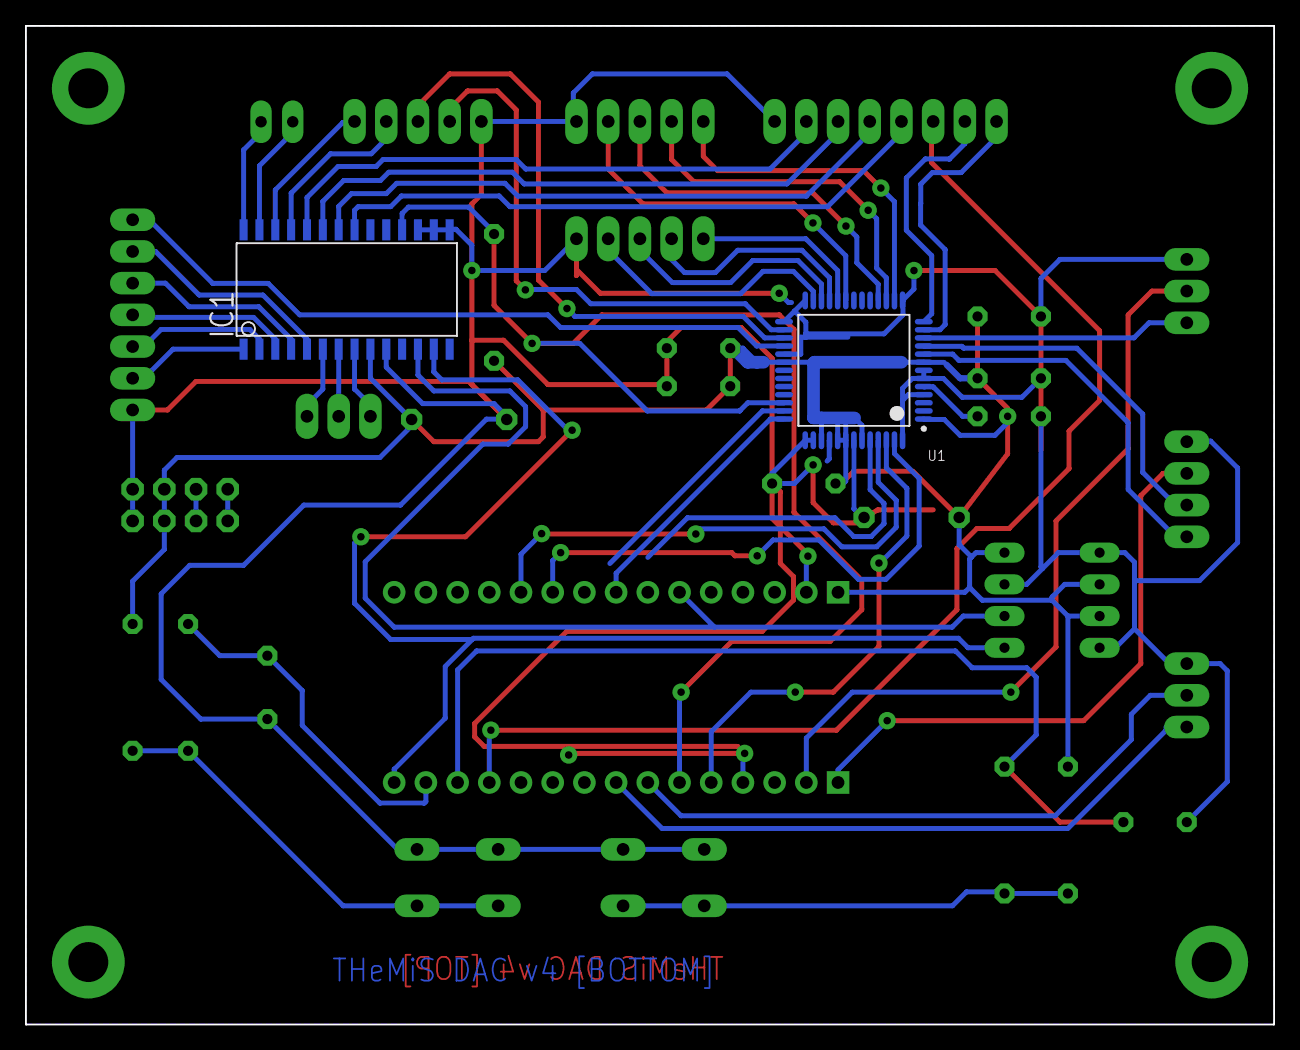
[picture p243: board DAC STM32 Board v4 - AD5391.brd from below]

Board: 2 copper layers, 100.0 x 80.0 mm, 36 parts (2 on the bottom side), 55 nets.
