reynal/themis/front-pane/raspberry-shield/Xbee pcb.brd

## EAGLE design front-pane/raspberry-shield/Xbee pcb.brd (2020-02-19)

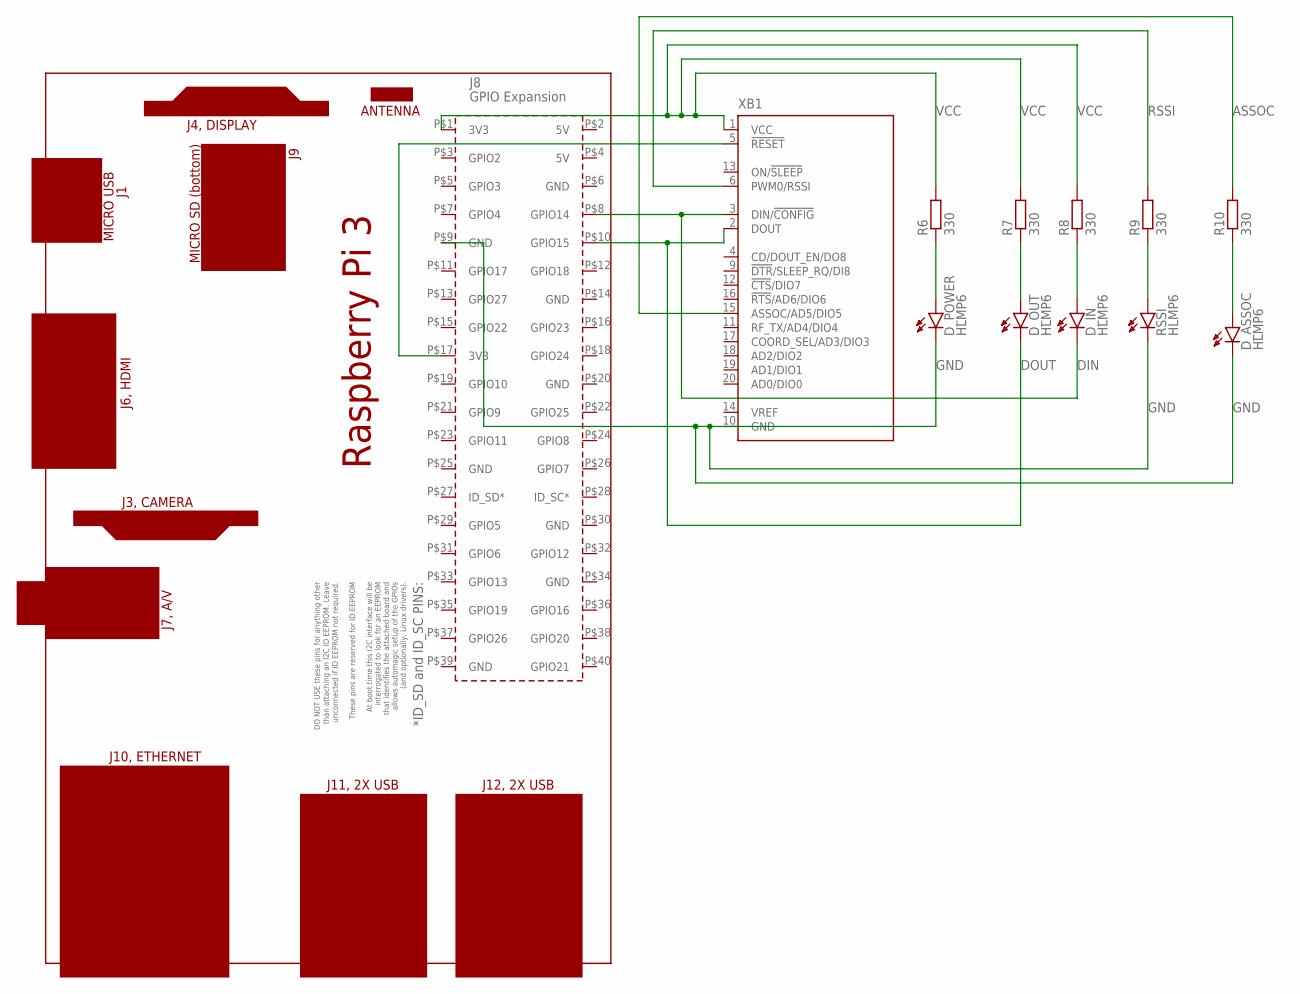
[picture p244: schematic Xbee pcb.sch]

Parts:
D_ASSOC: HLMP6
D_IN: HLMP6
D_OUT: HLMP6
D_POWER: HLMP6
PCB1: RPI3RPI3; RPI3
R6, R7, R8, R9, R10: 330; 0207/7
RSSI: HLMP6
XB1: XBEE

Connections:
ASSOC: R10.2, XB1.15 (ASSOC/AD5/DIO5)
DIN: D_IN.K, PCB1.P$8 (GPIO14), XB1.3 (DIN/!CONFIG)
DOUT: D_OUT.K, PCB1.P$10 (GPIO15), XB1.2 (DOUT)
GND: D_ASSOC.K, D_POWER.K, PCB1.P$9 (GND), RSSI.K, XB1.10 (GND)
unnamed: PCB1.P$17 (3V3), XB1.5 (!RESET)
unnamed: D_ASSOC.A, R10.1
unnamed: D_OUT.A, R7.1
unnamed: D_POWER.A, R6.1
unnamed: R9.1, RSSI.A
unnamed: D_IN.A, R8.1
RSSI: R9.2, XB1.6 (PWM0/RSSI)
VCC: PCB1.P$1 (3V3), R6.2, R7.2, R8.2, XB1.1 (VCC)

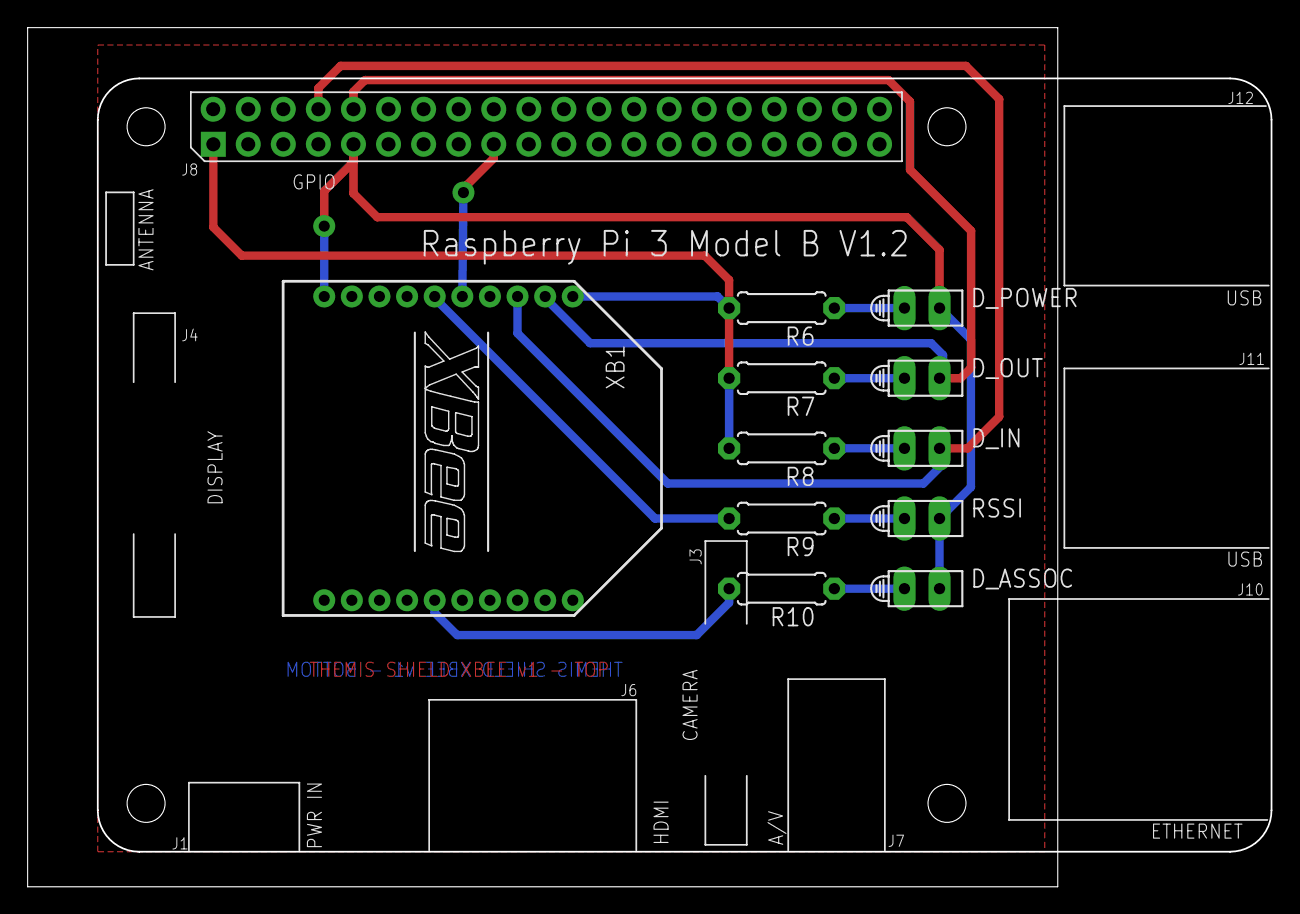
[picture p245: board Xbee pcb.brd from above]

Board: 2 copper layers, 90.1 x 62.2 mm, 12 parts (0 on the bottom side), 12 nets.
