reynal/themis/analog-modules/VCO LM13700/LM13700_v2.brd

## EAGLE design analog-modules/VCO LM13700/LM13700_v2.brd (2020-02-19)

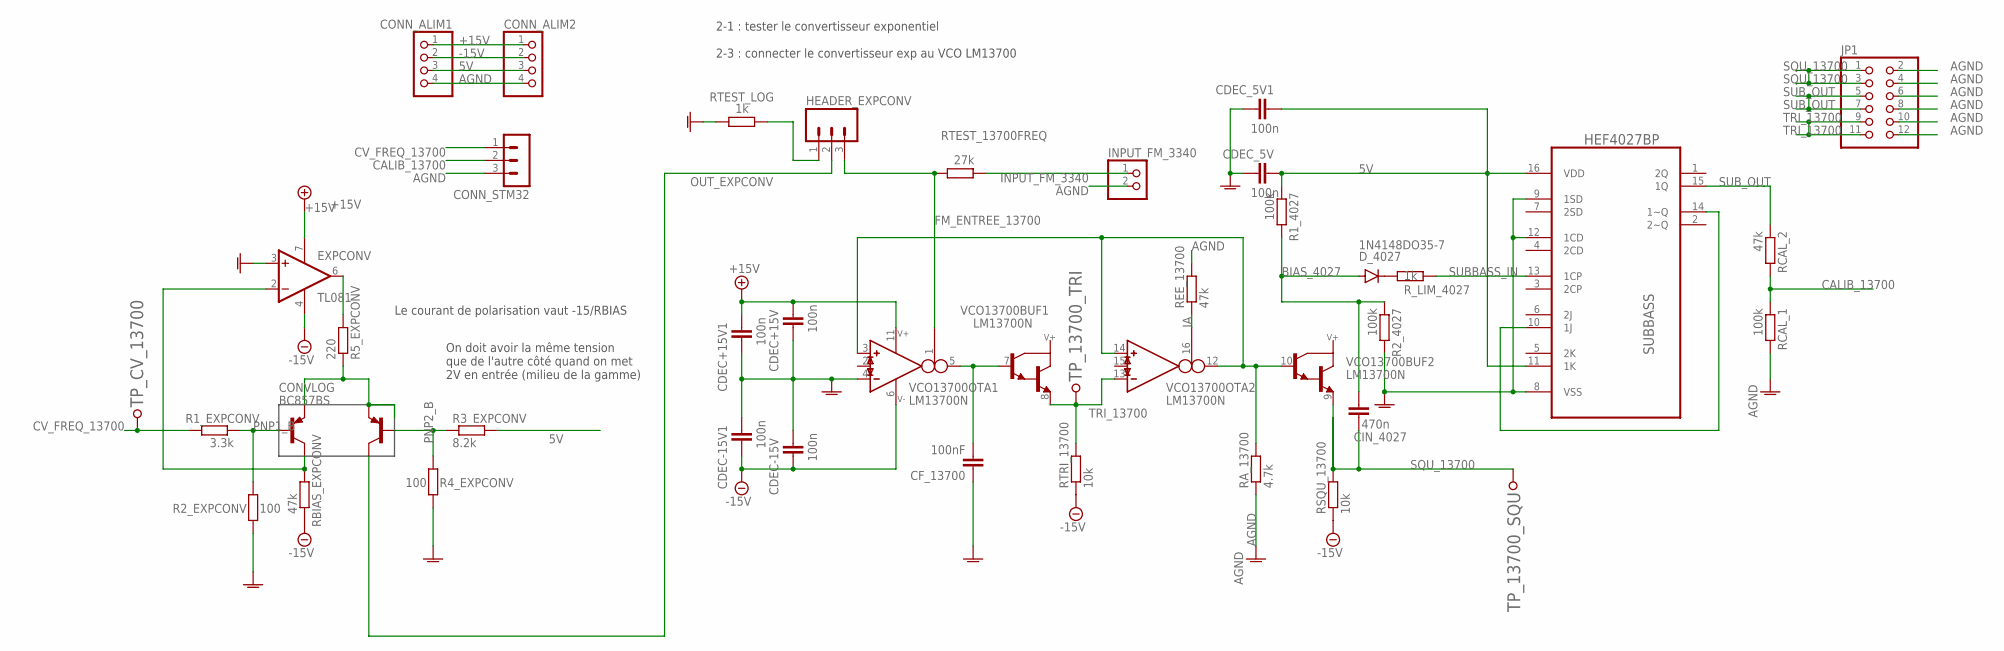
[picture p246: schematic LM13700_v2.sch]

Parts:
CDEC+15V: 100n; C075-032X103
CDEC+15V1: 100n; C050-025X075
CDEC-15V: 100n; C050-025X075
CDEC-15V1: 100n; C075-032X103
CDEC_5V, CDEC_5V1: 100n; C050-025X075
CF_13700: 100nF; C050-025X075
CIN_4027: 470n; C050-025X075
CONN_ALIM1, CONN_ALIM2: PINHD-1X4; 1X04
CONN_STM32: MA03-1
CONVLOG: BC857BS; DIL06
D_4027: 1N4148DO35-7; DO35-7
EXPCONV: TL081; DIL08
HEADER_EXPCONV: M03; 03P
INPUT_FM_3340: PINHD-1X2; 1X02
JP1: PINHD-2X6; 2X06
R1_4027, R2_4027: 100k; 0204/7
R1_EXPCONV: 3.3k; 0204/7
R2_EXPCONV, R4_EXPCONV: 100; 0204/7
R3_EXPCONV: 8.2k; 0204/7
R5_EXPCONV: 220; 0204/7
RA_13700: 4.7k; 0204/7
RBIAS_EXPCONV: 47k; 0204/7
RCAL_1: 100k; 0204/7
RCAL_2: 47k; 0204/7
REE_13700: 47k; 0204/7
RSQU_13700: 10k; 0204/7
RTEST_13700FREQ: 27k; 0204/7
RTEST_LOG: 1k; 0204/7
RTRI_13700: 10k; 0204/7
R_LIM_4027: 1k; 0204/7
SUBBASS: HEF4027BP; DIP254P762X420-16
TP_13700_SQU, TP_13700_TRI: TESTPOINT; TESTPOINT_63
TP_CV_13700: TESTPOINT; TESTPOINT_63
VCO13700: LM13700N; DIL16

Connections:
5V: CDEC_5V.1, CDEC_5V1.1, CONN_ALIM1.3, CONN_ALIM2.3, R1_4027.1, R3_EXPCONV.2, SUBBASS.11 (1K), SUBBASS.16 (VDD)
+15V: CDEC+15V.1, CDEC+15V1.1, CONN_ALIM1.1, CONN_ALIM2.1, EXPCONV.7 (V+), VCO13700.11 (V+)
-15V: CDEC-15V.2, CDEC-15V1.2, CONN_ALIM1.2, CONN_ALIM2.2, EXPCONV.4 (V-), RBIAS_EXPCONV.1, RSQU_13700.1, RTRI_13700.1, VCO13700.6 (V-)
AGND: CDEC+15V.2, CDEC+15V1.2, CDEC-15V.1, CDEC-15V1.1, CDEC_5V.2, CDEC_5V1.2, CF_13700.1, CONN_ALIM1.4, CONN_ALIM2.4, CONN_STM32.3, EXPCONV.3 (+IN), INPUT_FM_3340.2, JP1.2, JP1.4, JP1.6, JP1.8, JP1.10, JP1.12, R2_4027.2, R2_EXPCONV.2, R4_EXPCONV.2, RA_13700.1, RCAL_1.2, REE_13700.2, RTEST_LOG.2, SUBBASS.8 (VSS), SUBBASS.9 (1SD), SUBBASS.12 (1CD), VCO13700.4 (IN_N)
BIAS_4027: CIN_4027.1, D_4027.A, R1_4027.2, R2_4027.1
CALIB_13700: CONN_STM32.2, RCAL_1.1, RCAL_2.2
CV_FREQ_13700: CONN_STM32.1, R1_EXPCONV.2, TP_CV_13700.P$1
FM_ENTREE_13700: HEADER_EXPCONV.3, RTEST_13700FREQ.2, VCO13700.1 (I_BIAS)
IA: REE_13700.1, VCO13700.16 (I_BIAS)
INPUT_FM_3340: INPUT_FM_3340.1, RTEST_13700FREQ.1
unnamed: SUBBASS.10 (1J), SUBBASS.14 (1~Q)
unnamed: D_4027.C, R_LIM_4027.2
unnamed: EXPCONV.6 (OUT), R5_EXPCONV.2
unnamed: RA_13700.2, VCO13700.3 (IN_P), VCO13700.10 (B), VCO13700.12 (OUT), VCO13700.14 (IN_P)
unnamed: CF_13700.2, VCO13700.5 (OUT), VCO13700.7 (B)
unnamed: HEADER_EXPCONV.1, RTEST_LOG.1
OUT_EXPCONV: CONVLOG.3 (C2), HEADER_EXPCONV.2
PNP1_B: CONVLOG.2 (B1), R1_EXPCONV.1, R2_EXPCONV.1
PNP1_C: CONVLOG.6 (C1), EXPCONV.2 (-IN), RBIAS_EXPCONV.2
PNP2_B: CONVLOG.5 (B2), R3_EXPCONV.1, R4_EXPCONV.1
PNP_E: CONVLOG.1 (E1), CONVLOG.4 (E2), R5_EXPCONV.1
SQU_13700: CIN_4027.2, JP1.1, JP1.3, RSQU_13700.2, TP_13700_SQU.P$1, VCO13700.9 (E)
SUBBASS_IN: R_LIM_4027.1, SUBBASS.13 (1CP)
SUB_OUT: JP1.5, JP1.7, RCAL_2.1, SUBBASS.15 (1Q)
TRI_13700: JP1.9, JP1.11, RTRI_13700.2, TP_13700_TRI.P$1, VCO13700.8 (E), VCO13700.13 (IN_N)

Notes on the sheet:
On doit avoir la même tension que de l'autre côté quand on met 2V en entrée (milieu de la gamme)
Le courant de polarisation vaut -15/RBIAS
2-1 : tester le convertisseur exponentiel 2-3 : connecter le convertisseur exp au VCO LM13700

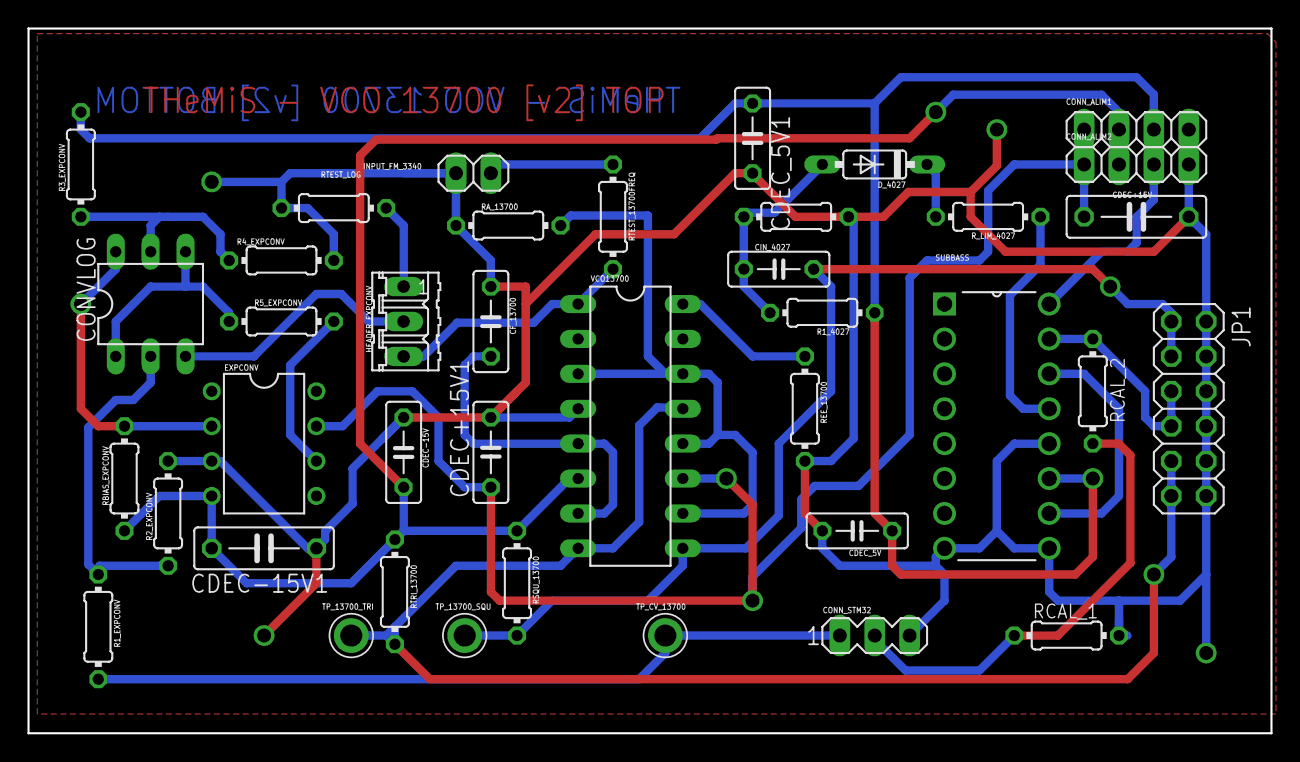
[picture p247: board LM13700_v2.brd from above]

Board: 2 copper layers, 90.5 x 51.3 mm, 39 parts (0 on the bottom side), 25 nets.
