reynal/themis/analog-modules/Sample and hold/sample_and_hold.brd

## EAGLE design analog-modules/Sample and hold/sample_and_hold.brd (2019-09-23)

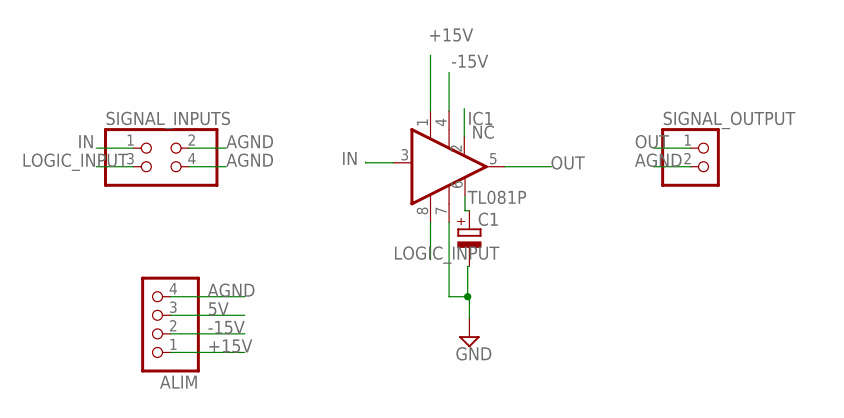
[picture p248: schematic sample_and_hold.sch]

Parts:
ALIM: PINHD-1X4; 1X04
C1: CPOL-EUE2,5-6E; E2,5-6E
IC1: TL081P; DIL08
SIGNAL_INPUTS: PINHD-2X2; 2X02
SIGNAL_OUTPUT: PINHD-1X2; 1X02

Connections:
5V: ALIM.3
+15V: ALIM.1, IC1.1 (V+)
-15V: ALIM.2, IC1.4 (V-)
AGND: ALIM.4, C1.-, IC1.7 (LOGIC_REF), SIGNAL_INPUTS.2, SIGNAL_INPUTS.4, SIGNAL_OUTPUT.2
IN: IC1.3 (IN), SIGNAL_INPUTS.1
LOGIC_INPUT: IC1.8 (LOGIC_INPUT), SIGNAL_INPUTS.3
unnamed: C1.+, IC1.6 (HOLD_CAPACITOR)
NC: IC1.2 (OFFSET)
OUT: IC1.5 (OUT), SIGNAL_OUTPUT.1

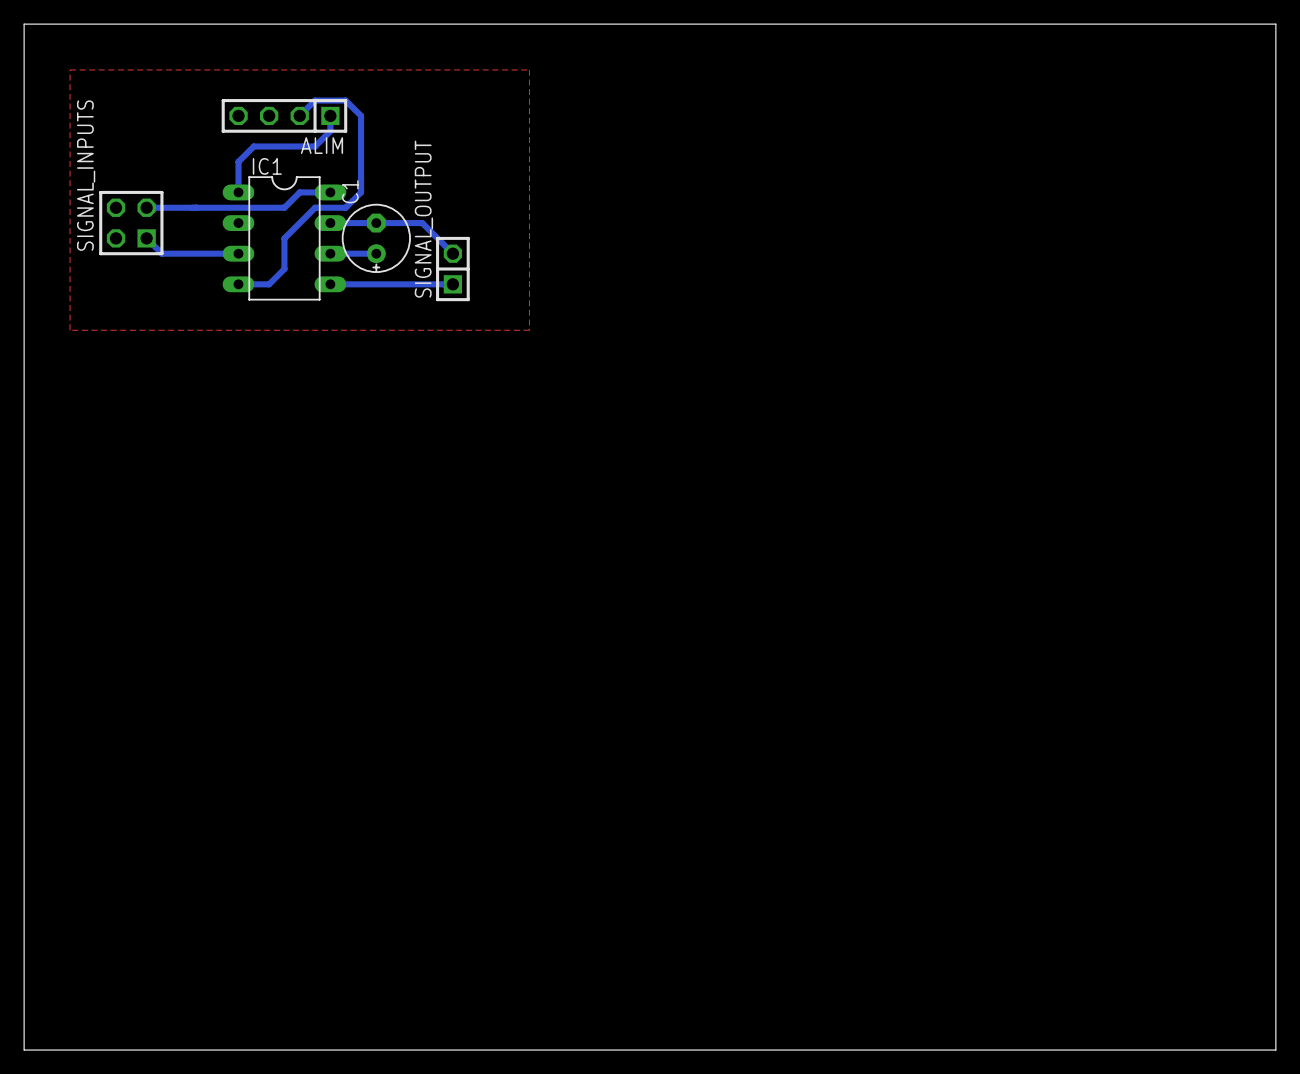
[picture p249: board sample_and_hold.brd from above]

Board: 2 copper layers, 103.8 x 85.1 mm, 5 parts (0 on the bottom side), 7 nets.
