reynal/themis/main-board/v1/eagle-schematics/DAC STM32 Board v3.brd

## EAGLE design main-board/v1/eagle-schematics/DAC STM32 Board v3.brd (2019-09-23, an earlier design)

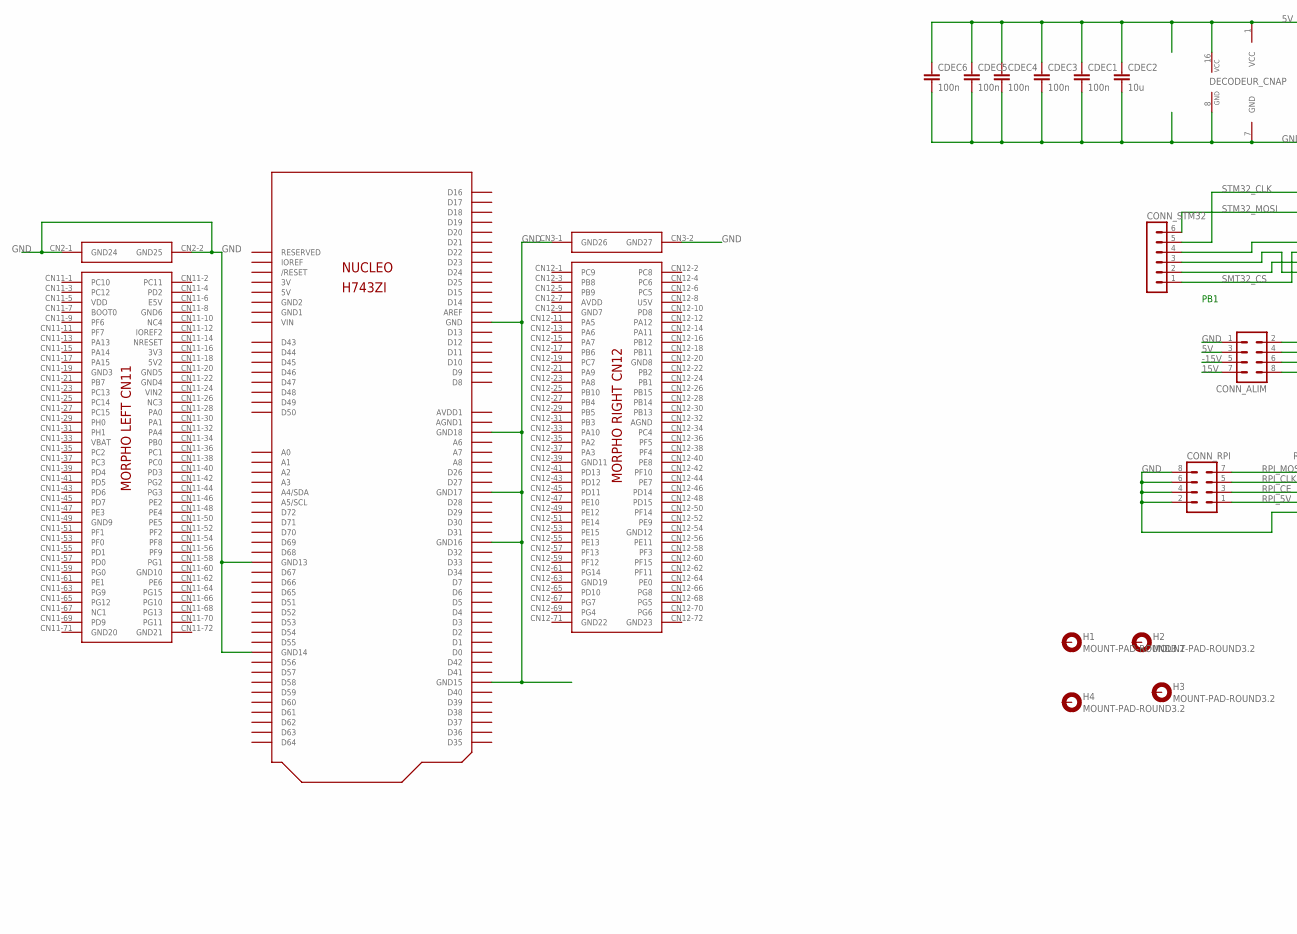
[picture p250: schematic DAC STM32 Board v3.sch, part in row 1, column 1]

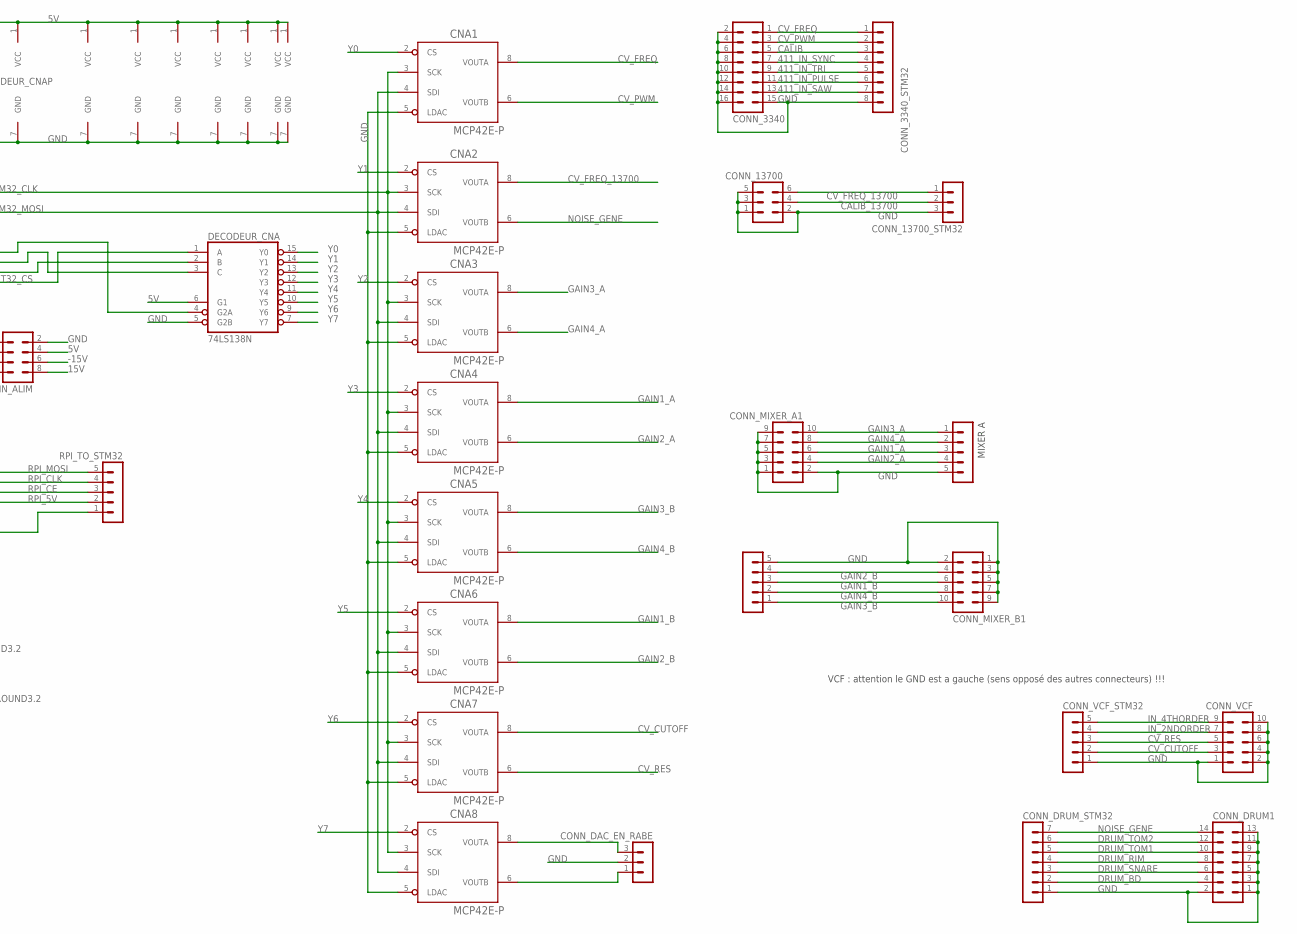
[picture p251: schematic DAC STM32 Board v3.sch, part in row 1, column 2]

Parts:
CDEC1: 100n; C050-025X075
CDEC2: 10u; C050-025X075
CDEC3, CDEC4, CDEC5, CDEC6: 100n; C075-032X103
CNA1, CNA2, CNA3, CNA4, CNA5, CNA6, CNA7, CNA8: MCP42E-P; DIL08
CONN_3340: MA08-2
CONN_3340_STM32: MA08-1
CONN_13700: MA03-2
CONN_13700_STM32: MA03-1
CONN_ALIM: MA04-2
CONN_DAC_EN_RABE: MA03-1
CONN_DRUM1: MA07-2
CONN_DRUM_STM32: MA07-1
CONN_MIXER_A1: MA05-2
CONN_MIXER_A_STM32: MA05-1
CONN_MIXER_B1: MA05-2
CONN_MIXER_B_STM32: MA05-1
CONN_RPI: MA04-2
CONN_STM32: MA06-1
CONN_VCF: MA05-2
CONN_VCF_STM32: MA05-1
DECODEUR_CNA: 74LS138N; DIL16
H1, H2, H3, H4: MOUNT-PAD-ROUND3.2; 3,2-PAD
RPI_TO_STM32: MA05-1
U$1: NUCLEO_H743ZI; NUCLEO_BRD144

Connections:
3V: U$1.CN8-7 (3V)
3V3: U$1.CN11-16 (3V3)
5V: CDEC1.1, CDEC2.1, CDEC3.1, CDEC4.1, CDEC5.1, CDEC6.1, CNA1.1 (VCC), CNA2.1 (VCC), CNA3.1 (VCC), CNA4.1 (VCC), CNA5.1 (VCC), CNA6.1 (VCC), CNA7.1 (VCC), CNA8.1 (VCC), CONN_ALIM.3, CONN_ALIM.4, DECODEUR_CNA.6 (G1), DECODEUR_CNA.16 (VCC), U$1.CN8-9 (5V)
5V2: U$1.CN11-18 (5V2)
15V: CONN_ALIM.7, CONN_ALIM.8
411_IN_PULSE: CONN_3340.11, CONN_3340_STM32.6
411_IN_SAW: CONN_3340.13, CONN_3340_STM32.7
411_IN_SYNC: CONN_3340.7, CONN_3340_STM32.4
411_IN_TRI: CONN_3340.9, CONN_3340_STM32.5
-15V: CONN_ALIM.5, CONN_ALIM.6
AGND: U$1.CN12-32 (AGND)
AVDD: U$1.CN12-7 (AVDD)
CALIB: CONN_3340.5, CONN_3340_STM32.3
CALIB_13700: CONN_13700.4, CONN_13700_STM32.2
CV_CUTOFF: CNA7.8 (VOUTA), CONN_VCF.3, CONN_VCF_STM32.2
CV_FREQ: CNA1.8 (VOUTA), CONN_3340.1, CONN_3340_STM32.1
CV_FREQ_13700: CNA2.8 (VOUTA), CONN_13700.6, CONN_13700_STM32.1
CV_PWM: CNA1.6 (VOUTB), CONN_3340.3, CONN_3340_STM32.2
CV_RES: CNA7.6 (VOUTB), CONN_VCF.5, CONN_VCF_STM32.3
D21: U$1.CN7-11 (D21)
DRUM_BD: CONN_DRUM1.4, CONN_DRUM_STM32.2
DRUM_RIM: CONN_DRUM1.8, CONN_DRUM_STM32.4
DRUM_SNARE: CONN_DRUM1.6, CONN_DRUM_STM32.3
DRUM_TOM1: CONN_DRUM1.10, CONN_DRUM_STM32.5
DRUM_TOM2: CONN_DRUM1.12, CONN_DRUM_STM32.6
E5V: U$1.CN11-6 (E5V)
GAIN1_A: CNA4.8 (VOUTA), CONN_MIXER_A1.6, CONN_MIXER_A_STM32.3
GAIN1_B: CNA6.8 (VOUTA), CONN_MIXER_B1.6, CONN_MIXER_B_STM32.3
GAIN2_A: CNA4.6 (VOUTB), CONN_MIXER_A1.4, CONN_MIXER_A_STM32.4
GAIN2_B: CNA6.6 (VOUTB), CONN_MIXER_B1.4, CONN_MIXER_B_STM32.4
GAIN3_A: CNA3.8 (VOUTA), CONN_MIXER_A1.10, CONN_MIXER_A_STM32.1
GAIN3_B: CNA5.8 (VOUTA), CONN_MIXER_B1.10, CONN_MIXER_B_STM32.1
GAIN4_A: CNA3.6 (VOUTB), CONN_MIXER_A1.8, CONN_MIXER_A_STM32.2
GAIN4_B: CNA5.6 (VOUTB), CONN_MIXER_B1.8, CONN_MIXER_B_STM32.2
GND: CDEC1.2, CDEC2.2, CDEC3.2, CDEC4.2, CDEC5.2, CDEC6.2, CNA1.5 (LDAC), CNA1.7 (GND), CNA2.5 (LDAC), CNA2.7 (GND), CNA3.5 (LDAC), CNA3.7 (GND), CNA4.5 (LDAC), CNA4.7 (GND), CNA5.5 (LDAC), CNA5.7 (GND), CNA6.5 (LDAC), CNA6.7 (GND), CNA7.5 (LDAC), CNA7.7 (GND), CNA8.5 (LDAC), CNA8.7 (GND), CONN_3340.2, CONN_3340.4, CONN_3340.6, CONN_3340.8, CONN_3340.10, CONN_3340.12, CONN_3340.14, CONN_3340.15, CONN_3340.16, CONN_3340_STM32.8, CONN_13700.1, CONN_13700.2, CONN_13700.3, CONN_13700.5, CONN_13700_STM32.3, CONN_ALIM.1, CONN_ALIM.2, CONN_DAC_EN_RABE.2, CONN_DRUM1.1, CONN_DRUM1.2, CONN_DRUM1.3, CONN_DRUM1.5, CONN_DRUM1.7, CONN_DRUM1.9, CONN_DRUM1.11, CONN_DRUM1.13, CONN_DRUM_STM32.1, CONN_MIXER_A1.1, CONN_MIXER_A1.2, CONN_MIXER_A1.3, CONN_MIXER_A1.5, CONN_MIXER_A1.7, CONN_MIXER_A1.9, CONN_MIXER_A_STM32.5, CONN_MIXER_B1.1, CONN_MIXER_B1.2, CONN_MIXER_B1.3, CONN_MIXER_B1.5, CONN_MIXER_B1.7, CONN_MIXER_B1.9, CONN_MIXER_B_STM32.5, CONN_RPI.2, CONN_RPI.4, CONN_RPI.6, CONN_RPI.8, CONN_VCF.1, CONN_VCF.2, CONN_VCF.4, CONN_VCF.6, CONN_VCF.8, CONN_VCF.10, CONN_VCF_STM32.1, DECODEUR_CNA.5 (G2B), DECODEUR_CNA.8 (GND), RPI_TO_STM32.1, U$1.CN2-1 (GND24), U$1.CN2-2 (GND25), U$1.CN3-1 (GND26), U$1.CN3-2 (GND27), U$1.CN7-8 (GND), U$1.CN9-12 (GND14), U$1.CN9-23 (GND13), U$1.CN10-5 (GND18), U$1.CN10-17 (GND17), U$1.CN10-22 (GND15), U$1.CN10-27 (GND16)
GND1: U$1.CN8-13 (GND1)
GND2: U$1.CN8-11 (GND2)
GND3: U$1.CN11-19 (GND3)
GND4: U$1.CN11-22 (GND4)
GND5: U$1.CN11-20 (GND5)
GND6: U$1.CN11-8 (GND6)
GND7: U$1.CN12-9 (GND7)
GND8: U$1.CN12-20 (GND8)
IN_2NDORDER: CONN_VCF.7, CONN_VCF_STM32.4
IN_4THORDER: CONN_VCF.9, CONN_VCF_STM32.5
unnamed: CONN_STM32.1, DECODEUR_CNA.1 (A)
unnamed: CONN_STM32.2, DECODEUR_CNA.2 (B)
unnamed: CONN_STM32.3, DECODEUR_CNA.3 (C)
unnamed: CNA8.8 (VOUTA), CONN_DAC_EN_RABE.3
unnamed: CNA8.6 (VOUTB), CONN_DAC_EN_RABE.1
NOISE_GENE: CNA2.6 (VOUTB), CONN_DRUM1.14, CONN_DRUM_STM32.7
RPI_5V: CONN_RPI.1, RPI_TO_STM32.2
RPI_CE: CONN_RPI.3, RPI_TO_STM32.3
RPI_CLK: CONN_RPI.5, RPI_TO_STM32.4
RPI_MOSI: CONN_RPI.7, RPI_TO_STM32.5
SMT32_CS: CONN_STM32.4, DECODEUR_CNA.4 (G2A)
STM32_CLK: CNA1.3 (SCK), CNA2.3 (SCK), CNA3.3 (SCK), CNA4.3 (SCK), CNA5.3 (SCK), CNA6.3 (SCK), CNA7.3 (SCK), CNA8.3 (SCK), CONN_STM32.5
STM32_MOSI: CNA1.4 (SDI), CNA2.4 (SDI), CNA3.4 (SDI), CNA4.4 (SDI), CNA5.4 (SDI), CNA6.4 (SDI), CNA7.4 (SDI), CNA8.4 (SDI), CONN_STM32.6
U5V: U$1.CN12-8 (U5V)
VBAT: U$1.CN11-33 (VBAT)
VDD: U$1.CN11-5 (VDD)
VIN: U$1.CN8-15 (VIN)
VIN2: U$1.CN11-24 (VIN2)
Y0: CNA1.2 (CS), DECODEUR_CNA.15 (Y0)
Y1: CNA2.2 (CS), DECODEUR_CNA.14 (Y1)
Y2: CNA3.2 (CS), DECODEUR_CNA.13 (Y2)
Y3: CNA4.2 (CS), DECODEUR_CNA.12 (Y3)
Y4: CNA5.2 (CS), DECODEUR_CNA.11 (Y4)
Y5: CNA6.2 (CS), DECODEUR_CNA.10 (Y5)
Y6: CNA7.2 (CS), DECODEUR_CNA.9 (Y6)
Y7: CNA8.2 (CS), DECODEUR_CNA.7 (Y7)

Notes on the sheet:
MIXER A
PB1
VCF : attention le GND est a gauche (sens opposé des autres connecteurs) !!!

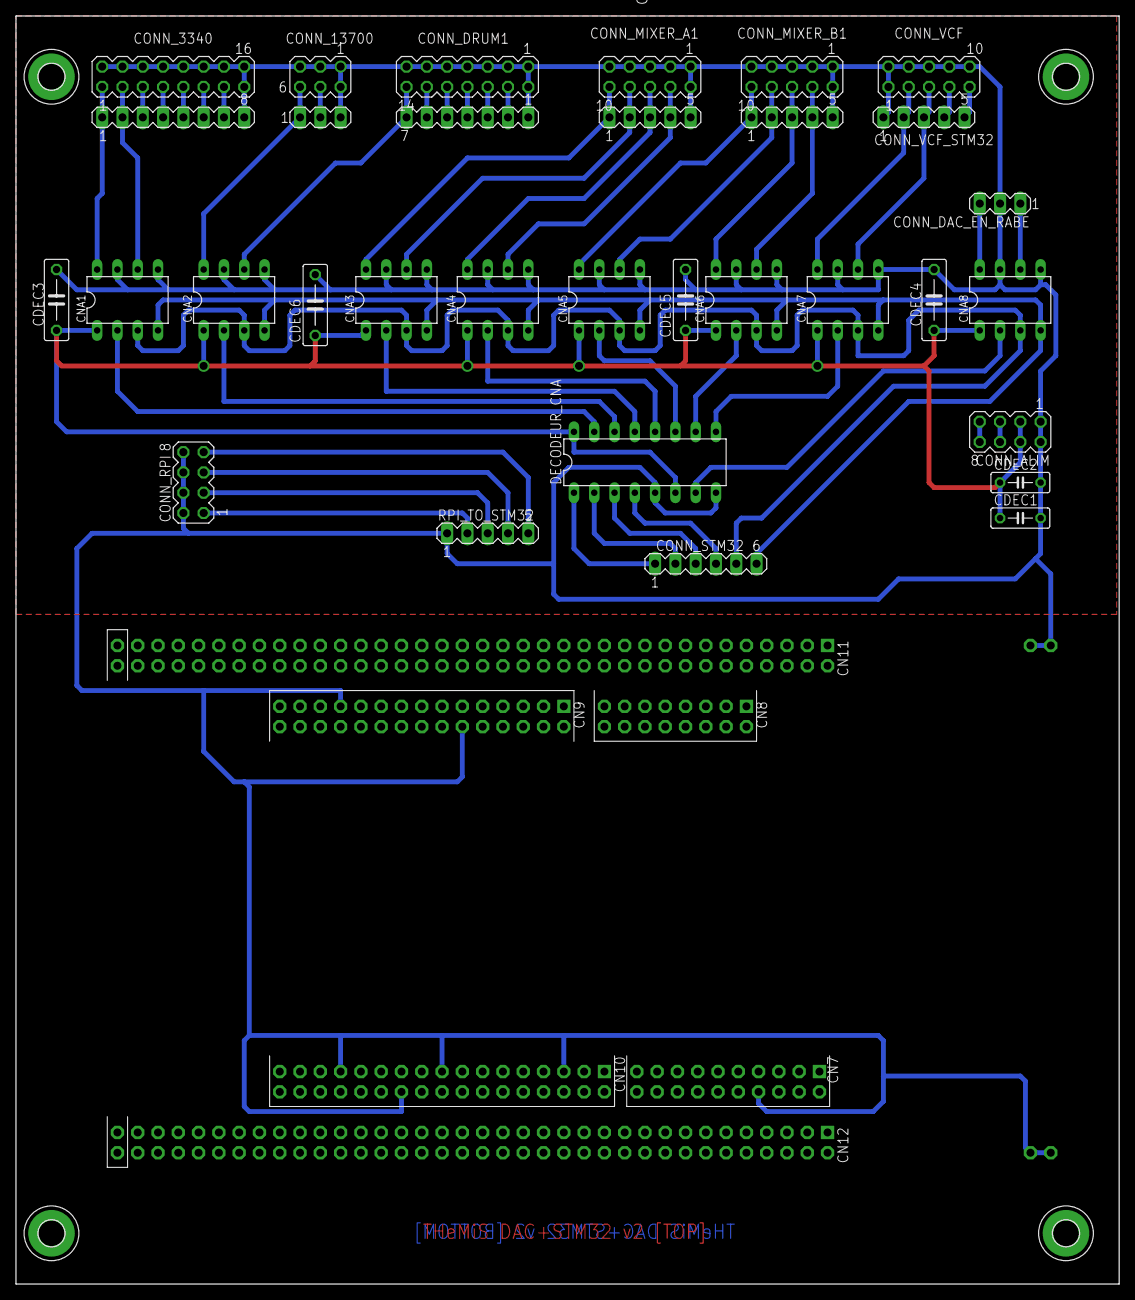
[picture p252: board DAC STM32 Board v3.brd from above]

Board: 2 copper layers, 138.1 x 158.7 mm, 37 parts (0 on the bottom side), 51 nets.
