reynal/themis/analog-modules/supply/part 2.brd

## EAGLE design analog-modules/supply/part 2.brd (2019-09-23)

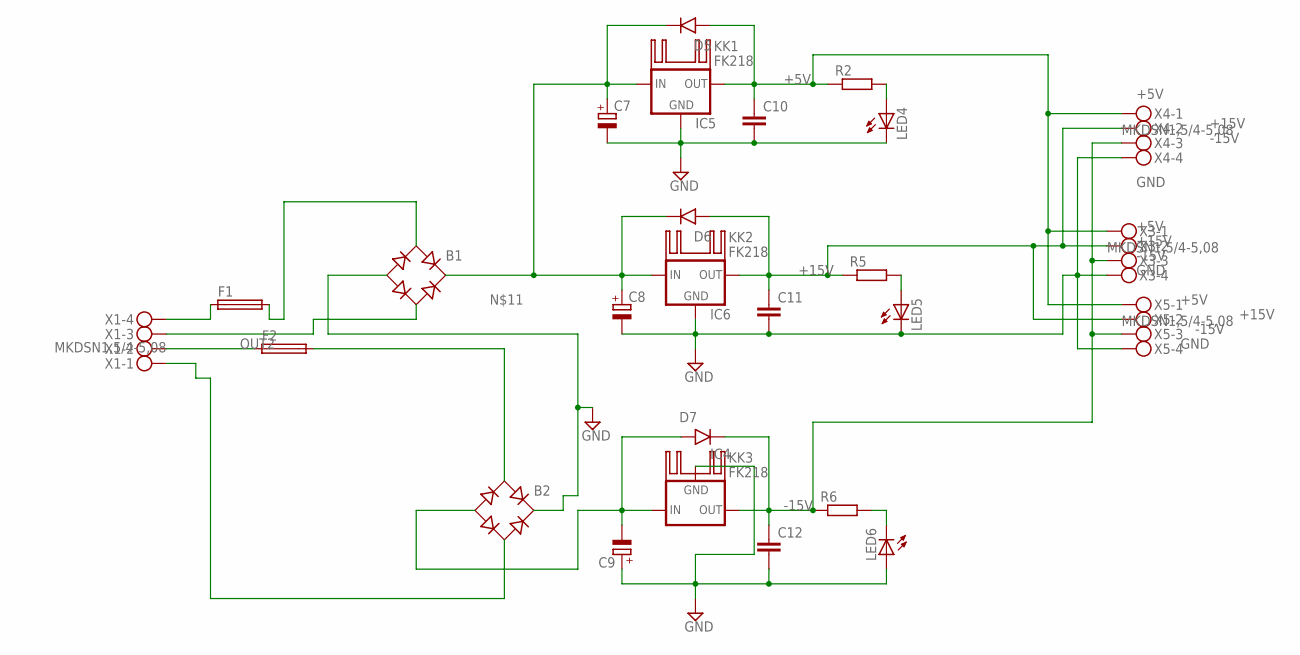
[picture p253: schematic part 2.sch]

Parts:
B1, B2: RB1A
C7, C8, C9: CPOL-EUE7.5-18; E7,5-18
C10, C11, C12: C-EU050-025X075; C050-025X075
D5, D6, D7: 1N4001; DO41-10
F1, F2: SH22,5A
IC4: 79XXS
IC5, IC6: 78XXS
KK1, KK2, KK3: FK218
LED4, LED5, LED6: LED5MM
R2, R5, R6: R-EU_0207/15; 0207/15
X1, X3, X4, X5: MKDSN1,5/4-5,08

Connections:
+5V: C10.1, D5.A (ANODE), IC5.OUT, R2.1, X3.1, X4.1, X5.1
+15V: C11.1, D6.A (ANODE), IC6.OUT, R5.1, X3.2, X4.2, X5.2
-15V: C12.1, D7.C (CATHODE), IC4.OUT, R6.1, X3.3, X4.3, X5.3
GND: B1.-, B2.+, C7.-, C8.-, C9.+, C10.2, C11.2, C12.2, IC4.GND, IC5.GND, IC6.GND, LED4.K (C), LED5.K (C), LED6.A, X3.4, X4.4, X5.4
unnamed: B1.AC1, F1.2
unnamed: F1.1, X1.4
unnamed: F2.1, X1.2
unnamed: B2.AC2, X1.1
unnamed: LED5.A, R5.2
unnamed: B2.-, C9.-, D7.A (ANODE), IC4.IN
unnamed: B1.+, C7.+, C8.+, D5.C (CATHODE), D6.C (CATHODE), IC5.IN, IC6.IN
unnamed: B2.AC1, F2.2
unnamed: LED4.A, R2.2
unnamed: LED6.K (C), R6.2
OUT2: B1.AC2, X1.3

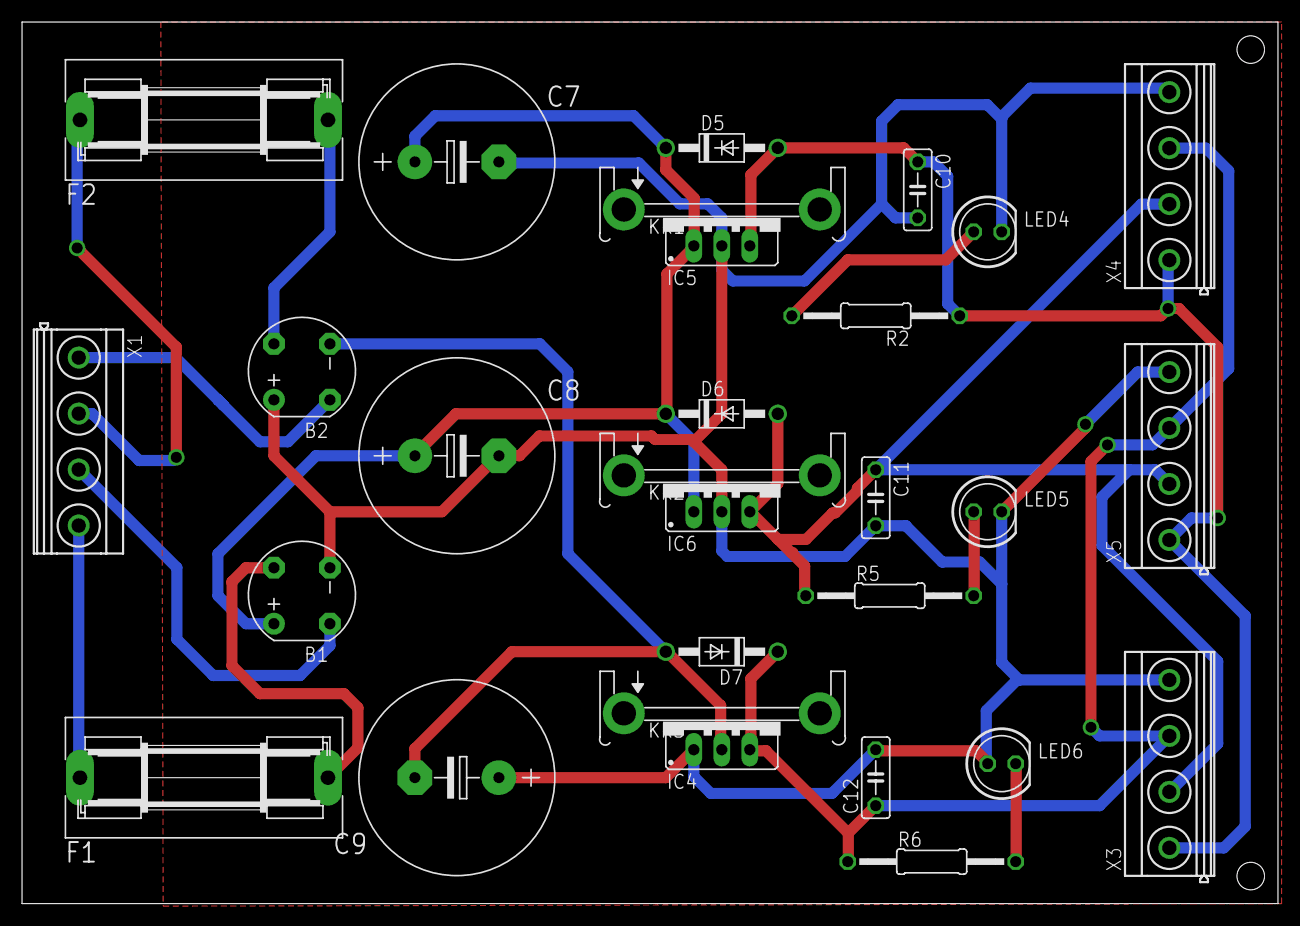
[picture p254: board part 2.brd from above]

Board: 2 copper layers, 114.0 x 80.0 mm, 29 parts (0 on the bottom side), 15 nets.
