reynal/themis/analog-modules/VCO AS3340/VCO3340 v2.1.brd

## EAGLE design analog-modules/VCO AS3340/VCO3340 v2.1.brd (2020-01-07)

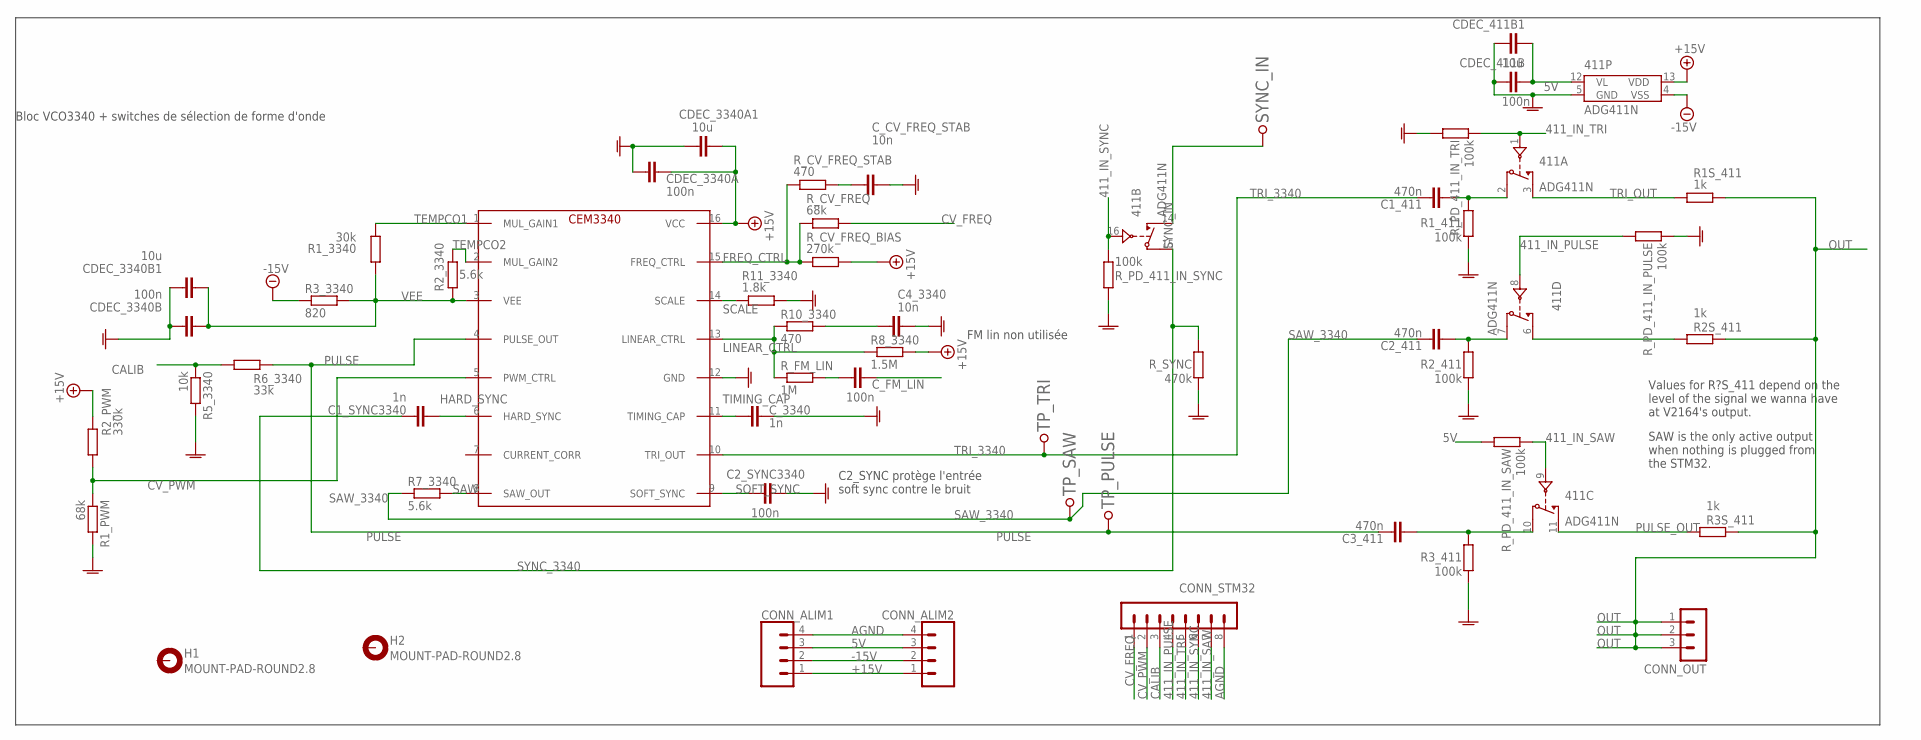
[picture p255: schematic VCO3340 v2.1.sch]

Parts:
411: ADG411N; DIL16
C1_411: 470n; C050-030X075
C1_SYNC3340: 1n; C075-032X103
C2_411: 470n; C075-032X103
C2_SYNC3340: 100n; C075-032X103
C3_411: 470n; C102-043X133
C4_3340: 10n; C050-025X075
CDEC_411B, CDEC_3340A, CDEC_3340B: 100n; C050-025X075
CDEC_411B1, CDEC_3340A1, CDEC_3340B1: 10u; C050-025X075
CEM3340: CEM3340; DIL16
CONN_ALIM1, CONN_ALIM2: CONN_04; 1X04
CONN_OUT: MA03-1
CONN_STM32: MA08-1
C_3340: 1n; C050-025X075
C_CV_FREQ_STAB: 10n; C075-032X103
C_FM_LIN: 100n; C050-025X075
H1, H2: MOUNT-PAD-ROUND2.8; 2,8-PAD
R1S_411, R3S_411: 1k; 0204/7
R1_411, R2_411: 100k; 0207/10
R1_3340: 30k; 0204/7
R1_PWM: 68k; 0207/12
R2S_411: 1k; 0207/10
R2_3340: 5.6k; 0204/7
R2_PWM: 330k; 0204/7
R3_411: 100k; 0204/7
R3_3340: 820; 0204/7
R5_3340: 10k; 0204/7
R6_3340: 33k; 0204/7
R7_3340: 5.6k; 0207/10
R8_3340: 1.5M; 0204/7
R10_3340: 470; 0204/7
R11_3340: 1.8k; 0204/7
R_CV_FREQ: 68k; 0204/7
R_CV_FREQ_BIAS: 270k; 0204/7
R_CV_FREQ_STAB: 470; 0204/7
R_FM_LIN: 1M; 0204/7
R_PD_411_IN_PULSE, R_PD_411_IN_SAW: 100k; 0207/10
R_PD_411_IN_SYNC, R_PD_411_IN_TRI: 100k; 0204/7
R_SYNC: 470k; 0204/7
SYNC_IN: TESTPOINT; TESTPOINT_63
TP_PULSE: TESTPOINT; TESTPOINT_63
TP_SAW: TESTPOINT; TESTPOINT_63
TP_TRI: TESTPOINT; TESTPOINT_63

Connections:
5V: 411.12 (VL), CDEC_411B.1, CDEC_411B1.1, CONN_ALIM1.3, CONN_ALIM2.3, R_PD_411_IN_SAW.2
411_IN_PULSE: 411.8 (IN), CONN_STM32.4, R_PD_411_IN_PULSE.2
411_IN_SAW: 411.9 (IN), CONN_STM32.7, R_PD_411_IN_SAW.1
411_IN_SYNC: 411.16 (IN), CONN_STM32.6, R_PD_411_IN_SYNC.1
411_IN_TRI: 411.1 (IN), CONN_STM32.5, R_PD_411_IN_TRI.1
+15V: 411.13 (VDD), CDEC_3340A.2, CDEC_3340A1.2, CEM3340.16 (VCC), CONN_ALIM1.1, CONN_ALIM2.1, R2_PWM.2, R8_3340.2, R_CV_FREQ_BIAS.2
-15V: 411.4 (VSS), CONN_ALIM1.2, CONN_ALIM2.2, R3_3340.1
AGND: 411.5 (GND), C2_SYNC3340.1, C4_3340.2, CDEC_411B.2, CDEC_411B1.2, CDEC_3340A.1, CDEC_3340A1.1, CDEC_3340B.1, CDEC_3340B1.1, CEM3340.12 (GND), CONN_ALIM1.4, CONN_ALIM2.4, CONN_STM32.8, C_3340.1, C_CV_FREQ_STAB.1, R1_411.1, R1_PWM.2, R2_411.1, R3_411.1, R5_3340.2, R11_3340.2, R_PD_411_IN_PULSE.1, R_PD_411_IN_SYNC.2, R_PD_411_IN_TRI.2, R_SYNC.1
CALIB: CONN_STM32.3, R5_3340.1, R6_3340.1
CV_FREQ: CONN_STM32.1, R_CV_FREQ.2
CV_PWM: CEM3340.5 (PWM_CTRL), CONN_STM32.2, R1_PWM.1, R2_PWM.1
FREQ_CTRL: CEM3340.15 (FREQ_CTRL), R_CV_FREQ.1, R_CV_FREQ_BIAS.1, R_CV_FREQ_STAB.1
HARD_SYNC: C1_SYNC3340.2, CEM3340.6 (HARD_SYNC)
LINEAR_CTRL: CEM3340.13 (LINEAR_CTRL), R8_3340.1, R10_3340.1, R_FM_LIN.1
unnamed: C_FM_LIN.1, R_FM_LIN.2
unnamed: 411.6 (S), R2S_411.2
unnamed: C_CV_FREQ_STAB.2, R_CV_FREQ_STAB.2
unnamed: C4_3340.1, R10_3340.2
unnamed: 411.2 (D), C1_411.2, R1_411.2
unnamed: 411.7 (D), C2_411.2, R2_411.2
unnamed: 411.10 (D), C3_411.2, R3_411.2
OUT: CONN_OUT.1, CONN_OUT.2, CONN_OUT.3, R1S_411.2, R2S_411.1, R3S_411.1
PULSE: C3_411.1, CEM3340.4 (PULSE_OUT), R6_3340.2, TP_PULSE.P$1
PULSE_OUT: 411.11 (S), R3S_411.2
SAW: CEM3340.8 (SAW_OUT), R7_3340.2
SAW_3340: C2_411.1, R7_3340.1, TP_SAW.P$1
SCALE: CEM3340.14 (SCALE), R11_3340.1
SOFT_SYNC: C2_SYNC3340.2, CEM3340.9 (SOFT_SYNC)
SYNC_3340: 411.15 (D), C1_SYNC3340.1, R_SYNC.2
SYNC_IN: 411.14 (S), SYNC_IN.P$1
TEMPCO1: CEM3340.1 (MUL_GAIN1), R1_3340.1
TEMPCO2: CEM3340.2 (MUL_GAIN2), R2_3340.1
TIMING_CAP: CEM3340.11 (TIMING_CAP), C_3340.2
TRI_3340: C1_411.1, CEM3340.10 (TRI_OUT), TP_TRI.P$1
TRI_OUT: 411.3 (S), R1S_411.1
VEE: CDEC_3340B.2, CDEC_3340B1.2, CEM3340.3 (VEE), R1_3340.2, R2_3340.2, R3_3340.2

Notes on the sheet:
Bloc VCO3340 + switches de sélection de forme d'onde
Values for R?S_411 depend on the level of the signal we wanna have at V2164's output.
C2_SYNC protège l'entrée soft sync contre le bruit
FM lin non utilisée
SAW is the only active output when nothing is plugged from the STM32.

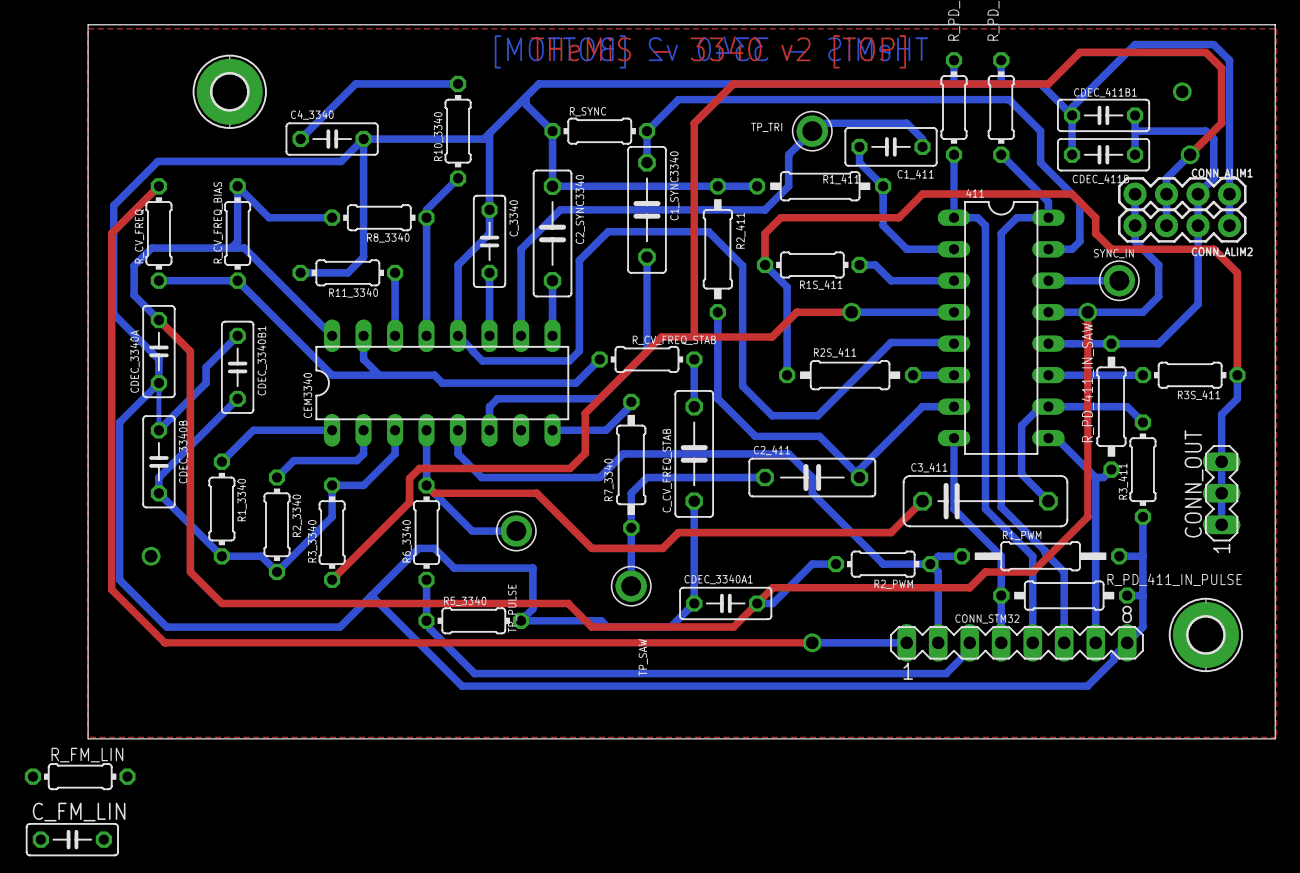
[picture p256: board VCO3340 v2.1.brd from above]

Board: 2 copper layers, 95.8 x 57.6 mm, 53 parts (0 on the bottom side), 36 nets.
