reynal/themis/analog-modules/Output stage/output stage v1.brd

## EAGLE design analog-modules/Output stage/output stage v1.brd (2019-10-07)

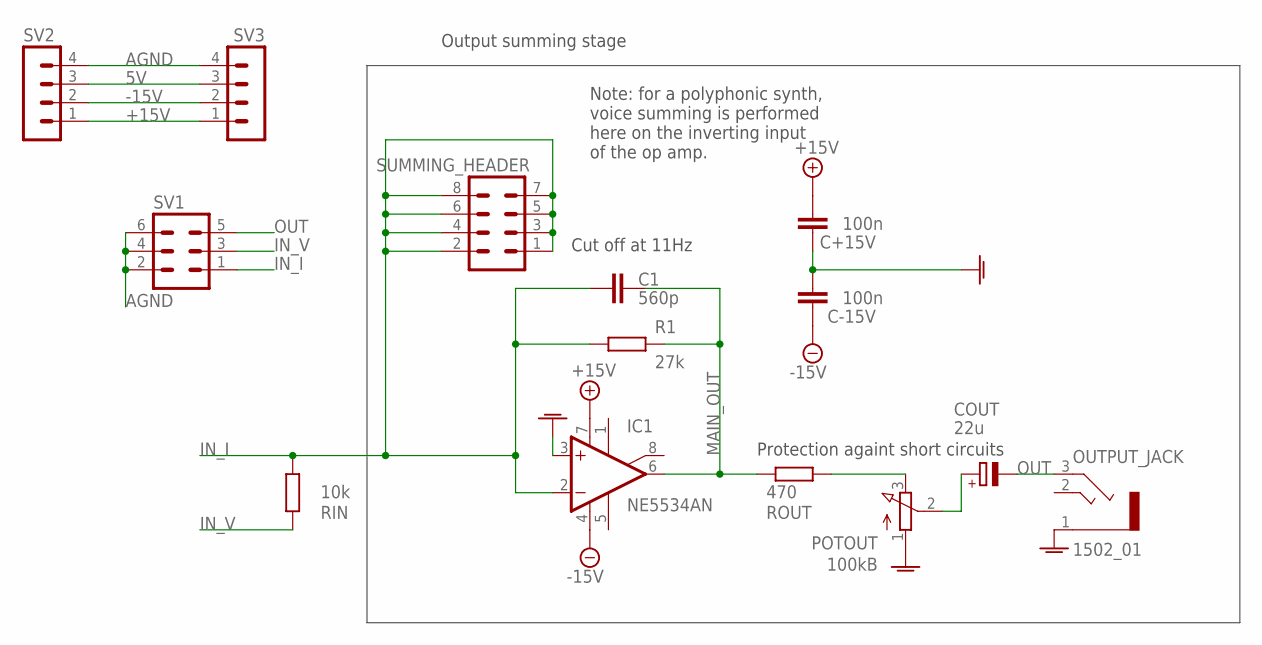
[picture p257: schematic output stage v1.sch]

Parts:
C1: 560p; C075-032X103
C+15V: 100n; C075-032X103
C-15V: 100n; C075-032X103
COUT: 22u; B45181A
IC1: NE5534AN; DIL08
OUTPUT_JACK: 1502_01
POTOUT: 100kB; 3RP/1610N
R1: 27k; 0207/10
RIN: 10k; 0207/10
ROUT: 470; 0207/12
SUMMING_HEADER: MA04-2
SV1: MA03-2
SV2, SV3: MA04-1

Connections:
5V: SV2.3, SV3.3
+15V: C+15V.2, IC1.7 (V+), SV2.1, SV3.1
-15V: C-15V.1, IC1.4 (V-), SV2.2, SV3.2
AGND: C+15V.1, C-15V.2, IC1.3 (+IN), OUTPUT_JACK.1, POTOUT.1 (A), SV1.2, SV1.4, SV1.6, SV2.4, SV3.4
IN_I: C1.2, IC1.2 (-IN), R1.2, RIN.1, SUMMING_HEADER.1, SUMMING_HEADER.2, SUMMING_HEADER.3, SUMMING_HEADER.4, SUMMING_HEADER.5, SUMMING_HEADER.6, SUMMING_HEADER.7, SUMMING_HEADER.8, SV1.1
IN_V: RIN.2, SV1.3
MAIN_OUT: C1.1, IC1.6 (OUT), R1.1, ROUT.2
unnamed: COUT.+, POTOUT.2 (S)
unnamed: POTOUT.3 (E), ROUT.1
OUT: COUT.-, OUTPUT_JACK.3 (2), SV1.5

Notes on the sheet:
Note: for a polyphonic synth, voice summing is performed here on the inverting input of the op amp.
Output summing stage
Cut off at 11Hz
Protection againt short circuits

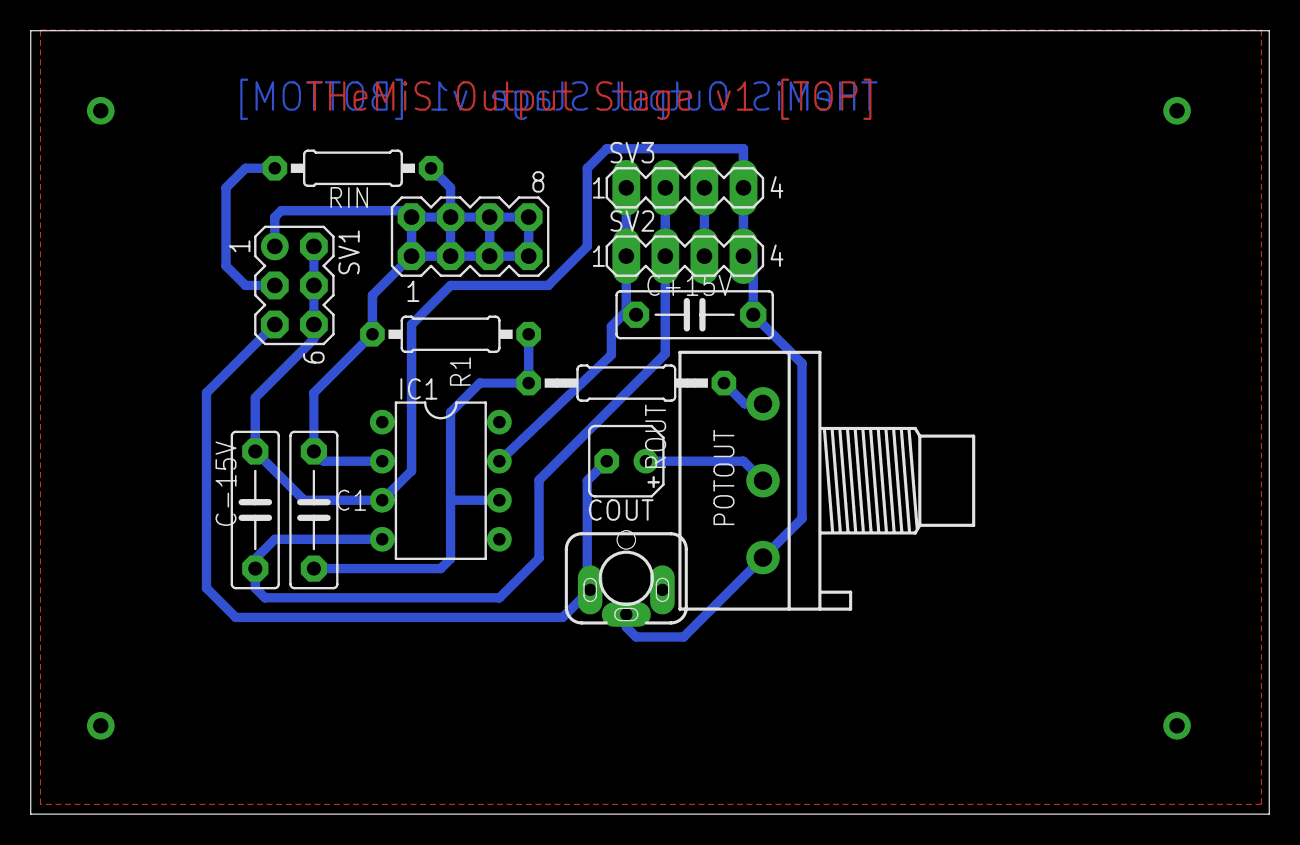
[picture p258: board output stage v1.brd from above]

Board: 2 copper layers, 80.6 x 50.9 mm, 14 parts (0 on the bottom side), 10 nets.
