reynal/themis/analog-modules/Output stage/output stage and VCA v2.brd

## EAGLE design analog-modules/Output stage/output stage and VCA v2.brd (2020-03-03)

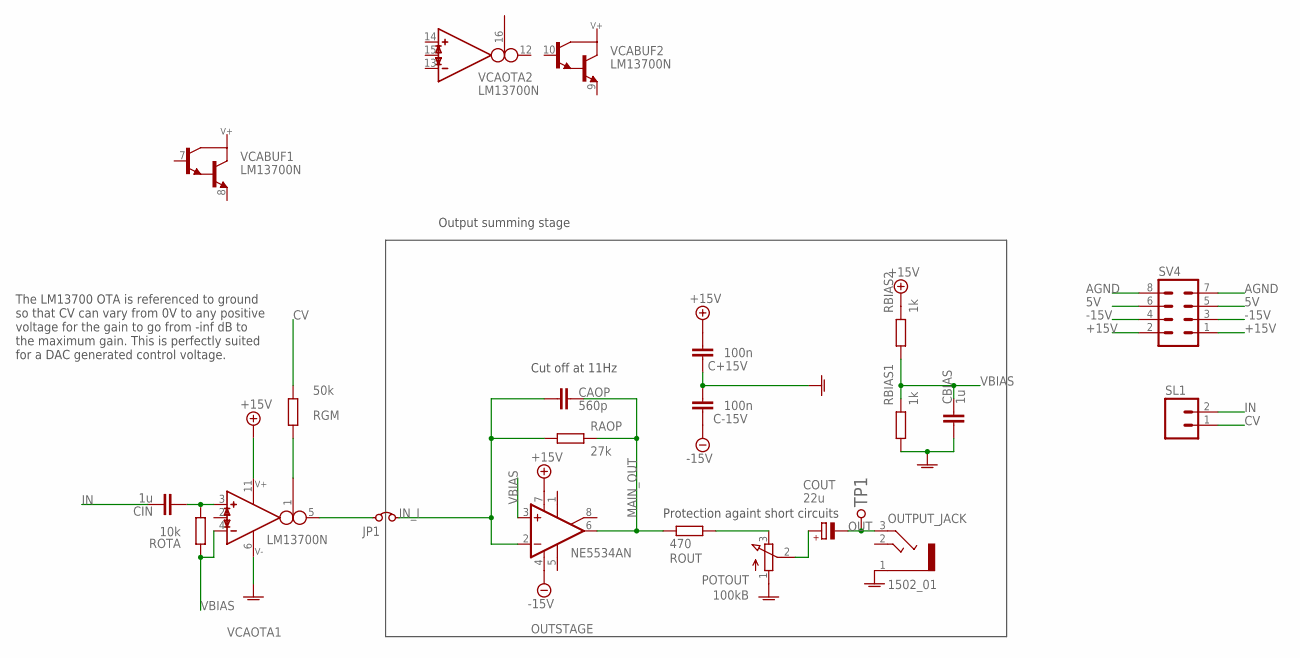
[picture p259: schematic output stage and VCA v2.sch]

Parts:
C+15V: 100n; C050-030X075
C-15V: 100n; C050-030X075
CAOP: 560p; C050-030X075
CBIAS: 1u; C050-030X075
CIN: 1u; C050-030X075
COUT: 22u; B45181B
JP1: JUMPER; HDR2X1
OUTPUT_JACK: 1502_01
OUTSTAGE: NE5534AN; DIL08
POTOUT: 100kB; 3RP/1610N
RAOP: 27k; 0204/7
RBIAS1, RBIAS2: 1k; 0204/7
RGM: 50k; 0204/7
ROTA: 10k; 0204/7
ROUT: 470; 0204/7
SL1: MA02; 02PA
SV4: MA04-2
TP1: TESTPOINT; TESTPOINT_63
VCA: LM13700N; DIL16

Connections:
5V: SV4.5, SV4.6
+15V: C+15V.2, OUTSTAGE.7 (V+), RBIAS2.1, SV4.1, SV4.2, VCA.11 (V+)
-15V: C-15V.1, OUTSTAGE.4 (V-), SV4.3, SV4.4
AGND: C+15V.1, C-15V.2, CBIAS.2, OUTPUT_JACK.1, POTOUT.1 (A), RBIAS1.2, SV4.7, SV4.8, VCA.6 (V-)
CV: RGM.1, SL1.1
IN: CIN.1, SL1.2
IN_I: CAOP.2, JP1.2, OUTSTAGE.2 (-IN), RAOP.2
MAIN_OUT: CAOP.1, OUTSTAGE.6 (OUT), RAOP.1, ROUT.2
unnamed: JP1.1, VCA.5 (OUT)
unnamed: RGM.2, VCA.1 (I_BIAS)
unnamed: CIN.2, ROTA.1, VCA.3 (IN_P)
unnamed: COUT.+, POTOUT.2 (S)
unnamed: POTOUT.3 (E), ROUT.1
OUT: COUT.-, OUTPUT_JACK.3 (2), TP1.P$1
VBIAS: CBIAS.1, OUTSTAGE.3 (+IN), RBIAS1.1, RBIAS2.2, ROTA.2, VCA.4 (IN_N)

Notes on the sheet:
Output summing stage
Cut off at 11Hz
Protection againt short circuits
The LM13700 OTA is referenced to ground so that CV can vary from 0V to any positive voltage for the gain to go from -inf dB to the maximum gain. This is perfectly suited for a DAC generated control voltage.

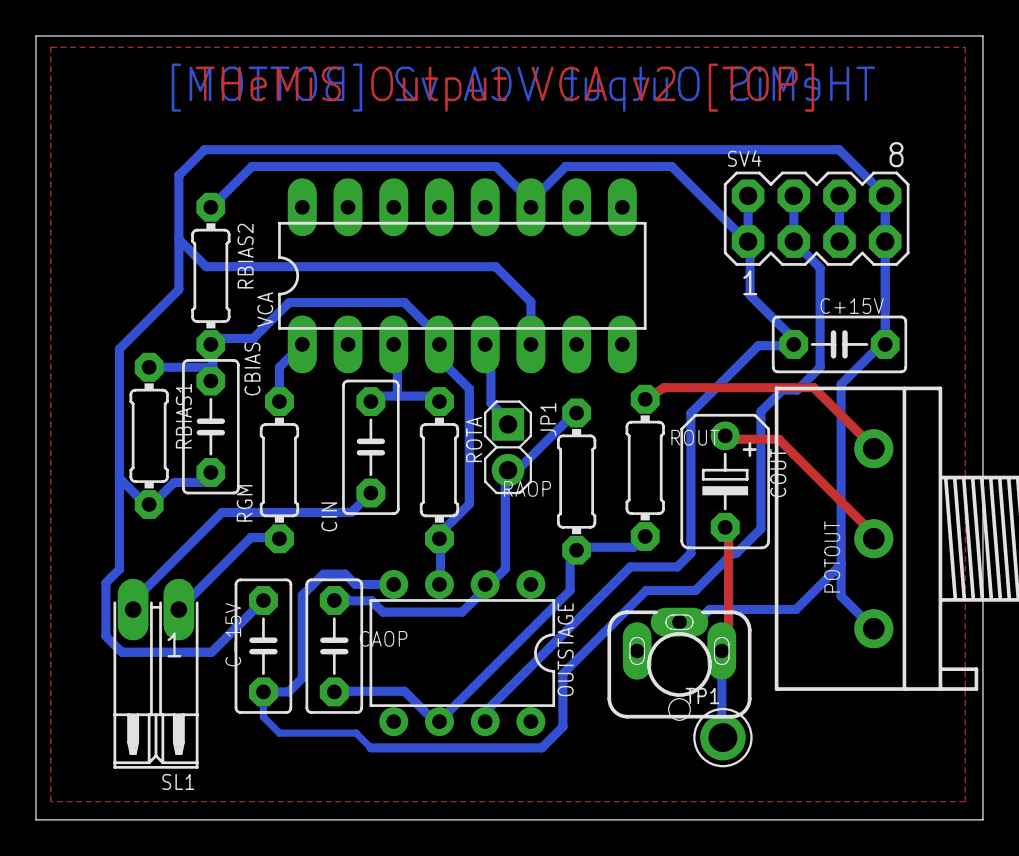
[picture p260: board output stage and VCA v2.brd from above]

Board: 2 copper layers, 52.6 x 43.5 mm, 20 parts (0 on the bottom side), 15 nets.
