reynal/themis/front-pane/themis-front-v3-stm32f446/Core/Src/main.cpp

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
/* Includes ------------------------------------------------------------------*/
#include "main.h"

/* USER CODE BEGIN Includes */
#include "stdio.h"
#include "string.h"
#include "front-panel.h"

/* USER CODE END Includes */

ADC_HandleTypeDef hadc1;

I2C_HandleTypeDef hi2c1;
I2C_HandleTypeDef hi2c2;
I2C_HandleTypeDef hi2c3;

SPI_HandleTypeDef hspi1;
SPI_HandleTypeDef hspi2;
SPI_HandleTypeDef hspi3;
DMA_HandleTypeDef hdma_spi1_tx;
DMA_HandleTypeDef hdma_spi2_tx;
DMA_HandleTypeDef hdma_spi3_tx;

TIM_HandleTypeDef htim3;

UART_HandleTypeDef huart4;
UART_HandleTypeDef huart1;
DMA_HandleTypeDef hdma_usart1_tx;

void SystemClock_Config(void);
static void MX_GPIO_Init(void);
static void MX_I2C1_Init(void);
static void MX_I2C2_Init(void);
static void MX_I2C3_Init(void);
static void MX_SPI1_Init(void);
static void MX_TIM3_Init(void);
static void MX_USART1_UART_Init(void);
static void MX_ADC1_Init(void);
static void MX_SPI2_Init(void);
static void MX_SPI3_Init(void);
static void MX_UART4_Init(void);
static void MX_DMA_Init(void);
/**
  * @brief  The application entry point.
  * @retval int
  */
int main(void)
{
  /* MCU Configuration--------------------------------------------------------*/

  /* Reset of all peripherals, Initializes the Flash interface and the Systick. */
  HAL_Init();

  /* Configure the system clock */
  SystemClock_Config();

  /* USER CODE BEGIN SysInit */

  /*
   * !!! SUPER CRUCIAL : here's the bug fix if DMA not working !!!!
   * For unclear reasons CubeMX generates a buggy code with MX_DMA_Init() at the end
   * So the workaround is simply to edit the code below and move MX_DMA_Init() to the first line
   */

  /* USER CODE END SysInit */

  /* Initialize all configured peripherals */
  MX_DMA_Init();
  MX_GPIO_Init();
  MX_I2C1_Init();
  MX_I2C2_Init();
  MX_I2C3_Init();
  MX_SPI1_Init();
  MX_TIM3_Init();
  MX_USART1_UART_Init();
  MX_ADC1_Init();
  MX_SPI2_Init();
  MX_SPI3_Init();
  MX_UART4_Init();
  /* USER CODE BEGIN 2 */

  HAL_TIM_Base_Start_IT(&htim3); // needed so that HAL_TIM_PeriodElapsedCallback() gets called, see callbacks.c
  HAL_TIM_PWM_Start_IT(&htim3, TIM_CHANNEL_1);
  htim3.Instance->CCR1 = 255;

  init_hardware();
  main_loop();

  /* USER CODE END 2 */

  /* Infinite loop */
  /* USER CODE BEGIN WHILE */

  while (1)
  {
    /* USER CODE END WHILE */

    /* USER CODE BEGIN 3 */

	  HAL_Delay(500);
  }
  /* USER CODE END 3 */
}

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
/* USER CODE BEGIN 4 */

void HAL_SPI_TxCpltCallback(SPI_HandleTypeDef *hspi){

	HAL_GPIO_TogglePin(GPIOA, U2_TX_Pin);
}

void HAL_SPI_TxHalfCpltCallback(SPI_HandleTypeDef *hspi){

	//HAL_GPIO_WritePin(GPIOA, U2_TX_Pin, GPIO_PIN_RESET);
	printf("HAL_SPI_TxHalfCpltCallback !\n");
}

void HAL_SPI_ErrorCallback(SPI_HandleTypeDef *hspi){

	printf("HAL_SPI_ErrorCallback !\n");
}



/* USER CODE END 4 */
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
