reynal/themis/front-pane/themis-front-v3-stm32f446/themis-front-v3-stm32f446.ioc

Mcu.UserName=STM32F446RCTx
PA0-WKUP.Signal=UART4_TX
PA1.Signal=ADCx_IN1
PA10.GPIO_Label=MCP_001_INTB
PA10.Signal=GPXTI10
PA11.GPIO_Label=MCP_000_INTB
PA11.Signal=GPXTI11
PA12.GPIO_Label=MCP_000_INTA
PA12.Signal=GPXTI12
PA13.Signal=SYS_JTMS-SWDIO
PA14.Signal=SYS_JTCK-SWCLK
PA2.GPIO_Label=U2_TX
PA2.Signal=GPIO_Output
PA3.GPIO_Label=U2_RX
PA3.Signal=GPIO_Output
PA4.Signal=ADCx_IN4
PA5.Signal=SPI1_SCK
PA6.Signal=S_TIM3_CH1
PA7.Signal=SPI1_MOSI
PA8.Signal=I2C3_SCL
PA9.GPIO_Label=MCP_001_INTA
PA9.Signal=GPXTI9
PB0.Signal=SPI3_MOSI
PB1.GPIO_Label=MCP_011_INTB
PB1.Signal=GPXTI1
PB10.Signal=I2C2_SCL
PB13.Signal=SPI2_SCK
PB14.GPIO_Label=MCP_011_INTA
PB14.Signal=GPXTI14
PB15.GPIO_Label=MCP_100_INTA
PB15.Signal=GPXTI15
PB3.GPIO_Label=MCP_RST
PB3.Signal=GPIO_Output
PB6.Signal=USART1_TX
PB7.Signal=USART1_RX
PB8.Signal=I2C1_SCL
PB9.Signal=I2C1_SDA
PC0.Signal=ADCx_IN10
PC1.Signal=SPI2_MOSI
PC10.Signal=SPI3_SCK
PC11.Signal=UART4_RX
PC12.Signal=I2C2_SDA
PC13.GPIO_Label=MCP_101_INTA
PC13.Signal=GPXTI13
PC2.GPIO_Label=MCP_110_INTB
PC2.Signal=GPXTI2
PC3.GPIO_Label=MCP_110_INTA
PC3.Signal=GPXTI3
PC4.GPIO_Label=MCP_111_INTA
PC4.Signal=GPXTI4
PC5.GPIO_Label=MCP_111_INTB
PC5.Signal=GPXTI5
PC6.GPIO_Label=MCP_100_INTB
PC6.Signal=GPXTI6
PC7.GPIO_Label=MCP_010_INTA
PC7.Signal=GPXTI7
PC8.GPIO_Label=MCP_010_INTB
PC8.Signal=GPXTI8
PC9.Signal=I2C3_SDA
PH0-OSC_IN.GPIO_Label=MCP_101_INTB
PH0-OSC_IN.Signal=GPXTI0
