reynal/themis/front-pane/RPi/src/controller/component/PushButton.java

package controller.component;

import java.io.IOException;
import java.util.logging.Logger;

import com.pi4j.io.gpio.*;

import controller.event.*;
import device.MCP23017;
import device.MCP23017.DeviceAddress;
import device.MCP23017.InterruptEvent;
import device.MCP23017.InterruptListener;

/**
 * a class that represents a push button on the front pane
 * 
 * @author SR
 *
 */
public class PushButton extends Control {

	private static final Logger LOGGER = Logger.getLogger("confLogger");
	
	private MCP23017.Pin buttonPin; 
	
	/**
	 * construct a pushbutton with a UI label that is connected to the given pin of the given MCP23017 device and port
	 * @param label the UI label of the button ; may be used for a UI simulator
	 * @param mcpDevice the MCP23017 device this button is connected to
	 * @param gpio the pin of the device this button is connected to
	 * @throws IOException 
	 */
	public PushButton(String label, MCP23017 mcpDevice, MCP23017.Pin gpio) throws IOException {
		super(label + "[" + gpio + "]");
		if (mcpDevice != null) {
			this.buttonPin = gpio;
			mcpDevice.enableIntPinsMirror(); // make sure intA and intB are connected
			mcpDevice.setInput(gpio); 
			mcpDevice.enablePullupResistor(gpio); // pull up enabled
			mcpDevice.enableInterruptOnChange(gpio); // enables GPIO input pin for interrupt-on-change
			mcpDevice.addInterruptListener(new PhysicalButtonChangeListener());
		}
		//else LOGGER.warning("No MCP23017 registered for " + toString() +" -> simulator mode only");

	}

	/**
	 * construct a pushbutton with the given UI label
	 */
	public PushButton(String label) {
		super(label);
	}

	/**
	 * Adds the specified listener to receive action events from this button.
	 * 
	 * @param l the listener
	 */
	public void addActionListener(PushButtonActionListener l) {
		listenerList.add(PushButtonActionListener.class, l);
	}

	/**
	 * Removes the specified listener so that it no longer receives action events
	 * from this button.
	 * 
	 * @param l
	 *            the listener that was previously added
	 */
	public void removeActionListener(PushButtonActionListener l) {
		listenerList.remove(PushButtonActionListener.class, l);
	}

	/**
	 * Notify all listeners that have registered interest for notification on this
	 * event type. The event instance is lazily created using the parameters passed
	 * into the fire method.
	 *
	 */
	public void fireActionEvent(PushButtonState state) { // note SR : should be protected, but we have to make it public cause SwingMain uses it in simulator mode

		// Guaranteed to return a non-null array
		Object[] listeners = listenerList.getListenerList();

		// Process the listeners last to first, notifying
		// those that are interested in this event
		PushButtonActionEvent e = null;
		for (int i = listeners.length - 2; i >= 0; i -= 2) {
			if (listeners[i] == PushButtonActionListener.class) {
				// Lazily create the event:
				if (e == null)
					e = new PushButtonActionEvent(this, state);
				((PushButtonActionListener) listeners[i + 1]).actionPerformed(e); 
			}
		}
	}

	 /**
	  * Listens to changes event coming from a physical button through the MCP23017 GPIO expander
	  * @author sydxrey
	  */
	 private class PhysicalButtonChangeListener implements InterruptListener {
		 
		@Override
		public void interruptOccured(InterruptEvent event) {

			if (event.getPin() == buttonPin) {
				//System.out.println(event);
				fireActionEvent(event.getLevel() == PinState.HIGH ? PushButtonState.RELEASED : PushButtonState.PRESSED);
			}
			
		}	 
	 }	
	 
	 // ---------------- test --------------
	 
		public static void main(String[] args) throws Exception  {

			MCP23017 device1 = new MCP23017(DeviceAddress.ADR_001, RaspiPin.GPIO_05); // panneau gauche (vert)
			MCP23017 device2 = new MCP23017(DeviceAddress.ADR_000, RaspiPin.GPIO_04); // panneau droit (rouge)

			device1.registerRpiPinForReset(MCP23017.DEFAULT_RST_PIN);
			device1.reset(); // actually reset both MCP23017 #1 and #2
			device1.printRegisters();
			device2.printRegisters();
			
			PushButton pb;
			
			// device1 :
			pb = new PushButton("Push 1:P4A", device1, MCP23017.Pin.P4A);
			pb.addActionListener(e -> System.out.println(e));
			
			pb = new PushButton("Push 1:P7A", device1, MCP23017.Pin.P7A);
			pb.addActionListener(e -> System.out.println(e));

			pb = new PushButton("Push 1:P0B", device1, MCP23017.Pin.P0B);
			pb.addActionListener(e -> System.out.println(e));

			pb = new PushButton("Push 1:P3B", device1, MCP23017.Pin.P3B);
			pb.addActionListener(e -> System.out.println(e));
			
			// device2:
			pb = new PushButton("Push 2:P4A", device2, MCP23017.Pin.P4A);
			pb.addActionListener(e -> System.out.println(e));
			
			pb = new PushButton("Push 2:P7A", device2, MCP23017.Pin.P7A);
			pb.addActionListener(e -> System.out.println(e));

			pb = new PushButton("Push 2:P0B", device2, MCP23017.Pin.P0B);
			pb.addActionListener(e -> System.out.println(e));

			pb = new PushButton("Push 2:P3B", device2, MCP23017.Pin.P3B);
			pb.addActionListener(e -> System.out.println(e));

			int i=0;
			while ((i++)<100) {
				System.out.print(".");
				Thread.sleep(1000);
			}
			System.out.println("closing device");
			device1.close();
		}	 
}
