reynal/themis/front-pane/RPi/src/application/ModuleFactory.java

package application;

import static model.MidiCCImplementation.DETUNE_13700;
import static model.MidiCCImplementation.DETUNE_3340A;
import static model.MidiCCImplementation.DETUNE_3340B;
import static model.MidiCCImplementation.LEVEL_3340A;
import static model.MidiCCImplementation.LEVEL_PULSE_3340B;
import static model.MidiCCImplementation.LEVEL_SAW_3340B;
import static model.MidiCCImplementation.LEVEL_SQU_13700;
import static model.MidiCCImplementation.LEVEL_TRI_13700;
import static model.MidiCCImplementation.LEVEL_TRI_3340B;
import static model.MidiCCImplementation.OCTAVE_13700;
import static model.MidiCCImplementation.OCTAVE_3340A;
import static model.MidiCCImplementation.OCTAVE_3340B;
import static model.MidiCCImplementation.PWM_3340A;
import static model.MidiCCImplementation.PWM_3340B;
import static model.MidiCCImplementation.SYNC_3340A;
import static model.MidiCCImplementation.VCA_ATTACK;
import static model.MidiCCImplementation.VCA_DECAY;
import static model.MidiCCImplementation.VCA_RELEASE;
import static model.MidiCCImplementation.VCA_SUSTAIN;
import static model.MidiCCImplementation.VCA_VELOCITY_SENSITIVITY;
import static model.MidiCCImplementation.VCF_ATTACK;
import static model.MidiCCImplementation.VCF_CUTOFF;
import static model.MidiCCImplementation.VCF_DECAY;
import static model.MidiCCImplementation.VCF_EG;
import static model.MidiCCImplementation.VCF_KBDTRACKING;
import static model.MidiCCImplementation.VCF_ORDER;
import static model.MidiCCImplementation.VCF_RELEASE;
import static model.MidiCCImplementation.VCF_RESONANCE;
import static model.MidiCCImplementation.VCF_SUSTAIN;
import static model.MidiCCImplementation.VCF_VELOCITY_SENSITIVITY;
import static model.MidiCCImplementation.*;

import java.util.ArrayList;
import java.util.HashMap;
import java.util.List;
import java.util.logging.Logger;

import model.MidiCCImplementation;
import model.ModuleParameter;
import model.VcaModule;
import model.VcfModule;
import model.Vco13700Module;
import model.Vco3340AModule;
import model.Vco3340BModule;
import model.serial.AbstractSerialTransmitter;

/**
 * This class is responsible for creating all the sound modules that represent
 * a real hardware implementation of the Themis synthetizer. It is also
 * responsible for constructing tables that map Midi CC codes to module parameters
 * and back.
 * 
 * This is implemented as a singleton.
 * 
 * @author bastien
 * @author reynal
 *
 */
public class ModuleFactory {
	
	private static final Logger LOGGER = Logger.getLogger("confLogger");
	
	private HashMap<ModuleParameter<?>, MidiCCImplementation> midiCcIdTable;
	private ModuleParameter<?>[] midiCCToModuleParameter;
	
	private Vco3340AModule vco3340A;
	private Vco3340BModule vco3340B;
	private Vco13700Module vco13700;
	private VcaModule vca;
	private VcfModule vcf;
	

	// --------------------- singleton ---------------------
	
	private static ModuleFactory modules =  null;
	
	public static ModuleFactory getDefault() {
		// lazily creates factory:
		if (modules == null)
			modules = new ModuleFactory();
		return modules;
	}
	
	// --------------------- constructor ---------------------
	
	private ModuleFactory(){
		
		vco3340A = new Vco3340AModule();
		vco3340B = new Vco3340BModule();
		vco13700 = new Vco13700Module();
		vca = new VcaModule();
		vcf = new VcfModule();
		
		initMidiCCHashMap();
		initMidiCCToModuleParameterTable();
		

		
	}
	
	// --------------------- module getters ---------------------
	
	public Vco3340AModule getVco3340A() {
		return vco3340A;
	}

	public Vco3340BModule getVco3340B() {
		return vco3340B;
	}

	public Vco13700Module getVco13700() {
		return vco13700;
	}

	public VcaModule getVca() {
		return vca;
	}

	public VcfModule getVcf() {
		return vcf;
	}
	
	/**
	 * @return a list containing all the module parameters handled by this factory.
	 */
	public List<ModuleParameter<?>> getAllModuleParameters(){
		
		ArrayList<ModuleParameter<?>> list = new ArrayList<ModuleParameter<?>>();
		
		list.addAll(getVco3340A().getParameters());
		list.addAll(getVco3340B().getParameters());
		list.addAll(getVco13700().getParameters());
		list.addAll(getVca().getParameters());
		list.addAll(getVcf().getParameters());
		
		return list;
	}
	
	
	
	// ------------------- other methods --------------
	
	/**
	 * @return the Midi CC code for the given parameter, if it's in the table.
	 * Otherwise return -1.
	 */
	public int getMidiCC(ModuleParameter<?> p) {
		MidiCCImplementation midiCC = midiCcIdTable.get(p);
		if (midiCC != null) return midiCC.getCode();
		else return -1;
	}
	
	public ModuleParameter<?> getModuleParameter(int midiCC){
		return midiCCToModuleParameter[midiCC];
	}
	
	/**
	 * Attach the given AbstractSerialTransmitter as a listener to changes in this module parameters.
	 * @param serialTransmitter
	 */
	public void attachSerialTransmitter(AbstractSerialTransmitter serialTransmitter) {
		
		for (ModuleParameter<?> parameter : getAllModuleParameters()) {
			
			parameter.addChangeListener(serialTransmitter);
		}
		
	}
	
	
	// --------------------- private methods ---------------------
	
	/**
	 * Init the MIDI parameter ID table that maps a module parameter to a MIDI CC code.
	 * (used for example by a serial transmitter when writing to the STM32 over the serial bus)
	 */
	private void initMidiCCHashMap(){
		
		midiCcIdTable =  new HashMap<ModuleParameter<?>, MidiCCImplementation> ();
		
		// 3340A
		midiCcIdTable.put(getVco3340A().getDetuneParameter(), DETUNE_3340A); 
		midiCcIdTable.put(getVco3340A().getOctaveParameter(), OCTAVE_3340A);
		midiCcIdTable.put(getVco3340A().getSyncFrom13700Parameter(), SYNC_3340A);
		midiCcIdTable.put(getVco3340A().getWaveShapeParameter(), WAVE_3340A);
		midiCcIdTable.put(getVco3340A().getDutyParameter(), PWM_3340A);
		midiCcIdTable.put(getVco3340A().getLevelParameter(), LEVEL_3340A);
		midiCcIdTable.put(getVco3340A().getSemitonesParameter(), SEMITONES_3340A);

		// 3340B
		midiCcIdTable.put(getVco3340B().getDetuneParameter(), DETUNE_3340B); 
		midiCcIdTable.put(getVco3340B().getOctaveParameter(), OCTAVE_3340B);
		midiCcIdTable.put(getVco3340B().getTriLevelParameter(), LEVEL_TRI_3340B);
		midiCcIdTable.put(getVco3340B().getPulseLevelParameter(), LEVEL_PULSE_3340B);
		midiCcIdTable.put(getVco3340B().getSawLevelParameter(), LEVEL_SAW_3340B);
		midiCcIdTable.put(getVco3340B().getDutyParameter(), PWM_3340B);
		midiCcIdTable.put(getVco3340B().getSemitonesParameter(), SEMITONES_3340B);

		// 13700
		midiCcIdTable.put(getVco13700().getDetuneParameter(), DETUNE_13700);
		midiCcIdTable.put(getVco13700().getOctaveParameter(), OCTAVE_13700);
		midiCcIdTable.put(getVco13700().getTriLevelParameter(), LEVEL_TRI_13700);
		midiCcIdTable.put(getVco13700().getSquLevelParameter(), LEVEL_SQU_13700);
		midiCcIdTable.put(getVco13700().getSemitonesParameter(), SEMITONES_13700);

		// 3320 vcf
		midiCcIdTable.put(getVcf().getCutoffParameter(), VCF_CUTOFF);
		midiCcIdTable.put(getVcf().getResonanceParameter(), VCF_RESONANCE);
		midiCcIdTable.put(getVcf().getFilterOrderParameter(), VCF_ORDER);
		midiCcIdTable.put(getVcf().getKbdTrackingParameter(), VCF_KBDTRACKING);
		midiCcIdTable.put(getVcf().getEgDepthParameter(), VCF_EG);
		midiCcIdTable.put(getVcf().getVelocitySensitivityParameter(), VCF_VELOCITY_SENSITIVITY);
		midiCcIdTable.put(getVcf().getAdsrEnveloppe().getAttackMsParameter(), VCF_ATTACK);
		midiCcIdTable.put(getVcf().getAdsrEnveloppe().getDecayMsParameter(), VCF_DECAY);
		midiCcIdTable.put(getVcf().getAdsrEnveloppe().getSustainLevelParameter(), VCF_SUSTAIN);
		midiCcIdTable.put(getVcf().getAdsrEnveloppe().getReleaseMsParameter(), VCF_RELEASE);

		// VCA
		midiCcIdTable.put(getVca().getVelocitySensitivityParameter(), VCA_VELOCITY_SENSITIVITY);
		midiCcIdTable.put(getVca().getAdsrEnveloppe().getAttackMsParameter(), VCA_ATTACK);
		midiCcIdTable.put(getVca().getAdsrEnveloppe().getDecayMsParameter(), VCA_DECAY);
		midiCcIdTable.put(getVca().getAdsrEnveloppe().getSustainLevelParameter(), VCA_SUSTAIN);
		midiCcIdTable.put(getVca().getAdsrEnveloppe().getReleaseMsParameter(), VCA_RELEASE);
		
		LOGGER.info("midiCcIdTable initialized");
	}
	
	/* init the reverse map, i.e., a table that maps a Midi CC code to a module parameter */
	private void initMidiCCToModuleParameterTable(){
		
		midiCCToModuleParameter =  new ModuleParameter[128];
		
		// 3340A
		midiCCToModuleParameter[DETUNE_3340A.getCode()]	= getVco3340A().getDetuneParameter(); 
		midiCCToModuleParameter[OCTAVE_3340A.getCode()]	= getVco3340A().getOctaveParameter();
		midiCCToModuleParameter[SYNC_3340A.getCode()]	= getVco3340A().getSyncFrom13700Parameter();
		midiCCToModuleParameter[WAVE_3340A.getCode()]	= getVco3340A().getWaveShapeParameter();
		midiCCToModuleParameter[PWM_3340A.getCode()]	= getVco3340A().getDutyParameter();

		// 3340B
		midiCCToModuleParameter[DETUNE_3340B.getCode()]	= getVco3340B().getDetuneParameter(); 
		midiCCToModuleParameter[OCTAVE_3340B.getCode()]	= getVco3340B().getOctaveParameter();
		midiCCToModuleParameter[LEVEL_TRI_3340B.getCode()]	= getVco3340B().getTriLevelParameter();
		midiCCToModuleParameter[LEVEL_SAW_3340B.getCode()]	= getVco3340B().getSawLevelParameter();
		midiCCToModuleParameter[LEVEL_PULSE_3340B.getCode()]= getVco3340B().getPulseLevelParameter();
		midiCCToModuleParameter[PWM_3340B.getCode()]	= getVco3340B().getDutyParameter();

		// 13700
		midiCCToModuleParameter[DETUNE_13700.getCode()]	= getVco13700().getDetuneParameter();
		midiCCToModuleParameter[OCTAVE_13700.getCode()]	= getVco13700().getOctaveParameter();
		midiCCToModuleParameter[LEVEL_TRI_13700.getCode()]	= getVco13700().getTriLevelParameter();
		midiCCToModuleParameter[LEVEL_SQU_13700.getCode()]= getVco13700().getSquLevelParameter();

		// 3320 vcf
		midiCCToModuleParameter[VCF_CUTOFF.getCode()]	= getVcf().getCutoffParameter();
		midiCCToModuleParameter[VCF_RESONANCE.getCode()]= getVcf().getResonanceParameter();
		midiCCToModuleParameter[VCF_ORDER.getCode()]	= getVcf().getFilterOrderParameter();
		midiCCToModuleParameter[VCF_KBDTRACKING.getCode()]=getVcf().getKbdTrackingParameter();
		midiCCToModuleParameter[VCF_EG.getCode()]		= getVcf().getEgDepthParameter();
		midiCCToModuleParameter[VCF_VELOCITY_SENSITIVITY.getCode()]=getVcf().getVelocitySensitivityParameter();
		midiCCToModuleParameter[VCF_ATTACK.getCode()]	= getVcf().getAdsrEnveloppe().getAttackMsParameter();
		midiCCToModuleParameter[VCF_DECAY.getCode()]	= getVcf().getAdsrEnveloppe().getDecayMsParameter();
		midiCCToModuleParameter[VCF_SUSTAIN.getCode()]	= getVcf().getAdsrEnveloppe().getSustainLevelParameter();
		midiCCToModuleParameter[VCF_RELEASE.getCode()]	= getVcf().getAdsrEnveloppe().getReleaseMsParameter();

		// VCA
		midiCCToModuleParameter[VCA_VELOCITY_SENSITIVITY.getCode()]=getVca().getVelocitySensitivityParameter();
		midiCCToModuleParameter[VCA_ATTACK.getCode()]=getVca().getAdsrEnveloppe().getAttackMsParameter();
		midiCCToModuleParameter[VCA_DECAY.getCode()]=getVca().getAdsrEnveloppe().getDecayMsParameter();
		midiCCToModuleParameter[VCA_SUSTAIN.getCode()]=getVca().getAdsrEnveloppe().getSustainLevelParameter();
		midiCCToModuleParameter[VCA_RELEASE.getCode()]=getVca().getAdsrEnveloppe().getReleaseMsParameter();
		
		LOGGER.info("midiCCToModuleParameter initialized");
	}
			
}
