reynal/themis/front-pane/themis-front-v3-stm32f446/Core/Inc/front-panel.h

/*
 * front-panel.h
 *
 *  Created on: Dec 22, 2021
 *      Author: sydxrey
 */

#ifndef INC_FRONT_PANEL_H_
#define INC_FRONT_PANEL_H_

#define SOUTH_BOARD_CONNECTED

void init_hardware();
void main_loop();
void asyncUpdateLeds();


#endif /* INC_FRONT_PANEL_H_ */
