reynal/themis/front-pane/themis-front-v3-stm32f446/Core/Inc/callback.h

/*
 * callback.h
 *
 *  Created on: Mar 6, 2022
 *      Author: sydxrey
 */

#ifndef INC_CALLBACK_H_
#define INC_CALLBACK_H_

#ifdef __cplusplus
extern "C" {
#endif

void GPIO_EXTI0_Callback();
void GPIO_EXTI1_Callback();
void GPIO_EXTI2_Callback();
void GPIO_EXTI3_Callback();
void GPIO_EXTI4_Callback();
void GPIO_EXTI5_Callback();
void GPIO_EXTI6_Callback();
void GPIO_EXTI7_Callback();
void GPIO_EXTI8_Callback();
void GPIO_EXTI9_Callback();
void GPIO_EXTI10_Callback();
void GPIO_EXTI11_Callback();
void GPIO_EXTI12_Callback();
void GPIO_EXTI13_Callback();
void GPIO_EXTI14_Callback();
void GPIO_EXTI15_Callback();

#ifdef __cplusplus
}
#endif

#endif /* INC_CALLBACK_H_ */
