reynal/themis/front-pane/themis-front-v3-stm32f446/Core/Inc/print.h

/*
 * print.h
 *
 *  Created on: Nov 18, 2020
 *      Author: sydxrey
 */

#ifndef INC_PRINT_H_
#define INC_PRINT_H_

#include "stm32f4xx_hal.h"

extern "C" void printSerial();
//void printSerial();
//void sendMidiMessage(uint8_t status, uint8_t cc, uint8_t val);

#endif /* INC_PRINT_H_ */
