reynal/themis/(commit log)

2018-12-03 Started implementation of IS31FL3731 device
2019-01-28 Added SPI transmitter
2019-01-30 SPI transmitter improvement
2019-01-31 MIDI Implementation + transmission over SPI to STM32
2019-02-09 Reorganized view package + created device package + cleaned physical encoder code
2019-03-12 Adding views backgrounds and fixing view.touchscreen interface
    [Main.java]
2019-03-27 Improved SPI architecture
2019-03-28 Splitted frames
2019-04-09 first import F767 source code
    [dac-board-F767ZI Run.cfg]
2019-04-12 Initial upload of STM32F676ZI code
2019-04-12 Added spreadsheet showing how pins are used on the STM32F767ZI
    [dac-board-F767ZI-used-pins.ods]
2019-04-16 added utilities folder and serial term emulation for MIDI debugging and printf console
2019-04-19 Upgraded STM32 code to STM32CubeMX 5.1.0
    [dac-board-F767ZI Run.cfg, dac-board-F767ZI-used-pins.ods]
2019-04-19 Created a unified Midi CC mapping file
    [MidiCC_mapping.ods]
2019-04-19 Documentation du code de calibrage
2019-04-30 Added Serial Term for debugging stm32
2019-09-07 added new project for future L432 board
    [budget.ods]
2019-09-23 Added v1 EAGLE schematics
    [DAC STM32 Board v3.brd, DAC STM32 Board v3.sch, LM13700.brd, LM13700.sch, LM13700_v2.brd, LM13700_v2.sch, V2164MIXER v2.brd, V2164MIXER v2.sch]
2019-09-23 Improved VCO calibration
    [dac-board-F767ZI Debug.cfg]
2019-09-23 Added front pane Eagle schematics
    [front pane - v2.brd, front pane - v2.sch]
2019-09-23 Added project documentation
    [MidiCC_mapping.ods, front pane editable MIDI parameters.ods]
2019-09-23 renamed files
    [MidiCC_mapping.ods]
2019-10-07 Added support for UART and Logging
2019-10-07 Improved schematics, added analog chips library
    [V2164MIXER v2.brd, V2164MIXER v2.sch, output stage.brd, pcb - vcf et etage sortie v3.brd]
2019-10-09 Remote Synth Parameter editing through UART using Java is working fine except VCF
    [dac-board-F767ZI Debug.cfg]
2020-01-07 Complete rewriting of files architecture
    [dac-board-F767ZI Debug.cfg, dac-board-F767ZI-used-pins.ods]
2020-01-07 New version of DAC board based on AD5391 chip
    [DAC STM32 Board v4 - AD5391.brd, DAC STM32 Board v4 - AD5391.sch, V2164MIXER v2.brd, VCO3340 v2.1.brd, VCO3340 v2.1.sch, VCO3340 v2.sch, pcb - vcf et etage sortie v3.brd, pcb - vcf et etage sortie v3.sch]
2020-01-07 new version of analog board based on L432
2020-01-07 config files
    [dac-board-F767ZI Run.cfg, dac-board-F767ZI-used-pins.ods]
2020-01-07 new budget estimatino
    [budget.ods]
2020-01-11 fixed bug in MidiInHandler when no input MIDI Keyboard available
    [HardwareManager.java, MidiInHandler.java, UartTransmitter.java]
2020-01-12 Fixed bug with Midi CC JSlider + added new Midi CC support
    [HardwareManager.java, MidiInHandler.java, ModuleFactory.java, UartTransmitter.java]
2020-01-12 checked connections
    [V2164MIXER v2.brd, V2164MIXER v2.sch, pcb - vcf et etage sortie v3.brd, pcb - vcf et etage sortie v3.sch, pcb - vcf et etage sortie.brd, pcb - vcf et etage sortie.sch]
2020-01-20 bug fix on LM13700 schematics
    [DAC STM32 Board v5 - AD5391.brd, DAC STM32 Board v5 - AD5391.sch, LM13700_v2.brd, LM13700_v2.sch]
2020-01-21 Layout half way
    [DAC STM32 Board v5 - AD5391.brd, DAC STM32 Board v5 - AD5391.sch]
2020-01-21 bug fixes with Midi In
    [MidiInHandler.java, UartTransmitter.java]
2020-01-24 Added utilities to debug Raspberry code
2020-01-25 Created new folder for main board
    [DAC STM32 Board v5 - AD5391.brd, DAC STM32 Board v5 - AD5391.sch]
2020-01-25 Moved eagle files to new folder
    [DAC STM32 Board v5 - AD5391.brd, DAC STM32 Board v5 - AD5391.sch]
2020-01-26 Added hack to fix wrong LED soldering bug
    [IS31FL3731.java]
2020-01-26 Added Moog Ladder Filter complete simulation
2020-01-26 Hardware test ok
    [bug-fix-for-LEDs-soldered-wrong-direction-on-frontpane.ods]
2020-01-26 config files changed
    [dac-board-F767ZI Debug.cfg]
2020-01-28 Create PCB-Xbee-Rasberry
2020-02-19 Moved raspberry xbee shield eagle files to dedicated folder
    [Xbee pcb.brd, Xbee pcb.sch]
2020-02-19 bug fix
    [DAC STM32 Board v5 - AD5391.brd, DAC STM32 Board v5 - AD5391.sch, LM13700_v2.brd, LM13700_v2.sch]
2020-02-19 Bug fix regarding front pane
    [BarGraph.java, ControlFactory.java, HardwareManager.java, MCP23017.java, ModuleFactory.java, RotaryEncoder.java, SynthControllerPane.java, ViewFactory.java]
2020-03-03 schematic fix
    [pcb - vcf et etage sortie v3.brd]
2020-03-03 Fixed file names
    [vcf-v1.brd, vcf-v1.sch, vcf-v2.brd, vcf-v2.sch, vcf-v3.brd, vcf-v3.sch]
2020-03-03 Added new schematic for combined VCA and output OpAmp
    [output stage and VCA v2.brd, output stage and VCA v2.sch, output stage v1.brd, output stage v1.sch]
2020-03-03 New VCF multifilter design
    [VCF-LP-BP-HP_v4.brd, VCF-LP-BP-HP_v4.sch]
2020-03-03 new design for stm32 + analog board
    [DAC STM32 Board v6 - AD5391.brd, DAC STM32 Board v6 - AD5391.sch]
2020-03-03 Deleted unused folder
    [test-pcb-analog.brd, test-pcb-analog.sch]
2020-03-03 New LTSpice simulation of combined VCA 13700 + OpAmp output stage
2020-03-03 New Ladder filter based VCF design
    [MoogFilter DIL.brd, MoogFilter DIL.sch]
2020-04-22 Added support for AD5391 and MCP23017
    [dac-board-L432KC-used-pins.ods, full-board-L432KC Debug.cfg]
2020-04-22 Improved STM32 F767 code architecture so as to better separate low- and high-level features
2020-04-22 Added new schematic for HP-LP-BP filter
    [DAC STM32 Board v4.1 - AD5391.brd, DAC STM32 Board v4.1 - AD5391.sch, JLPCB-parts.ods, VCF-LP-BP-HP_v4.brd]
2020-05-01 Fixed bug related to EXTI spurious interrupts
2020-05-08 calibration support underway
2020-05-09 improved calibration
2020-06-19 added midi device
2020-06-19 new SMD main board bersion
    [DAC STM32 Board v6.1 - AD5391.brd, DAC STM32 Board v6.1 - AD5391.sch, DAC STM32F446 Board SMD v7.brd, DAC STM32F446 Board SMD v7.sch]
2020-06-20 started PCB routing with F446
    [DAC STM32F446 Board SMD v7.brd, DAC STM32F446 Board SMD v7.sch]
2020-06-23 PCB for F446
    [DAC STM32F446 Board SMD v7.brd, DAC STM32F446 Board SMD v7.sch]
2020-06-23 PCB update
    [DAC STM32F446 Board SMD v7.brd, DAC STM32F446 Board SMD v7.sch]
2020-06-24 Final PCB version sent to eurocircuits.com
    [DAC STM32F446 Board SMD v7.brd, DAC STM32F446 Board SMD v7.sch]
2020-10-26 Initial commit for STM32F446 Board v7 C code
    [themis-stm32F446RC Debug.cfg, themis-stm32F446RC-used-pins.ods]
2020-10-26 fixed pol cap and LED orientation errors
    [DAC STM32F446 Board SMD v7.brd, DAC STM32F446 Board SMD v7.sch, bom-themis.ods]
2020-10-27 Updated net names
    [DAC STM32F446 Board SMD v7.brd, DAC STM32F446 Board SMD v7.sch]
2020-11-10 Reorganized folders
    [dac-board-F767ZI Debug.cfg, dac-board-F767ZI-used-pins.ods]
2020-11-10 Started merging v1.1 and v2.0 STM32 code
    [STM32F446 Full Board SMD v7.sch, themis-stm32F446RC-used-pins.ods]
2020-12-05 improved front pane v3
    [STM32F446 Full Board SMD v7.sch, STM32F446 front pane - v3.brd, STM32F446 front pane - v3.sch, front pane - v2.brd, front pane - v2.sch, front pane editable MIDI parameters.ods]
2020-12-10 Updated front pane
    [STM32F446 Full Board SMD v7.sch, STM32F446 front pane - v3.brd, STM32F446 front pane - v3.sch]
2020-12-13 Front pane update
    [STM32F446 front pane - v3.brd, STM32F446 front pane - v3.sch]
2020-12-17 Finished front pane and sent to production
    [STM32F446 front pane - northeast - v3.brd, STM32F446 front pane - northeast - v3.sch, STM32F446 front pane - northwest - v3.brd, STM32F446 front pane - northwest - v3.sch, STM32F446 front pane - south - v3.brd, STM32F446 front pane - south - v3.sch, STM32F446 front pane - v3.brd, STM32F446 front pane - v3.sch]
2021-10-09 Create budget v3.ods
    [budget v3.ods]
2021-10-09 added graphism proposal
    [STM32F446 front pane - northwest - v3.sch, STM32F446 front pane - v3.1.brd, STM32F446 front pane - v3.1.sch]
2021-10-09 Create STM32F446 Full Board SMD v7 bottom.pdf
2021-10-09 Create STM32F446 Full Board SMD v7 top.pdf
2021-10-09 Create STM32F446 Full Board SMD v7.1.brd
    [STM32F446 Full Board SMD v7.1.brd]
2021-10-09 Create STM32F446 Full Board SMD v7.1.sch
    [STM32F446 Full Board SMD v7.1.sch]
2021-12-29 added stm32cubeide extensions for ignored binaries
2021-12-29 New STM32CubeIDE project for frontpane board
    [frontpane-stm32F446RC-used-pins.ods, themis-front-v3-stm32f446 Debug.cfg]
2022-02-19 Fixed bug with MCP_XXX name
    [STM32F446 front pane - south - v3.brd, STM32F446 front pane - south - v3.sch]
2022-02-19 STM32CubeIDE version upgrade
2022-02-19 added new information
    [frontpane-stm32F446RC-used-pins.ods]
2022-02-19 renamed full-board-L432KC
    [dac-board-L432KC-used-pins.ods, full-board-L432KC Debug.cfg]
2022-02-19 renamed folder
    [themis-main-board-L432KC Debug.cfg]
2022-02-19 renamed folder and STM32CubeIDE project
2022-03-06 DIL to CMS adapter for the STLink v3 programmer
    [adapter-STDC14-DIL.brd, adapter-STDC14-DIL.sch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]
2022-03-06 bug fixes for encoder code
    [frontpane-stm32F446RC-used-pins.ods]
2022-05-10 Delete front-pane/eagle-schematics/v3/CAMOutputs directory
    can be regenerated on demand
    [copper_bottom.gbr, copper_top.gbr, drill_1_16.xln, gerber_job.gbrjob, profile.gbr, silkscreen_bottom.gbr, silkscreen_top.gbr, soldermask_bottom.gbr]
2022-05-10 Delete adapter-STDC14-DIL.brd
    moved outside the project
    [adapter-STDC14-DIL.brd]
2022-05-10 Delete adapter-STDC14-DIL.sch
    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
    [adapter-STDC14-DIL.sch]
2022-05-10 DMA bug fixing
    Sorted buggy DMA for SPI bus: was Init_DMA() misplaced at the end of the init process by CubeMX...
    [MCP23017.cpp, PushButton.cpp, RotaryEncoder.cpp, TLC59731.cpp, TLC59731.h, callback.h, callbacks.cpp, front-panel.cpp]
2022-05-10 Renamed STM32CubeIDE project
2022-05-10 Added missing net label on BH2221 DAC
    [STM32F446 Full Board SMD v7.brd, STM32F446 Full Board SMD v7.sch]
2022-05-10 STM32F446 CubeMX firmware upgrade
2022-05-10 Slight translation of touch screen
    This doesn't have any consequence on the electrical design
    [STM32F446 front pane - v3.1.brd, STM32F446 front pane - v3.brd]
2022-05-10 added CAD files for Laser cutting
    [drills-and-engrave.dwg, laser-engraving.dwg, laser-engraving.dxf]
2022-05-10 Delete eagle-schematics directory
    empty folder
2022-09-02 new box cover design for Laser cutting machines
    [laser-cutting-v2.dwg, laser-cutting-v2.dxf]
2022-09-02 updated pin use
    [STM32F446 Full Board SMD v7.1.csv]
2022-09-02 pointing new errors on the board layout
    [STM32F446 Full Board SMD v7.brd, STM32F446 Full Board SMD v7.sch]
2022-09-02 now fully functionnal with DMA
2022-09-02 deleted file - no MCP23017 on board
2022-09-02 this is a temporary 4 layer polyphonic version - work in progress
    [STM32F446 Polyphonic Board SMD v1.0.brd, STM32F446 Polyphonic Board SMD v1.0.sch, STM32_DAC.brd, STM32_DAC.sch, VCA 2164.brd, VCA 2164.sch, VCF 3320.brd, VCF 3320.sch]
2022-09-02 updated HAL drivers to latest version
    [themis-main-v2-stm32F446RC Debug (1).cfg, themis-stm32F446RC-used-pins.ods]
2022-09-03 added implementation of printf() via UART blocking call - DMA implementation pending
2022-09-03 added UART1 related init'ing
2022-09-03 minor edits
    [themis-stm32F446RC-used-pins.ods]
2022-09-04 adapted ADSR and VCO calibration code from v1.1 L432KC
2022-11-04 Management of southern board encoders
    All eight MCP23017's are now handled correctly by software.
    [MCP23017.cpp, callbacks.cpp, front-panel.cpp, front-panel.h, main.cpp]
2022-11-04 HAL driver upgrade
2022-11-04 typos correction
    [part 2.sch]
2022-11-05 implemented alternate functions + led display now ok
2023-01-03 changed DAC pin assignement
    [STM32F446 Full Board SMD v7.sch]
