reynal/themis/(notices)

Notices in the files:
front-pane/themis-front-v3-stm32f446/Core/Src/main.cpp:
Copyright (c) 2021 STMicroelectronics.
All rights reserved.
This software is licensed under terms that can be found in the LICENSE file
front-pane/eagle-schematics/v3/STM32F446 front pane - v3.1.brd:
RAINBOW by SYD X. REY (c) 2022
parts and their libraries:
SparkFun-Connectors: Licensing: Creative Commons ShareAlike 4.0 International - https://creativecommons.org/licenses/by-sa/4.0
microbuilder: This work is placed in the public domain, and may be freely used for commercial and non-commercial work with the following conditions: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
